AM4511/test_migrate_iris4/athena/doc/sensors/xgs5m_pinout.txt

GND;A5;Ground;Ground;
GND;A10;Ground;Ground;
GND;A13;Ground;Ground;
GND;D2;Ground;Ground;
GND;D13;Ground;Ground;
GND;E1;Ground;Ground;
GND;E14;Ground;Ground;
GND;G2;Ground;Ground;
GND;G13;Ground;Ground;
GND;H1;Ground;Ground;
GND;H14;Ground;Ground;
GND;J2;Ground;Ground;
GND;J3;Ground;Ground;
GND;J4;Ground;Ground;
GND;J5;Ground;Ground;
GND;J10;Ground;Ground;
GND;J11;Ground;Ground;
GND;J12;Ground;Ground;
GND;J13;Ground;Ground;
GND;K2;Ground;Ground;
GND;K3;Ground;Ground;
GND;K4;Ground;Ground;
GND;K9;Ground;Ground;
GND;K11;Ground;Ground;
GND;K12;Ground;Ground;
GND;K13;Ground;Ground;
GND;L2;Ground;Ground;
GND;L3;Ground;Ground;
GND;L4;Ground;Ground;
GND;L5;Ground;Ground;
GND;L6;Ground;Ground;
GND;L9;Ground;Ground;
GND;L10;Ground;Ground;
GND;L11;Ground;Ground;
GND;L12;Ground;Ground;
GND;L13;Ground;Ground;
GND;M5;Ground;Ground;
GND;M10;Ground;Ground;
GND;N1;Ground;Ground;
GND;N13;Ground;Ground;
GND;P8;Ground;Ground;
VDD_PLL;C10;Power;PLL Power Supply;
VAA;M13;Power;Analog Supply;
VAA;A3;Power;Analog Supply;
VAA;N3;Power;Analog Supply;
VAA;N4;Power;Analog Supply;
VAA;P7;Power;Analog Supply;
VAA;L7;Power;Analog Supply;
VAA;K7;Power;Analog Supply;
VAA;L8;Power;Analog Supply;
VAA;K8;Power;Analog Supply;
VAA;N11;Power;Analog Supply;
VAA;N12;Power;Analog Supply;
VAA;A12;Power;Analog Supply;
VAA;L14;Power;Analog Supply;
VAA_RD;A4;Power;Analog Supply for Row Driver;
VAA_RD;A11;Power;Analog Supply for Row Driver;
VAA_RD;P3;Power;Analog Supply for Row Driver;
VAA_RD;P12;Power;Analog Supply for Row Driver;
VDD_IO;A6;Power;I/O Supply;
VDD_IO;A7;Power;I/O Supply;
VDD_IO;A9;Power;I/O Supply;
VDD_IO;M1;Power;I/O Supply;
VDD_IO;M14;Power;I/O Supply;
FWSI_EN;B8;Input;Connect to VDD_IO through a 10k resistor;
SDATA;B9;Input;SPI Slave In;
VAA_PIX;B3;Power;Pixel Supply;
VAA_PIX;B12;Power;Pixel Supply;
VAA_PIX;M3;Power;Pixel Supply;
VAA_PIX;M12;Power;Pixel Supply;
VDD;C1;Power;Digital Supply;
VDD;F1;Power;Digital Supply;
VDD;K1;Power;Digital Supply;
VDD;B4;Power;Digital Supply;
VDD;D5;Power;Digital Supply;
VDD;G5;Power;Digital Supply;
VDD;K5;Power;Digital Supply;
VDD;D10;Power;Digital Supply;
VDD;G10;Power;Digital Supply;
VDD;K10;Power;Digital Supply;
VDD;B11;Power;Digital Supply;
VDD;C14;Power;Digital Supply;
VDD;F14;Power;Digital Supply;
VDD;J14;Power;Digital Supply;
MONITOR_2;B5;Output;Monitor Output 2. If unused, do not connect.;
MONITOR_1;B6;Output Monitor Output 1. If unused, do not connect.;
EXTCLK;B7;Input;External Clock Input;
SDATAOUT;C8;Output;SPI Slave Out;
TRIG_RD;C9;Input;Trigger Input for Readout Control. If unused, connectto ground.;
DATA_0_N;C10;HiSPi;Differential Data Channel [0], Negative;
DATA_0_P;C11;HiSPi;Differential Data Channel [0], Positive;
DATA_2_N;C12;HiSPi;Differential Data Channel [2], Negative;
DATA_2_P;C13;HiSPi;Differential Data Channel [2], Positive;
DATA_3_P;D2;HiSPi;Differential Data Channel [3], Positive;
DATA_3_N;D3;HiSPi;Differential Data Channel [3], Negative;
DATA_1_P;D4;HiSPi;Differential Data Channel [1], Positive;
DATA_1_N;D5;HiSPi;Differential Data Channel [1], Negative;
MONITOR_0;C6;Output;Monitor Output 0. If unused, keep do not connect.;
CS_N;C7;Input;SPI Chip Select (Active Low);
TRIG_INT;D9;Input;Trigger Input for Integration Control. If unused, connectto ground.;
D_CLK_0_N;D11;HiSPi;Differential Clock [0], Negative;
D_CLK_0_P;D12;HiSPi;Differential Clock [0], Positive;
VDD_SLVS;D1;Power;HiSPi Supply;
VDD_SLVS;D14;Power;HiSPi Supply;
VDD_SLVS;G1;Power;HiSPi Supply;
VDD_SLVS;G14;Power;HiSPi Supply;
VDD_SLVS;K1;Power;HiSPi Supply;
VDD_SLVS;K14;Power;HiSPi Supply;
D_CLK_1_P;P3;HiSPi;Differential Clock [1], Positive;
D_CLK_1_N;P4;HiSPi;Differential Clock [1], Negative;
RESET_N;D6;Input;Asynchronous Hard Reset (Active Low);
SCLK;D7;Input;SPI Clock Input;
DATA_4_N;E10;HiSPi;Differential Data Channel [4], Negative;
DATA_4_P;E11;HiSPi;Differential Data Channel [4], Positive;
DATA_6_N;E12;HiSPi;Differential Data Channel [6], Negative;
DATA_6_P;E13;HiSPi;Differential Data Channel [6], Positive;
DATA_7_P;E2;HiSPi;Differential Data Channel [7], Positive;
DATA_7_N;E3;HiSPi;Differential Data Channel [7], Negative;
DATA_5_P;E4;HiSPi;Differential Data Channel [5], Positive;
DATA_5_N;E5;HiSPi;Differential Data Channel [5], Negative;
DATA_8_N;F10;HiSPi;Differential Data Channel [8], Negative;
DATA_8_P;F11;HiSPi;Differential Data Channel [8], Positive;
DATA_10_N;F12;HiSPi;Differential Data Channel [10], Negative;
DATA_10_P;F13;HiSPi;Differential Data Channel [10], Positive;
DATA_11_P;F2;HiSPi;Differential Data Channel [11], Positive;
DATA_11_N;F3;HiSPi;Differential Data Channel [11], Negative;
DATA_9_P;F4;HiSPi;Differential Data Channel [9], Positive;
DATA_9_N;F5;HiSPi;Differential Data Channel [9], Negative;
D_CLK_2_N;G11;HiSPi;Differential Clock [2], Negative;
D_CLK_2_P;G12;HiSPi;Differential Clock [2], Positive;
D_CLK_3_P;H3;HiSPi;Differential Clock [3], Positive;
D_CLK_3_N;H4;HiSPi;Differential Clock [3], Negative;
DATA_12_N;H10;HiSPi;Differential Data Channel [12], Negative;
DATA_12_P;H11;HiSPi;Differential Data Channel [12], Positive;
DATA_14_N;H12;HiSPi;Differential Data Channel [14], Negative;
DATA_14_P;H13;HiSPi;Differential Data Channel [14], Positive;
DATA_15_P;H2;HiSPi;Differential Data Channel [15], Positive;
DATA_15_N;H3;HiSPi;Differential Data Channel [15], Negative;
DATA_13_P;H4;HiSPi;Differential Data Channel [13], Positive;
DATA_13_N;H5;HiSPi;Differential Data Channel [13], Negative;
VAA_PIX_A0;M8;Decoupling;External Noise Decoupling (0.1 uF + 4.7 uF to GND);
VAA_PIX_A1;M9;Decoupling;External Noise Decoupling (0.1 uF + 4.7 uF to GND);
VAA_PIX_A2;N8;Decoupling;External Noise Decoupling (0.1 uF + 4.7 uF to GND);
VAA_PIX_A3;P9;Decoupling;External Noise Decoupling (0.1 uF + 4.7 uF to GND);
VAA_PIX_A4;P10;Decoupling;External Noise Decoupling (0.1 uF + 4.7 uF to GND);
VAA_PIX_A5;P4;Decoupling;External Noise Decoupling (0.1 uF + 4.7 uF to GND);
VAA_PIX_B0;M6;Decoupling;External Noise Decoupling (0.1 uF + 2.2 uF to GND);
VAA_PIX_B1;M7;Decoupling;External Noise Decoupling (0.1 uF + 2.2 uF to GND);
VAA_PIX_B2;N6;Decoupling;External Noise Decoupling (0.1 uF + 2.2 uF to GND);
VAA_PIX_B3;N7;Decoupling;External Noise Decoupling (0.1 uF + 2.2 uF to GND);
VAA_PIX_B4;P5;Decoupling;External Noise Decoupling (0.1 uF + 2.2 uF to GND);
VAA_PIX_B5;P6;Decoupling;External Noise Decoupling (0.1 uF + 2.2 uF to GND);
VAA_PIX_C0;N9;Decoupling;External Noise Decoupling (0.1 uF to GND);
VAA_PIX_C1;P11;Decoupling;External Noise Decoupling (0.1 uF to GND);
VAA_PIX_BST;N5;N10;Power;Pixel Booster Supply;
