AM4511/test_migrate_iris4/athena/local_ip/pcie2AxiMaster_v3.0/doc/pcie2AxiMaster_IPCore_Specification.docx

Matrox Pcie2AxiMaster

IP-Core specification

Project :

Document Title : Matrox pcie2AxiMaster IP-Core

Document Number and Revision :

Author : Alain Marchand

Date : 2019-01-23

Matrox Confidential information. Do not circulate outside Matrox without the prior consent of the Matrox Engineering department. Advance Information. Contains information on product in the design phase of development.

# Revision history

This section lists all revisions for the current document and explains the modifications made for each new revision

Revision | Description
0.01 | - Initial version

Table of contents

# 1. Introduction

# 2. IP-Core features

- Bridge between the PCIe Gen2x1 and the AXI4 Master Lite interface
- Based on the Xilinx PCIe Endpoint
- IP-Integrator ready
- Support up to 31 IRQ events
- Includes the Matrox SPI interface and the Xilinx Startup2 module

# 3. Bloc diagram

# 4. Pcie Xilinx end point

# 5. Interrupts

## 5.1 Legacy mode

Interrupts mappings :

Registre Status[0]: @BAR2 + 0x40

io[0]

reserved[7:1]

tick[9:8]

tick_latch[11:10]

tick_wrap[13:12]

tick_wrap[13:12]

toe_overrun[17:14]

toe_frame_sent[21:18]

toe_list_sent[25:22]

toe_log_available[26]

toe_log_overflow[27]

Registre Status[1]: @BAR2 + 0x44

timer_start[15:0]

timer_end[31:16]

## 5.2 Interrupt queue mode

## 5.3 Modelsim Validation framework

### 5.3.1 Prerequisite

# 6. FPGA implementation

# 7. References

Matrox confidential information, Preliminary, Subject to change

matrox TITRE Matrox PCIe2AxiMaster IP-Core Specification imaging NUMÉRO ET RÉVISION Ex :469-TESY-002-0.02 STATUT OFFICIEL PAGE 1 de 1 No. gabarit : GAB104 - GABARIT DE SPECIFICATION.DOT
