AM4511/test_migrate_iris4/doc/schematic_review/ares_xc7a50t_1582747176.xlsx

Sheet: ares_xc7a50t_1582747176
#Top: ares_pcie Floorplan: impl_1 Part: xc7a50ticpg236-1L
#Generated by: amarchan on: Wed Feb 26 16:11:24 2020
#Build: Vivado v2019.1 by: xbuild on: Fri May 24 14:49:42 MDT 2019
#Package Version: FINAL 2014-02-19
#Package Pin Delay Version: VERS. 2.0 2014-02-19
IO Bank | Pin Number | Site | Site Type | Min Trace Delay (ps) | Max Trace Delay (ps) | Prohibit | Interface | Signal Name | Direction | DiffPair Type | DiffPair Signal | IO Standard | Drive (mA) | Slew Rate | OUTPUT_IMPEDANCE | PRE_EMPHASIS | LVDS_PRE_EMPHASIS | EQUALIZATION | Pull Type | DQS_BIAS | IN_TERM | DIFF_TERM | OFFCHIP_TERM | Board Signal | Board Voltage
216 | A4 | IPAD_X1Y6 | MGTPRXN0_216 | 35.486 | 35.843 |  | pcie_7x_mgt_27828 | pcie_rxn[0] | IN
216 | B4 | IPAD_X1Y7 | MGTPRXP0_216 | 31.423 | 31.739 |  | pcie_7x_mgt_27828 | pcie_rxp[0] | IN
216 | D1 | OPAD_X0Y0 | MGTPTXN0_216 | 27.518 | 27.794 |  | pcie_7x_mgt_27828 | pcie_txn[0] | OUT |  |  |  | 12
216 | D2 | OPAD_X0Y1 | MGTPTXP0_216 | 28.188 | 28.471 |  | pcie_7x_mgt_27828 | pcie_txp[0] | OUT |  |  |  | 12
14 | N19 | IOB_X0Y31 | IO_L9N_T1_DQS_D13_14 | 43.356 | 43.791 |  | uart_4944 | debug_uart_rxd | IN |  |  | LVCMOS18
14 | N18 | IOB_X0Y32 | IO_L9P_T1_DQS_14 | 36.214 | 36.578 |  | uart_4944 | debug_uart_txd | OUT |  |  | LVCMOS18 | 4 | SLOW |  |  |  |  |  |  |  |  | NONE
14 | U15 | IOB_X0Y4 | IO_L23P_T3_A03_D19_14 | 55.235 | 55.791 |  | hb_4944 | hb_dq[7] | INOUT |  |  | LVCMOS18 | 4 | SLOW |  |  |  |  |  |  |  |  | NONE
14 | V15 | IOB_X0Y8 | IO_L21P_T3_DQS_14 | 61.536 | 62.155 |  | hb_4944 | hb_dq[6] | INOUT |  |  | LVCMOS18 | 4 | SLOW |  |  |  |  |  |  |  |  | NONE
14 | W15 | IOB_X0Y7 | IO_L21N_T3_DQS_A06_D22_14 | 46.384 | 46.85 |  | hb_4944 | hb_dq[5] | INOUT |  |  | LVCMOS18 | 4 | SLOW |  |  |  |  |  |  |  |  | NONE
14 | U14 | IOB_X0Y0 | IO_25_14 | 46.997 | 47.469 |  | hb_4944 | hb_dq[4] | INOUT |  |  | LVCMOS18 | 4 | SLOW |  |  |  |  |  |  |  |  | NONE
14 | V14 | IOB_X0Y1 | IO_L24N_T3_A00_D16_14 | 41.549 | 41.967 |  | hb_4944 | hb_dq[3] | INOUT |  |  | LVCMOS18 | 4 | SLOW |  |  |  |  |  |  |  |  | NONE
14 | W14 | IOB_X0Y5 | IO_L22N_T3_A04_D20_14 | 45.388 | 45.844 |  | hb_4944 | hb_dq[2] | INOUT |  |  | LVCMOS18 | 4 | SLOW |  |  |  |  |  |  |  |  | NONE
14 | V13 | IOB_X0Y2 | IO_L24P_T3_A01_D17_14 | 44.905 | 45.356 |  | hb_4944 | hb_dq[1] | INOUT |  |  | LVCMOS18 | 4 | SLOW |  |  |  |  |  |  |  |  | NONE
14 | W13 | IOB_X0Y6 | IO_L22P_T3_A05_D21_14 | 54.429 | 54.976 |  | hb_4944 | hb_dq[0] | INOUT |  |  | LVCMOS18 | 4 | SLOW |  |  |  |  |  |  |  |  | NONE
14 | P18 | IOB_X0Y22 | IO_L14P_T2_SRCC_14 | 54.741 | 55.291 |  | hb_4944 | hb_ck | OUT |  |  | LVCMOS18 | 4 | SLOW |  |  |  |  |  |  |  |  | NONE
14 | R18 | IOB_X0Y21 | IO_L14N_T2_SRCC_14 | 41.326 | 41.741 |  | hb_4944 | hb_ck_n | OUT |  |  | LVCMOS18 | 4 | SLOW |  |  |  |  |  |  |  |  | NONE
14 | T17 | IOB_X0Y16 | IO_L17P_T2_A14_D30_14 | 46.765 | 47.235 |  | hb_4944 | hb_cs_n | OUT |  |  | LVCMOS18 | 4 | SLOW |  |  |  |  |  |  |  |  | NONE
14 | V16 | IOB_X0Y12 | IO_L19P_T3_A10_D26_14 | 56.856 | 57.427 |  | hb_4944 | hb_rwds | INOUT |  |  | LVCMOS18 | 4 | SLOW |  |  |  |  |  |  |  |  | NONE
35 | M1 | IOB_X1Y81 | IO_L9N_T1_DQS_AD7N_35 | 52.04 | 52.563 |  | ncsi_4944 | ncsi_rxd[1] | IN |  |  | LVCMOS33
35 | N1 | IOB_X1Y79 | IO_L10N_T1_AD15N_35 | 50.477 | 50.985 |  | ncsi_4944 | ncsi_rxd[0] | IN |  |  | LVCMOS33
35 | L3 | IOB_X1Y84 | IO_L8P_T1_AD14P_35 | 44.149 | 44.593 |  | ncsi_4944 | ncsi_txd[1] | OUT |  |  | LVCMOS33 | 4 | SLOW |  |  |  |  |  |  |  |  | NONE
35 | M3 | IOB_X1Y83 | IO_L8N_T1_AD14N_35 | 52.966 | 53.499 |  | ncsi_4944 | ncsi_txd[0] | OUT |  |  | LVCMOS33 | 4 | SLOW |  |  |  |  |  |  |  |  | NONE
35 | M2 | IOB_X1Y82 | IO_L9P_T1_DQS_AD7P_35 | 52.172 | 52.696 |  | ncsi_4944 | ncsi_rx_crs_dv | IN |  |  | LVCMOS33
35 | N2 | IOB_X1Y80 | IO_L10P_T1_AD15P_35 | 49.851 | 50.352 |  | ncsi_4944 | ncsi_tx_en | OUT |  |  | LVCMOS33 | 4 | SLOW |  |  |  |  |  |  |  |  | NONE
216 | A8 | IPAD_X1Y15 | MGTREFCLK0N_216 | 27.772 | 28.051 |  | CLK.CLK_100MHZ_CLK.sys_clk_57745 | pcie_sys_clk_n | IN | N | pcie_sys_clk_p
216 | B8 | IPAD_X1Y14 | MGTREFCLK0P_216 | 29.762 | 30.062 |  | CLK.CLK_100MHZ_CLK.sys_clk_57745 | pcie_sys_clk_p | IN | P | pcie_sys_clk_n
34 | U1 | IOB_X1Y43 | IO_L3N_T0_DQS_34 | 48.507 | 48.994 |  | CLK.CLK_100MHZ_CLK.sys_clk_57745 | status_rled | OUT |  |  | LVCMOS33 | 4 | SLOW |  |  |  |  |  |  |  |  | NONE
35 | H1 | IOB_X1Y94 | IO_L3P_T0_DQS_AD5P_35 | 45.368 | 45.824 |  | CLK.CLK_100MHZ_CLK.sys_clk_57745 | sys_rst_out_n | OUT |  |  | LVCMOS33 | 12 | SLOW |  |  |  |  |  |  |  |  | FP_VTT_50
14 | F18 | IOB_X0Y45 | IO_L2N_T0_D03_14 | 62.552 | 63.18 |  | spi_4944 | spi_sd[3] | INOUT |  |  | LVCMOS18 | 4 | SLOW |  |  |  |  |  |  |  |  | NONE
14 | G18 | IOB_X0Y46 | IO_L2P_T0_D02_14 | 64.093 | 64.737 |  | spi_4944 | spi_sd[2] | INOUT |  |  | LVCMOS18 | 4 | SLOW |  |  |  |  |  |  |  |  | NONE
14 | D19 | IOB_X0Y47 | IO_L1N_T0_D01_DIN_14 | 68.618 | 69.308 |  | spi_4944 | spi_sd[1] | INOUT |  |  | LVCMOS18 | 4 | SLOW |  |  |  |  |  |  |  |  | NONE
14 | D18 | IOB_X0Y48 | IO_L1P_T0_D00_MOSI_14 | 70.007 | 70.711 |  | spi_4944 | spi_sd[0] | INOUT |  |  | LVCMOS18 | 4 | SLOW |  |  |  |  |  |  |  |  | NONE
14 | K19 | IOB_X0Y38 | IO_L6P_T0_FCS_B_14 | 50.629 | 51.138 |  | spi_4944 | spi_cs_n | INOUT |  |  | LVCMOS18 | 4 | SLOW |  |  |  |  |  |  |  |  | NONE
35 | J1 | IOB_X1Y93 | IO_L3N_T0_DQS_AD5N_35 | 45.809 | 46.27 |  | RST.sys_rst_n_27828 | sys_rst_in_n | IN |  |  | LVCMOS33
16 | A18 | IOB_X0Y111 | IO_L19N_T3_VREF_16 | 58.482 | 59.069 |  |  | acq_led[1] | IN |  |  | LVCMOS18
16 | B18 | IOB_X0Y112 | IO_L19P_T3_16 | 51.785 | 52.306 |  |  | acq_led[0] | IN |  |  | LVCMOS18
14 | G19 | IOB_X0Y41 | IO_L4N_T0_D05_14 | 64.383 | 65.03 |  |  | espi_io[3] | INOUT |  |  | LVCMOS18 | 4 | SLOW |  |  |  |  |  |  |  |  | NONE
14 | H19 | IOB_X0Y42 | IO_L4P_T0_D04_14 | 59.997 | 60.6 |  |  | espi_io[2] | INOUT |  |  | LVCMOS18 | 4 | SLOW |  |  |  |  |  |  |  |  | NONE
14 | J18 | IOB_X0Y35 | IO_L7N_T1_D10_14 | 65.365 | 66.022 |  |  | espi_io[1] | INOUT |  |  | LVCMOS18 | 4 | SLOW |  |  |  |  |  |  |  |  | NONE
14 | K18 | IOB_X0Y33 | IO_L8N_T1_D12_14 | 59.489 | 60.087 |  |  | espi_io[0] | INOUT |  |  | LVCMOS18 | 4 | SLOW |  |  |  |  |  |  |  |  | NONE
14 | U18 | IOB_X0Y13 | IO_L18N_T2_A11_D27_14 | 37.024 | 37.396 |  |  | fpga_straps[3] | IN |  |  | LVCMOS18
14 | V17 | IOB_X0Y11 | IO_L19N_T3_A09_D25_VREF_14 | 48.459 | 48.946 |  |  | fpga_straps[2] | IN |  |  | LVCMOS18
14 | W16 | IOB_X0Y10 | IO_L20P_T3_A08_D24_14 | 59.304 | 59.9 |  |  | fpga_straps[1] | IN |  |  | LVCMOS18
14 | W17 | IOB_X0Y9 | IO_L20N_T3_A07_D23_14 | 44.15 | 44.594 |  |  | fpga_straps[0] | IN |  |  | LVCMOS18
34 | U7 | IOB_X1Y12 | IO_L19P_T3_34 | 72.032 | 72.756 |  |  | user_data_out[2] | OUT |  |  | LVCMOS33 | 4 | SLOW |  |  |  |  |  |  |  |  | NONE
34 | U8 | IOB_X1Y22 | IO_L14P_T2_SRCC_34 | 75.687 | 76.447 |  |  | user_data_out[1] | OUT |  |  | LVCMOS33 | 4 | SLOW |  |  |  |  |  |  |  |  | NONE
34 | T3 | IOB_X1Y45 | IO_L2N_T0_34 | 47.809 | 48.289 |  |  | user_data_out[0] | OUT |  |  | LVCMOS33 | 4 | SLOW |  |  |  |  |  |  |  |  | NONE
34 | R3 | IOB_X1Y46 | IO_L2P_T0_34 | 59.313 | 59.909 |  |  | user_data_in[3] | IN |  |  | LVCMOS33
34 | T1 | IOB_X1Y44 | IO_L3P_T0_DQS_34 | 50.79 | 51.301 |  |  | user_data_in[2] | IN |  |  | LVCMOS33
34 | T2 | IOB_X1Y47 | IO_L1N_T0_34 | 53.452 | 53.989 |  |  | user_data_in[1] | IN |  |  | LVCMOS33
34 | R2 | IOB_X1Y48 | IO_L1P_T0_34 | 51.757 | 52.277 |  |  | user_data_in[0] | IN |  |  | LVCMOS33
16 | C15 | IOB_X0Y128 | IO_L11P_T1_SRCC_16 | 45.697 | 46.157 |  |  | acq_exposure | IN |  |  | LVCMOS18
16 | B15 | IOB_X0Y127 | IO_L11N_T1_SRCC_16 | 65.377 | 66.034 |  |  | acq_strobe | IN |  |  | LVCMOS18
16 | A16 | IOB_X0Y126 | IO_L12P_T1_MRCC_16 | 52.5 | 53.028 |  |  | acq_trigger | OUT |  |  | LVCMOS18 | 4 | SLOW |  |  |  |  |  |  |  |  | NONE
16 | A17 | IOB_X0Y125 | IO_L12N_T1_MRCC_16 | 48.791 | 49.282 |  |  | acq_trigger_ready | IN |  |  | LVCMOS18
16 | A14 | IOB_X0Y138 | IO_L6P_T0_16 | 60.607 | 61.216 |  |  | user_rled_soc | IN |  |  | LVCMOS18
34 | U4 | IOB_X1Y28 | IO_L11P_T1_SRCC_34 | 39.989 | 40.391 |  |  | user_rled | OUT |  |  | LVCMOS33 | 4 | SLOW |  |  |  |  |  |  |  |  | NONE
14 | E19 | IOB_X0Y43 | IO_L3N_T0_DQS_EMCCLK_14 | 70.309 | 71.016 |  |  | espi_alert_n | OUT |  |  | LVCMOS18 | 4 | SLOW |  |  |  |  |  |  |  |  | NONE
14 | K17 | IOB_X0Y25 | IO_L12N_T1_MRCC_14 | 77.37 | 78.147 |  |  | espi_clk | IN |  |  | LVCMOS18
14 | L18 | IOB_X0Y34 | IO_L8P_T1_D11_14 | 44.212 | 44.657 |  |  | espi_cs_n | IN |  |  | LVCMOS18
14 | J17 | IOB_X0Y36 | IO_L7P_T1_D09_14 | 61.558 | 62.177 |  |  | espi_reset_n | IN |  |  | LVCMOS18
16 | A15 | IOB_X0Y137 | IO_L6N_T0_VREF_16 | 43.867 | 44.308 |  |  | user_gled_soc | IN |  |  | LVCMOS18
34 | U2 | IOB_X1Y31 | IO_L9N_T1_DQS_34 | 43.75 | 44.19 |  |  | user_gled | OUT |  |  | LVCMOS33 | 4 | SLOW |  |  |  |  |  |  |  |  | NONE
14 | M18 | IOB_X0Y28 | IO_L11P_T1_SRCC_14 | 48.633 | 49.121 |  |  | ref_clk_100MHz | IN |  |  | LVCMOS18
14 | U19 | IOB_X0Y20 | IO_L15P_T2_DQS_RDWR_B_14 | 41.834 | 42.254 |  |  | hb_int_n | IN |  |  | LVCMOS18
14 | R19 | IOB_X0Y29 | IO_L10N_T1_D15_14 | 44.162 | 44.606 |  |  | hb_rst_n | OUT |  |  | LVCMOS18 | 4 | SLOW |  |  |  |  |  |  |  |  | NONE
14 | V19 | IOB_X0Y19 | IO_L15N_T2_DQS_DOUT_CSO_B_14 | 49.813 | 50.313 |  |  | hb_rsto_n | IN |  |  | LVCMOS18
34 | U5 | IOB_X1Y18 | IO_L16P_T2_34 | 60.584 | 61.193 |  |  | status_gled | OUT |  |  | LVCMOS33 | 4 | SLOW |  |  |  |  |  |  |  |  | NONE
14 | U16 | IOB_X0Y3 | IO_L23N_T3_A02_D18_14 | 45.609 | 46.068 |  |  | hb_wp_n | OUT |  |  | LVCMOS18 | 4 | SLOW |  |  |  |  |  |  |  |  | NONE
35 | N3 | IOB_X1Y76 | IO_L12P_T1_MRCC_35 | 48.179 | 48.663 |  |  | ncsi_clk | OUT |  |  | LVCMOS33 | 4 | SLOW |  |  |  |  |  |  |  |  | NONE
34 | V2 | IOB_X1Y40 | IO_L5P_T0_34 | 50.091 | 50.594 |  |  | pwm_out | OUT |  |  | LVCMOS33 | 4 | SLOW |  |  |  |  |  |  |  |  | NONE
0 | B13 | IPAD_X0Y1 | VN_0 | 51.355 | 51.871
0 | A12 | IPAD_X0Y0 | VP_0 | 29.808 | 30.108
0 | U12 |  | DONE_0 | 39.631 | 40.029
0 | A11 |  | DXP_0 | 28.595 | 28.882
0 | C12 |  | GNDADC_0
0 | C13 |  | VCCADC_0
0 | B12 |  | VREFP_0 | 39.157 | 39.551
0 | C9 |  | VCCBATT_0
0 | C8 |  | TCK_0 | 39.336 | 39.731
0 | B11 |  | DXN_0 | 38.925 | 39.316
0 | A13 |  | VREFN_0 | 31.856 | 32.176
0 | C11 |  | CCLK_0 | 38.016 | 38.398
0 | V12 |  | M0_0 | 29.997 | 30.298
0 | W11 |  | M1_0 | 26.863 | 27.133
0 | U11 |  | INIT_B_0 | 39.888 | 40.289
0 | W10 |  | TDI_0 | 29.123 | 29.416
0 | W8 |  | TDO_0 | 48.221 | 48.706
0 | U10 |  | M2_0 | 33.922 | 34.263
0 | V11 |  | CFGBVS_0 | 32.811 | 33.141 |  |  |  |  |  |  |  |  |  |  |  |  |  |  |  |  |  |  | GND | GND
0 | V10 |  | PROGRAM_B_0 | 27.178 | 27.451
0 | W9 |  | TMS_0 | 34.254 | 34.599
0 | V9 |  | VCCO_0 |  |  |  |  |  |  |  |  |  |  |  |  |  |  |  |  |  |  |  |  | VCCO_0 | 1.8
0 | G12 |  | VCCO_0 |  |  |  |  |  |  |  |  |  |  |  |  |  |  |  |  |  |  |  |  | VCCO_0 | 1.8
14 | D17 | IOB_X0Y49 | IO_0_14 | 71.062 | 71.776
14 | E18 | IOB_X0Y44 | IO_L3P_T0_DQS_PUDC_B_14 | 75.672 | 76.433
14 | H17 | IOB_X0Y40 | IO_L5P_T0_D06_14 | 46.294 | 46.759
14 | G17 | IOB_X0Y39 | IO_L5N_T0_D07_14 | 69.706 | 70.406
14 | J19 | IOB_X0Y37 | IO_L6N_T0_D08_VREF_14 | 64.563 | 65.212
14 | P19 | IOB_X0Y30 | IO_L10P_T1_D14_14 | 37.46 | 37.836
14 | M19 | IOB_X0Y27 | IO_L11N_T1_SRCC_14 | 59.648 | 60.248
14 | L17 | IOB_X0Y26 | IO_L12P_T1_MRCC_14 | 71.438 | 72.156
14 | N17 | IOB_X0Y24 | IO_L13P_T2_MRCC_14 | 33.368 | 33.704
14 | P17 | IOB_X0Y23 | IO_L13N_T2_MRCC_14 | 37.578 | 37.956
14 | W18 | IOB_X0Y18 | IO_L16P_T2_CSI_B_14 | 49.395 | 49.891
14 | W19 | IOB_X0Y17 | IO_L16N_T2_A15_D31_14 | 46.869 | 47.34
14 | T18 | IOB_X0Y15 | IO_L17N_T2_A13_D29_14 | 49.371 | 49.867
14 | U17 | IOB_X0Y14 | IO_L18P_T2_A12_D28_14 | 48.053 | 48.536
14 | F17 |  | VCCO_14 |  |  |  |  |  |  |  |  |  |  |  |  |  |  |  |  |  |  |  |  | VCCO_14 | 1.8
14 | K12 |  | VCCO_14 |  |  |  |  |  |  |  |  |  |  |  |  |  |  |  |  |  |  |  |  | VCCO_14 | 1.8
14 | K13 |  | VCCO_14 |  |  |  |  |  |  |  |  |  |  |  |  |  |  |  |  |  |  |  |  | VCCO_14 | 1.8
14 | L12 |  | VCCO_14 |  |  |  |  |  |  |  |  |  |  |  |  |  |  |  |  |  |  |  |  | VCCO_14 | 1.8
14 | L13 |  | VCCO_14 |  |  |  |  |  |  |  |  |  |  |  |  |  |  |  |  |  |  |  |  | VCCO_14 | 1.8
14 | M12 |  | VCCO_14 |  |  |  |  |  |  |  |  |  |  |  |  |  |  |  |  |  |  |  |  | VCCO_14 | 1.8
14 | M17 |  | VCCO_14 |  |  |  |  |  |  |  |  |  |  |  |  |  |  |  |  |  |  |  |  | VCCO_14 | 1.8
14 | R17 |  | VCCO_14 |  |  |  |  |  |  |  |  |  |  |  |  |  |  |  |  |  |  |  |  | VCCO_14 | 1.8
14 | U13 |  | VCCO_14 |  |  |  |  |  |  |  |  |  |  |  |  |  |  |  |  |  |  |  |  | VCCO_14 | 1.8
16 | C16 | IOB_X0Y124 | IO_L13P_T2_MRCC_16 | 33.166 | 33.5
16 | B16 | IOB_X0Y123 | IO_L13N_T2_MRCC_16 | 44.012 | 44.454
16 | C17 | IOB_X0Y122 | IO_L14P_T2_SRCC_16 | 44.102 | 44.545
16 | B17 | IOB_X0Y121 | IO_L14N_T2_SRCC_16 | 47.592 | 48.071
16 | B19 |  | VCCO_16 |  |  |  |  |  |  |  |  |  |  |  |  |  |  |  |  |  |  |  |  | VCCO_16 | 1.8
16 | C14 |  | VCCO_16 |  |  |  |  |  |  |  |  |  |  |  |  |  |  |  |  |  |  |  |  | VCCO_16 | 1.8
16 | C18 |  | VCCO_16 |  |  |  |  |  |  |  |  |  |  |  |  |  |  |  |  |  |  |  |  | VCCO_16 | 1.8
16 | G13 |  | VCCO_16 |  |  |  |  |  |  |  |  |  |  |  |  |  |  |  |  |  |  |  |  | VCCO_16 | 1.8
34 | W2 | IOB_X1Y39 | IO_L5N_T0_34 | 64.13 | 64.774
34 | V3 | IOB_X1Y38 | IO_L6P_T0_34 | 49.028 | 49.521
34 | W3 | IOB_X1Y37 | IO_L6N_T0_VREF_34 | 66.015 | 66.678
34 | U3 | IOB_X1Y32 | IO_L9P_T1_DQS_34 | 44.574 | 45.022
34 | V4 | IOB_X1Y27 | IO_L11N_T1_SRCC_34 | 63.66 | 64.299
34 | W5 | IOB_X1Y26 | IO_L12P_T1_MRCC_34 | 53.927 | 54.469
34 | W4 | IOB_X1Y25 | IO_L12N_T1_MRCC_34 | 51.095 | 51.608
34 | W7 | IOB_X1Y24 | IO_L13P_T2_MRCC_34 | 51.483 | 52
34 | W6 | IOB_X1Y23 | IO_L13N_T2_MRCC_34 | 69.746 | 70.447
34 | V8 | IOB_X1Y21 | IO_L14N_T2_SRCC_34 | 76.122 | 76.887
34 | V5 | IOB_X1Y17 | IO_L16N_T2_34 | 45.243 | 45.698
34 | V7 | IOB_X1Y11 | IO_L19N_T3_VREF_34 | 38.448 | 38.834
34 | M8 |  | VCCO_34 |  |  |  |  |  |  |  |  |  |  |  |  |  |  |  |  |  |  |  |  | VCCO_34 | 3.3
34 | N7 |  | VCCO_34 |  |  |  |  |  |  |  |  |  |  |  |  |  |  |  |  |  |  |  |  | VCCO_34 | 3.3
34 | N8 |  | VCCO_34 |  |  |  |  |  |  |  |  |  |  |  |  |  |  |  |  |  |  |  |  | VCCO_34 | 3.3
34 | R1 |  | VCCO_34 |  |  |  |  |  |  |  |  |  |  |  |  |  |  |  |  |  |  |  |  | VCCO_34 | 3.3
34 | V1 |  | VCCO_34 |  |  |  |  |  |  |  |  |  |  |  |  |  |  |  |  |  |  |  |  | VCCO_34 | 3.3
34 | V6 |  | VCCO_34 |  |  |  |  |  |  |  |  |  |  |  |  |  |  |  |  |  |  |  |  | VCCO_34 | 3.3
35 | G3 | IOB_X1Y98 | IO_L1P_T0_AD4P_35 | 47.891 | 48.373
35 | G2 | IOB_X1Y97 | IO_L1N_T0_AD4N_35 | 30.883 | 31.194
35 | H2 | IOB_X1Y96 | IO_L2P_T0_AD12P_35 | 49.625 | 50.124
35 | J2 | IOB_X1Y95 | IO_L2N_T0_AD12N_35 | 48.887 | 49.378
35 | K2 | IOB_X1Y90 | IO_L5P_T0_AD13P_35 | 47.548 | 48.026
35 | L2 | IOB_X1Y89 | IO_L5N_T0_AD13N_35 | 56.736 | 57.306
35 | L1 | IOB_X1Y87 | IO_L6N_T0_VREF_35 | 62.104 | 62.728
35 | J3 | IOB_X1Y86 | IO_L7P_T1_AD6P_35 | 44.262 | 44.707
35 | K3 | IOB_X1Y85 | IO_L7N_T1_AD6N_35 | 51.176 | 51.691
35 | P3 | IOB_X1Y75 | IO_L12N_T1_MRCC_35 | 58.806 | 59.397
35 | P1 | IOB_X1Y61 | IO_L19N_T3_VREF_35 | 56.141 | 56.706
35 | H3 |  | VCCO_35 |  |  |  |  |  |  |  |  |  |  |  |  |  |  |  |  |  |  |  |  | VCCO_35 | 3.3
35 | J7 |  | VCCO_35 |  |  |  |  |  |  |  |  |  |  |  |  |  |  |  |  |  |  |  |  | VCCO_35 | 3.3
35 | K1 |  | VCCO_35 |  |  |  |  |  |  |  |  |  |  |  |  |  |  |  |  |  |  |  |  | VCCO_35 | 3.3
35 | K7 |  | VCCO_35 |  |  |  |  |  |  |  |  |  |  |  |  |  |  |  |  |  |  |  |  | VCCO_35 | 3.3
35 | L7 |  | VCCO_35 |  |  |  |  |  |  |  |  |  |  |  |  |  |  |  |  |  |  |  |  | VCCO_35 | 3.3
35 | M7 |  | VCCO_35 |  |  |  |  |  |  |  |  |  |  |  |  |  |  |  |  |  |  |  |  | VCCO_35 | 3.3
216 | B6 | IPAD_X1Y13 | MGTPRXP1_216 | 32.311 | 32.636
216 | B10 | IPAD_X1Y16 | MGTREFCLK1P_216 | 52.342 | 52.868
216 | A10 | IPAD_X1Y17 | MGTREFCLK1N_216 | 53.22 | 53.755
216 | A6 | IPAD_X1Y12 | MGTPRXN1_216 | 28.909 | 29.199
216 | B2 | OPAD_X0Y3 | MGTPTXP1_216 | 37.713 | 38.092
216 | A2 | OPAD_X0Y2 | MGTPTXN1_216 | 41.628 | 42.047
216 | C7 |  | MGTRREF_216 | 33.344 | 33.679
 | M11 |  | VCCBRAM
 | N11 |  | VCCBRAM
 | A1 |  | GND |  |  |  |  |  |  |  |  |  |  |  |  |  |  |  |  |  |  |  |  | GND | GND
 | A3 |  | GND |  |  |  |  |  |  |  |  |  |  |  |  |  |  |  |  |  |  |  |  | GND | GND
 | A5 |  | GND |  |  |  |  |  |  |  |  |  |  |  |  |  |  |  |  |  |  |  |  | GND | GND
 | A7 |  | GND |  |  |  |  |  |  |  |  |  |  |  |  |  |  |  |  |  |  |  |  | GND | GND
 | A9 |  | GND |  |  |  |  |  |  |  |  |  |  |  |  |  |  |  |  |  |  |  |  | GND | GND
 | A19 |  | GND |  |  |  |  |  |  |  |  |  |  |  |  |  |  |  |  |  |  |  |  | GND | GND
 | B3 |  | GND |  |  |  |  |  |  |  |  |  |  |  |  |  |  |  |  |  |  |  |  | GND | GND
 | B5 |  | GND |  |  |  |  |  |  |  |  |  |  |  |  |  |  |  |  |  |  |  |  | GND | GND
 | B7 |  | GND |  |  |  |  |  |  |  |  |  |  |  |  |  |  |  |  |  |  |  |  | GND | GND
 | B9 |  | GND |  |  |  |  |  |  |  |  |  |  |  |  |  |  |  |  |  |  |  |  | GND | GND
 | B14 |  | GND |  |  |  |  |  |  |  |  |  |  |  |  |  |  |  |  |  |  |  |  | GND | GND
 | C2 |  | GND |  |  |  |  |  |  |  |  |  |  |  |  |  |  |  |  |  |  |  |  | GND | GND
 | C3 |  | GND |  |  |  |  |  |  |  |  |  |  |  |  |  |  |  |  |  |  |  |  | GND | GND
 | C4 |  | GND |  |  |  |  |  |  |  |  |  |  |  |  |  |  |  |  |  |  |  |  | GND | GND
 | C6 |  | GND |  |  |  |  |  |  |  |  |  |  |  |  |  |  |  |  |  |  |  |  | GND | GND
 | C10 |  | GND |  |  |  |  |  |  |  |  |  |  |  |  |  |  |  |  |  |  |  |  | GND | GND
 | C19 |  | GND |  |  |  |  |  |  |  |  |  |  |  |  |  |  |  |  |  |  |  |  | GND | GND
 | D3 |  | GND |  |  |  |  |  |  |  |  |  |  |  |  |  |  |  |  |  |  |  |  | GND | GND
 | E3 |  | GND |  |  |  |  |  |  |  |  |  |  |  |  |  |  |  |  |  |  |  |  | GND | GND
 | E17 |  | GND |  |  |  |  |  |  |  |  |  |  |  |  |  |  |  |  |  |  |  |  | GND | GND
 | F1 |  | GND |  |  |  |  |  |  |  |  |  |  |  |  |  |  |  |  |  |  |  |  | GND | GND
 | F2 |  | GND |  |  |  |  |  |  |  |  |  |  |  |  |  |  |  |  |  |  |  |  | GND | GND
 | F19 |  | GND |  |  |  |  |  |  |  |  |  |  |  |  |  |  |  |  |  |  |  |  | GND | GND
 | G1 |  | GND |  |  |  |  |  |  |  |  |  |  |  |  |  |  |  |  |  |  |  |  | GND | GND
 | G8 |  | GND |  |  |  |  |  |  |  |  |  |  |  |  |  |  |  |  |  |  |  |  | GND | GND
 | G11 |  | GND |  |  |  |  |  |  |  |  |  |  |  |  |  |  |  |  |  |  |  |  | GND | GND
 | H7 |  | GND |  |  |  |  |  |  |  |  |  |  |  |  |  |  |  |  |  |  |  |  | GND | GND
 | H8 |  | GND |  |  |  |  |  |  |  |  |  |  |  |  |  |  |  |  |  |  |  |  | GND | GND
 | H11 |  | GND |  |  |  |  |  |  |  |  |  |  |  |  |  |  |  |  |  |  |  |  | GND | GND
 | H12 |  | GND |  |  |  |  |  |  |  |  |  |  |  |  |  |  |  |  |  |  |  |  | GND | GND
 | H18 |  | GND |  |  |  |  |  |  |  |  |  |  |  |  |  |  |  |  |  |  |  |  | GND | GND
 | J8 |  | GND |  |  |  |  |  |  |  |  |  |  |  |  |  |  |  |  |  |  |  |  | GND | GND
 | J9 |  | GND |  |  |  |  |  |  |  |  |  |  |  |  |  |  |  |  |  |  |  |  | GND | GND
 | J11 |  | GND |  |  |  |  |  |  |  |  |  |  |  |  |  |  |  |  |  |  |  |  | GND | GND
 | J12 |  | GND |  |  |  |  |  |  |  |  |  |  |  |  |  |  |  |  |  |  |  |  | GND | GND
 | K8 |  | GND |  |  |  |  |  |  |  |  |  |  |  |  |  |  |  |  |  |  |  |  | GND | GND
 | L8 |  | GND |  |  |  |  |  |  |  |  |  |  |  |  |  |  |  |  |  |  |  |  | GND | GND
 | L9 |  | GND |  |  |  |  |  |  |  |  |  |  |  |  |  |  |  |  |  |  |  |  | GND | GND
 | L11 |  | GND |  |  |  |  |  |  |  |  |  |  |  |  |  |  |  |  |  |  |  |  | GND | GND
 | L19 |  | GND |  |  |  |  |  |  |  |  |  |  |  |  |  |  |  |  |  |  |  |  | GND | GND
 | M9 |  | GND |  |  |  |  |  |  |  |  |  |  |  |  |  |  |  |  |  |  |  |  | GND | GND
 | M13 |  | GND |  |  |  |  |  |  |  |  |  |  |  |  |  |  |  |  |  |  |  |  | GND | GND
 | N9 |  | GND |  |  |  |  |  |  |  |  |  |  |  |  |  |  |  |  |  |  |  |  | GND | GND
 | N12 |  | GND |  |  |  |  |  |  |  |  |  |  |  |  |  |  |  |  |  |  |  |  | GND | GND
 | N13 |  | GND |  |  |  |  |  |  |  |  |  |  |  |  |  |  |  |  |  |  |  |  | GND | GND
 | P2 |  | GND |  |  |  |  |  |  |  |  |  |  |  |  |  |  |  |  |  |  |  |  | GND | GND
 | T19 |  | GND |  |  |  |  |  |  |  |  |  |  |  |  |  |  |  |  |  |  |  |  | GND | GND
 | U6 |  | GND |  |  |  |  |  |  |  |  |  |  |  |  |  |  |  |  |  |  |  |  | GND | GND
 | U9 |  | GND |  |  |  |  |  |  |  |  |  |  |  |  |  |  |  |  |  |  |  |  | GND | GND
 | V18 |  | GND |  |  |  |  |  |  |  |  |  |  |  |  |  |  |  |  |  |  |  |  | GND | GND
 | W1 |  | GND |  |  |  |  |  |  |  |  |  |  |  |  |  |  |  |  |  |  |  |  | GND | GND
 | W12 |  | GND |  |  |  |  |  |  |  |  |  |  |  |  |  |  |  |  |  |  |  |  | GND | GND
 | G10 |  | VCCINT
 | H10 |  | VCCINT
 | J10 |  | VCCINT
 | L10 |  | VCCINT
 | M10 |  | VCCINT
 | N10 |  | VCCINT
 | H13 |  | VCCAUX |  |  |  |  |  |  |  |  |  |  |  |  |  |  |  |  |  |  |  |  | VCCAUX | 1.8
 | J13 |  | VCCAUX |  |  |  |  |  |  |  |  |  |  |  |  |  |  |  |  |  |  |  |  | VCCAUX | 1.8
 | C1 |  | MGTAVCC
 | E1 |  | MGTAVCC
 | F3 |  | MGTAVCC
 | G9 |  | MGTAVCC
 | H9 |  | MGTAVCC
 | B1 |  | MGTAVTT
 | C5 |  | MGTAVTT
 | E2 |  | MGTAVTT
 | G7 |  | MGTAVTT

Sheet: pinout review
IO Bank | Pin Number | Comments | Signal Name | Site Type | Min Trace Delay (ps) | Max Trace Delay (ps) | Prohibit | Interface | Direction | DiffPair Type | DiffPair Signal | IO Standard | Drive (mA) | Slew Rate | OUTPUT_IMPEDANCE | PRE_EMPHASIS | LVDS_PRE_EMPHASIS | EQUALIZATION | Pull Type | DQS_BIAS | IN_TERM | DIFF_TERM | OFFCHIP_TERM | Board Signal | Board Voltage
0 | A11 |  |  | DXP_0 | 28.595 | 28.882
0 | A12 |  |  | VP_0 | 29.808 | 30.108
0 | A13 |  |  | VREFN_0 | 31.856 | 32.176
0 | B11 |  |  | DXN_0 | 38.925 | 39.316
0 | B12 |  |  | VREFP_0 | 39.157 | 39.551
0 | B13 |  |  | VN_0 | 51.355 | 51.871
0 | C11 |  |  | CCLK_0 | 38.016 | 38.398
0 | C12 |  |  | GNDADC_0
0 | C13 |  |  | VCCADC_0
0 | C8 |  |  | TCK_0 | 39.336 | 39.731
0 | C9 |  |  | VCCBATT_0
0 | G12 |  |  | VCCO_0 |  |  |  |  |  |  |  |  |  |  |  |  |  |  |  |  |  |  |  | VCCO_0 | 1.8
0 | U10 |  |  | M2_0 | 33.922 | 34.263
0 | U11 |  |  | INIT_B_0 | 39.888 | 40.289
0 | U12 |  |  | DONE_0 | 39.631 | 40.029
0 | V10 |  |  | PROGRAM_B_0 | 27.178 | 27.451
0 | V11 |  |  | CFGBVS_0 | 32.811 | 33.141 |  |  |  |  |  |  |  |  |  |  |  |  |  |  |  |  |  | GND | GND
0 | V12 |  |  | M0_0 | 29.997 | 30.298
0 | V9 |  |  | VCCO_0 |  |  |  |  |  |  |  |  |  |  |  |  |  |  |  |  |  |  |  | VCCO_0 | 1.8
0 | W10 |  |  | TDI_0 | 29.123 | 29.416
0 | W11 |  |  | M1_0 | 26.863 | 27.133
0 | W8 |  |  | TDO_0 | 48.221 | 48.706
0 | W9 |  |  | TMS_0 | 34.254 | 34.599
14 | N19 |  | debug_uart_rxd | IO_L9N_T1_DQS_D13_14 | 43.356 | 43.791 |  | uart_4944 | IN |  |  | LVCMOS18
14 | N18 |  | debug_uart_txd | IO_L9P_T1_DQS_14 | 36.214 | 36.578 |  | uart_4944 | OUT |  |  | LVCMOS18 | 4 | SLOW |  |  |  |  |  |  |  |  | NONE
14 | E19 |  | espi_alert_n | IO_L3N_T0_DQS_EMCCLK_14 | 70.309 | 71.016 |  |  | OUT |  |  | LVCMOS18 | 4 | SLOW |  |  |  |  |  |  |  |  | NONE
14 | K17 |  | espi_clk | IO_L12N_T1_MRCC_14 | 77.37 | 78.147 |  |  | IN |  |  | LVCMOS18
14 | L18 |  | espi_cs_n | IO_L8P_T1_D11_14 | 44.212 | 44.657 |  |  | IN |  |  | LVCMOS18
14 | K18 |  | espi_io[0] | IO_L8N_T1_D12_14 | 59.489 | 60.087 |  |  | INOUT |  |  | LVCMOS18 | 4 | SLOW |  |  |  |  |  |  |  |  | NONE
14 | J18 |  | espi_io[1] | IO_L7N_T1_D10_14 | 65.365 | 66.022 |  |  | INOUT |  |  | LVCMOS18 | 4 | SLOW |  |  |  |  |  |  |  |  | NONE
14 | H19 |  | espi_io[2] | IO_L4P_T0_D04_14 | 59.997 | 60.6 |  |  | INOUT |  |  | LVCMOS18 | 4 | SLOW |  |  |  |  |  |  |  |  | NONE
14 | G19 |  | espi_io[3] | IO_L4N_T0_D05_14 | 64.383 | 65.03 |  |  | INOUT |  |  | LVCMOS18 | 4 | SLOW |  |  |  |  |  |  |  |  | NONE
14 | J17 |  | espi_reset_n | IO_L7P_T1_D09_14 | 61.558 | 62.177 |  |  | IN |  |  | LVCMOS18
14 | W17 |  | fpga_straps[0] | IO_L20N_T3_A07_D23_14 | 44.15 | 44.594 |  |  | IN |  |  | LVCMOS18
14 | W16 |  | fpga_straps[1] | IO_L20P_T3_A08_D24_14 | 59.304 | 59.9 |  |  | IN |  |  | LVCMOS18
14 | V17 |  | fpga_straps[2] | IO_L19N_T3_A09_D25_VREF_14 | 48.459 | 48.946 |  |  | IN |  |  | LVCMOS18
14 | U18 |  | fpga_straps[3] | IO_L18N_T2_A11_D27_14 | 37.024 | 37.396 |  |  | IN |  |  | LVCMOS18
14 | P18 |  | hb_ck | IO_L14P_T2_SRCC_14 | 54.741 | 55.291 |  | hb_4944 | OUT |  |  | LVCMOS18 | 4 | SLOW |  |  |  |  |  |  |  |  | NONE
14 | R18 |  | hb_ck_n | IO_L14N_T2_SRCC_14 | 41.326 | 41.741 |  | hb_4944 | OUT |  |  | LVCMOS18 | 4 | SLOW |  |  |  |  |  |  |  |  | NONE
14 | T17 |  | hb_cs_n | IO_L17P_T2_A14_D30_14 | 46.765 | 47.235 |  | hb_4944 | OUT |  |  | LVCMOS18 | 4 | SLOW |  |  |  |  |  |  |  |  | NONE
14 | W13 | [amarchan]: Change vivado constrain to hb_dq[2] | hb_dq[0] | IO_L22P_T3_A05_D21_14 | 54.429 | 54.976 |  | hb_4944 | INOUT |  |  | LVCMOS18 | 4 | SLOW |  |  |  |  |  |  |  |  | NONE
14 | V13 | [amarchan]: Change vivado constrain to hb_dq[4] | hb_dq[1] | IO_L24P_T3_A01_D17_14 | 44.905 | 45.356 |  | hb_4944 | INOUT |  |  | LVCMOS18 | 4 | SLOW |  |  |  |  |  |  |  |  | NONE
14 | W14 | [amarchan]: Change vivado constrain to hb_dq[3] | hb_dq[2] | IO_L22N_T3_A04_D20_14 | 45.388 | 45.844 |  | hb_4944 | INOUT |  |  | LVCMOS18 | 4 | SLOW |  |  |  |  |  |  |  |  | NONE
14 | V14 | [amarchan]: Change vivado constrain to hb_dq[0] | hb_dq[3] | IO_L24N_T3_A00_D16_14 | 41.549 | 41.967 |  | hb_4944 | INOUT |  |  | LVCMOS18 | 4 | SLOW |  |  |  |  |  |  |  |  | NONE
14 | U14 | [amarchan]: Change vivado constrain to hb_dq[7] | hb_dq[4] | IO_25_14 | 46.997 | 47.469 |  | hb_4944 | INOUT |  |  | LVCMOS18 | 4 | SLOW |  |  |  |  |  |  |  |  | NONE
14 | W15 | [amarchan]: Change vivado constrain to hb_dq[5] | hb_dq[5] | IO_L21N_T3_DQS_A06_D22_14 | 46.384 | 46.85 |  | hb_4944 | INOUT |  |  | LVCMOS18 | 4 | SLOW |  |  |  |  |  |  |  |  | NONE
14 | V15 | [amarchan]: Change vivado constrain to hb_dq[1] | hb_dq[6] | IO_L21P_T3_DQS_14 | 61.536 | 62.155 |  | hb_4944 | INOUT |  |  | LVCMOS18 | 4 | SLOW |  |  |  |  |  |  |  |  | NONE
14 | U15 | [amarchan]: Change vivado constrain to hb_dq[6] | hb_dq[7] | IO_L23P_T3_A03_D19_14 | 55.235 | 55.791 |  | hb_4944 | INOUT |  |  | LVCMOS18 | 4 | SLOW |  |  |  |  |  |  |  |  | NONE
14 | U19 | Check if any chip support this functionality | hb_int_n | IO_L15P_T2_DQS_RDWR_B_14 | 41.834 | 42.254 |  |  | IN |  |  | LVCMOS18
14 | R19 |  | hb_rst_n | IO_L10N_T1_D15_14 | 44.162 | 44.606 |  |  | OUT |  |  | LVCMOS18 | 4 | SLOW |  |  |  |  |  |  |  |  | NONE
14 | V19 | Check if any chip support this functionality | hb_rsto_n | IO_L15N_T2_DQS_DOUT_CSO_B_14 | 49.813 | 50.313 |  |  | IN |  |  | LVCMOS18
14 | V16 |  | hb_rwds | IO_L19P_T3_A10_D26_14 | 56.856 | 57.427 |  | hb_4944 | INOUT |  |  | LVCMOS18 | 4 | SLOW |  |  |  |  |  |  |  |  | NONE
14 | U16 | Check if any chip support this functionality | hb_wp_n | IO_L23N_T3_A02_D18_14 | 45.609 | 46.068 |  |  | OUT |  |  | LVCMOS18 | 4 | SLOW |  |  |  |  |  |  |  |  | NONE
14 | M18 | Check the tree. Why connected to EHL? | ref_clk_100MHz | IO_L11P_T1_SRCC_14 | 48.633 | 49.121 |  |  | IN |  |  | LVCMOS18
14 | K19 |  | spi_cs_n | IO_L6P_T0_FCS_B_14 | 50.629 | 51.138 |  | spi_4944 | INOUT |  |  | LVCMOS18 | 4 | SLOW |  |  |  |  |  |  |  |  | NONE
14 | D18 |  | spi_sd[0] | IO_L1P_T0_D00_MOSI_14 | 70.007 | 70.711 |  | spi_4944 | INOUT |  |  | LVCMOS18 | 4 | SLOW |  |  |  |  |  |  |  |  | NONE
14 | D19 |  | spi_sd[1] | IO_L1N_T0_D01_DIN_14 | 68.618 | 69.308 |  | spi_4944 | INOUT |  |  | LVCMOS18 | 4 | SLOW |  |  |  |  |  |  |  |  | NONE
14 | G18 |  | spi_sd[2] | IO_L2P_T0_D02_14 | 64.093 | 64.737 |  | spi_4944 | INOUT |  |  | LVCMOS18 | 4 | SLOW |  |  |  |  |  |  |  |  | NONE
14 | F18 |  | spi_sd[3] | IO_L2N_T0_D03_14 | 62.552 | 63.18 |  | spi_4944 | INOUT |  |  | LVCMOS18 | 4 | SLOW |  |  |  |  |  |  |  |  | NONE
14 | D17 |  |  | IO_0_14 | 71.062 | 71.776
14 | E18 | Rename to a more generic name? EHL_GPIO_0? |  | IO_L3P_T0_DQS_PUDC_B_14 | 75.672 | 76.433
14 | F17 |  |  | VCCO_14 |  |  |  |  |  |  |  |  |  |  |  |  |  |  |  |  |  |  |  | VCCO_14 | 1.8
14 | G17 |  |  | IO_L5N_T0_D07_14 | 69.706 | 70.406
14 | H17 |  |  | IO_L5P_T0_D06_14 | 46.294 | 46.759
14 | J19 |  |  | IO_L6N_T0_D08_VREF_14 | 64.563 | 65.212
14 | K12 |  |  | VCCO_14 |  |  |  |  |  |  |  |  |  |  |  |  |  |  |  |  |  |  |  | VCCO_14 | 1.8
14 | K13 |  |  | VCCO_14 |  |  |  |  |  |  |  |  |  |  |  |  |  |  |  |  |  |  |  | VCCO_14 | 1.8
14 | L12 |  |  | VCCO_14 |  |  |  |  |  |  |  |  |  |  |  |  |  |  |  |  |  |  |  | VCCO_14 | 1.8
14 | L13 |  |  | VCCO_14 |  |  |  |  |  |  |  |  |  |  |  |  |  |  |  |  |  |  |  | VCCO_14 | 1.8
14 | L17 | Disconnect the PLTRSTN and connect to bank 35 Pin J1 |  | IO_L12P_T1_MRCC_14 | 71.438 | 72.156
14 | M12 |  |  | VCCO_14 |  |  |  |  |  |  |  |  |  |  |  |  |  |  |  |  |  |  |  | VCCO_14 | 1.8
14 | M17 |  |  | VCCO_14 |  |  |  |  |  |  |  |  |  |  |  |  |  |  |  |  |  |  |  | VCCO_14 | 1.8
14 | M19 |  |  | IO_L11N_T1_SRCC_14 | 59.648 | 60.248
14 | N17 |  |  | IO_L13P_T2_MRCC_14 | 33.368 | 33.704
14 | P17 |  |  | IO_L13N_T2_MRCC_14 | 37.578 | 37.956
14 | P19 |  |  | IO_L10P_T1_D14_14 | 37.46 | 37.836
14 | R17 |  |  | VCCO_14 |  |  |  |  |  |  |  |  |  |  |  |  |  |  |  |  |  |  |  | VCCO_14 | 1.8
14 | T18 |  |  | IO_L17N_T2_A13_D29_14 | 49.371 | 49.867
14 | U13 |  |  | VCCO_14 |  |  |  |  |  |  |  |  |  |  |  |  |  |  |  |  |  |  |  | VCCO_14 | 1.8
14 | U17 | Do we need a pullup Rename to a more generic name? EHL_GPIO_0? |  | IO_L18P_T2_A12_D28_14 | 48.053 | 48.536
14 | W18 |  |  | IO_L16P_T2_CSI_B_14 | 49.395 | 49.891
14 | W19 |  |  | IO_L16N_T2_A15_D31_14 | 46.869 | 47.34
16 | C15 |  | acq_exposure | IO_L11P_T1_SRCC_16 | 45.697 | 46.157 |  |  | IN |  |  | LVCMOS18
16 | B18 |  | acq_led[0] | IO_L19P_T3_16 | 51.785 | 52.306 |  |  | IN |  |  | LVCMOS18
16 | A18 |  | acq_led[1] | IO_L19N_T3_VREF_16 | 58.482 | 59.069 |  |  | IN |  |  | LVCMOS18
16 | B15 |  | acq_strobe | IO_L11N_T1_SRCC_16 | 65.377 | 66.034 |  |  | IN |  |  | LVCMOS18
16 | A16 |  | acq_trigger | IO_L12P_T1_MRCC_16 | 52.5 | 53.028 |  |  | OUT |  |  | LVCMOS18 | 4 | SLOW |  |  |  |  |  |  |  |  | NONE
16 | A17 |  | acq_trigger_ready | IO_L12N_T1_MRCC_16 | 48.791 | 49.282 |  |  | IN |  |  | LVCMOS18
16 | A15 | Clarify what we do with that signal | user_gled_soc | IO_L6N_T0_VREF_16 | 43.867 | 44.308 |  |  | IN |  |  | LVCMOS18
16 | A14 | Clarify what we do with that signal | user_rled_soc | IO_L6P_T0_16 | 60.607 | 61.216 |  |  | IN |  |  | LVCMOS18
16 | B16 |  |  | IO_L13N_T2_MRCC_16 | 44.012 | 44.454
16 | B17 | PWRST, Should be connected to H1 bank 35 |  | IO_L14N_T2_SRCC_16 | 47.592 | 48.071
16 | B19 |  |  | VCCO_16 |  |  |  |  |  |  |  |  |  |  |  |  |  |  |  |  |  |  |  | VCCO_16 | 1.8
16 | C14 |  |  | VCCO_16 |  |  |  |  |  |  |  |  |  |  |  |  |  |  |  |  |  |  |  | VCCO_16 | 1.8
16 | C16 |  |  | IO_L13P_T2_MRCC_16 | 33.166 | 33.5
16 | C17 |  |  | IO_L14P_T2_SRCC_16 | 44.102 | 44.545
16 | C18 |  |  | VCCO_16 |  |  |  |  |  |  |  |  |  |  |  |  |  |  |  |  |  |  |  | VCCO_16 | 1.8
16 | G13 |  |  | VCCO_16 |  |  |  |  |  |  |  |  |  |  |  |  |  |  |  |  |  |  |  | VCCO_16 | 1.8
34 | V2 |  | pwm_out | IO_L5P_T0_34 | 50.091 | 50.594 |  |  | OUT |  |  | LVCMOS33 | 4 | SLOW |  |  |  |  |  |  |  |  | NONE
34 | U5 |  | status_gled | IO_L16P_T2_34 | 60.584 | 61.193 |  |  | OUT |  |  | LVCMOS33 | 4 | SLOW |  |  |  |  |  |  |  |  | NONE
34 | U1 |  | status_rled | IO_L3N_T0_DQS_34 | 48.507 | 48.994 |  | CLK.CLK_100MHZ_CLK.sys_clk_57745 | OUT |  |  | LVCMOS33 | 4 | SLOW |  |  |  |  |  |  |  |  | NONE
34 | R2 |  | user_data_in[0] | IO_L1P_T0_34 | 51.757 | 52.277 |  |  | IN |  |  | LVCMOS33
34 | T2 |  | user_data_in[1] | IO_L1N_T0_34 | 53.452 | 53.989 |  |  | IN |  |  | LVCMOS33
34 | T1 |  | user_data_in[2] | IO_L3P_T0_DQS_34 | 50.79 | 51.301 |  |  | IN |  |  | LVCMOS33
34 | R3 |  | user_data_in[3] | IO_L2P_T0_34 | 59.313 | 59.909 |  |  | IN |  |  | LVCMOS33
34 | T3 |  | user_data_out[0] | IO_L2N_T0_34 | 47.809 | 48.289 |  |  | OUT |  |  | LVCMOS33 | 4 | SLOW |  |  |  |  |  |  |  |  | NONE
34 | U8 |  | user_data_out[1] | IO_L14P_T2_SRCC_34 | 75.687 | 76.447 |  |  | OUT |  |  | LVCMOS33 | 4 | SLOW |  |  |  |  |  |  |  |  | NONE
34 | U7 |  | user_data_out[2] | IO_L19P_T3_34 | 72.032 | 72.756 |  |  | OUT |  |  | LVCMOS33 | 4 | SLOW |  |  |  |  |  |  |  |  | NONE
34 | U2 |  | user_gled | IO_L9N_T1_DQS_34 | 43.75 | 44.19 |  |  | OUT |  |  | LVCMOS33 | 4 | SLOW |  |  |  |  |  |  |  |  | NONE
34 | U4 |  | user_rled | IO_L11P_T1_SRCC_34 | 39.989 | 40.391 |  |  | OUT |  |  | LVCMOS33 | 4 | SLOW |  |  |  |  |  |  |  |  | NONE
34 | M8 |  |  | VCCO_34 |  |  |  |  |  |  |  |  |  |  |  |  |  |  |  |  |  |  |  | VCCO_34 | 3.3
34 | N7 |  |  | VCCO_34 |  |  |  |  |  |  |  |  |  |  |  |  |  |  |  |  |  |  |  | VCCO_34 | 3.3
34 | N8 |  |  | VCCO_34 |  |  |  |  |  |  |  |  |  |  |  |  |  |  |  |  |  |  |  | VCCO_34 | 3.3
34 | R1 |  |  | VCCO_34 |  |  |  |  |  |  |  |  |  |  |  |  |  |  |  |  |  |  |  | VCCO_34 | 3.3
34 | U3 |  |  | IO_L9P_T1_DQS_34 | 44.574 | 45.022
34 | V1 |  |  | VCCO_34 |  |  |  |  |  |  |  |  |  |  |  |  |  |  |  |  |  |  |  | VCCO_34 | 3.3
34 | V3 |  |  | IO_L6P_T0_34 | 49.028 | 49.521
34 | V4 |  |  | IO_L11N_T1_SRCC_34 | 63.66 | 64.299
34 | V5 |  |  | IO_L16N_T2_34 | 45.243 | 45.698
34 | V6 |  |  | VCCO_34 |  |  |  |  |  |  |  |  |  |  |  |  |  |  |  |  |  |  |  | VCCO_34 | 3.3
34 | V7 |  |  | IO_L19N_T3_VREF_34 | 38.448 | 38.834
34 | V8 |  |  | IO_L14N_T2_SRCC_34 | 76.122 | 76.887
34 | W2 |  |  | IO_L5N_T0_34 | 64.13 | 64.774
34 | W3 |  |  | IO_L6N_T0_VREF_34 | 66.015 | 66.678
34 | W4 |  |  | IO_L12N_T1_MRCC_34 | 51.095 | 51.608
34 | W5 |  |  | IO_L12P_T1_MRCC_34 | 53.927 | 54.469
34 | W6 |  |  | IO_L13N_T2_MRCC_34 | 69.746 | 70.447
34 | W7 |  |  | IO_L13P_T2_MRCC_34 | 51.483 | 52
35 | N3 |  | ncsi_clk | IO_L12P_T1_MRCC_35 | 48.179 | 48.663 |  |  | OUT |  |  | LVCMOS33 | 4 | SLOW |  |  |  |  |  |  |  |  | NONE
35 | M2 |  | ncsi_rx_crs_dv | IO_L9P_T1_DQS_AD7P_35 | 52.172 | 52.696 |  | ncsi_4944 | IN |  |  | LVCMOS33
35 | N1 |  | ncsi_rxd[0] | IO_L10N_T1_AD15N_35 | 50.477 | 50.985 |  | ncsi_4944 | IN |  |  | LVCMOS33
35 | M1 |  | ncsi_rxd[1] | IO_L9N_T1_DQS_AD7N_35 | 52.04 | 52.563 |  | ncsi_4944 | IN |  |  | LVCMOS33
35 | N2 |  | ncsi_tx_en | IO_L10P_T1_AD15P_35 | 49.851 | 50.352 |  | ncsi_4944 | OUT |  |  | LVCMOS33 | 4 | SLOW |  |  |  |  |  |  |  |  | NONE
35 | M3 |  | ncsi_txd[0] | IO_L8N_T1_AD14N_35 | 52.966 | 53.499 |  | ncsi_4944 | OUT |  |  | LVCMOS33 | 4 | SLOW |  |  |  |  |  |  |  |  | NONE
35 | L3 |  | ncsi_txd[1] | IO_L8P_T1_AD14P_35 | 44.149 | 44.593 |  | ncsi_4944 | OUT |  |  | LVCMOS33 | 4 | SLOW |  |  |  |  |  |  |  |  | NONE
35 | J1 | Not Connected. See note above on pin L17 | sys_rst_in_n | IO_L3N_T0_DQS_AD5N_35 | 45.809 | 46.27 |  | RST.sys_rst_n_27828 | IN |  |  | LVCMOS33
35 | H1 | Not connected. See note above on pin B17 | sys_rst_out_n | IO_L3P_T0_DQS_AD5P_35 | 45.368 | 45.824 |  | CLK.CLK_100MHZ_CLK.sys_clk_57745 | OUT |  |  | LVCMOS33 | 12 | SLOW |  |  |  |  |  |  |  |  | FP_VTT_50
35 | G2 |  |  | IO_L1N_T0_AD4N_35 | 30.883 | 31.194
35 | G3 |  |  | IO_L1P_T0_AD4P_35 | 47.891 | 48.373
35 | H2 |  |  | IO_L2P_T0_AD12P_35 | 49.625 | 50.124
35 | H3 |  |  | VCCO_35 |  |  |  |  |  |  |  |  |  |  |  |  |  |  |  |  |  |  |  | VCCO_35 | 3.3
35 | J2 |  |  | IO_L2N_T0_AD12N_35 | 48.887 | 49.378
35 | J3 |  |  | IO_L7P_T1_AD6P_35 | 44.262 | 44.707
35 | J7 |  |  | VCCO_35 |  |  |  |  |  |  |  |  |  |  |  |  |  |  |  |  |  |  |  | VCCO_35 | 3.3
35 | K1 |  |  | VCCO_35 |  |  |  |  |  |  |  |  |  |  |  |  |  |  |  |  |  |  |  | VCCO_35 | 3.3
35 | K2 |  |  | IO_L5P_T0_AD13P_35 | 47.548 | 48.026
35 | K3 |  |  | IO_L7N_T1_AD6N_35 | 51.176 | 51.691
35 | K7 |  |  | VCCO_35 |  |  |  |  |  |  |  |  |  |  |  |  |  |  |  |  |  |  |  | VCCO_35 | 3.3
35 | L1 |  |  | IO_L6N_T0_VREF_35 | 62.104 | 62.728
35 | L2 |  |  | IO_L5N_T0_AD13N_35 | 56.736 | 57.306
35 | L7 |  |  | VCCO_35 |  |  |  |  |  |  |  |  |  |  |  |  |  |  |  |  |  |  |  | VCCO_35 | 3.3
35 | M7 |  |  | VCCO_35 |  |  |  |  |  |  |  |  |  |  |  |  |  |  |  |  |  |  |  | VCCO_35 | 3.3
35 | P1 |  |  | IO_L19N_T3_VREF_35 | 56.141 | 56.706
35 | P3 |  |  | IO_L12N_T1_MRCC_35 | 58.806 | 59.397
216 | A4 |  | pcie_rxn[0] | MGTPRXN0_216 | 35.486 | 35.843 |  | pcie_7x_mgt_27828 | IN
216 | B4 |  | pcie_rxp[0] | MGTPRXP0_216 | 31.423 | 31.739 |  | pcie_7x_mgt_27828 | IN
216 | A8 |  | pcie_sys_clk_n | MGTREFCLK0N_216 | 27.772 | 28.051 |  | CLK.CLK_100MHZ_CLK.sys_clk_57745 | IN | N | pcie_sys_clk_p
216 | B8 |  | pcie_sys_clk_p | MGTREFCLK0P_216 | 29.762 | 30.062 |  | CLK.CLK_100MHZ_CLK.sys_clk_57745 | IN | P | pcie_sys_clk_n
216 | D1 |  | pcie_txn[0] | MGTPTXN0_216 | 27.518 | 27.794 |  | pcie_7x_mgt_27828 | OUT |  |  |  | 12
216 | D2 |  | pcie_txp[0] | MGTPTXP0_216 | 28.188 | 28.471 |  | pcie_7x_mgt_27828 | OUT |  |  |  | 12
216 | A10 |  |  | MGTREFCLK1N_216 | 53.22 | 53.755
216 | A2 |  |  | MGTPTXN1_216 | 41.628 | 42.047
216 | A6 |  |  | MGTPRXN1_216 | 28.909 | 29.199
216 | B10 |  |  | MGTREFCLK1P_216 | 52.342 | 52.868
216 | B2 |  |  | MGTPTXP1_216 | 37.713 | 38.092
216 | B6 |  |  | MGTPRXP1_216 | 32.311 | 32.636
216 | C7 |  |  | MGTRREF_216 | 33.344 | 33.679
 | A1 |  |  | GND |  |  |  |  |  |  |  |  |  |  |  |  |  |  |  |  |  |  |  | GND | GND
 | A19 |  |  | GND |  |  |  |  |  |  |  |  |  |  |  |  |  |  |  |  |  |  |  | GND | GND
 | A3 |  |  | GND |  |  |  |  |  |  |  |  |  |  |  |  |  |  |  |  |  |  |  | GND | GND
 | A5 |  |  | GND |  |  |  |  |  |  |  |  |  |  |  |  |  |  |  |  |  |  |  | GND | GND
 | A7 |  |  | GND |  |  |  |  |  |  |  |  |  |  |  |  |  |  |  |  |  |  |  | GND | GND
 | A9 |  |  | GND |  |  |  |  |  |  |  |  |  |  |  |  |  |  |  |  |  |  |  | GND | GND
 | B1 |  |  | MGTAVTT
 | B14 |  |  | GND |  |  |  |  |  |  |  |  |  |  |  |  |  |  |  |  |  |  |  | GND | GND
 | B3 |  |  | GND |  |  |  |  |  |  |  |  |  |  |  |  |  |  |  |  |  |  |  | GND | GND
 | B5 |  |  | GND |  |  |  |  |  |  |  |  |  |  |  |  |  |  |  |  |  |  |  | GND | GND
 | B7 |  |  | GND |  |  |  |  |  |  |  |  |  |  |  |  |  |  |  |  |  |  |  | GND | GND
 | B9 |  |  | GND |  |  |  |  |  |  |  |  |  |  |  |  |  |  |  |  |  |  |  | GND | GND
 | C1 |  |  | MGTAVCC
 | C10 |  |  | GND |  |  |  |  |  |  |  |  |  |  |  |  |  |  |  |  |  |  |  | GND | GND
 | C19 |  |  | GND |  |  |  |  |  |  |  |  |  |  |  |  |  |  |  |  |  |  |  | GND | GND
 | C2 |  |  | GND |  |  |  |  |  |  |  |  |  |  |  |  |  |  |  |  |  |  |  | GND | GND
 | C3 |  |  | GND |  |  |  |  |  |  |  |  |  |  |  |  |  |  |  |  |  |  |  | GND | GND
 | C4 |  |  | GND |  |  |  |  |  |  |  |  |  |  |  |  |  |  |  |  |  |  |  | GND | GND
 | C5 |  |  | MGTAVTT
 | C6 |  |  | GND |  |  |  |  |  |  |  |  |  |  |  |  |  |  |  |  |  |  |  | GND | GND
 | D3 |  |  | GND |  |  |  |  |  |  |  |  |  |  |  |  |  |  |  |  |  |  |  | GND | GND
 | E1 |  |  | MGTAVCC
 | E17 |  |  | GND |  |  |  |  |  |  |  |  |  |  |  |  |  |  |  |  |  |  |  | GND | GND
 | E2 |  |  | MGTAVTT
 | E3 |  |  | GND |  |  |  |  |  |  |  |  |  |  |  |  |  |  |  |  |  |  |  | GND | GND
 | F1 |  |  | GND |  |  |  |  |  |  |  |  |  |  |  |  |  |  |  |  |  |  |  | GND | GND
 | F19 |  |  | GND |  |  |  |  |  |  |  |  |  |  |  |  |  |  |  |  |  |  |  | GND | GND
 | F2 |  |  | GND |  |  |  |  |  |  |  |  |  |  |  |  |  |  |  |  |  |  |  | GND | GND
 | F3 |  |  | MGTAVCC
 | G1 |  |  | GND |  |  |  |  |  |  |  |  |  |  |  |  |  |  |  |  |  |  |  | GND | GND
 | G10 |  |  | VCCINT
 | G11 |  |  | GND |  |  |  |  |  |  |  |  |  |  |  |  |  |  |  |  |  |  |  | GND | GND
 | G7 |  |  | MGTAVTT
 | G8 |  |  | GND |  |  |  |  |  |  |  |  |  |  |  |  |  |  |  |  |  |  |  | GND | GND
 | G9 |  |  | MGTAVCC
 | H10 |  |  | VCCINT
 | H11 |  |  | GND |  |  |  |  |  |  |  |  |  |  |  |  |  |  |  |  |  |  |  | GND | GND
 | H12 |  |  | GND |  |  |  |  |  |  |  |  |  |  |  |  |  |  |  |  |  |  |  | GND | GND
 | H13 |  |  | VCCAUX |  |  |  |  |  |  |  |  |  |  |  |  |  |  |  |  |  |  |  | VCCAUX | 1.8
 | H18 |  |  | GND |  |  |  |  |  |  |  |  |  |  |  |  |  |  |  |  |  |  |  | GND | GND
 | H7 |  |  | GND |  |  |  |  |  |  |  |  |  |  |  |  |  |  |  |  |  |  |  | GND | GND
 | H8 |  |  | GND |  |  |  |  |  |  |  |  |  |  |  |  |  |  |  |  |  |  |  | GND | GND
 | H9 |  |  | MGTAVCC
 | J10 |  |  | VCCINT
 | J11 |  |  | GND |  |  |  |  |  |  |  |  |  |  |  |  |  |  |  |  |  |  |  | GND | GND
 | J12 |  |  | GND |  |  |  |  |  |  |  |  |  |  |  |  |  |  |  |  |  |  |  | GND | GND
 | J13 |  |  | VCCAUX |  |  |  |  |  |  |  |  |  |  |  |  |  |  |  |  |  |  |  | VCCAUX | 1.8
 | J8 |  |  | GND |  |  |  |  |  |  |  |  |  |  |  |  |  |  |  |  |  |  |  | GND | GND
 | J9 |  |  | GND |  |  |  |  |  |  |  |  |  |  |  |  |  |  |  |  |  |  |  | GND | GND
 | K8 |  |  | GND |  |  |  |  |  |  |  |  |  |  |  |  |  |  |  |  |  |  |  | GND | GND
 | L10 |  |  | VCCINT
 | L11 |  |  | GND |  |  |  |  |  |  |  |  |  |  |  |  |  |  |  |  |  |  |  | GND | GND
 | L19 |  |  | GND |  |  |  |  |  |  |  |  |  |  |  |  |  |  |  |  |  |  |  | GND | GND
 | L8 |  |  | GND |  |  |  |  |  |  |  |  |  |  |  |  |  |  |  |  |  |  |  | GND | GND
 | L9 |  |  | GND |  |  |  |  |  |  |  |  |  |  |  |  |  |  |  |  |  |  |  | GND | GND
 | M10 |  |  | VCCINT
 | M11 |  |  | VCCBRAM
 | M13 |  |  | GND |  |  |  |  |  |  |  |  |  |  |  |  |  |  |  |  |  |  |  | GND | GND
 | M9 |  |  | GND |  |  |  |  |  |  |  |  |  |  |  |  |  |  |  |  |  |  |  | GND | GND
 | N10 |  |  | VCCINT
 | N11 |  |  | VCCBRAM
 | N12 |  |  | GND |  |  |  |  |  |  |  |  |  |  |  |  |  |  |  |  |  |  |  | GND | GND
 | N13 |  |  | GND |  |  |  |  |  |  |  |  |  |  |  |  |  |  |  |  |  |  |  | GND | GND
 | N9 |  |  | GND |  |  |  |  |  |  |  |  |  |  |  |  |  |  |  |  |  |  |  | GND | GND
 | P2 |  |  | GND |  |  |  |  |  |  |  |  |  |  |  |  |  |  |  |  |  |  |  | GND | GND
 | T19 |  |  | GND |  |  |  |  |  |  |  |  |  |  |  |  |  |  |  |  |  |  |  | GND | GND
 | U6 |  |  | GND |  |  |  |  |  |  |  |  |  |  |  |  |  |  |  |  |  |  |  | GND | GND
 | U9 |  |  | GND |  |  |  |  |  |  |  |  |  |  |  |  |  |  |  |  |  |  |  | GND | GND
 | V18 |  |  | GND |  |  |  |  |  |  |  |  |  |  |  |  |  |  |  |  |  |  |  | GND | GND
 | W1 |  |  | GND |  |  |  |  |  |  |  |  |  |  |  |  |  |  |  |  |  |  |  | GND | GND
 | W12 |  |  | GND |  |  |  |  |  |  |  |  |  |  |  |  |  |  |  |  |  |  |  | GND | GND
