AM4511/test_migrate_iris4/athena/doc/sensors/xgs_sensor_pinout_mapping.xlsx

Sheet: xgS
XGS12m | XGS5m |  | IO | Interface | Port Name | IO Type
D9 |  | From controller | 1 | System | EXTCLK | LVCMOS_1.8/2.8
F8 |  |  | 2 | System | RESET_N | LVCMOS_1.8/2.8
E9 |  |  | 3 | SPI | CS_N | LVCMOS_1.8/2.8
F9 |  |  | 4 | SPI | SCLK | LVCMOS_1.8/2.8
D11 |  |  | 5 | SPI | SDATA | LVCMOS_1.8/2.8
F11 |  |  | 6 | Trigger | TRIG_INT | LVCMOS_1.8/2.8
E11 |  |  | 7 | Trigger | TRIG_RD | LVCMOS_1.8/2.8
E8 |  | To controller | 8 | Control | MONITOR_0 | LVCMOS_1.8/2.8
D8 |  |  | 9 | Control | MONITOR_1 | LVCMOS_1.8/2.8
D7 |  |  | 10 | Control | MONITOR_2 | LVCMOS_1.8/2.8
E10 |  |  | 11 | SPI | SDATAOUT | LVCMOS_1.8/2.8
F13 |  |  | 12 | hispi | D_CLK_0_N | SLVS (0.4/1.2)
F14 |  |  | 13 | hispi | D_CLK_0_P | SLVS (0.4/1.2)
F6 |  |  | 14 | hispi | D_CLK_1_N | SLVS (0.4/1.2)
F5 |  |  | 15 | hispi | D_CLK_1_P | SLVS (0.4/1.2)
J13 |  |  | 16 | hispi | D_CLK_2_N | SLVS (0.4/1.2)
J14 |  |  | 17 | hispi | D_CLK_2_P | SLVS (0.4/1.2)
J6 |  |  | 18 | hispi | D_CLK_3_N | SLVS (0.4/1.2)
J5 |  |  | 19 | hispi | D_CLK_3_P | SLVS (0.4/1.2)
E12 |  |  | 20 | hispi | DATA_0_N | SLVS (0.4/1.2)
E13 |  |  | 21 | hispi | DATA_0_P | SLVS (0.4/1.2)
E7 |  |  | 22 | hispi | DATA_1_N | SLVS (0.4/1.2)
E6 |  |  | 23 | hispi | DATA_1_P | SLVS (0.4/1.2)
E14 |  |  | 24 | hispi | DATA_2_N | SLVS (0.4/1.2)
E15 |  |  | 25 | hispi | DATA_2_P | SLVS (0.4/1.2)
E5 |  |  | 26 | hispi | DATA_3_N | SLVS (0.4/1.2)
E4 |  |  | 27 | hispi | DATA_3_P | SLVS (0.4/1.2)
G12 |  |  | 28 | hispi | DATA_4_N | SLVS (0.4/1.2)
G13 |  |  | 29 | hispi | DATA_4_P | SLVS (0.4/1.2)
G7 |  |  | 30 | hispi | DATA_5_N | SLVS (0.4/1.2)
G6 |  |  | 31 | hispi | DATA_5_P | SLVS (0.4/1.2)

Sheet: xgs12m
VDD_PLL | C10 | Power | PLL Power Supply
FWSI_EN | D10 | Input | Connect to VDD_IO through a 10k resistor
SDATA | D11 | Input | SPI Slave In
MONITOR_2 | D7 | Output | Monitor Output 2. If unused, do not connect.
MONITOR_1 | D8 | Output | Monitor Output 1. If unused, do not connect.
EXTCLK | D9 | Input | External Clock Input
SDATAOUT | E10 | Output | SPI Slave Out
TRIG_RD | E11 | Input | Trigger Input for Readout Control. If unused, connect to ground.
DATA_0_N | E12 | HiSPi | Differential Data Channel [0], Negative
DATA_0_P | E13 | HiSPi | Differential Data Channel [0], Positive
DATA_2_N | E14 | HiSPi | Differential Data Channel [2], Negative
DATA_2_P | E15 | HiSPi | Differential Data Channel [2], Positive
DATA_3_P | E4 | HiSPi | Differential Data Channel [3], Positive
DATA_3_N | E5 | HiSPi | Differential Data Channel [3], Negative
DATA_1_P | E6 | HiSPi | Differential Data Channel [1], Positive
DATA_1_N | E7 | HiSPi | Differential Data Channel [1], Negative
MONITOR_0 | E8 | Output | Monitor Output 0. If unused, keep do not connect.
CS_N | E9 | Input | SPI Chip Select (Active Low)
TRIG_INT | F11 | Input | Trigger Input for Integration Control. If unused, connect to ground.
D_CLK_0_N | F13 | HiSPi | Differential Clock [0], Negative
D_CLK_0_P | F14 | HiSPi | Differential Clock [0], Positive
D_CLK_1_P | F5 | HiSPi | Differential Clock [1], Positive
D_CLK_1_N | F6 | HiSPi | Differential Clock [1], Negative
RESET_N | F8 | Input | Asynchronous Hard Reset (Active Low)
SCLK | F9 | Input | SPI Clock Input
DATA_4_N | G12 | HiSPi | Differential Data Channel [4], Negative
DATA_4_P | G13 | HiSPi | Differential Data Channel [4], Positive
DATA_6_N | G14 | HiSPi | Differential Data Channel [6], Negative
DATA_6_P | G15 | HiSPi | Differential Data Channel [6], Positive
DATA_7_P | G4 | HiSPi | Differential Data Channel [7], Positive
DATA_7_N | G5 | HiSPi | Differential Data Channel [7], Negative
DATA_5_P | G6 | HiSPi | Differential Data Channel [5], Positive
DATA_5_N | G7 | HiSPi | Differential Data Channel [5], Negative
DATA_8_N | H12 | HiSPi | Differential Data Channel [8], Negative
DATA_8_P | H13 | HiSPi | Differential Data Channel [8], Positive
DATA_10_N | H14 | HiSPi | Differential Data Channel [10], Negative
DATA_10_P | H15 | HiSPi | Differential Data Channel [10], Positive
DATA_11_P | H4 | HiSPi | Differential Data Channel [11], Positive
DATA_11_N | H5 | HiSPi | Differential Data Channel [11], Negative
DATA_9_P | H6 | HiSPi | Differential Data Channel [9], Positive
DATA_9_N | H7 | HiSPi | Differential Data Channel [9], Negative
D_CLK_2_N | J13 | HiSPi | Differential Clock [2], Negative
D_CLK_2_P | J14 | HiSPi | Differential Clock [2], Positive
D_CLK_3_P | J5 | HiSPi | Differential Clock [3], Positive
D_CLK_3_N | J6 | HiSPi | Differential Clock [3], Negative
DATA_12_N | K12 | HiSPi | Differential Data Channel [12], Negative
DATA_12_P | K13 | HiSPi | Differential Data Channel [12], Positive
DATA_14_N | K14 | HiSPi | Differential Data Channel [14], Negative
DATA_14_P | K15 | HiSPi | Differential Data Channel [14], Positive
DATA_15_P | K4 | HiSPi | Differential Data Channel [15], Positive
DATA_15_N | K5 | HiSPi | Differential Data Channel [15], Negative
DATA_13_P | K6 | HiSPi | Differential Data Channel [13], Positive
DATA_13_N | K7 | HiSPi | Differential Data Channel [13], Negative
DATA_16_N | L12 | HiSPi | Differential Data Channel [16], Negative
DATA_16_P | L13 | HiSPi | Differential Data Channel [16], Positive
DATA_18_N | L14 | HiSPi | Differential Data Channel [18], Negative
DATA_18_P | L15 | HiSPi | Differential Data Channel [18], Positive
DATA_19_P | L4 | HiSPi | Differential Data Channel [19], Positive
DATA_19_N | L5 | HiSPi | Differential Data Channel [19], Negative
DATA_17_P | L6 | HiSPi | Differential Data Channel [17], Positive
DATA_17_N | L7 | HiSPi | Differential Data Channel [17], Negative
D_CLK_4_N | M13 | HiSPi | Differential Clock [4], Negative
D_CLK_4_P | M14 | HiSPi | Differential Clock [4], Positive
D_CLK_5_P | M5 | HiSPi | Differential Clock [5], Positive
D_CLK_5_N | M6 | HiSPi | Differential Clock [5], Negative
DATA_20_N | N12 | HiSPi | Differential Data Channel [20], Negative
DATA_20_P | N13 | HiSPi | Differential Data Channel [20], Positive
DATA_22_N | N14 | HiSPi | Differential Data Channel [22], Negative
DATA_22_P | N15 | HiSPi | Differential Data Channel [22], Positive
DATA_23_P | N4 | HiSPi | Differential Data Channel [23], Positive
DATA_23_N | N5 | HiSPi | Differential Data Channel [23], Negative
DATA_21_P | N6 | HiSPi | Differential Data Channel [21], Positive
DATA_21_N | N7 | HiSPi | Differential Data Channel [21], Negative
VAA_PIX_A0 | P10 | Decoupling | External Noise Decoupling (0.1 uF + 4.7 uF to GND)
VAA_PIX_A1 | P11 | Decoupling | External Noise Decoupling (0.1 uF + 4.7 uF to GND)
VAA_PIX_A2 | R10 | Decoupling | External Noise Decoupling (0.1 uF + 4.7 uF to GND)
VAA_PIX_A3 | T11 | Decoupling | External Noise Decoupling (0.1 uF + 4.7 uF to GND)
VAA_PIX_A4 | T12 | Decoupling | External Noise Decoupling (0.1 uF + 4.7 uF to GND)
VAA_PIX_A5 | T6 | Decoupling | External Noise Decoupling (0.1 uF + 4.7 uF to GND)
VAA_PIX_B0 | P8 | Decoupling | External Noise Decoupling (0.1 uF + 2.2 uF to GND)
VAA_PIX_B1 | P9 | Decoupling | External Noise Decoupling (0.1 uF + 2.2 uF to GND)
VAA_PIX_B2 | R8 | Decoupling | External Noise Decoupling (0.1 uF + 2.2 uF to GND)
VAA_PIX_B3 | R9 | Decoupling | External Noise Decoupling (0.1 uF + 2.2 uF to GND)
VAA_PIX_B4 | T7 | Decoupling | External Noise Decoupling (0.1 uF + 2.2 uF to GND)
VAA_PIX_B5 | T8 | Decoupling | External Noise Decoupling (0.1 uF + 2.2 uF to GND)
VAA_PIX_C0 | R11 | Decoupling | External Noise Decoupling (0.1 uF to GND)
VAA_PIX_C1 | T13 | Decoupling | External Noise Decoupling (0.1 uF to GND)
GND | A1 | Ground | Ground
GND | A18 | Ground | Ground
GND | C3 | Ground | Ground
GND | C7 | Ground | Ground
GND | C12 | Ground | Ground
GND | C16 | Ground | Ground
GND | F4 | Ground | Ground
GND | F15 | Ground | Ground
GND | G3 | Ground | Ground
GND | G16 | Ground | Ground
GND | T16 | Ground | Ground
GND | M4 | Ground | Ground
GND | M11 | Ground | Ground
GND | M15 | Ground | Ground
GND | N8 | Ground | Ground
GND | N11 | Ground | Ground
GND | P7 | Ground | Ground
GND | P12 | Ground | Ground
GND | T3 | Ground | Ground
GND | T10 | Ground | Ground
GND | J4 | Ground | Ground
GND | J15 | Ground | Ground
GND | K3 | Ground | Ground
GND | K16 | Ground | Ground
GND | V1 | Ground | Ground
GND | V18 | Ground | Ground
GND | D12 | Ground | Ground
GND | F10 | Ground | Ground
GND | G8 | Ground | Ground
GND | G9 | Ground | Ground
GND | G10 | Ground | Ground
GND | G11 | Ground | Ground
GND | P6 | Ground | Ground
GND | P13 | Ground | Ground
VAA | C5 | Power | Analog Supply
VAA | C14 | Power | Analog Supply
VAA | M9 | Power | Analog Supply
VAA | M10 | Power | Analog Supply
VAA | N3 | Power | Analog Supply
VAA | N9 | Power | Analog Supply
VAA | N10 | Power | Analog Supply
VAA | N16 | Power | Analog Supply
VAA | R5 | Power | Analog Supply
VAA | R6 | Power | Analog Supply
VAA | R13 | Power | Analog Supply
VAA | R14 | Power | Analog Supply
VAA | T9 | Power | Analog Supply
VAA_RD | C6 | Power | Analog Supply for Row Driver
VAA_RD | C13 | Power | Analog Supply for Row Driver
VAA_RD | T5 | Power | Analog Supply for Row Driver
VAA_RD | T14 | Power | Analog Supply for Row Driver
VDD_IO | C8 | Power | I/O Supply
VDD_IO | C9 | Power | I/O Supply
VDD_IO | C11 | Power | I/O Supply
VDD_IO | P3 | Power | I/O Supply
VDD_IO | P16 | Power | I/O Supply
VAA_PIX | D5 | Power | Pixel Supply
VAA_PIX | D14 | Power | Pixel Supply
VAA_PIX | P5 | Power | Pixel Supply
VAA_PIX | P14 | Power | Pixel Supply
VDD | D6 | Power | Digital Supply
VDD | D13 | Power | Digital Supply
VDD | E3 | Power | Digital Supply
VDD | E16 | Power | Digital Supply
VDD | F7 | Power | Digital Supply
VDD | F12 | Power | Digital Supply
VDD | H3 | Power | Digital Supply
VDD | H16 | Power | Digital Supply
VDD | J7 | Power | Digital Supply
VDD | J12 | Power | Digital Supply
VDD | L3 | Power | Digital Supply
VDD | L16 | Power | Digital Supply
VDD | M7 | Power | Digital Supply
VDD | M12 | Power | Digital Supply
VDD_SLVS | F3 | Power | HiSPi Supply
VDD_SLVS | F16 | Power | HiSPi Supply
VDD_SLVS | J3 | Power | HiSPi Supply
VDD_SLVS | J16 | Power | HiSPi Supply
VDD_SLVS | M3 | Power | HiSPi Supply
VDD_SLVS | M16 | Power | HiSPi Supply
VAA_PIX_BST | R7 | Power | Pixel Booster Supply
VAA_PIX_BST | R12 | Power | Pixel Booster Supply
RESERVED | P4 | N/A | Reserved (do not connect)
RESERVED | P15 | N/A | Reserved (do not connect)

Sheet: xgs5m
GND | A5 | Ground | Ground
GND | A10 | Ground | Ground
GND | A13 | Ground | Ground
GND | D2 | Ground | Ground
GND | D13 | Ground | Ground
GND | E1 | Ground | Ground
GND | E14 | Ground | Ground
GND | G2 | Ground | Ground
GND | G13 | Ground | Ground
GND | H1 | Ground | Ground
GND | H14 | Ground | Ground
GND | J2 | Ground | Ground
GND | J3 | Ground | Ground
GND | J4 | Ground | Ground
GND | J5 | Ground | Ground
GND | J10 | Ground | Ground
GND | J11 | Ground | Ground
GND | J12 | Ground | Ground
GND | J13 | Ground | Ground
GND | K2 | Ground | Ground
GND | K3 | Ground | Ground
GND | K4 | Ground | Ground
GND | K9 | Ground | Ground
GND | K11 | Ground | Ground
GND | K12 | Ground | Ground
GND | K13 | Ground | Ground
GND | L2 | Ground | Ground
GND | L3 | Ground | Ground
GND | L4 | Ground | Ground
GND | L5 | Ground | Ground
GND | L6 | Ground | Ground
GND | L9 | Ground | Ground
GND | L10 | Ground | Ground
GND | L11 | Ground | Ground
GND | L12 | Ground | Ground
GND | L13 | Ground | Ground
GND | M5 | Ground | Ground
GND | M10 | Ground | Ground
GND | N1 | Ground | Ground
GND | N13 | Ground | Ground
GND | P8 | Ground | Ground
VDD_PLL | C10 | Power | PLL Power Supply
VAA | M13 | Power | Analog Supply
VAA | A3 | Power | Analog Supply
VAA | N3 | Power | Analog Supply
VAA | N4 | Power | Analog Supply
VAA | P7 | Power | Analog Supply
VAA | L7 | Power | Analog Supply
VAA | K7 | Power | Analog Supply
VAA | L8 | Power | Analog Supply
VAA | K8 | Power | Analog Supply
VAA | N11 | Power | Analog Supply
VAA | N12 | Power | Analog Supply
VAA | A12 | Power | Analog Supply
VAA | L14 | Power | Analog Supply
VAA_RD | A4 | Power | Analog Supply for Row Driver
VAA_RD | A11 | Power | Analog Supply for Row Driver
VAA_RD | P3 | Power | Analog Supply for Row Driver
VAA_RD | P12 | Power | Analog Supply for Row Driver
VDD_IO | A6 | Power | I/O Supply
VDD_IO | A7 | Power | I/O Supply
VDD_IO | A9 | Power | I/O Supply
VDD_IO | M1 | Power | I/O Supply
VDD_IO | M14 | Power | I/O Supply
FWSI_EN | B8 | Input | Connect to VDD_IO through a 10k resistor
SDATA | B9 | Input | SPI Slave In
VAA_PIX | B3 | Power | Pixel Supply
VAA_PIX | B12 | Power | Pixel Supply
VAA_PIX | M3 | Power | Pixel Supply
VAA_PIX | M12 | Power | Pixel Supply
VDD | C1 | Power | Digital Supply
VDD | F1 | Power | Digital Supply
VDD | K1 | Power | Digital Supply
VDD | B4 | Power | Digital Supply
VDD | D5 | Power | Digital Supply
VDD | G5 | Power | Digital Supply
VDD | K5 | Power | Digital Supply
VDD | D10 | Power | Digital Supply
VDD | G10 | Power | Digital Supply
VDD | K10 | Power | Digital Supply
VDD | B11 | Power | Digital Supply
VDD | C14 | Power | Digital Supply
VDD | F14 | Power | Digital Supply
VDD | J14 | Power | Digital Supply
MONITOR_2 | B5 | Output | Monitor Output 2. If unused, do not connect.
MONITOR_1 | B6 | Output | Monitor Output 1. If unused, do not connect.
EXTCLK | B7 | Input | External Clock Input
SDATAOUT | C8 | Output | SPI Slave Out
TRIG_RD | C9 | Input | Trigger Input for Readout Control. If unused, connectto ground.
DATA_0_N | C10 | HiSPi | Differential Data Channel [0], Negative
DATA_0_P | C11 | HiSPi | Differential Data Channel [0], Positive
DATA_2_N | C12 | HiSPi | Differential Data Channel [2], Negative
DATA_2_P | C13 | HiSPi | Differential Data Channel [2], Positive
DATA_3_P | D2 | HiSPi | Differential Data Channel [3], Positive
DATA_3_N | D3 | HiSPi | Differential Data Channel [3], Negative
DATA_1_P | D4 | HiSPi | Differential Data Channel [1], Positive
DATA_1_N | D5 | HiSPi | Differential Data Channel [1], Negative
MONITOR_0 | C6 | Output | Monitor Output 0. If unused, keep do not connect.
CS_N | C7 | Input | SPI Chip Select (Active Low)
TRIG_INT | D9 | Input | Trigger Input for Integration Control. If unused, connectto ground.
D_CLK_0_N | D11 | HiSPi | Differential Clock [0], Negative
D_CLK_0_P | D12 | HiSPi | Differential Clock [0], Positive
VDD_SLVS | D1 | Power | HiSPi Supply
VDD_SLVS | D14 | Power | HiSPi Supply
VDD_SLVS | G1 | Power | HiSPi Supply
VDD_SLVS | G14 | Power | HiSPi Supply
VDD_SLVS | K1 | Power | HiSPi Supply
VDD_SLVS | K14 | Power | HiSPi Supply
D_CLK_1_P | P3 | HiSPi | Differential Clock [1], Positive
D_CLK_1_N | P4 | HiSPi | Differential Clock [1], Negative
RESET_N | D6 | Input | Asynchronous Hard Reset (Active Low)
SCLK | D7 | Input | SPI Clock Input
DATA_4_N | E10 | HiSPi | Differential Data Channel [4], Negative
DATA_4_P | E11 | HiSPi | Differential Data Channel [4], Positive
DATA_6_N | E12 | HiSPi | Differential Data Channel [6], Negative
DATA_6_P | E13 | HiSPi | Differential Data Channel [6], Positive
DATA_7_P | E2 | HiSPi | Differential Data Channel [7], Positive
DATA_7_N | E3 | HiSPi | Differential Data Channel [7], Negative
DATA_5_P | E4 | HiSPi | Differential Data Channel [5], Positive
DATA_5_N | E5 | HiSPi | Differential Data Channel [5], Negative
DATA_8_N | F10 | HiSPi | Differential Data Channel [8], Negative
DATA_8_P | F11 | HiSPi | Differential Data Channel [8], Positive
DATA_10_N | F12 | HiSPi | Differential Data Channel [10], Negative
DATA_10_P | F13 | HiSPi | Differential Data Channel [10], Positive
DATA_11_P | F2 | HiSPi | Differential Data Channel [11], Positive
DATA_11_N | F3 | HiSPi | Differential Data Channel [11], Negative
DATA_9_P | F4 | HiSPi | Differential Data Channel [9], Positive
DATA_9_N | F5 | HiSPi | Differential Data Channel [9], Negative
D_CLK_2_N | G11 | HiSPi | Differential Clock [2], Negative
D_CLK_2_P | G12 | HiSPi | Differential Clock [2], Positive
D_CLK_3_P | H3 | HiSPi | Differential Clock [3], Positive
D_CLK_3_N | H4 | HiSPi | Differential Clock [3], Negative
DATA_12_N | H10 | HiSPi | Differential Data Channel [12], Negative
DATA_12_P | H11 | HiSPi | Differential Data Channel [12], Positive
DATA_14_N | H12 | HiSPi | Differential Data Channel [14], Negative
DATA_14_P | H13 | HiSPi | Differential Data Channel [14], Positive
DATA_15_P | H2 | HiSPi | Differential Data Channel [15], Positive
DATA_15_N | H3 | HiSPi | Differential Data Channel [15], Negative
DATA_13_P | H4 | HiSPi | Differential Data Channel [13], Positive
DATA_13_N | H5 | HiSPi | Differential Data Channel [13], Negative
VAA_PIX_A0 | M8 | Decoupling | External Noise Decoupling (0.1 uF + 4.7 uF to GND)
VAA_PIX_A1 | M9 | Decoupling | External Noise Decoupling (0.1 uF + 4.7 uF to GND)
VAA_PIX_A2 | N8 | Decoupling | External Noise Decoupling (0.1 uF + 4.7 uF to GND)
VAA_PIX_A3 | P9 | Decoupling | External Noise Decoupling (0.1 uF + 4.7 uF to GND)
VAA_PIX_A4 | P10 | Decoupling | External Noise Decoupling (0.1 uF + 4.7 uF to GND)
VAA_PIX_A5 | P4 | Decoupling | External Noise Decoupling (0.1 uF + 4.7 uF to GND)
VAA_PIX_B0 | M6 | Decoupling | External Noise Decoupling (0.1 uF + 2.2 uF to GND)
VAA_PIX_B1 | M7 | Decoupling | External Noise Decoupling (0.1 uF + 2.2 uF to GND)
VAA_PIX_B2 | N6 | Decoupling | External Noise Decoupling (0.1 uF + 2.2 uF to GND)
VAA_PIX_B3 | N7 | Decoupling | External Noise Decoupling (0.1 uF + 2.2 uF to GND)
VAA_PIX_B4 | P5 | Decoupling | External Noise Decoupling (0.1 uF + 2.2 uF to GND)
VAA_PIX_B5 | P6 | Decoupling | External Noise Decoupling (0.1 uF + 2.2 uF to GND)
VAA_PIX_C0 | N9 | Decoupling | External Noise Decoupling (0.1 uF to GND)
VAA_PIX_C1 | P11 | Decoupling | External Noise Decoupling (0.1 uF to GND)
VAA_PIX_BST | N5 | N10 | Power | Pixel Booster Supply

Sheet: xgs12m_pin_sorted
CS_N | E9 | Input | SPI Chip Select (Active Low)
D_CLK_0_N | F13 | HiSPi | Differential Clock [0], Negative
D_CLK_0_P | F14 | HiSPi | Differential Clock [0], Positive
D_CLK_1_N | F6 | HiSPi | Differential Clock [1], Negative
D_CLK_1_P | F5 | HiSPi | Differential Clock [1], Positive
D_CLK_2_N | J13 | HiSPi | Differential Clock [2], Negative
D_CLK_2_P | J14 | HiSPi | Differential Clock [2], Positive
D_CLK_3_N | J6 | HiSPi | Differential Clock [3], Negative
D_CLK_3_P | J5 | HiSPi | Differential Clock [3], Positive
D_CLK_4_N | M13 | HiSPi | Differential Clock [4], Negative
D_CLK_4_P | M14 | HiSPi | Differential Clock [4], Positive
D_CLK_5_N | M6 | HiSPi | Differential Clock [5], Negative
D_CLK_5_P | M5 | HiSPi | Differential Clock [5], Positive
DATA_0_N | E12 | HiSPi | Differential Data Channel [0], Negative
DATA_0_P | E13 | HiSPi | Differential Data Channel [0], Positive
DATA_1_N | E7 | HiSPi | Differential Data Channel [1], Negative
DATA_1_P | E6 | HiSPi | Differential Data Channel [1], Positive
DATA_10_N | H14 | HiSPi | Differential Data Channel [10], Negative
DATA_10_P | H15 | HiSPi | Differential Data Channel [10], Positive
DATA_11_N | H5 | HiSPi | Differential Data Channel [11], Negative
DATA_11_P | H4 | HiSPi | Differential Data Channel [11], Positive
DATA_12_N | K12 | HiSPi | Differential Data Channel [12], Negative
DATA_12_P | K13 | HiSPi | Differential Data Channel [12], Positive
DATA_13_N | K7 | HiSPi | Differential Data Channel [13], Negative
DATA_13_P | K6 | HiSPi | Differential Data Channel [13], Positive
DATA_14_N | K14 | HiSPi | Differential Data Channel [14], Negative
DATA_14_P | K15 | HiSPi | Differential Data Channel [14], Positive
DATA_15_N | K5 | HiSPi | Differential Data Channel [15], Negative
DATA_15_P | K4 | HiSPi | Differential Data Channel [15], Positive
DATA_16_N | L12 | HiSPi | Differential Data Channel [16], Negative
DATA_16_P | L13 | HiSPi | Differential Data Channel [16], Positive
DATA_17_N | L7 | HiSPi | Differential Data Channel [17], Negative
DATA_17_P | L6 | HiSPi | Differential Data Channel [17], Positive
DATA_18_N | L14 | HiSPi | Differential Data Channel [18], Negative
DATA_18_P | L15 | HiSPi | Differential Data Channel [18], Positive
DATA_19_N | L5 | HiSPi | Differential Data Channel [19], Negative
DATA_19_P | L4 | HiSPi | Differential Data Channel [19], Positive
DATA_2_N | E14 | HiSPi | Differential Data Channel [2], Negative
DATA_2_P | E15 | HiSPi | Differential Data Channel [2], Positive
DATA_20_N | N12 | HiSPi | Differential Data Channel [20], Negative
DATA_20_P | N13 | HiSPi | Differential Data Channel [20], Positive
DATA_21_N | N7 | HiSPi | Differential Data Channel [21], Negative
DATA_21_P | N6 | HiSPi | Differential Data Channel [21], Positive
DATA_22_N | N14 | HiSPi | Differential Data Channel [22], Negative
DATA_22_P | N15 | HiSPi | Differential Data Channel [22], Positive
DATA_23_N | N5 | HiSPi | Differential Data Channel [23], Negative
DATA_23_P | N4 | HiSPi | Differential Data Channel [23], Positive
DATA_3_N | E5 | HiSPi | Differential Data Channel [3], Negative
DATA_3_P | E4 | HiSPi | Differential Data Channel [3], Positive
DATA_4_N | G12 | HiSPi | Differential Data Channel [4], Negative
DATA_4_P | G13 | HiSPi | Differential Data Channel [4], Positive
DATA_5_N | G7 | HiSPi | Differential Data Channel [5], Negative
DATA_5_P | G6 | HiSPi | Differential Data Channel [5], Positive
DATA_6_N | G14 | HiSPi | Differential Data Channel [6], Negative
DATA_6_P | G15 | HiSPi | Differential Data Channel [6], Positive
DATA_7_N | G5 | HiSPi | Differential Data Channel [7], Negative
DATA_7_P | G4 | HiSPi | Differential Data Channel [7], Positive
DATA_8_N | H12 | HiSPi | Differential Data Channel [8], Negative
DATA_8_P | H13 | HiSPi | Differential Data Channel [8], Positive
DATA_9_N | H7 | HiSPi | Differential Data Channel [9], Negative
DATA_9_P | H6 | HiSPi | Differential Data Channel [9], Positive
EXTCLK | D9 | Input | External Clock Input
FWSI_EN | D10 | Input | Connect to VDD_IO through a 10k resistor
GND | T16 | Ground | Ground
GND | A1 | Ground | Ground
GND | A18 | Ground | Ground
GND | C12 | Ground | Ground
GND | C16 | Ground | Ground
GND | C3 | Ground | Ground
GND | C7 | Ground | Ground
GND | D12 | Ground | Ground
GND | F10 | Ground | Ground
GND | F15 | Ground | Ground
GND | F4 | Ground | Ground
GND | G10 | Ground | Ground
GND | G11 | Ground | Ground
GND | G16 | Ground | Ground
GND | G3 | Ground | Ground
GND | G8 | Ground | Ground
GND | G9 | Ground | Ground
GND | J15 | Ground | Ground
GND | K16 | Ground | Ground
GND | K3 | Ground | Ground
GND | M11 | Ground | Ground
GND | M15 | Ground | Ground
GND | M4 | Ground | Ground
GND | N11 | Ground | Ground
GND | N8 | Ground | Ground
GND | P12 | Ground | Ground
GND | P13 | Ground | Ground
GND | P6 | Ground | Ground
GND | P7 | Ground | Ground
GND | T10 | Ground | Ground
GND | T3 | Ground | Ground
GND | J4 | Ground | Ground
GND | V1 | Ground | Ground
GND | V18 | Ground | Ground
MONITOR_0 | E8 | Output | Monitor Output 0. If unused, keep do not connect.
MONITOR_1 | D8 | Output | Monitor Output 1. If unused, do not connect.
MONITOR_2 | D7 | Output | Monitor Output 2. If unused, do not connect.
RESERVED | P15 | N/A | Reserved (do not connect)
RESERVED | P4 | N/A | Reserved (do not connect)
RESET_N | F8 | Input | Asynchronous Hard Reset (Active Low)
SCLK | F9 | Input | SPI Clock Input
SDATA | D11 | Input | SPI Slave In
SDATAOUT | E10 | Output | SPI Slave Out
TRIG_INT | F11 | Input | Trigger Input for Integration Control. If unused, connect to ground.
TRIG_RD | E11 | Input | Trigger Input for Readout Control. If unused, connect to ground.
VAA | C14 | Power | Analog Supply
VAA | C5 | Power | Analog Supply
VAA | M10 | Power | Analog Supply
VAA | M9 | Power | Analog Supply
VAA | N10 | Power | Analog Supply
VAA | N16 | Power | Analog Supply
VAA | N3 | Power | Analog Supply
VAA | N9 | Power | Analog Supply
VAA | R13 | Power | Analog Supply
VAA | R14 | Power | Analog Supply
VAA | R5 | Power | Analog Supply
VAA | R6 | Power | Analog Supply
VAA | T9 | Power | Analog Supply
VAA_PIX | D14 | Power | Pixel Supply
VAA_PIX | D5 | Power | Pixel Supply
VAA_PIX | P14 | Power | Pixel Supply
VAA_PIX | P5 | Power | Pixel Supply
VAA_PIX_A0 | P10 | Decoupling | External Noise Decoupling (0.1 uF + 4.7 uF to GND)
VAA_PIX_A1 | P11 | Decoupling | External Noise Decoupling (0.1 uF + 4.7 uF to GND)
VAA_PIX_A2 | R10 | Decoupling | External Noise Decoupling (0.1 uF + 4.7 uF to GND)
VAA_PIX_A3 | T11 | Decoupling | External Noise Decoupling (0.1 uF + 4.7 uF to GND)
VAA_PIX_A4 | T12 | Decoupling | External Noise Decoupling (0.1 uF + 4.7 uF to GND)
VAA_PIX_A5 | T6 | Decoupling | External Noise Decoupling (0.1 uF + 4.7 uF to GND)
VAA_PIX_B0 | P8 | Decoupling | External Noise Decoupling (0.1 uF + 2.2 uF to GND)
VAA_PIX_B1 | P9 | Decoupling | External Noise Decoupling (0.1 uF + 2.2 uF to GND)
VAA_PIX_B2 | R8 | Decoupling | External Noise Decoupling (0.1 uF + 2.2 uF to GND)
VAA_PIX_B3 | R9 | Decoupling | External Noise Decoupling (0.1 uF + 2.2 uF to GND)
VAA_PIX_B4 | T7 | Decoupling | External Noise Decoupling (0.1 uF + 2.2 uF to GND)
VAA_PIX_B5 | T8 | Decoupling | External Noise Decoupling (0.1 uF + 2.2 uF to GND)
VAA_PIX_BST | R12 | Power | Pixel Booster Supply
VAA_PIX_BST | R7 | Power | Pixel Booster Supply
VAA_PIX_C0 | R11 | Decoupling | External Noise Decoupling (0.1 uF to GND)
VAA_PIX_C1 | T13 | Decoupling | External Noise Decoupling (0.1 uF to GND)
VAA_RD | C13 | Power | Analog Supply for Row Driver
VAA_RD | C6 | Power | Analog Supply for Row Driver
VAA_RD | T14 | Power | Analog Supply for Row Driver
VAA_RD | T5 | Power | Analog Supply for Row Driver
VDD | D13 | Power | Digital Supply
VDD | D6 | Power | Digital Supply
VDD | E16 | Power | Digital Supply
VDD | E3 | Power | Digital Supply
VDD | F12 | Power | Digital Supply
VDD | F7 | Power | Digital Supply
VDD | H16 | Power | Digital Supply
VDD | H3 | Power | Digital Supply
VDD | J12 | Power | Digital Supply
VDD | J7 | Power | Digital Supply
VDD | L16 | Power | Digital Supply
VDD | L3 | Power | Digital Supply
VDD | M12 | Power | Digital Supply
VDD | M7 | Power | Digital Supply
VDD_IO | C11 | Power | I/O Supply
VDD_IO | C8 | Power | I/O Supply
VDD_IO | C9 | Power | I/O Supply
VDD_IO | P16 | Power | I/O Supply
VDD_IO | P3 | Power | I/O Supply
VDD_PLL | C10 | Power | PLL Power Supply
VDD_SLVS | F16 | Power | HiSPi Supply
VDD_SLVS | F3 | Power | HiSPi Supply
VDD_SLVS | J16 | Power | HiSPi Supply
VDD_SLVS | J3 | Power | HiSPi Supply
VDD_SLVS | M16 | Power | HiSPi Supply
VDD_SLVS | M3 | Power | HiSPi Supply

Sheet: xgs5m_pin_sorted
CS_N | C7 | E9 | Input | SPI Chip Select (Active Low)
D_CLK_0_N | D11 | F13 | HiSPi | Differential Clock [0], Negative
D_CLK_0_P | D12 | F14 | HiSPi | Differential Clock [0], Positive
D_CLK_1_N | P4 | T6 | HiSPi | Differential Clock [1], Negative
D_CLK_1_P | P3 | T5 | HiSPi | Differential Clock [1], Positive
D_CLK_2_N | G11 | J13 | HiSPi | Differential Clock [2], Negative
D_CLK_2_P | G12 | J14 | HiSPi | Differential Clock [2], Positive
D_CLK_3_N | H4 | K6 | HiSPi | Differential Clock [3], Negative
D_CLK_3_P | H3 | K5 | HiSPi | Differential Clock [3], Positive
DATA_0_N | C10 | E12 | HiSPi | Differential Data Channel [0], Negative
DATA_0_P | C11 | E13 | HiSPi | Differential Data Channel [0], Positive
DATA_1_N | D5 | F7 | HiSPi | Differential Data Channel [1], Negative
DATA_1_P | D4 | F6 | HiSPi | Differential Data Channel [1], Positive
DATA_10_N | F12 | H14 | HiSPi | Differential Data Channel [10], Negative
DATA_10_P | F13 | H15 | HiSPi | Differential Data Channel [10], Positive
DATA_11_N | F3 | H5 | HiSPi | Differential Data Channel [11], Negative
DATA_11_P | F2 | H4 | HiSPi | Differential Data Channel [11], Positive
DATA_12_N | H10 | K12 | HiSPi | Differential Data Channel [12], Negative
DATA_12_P | H11 | K13 | HiSPi | Differential Data Channel [12], Positive
DATA_13_N | H5 | K7 | HiSPi | Differential Data Channel [13], Negative
DATA_13_P | H4 | K6 | HiSPi | Differential Data Channel [13], Positive
DATA_14_N | H12 | K14 | HiSPi | Differential Data Channel [14], Negative
DATA_14_P | H13 | K15 | HiSPi | Differential Data Channel [14], Positive
DATA_15_N | H3 | K5 | HiSPi | Differential Data Channel [15], Negative
DATA_15_P | H2 | K4 | HiSPi | Differential Data Channel [15], Positive
DATA_2_N | C12 | E14 | HiSPi | Differential Data Channel [2], Negative
DATA_2_P | C13 | E15 | HiSPi | Differential Data Channel [2], Positive
DATA_3_N | D3 | F5 | HiSPi | Differential Data Channel [3], Negative
DATA_3_P | D2 | F4 | HiSPi | Differential Data Channel [3], Positive
DATA_4_N | E10 | G12 | HiSPi | Differential Data Channel [4], Negative
DATA_4_P | E11 | G13 | HiSPi | Differential Data Channel [4], Positive
DATA_5_N | E5 | F7 | HiSPi | Differential Data Channel [5], Negative
DATA_5_P | E4 | G6 | HiSPi | Differential Data Channel [5], Positive
DATA_6_N | E12 | G14 | HiSPi | Differential Data Channel [6], Negative
DATA_6_P | E13 | G15 | HiSPi | Differential Data Channel [6], Positive
DATA_7_N | E3 | G5 | HiSPi | Differential Data Channel [7], Negative
DATA_7_P | E2 | G4 | HiSPi | Differential Data Channel [7], Positive
DATA_8_N | F10 | H12 | HiSPi | Differential Data Channel [8], Negative
DATA_8_P | F11 | H13 | HiSPi | Differential Data Channel [8], Positive
DATA_9_N | F5 | H7 | HiSPi | Differential Data Channel [9], Negative
DATA_9_P | F4 | H6 | HiSPi | Differential Data Channel [9], Positive
EXTCLK | B7 | D9 | Input | External Clock Input
FWSI_EN | B8 | D10 | Input | Connect to VDD_IO through a 10k resistor
GND | A10 | C12 | Ground | Ground
GND | A13 | C15 | Ground | Ground
GND | A5 | C7 | Ground | Ground
GND | D13 | F15 | Ground | Ground
GND | D2 | F4 | Ground | Ground
GND | E1 | G3 | Ground | Ground
GND | E14 | G16 | Ground | Ground
GND | G13 | J15 | Ground | Ground
GND | G2 | J4 | Ground | Ground
GND | H1 | K3 | Ground | Ground
GND | H14 | K16 | Ground | Ground
GND | J10 | L12 | Ground | Ground
GND | J11 | L13 | Ground | Ground
GND | J12 | L14 | Ground | Ground
GND | J13 | L15 | Ground | Ground
GND | J2 | L4 | Ground | Ground
GND | J3 | L5 | Ground | Ground
GND | J4 | L6 | Ground | Ground
GND | J5 | L7 | Ground | Ground
GND | K11 | M13 | Ground | Ground
GND | K12 | M14 | Ground | Ground
GND | K13 | M15 | Ground | Ground
GND | K2 | M4 | Ground | Ground
GND | K3 | M5 | Ground | Ground
GND | K4 | M6 | Ground | Ground
GND | K9 | M11 | Ground | Ground
GND | L10 | N12 | Ground | Ground
GND | L11 | N13 | Ground | Ground
GND | L12 | N14 | Ground | Ground
GND | L13 | N15 | Ground | Ground
GND | L2 | N4 | Ground | Ground
GND | L3 | N5 | Ground | Ground
GND | L4 | N6 | Ground | Ground
GND | L5 | N7 | Ground | Ground
GND | L6 | N8 | Ground | Ground
GND | L9 | N11 | Ground | Ground
GND | M10 | P12 | Ground | Ground
GND | M5 | P7 | Ground | Ground
GND | N1 | R3 | Ground | Ground
GND | N13 | R15 | Ground | Ground
GND | P8 | T10 | Ground | Ground
MONITOR_0 | C6 | E8 | Output | Monitor Output 0. If unused, keep do not connect.
MONITOR_1 | B6 | D8 | Output | Monitor Output 1. If unused, do not connect.
MONITOR_2 | B5 | D7 | Output | Monitor Output 2. If unused, do not connect.
RESET_N | D6 | F8 | Input | Asynchronous Hard Reset (Active Low)
SCLK | D7 | F9 | Input | SPI Clock Input
SDATA | B9 | D11 | Input | SPI Slave In
SDATAOUT | C8 | E10 | Output | SPI Slave Out
TRIG_INT | D9 | F11 | Input | Trigger Input for Integration Control. If unused, connectto ground.
TRIG_RD | C9 | E11 | Input | Trigger Input for Readout Control. If unused, connectto ground.
VAA | A12 | C14 | Power | Analog Supply
VAA | A3 | C5 | Power | Analog Supply
VAA | K7 | M9 | Power | Analog Supply
VAA | K8 | M10 | Power | Analog Supply
VAA | L14 | N16 | Power | Analog Supply
VAA | L7 | N9 | Power | Analog Supply
VAA | L8 | N10 | Power | Analog Supply
VAA | M13 | P15 | Power | Analog Supply
VAA | N11 | R13 | Power | Analog Supply
VAA | N12 | R14 | Power | Analog Supply
VAA | N3 | R5 | Power | Analog Supply
VAA | N4 | R6 | Power | Analog Supply
VAA | P7 | T9 | Power | Analog Supply
VAA_PIX | B12 | D14 | Power | Pixel Supply
VAA_PIX | B3 | D5 | Power | Pixel Supply
VAA_PIX | M12 | P14 | Power | Pixel Supply
VAA_PIX | M3 | P5 | Power | Pixel Supply
VAA_PIX_A0 | M8 | P10 | Decoupling | External Noise Decoupling (0.1 uF + 4.7 uF to GND)
VAA_PIX_A1 | M9 | P11 | Decoupling | External Noise Decoupling (0.1 uF + 4.7 uF to GND)
VAA_PIX_A2 | N8 | P10 | Decoupling | External Noise Decoupling (0.1 uF + 4.7 uF to GND)
VAA_PIX_A3 | P9 | T11 | Decoupling | External Noise Decoupling (0.1 uF + 4.7 uF to GND)
VAA_PIX_A4 | P10 | T12 | Decoupling | External Noise Decoupling (0.1 uF + 4.7 uF to GND)
VAA_PIX_A5 | P4 | T6 | Decoupling | External Noise Decoupling (0.1 uF + 4.7 uF to GND)
VAA_PIX_B0 | M6 | P8 | Decoupling | External Noise Decoupling (0.1 uF + 2.2 uF to GND)
VAA_PIX_B1 | M7 | P9 | Decoupling | External Noise Decoupling (0.1 uF + 2.2 uF to GND)
VAA_PIX_B2 | N6 | P8 | Decoupling | External Noise Decoupling (0.1 uF + 2.2 uF to GND)
VAA_PIX_B3 | N7 | P9 | Decoupling | External Noise Decoupling (0.1 uF + 2.2 uF to GND)
VAA_PIX_B4 | P5 | T7 | Decoupling | External Noise Decoupling (0.1 uF + 2.2 uF to GND)
VAA_PIX_B5 | P6 | T8 | Decoupling | External Noise Decoupling (0.1 uF + 2.2 uF to GND)
VAA_PIX_BST | N5 | P7 | N10 | Power | Pixel Booster Supply
VAA_PIX_C0 | N9 | P11 | Decoupling | External Noise Decoupling (0.1 uF to GND)
VAA_PIX_C1 | P11 | P13 | Decoupling | External Noise Decoupling (0.1 uF to GND)
VAA_RD | A11 | C13 | Power | Analog Supply for Row Driver
VAA_RD | A4 | C6 | Power | Analog Supply for Row Driver
VAA_RD | P12 | P14 | Power | Analog Supply for Row Driver
VAA_RD | P3 | T5 | Power | Analog Supply for Row Driver
VDD | B11 | D13 | Power | Digital Supply
VDD | B4 | D6 | Power | Digital Supply
VDD | C1 | E3 | Power | Digital Supply
VDD | C14 | E16 | Power | Digital Supply
VDD | D10 | F12 | Power | Digital Supply
VDD | D5 |  | Power | Digital Supply
VDD | F1 | H3 | Power | Digital Supply
VDD | F14 | H16 | Power | Digital Supply
VDD | G10 | J12 | Power | Digital Supply
VDD | G5 | J7 | Power | Digital Supply
VDD | J14 | L16 | Power | Digital Supply
VDD | K1 | M3 | Power | Digital Supply
VDD | K10 | M12 | Power | Digital Supply
VDD | K5 | M7 | Power | Digital Supply
VDD_IO | A6 | C8 | Power | I/O Supply
VDD_IO | A7 | C9 | Power | I/O Supply
VDD_IO | A9 | C11 | Power | I/O Supply
VDD_IO | M1 | P3 | Power | I/O Supply
VDD_IO | M14 | P16 | Power | I/O Supply
VDD_PLL | C10->A8 | C10 | Power | PLL Power Supply
VDD_SLVS | D1 | F3 | Power | HiSPi Supply
VDD_SLVS | D14 | F16 | Power | HiSPi Supply
VDD_SLVS | G1 | J3 | Power | HiSPi Supply
VDD_SLVS | G14 | J16 | Power | HiSPi Supply
VDD_SLVS | K1 | M3 | Power | HiSPi Supply
VDD_SLVS | K14 | M16 | Power | HiSPi Supply

Sheet: Sheet3
CS_N | C7 | E9 | Input | SPI Chip Select (Active Low) | CS_N | E9 | Input | SPI Chip Select (Active Low)
D_CLK_0_N | D11 | F13 | HiSPi | Differential Clock [0], Negative | D_CLK_0_N | F13 | HiSPi | Differential Clock [0], Negative
D_CLK_0_P | D12 | F14 | HiSPi | Differential Clock [0], Positive | D_CLK_0_P | F14 | HiSPi | Differential Clock [0], Positive
D_CLK_1_N | P4 | T6 | HiSPi | Differential Clock [1], Negative | D_CLK_1_N | F6 | HiSPi | Differential Clock [1], Negative
D_CLK_1_P | P3 | T5 | HiSPi | Differential Clock [1], Positive | D_CLK_1_P | F5 | HiSPi | Differential Clock [1], Positive
D_CLK_2_N | G11 | J13 | HiSPi | Differential Clock [2], Negative | D_CLK_2_N | J13 | HiSPi | Differential Clock [2], Negative
D_CLK_2_P | G12 | J14 | HiSPi | Differential Clock [2], Positive | D_CLK_2_P | J14 | HiSPi | Differential Clock [2], Positive
D_CLK_3_N | H4 | K6 | HiSPi | Differential Clock [3], Negative | D_CLK_3_N | J6 | HiSPi | Differential Clock [3], Negative
D_CLK_3_P | H3 | K5 | HiSPi | Differential Clock [3], Positive | D_CLK_3_P | J5 | HiSPi | Differential Clock [3], Positive
DATA_0_N | C10 | E12 | HiSPi | Differential Data Channel [0], Negative | D_CLK_4_N | M13 | HiSPi | Differential Clock [4], Negative
DATA_0_P | C11 | E13 | HiSPi | Differential Data Channel [0], Positive | D_CLK_4_P | M14 | HiSPi | Differential Clock [4], Positive
DATA_1_N | D5 | F7 | HiSPi | Differential Data Channel [1], Negative | D_CLK_5_N | M6 | HiSPi | Differential Clock [5], Negative
DATA_1_P | D4 | F6 | HiSPi | Differential Data Channel [1], Positive | D_CLK_5_P | M5 | HiSPi | Differential Clock [5], Positive
DATA_10_N | F12 | H14 | HiSPi | Differential Data Channel [10], Negative | DATA_0_N | E12 | HiSPi | Differential Data Channel [0], Negative
DATA_10_P | F13 | H15 | HiSPi | Differential Data Channel [10], Positive | DATA_0_P | E13 | HiSPi | Differential Data Channel [0], Positive
DATA_11_N | F3 | H5 | HiSPi | Differential Data Channel [11], Negative | DATA_1_N | E7 | HiSPi | Differential Data Channel [1], Negative
DATA_11_P | F2 | H4 | HiSPi | Differential Data Channel [11], Positive | DATA_1_P | E6 | HiSPi | Differential Data Channel [1], Positive
DATA_12_N | H10 | K12 | HiSPi | Differential Data Channel [12], Negative | DATA_10_N | H14 | HiSPi | Differential Data Channel [10], Negative
DATA_12_P | H11 | K13 | HiSPi | Differential Data Channel [12], Positive | DATA_10_P | H15 | HiSPi | Differential Data Channel [10], Positive
DATA_13_N | H5 | K7 | HiSPi | Differential Data Channel [13], Negative | DATA_11_N | H5 | HiSPi | Differential Data Channel [11], Negative
DATA_13_P | H4 | K6 | HiSPi | Differential Data Channel [13], Positive | DATA_11_P | H4 | HiSPi | Differential Data Channel [11], Positive
DATA_14_N | H12 | K14 | HiSPi | Differential Data Channel [14], Negative | DATA_12_N | K12 | HiSPi | Differential Data Channel [12], Negative
DATA_14_P | H13 | K15 | HiSPi | Differential Data Channel [14], Positive | DATA_12_P | K13 | HiSPi | Differential Data Channel [12], Positive
DATA_15_N | H3 | K5 | HiSPi | Differential Data Channel [15], Negative | DATA_13_N | K7 | HiSPi | Differential Data Channel [13], Negative
DATA_15_P | H2 | K4 | HiSPi | Differential Data Channel [15], Positive | DATA_13_P | K6 | HiSPi | Differential Data Channel [13], Positive
DATA_2_N | C12 | E14 | HiSPi | Differential Data Channel [2], Negative | DATA_14_N | K14 | HiSPi | Differential Data Channel [14], Negative
DATA_2_P | C13 | E15 | HiSPi | Differential Data Channel [2], Positive | DATA_14_P | K15 | HiSPi | Differential Data Channel [14], Positive
DATA_3_N | D3 | F5 | HiSPi | Differential Data Channel [3], Negative | DATA_15_N | K5 | HiSPi | Differential Data Channel [15], Negative
DATA_3_P | D2 | F4 | HiSPi | Differential Data Channel [3], Positive | DATA_15_P | K4 | HiSPi | Differential Data Channel [15], Positive
DATA_4_N | E10 | G12 | HiSPi | Differential Data Channel [4], Negative | DATA_16_N | L12 | HiSPi | Differential Data Channel [16], Negative
DATA_4_P | E11 | G13 | HiSPi | Differential Data Channel [4], Positive | DATA_16_P | L13 | HiSPi | Differential Data Channel [16], Positive
DATA_5_N | E5 | F7 | HiSPi | Differential Data Channel [5], Negative | DATA_17_N | L7 | HiSPi | Differential Data Channel [17], Negative
DATA_5_P | E4 | G6 | HiSPi | Differential Data Channel [5], Positive | DATA_17_P | L6 | HiSPi | Differential Data Channel [17], Positive
DATA_6_N | E12 | G14 | HiSPi | Differential Data Channel [6], Negative | DATA_18_N | L14 | HiSPi | Differential Data Channel [18], Negative
DATA_6_P | E13 | G15 | HiSPi | Differential Data Channel [6], Positive | DATA_18_P | L15 | HiSPi | Differential Data Channel [18], Positive
DATA_7_N | E3 | G5 | HiSPi | Differential Data Channel [7], Negative | DATA_19_N | L5 | HiSPi | Differential Data Channel [19], Negative
DATA_7_P | E2 | G4 | HiSPi | Differential Data Channel [7], Positive | DATA_19_P | L4 | HiSPi | Differential Data Channel [19], Positive
DATA_8_N | F10 | H12 | HiSPi | Differential Data Channel [8], Negative | DATA_2_N | E14 | HiSPi | Differential Data Channel [2], Negative
DATA_8_P | F11 | H13 | HiSPi | Differential Data Channel [8], Positive | DATA_2_P | E15 | HiSPi | Differential Data Channel [2], Positive
DATA_9_N | F5 | H7 | HiSPi | Differential Data Channel [9], Negative | DATA_20_N | N12 | HiSPi | Differential Data Channel [20], Negative
DATA_9_P | F4 | H6 | HiSPi | Differential Data Channel [9], Positive | DATA_20_P | N13 | HiSPi | Differential Data Channel [20], Positive
EXTCLK | B7 | D9 | Input | External Clock Input | DATA_21_N | N7 | HiSPi | Differential Data Channel [21], Negative
FWSI_EN | B8 | D10 | Input | Connect to VDD_IO through a 10k resistor | DATA_21_P | N6 | HiSPi | Differential Data Channel [21], Positive
GND | A10 | C12 | Ground | Ground | DATA_22_N | N14 | HiSPi | Differential Data Channel [22], Negative
GND | A13 | C15 | Ground | Ground | DATA_22_P | N15 | HiSPi | Differential Data Channel [22], Positive
GND | A5 | C7 | Ground | Ground | DATA_23_N | N5 | HiSPi | Differential Data Channel [23], Negative
GND | D13 | F15 | Ground | Ground | DATA_23_P | N4 | HiSPi | Differential Data Channel [23], Positive
GND | D2 | F4 | Ground | Ground | DATA_3_N | E5 | HiSPi | Differential Data Channel [3], Negative
GND | E1 | G3 | Ground | Ground | DATA_3_P | E4 | HiSPi | Differential Data Channel [3], Positive
GND | E14 | G16 | Ground | Ground | DATA_4_N | G12 | HiSPi | Differential Data Channel [4], Negative
GND | G13 | J15 | Ground | Ground | DATA_4_P | G13 | HiSPi | Differential Data Channel [4], Positive
GND | G2 | J4 | Ground | Ground | DATA_5_N | G7 | HiSPi | Differential Data Channel [5], Negative
GND | H1 | K3 | Ground | Ground | DATA_5_P | G6 | HiSPi | Differential Data Channel [5], Positive
GND | H14 | K16 | Ground | Ground | DATA_6_N | G14 | HiSPi | Differential Data Channel [6], Negative
GND | J10 | L12 | Ground | Ground | DATA_6_P | G15 | HiSPi | Differential Data Channel [6], Positive
GND | J11 | L13 | Ground | Ground | DATA_7_N | G5 | HiSPi | Differential Data Channel [7], Negative
GND | J12 | L14 | Ground | Ground | DATA_7_P | G4 | HiSPi | Differential Data Channel [7], Positive
GND | J13 | L15 | Ground | Ground | DATA_8_N | H12 | HiSPi | Differential Data Channel [8], Negative
GND | J2 | L4 | Ground | Ground | DATA_8_P | H13 | HiSPi | Differential Data Channel [8], Positive
GND | J3 | L5 | Ground | Ground | DATA_9_N | H7 | HiSPi | Differential Data Channel [9], Negative
GND | J4 | L6 | Ground | Ground | DATA_9_P | H6 | HiSPi | Differential Data Channel [9], Positive
GND | J5 | L7 | Ground | Ground | EXTCLK | D9 | Input | External Clock Input
GND | K11 | M13 | Ground | Ground | FWSI_EN | D10 | Input | Connect to VDD_IO through a 10k resistor
GND | K12 | M14 | Ground | Ground | GND | T16 | Ground | Ground
GND | K13 | M15 | Ground | Ground | GND | A1 | Ground | Ground
GND | K2 | M4 | Ground | Ground | GND | A18 | Ground | Ground
GND | K3 | M5 | Ground | Ground | GND | C12 | Ground | Ground
GND | K4 | M6 | Ground | Ground | GND | C16 | Ground | Ground
GND | K9 | M11 | Ground | Ground | GND | C3 | Ground | Ground
GND | L10 | N12 | Ground | Ground | GND | C7 | Ground | Ground
GND | L11 | N13 | Ground | Ground | GND | D12 | Ground | Ground
GND | L12 | N14 | Ground | Ground | GND | F10 | Ground | Ground
GND | L13 | N15 | Ground | Ground | GND | F15 | Ground | Ground
GND | L2 | N4 | Ground | Ground | GND | F4 | Ground | Ground
GND | L3 | N5 | Ground | Ground | GND | G10 | Ground | Ground
GND | L4 | N6 | Ground | Ground | GND | G11 | Ground | Ground
GND | L5 | N7 | Ground | Ground | GND | G16 | Ground | Ground
GND | L6 | N8 | Ground | Ground | GND | G3 | Ground | Ground
GND | L9 | N11 | Ground | Ground | GND | G8 | Ground | Ground
GND | M10 | P12 | Ground | Ground | GND | G9 | Ground | Ground
GND | M5 | P7 | Ground | Ground | GND | J15 | Ground | Ground
GND | N1 | R3 | Ground | Ground | GND | K16 | Ground | Ground
GND | N13 | R15 | Ground | Ground | GND | K3 | Ground | Ground
GND | P8 | T10 | Ground | Ground | GND | M11 | Ground | Ground
MONITOR_0 | C6 | E8 | Output | Monitor Output 0. If unused, keep do not connect. | GND | M15 | Ground | Ground
MONITOR_1 | B6 | D8 | Output | Monitor Output 1. If unused, do not connect. | GND | M4 | Ground | Ground
MONITOR_2 | B5 | D7 | Output | Monitor Output 2. If unused, do not connect. | GND | N11 | Ground | Ground
RESET_N | D6 | F8 | Input | Asynchronous Hard Reset (Active Low) | GND | N8 | Ground | Ground
SCLK | D7 | F9 | Input | SPI Clock Input | GND | P12 | Ground | Ground
SDATA | B9 | D11 | Input | SPI Slave In | GND | P13 | Ground | Ground
SDATAOUT | C8 | E10 | Output | SPI Slave Out | GND | P6 | Ground | Ground
TRIG_INT | D9 | F11 | Input | Trigger Input for Integration Control. If unused, connectto ground. | GND | P7 | Ground | Ground
TRIG_RD | C9 | E11 | Input | Trigger Input for Readout Control. If unused, connectto ground. | GND | T10 | Ground | Ground
VAA | A12 | C14 | Power | Analog Supply | GND | T3 | Ground | Ground
VAA | A3 | C5 | Power | Analog Supply | GND | J4 | Ground | Ground
VAA | K7 | M9 | Power | Analog Supply | GND | V1 | Ground | Ground
VAA | K8 | M10 | Power | Analog Supply | GND | V18 | Ground | Ground
VAA | L14 | N16 | Power | Analog Supply | MONITOR_0 | E8 | Output | Monitor Output 0. If unused, keep do not connect.
VAA | L7 | N9 | Power | Analog Supply | MONITOR_1 | D8 | Output | Monitor Output 1. If unused, do not connect.
VAA | L8 | N10 | Power | Analog Supply | MONITOR_2 | D7 | Output | Monitor Output 2. If unused, do not connect.
VAA | M13 | P15 | Power | Analog Supply | RESERVED | P15 | N/A | Reserved (do not connect)
VAA | N11 | R13 | Power | Analog Supply | RESERVED | P4 | N/A | Reserved (do not connect)
VAA | N12 | R14 | Power | Analog Supply | RESET_N | F8 | Input | Asynchronous Hard Reset (Active Low)
VAA | N3 | R5 | Power | Analog Supply | SCLK | F9 | Input | SPI Clock Input
VAA | N4 | R6 | Power | Analog Supply | SDATA | D11 | Input | SPI Slave In
VAA | P7 | T9 | Power | Analog Supply | SDATAOUT | E10 | Output | SPI Slave Out
VAA_PIX | B12 | D14 | Power | Pixel Supply | TRIG_INT | F11 | Input | Trigger Input for Integration Control. If unused, connect to ground.
VAA_PIX | B3 | D5 | Power | Pixel Supply | TRIG_RD | E11 | Input | Trigger Input for Readout Control. If unused, connect to ground.
VAA_PIX | M12 | P14 | Power | Pixel Supply | VAA | C14 | Power | Analog Supply
VAA_PIX | M3 | P5 | Power | Pixel Supply | VAA | C5 | Power | Analog Supply
VAA_PIX_A0 | M8 | P10 | Decoupling | External Noise Decoupling (0.1 uF + 4.7 uF to GND) | VAA | M10 | Power | Analog Supply
VAA_PIX_A1 | M9 | P11 | Decoupling | External Noise Decoupling (0.1 uF + 4.7 uF to GND) | VAA | M9 | Power | Analog Supply
VAA_PIX_A2 | N8 | P10 | Decoupling | External Noise Decoupling (0.1 uF + 4.7 uF to GND) | VAA | N10 | Power | Analog Supply
VAA_PIX_A3 | P9 | T11 | Decoupling | External Noise Decoupling (0.1 uF + 4.7 uF to GND) | VAA | N16 | Power | Analog Supply
VAA_PIX_A4 | P10 | T12 | Decoupling | External Noise Decoupling (0.1 uF + 4.7 uF to GND) | VAA | N3 | Power | Analog Supply
VAA_PIX_A5 | P4 | T6 | Decoupling | External Noise Decoupling (0.1 uF + 4.7 uF to GND) | VAA | N9 | Power | Analog Supply
VAA_PIX_B0 | M6 | P8 | Decoupling | External Noise Decoupling (0.1 uF + 2.2 uF to GND) | VAA | R13 | Power | Analog Supply
VAA_PIX_B1 | M7 | P9 | Decoupling | External Noise Decoupling (0.1 uF + 2.2 uF to GND) | VAA | R14 | Power | Analog Supply
VAA_PIX_B2 | N6 | P8 | Decoupling | External Noise Decoupling (0.1 uF + 2.2 uF to GND) | VAA | R5 | Power | Analog Supply
VAA_PIX_B3 | N7 | P9 | Decoupling | External Noise Decoupling (0.1 uF + 2.2 uF to GND) | VAA | R6 | Power | Analog Supply
VAA_PIX_B4 | P5 | T7 | Decoupling | External Noise Decoupling (0.1 uF + 2.2 uF to GND) | VAA | T9 | Power | Analog Supply
VAA_PIX_B5 | P6 | T8 | Decoupling | External Noise Decoupling (0.1 uF + 2.2 uF to GND) | VAA_PIX | D14 | Power | Pixel Supply
VAA_PIX_BST | N5 | P7 | N10 | Power | VAA_PIX | D5 | Power | Pixel Supply
VAA_PIX_C0 | N9 | P11 | Decoupling | External Noise Decoupling (0.1 uF to GND) | VAA_PIX | P14 | Power | Pixel Supply
VAA_PIX_C1 | P11 | P13 | Decoupling | External Noise Decoupling (0.1 uF to GND) | VAA_PIX | P5 | Power | Pixel Supply
VAA_RD | A11 | C13 | Power | Analog Supply for Row Driver | VAA_PIX_A0 | P10 | Decoupling | External Noise Decoupling (0.1 uF + 4.7 uF to GND)
VAA_RD | A4 | C6 | Power | Analog Supply for Row Driver | VAA_PIX_A1 | P11 | Decoupling | External Noise Decoupling (0.1 uF + 4.7 uF to GND)
VAA_RD | P12 | P14 | Power | Analog Supply for Row Driver | VAA_PIX_A2 | R10 | Decoupling | External Noise Decoupling (0.1 uF + 4.7 uF to GND)
VAA_RD | P3 | T5 | Power | Analog Supply for Row Driver | VAA_PIX_A3 | T11 | Decoupling | External Noise Decoupling (0.1 uF + 4.7 uF to GND)
VDD | B11 | D13 | Power | Digital Supply | VAA_PIX_A4 | T12 | Decoupling | External Noise Decoupling (0.1 uF + 4.7 uF to GND)
VDD | B4 | D6 | Power | Digital Supply | VAA_PIX_A5 | T6 | Decoupling | External Noise Decoupling (0.1 uF + 4.7 uF to GND)
VDD | C1 | E3 | Power | Digital Supply | VAA_PIX_B0 | P8 | Decoupling | External Noise Decoupling (0.1 uF + 2.2 uF to GND)
VDD | C14 | E16 | Power | Digital Supply | VAA_PIX_B1 | P9 | Decoupling | External Noise Decoupling (0.1 uF + 2.2 uF to GND)
VDD | D10 | F12 | Power | Digital Supply | VAA_PIX_B2 | R8 | Decoupling | External Noise Decoupling (0.1 uF + 2.2 uF to GND)
VDD | D5 |  | Power | Digital Supply | VAA_PIX_B3 | R9 | Decoupling | External Noise Decoupling (0.1 uF + 2.2 uF to GND)
VDD | F1 | H3 | Power | Digital Supply | VAA_PIX_B4 | T7 | Decoupling | External Noise Decoupling (0.1 uF + 2.2 uF to GND)
VDD | F14 | H16 | Power | Digital Supply | VAA_PIX_B5 | T8 | Decoupling | External Noise Decoupling (0.1 uF + 2.2 uF to GND)
VDD | G10 | J12 | Power | Digital Supply | VAA_PIX_BST | R12 | Power | Pixel Booster Supply
VDD | G5 | J7 | Power | Digital Supply | VAA_PIX_BST | R7 | Power | Pixel Booster Supply
VDD | J14 | L16 | Power | Digital Supply | VAA_PIX_C0 | R11 | Decoupling | External Noise Decoupling (0.1 uF to GND)
VDD | K1 | M3 | Power | Digital Supply | VAA_PIX_C1 | T13 | Decoupling | External Noise Decoupling (0.1 uF to GND)
VDD | K10 | M12 | Power | Digital Supply | VAA_RD | C13 | Power | Analog Supply for Row Driver
VDD | K5 | M7 | Power | Digital Supply | VAA_RD | C6 | Power | Analog Supply for Row Driver
VDD_IO | A6 | C8 | Power | I/O Supply | VAA_RD | T14 | Power | Analog Supply for Row Driver
VDD_IO | A7 | C9 | Power | I/O Supply | VAA_RD | T5 | Power | Analog Supply for Row Driver
VDD_IO | A9 | C11 | Power | I/O Supply | VDD | D13 | Power | Digital Supply
VDD_IO | M1 | P3 | Power | I/O Supply | VDD | D6 | Power | Digital Supply
VDD_IO | M14 | P16 | Power | I/O Supply | VDD | E16 | Power | Digital Supply
VDD_PLL | C10->A8 | C10 | Power | PLL Power Supply | VDD | E3 | Power | Digital Supply
VDD_SLVS | D1 | F3 | Power | HiSPi Supply | VDD | F12 | Power | Digital Supply
VDD_SLVS | D14 | F16 | Power | HiSPi Supply | VDD | F7 | Power | Digital Supply
VDD_SLVS | G1 | J3 | Power | HiSPi Supply | VDD | H16 | Power | Digital Supply
VDD_SLVS | G14 | J16 | Power | HiSPi Supply | VDD | H3 | Power | Digital Supply
VDD_SLVS | K1 | M3 | Power | HiSPi Supply | VDD | J12 | Power | Digital Supply
VDD_SLVS | K14 | M16 | Power | HiSPi Supply | VDD | J7 | Power | Digital Supply
 |  |  |  |  | VDD | L16 | Power | Digital Supply
 |  |  |  |  | VDD | L3 | Power | Digital Supply
 |  |  |  |  | VDD | M12 | Power | Digital Supply
 |  |  |  |  | VDD | M7 | Power | Digital Supply
 |  |  |  |  | VDD_IO | C11 | Power | I/O Supply
 |  |  |  |  | VDD_IO | C8 | Power | I/O Supply
 |  |  |  |  | VDD_IO | C9 | Power | I/O Supply
 |  |  |  |  | VDD_IO | P16 | Power | I/O Supply
 |  |  |  |  | VDD_IO | P3 | Power | I/O Supply
 |  |  |  |  | VDD_PLL | C10 | Power | PLL Power Supply
 |  |  |  |  | VDD_SLVS | F16 | Power | HiSPi Supply
 |  |  |  |  | VDD_SLVS | F3 | Power | HiSPi Supply
 |  |  |  |  | VDD_SLVS | J16 | Power | HiSPi Supply
 |  |  |  |  | VDD_SLVS | J3 | Power | HiSPi Supply
 |  |  |  |  | VDD_SLVS | M16 | Power | HiSPi Supply
 |  |  |  |  | VDD_SLVS | M3 | Power | HiSPi Supply
