AM4511/test_migrate_iris4/athena/doc/IOTG_2019/Registration_2H’19 IOTG Product & Technology Summit - Confirmation.pdf

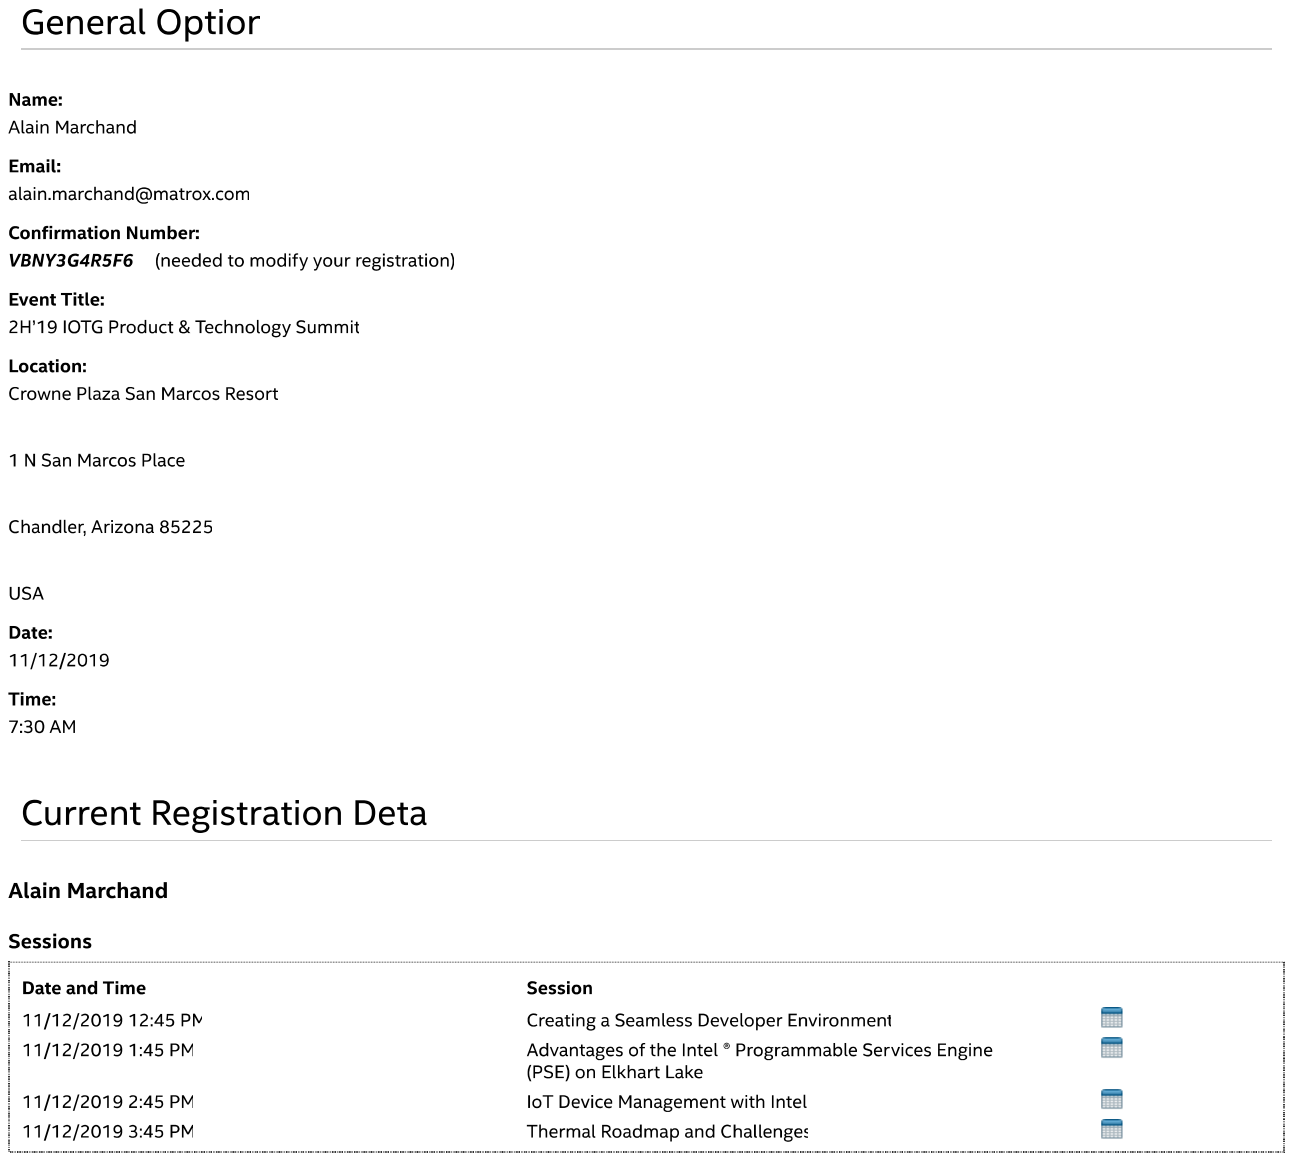
[picture p11: page 1]
