AM4511/test_migrate_iris4/athena/doc/xilinx/zc706/hr_checklist_lvds25.png

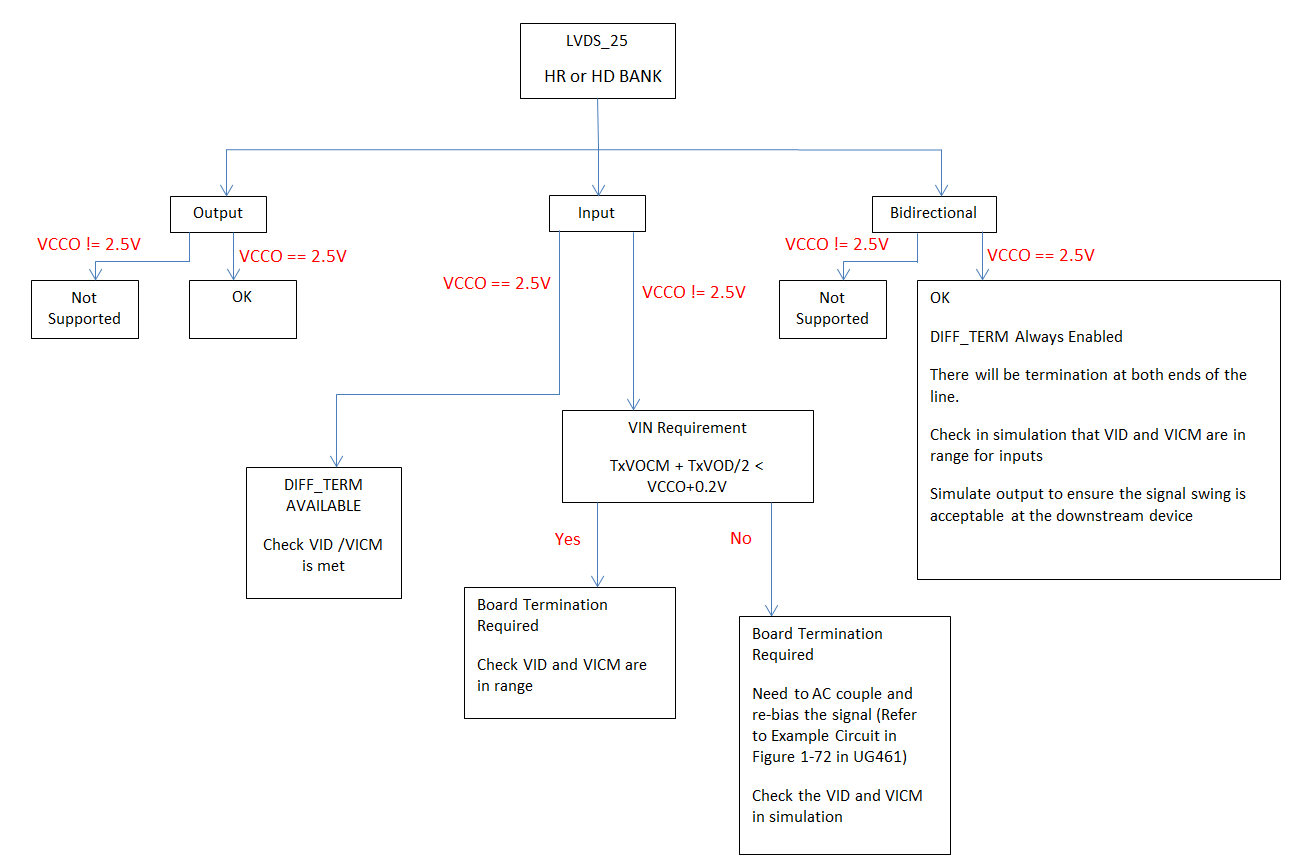
athena/doc/xilinx/zc706/hr_checklist_lvds25.png
