AM4511/test_migrate_iris4/ares_pcie/cfg_timer.xlsx

Sheet: Instructions
Enter design parameters | Enter appropriate values for the following parameters your design in TimerCalculation Sheet
FPGA | Specify the part name as seen in the BitstreamLengths sheet. Add a new FPGA and it bitstream size here if needed
ConfigRate | Enter a 7 series supported configuration rate. The recommended rates are 22, 40, 50, and 66 as these will give bettern CCLK to MCLK correlation. Other value rates are listed in the CclkVsMclk worksheet
Flash size (Mib) | Enter the flash size in Mib
Flash width (bits) | Enter the SPI width. This has little if any change over the worst case timer calculations. However, it can be helpful for estimating how long configuration will take
Sector size (KiB) | Enter the largest sector erase size of the SPI Flash. For example, if a SPI flash has both 4kB erase sectors and 64 kB erase sectors, enter 64.
SelectIO interface DCI? | Enter "yes" if using SelectIO interface with digitally-controlled impedance (DCI) and the BitGen -g Match_cycle is not set to NoWait.
MMCM STARTUP_WAIT | Enter "yes" if the mixed-mode clock manager (MMCM) has its STARTUP_WAIT attribute set to TRUE and the BitGen -g LCK_cycle is not set to NoWait.
PLL STARTUP_WAIT | Enter "yes" if the phase-locked loop (PLL) has its STARTUP_WAIT attribute set to TRUE and the BitGen -g LCK_cycle is not set to NoWait
Set WBSTAR to 1/2 Flash | Enter "yes" if placing the multiboot bitstream at the flash midpoint. Entering "no" will allow the worksheet to find an optimal placement for the multiboot bitstream. Be sure to use this value to set BitGen -g next_config_addr when generating the golden bitstream
 | The Workbook should generate an appropriate TIMER_CFG value if given valid input parameters. The recommended Bitgen options are in bold and are also at the bottom of the TimerCalculation worksheet below the Results cell
Recommendations
 | Use 22, 40, 50, or 66 for the ConfigRate. See the "Determining the Maximum Configuration Clock Frequency" section of UG470 for calculating the maximum CCLK rate for a specific SPI flash
 | The "Address map of bitstreams and buffer space" graph in the upper right of the TimerCalculation worksheet is a simple plot to show the placement of the bitstreams and how much "buffer" space is available
 | The

Sheet: TimerCalculation
 |  | Hex
FPGA | xc7a35t |  |  | Flash address map
ConfigRate | 50
Flash size (Mib) | 64 |  |  | golden | 2192012
Flash width (bits) | 2 |  |  | buffer1 | 2002292
Sector size (KiB) | 64 |  |  | multiboot | 2192012
SelectIO interface DCI? | no |  |  | buffer2 | 2002292
MMCM STARTUP_WAIT | no |  |  | total | 8388608
PLL STARTUP_WAIT | no
Set WBSTAR to 1/2 Flash | yes
Configuration Bitstream size (bits) | 17536096
Configuration Bitstream size (bytes) | 2192012 | 21728C
Extra Configuration size (bytes) | 0 | 0
Combined Configuration image size (bytes) | 2192012 | 21728C
Sector (bytes) | 65536 | 10000
Next sector (bytes) | 2228224 | 220000
flash size (bytes) | 8388608 | 800000
1/2 flash (bytes) | 4194304 | 400000
WBSTAR (bytes) | 4194304 | 400000
Check WBSTAR (bytes) | 4194304 | 400000
Bytes from WBSTAR to end of flash (bytes) | 4194304 | 400000
Bits from WBSTAR to end of flash (bits) | 33554432 | 2000000
ERROR Margin (%) | 20
Slope | 0.6955
intercept | 3.7841
 | Tyipcal | Slowest MCLK | Fastest MCLK
MCCLK (MHz) | 65 | 35 | 90
CCLK -20% | 39.19328 | 22.50128 | 53.10328
CCLK (MHz) | 48.99160 | 28.12660 | 66.37910
CCLK +20% | 58.78992 | 33.75192 | 79.65492
Slowest Configuration Rate (bits/s) | 78386560 | 45002560 | 106206560
Typical Configuration Rate (bits/s) | 97983200 | 56253200 | 132758200
Fastest Configuration Rate (bits/s) | 117579840 | 67503840 | 159309840
Slowest Configuration Time (s) | 0.22 | 0.39 | 0.17
Typical Configuration Time (s) | 0.18 | 0.31 | 0.13
Fastest Configuration Time (s) | 0.15 | 0.26 | 0.11
Slowest SPI Read Time (s) | 0.43 | 0.75 | 0.32
Typical SPI Read Time (s) | 0.34 | 0.60 | 0.25
Fastest SPI Read Time (s) | 0.29 | 0.50 | 0.21
Timer Rate (Hz) | 253906.25 | 136718.75 | 351562.5 | max/min Timer
Maximum TIMER value | 72458 | 67959 | 74047 | 67959
Minimum TIMER value | 56803 | 53276 | 58048 | 58048
Margin between max and min timer |  |  | margin | 9911
Recommend TIMER Value |  |  |  | 63003.5 | F61B
 |  |  |  |  | okay
Check | Typical | Worst Case | Worst Case
Config finishes | 0.18 | 0.39 | 0.17
Timer fires | 0.25 | 0.46 | 0.18
Read hits end of flash | 0.34 | 0.50 | 0.21
Results
Bitstream size error | no
Timer value error | no
BitGen option | Recommend Value
-g next_config_addr | 0x400000
-g TIMER_CFG | 0xF61B
-g ConfigRate | 50

Sheet: BitstreamLengths
xc7a100t | 30709728
xc7a200t | 65330912
xc7a350t | 100753632
xc7k70t | 24090592
xc7k160t | 53540576
xc7k325t | 91548896
xc7k355t | 112414688
xc7k410t | 127023328
xc7k420t | 149880032
xc7k480t | 149880032
xc7vx415t | 137934560
xc7vx485t | 162187488
xc7vx550t | 229878496
xc8vh580t | 192724384
xc7v585t | 161398880
xc7vx690t | 229878496
xc7vx980t | 282521312
xc7vx1140t | 385127680
xc7v1500t | 335503520
xc7v2000t | 447337216
xc7a35t | 17536096

Sheet: CclkVsMclk
ConfigRate | slope (m) | intercept (y)
66 | 1.0445 | -1.0305 | 1.0445 | 1.0305 | 0.9865964576
50 | 0.6955 | 3.7841 | 0.6955 | 3.7841 | 5.440833932
40 | 0.6827 | -3.6753 | 0.6827 | 3.6753 | 5.383477369
33 | 0.3759 | 8.6449 | 0.3759 | 8.6449 | 22.99787177
26 | 0.3238 | 5.1672 | 0.3238 | 5.1672 | 15.95799876
22 | 0.2875 | 2.3564 | 0.2875 | 2.3564 | 8.196173913
16 | 0.1881 | 4.3116 | 0.1881 | 4.3116 | 22.92185008
12 | 0.129 | 3.7004 | 0.129 | 3.7004 | 28.68527132
9 | 0.0941 | 2.1541 | 0.0941 | 2.1541 | 22.89160468
6 | 0.0648 | 1.8363 | 0.0648 | 1.8363 | 28.33796296
3 | 0.032 | 0.9387 | 0.032 | 0.9387 | 29.334375
CCCLK = m*MCLK + y

Sheet: ExtraStartupBits
Config Done Delay | value | enabled? | wait time (s) | width | CCLK freq (Hz) | Extra Bytes
DCI w/Match_cycle (ms) | 10 | no | 0 | 2 | 48991600 | 0
MMCM_TLOCKMAX (us) | 100 | no | 0 | 2 | 48991600 | 0
PLL_TLOCKMAX (us) | 100 | no | 0 | 2 | 48991600 | 0
ExtraBits |  |  |  |  |  | 0
