AM4511/test_migrate_iris4/athena/doc/onsemi/xcelerator_fmc_pin_map.xlsx

Pin No. | Dir | PHY | Lane ID | MUX ID | Mux Input | Function | ZC706
H17 | OUT | TOP | 0 | 0 | 0 | DATA_0_N | LA11_N
H16 | OUT | TOP | 0 | 0 | 0 | DATA_0_P | LA11_P
G16 | OUT | TOP | 2 | 0 | 1 | DATA_2_N | LA12_N
G15 | OUT | TOP | 2 | 0 | 1 | DATA_2_P | LA12_P
C15 | OUT | TOP | 4 | 0 | 2 | DATA_4_N | LA10_N
C14 | OUT | TOP | 4 | 0 | 2 | DATA_4_P | LA10_P
D15 | OUT | TOP | 6 | 0 | 3 | DATA_6_N | LA09_N
D14 | OUT | TOP | 6 | 0 | 3 | DATA_6_P | LA09_P
H14 | OUT | TOP | 8 | 2 | 0 | DATA_8_N | LA07_N
H13 | OUT | TOP | 8 | 2 | 0 | DATA_8_P | LA07_P
G13 | OUT | TOP | 10 | 2 | 1 | DATA_10_N | LA08_N
G12 | OUT | TOP | 10 | 2 | 1 | DATA_10_P | LA08_P
D12 | OUT | TOP | 12 | 2 | 2 | DATA_12_N | LA05_N
D11 | OUT | TOP | 12 | 2 | 2 | DATA_12_P | LA05_P
C11 | OUT | TOP | 14 | 2 | 3 | DATA_14_N | LA06_N
C10 | OUT | TOP | 14 | 2 | 3 | DATA_14_P | LA06_P
H5 | INOUT | TOP |  | 2 |  | D_CLK_2_N | CLK0_M2C_N
H4 | INOUT | TOP |  | 2 |  | D_CLK_2_P | CLK0_M2C_P
G10 | OUT | TOP | 16 | 4 | 0 | DATA_16_N | LA03_N
G9 | OUT | TOP | 16 | 4 | 0 | DATA_16_P | LA03_P
H11 | OUT | TOP | 18 | 4 | 1 | DATA_18_N | LA04_N
H10 | OUT | TOP | 18 | 4 | 1 | DATA_18_P | LA04_P
D9 | OUT | TOP | 20 | 4 | 2 | DATA_20_N | LA01_N_CC
D8 | OUT | TOP | 20 | 4 | 2 | DATA_20_P | LA01_P_CC
H8 | OUT | TOP | 22 | 4 | 3 | DATA_22_N | LA02_N
H7 | OUT | TOP | 22 | 4 | 3 | DATA_22_P | LA02_P
H32 | OUT | BOTTOM | 1 | 1 | 0 | DATA_1_N | LA28_N
H31 | OUT | BOTTOM | 1 | 1 | 0 | DATA_1_P | LA28_P
G31 | OUT | BOTTOM | 3 | 1 | 1 | DATA_3_N | LA29_N
G30 | OUT | BOTTOM | 3 | 1 | 1 | DATA_3_P | LA29_P
G28 | OUT | BOTTOM | 5 | 1 | 2 | DATA_5_N | LA25_N
G27 | OUT | BOTTOM | 5 | 1 | 2 | DATA_5_P | LA25_P
H29 | OUT | BOTTOM | 7 | 1 | 3 | DATA_7_N | LA24_N
H28 | OUT | BOTTOM | 7 | 1 | 3 | DATA_7_P | LA24_P
C27 | OUT | BOTTOM | 9 | 3 | 0 | DATA_9_N | LA27_N
C26 | OUT | BOTTOM | 9 | 3 | 0 | DATA_9_P | LA27_P
D27 | OUT | BOTTOM | 11 | 3 | 1 | DATA_11_N | LA26_N
D26 | OUT | BOTTOM | 11 | 3 | 1 | DATA_11_P | LA26_P
C26 | OUT | BOTTOM | 13 | 3 | 2 | DATA_13_N |  | H26???
H25 | OUT | BOTTOM | 13 | 3 | 2 | DATA_13_P | LA21_P
G25 | OUT | BOTTOM | 15 | 3 | 3 | DATA_15_N | LA22_N
G24 | OUT | BOTTOM | 15 | 3 | 3 | DATA_15_P | LA22_P
G3 | INOUT | BOTTOM |  | 3 |  | D_CLK_3_N | CLK1_M2C_N
G2 | INOUT | BOTTOM |  | 3 |  | D_CLK_3_P | CLK1_M2C_P
D24 | OUT | BOTTOM | 17 | 5 | 0 | DATA_17_N | LA23_N
D23 | OUT | BOTTOM | 17 | 5 | 0 | DATA_17_P | LA23_P
H23 | OUT | BOTTOM | 19 | 5 | 1 | DATA_19_N | LA19_N
H22 | OUT | BOTTOM | 19 | 5 | 1 | DATA_19_P | LA19_P
C23 | OUT | BOTTOM | 21 | 5 | 2 | DATA_21_N | LA18_N_CC
C22 | OUT | BOTTOM | 21 | 5 | 2 | DATA_21_P | LA18_P_CC
G22 | OUT | BOTTOM | 23 | 5 | 3 | DATA_23_N | LA20_N
G21 | OUT | BOTTOM | 23 | 5 | 3 | DATA_23_P | LA20_P
C35 | PWR |  |  |  |  | 12 V FMC
C37 | PWR |  |  |  |  | 12 V FMC
C39 | PWR |  |  |  |  | 3.3V FMC
D36 | PWR |  |  |  |  | 3.3V FMC
D38 | PWR |  |  |  |  | 3.3V FMC
D40 | PWR |  |  |  |  | 3.3V FMC
D32 | PWR |  |  |  |  | 3.3V_VAUX_FMC (EEPROM)
C18 | IN |  |  |  |  | CS_N_VADJ | LA14_P
C34 | IN |  |  |  |  | GA0 (EEPROM) | GA0
C35 | IN |  |  |  |  | GA1 (EEPROM) |  | D35?
H19 | IN |  |  |  |  | RESET_N_VADJ | LA15_P
C30 | IN |  |  |  |  | SCL (EEPROM) | SCL
D17 | IN |  |  |  |  | SCLK_VADJ | LA13_P
C31 | INOUT |  |  |  |  | SDA (EEPROM) | SDA
D18 | IN |  |  |  |  | SDATA_VADJ | LA13_N
C19 | OUT |  |  |  |  | SDATAOUT_VADJ | LA14_N
H20 | IN |  |  |  |  | TRIGGER_INT_VADJ | LA15_N
G19 | IN |  |  |  |  | TRIGGER_RD_VADJ | LA16_N
E39 | PWR |  |  |  |  | VADJ (for voltage convertor)
F40 | PWR |  |  |  |  | VADJ (for voltage convertor)
G39 | PWR |  |  |  |  | VADJ (for voltage convertor)
H40 | PWR |  |  |  |  | VADJ (for voltage convertor)
J39 | PWR |  |  |  |  | VIO_B_M2C
K40 | PWR |  |  |  |  | VIO_B_M2C
H1 | PWR |  |  |  |  | VREF_A_M2C
K1 | PWR |  |  |  |  | VREF_B_M2C
G18 | OUT |  |  |  |  | MON_MUX_OUT_VADJ | LA16_P | ???Not mapped
