AM4511/test_migrate_iris4/athena/doc/fpga_selection/lattice_eval_board.xls

Incoming Equipment Template:
Division: | Imaging
Request Date: | 11/13/2019
Requested by: | Alain Marchand/Imaging/ext. 2197
Reason: | Equipment Giveaway TO Matrox
Company Name & Address: | Lattice SG PTE LTD
 | 3 Changi North Street 2
 | #01-02B/#01-03
 | Singapore 498827
FIN Number (if applicable)
(Federal Identification No. - US Shipments ONLY)
VAT Number (if applicable) :
( Value Added Tax - EU Shipments ONLY)
Contact Name/Tel/Email Address:
 | Jean-François Leroux, Area Manager, Québec & Maritime Provinces, CEE-JAY MICRO LTD, jean-francois@cjmicro.com(514) 564-7585
Territory : | North America
Product Status: | Engineering Unit(s)
Office & Warehouse | Please Select
Description : | MFG Name * | MFG Description * | COO* | Part No. | Qty | Serial | Customs Value/Unit (usd) | Customs Value Total (usd)
 | Versal Evaluation board | FPGA evaluation PCB |  | LFE5UM-45F-VERSA-EVN | 1 | 85437090 | $159.00 | $159.00
 |  |  |  |  |  |  |  | $0.00
 |  |  |  |  |  |  |  | $0.00
 |  |  |  |  |  |  |  | $0.00
 |  |  |  |  |  |  |  | $0.00
 |  |  |  |  |  |  |  | $0.00
 | Total |  |  |  |  |  |  | $159.00
Duration of Loan: | N/A
Business Case: | FPGA performance evaluation for the new Imaging Iris-4 project
Sales Opportunity (Qty/$$) :
Terms & Conditions : | Please Select
Zero Dollar PO: | NO (Do Not Email Zero Dollar PO- For INTERNAL PURPOSES only)
Shipping Details :
Who is covering shipping cost ? | Please Select
2.Shipping Cost Prepaid by Matrox:
(Please forward weights & dimensions to logistics@matrox.com,duties & taxes not covered by Matrox)
Carrier/Service Method: | Other
