AM4511/test_migrate_iris4/athena/local_ip/XGS_athena/validation2/src/readme.txt

INTERFACE------------

hispi_bus            : current dir
axi_lite_interface   : C:\work\iris4\athena\ipcores\interfaces\sv
axi_stream_interface : C:\work\iris4\athena\ipcores\interfaces\sv
io_interface         : C:\work\iris4\athena\ipcores\interfaces\sv
tlp_interface        : current dir

DRIVERS--------------
driver_pkg + Cdriver_axil  from   : C:\work\iris4\athena\ipcores\vlib\sv\drivers
