AM4511/test_migrate_iris4/athena/bench/Validation_XGS5M_COLOR/Keep_out_zone_0xb1a.png

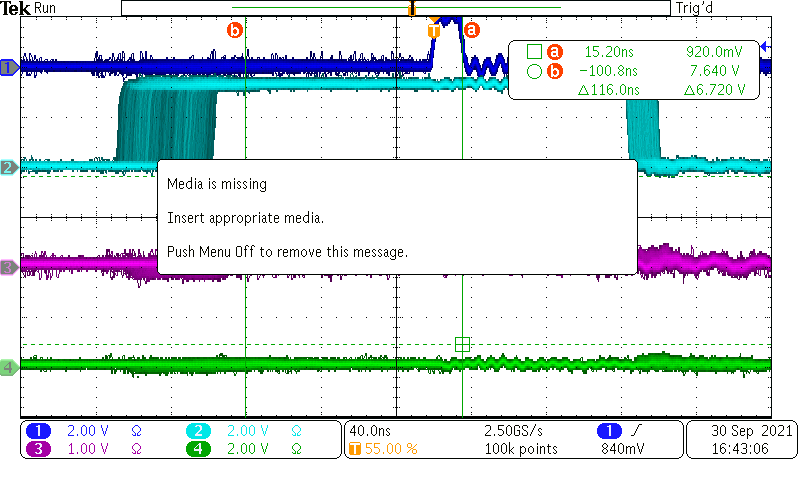
athena/bench/Validation_XGS5M_COLOR/Keep_out_zone_0xb1a.png
