AM4511/test_migrate_iris4/athena/bench/Validation_XGS8M_COLOR/KEEP_OUT_ZONE_START.png

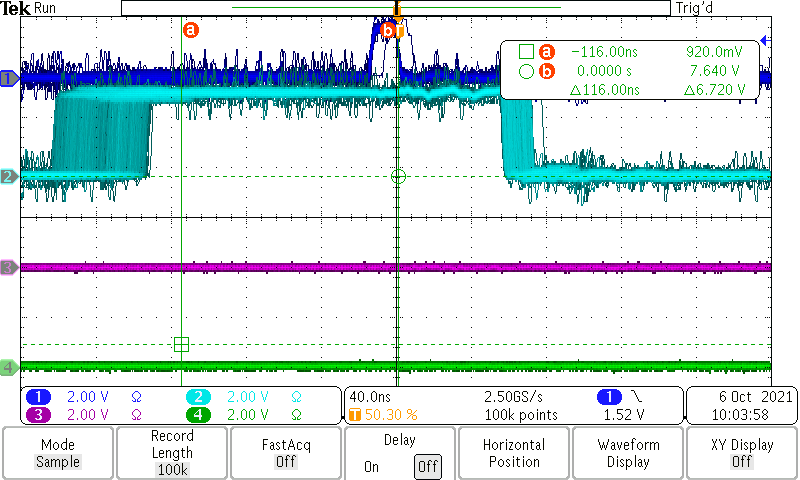
athena/bench/Validation_XGS8M_COLOR/KEEP_OUT_ZONE_START.png
