AM4511/test_migrate_iris4/athena/bench/Validation_XGS16M/Keep_Out_Zone_Start_0x2bf.PNG

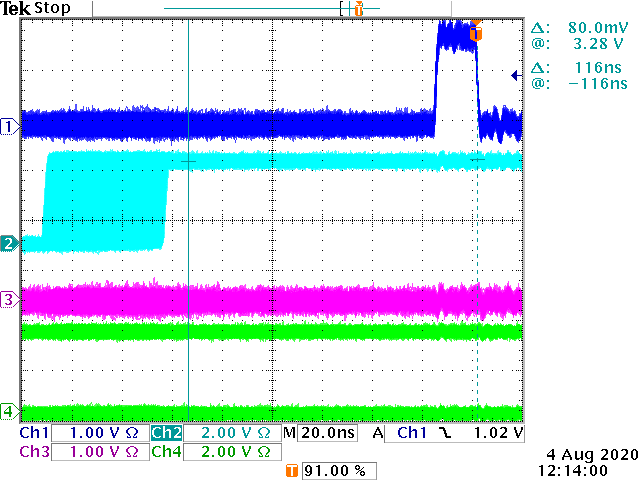
athena/bench/Validation_XGS16M/Keep_Out_Zone_Start_0x2bf.PNG
