AM4511/test_migrate_iris4/athena/bench/Validation_XGS16M_COLOR/Keep_Out_Zone_Start_0xb1a.PNG

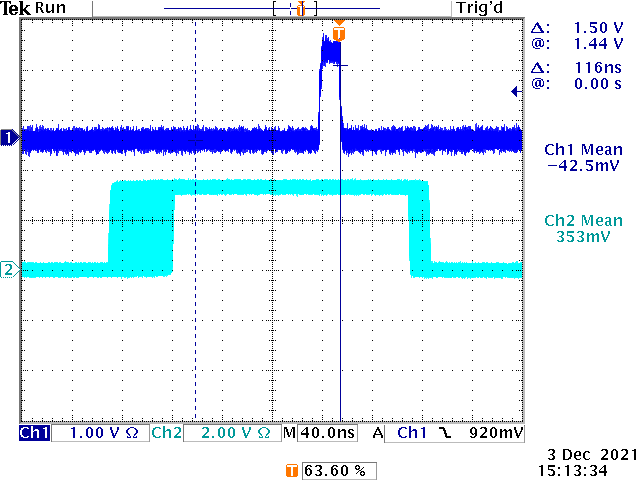
athena/bench/Validation_XGS16M_COLOR/Keep_Out_Zone_Start_0xb1a.PNG
