AM4511/test_migrate_iris4/athena/bench/Validation_XGS16M_COLOR/ReadOutN_2_TrigN.PNG

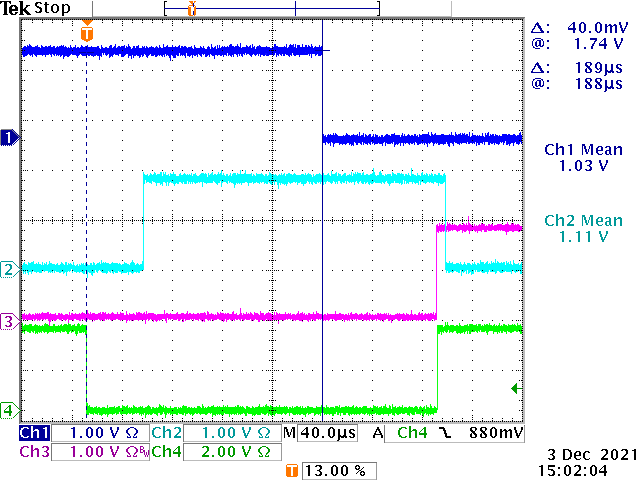
athena/bench/Validation_XGS16M_COLOR/ReadOutN_2_TrigN.PNG
