AM4511/test_migrate_iris4/athena/bench/Validation_XGS16M_COLOR/TrigN_2_FOT.PNG

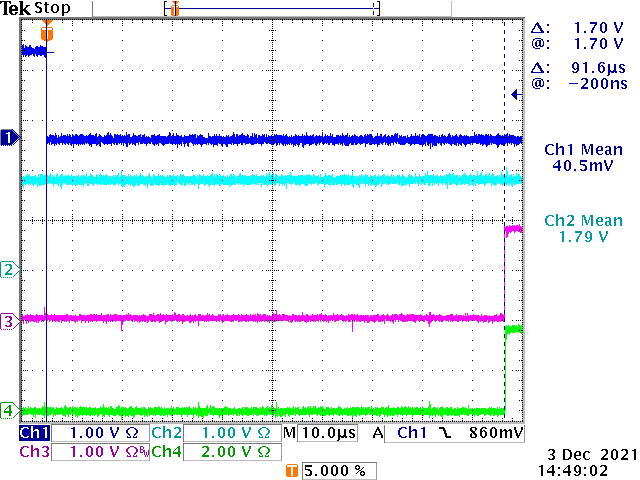
athena/bench/Validation_XGS16M_COLOR/TrigN_2_FOT.PNG
