AM4511/test_migrate_iris4/doc/schematic_review/7571-00 Feb 21_commented_by_all.pdf

# MATROX CONFIDENTIAL

# IRIS4 CPU Board

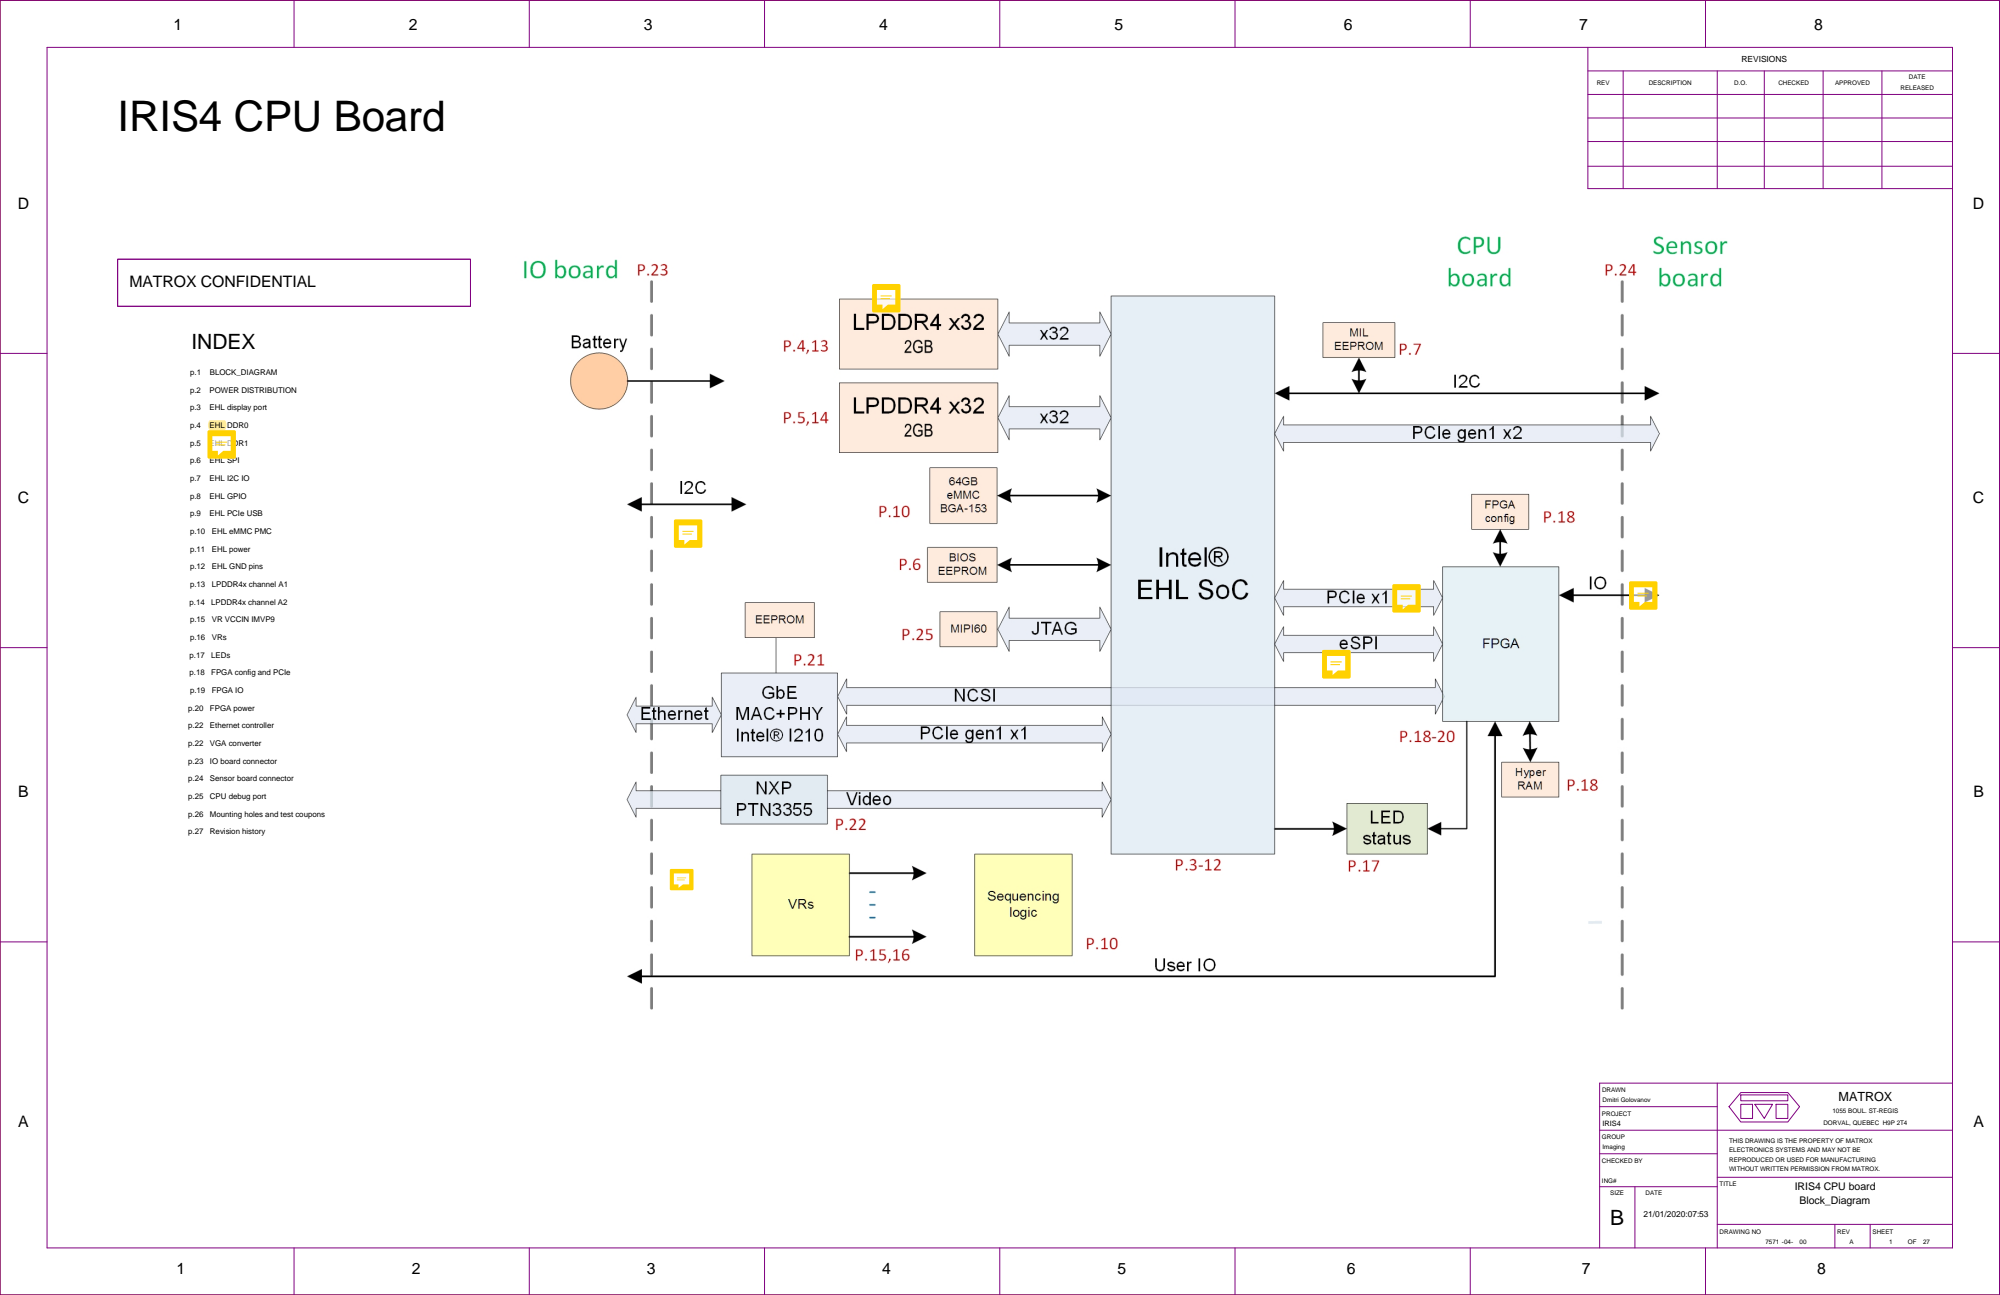
[picture p24: page 1]
INDEX; p.27 Revision history; p.20 FPGA power; p.19 FPGA IO; p.17 LEDs; p.16 VRs; p.15 VR VCCIN IMVP9; p.14 LPDDR4x channel A2; p.13 LPDDR4x channel A1; p.11 EHL power; p.8 EHL GPIO; p.7 EHL I2C IO; p.6 EHL SPI; p.5 EHL DDR1; p.4 EHL DDR0; p.2 POWER DISTRIBUTION; p.1 BLOCK_DIAGRAM; DRAWN; PROJECT; GROUP; ING#; SIZE; DRAWING NO; TITLE; SHEET; MATROX; REV; CHECKED BY; Imaging; Dmitri Golovanov; IRIS4; Block_Diagram; IRIS4 CPU board; p.22 Ethernet controller; p.22 VGA converter

REVISIONS

REV | DESCRIPTION | D.O. | CHECKED | APPROVED | DATE RELEASED

p.3 EHL display port

p.9 EHL PCIe USB

p.10 EHL eMMC PMC

p.12 EHL GND pins

p.18 FPGA config and PCIe

p.23 IO board connector

p.24 Sensor board connector

p.25 CPU debug port

p.26 Mounting holes and test coupons

1055 BOUL. ST-REGIS
DORVAL, QUEBEC H9P 2T4

THIS DRAWING IS THE PROPERTY OF MATROX
ELECTRONICS SYSTEMS AND MAY NOT BE
REPRODUCED OR USED FOR MANUFACTURING
WITHOUT WRITTEN PERMISSION FROM MATROX.

D

D

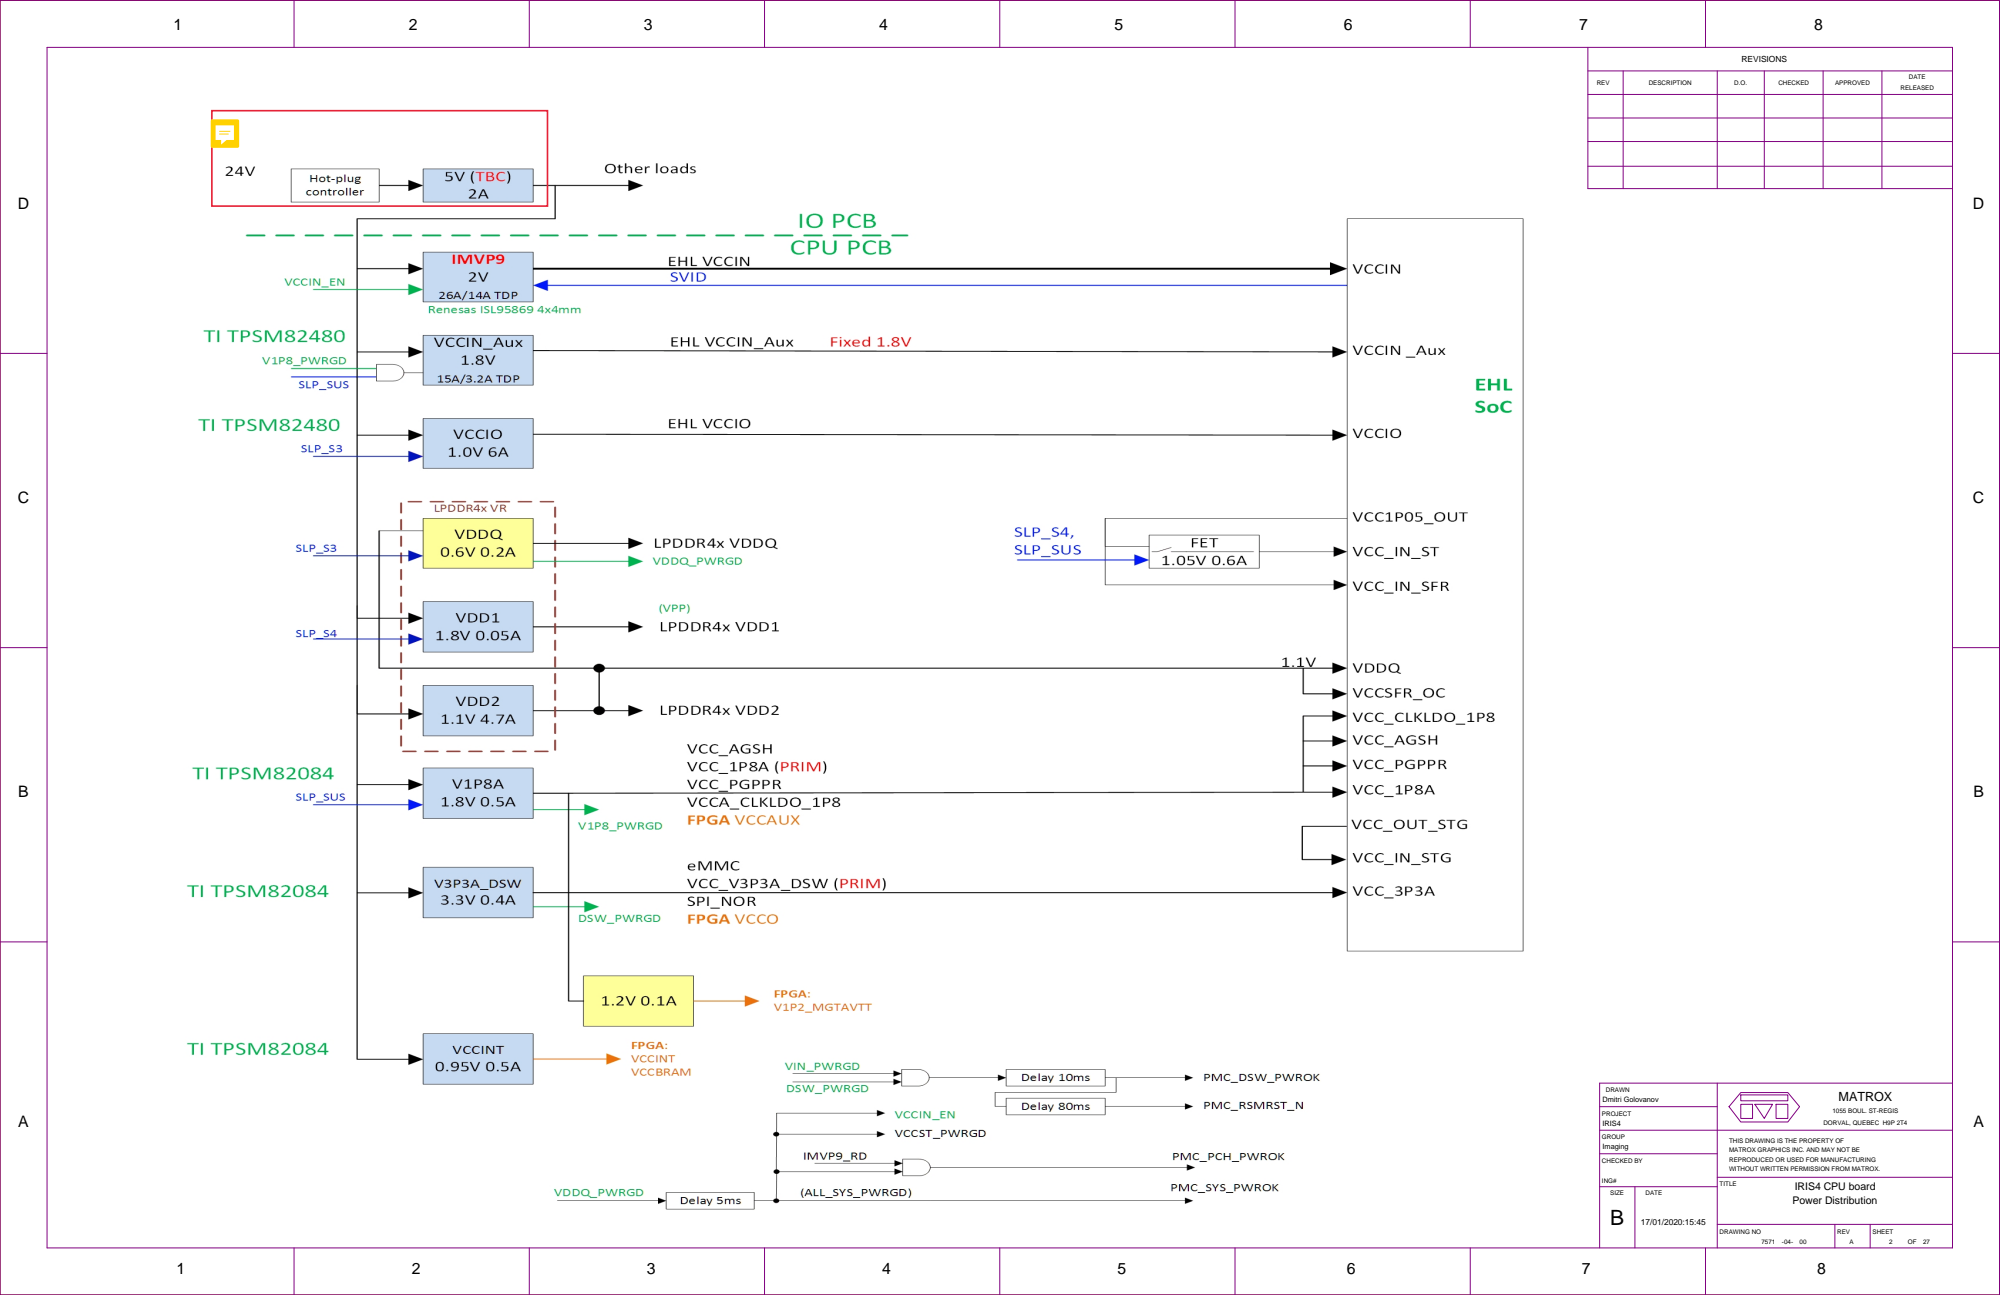
[picture p25: page 2]
DRAWN; PROJECT; GROUP; ING#; MATROX; CHECKED BY; Power Distribution; IRIS4; Dmitri Golovanov; Imaging

1055 BOUL. ST-REGIS
DORVAL, QUEBEC H9P 2T4

THIS DRAWING IS THE PROPERTY OF
MATROX GRAPHICS INC. AND MAY NOT BE
REPRODUCED OR USED FOR MANUFACTURING
WITHOUT WRITTEN PERMISSION FROM MATROX.

D

D

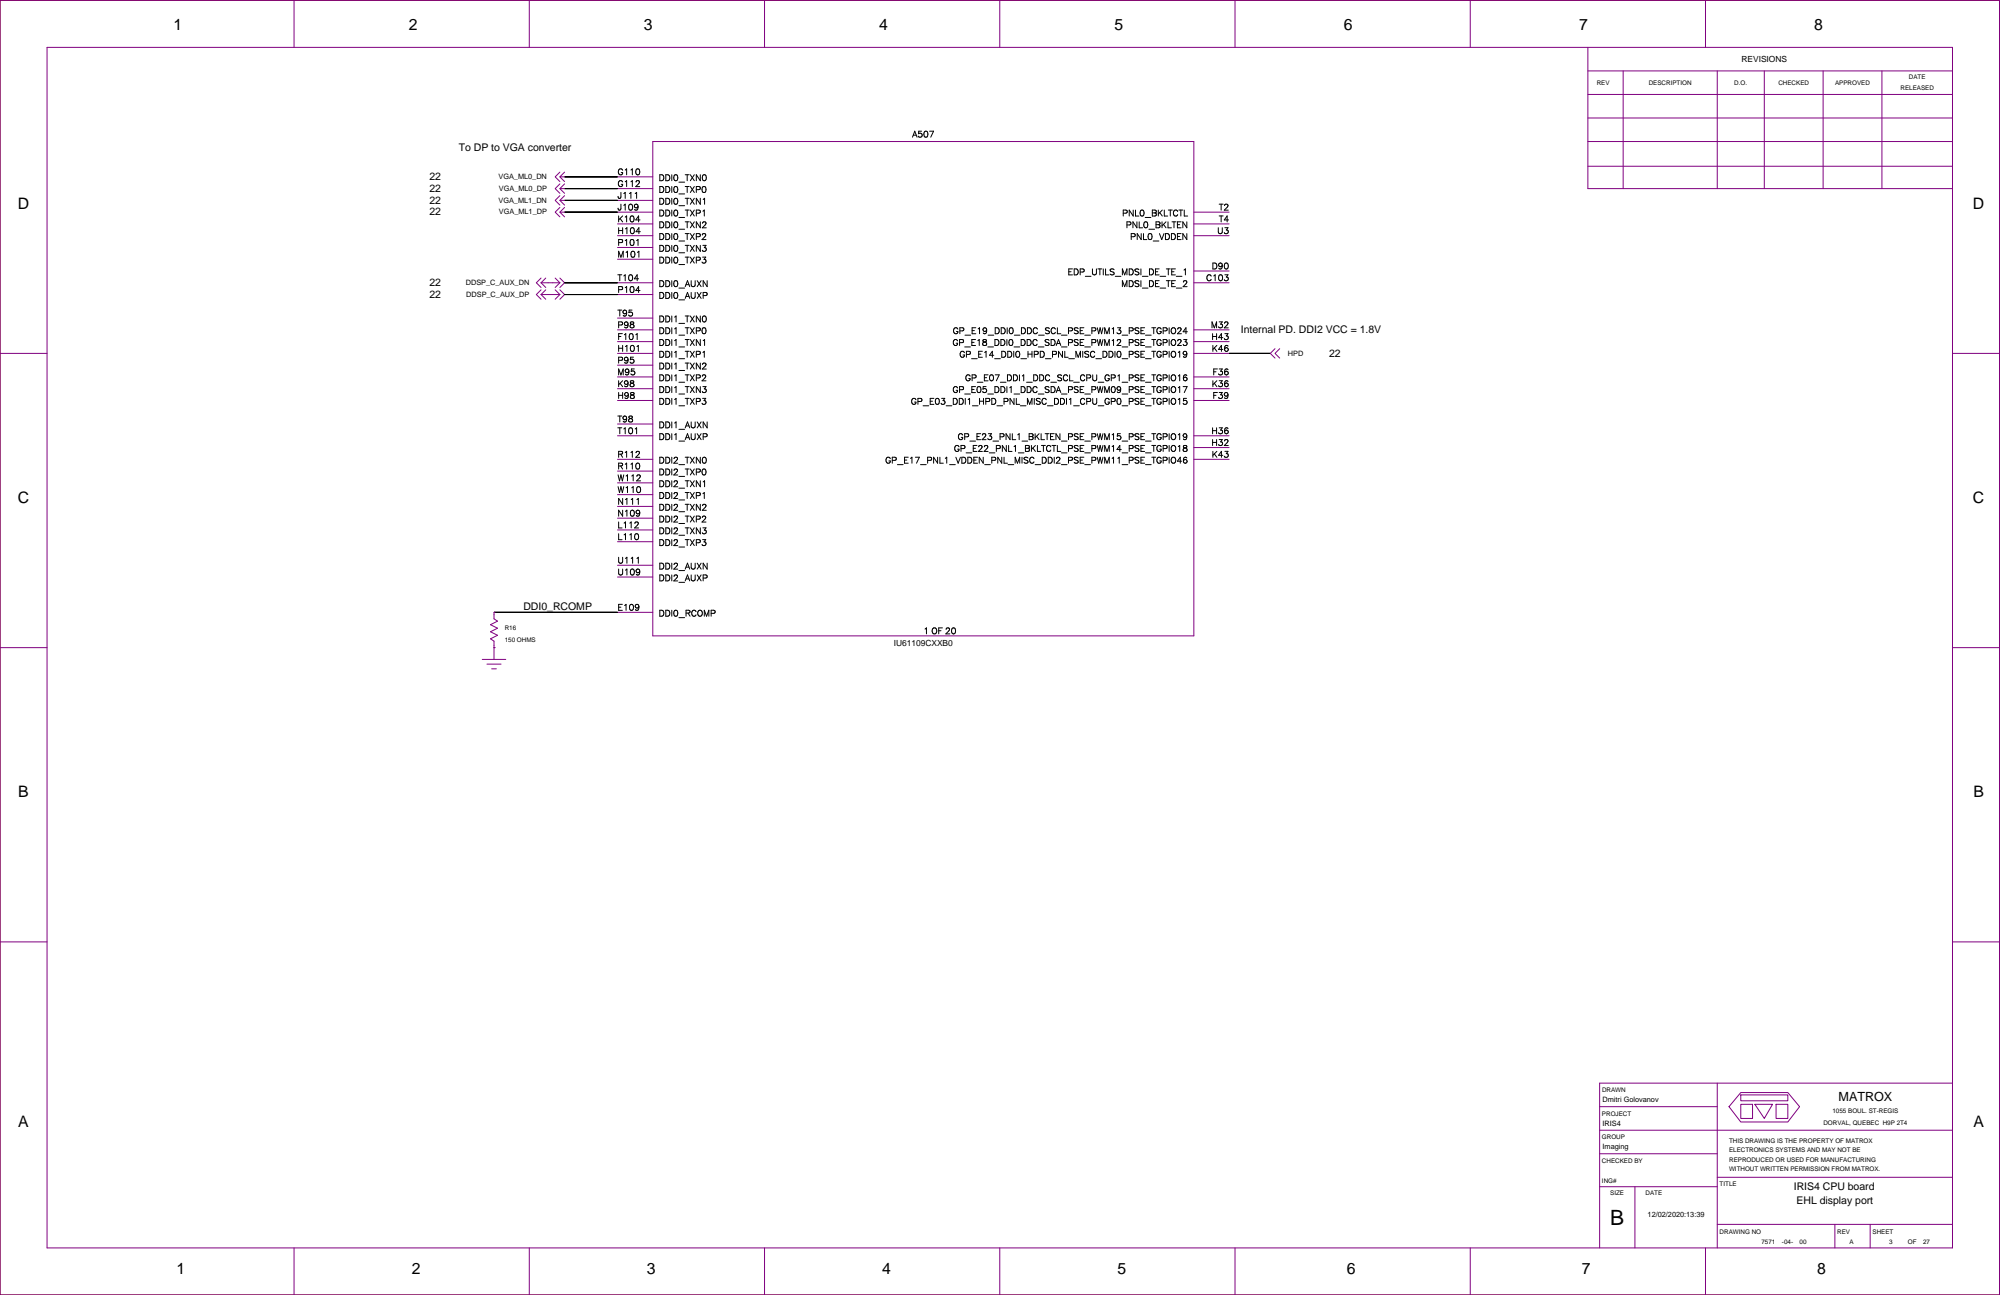
[picture p26: page 3]

To DP to VGA converter

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

# BCD

## ABCD

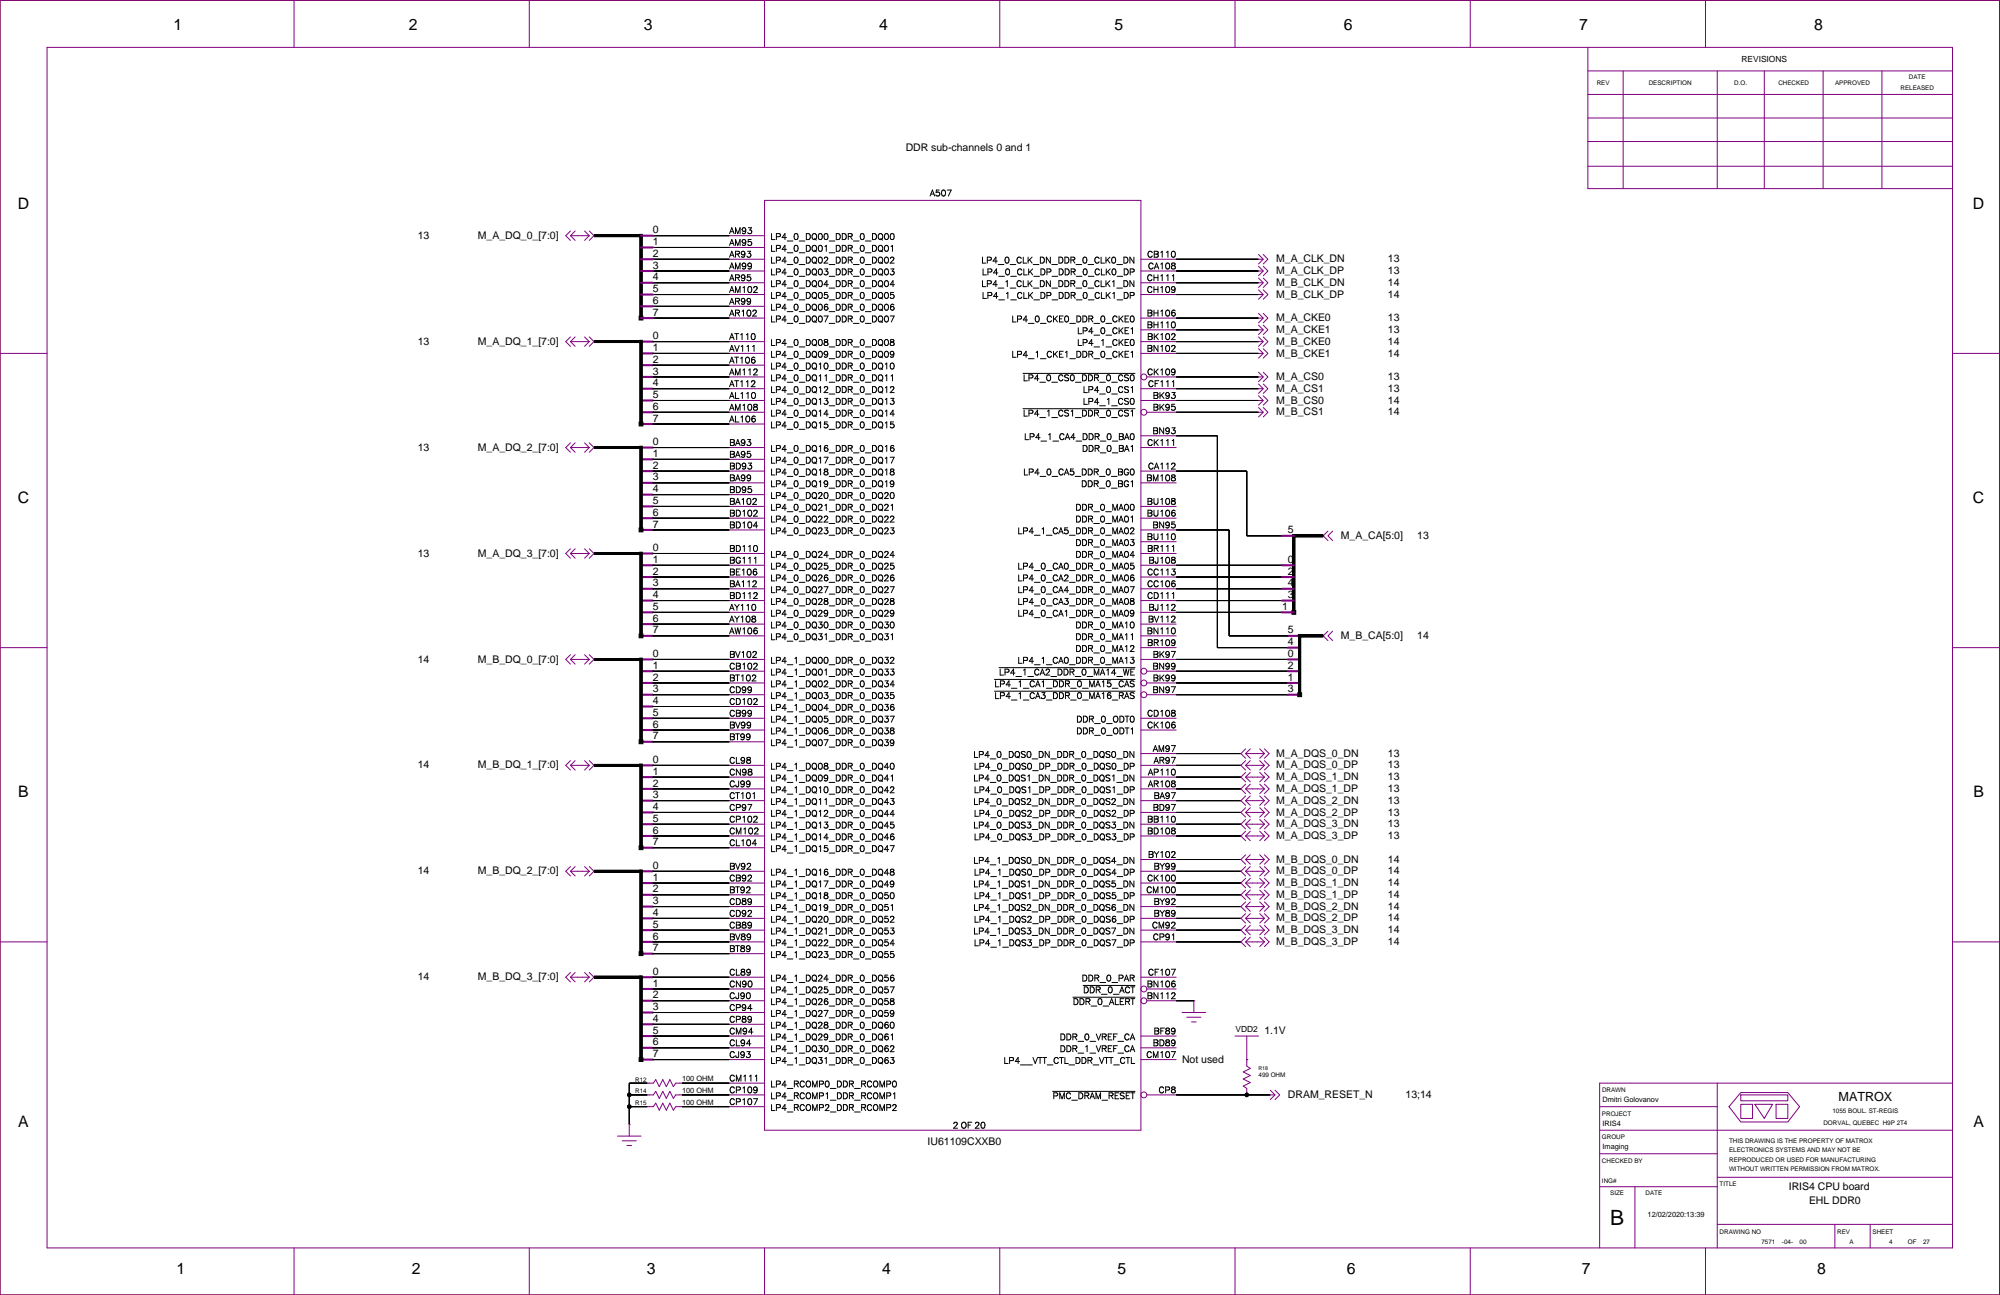
[picture p27: page 4]
DRAWN; PROJECT; GROUP; ING#; MATROX; CHECKED BY; IU61109CXXB0; R18 499 OHM; VDD2; Dmitri Golovanov; Imaging; IRIS4; EHL DDR0; Not used; M_A_DQS_0_DN M_A_DQS_0_DP; M_A_DQS_3_DN M_A_DQS_3_DP; M_A_DQS_2_DN M_A_DQS_2_DP; M_A_DQS_1_DN M_A_DQS_1_DP; M_B_DQS_0_DN M_B_DQS_0_DP; M_B_DQS_3_DN M_B_DQS_3_DP; M_B_DQS_2_DN M_B_DQS_2_DP; M_B_DQS_1_DN M_B_DQS_1_DP; M_A_CKE1; M_A_CKE0; M_A_CLK_DN M_A_CLK_DP; M_B_CKE1; M_B_CKE0; M_B_CLK_DN M_B_CLK_DP; DRAM_RESET_N; 100 OHM

DDR sub-channels 0 and 1

1055 BOUL. ST-REGIS
DORVAL, QUEBEC H9P 2T4

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

# BCD

## ABCD

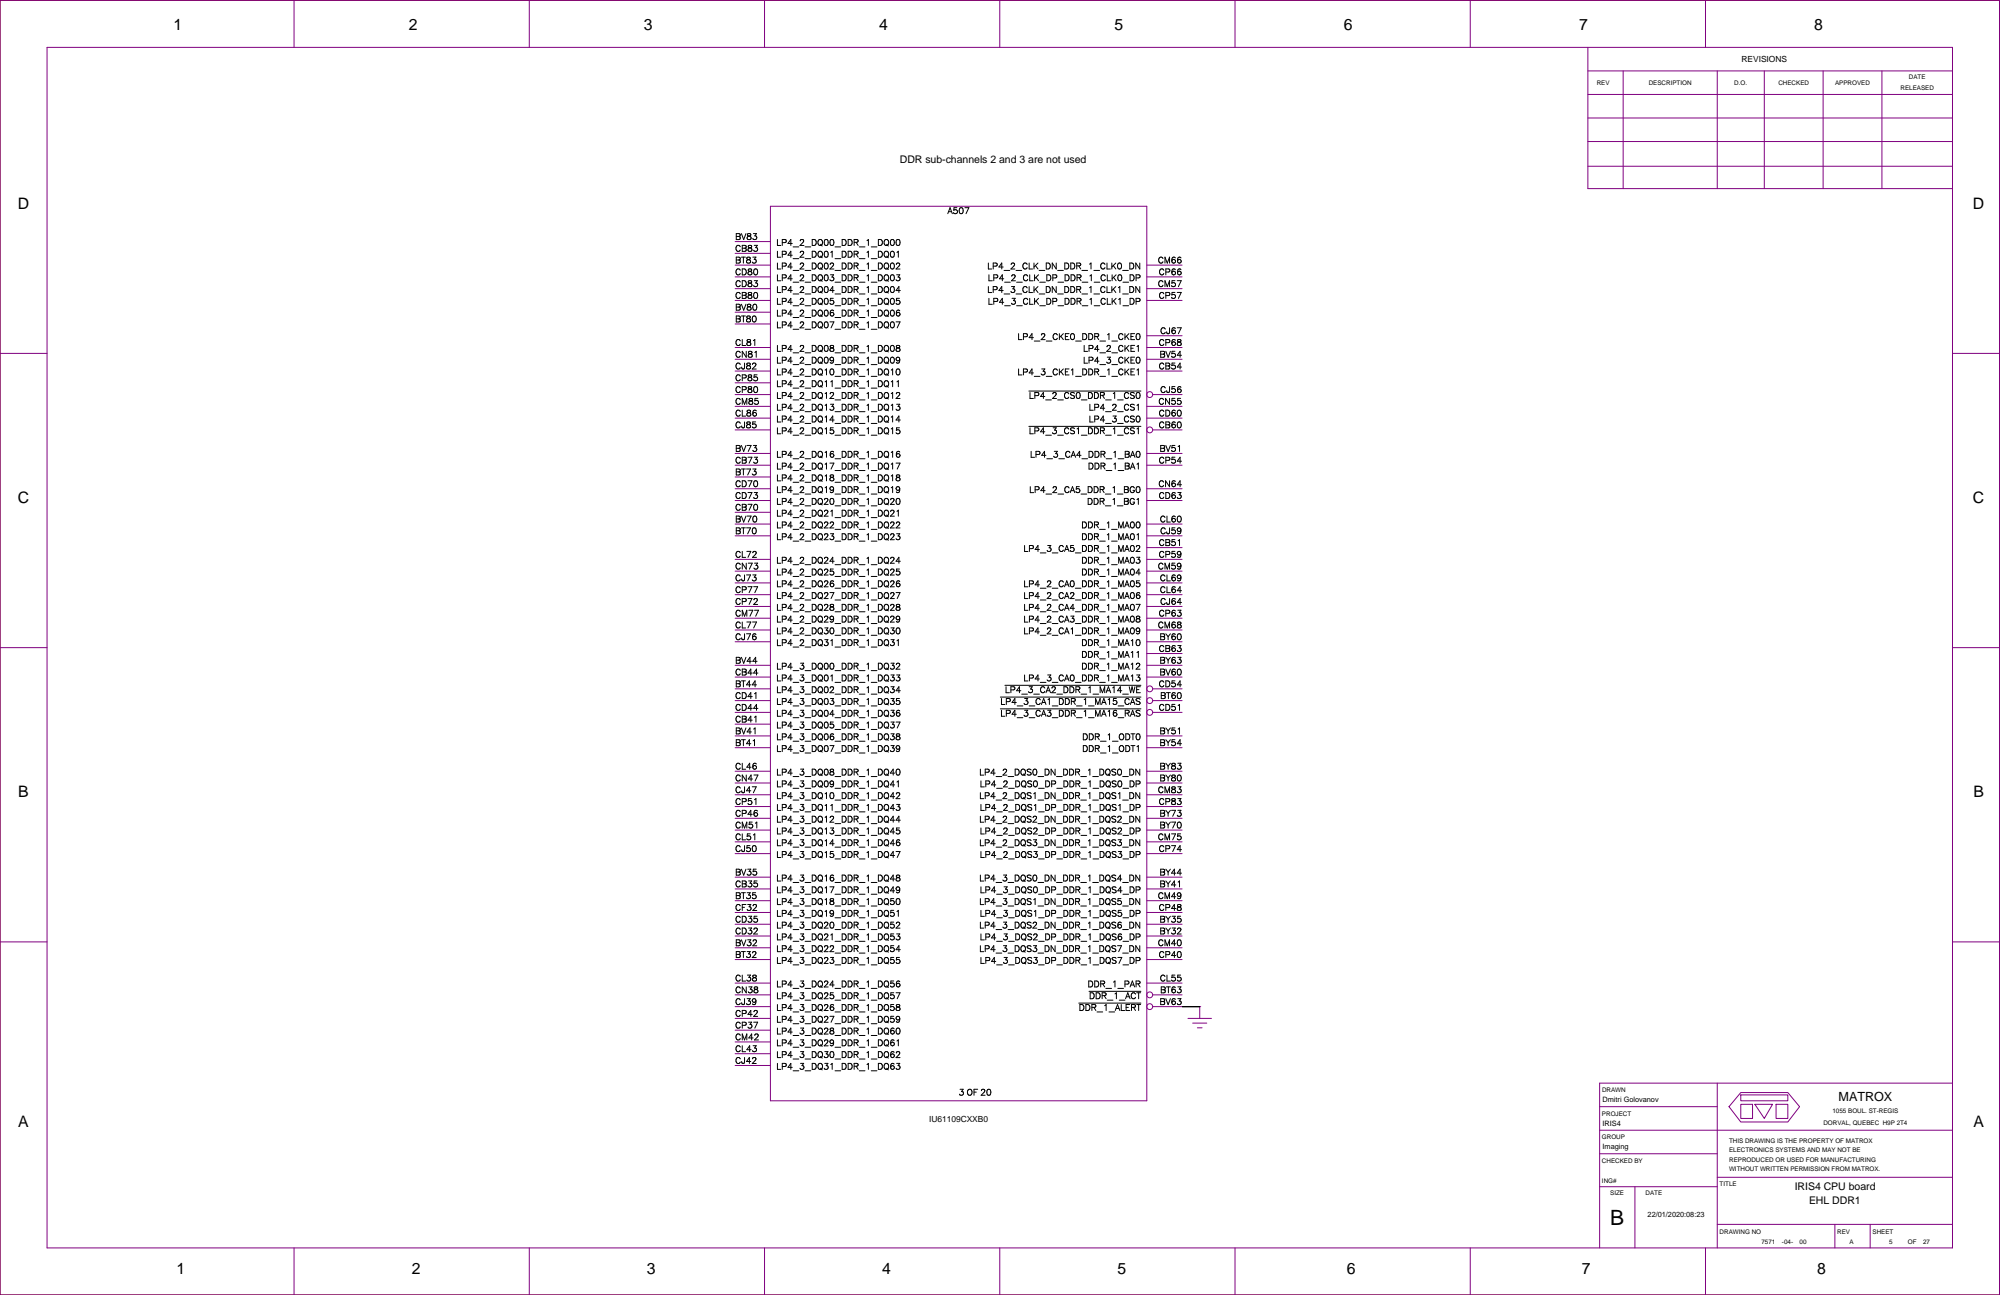
[picture p28: page 5]
DRAWN; PROJECT; GROUP; ING#; MATROX; CHECKED BY; IU61109CXXB0; Dmitri Golovanov; Imaging; IRIS4; EHL DDR1

DDR sub-channels 2 and 3 are not used

1055 BOUL. ST-REGIS
DORVAL, QUEBEC H9P 2T4

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

D

D

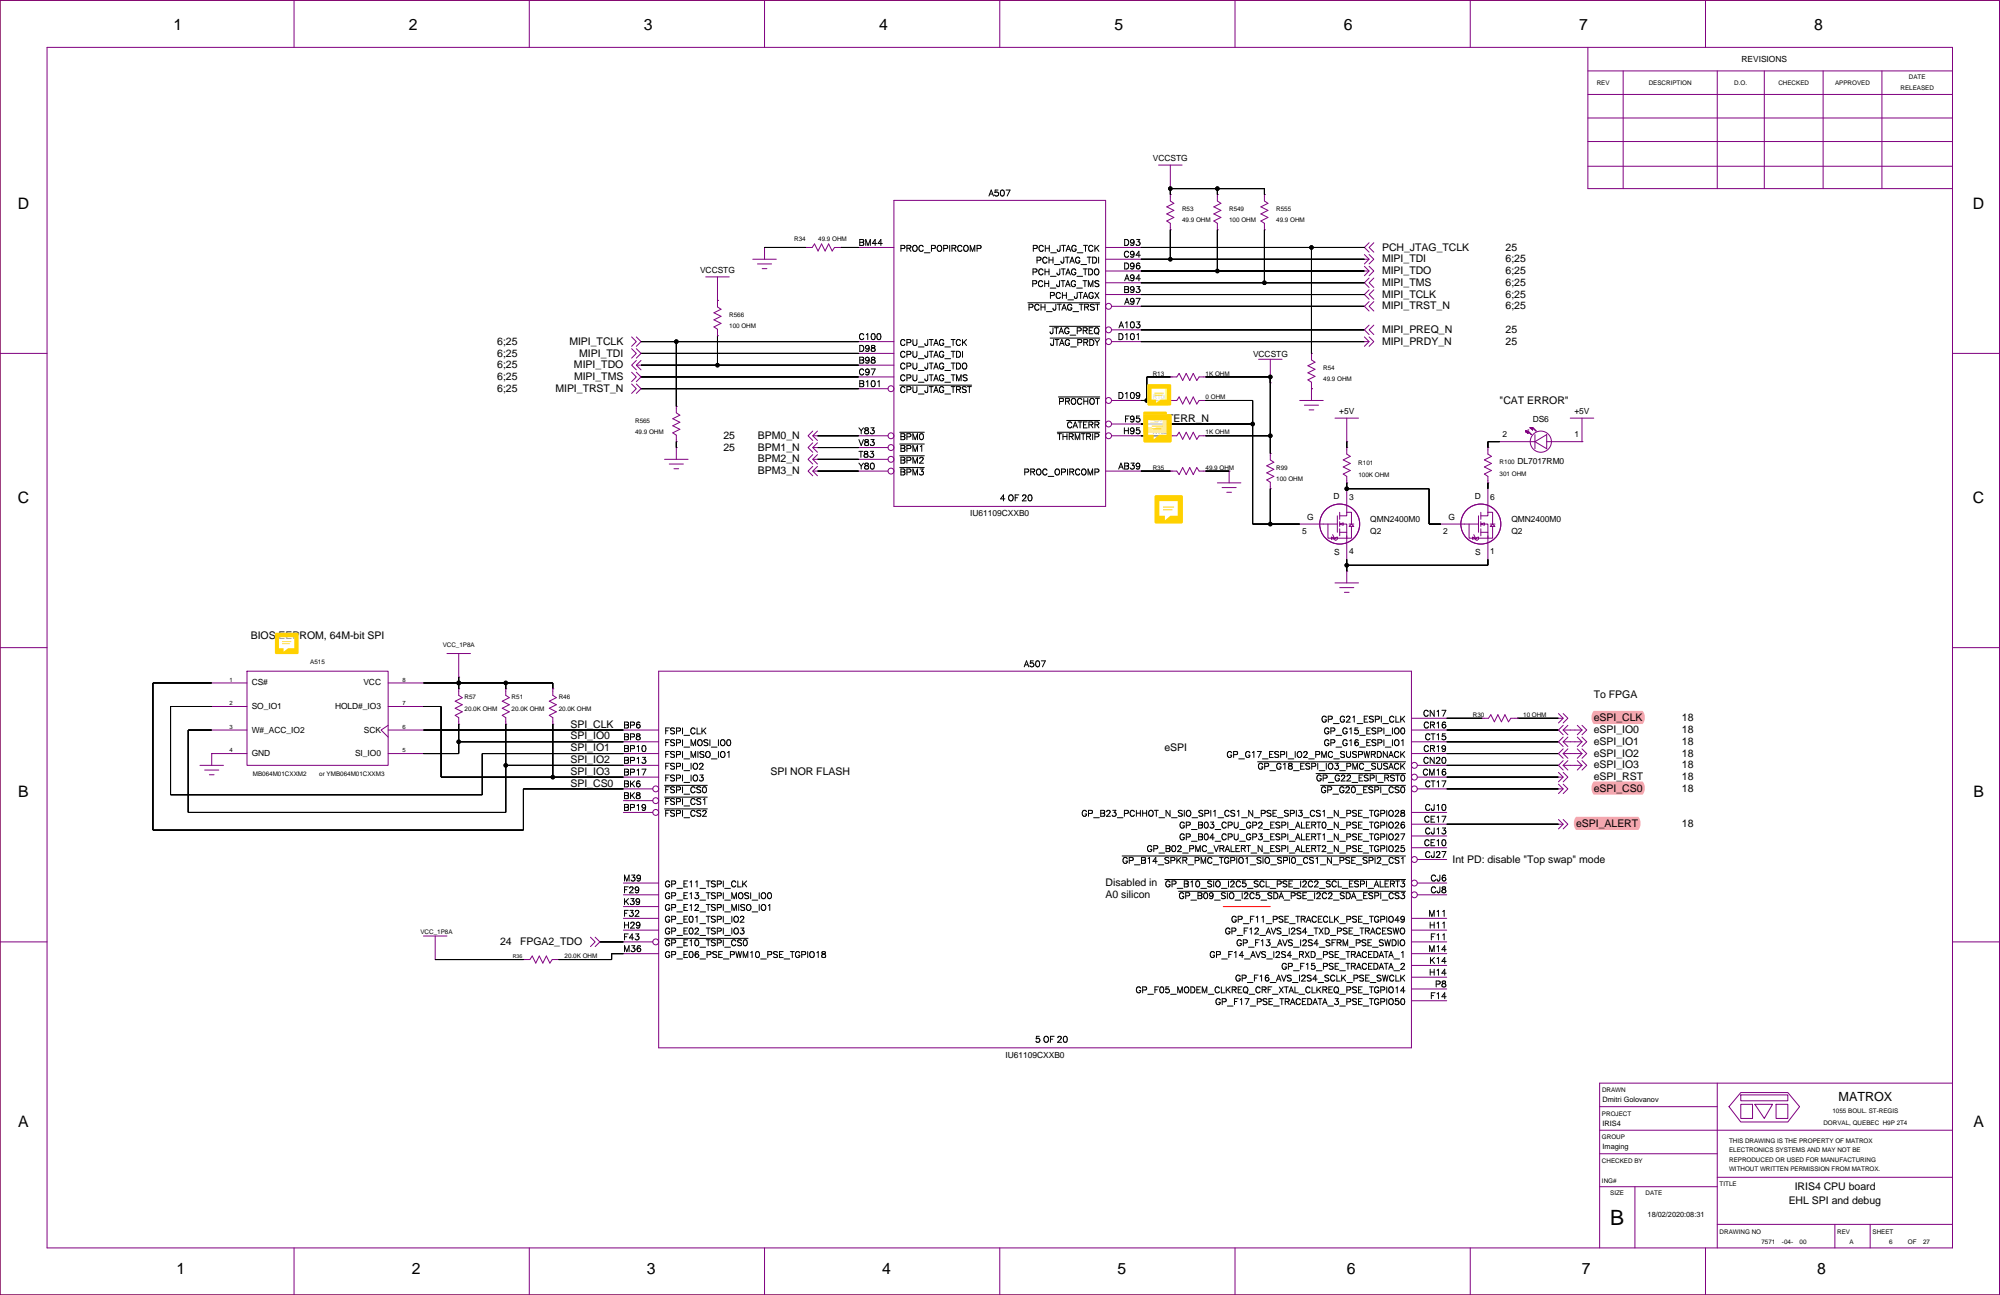
[picture p29: page 6]

BIOS EEPROM, 64M-bit SPI

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

EHL SPI and debug

D

D

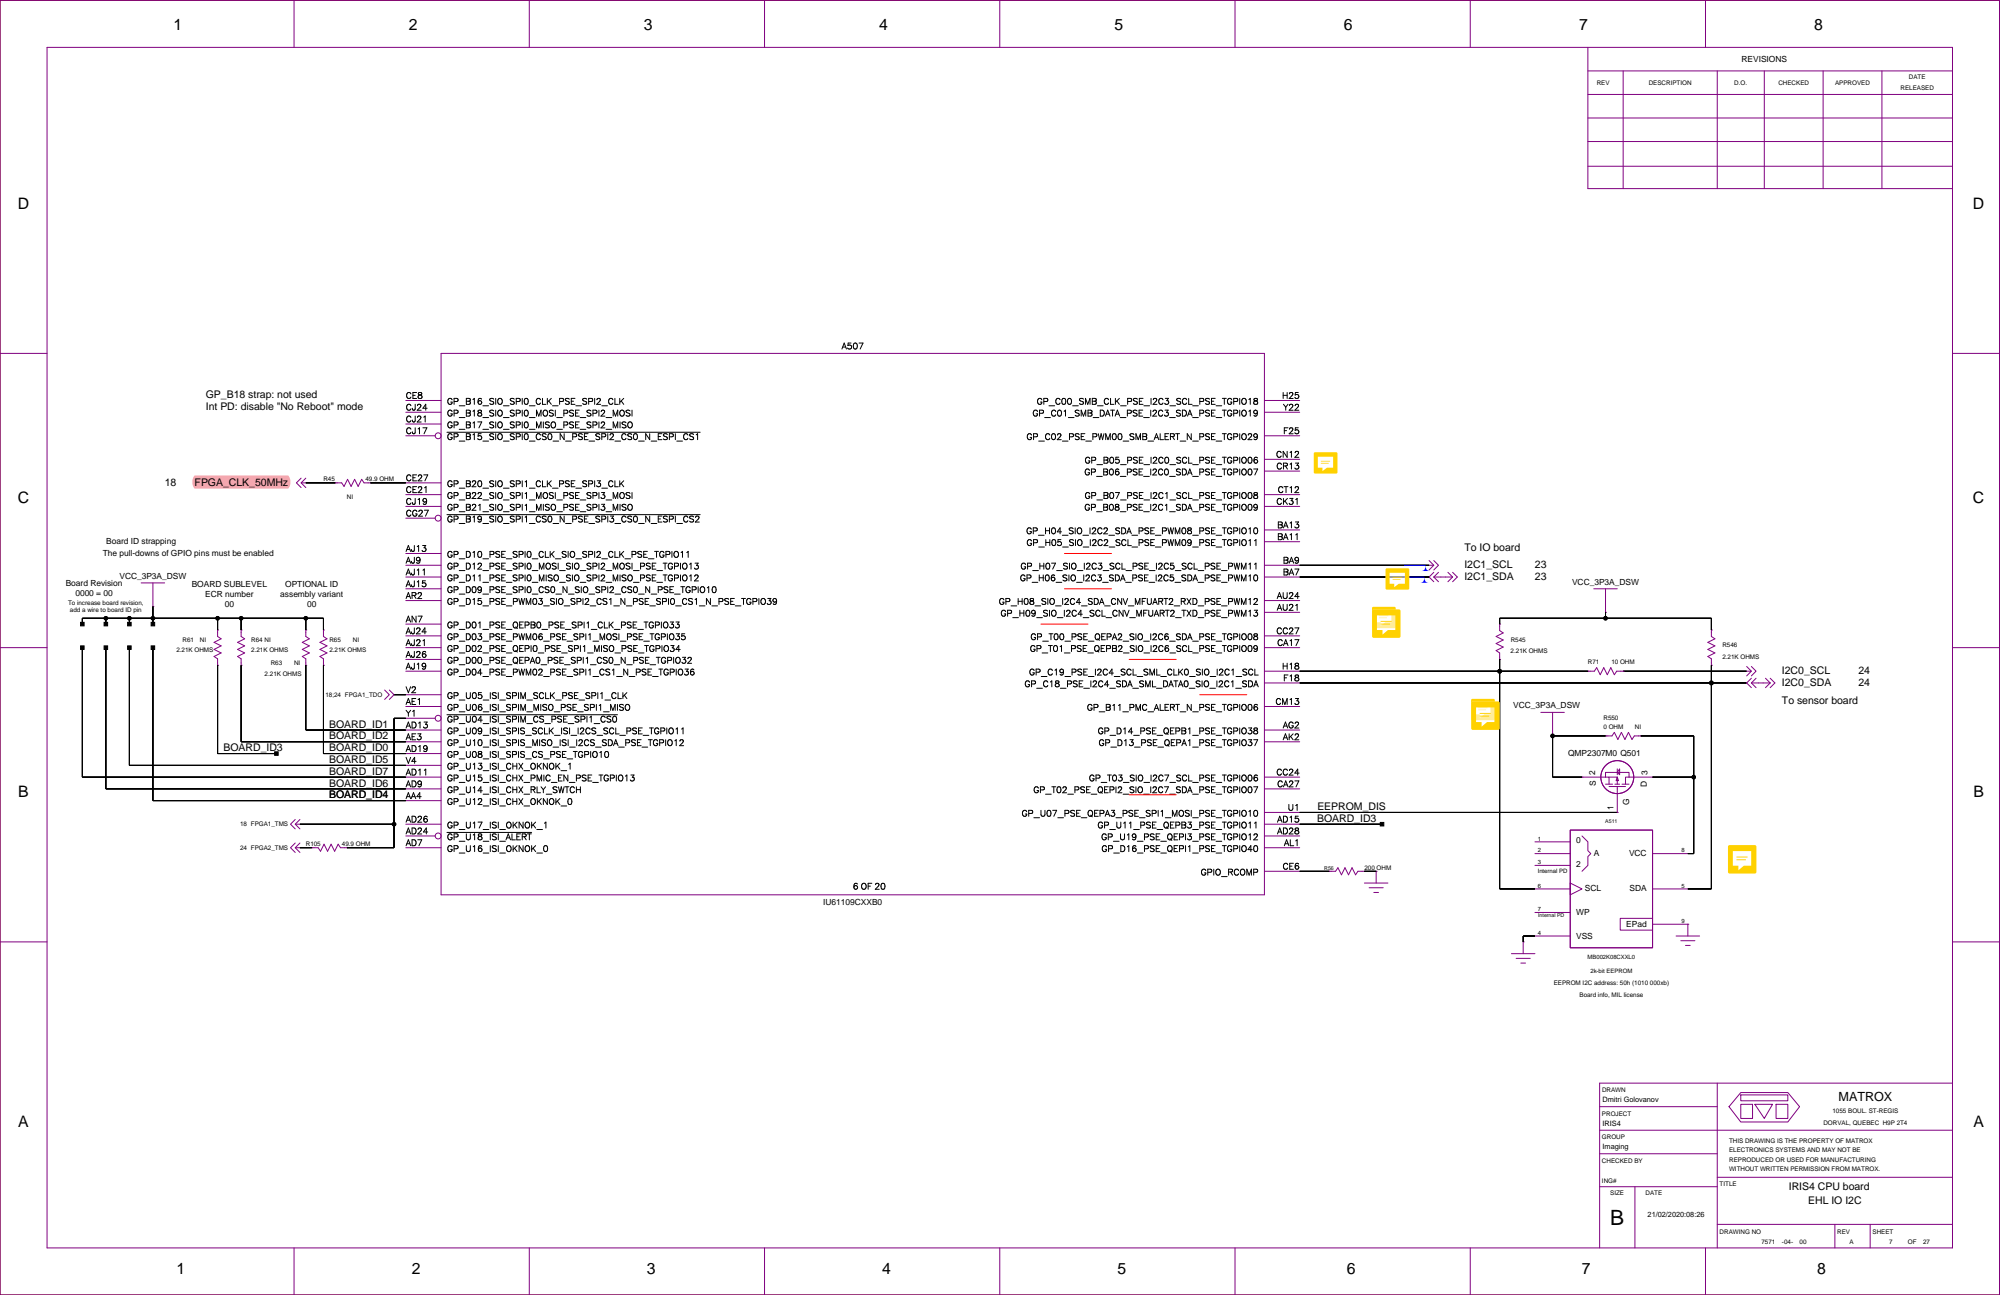
[picture p30: page 7]

GP_B18 strap: not used
Int PD: disable "No Reboot" mode

Board ID strapping
The pull-downs of GPIO pins must be enabled

Board Revision
To increase board revision,
add a wire to board ID pin

Board info, MIL license

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

D

D

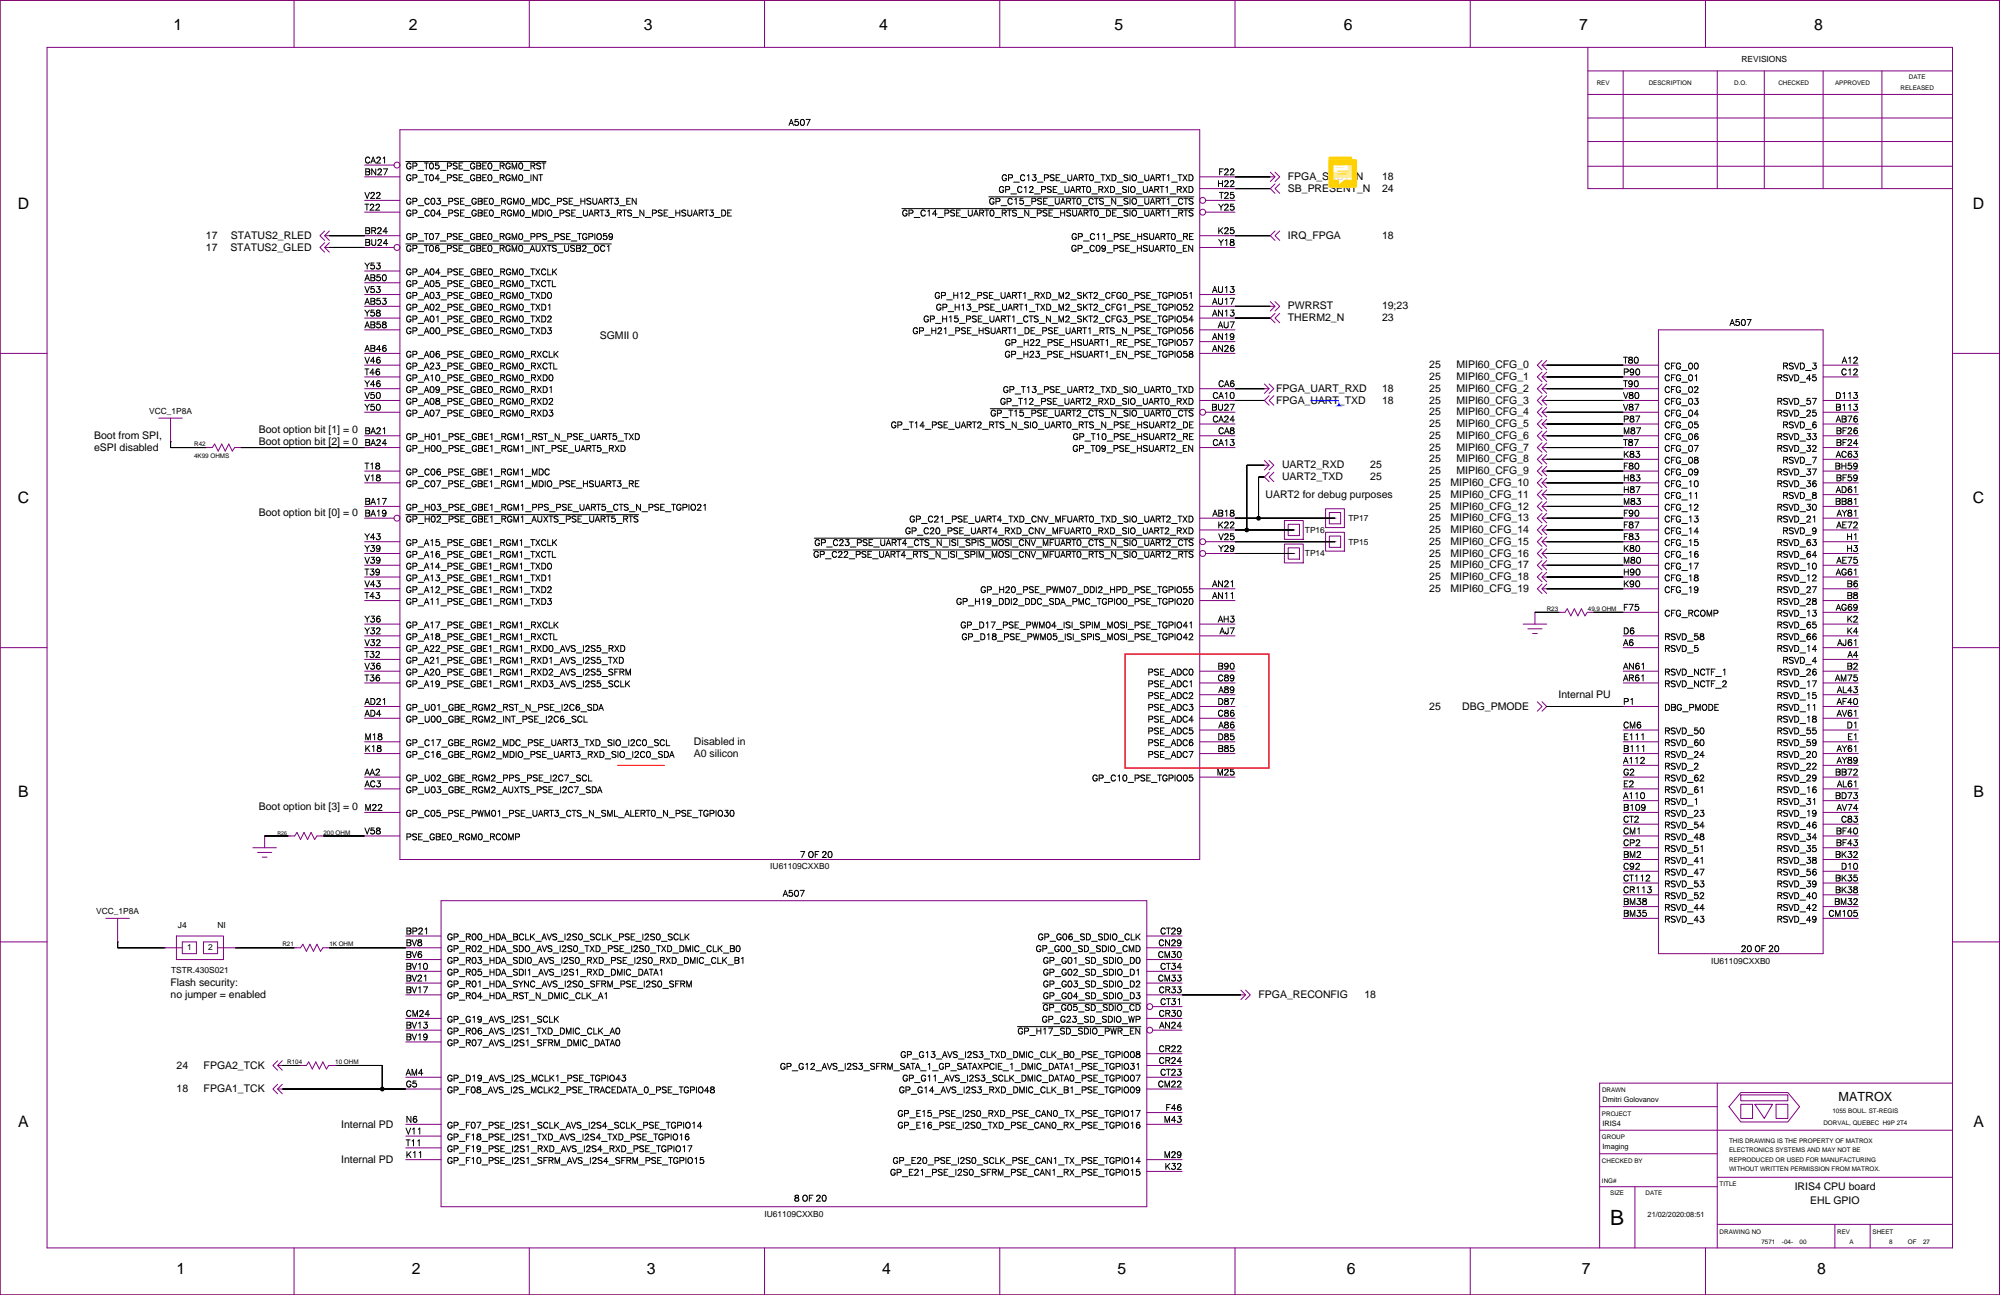
[picture p31: page 8]
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

D

D

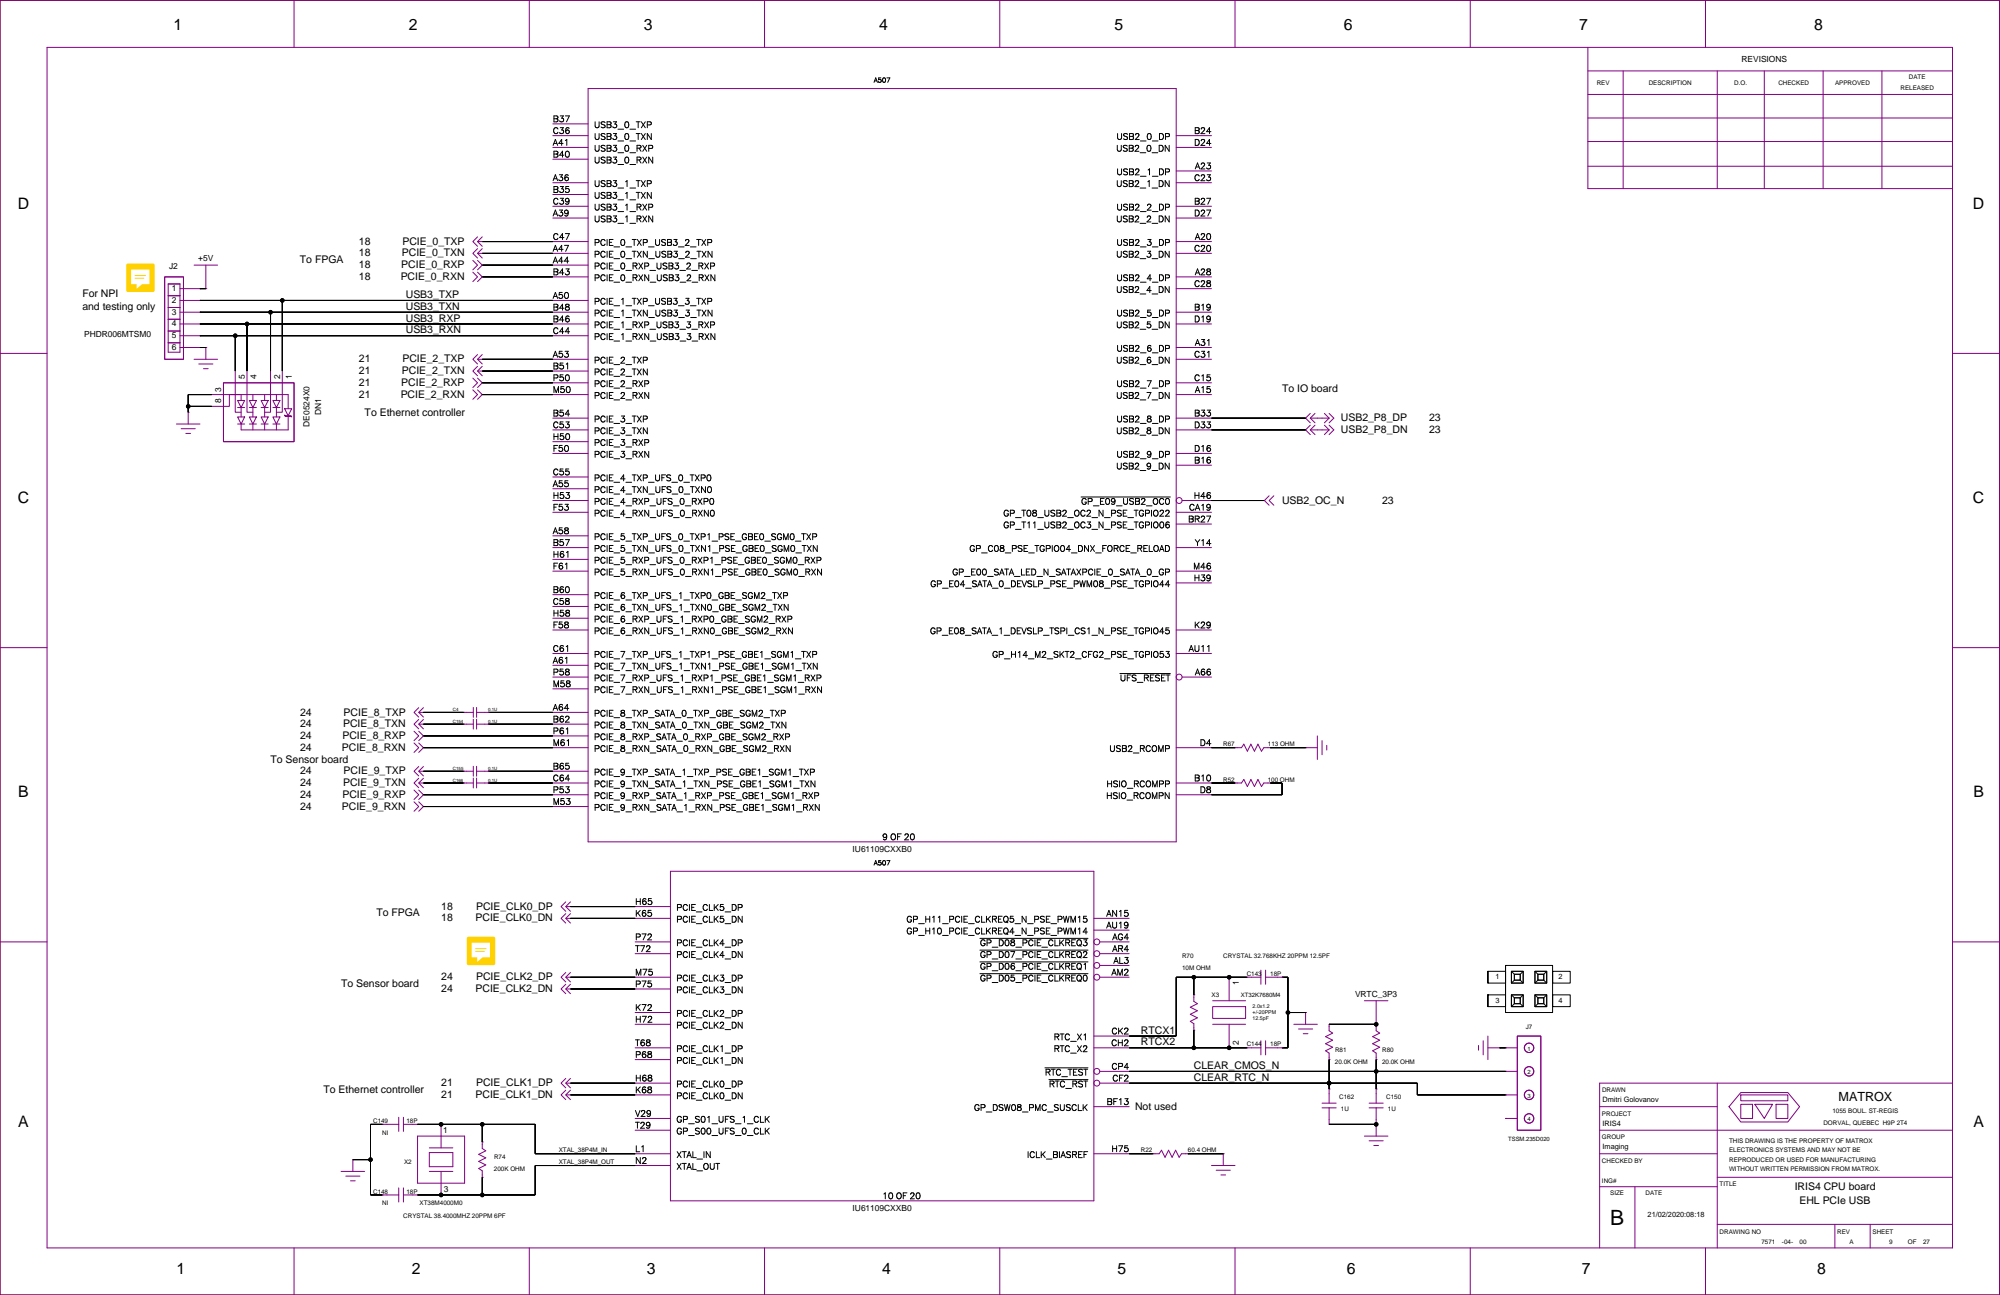
[picture p32: page 9]
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

D

D

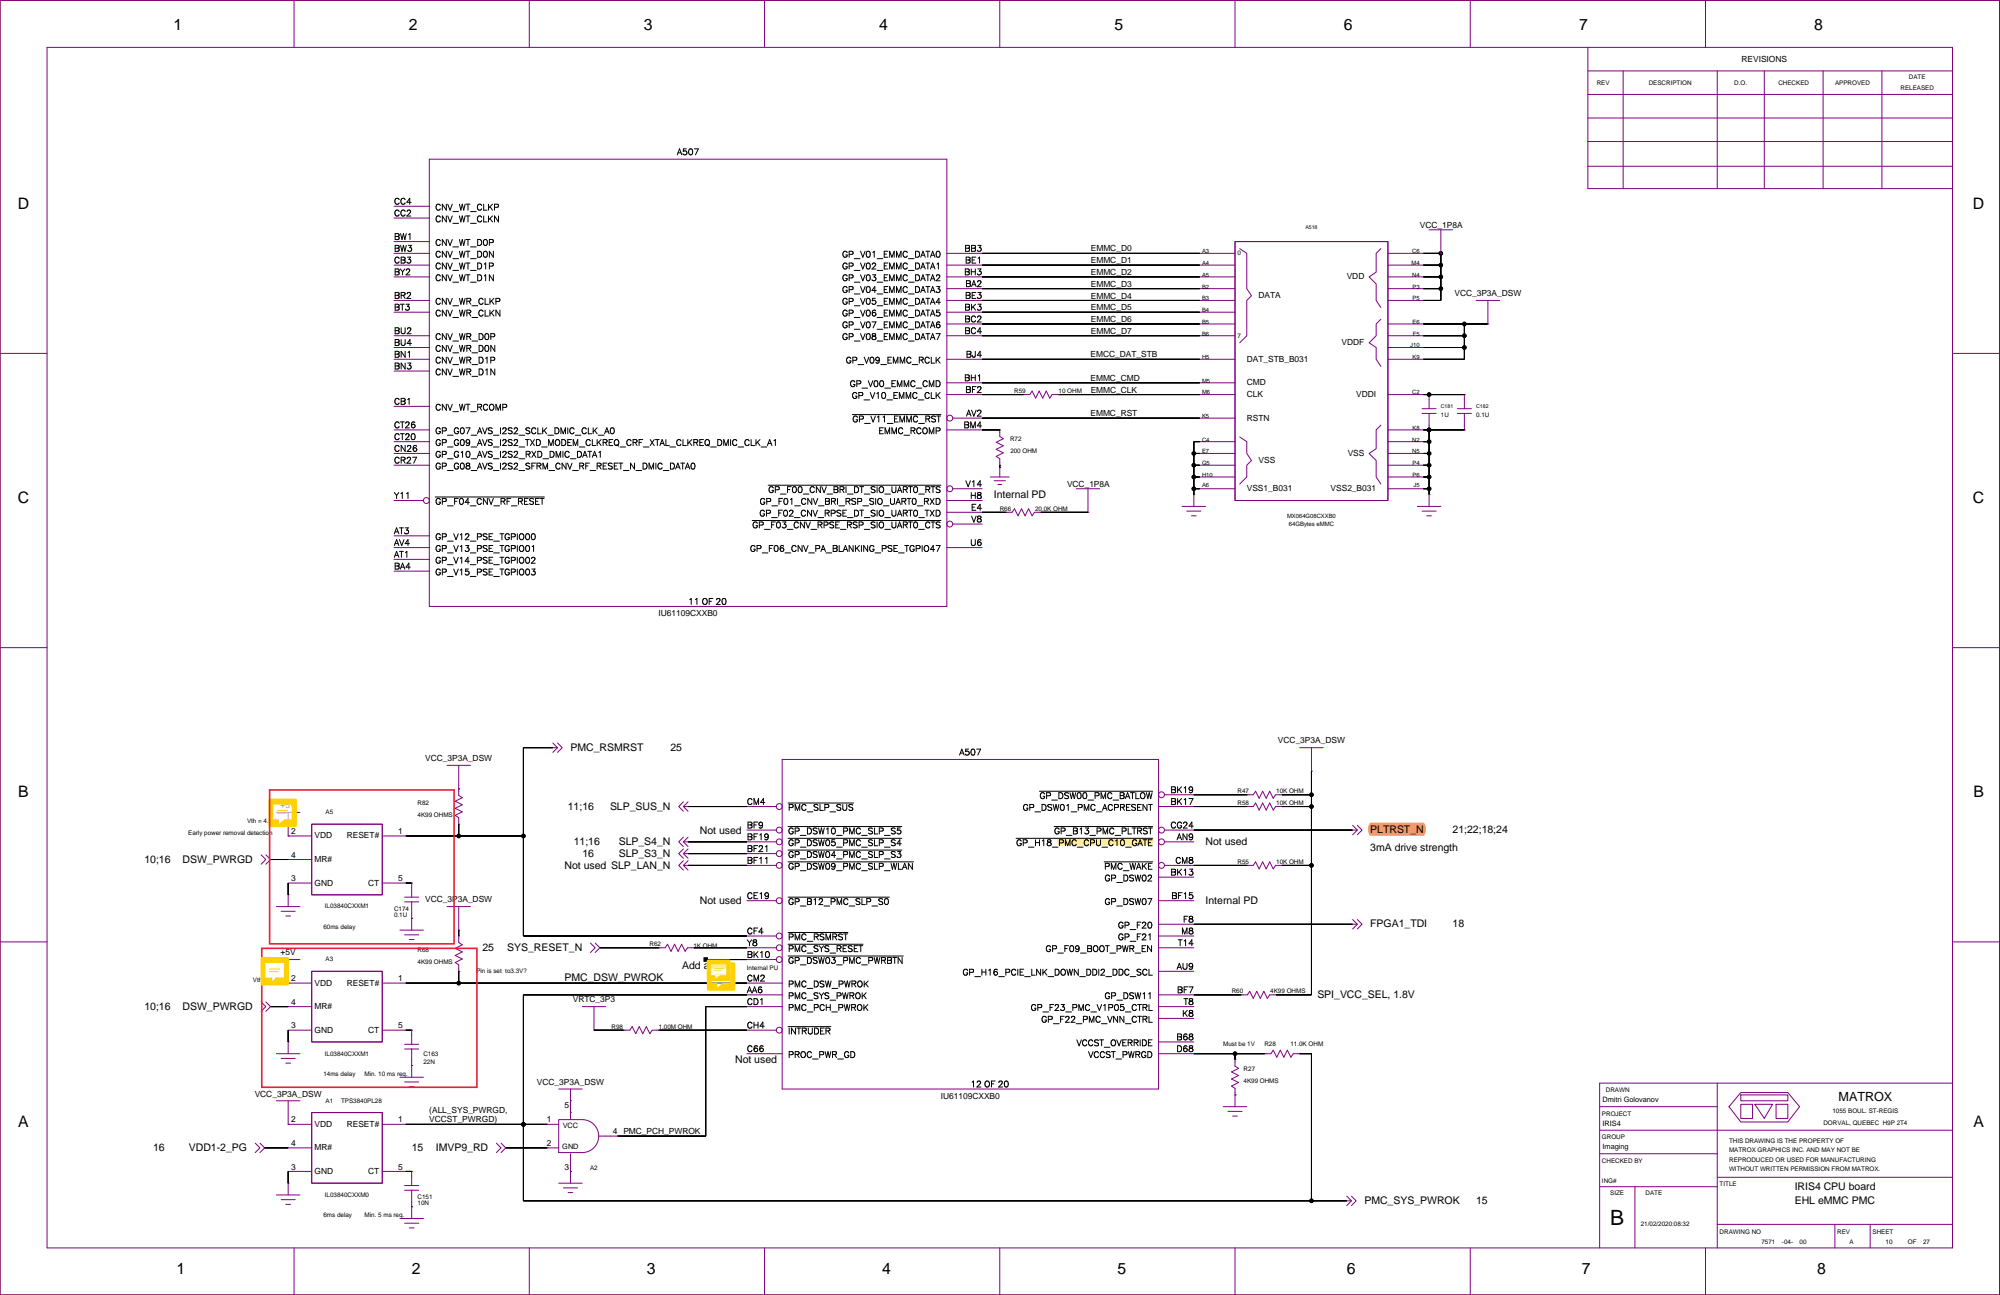
[picture p33: page 10]

Early power removal detection

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

VCCIN | VCCIN

D

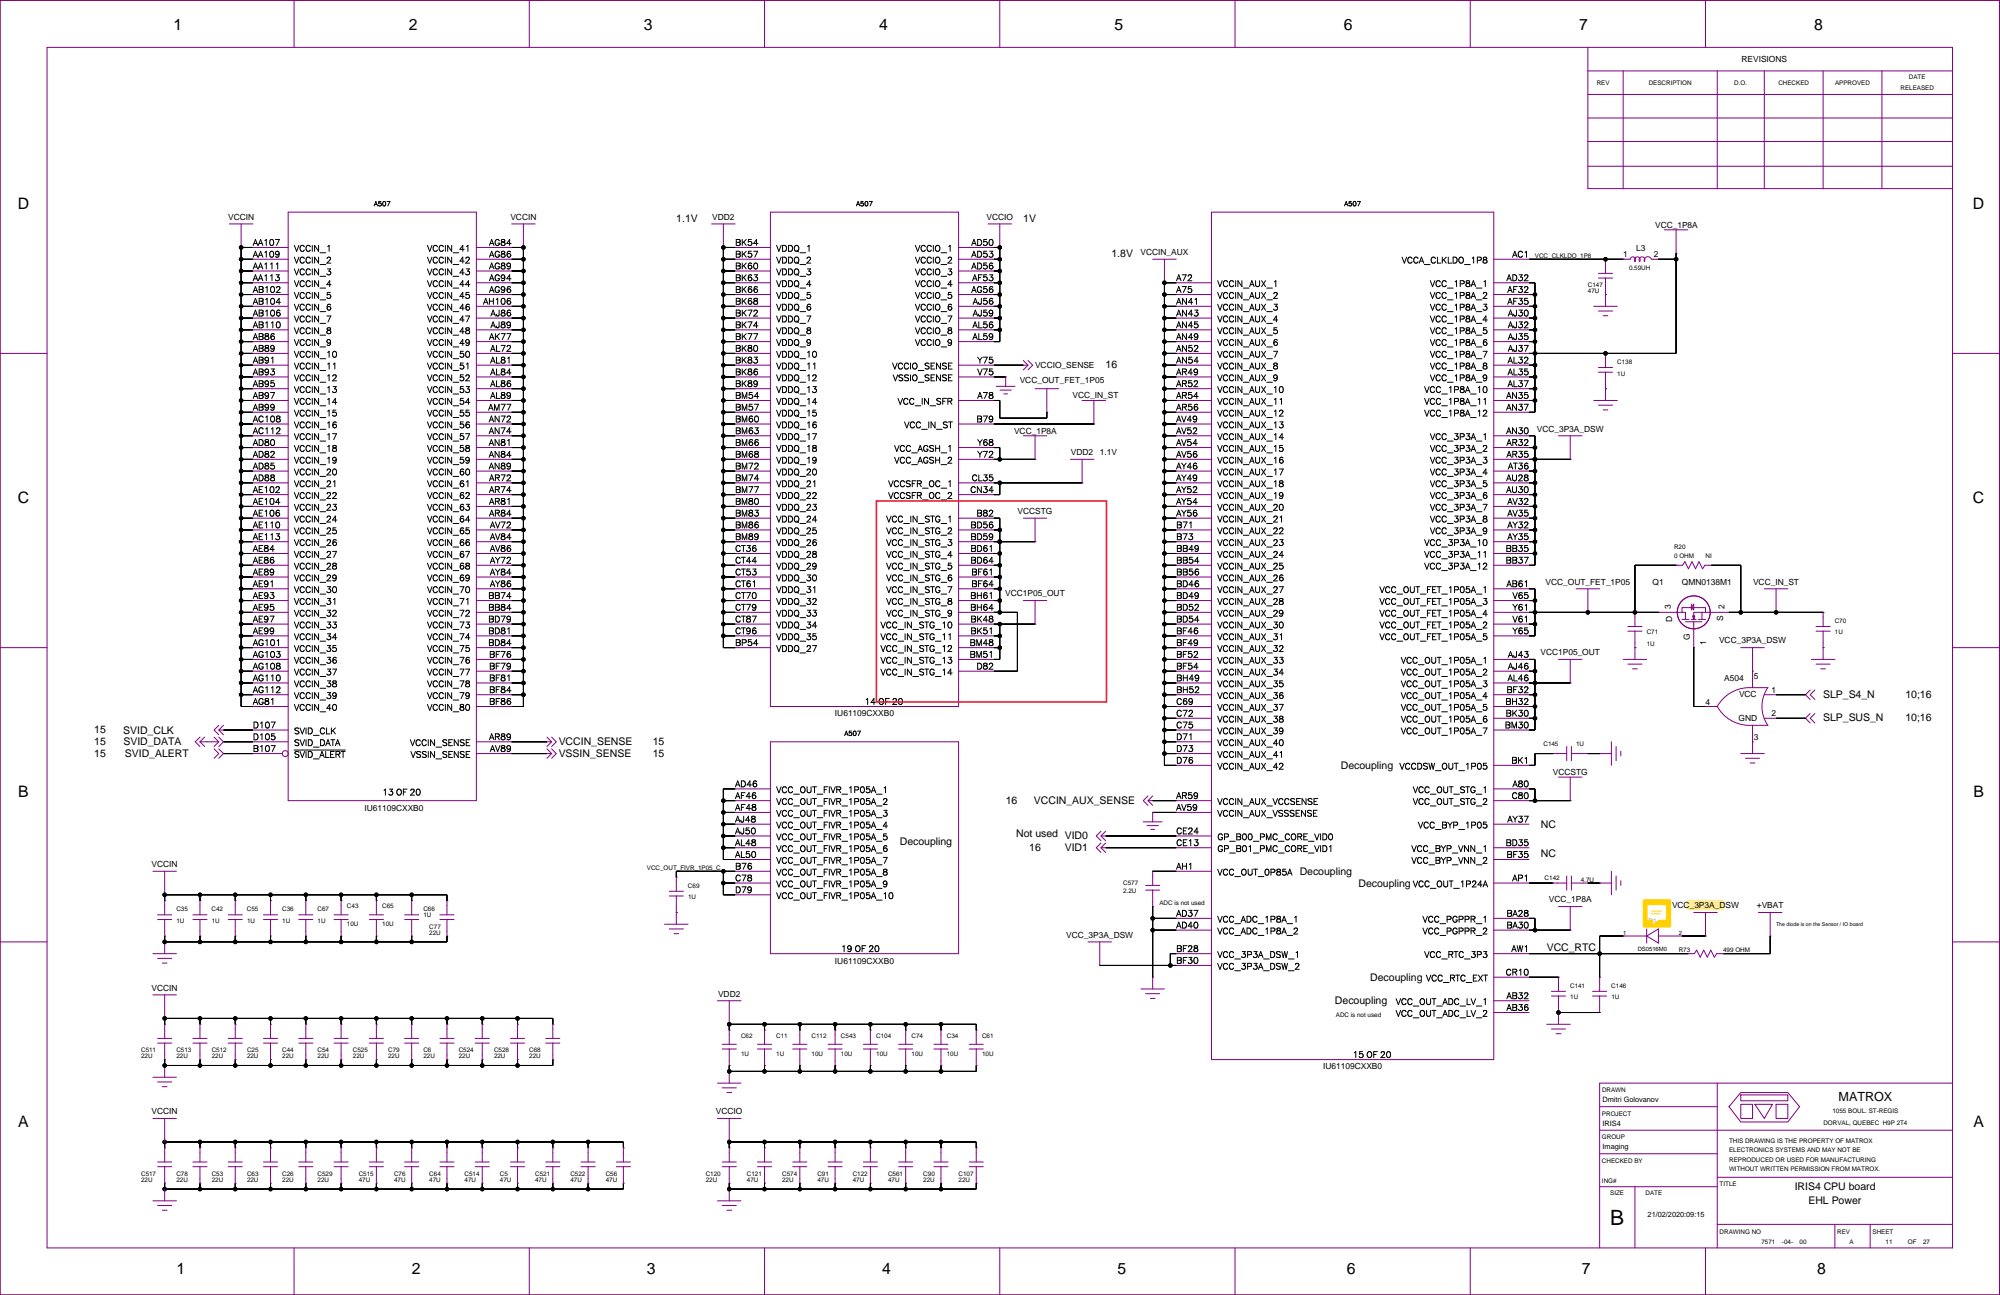
[picture p34: page 11]

The diode is on the Sensor / IO board

ADC is not used

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

# BCD

## ABCD

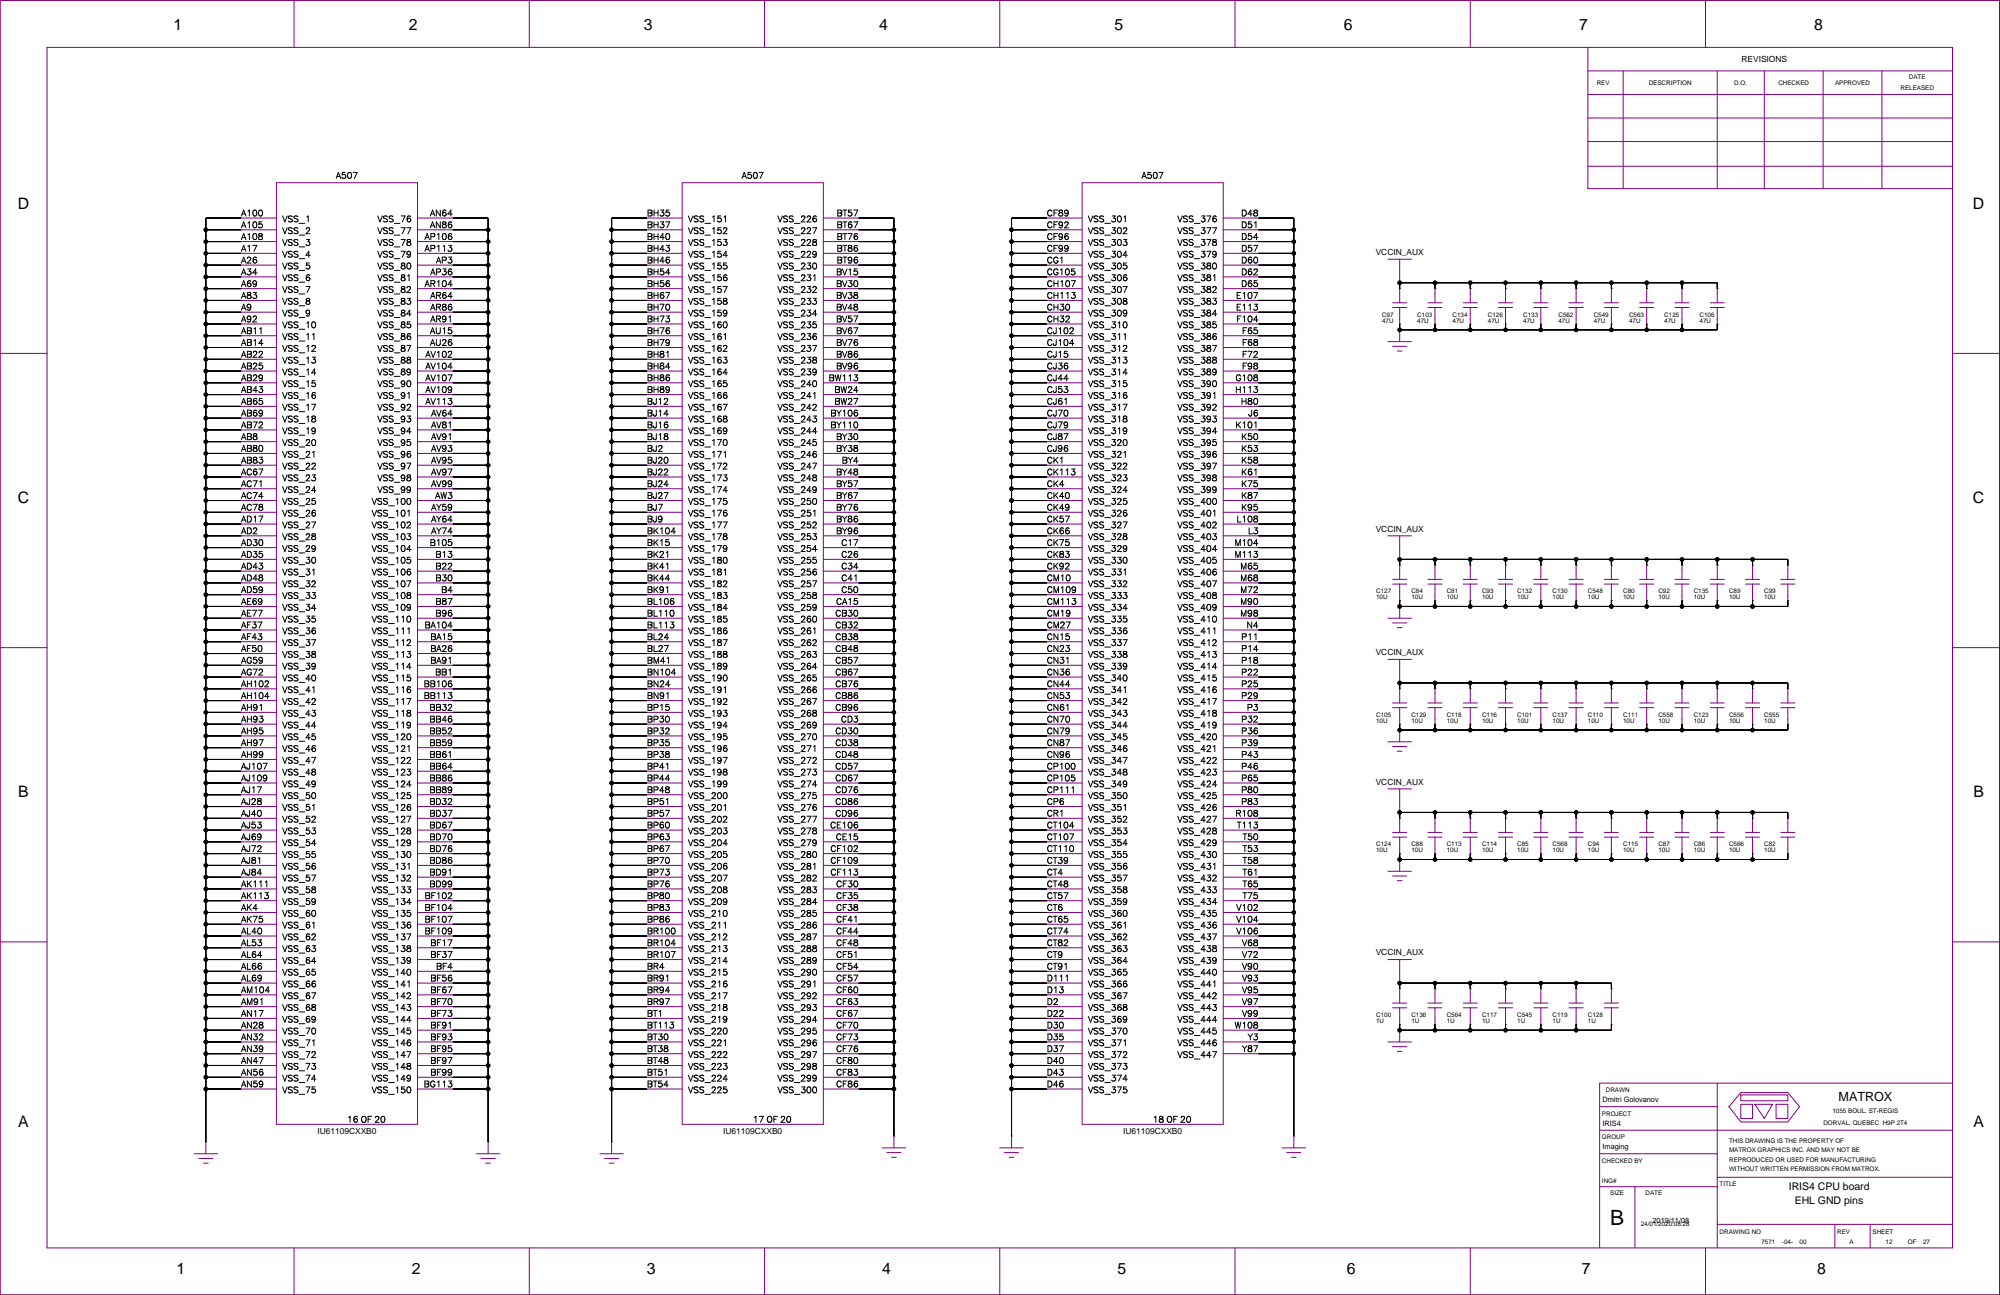
[picture p35: page 12]
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

# BCD

## ABCD

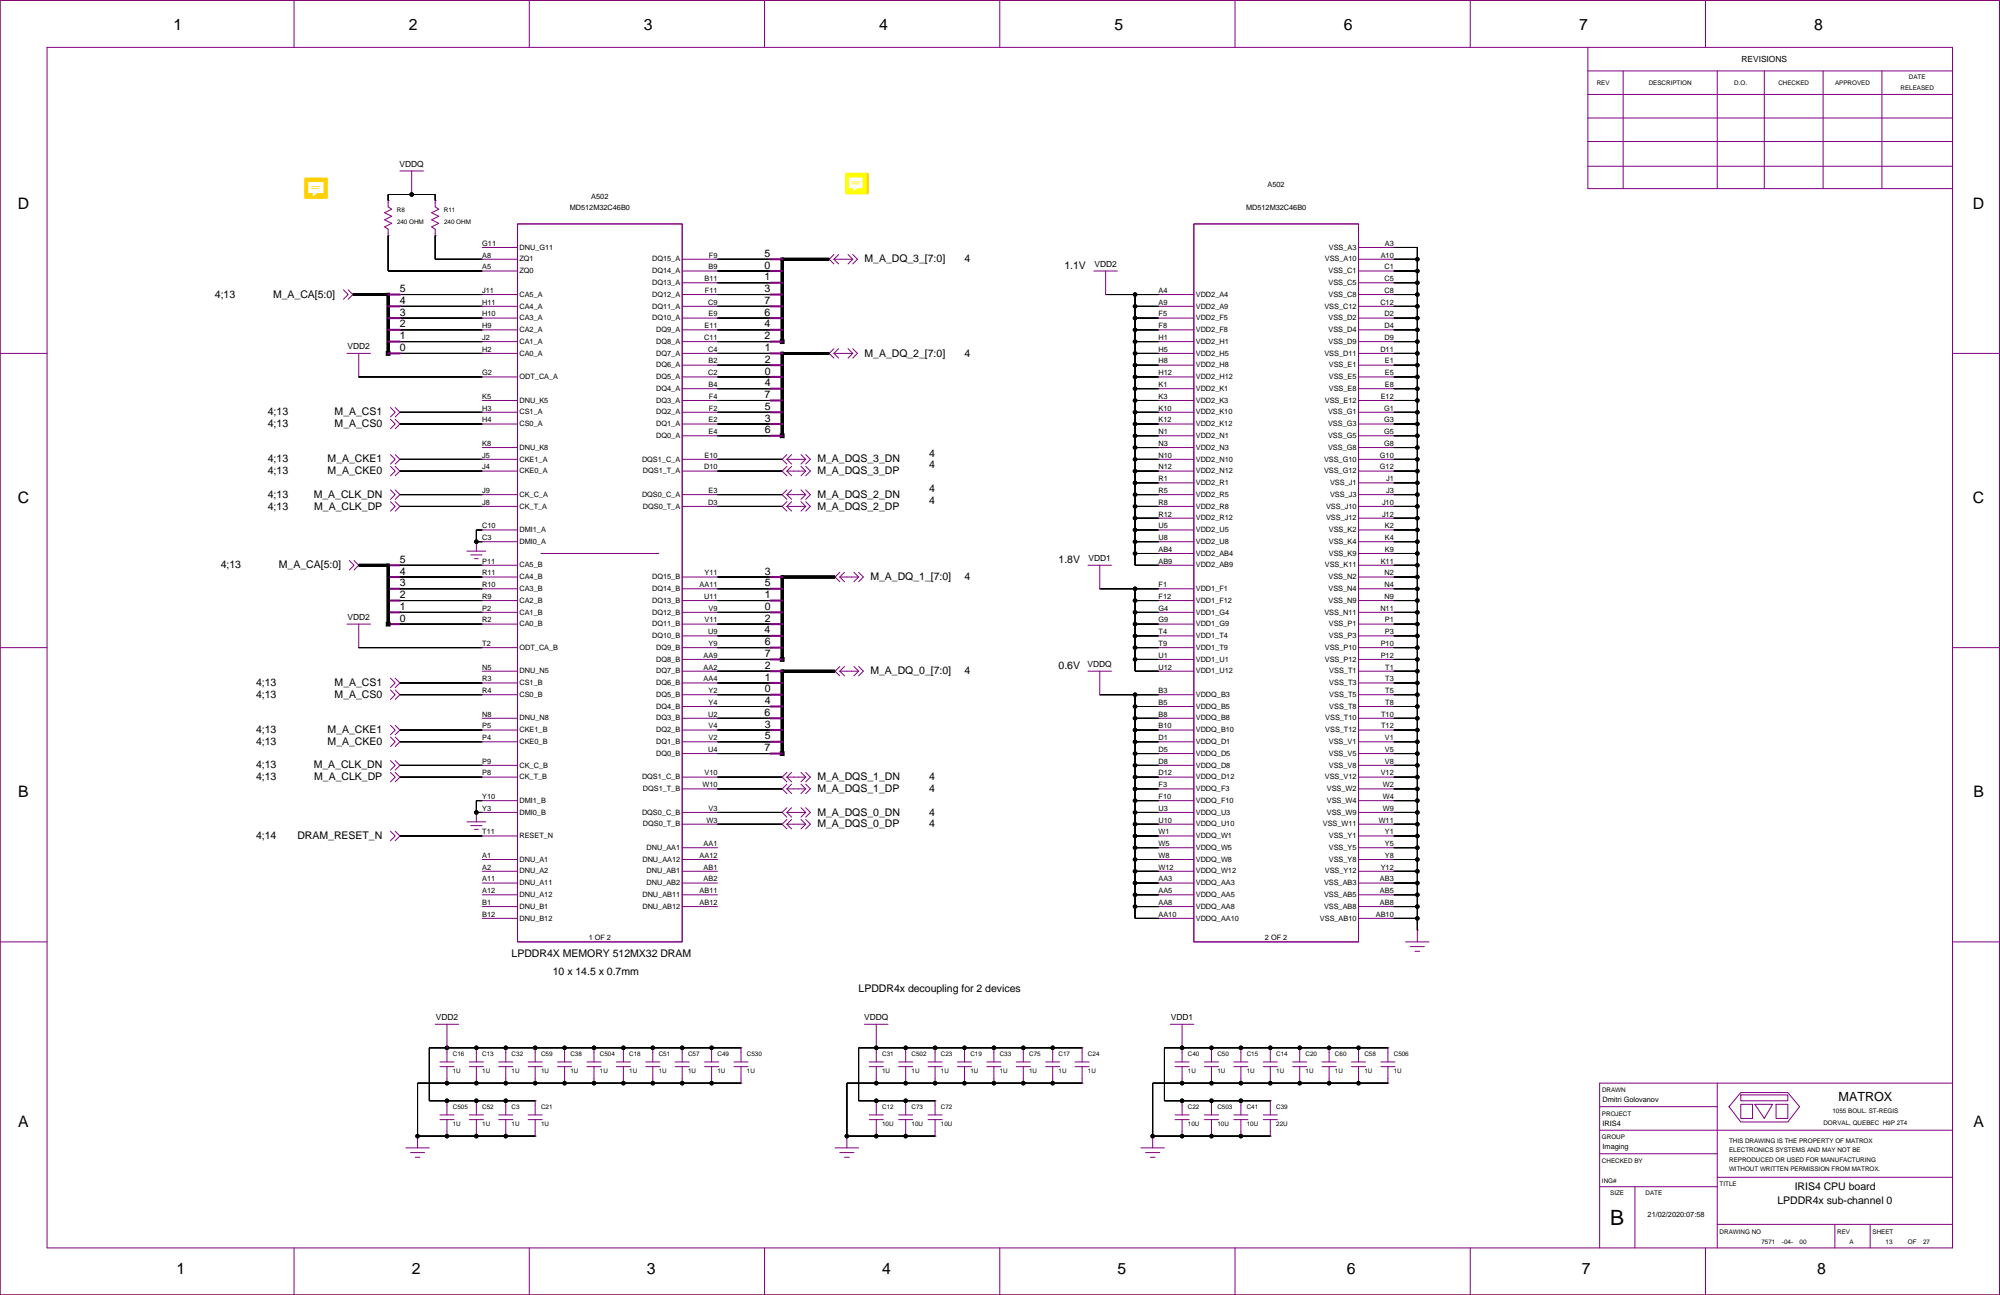
[picture p36: page 13]
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

# BCD

## ABCD

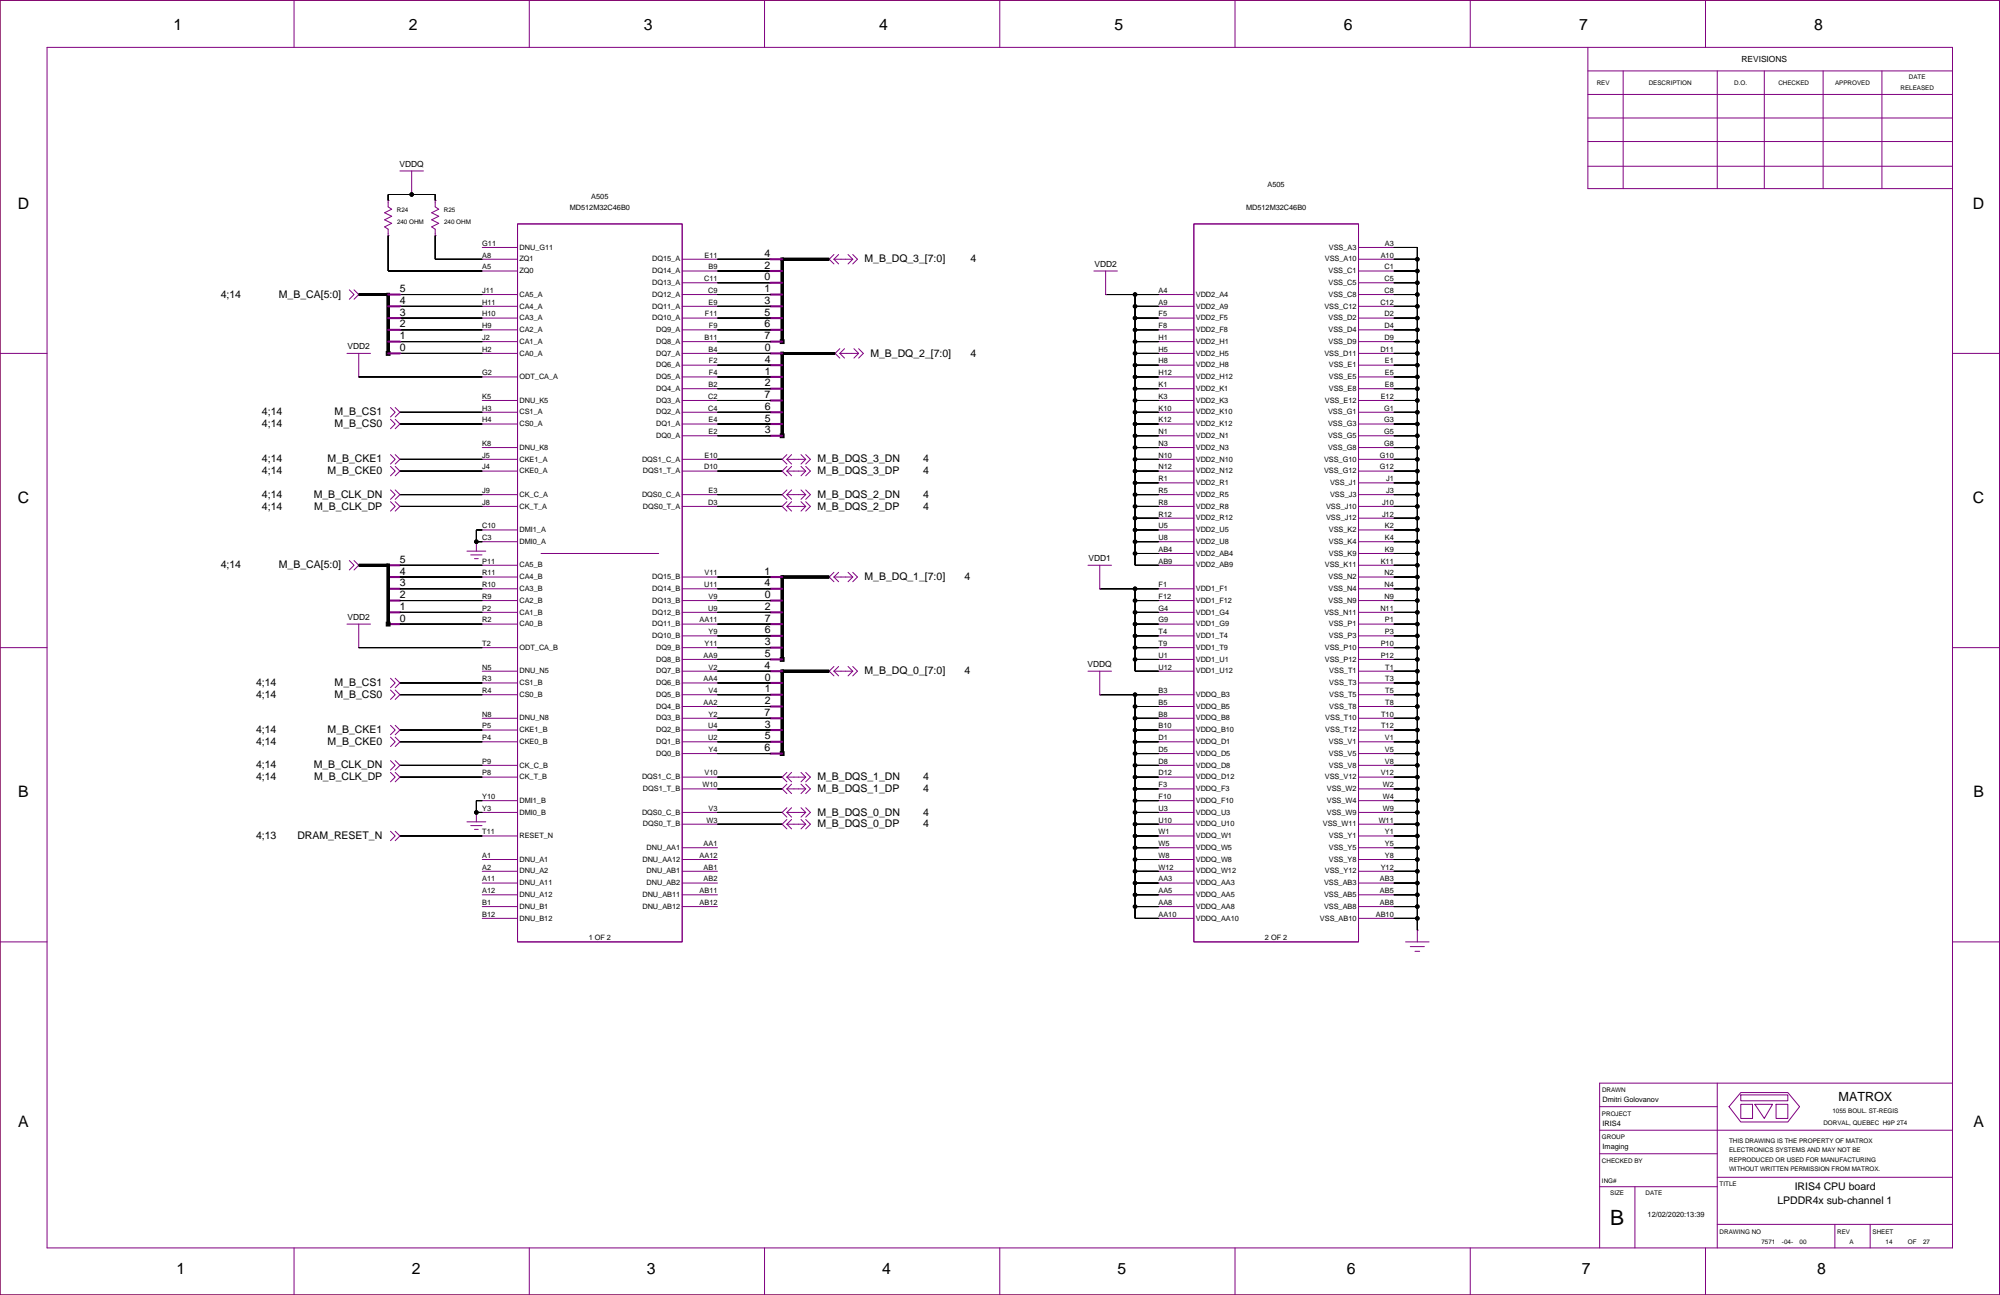
[picture p37: page 14]
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

D

D

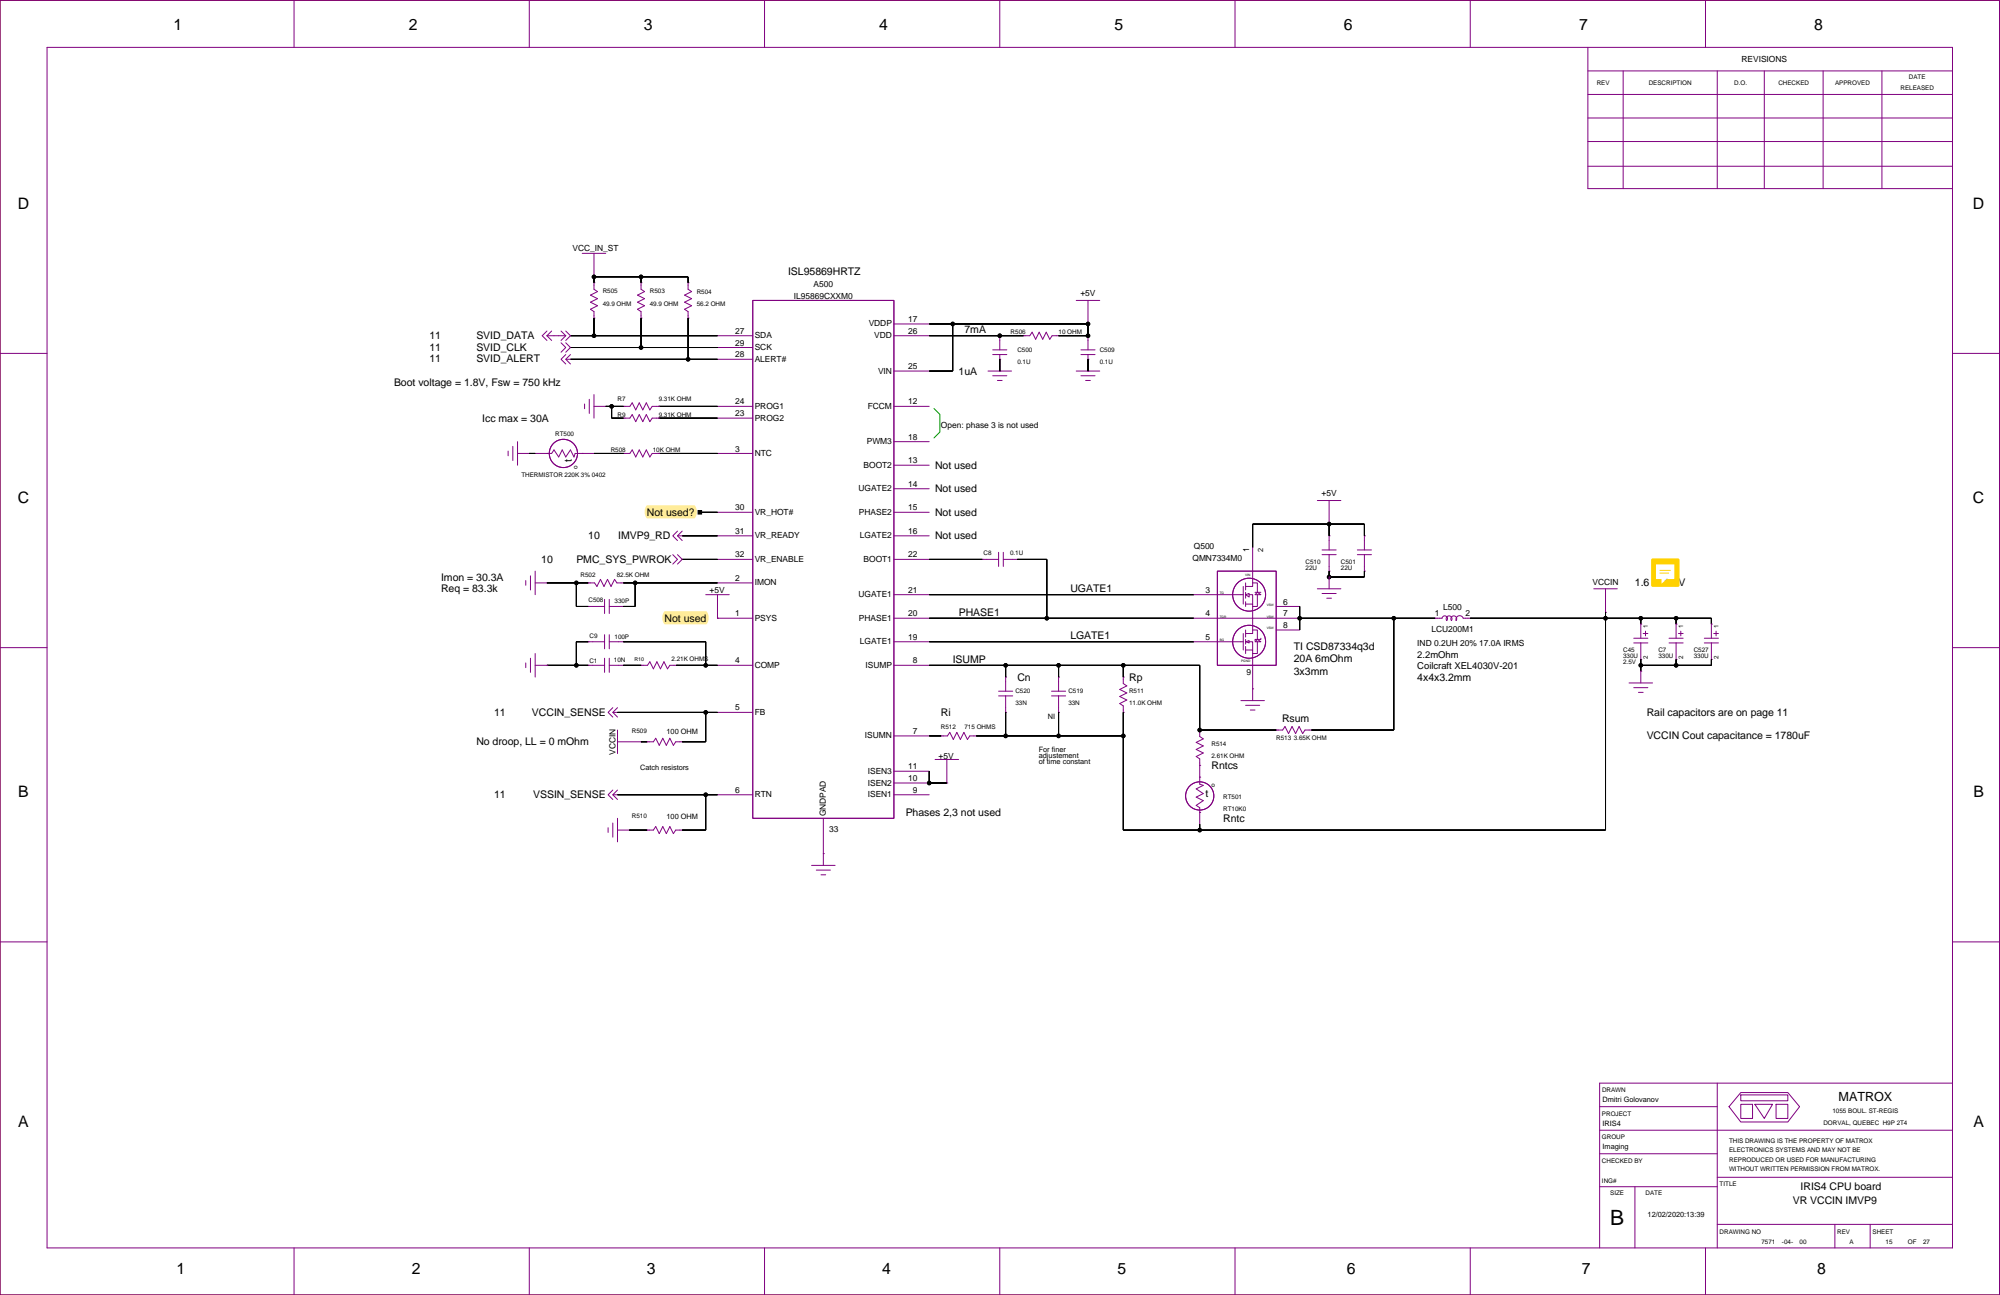
[picture p38: page 15]

Boot voltage = 1.8V, Fsw = 750 kHz

Open: phase 3 is not used

Rail capacitors are on page 11

No droop, LL = 0 mOhm

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

D

D

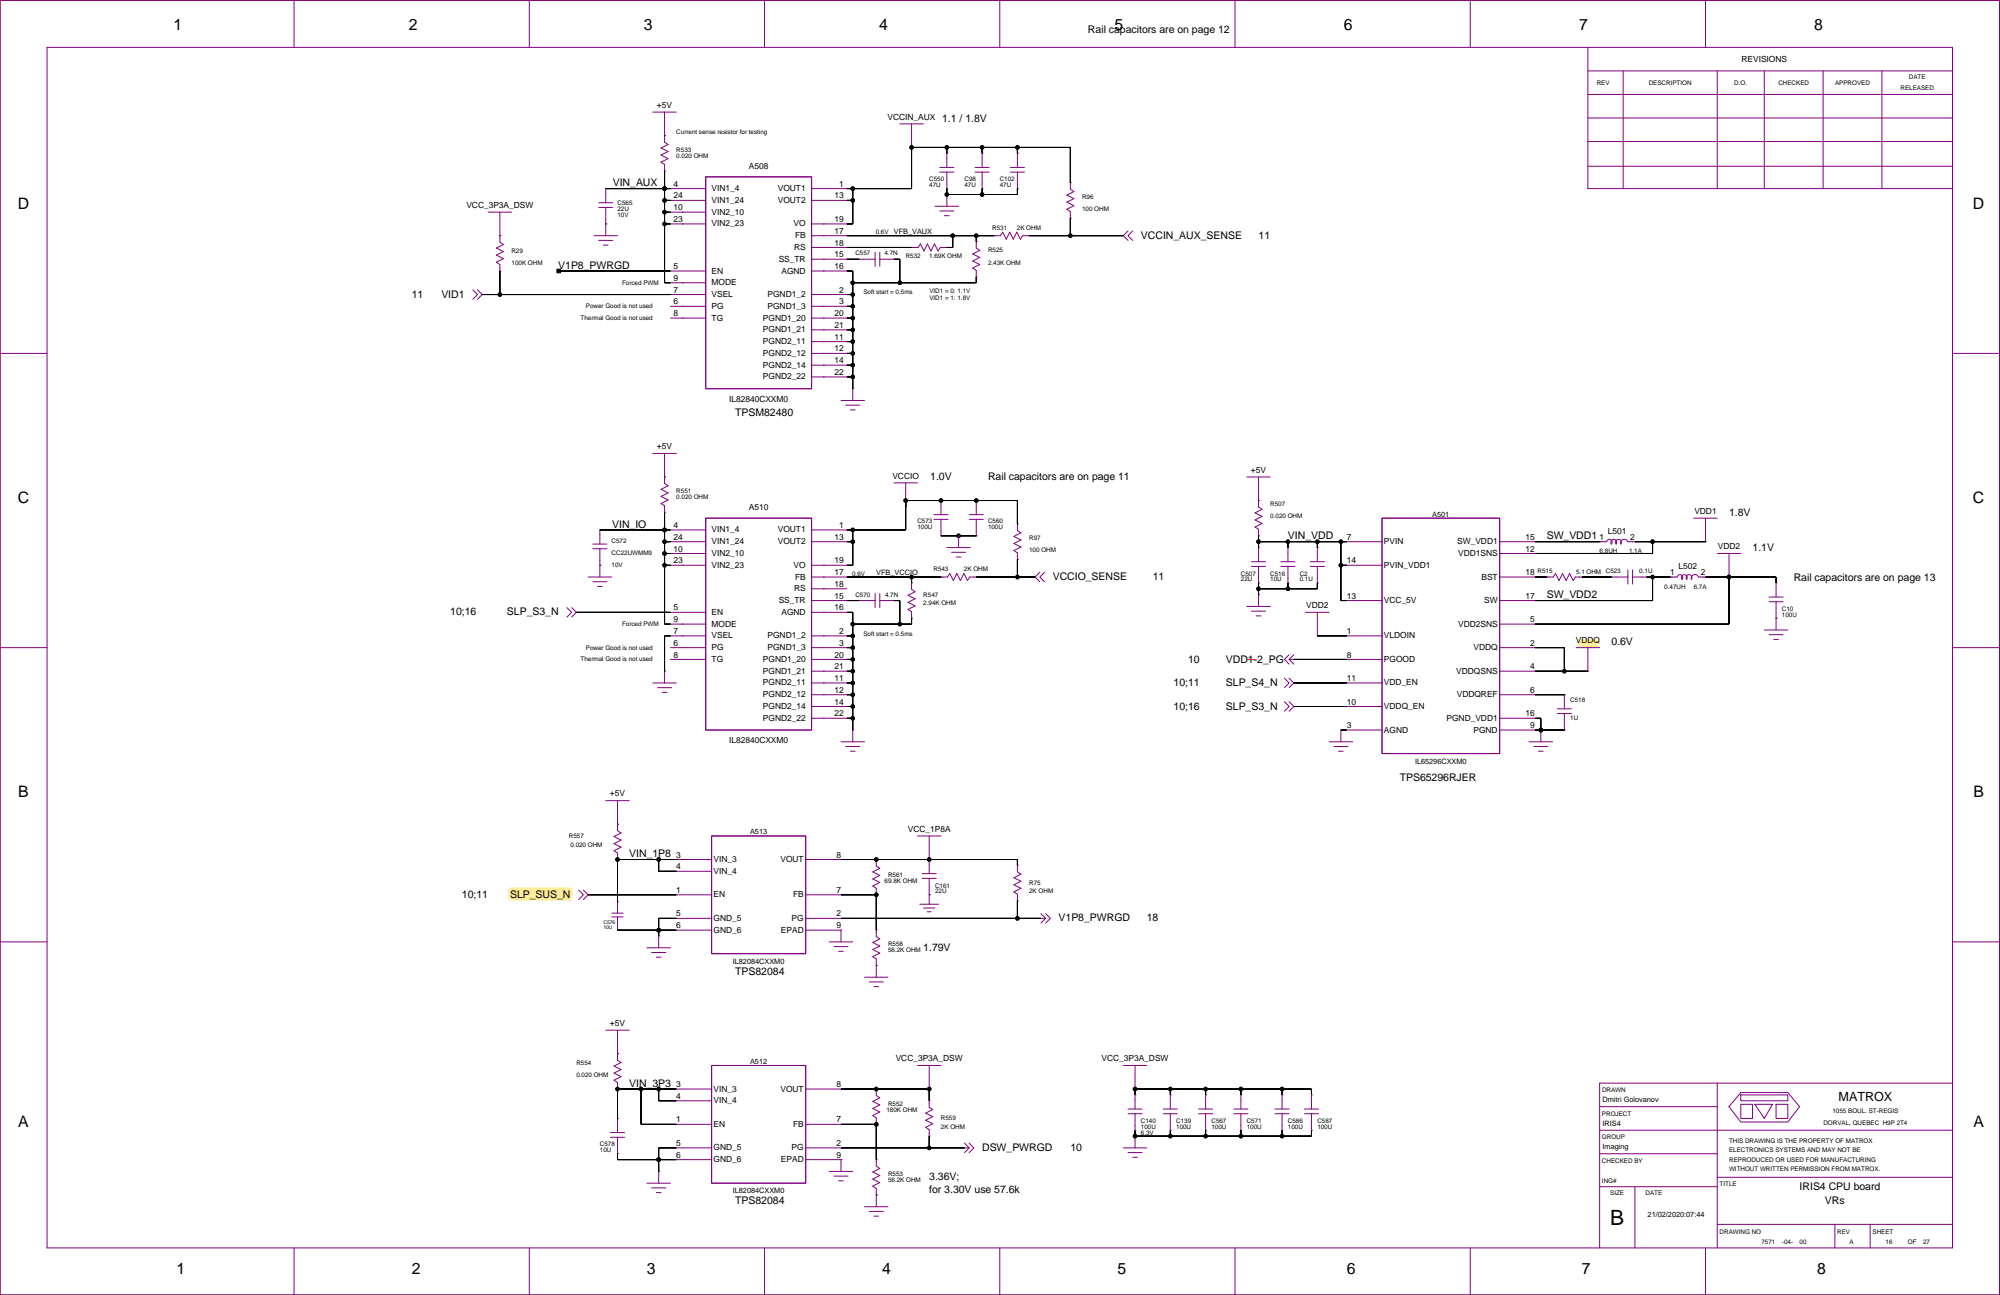
[picture p39: page 16]

Rail capacitors are on page 12

Current sense resistor for testing

Power Good is not used
Thermal Good is not used

Rail capacitors are on page 11

Rail capacitors are on page 13

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

## From FPGA USER LED

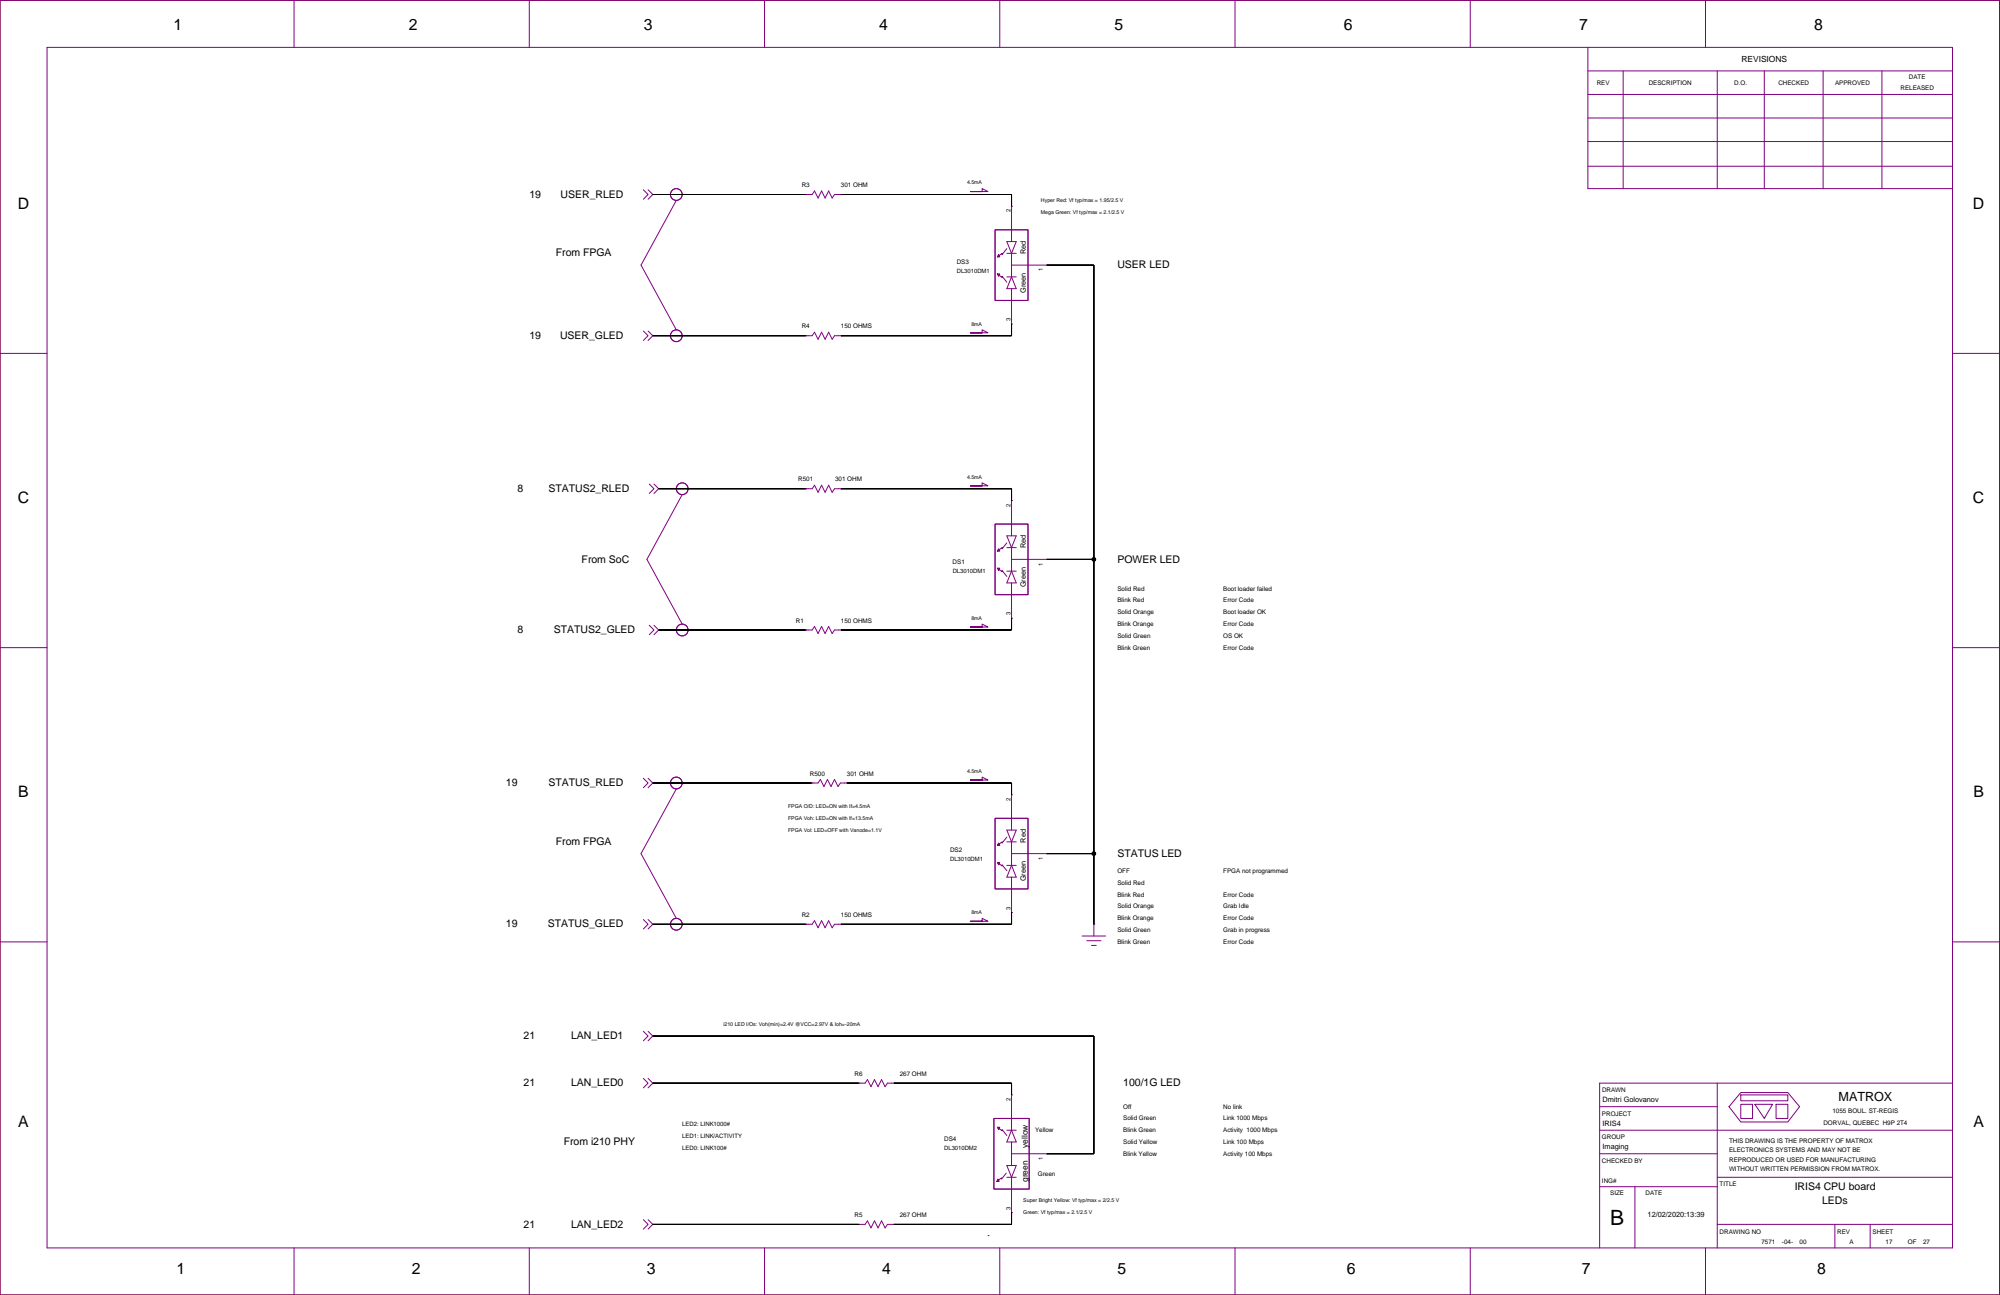
[picture p40: page 17]

Hyper Red: Vf typ/max = 1.95/2.5 V

Mega Green: Vf typ/max = 2.1/2.5 V

yellow green Green Red

Green Red

FPGA O/D: LED=ON with If=4.5mA

FPGA Voh: LED=ON with If=13.5mA

FPGA Vol: LED=OFF with Vanode=1.1V

i210 LED I/Os: Voh(min)=2.4V @VCC=2.97V & Ioh=-20mA

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

Super Bright Yellow: Vf typ/max = 2/2.5 V

Green: Vf typ/max = 2.1/2.5 V

D

D

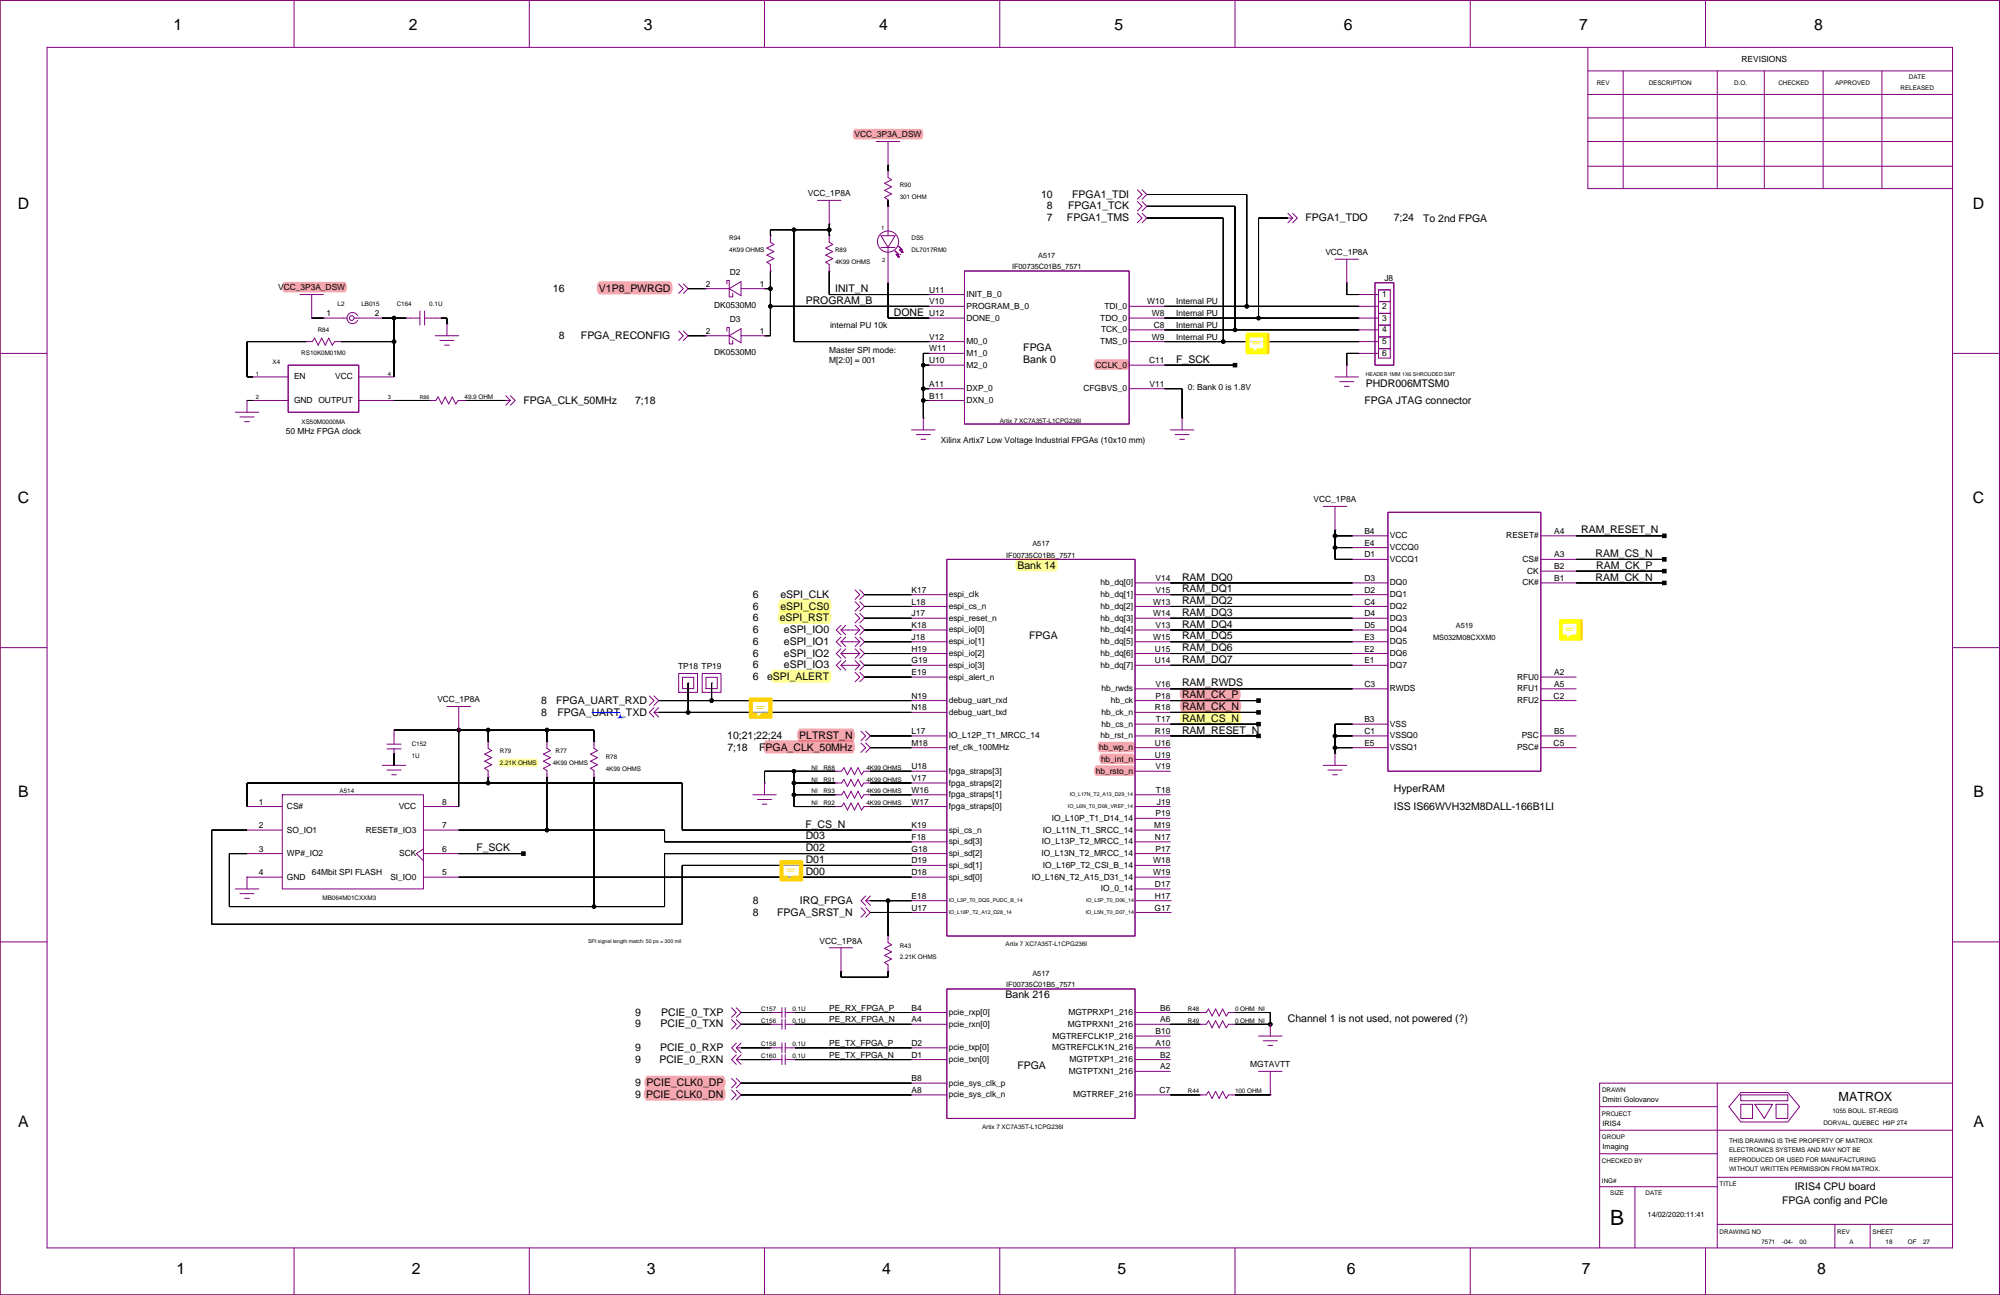
[picture p41: page 18]

Xilinx Artix7 Low Voltage Industrial FPGAs (10x10 mm)

SPI signal length match: 50 ps = 300 mil

Channel 1 is not used, not powered (?)

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

FPGA config and PCIe

D

D

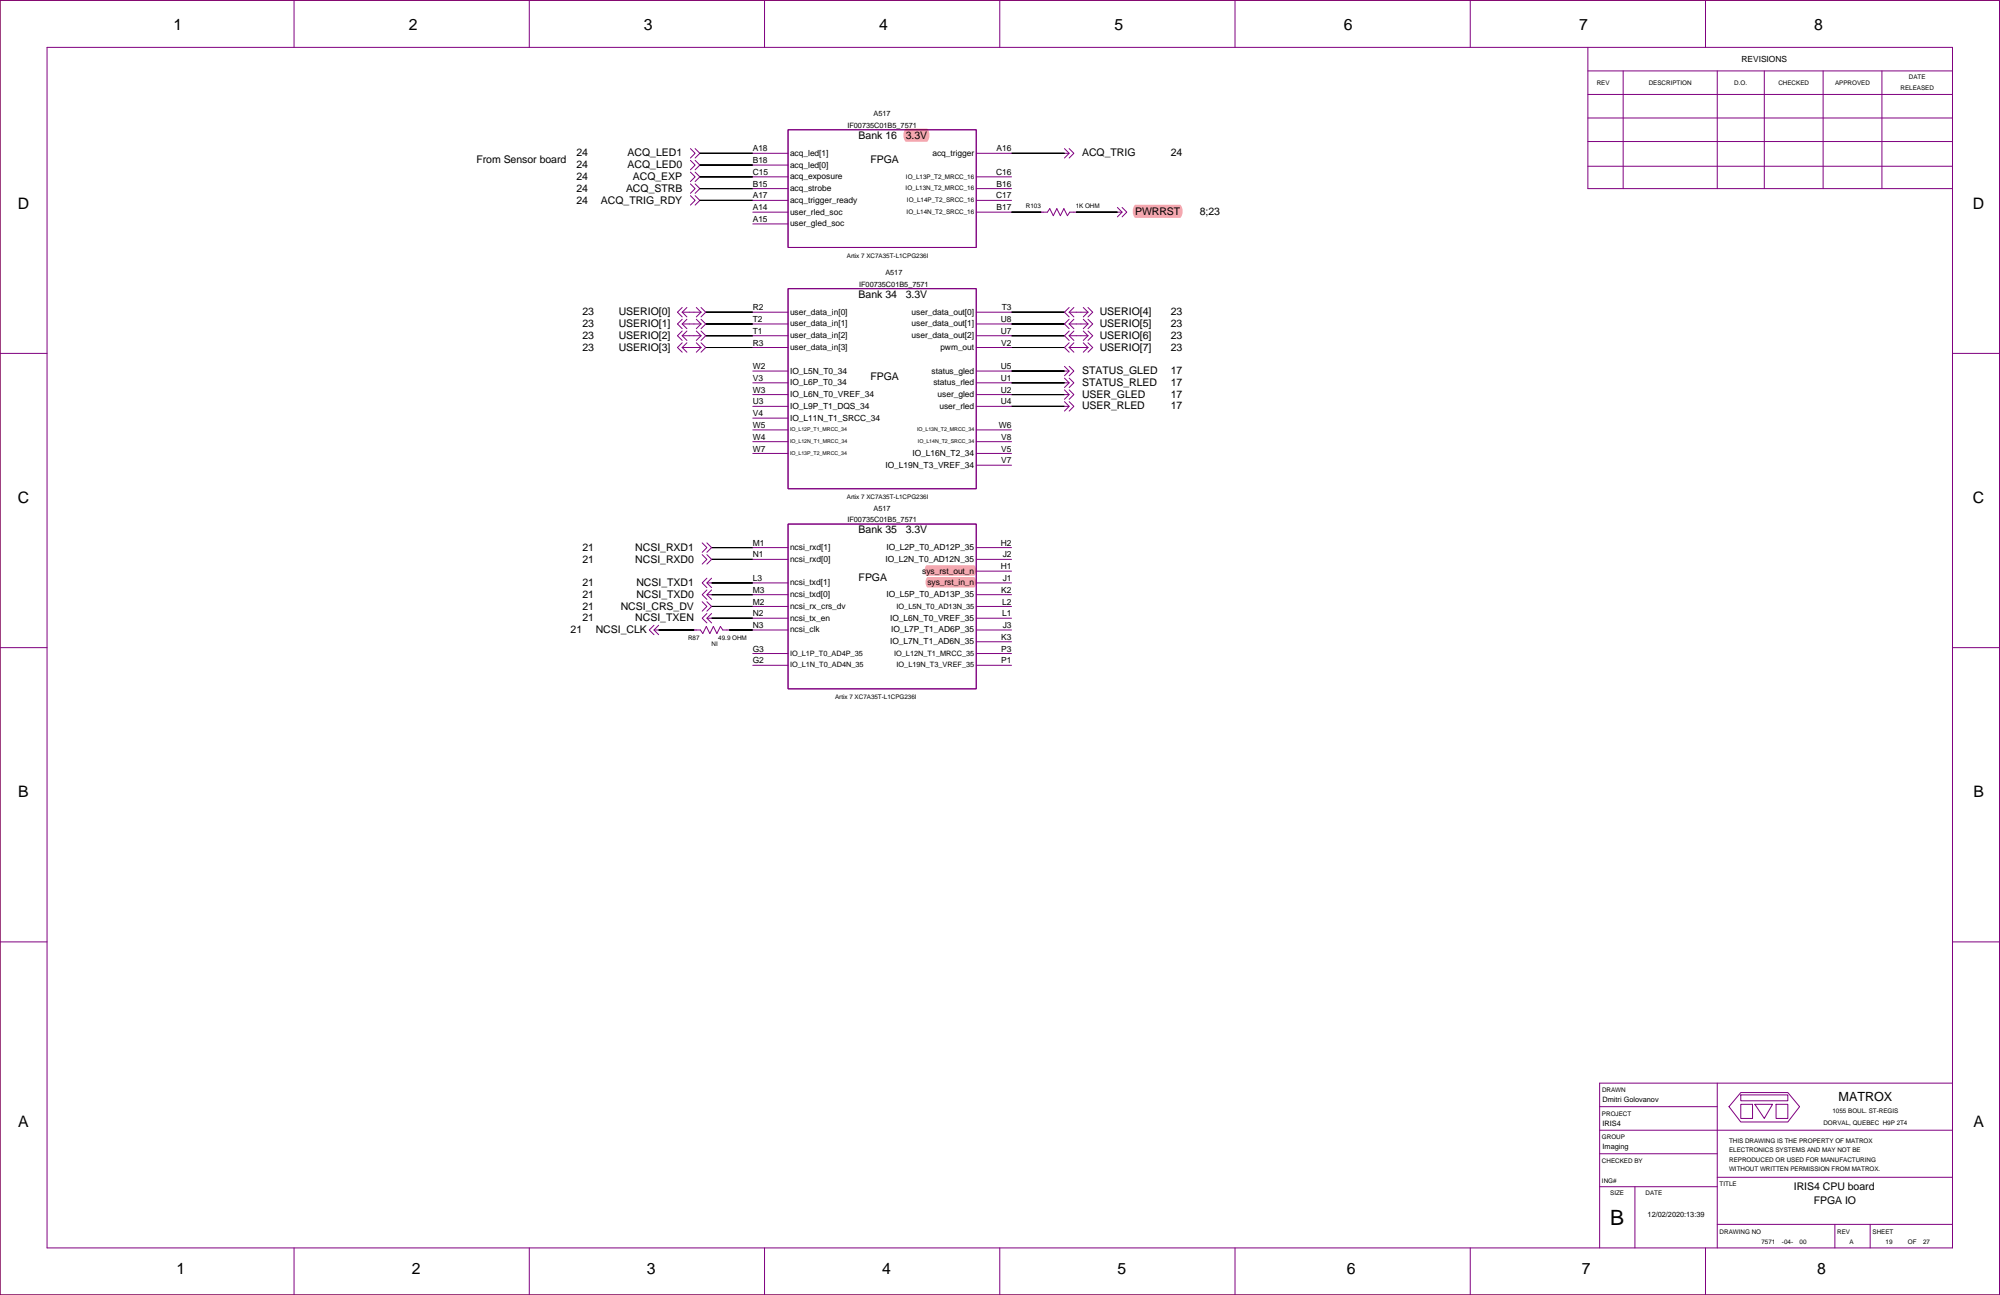
[picture p42: page 19]
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

# BCD

## ABCD

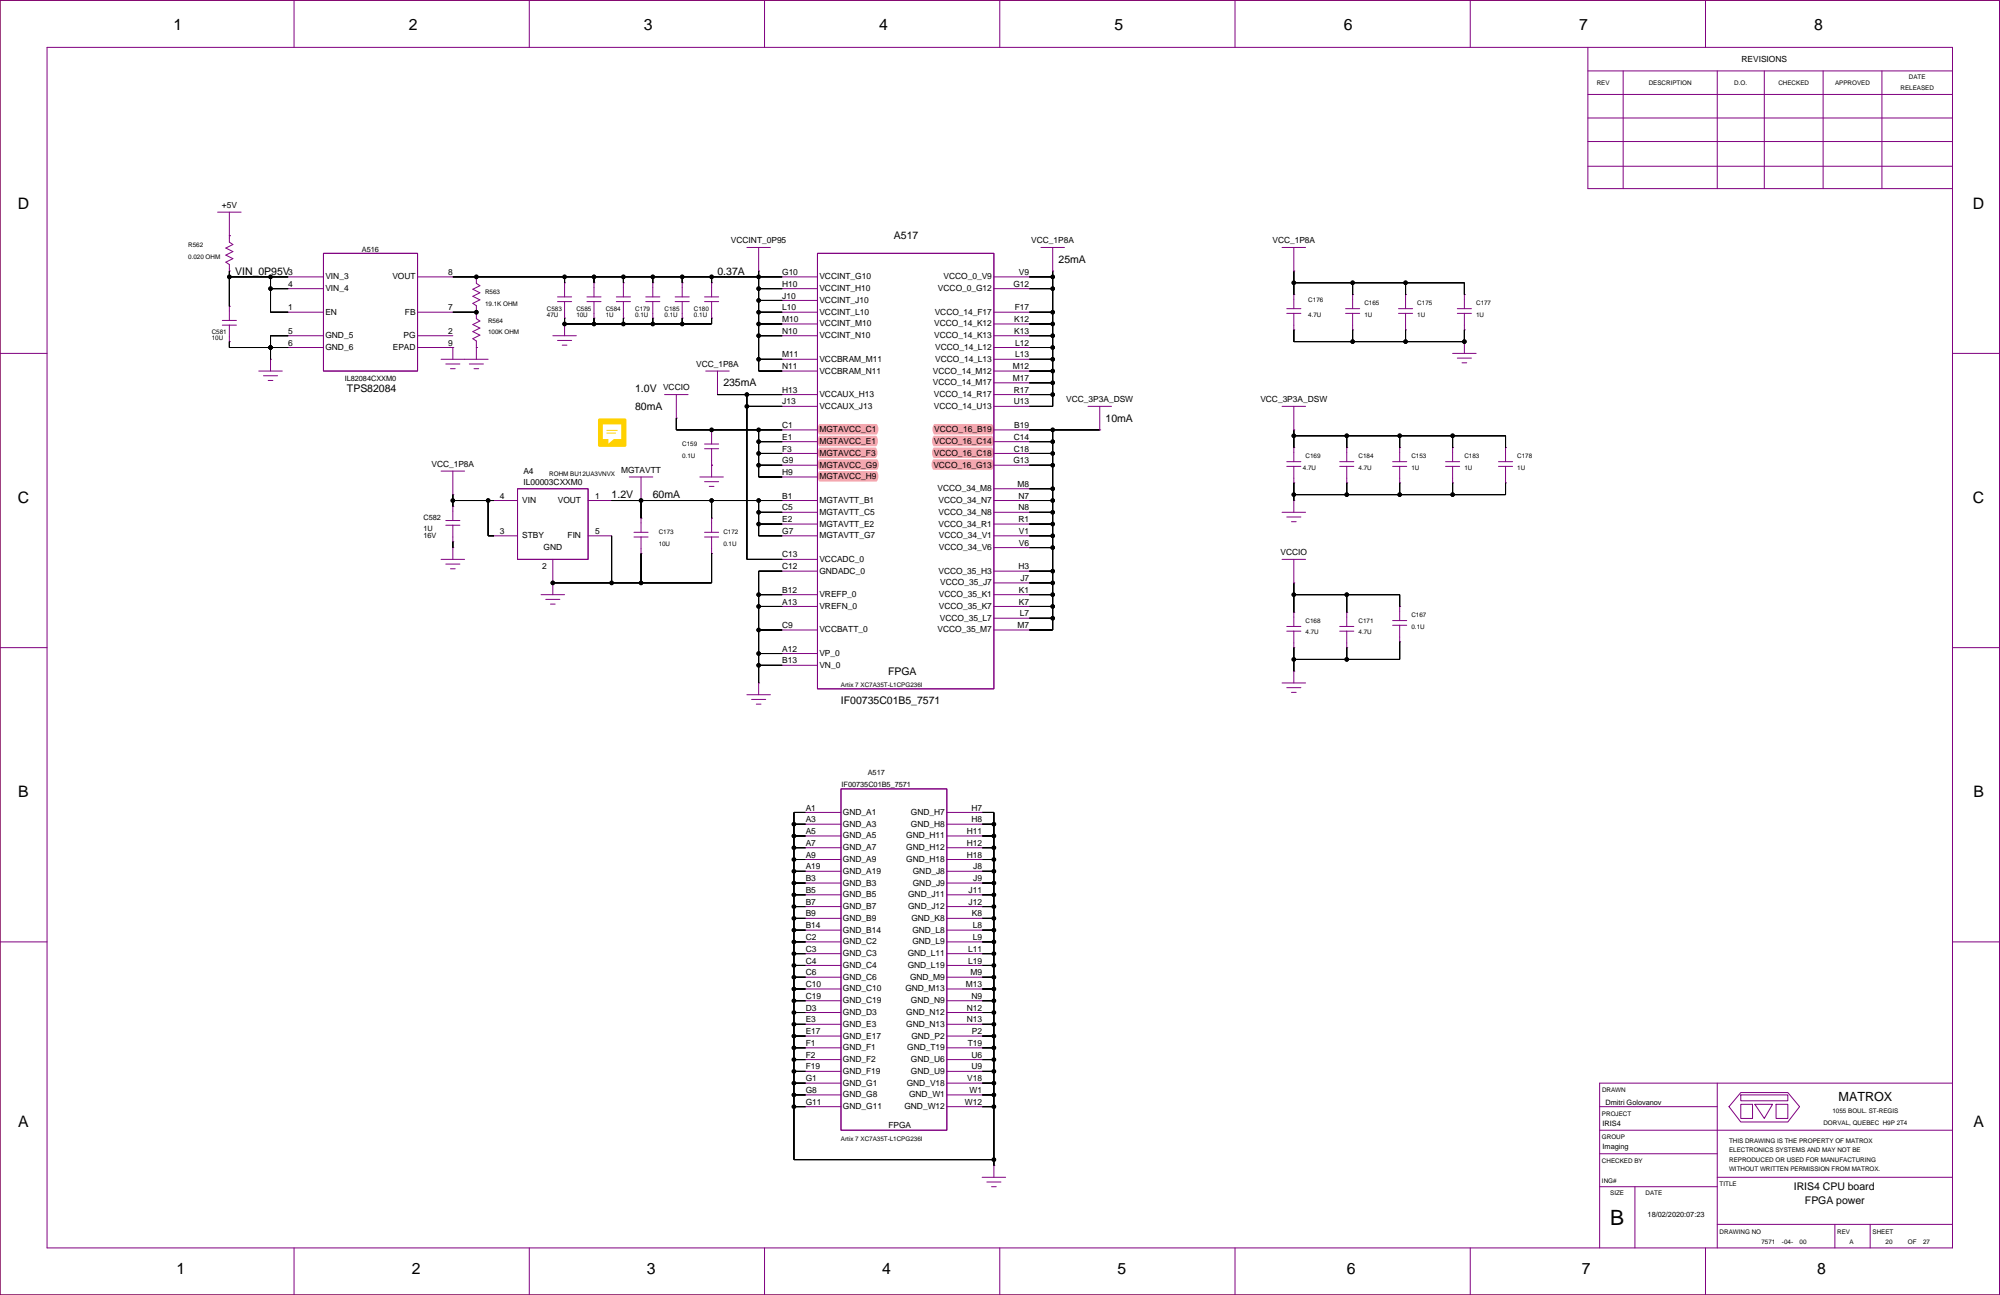
[picture p43: page 20]
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

D

D

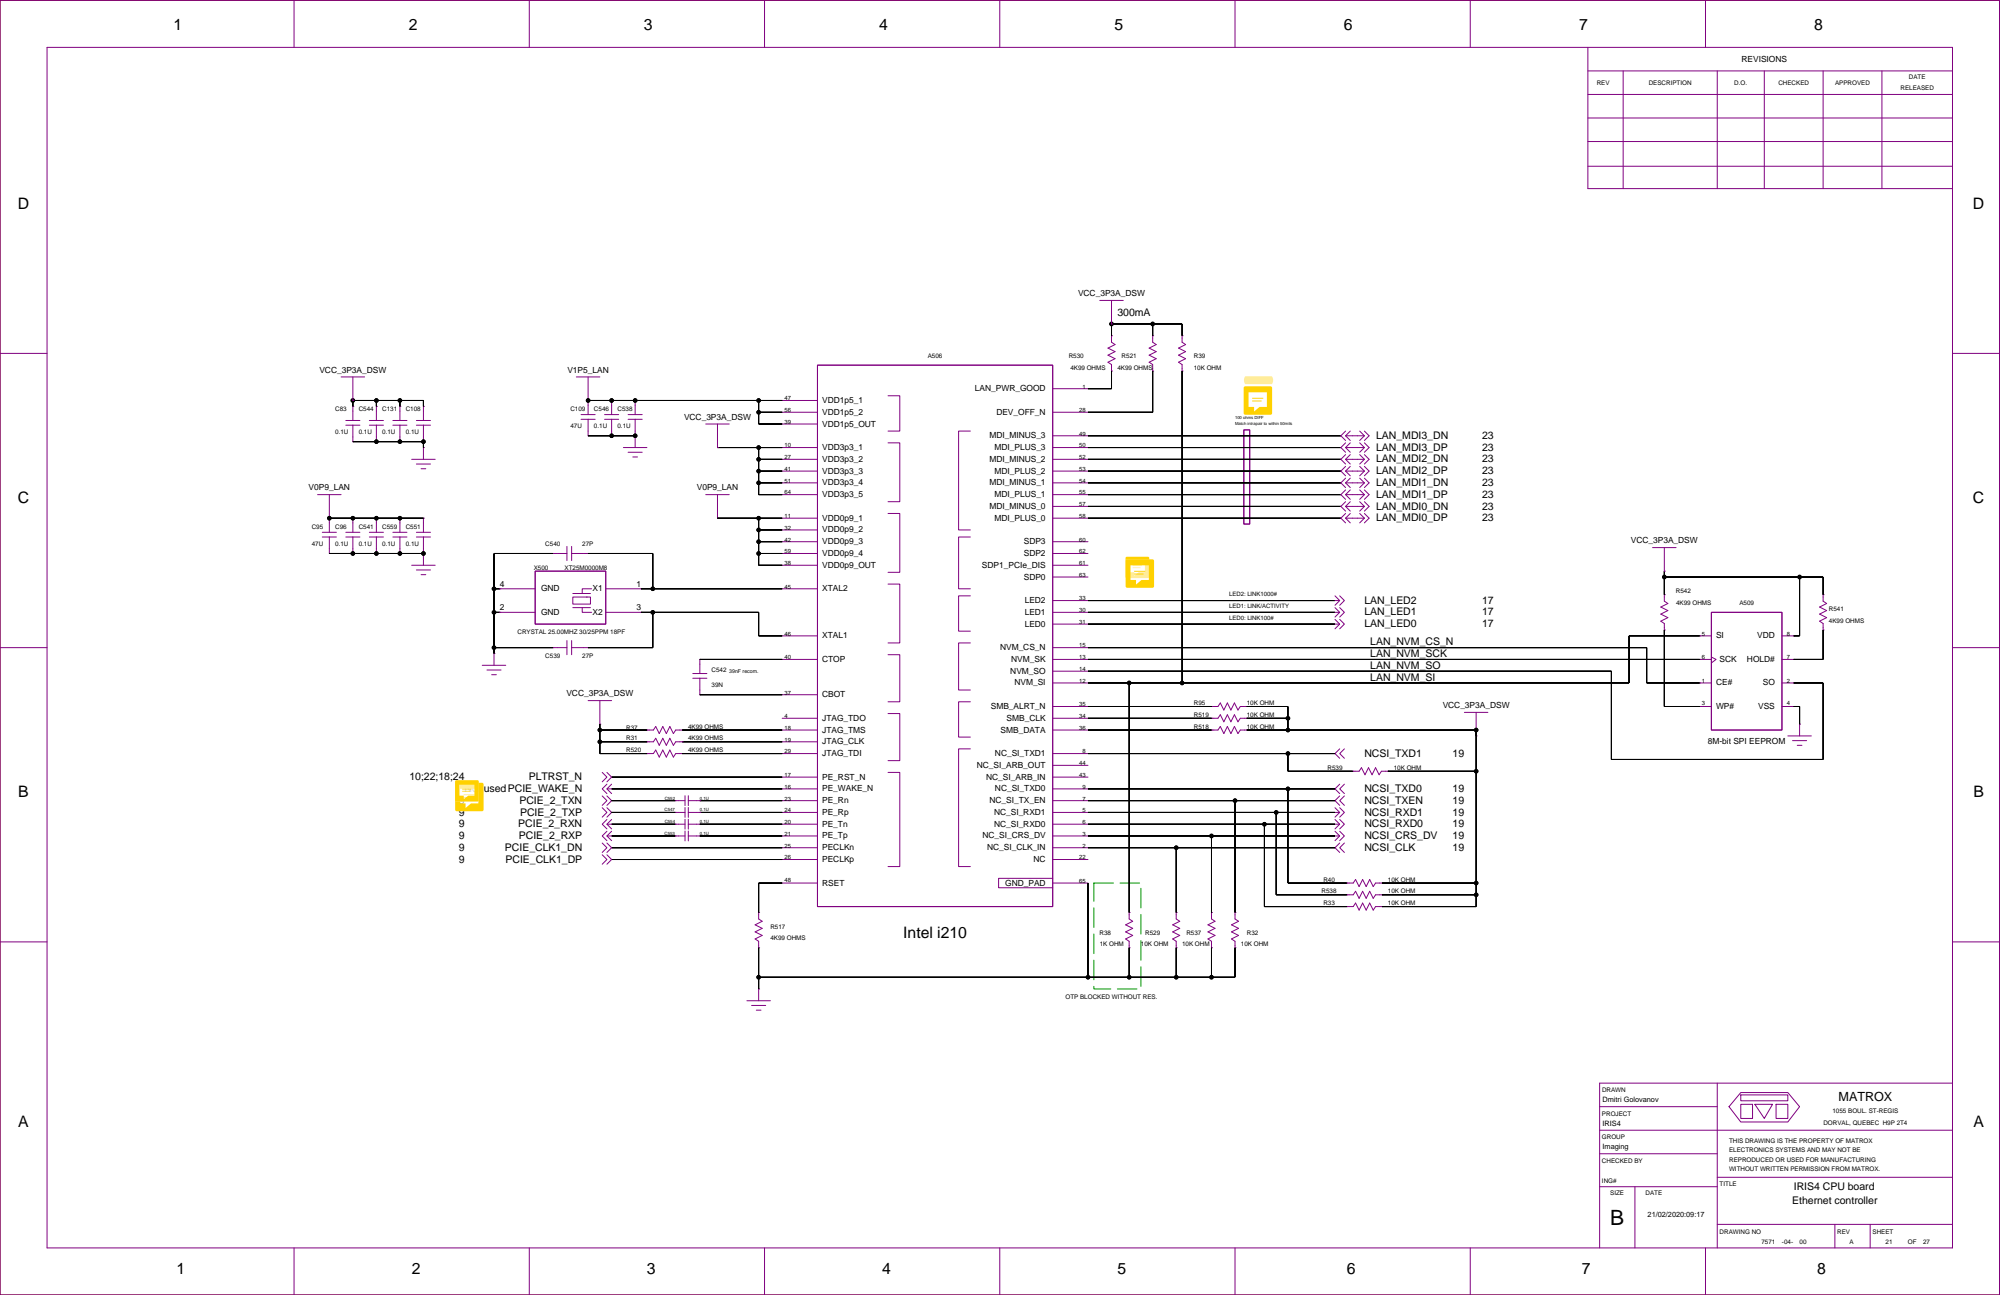
[picture p44: page 21]

100 ohms DIFF
Match intrapair to within 50mils

OTP BLOCKED WITHOUT RES.

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

D

D

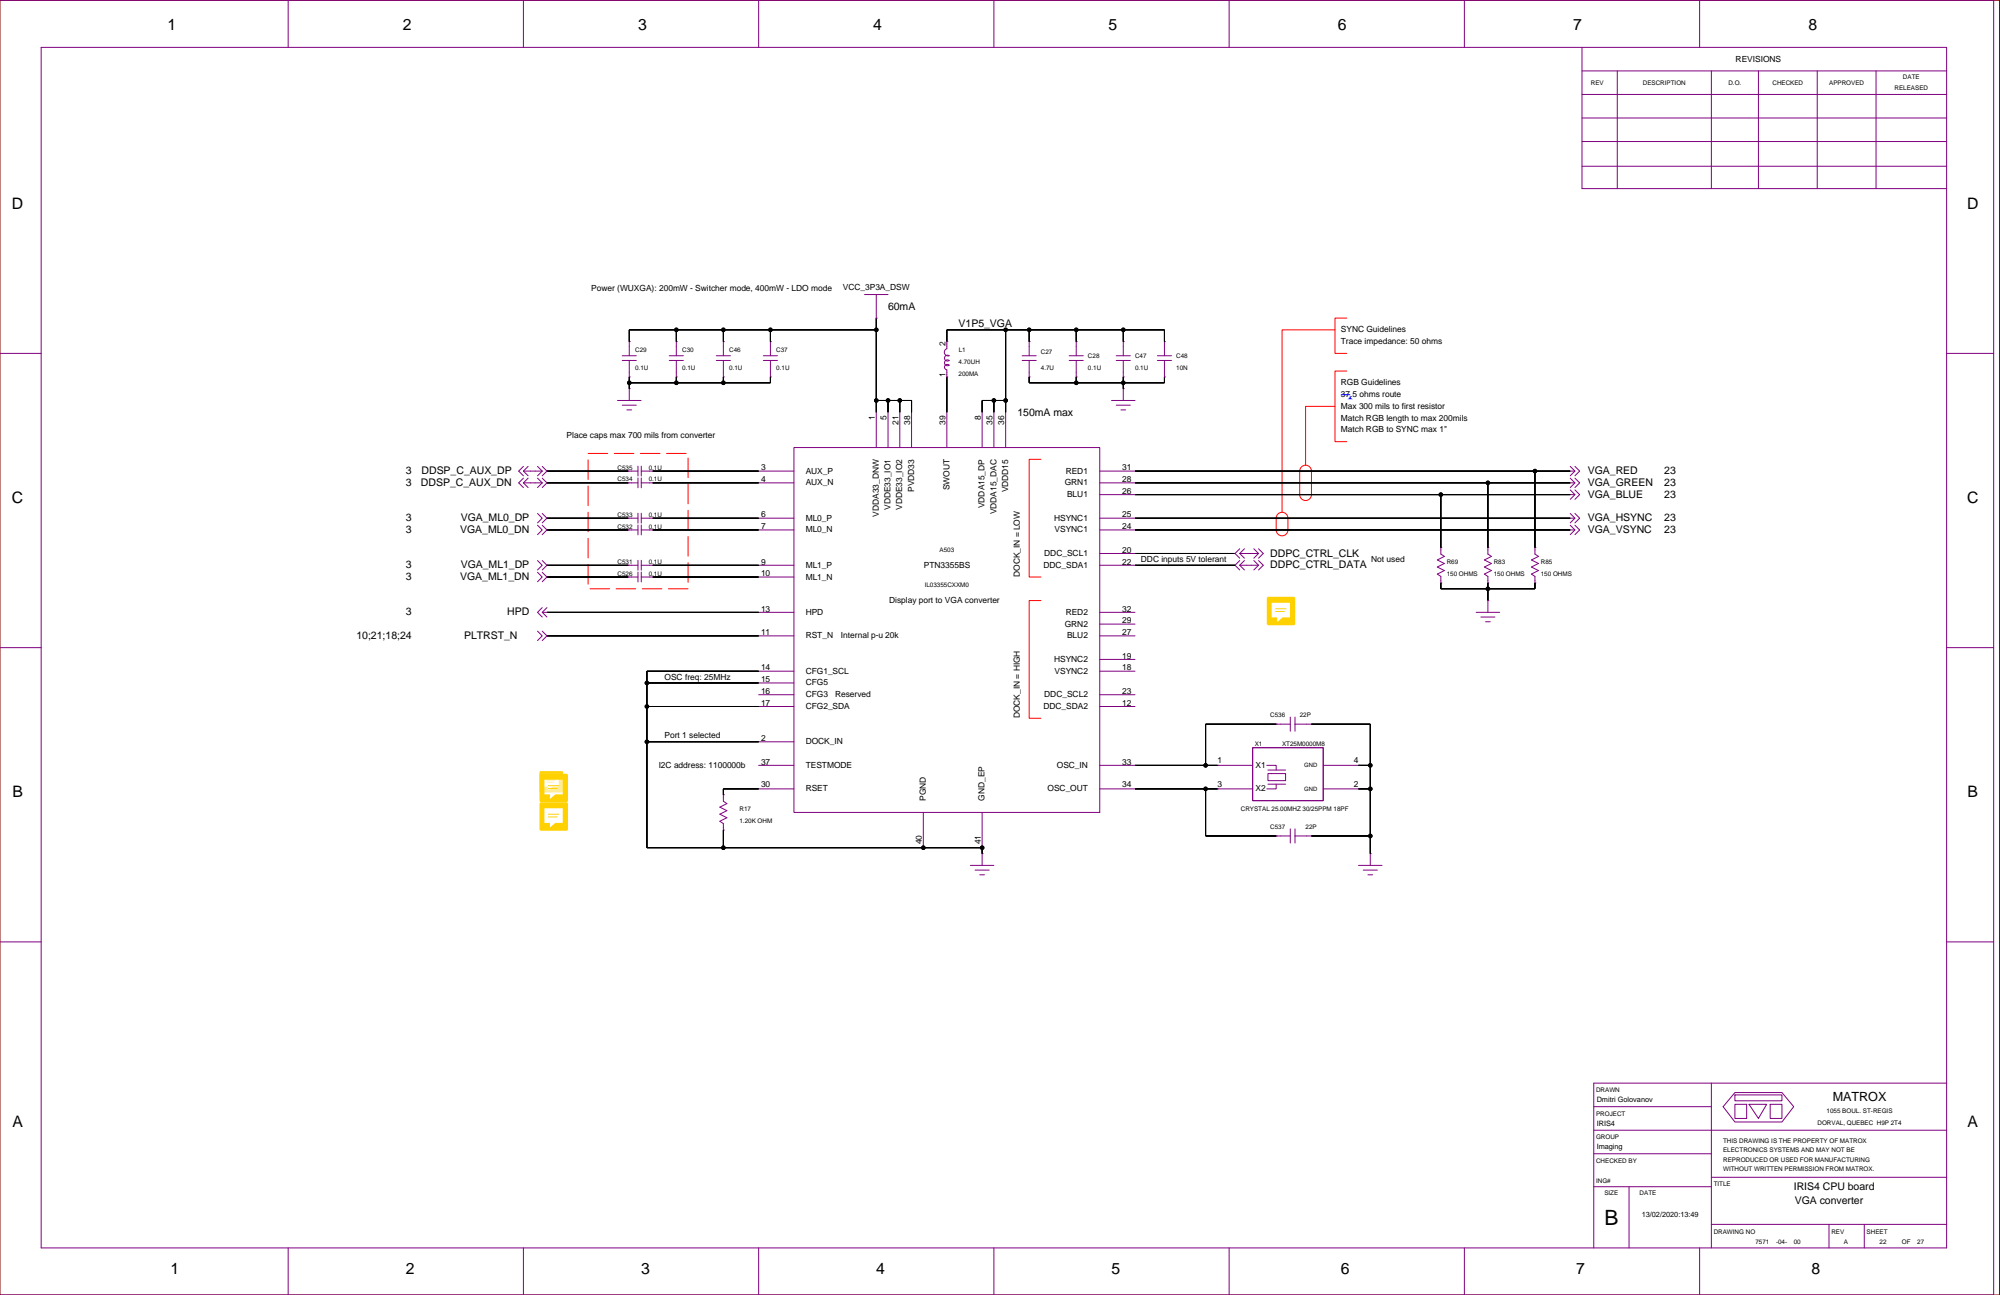
[picture p45: page 22]

Power (WUXGA): 200mW - Switcher mode, 400mW - LDO mode

RGB Guidelines
37.5 ohms route
Max 300 mils to first resistor
Match RGB length to max 200mils
Match RGB to SYNC max 1"

Place caps max 700 mils from converter

Display port to VGA converter

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

+5V

+5V

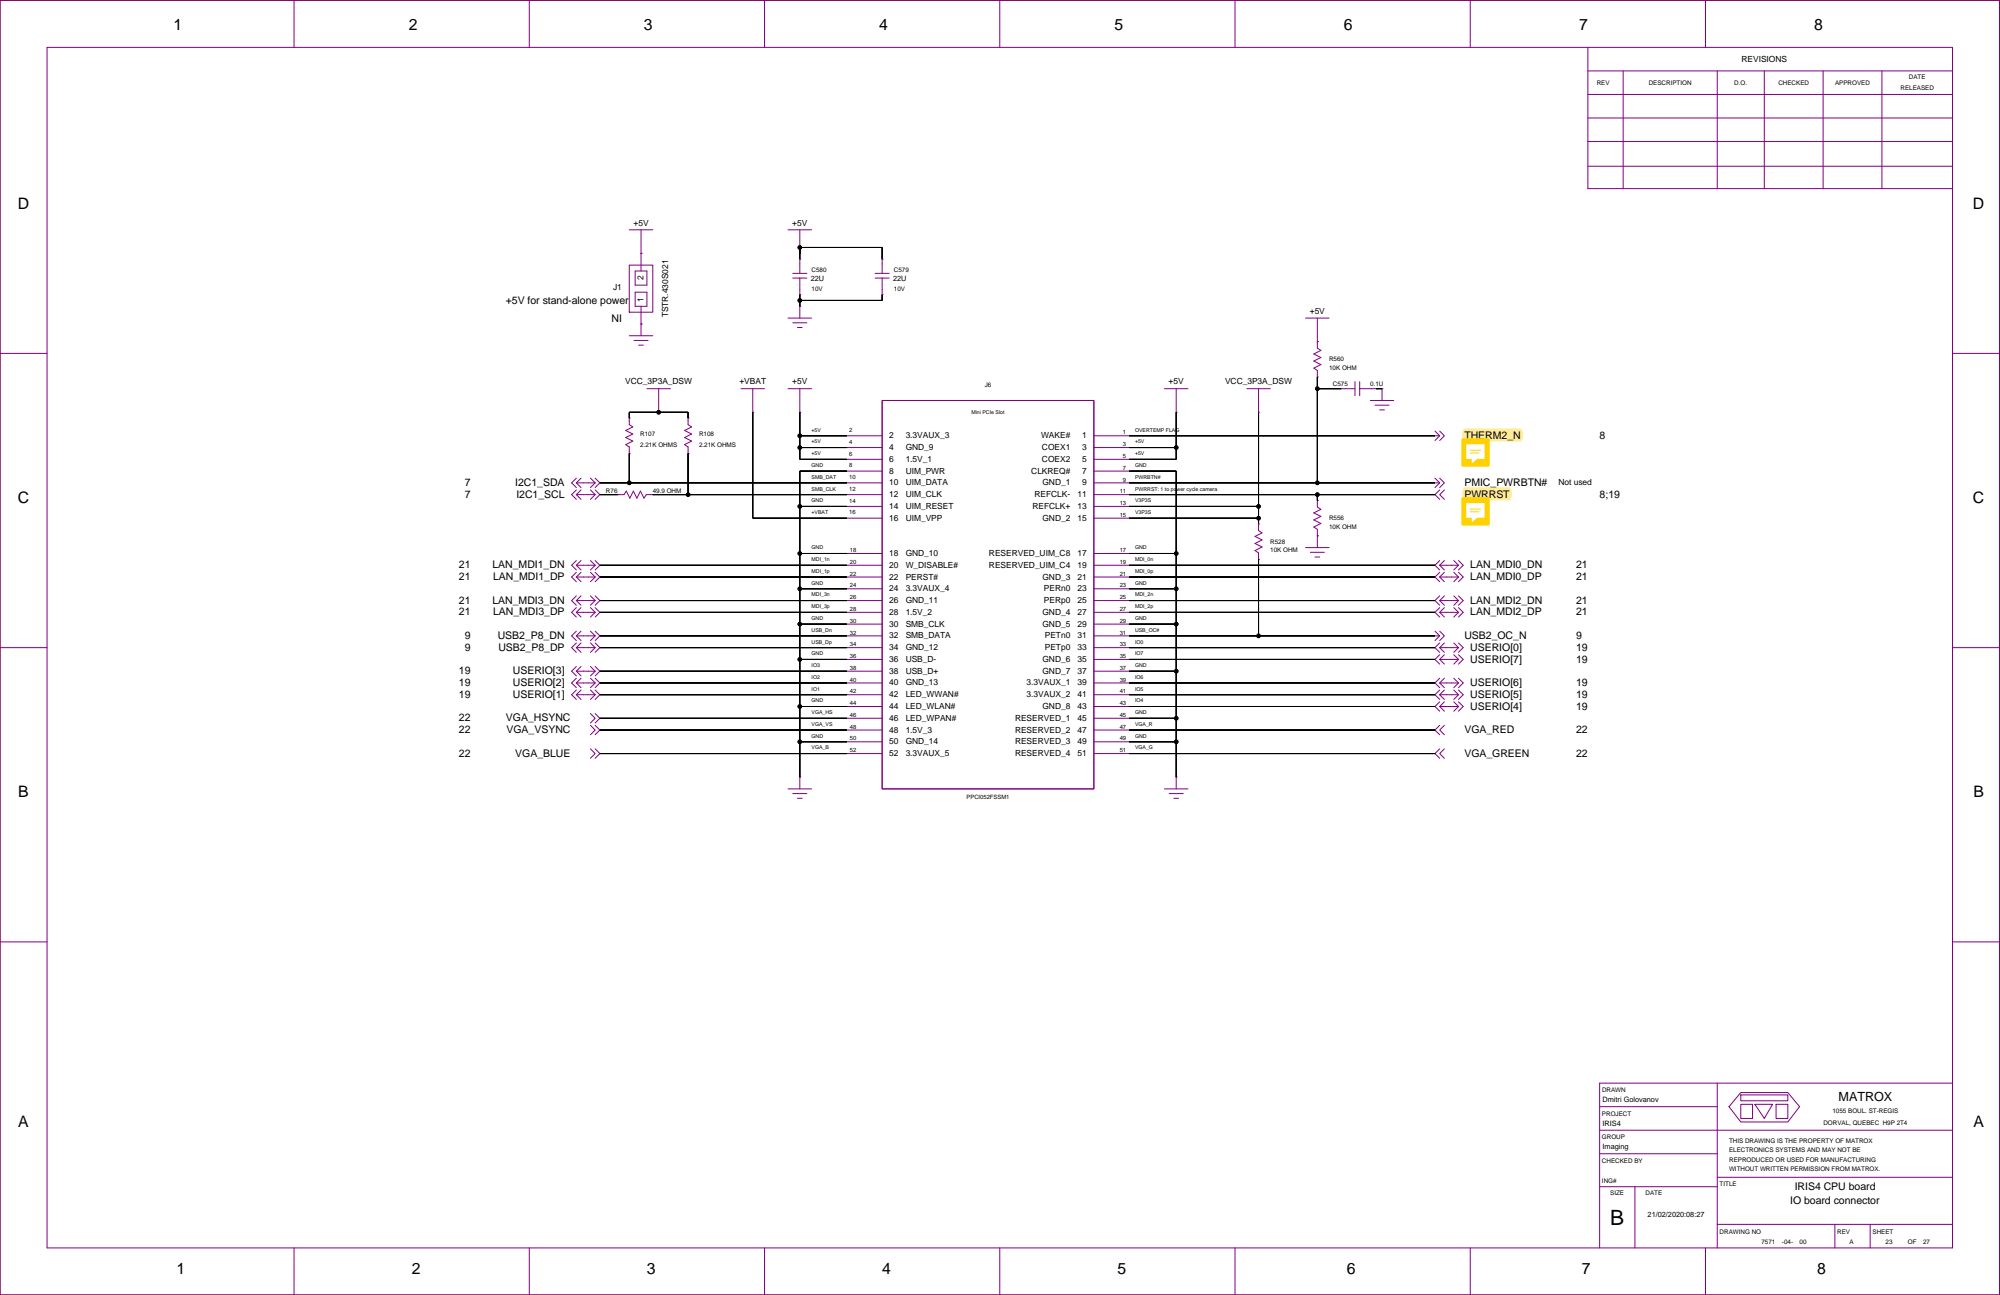
[picture p46: page 23]

+5V for stand-alone power

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

D

D

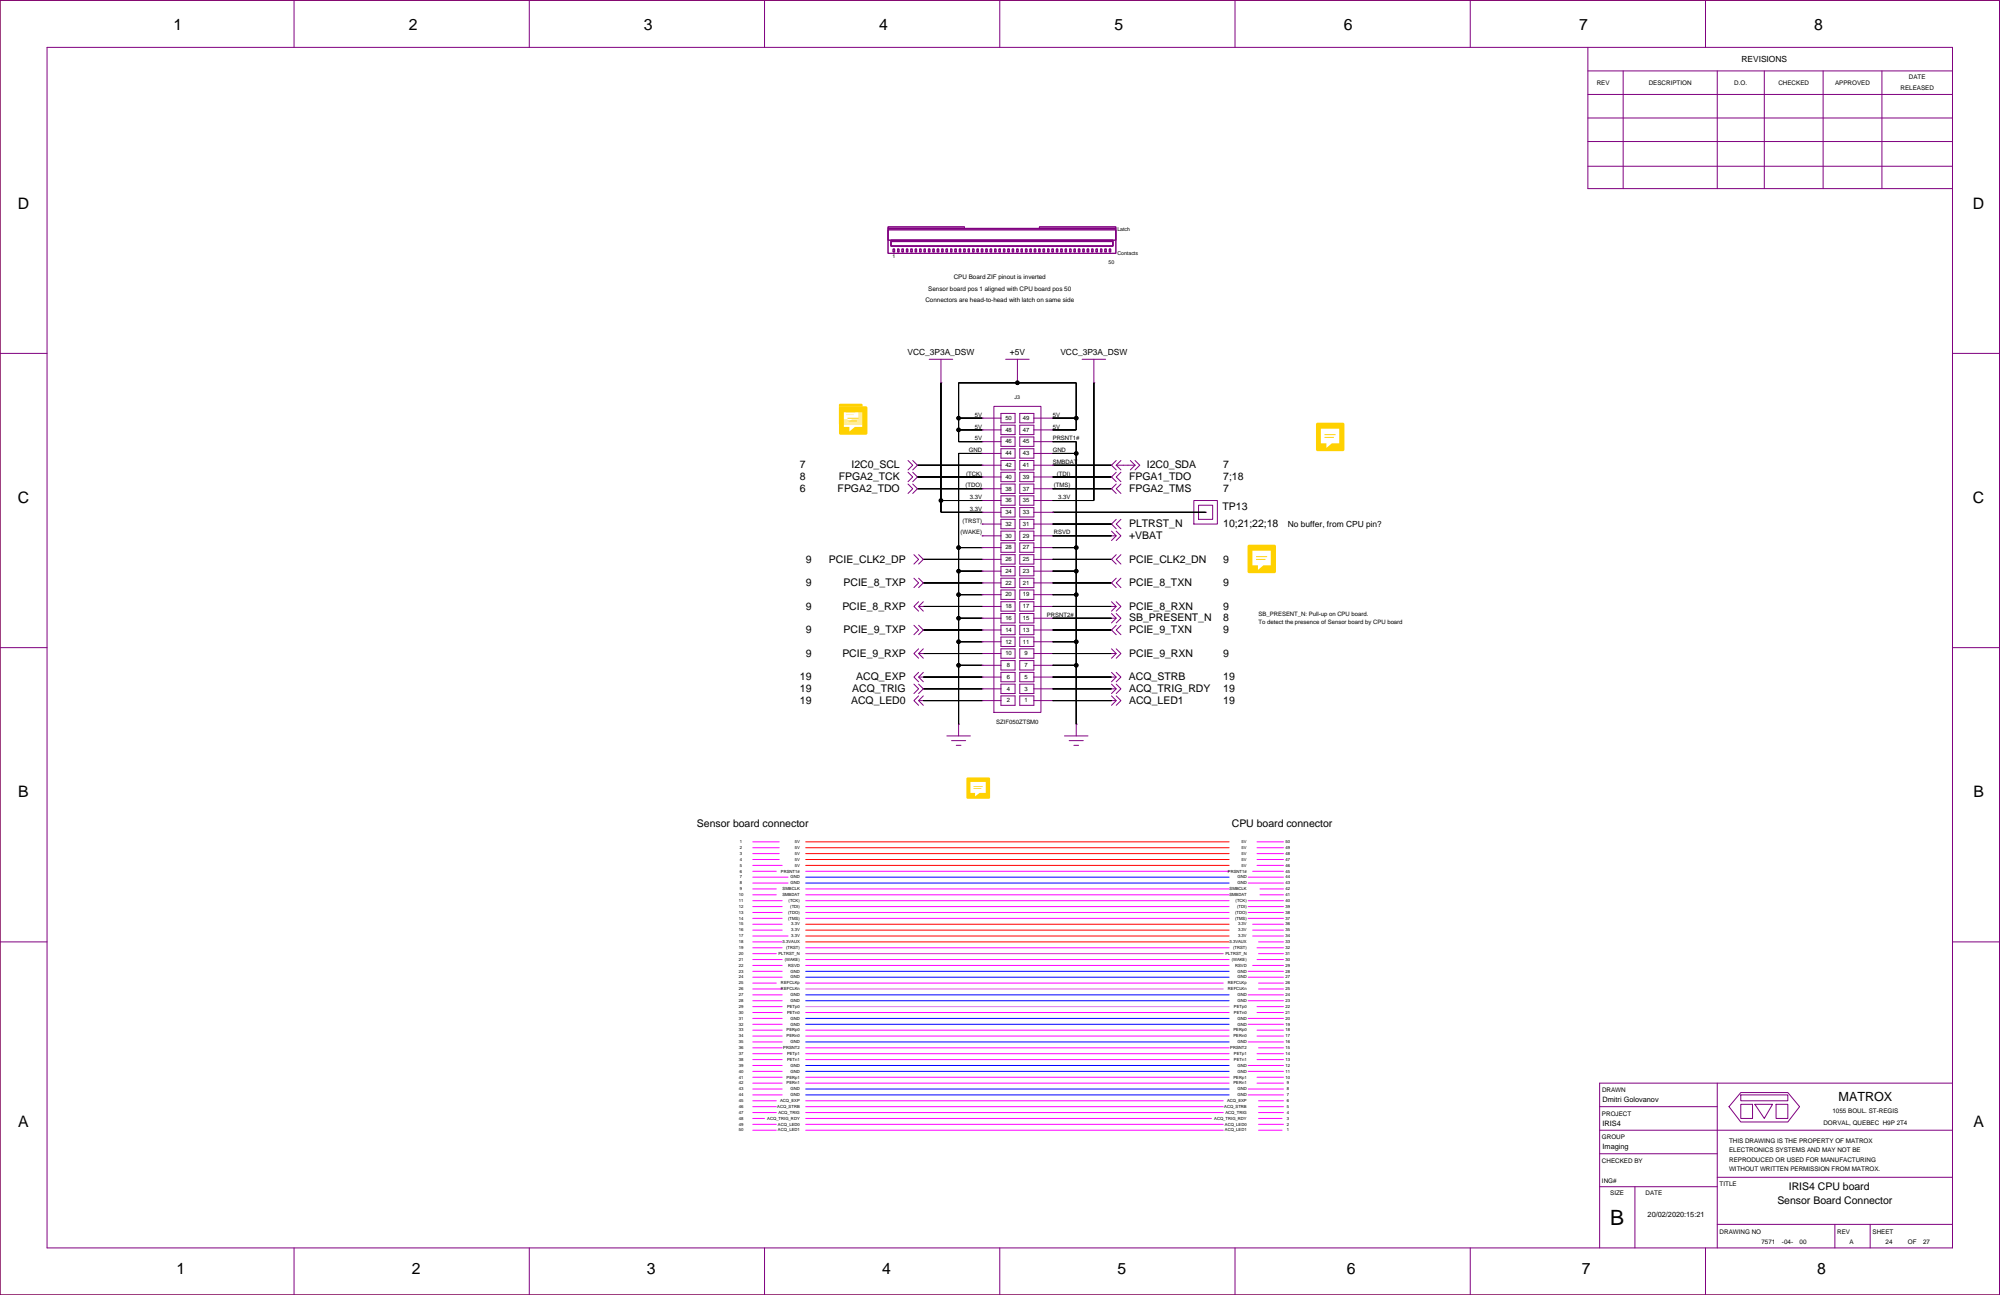
[picture p47: page 24]
Latch; Contacts; DRAWN; PROJECT; GROUP; ING#; MATROX; CHECKED BY; Dmitri Golovanov; Imaging; IRIS4; SMBDAT; PRSNT1#; GND; Sensor board connector; CPU board connector; (TMS); (TDO); (TCK); SMBCLK; (TDI); RSVD; (WAKE); PLTRST_N; (TRST); PETn0; PETp0; REFCLKn; REFCLKp; PRSNT2; PERn0; PERp0; PERn1; PERp1; PETn1; PETp1; ACQ_TRIG_RDY; ACQ_TRIG; ACQ_STRB; ACQ_LED0 ACQ_LED1; +VBAT; I2C0_SCL; I2C0_SDA; VCC_3P3A_DSW; PCIE_CLK2_DP; PCIE_CLK2_DN; PCIE_8_TXP; PCIE_8_TXN; PCIE_8_RXP; PCIE_8_RXN; PCIE_9_TXP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

CPU Board ZIF pinout is inverted

Sensor board pos 1 aligned with CPU board pos 50
Connectors are head-to-head with latch on same side

No buffer, from CPU pin?

SB_PRESENT_N: Pull-up on CPU board.
To detect the presence of Sensor board by CPU board

1055 BOUL. ST-REGIS
DORVAL, QUEBEC H9P 2T4

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

Sensor Board Connector

D

D

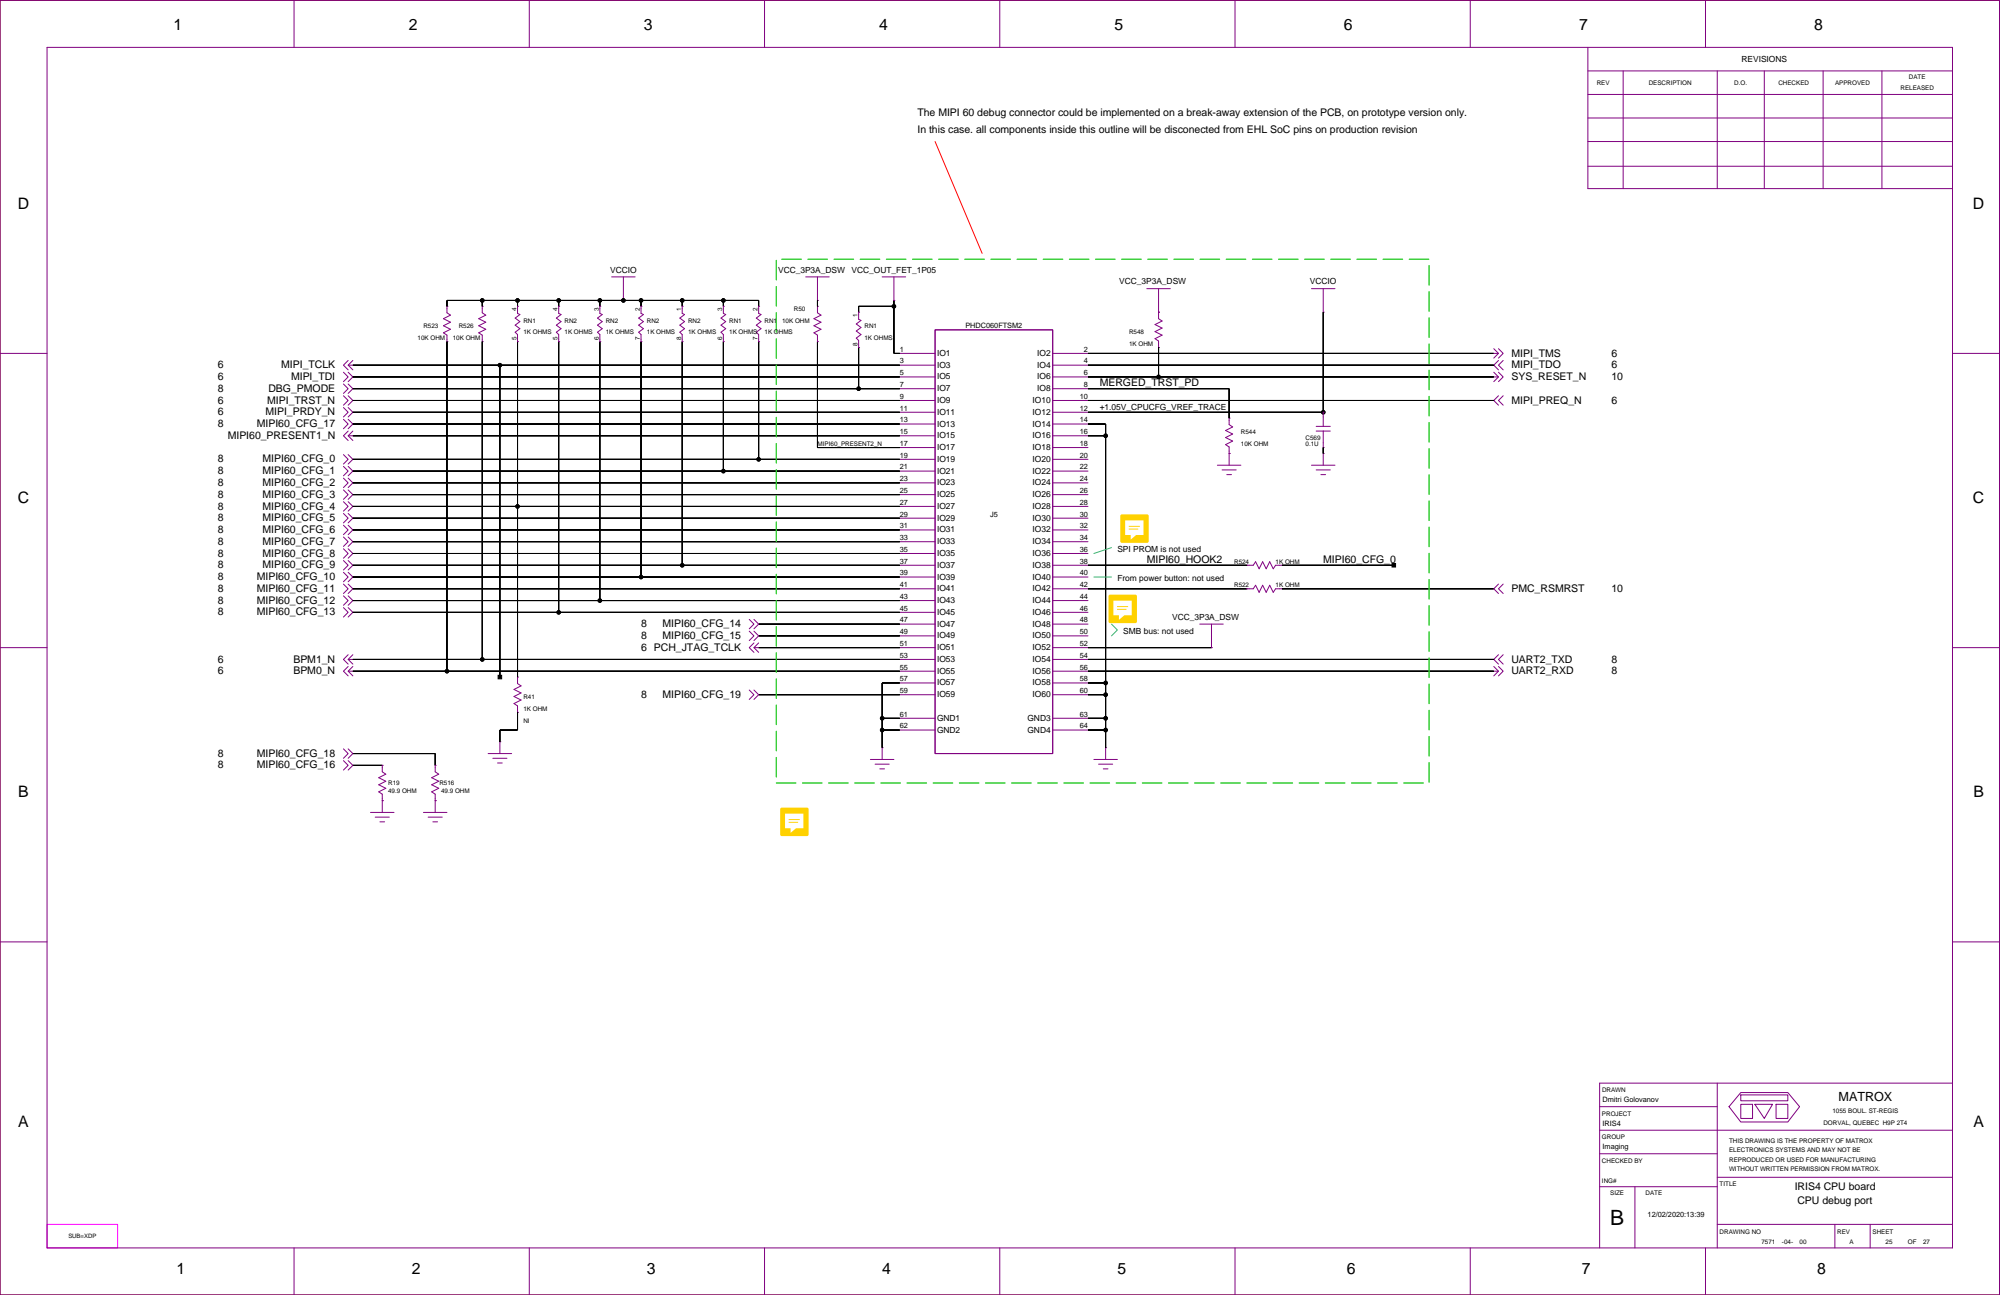
[picture p48: page 25]

The MIPI 60 debug connector could be implemented on a break-away extension of the PCB, on prototype version only.
In this case. all components inside this outline will be disconected from EHL SoC pins on production revision

SPI PROM is not used

From power button: not used

SMB bus: not used

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

POWER | STATUS | USER | 100/1G

D

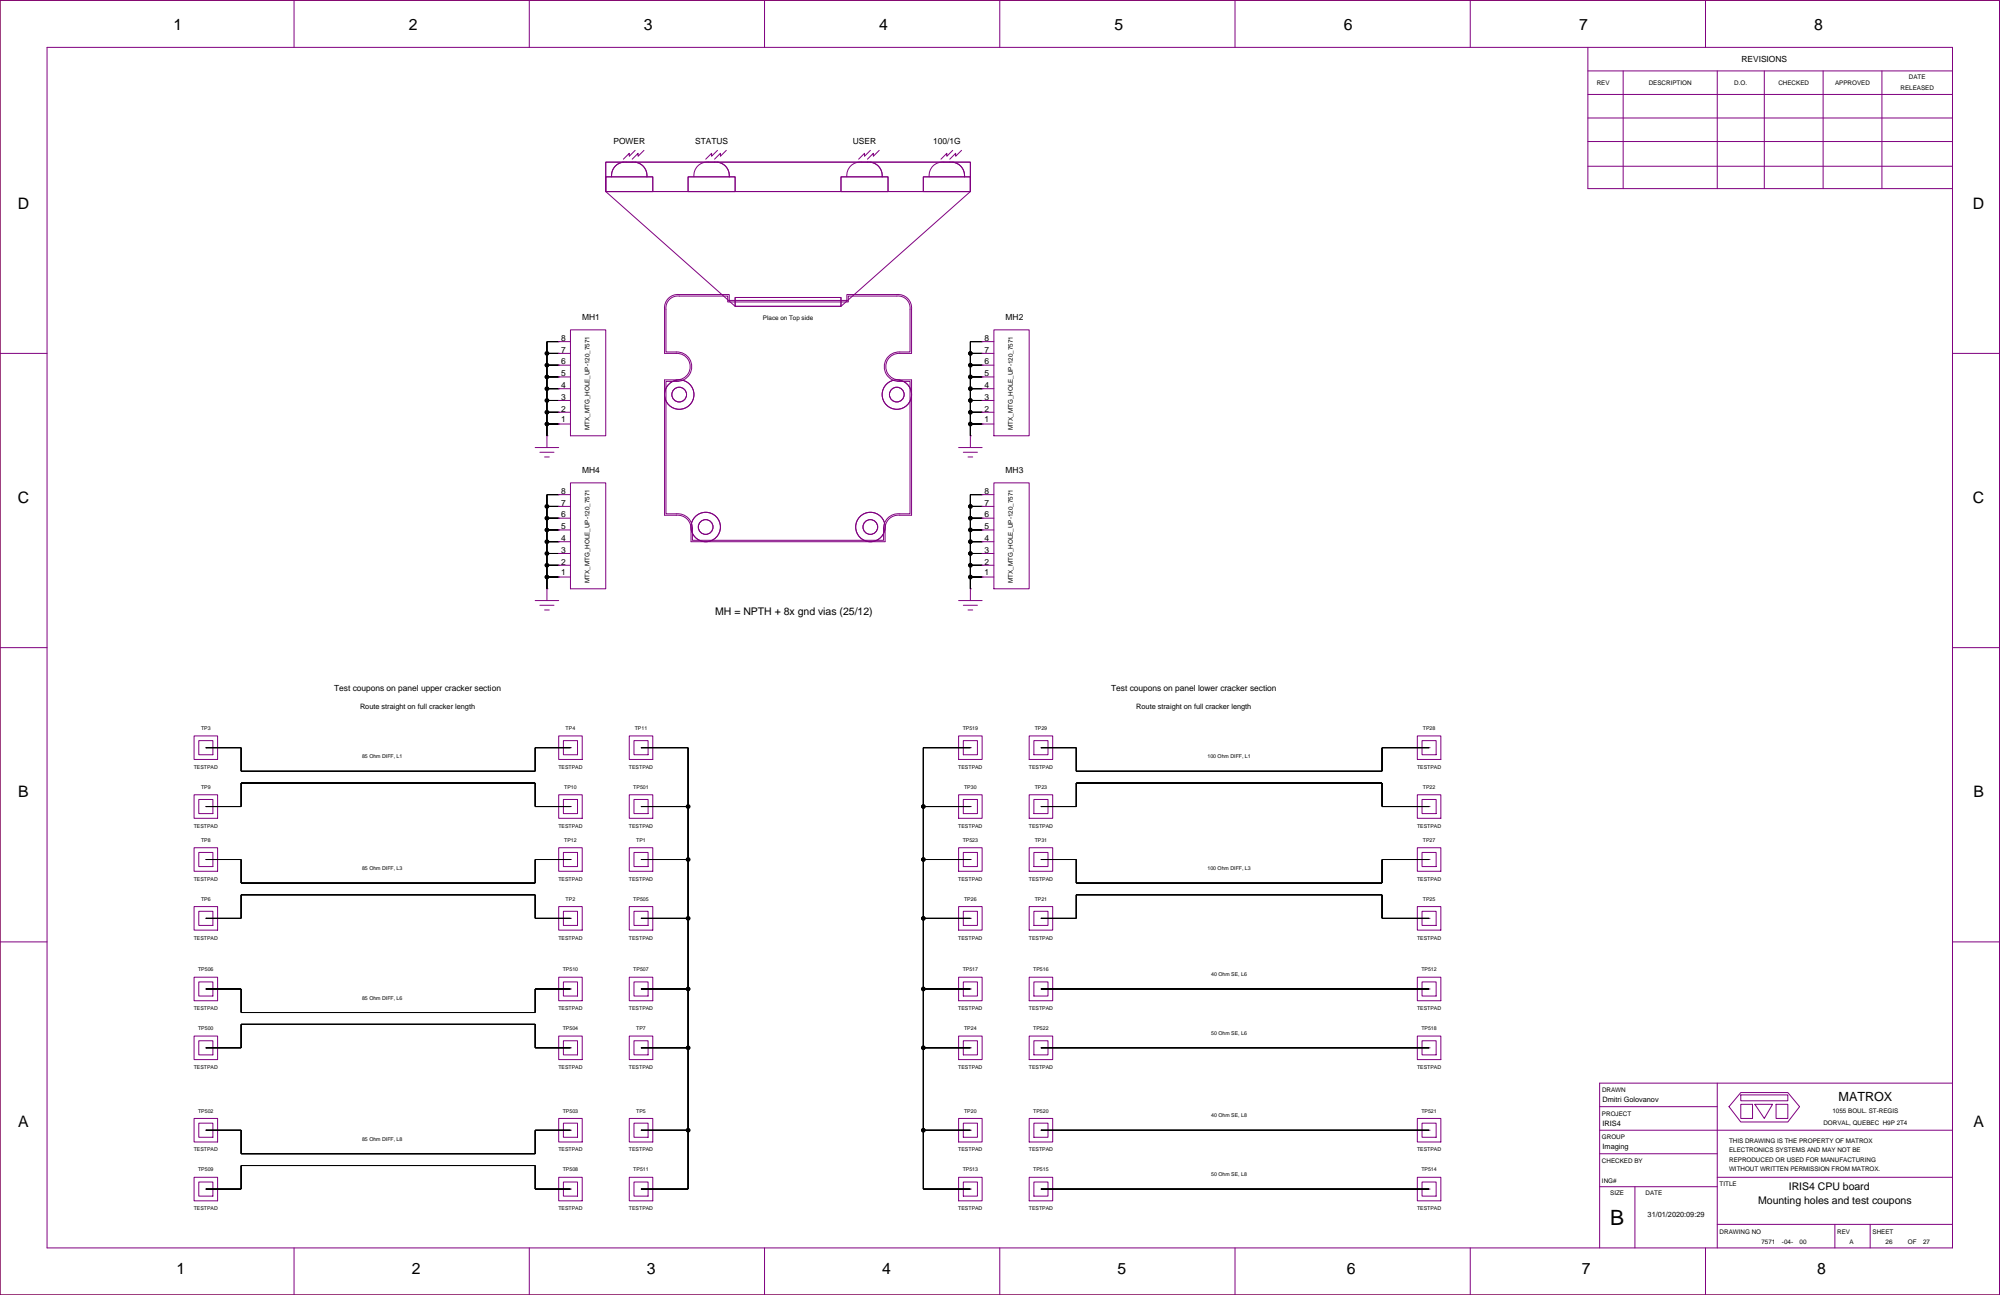
[picture p49: page 26]

Place on Top side

MH = NPTH + 8x gnd vias (25/12)

Route straight on full cracker length

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

Mounting holes and test coupons

D

D

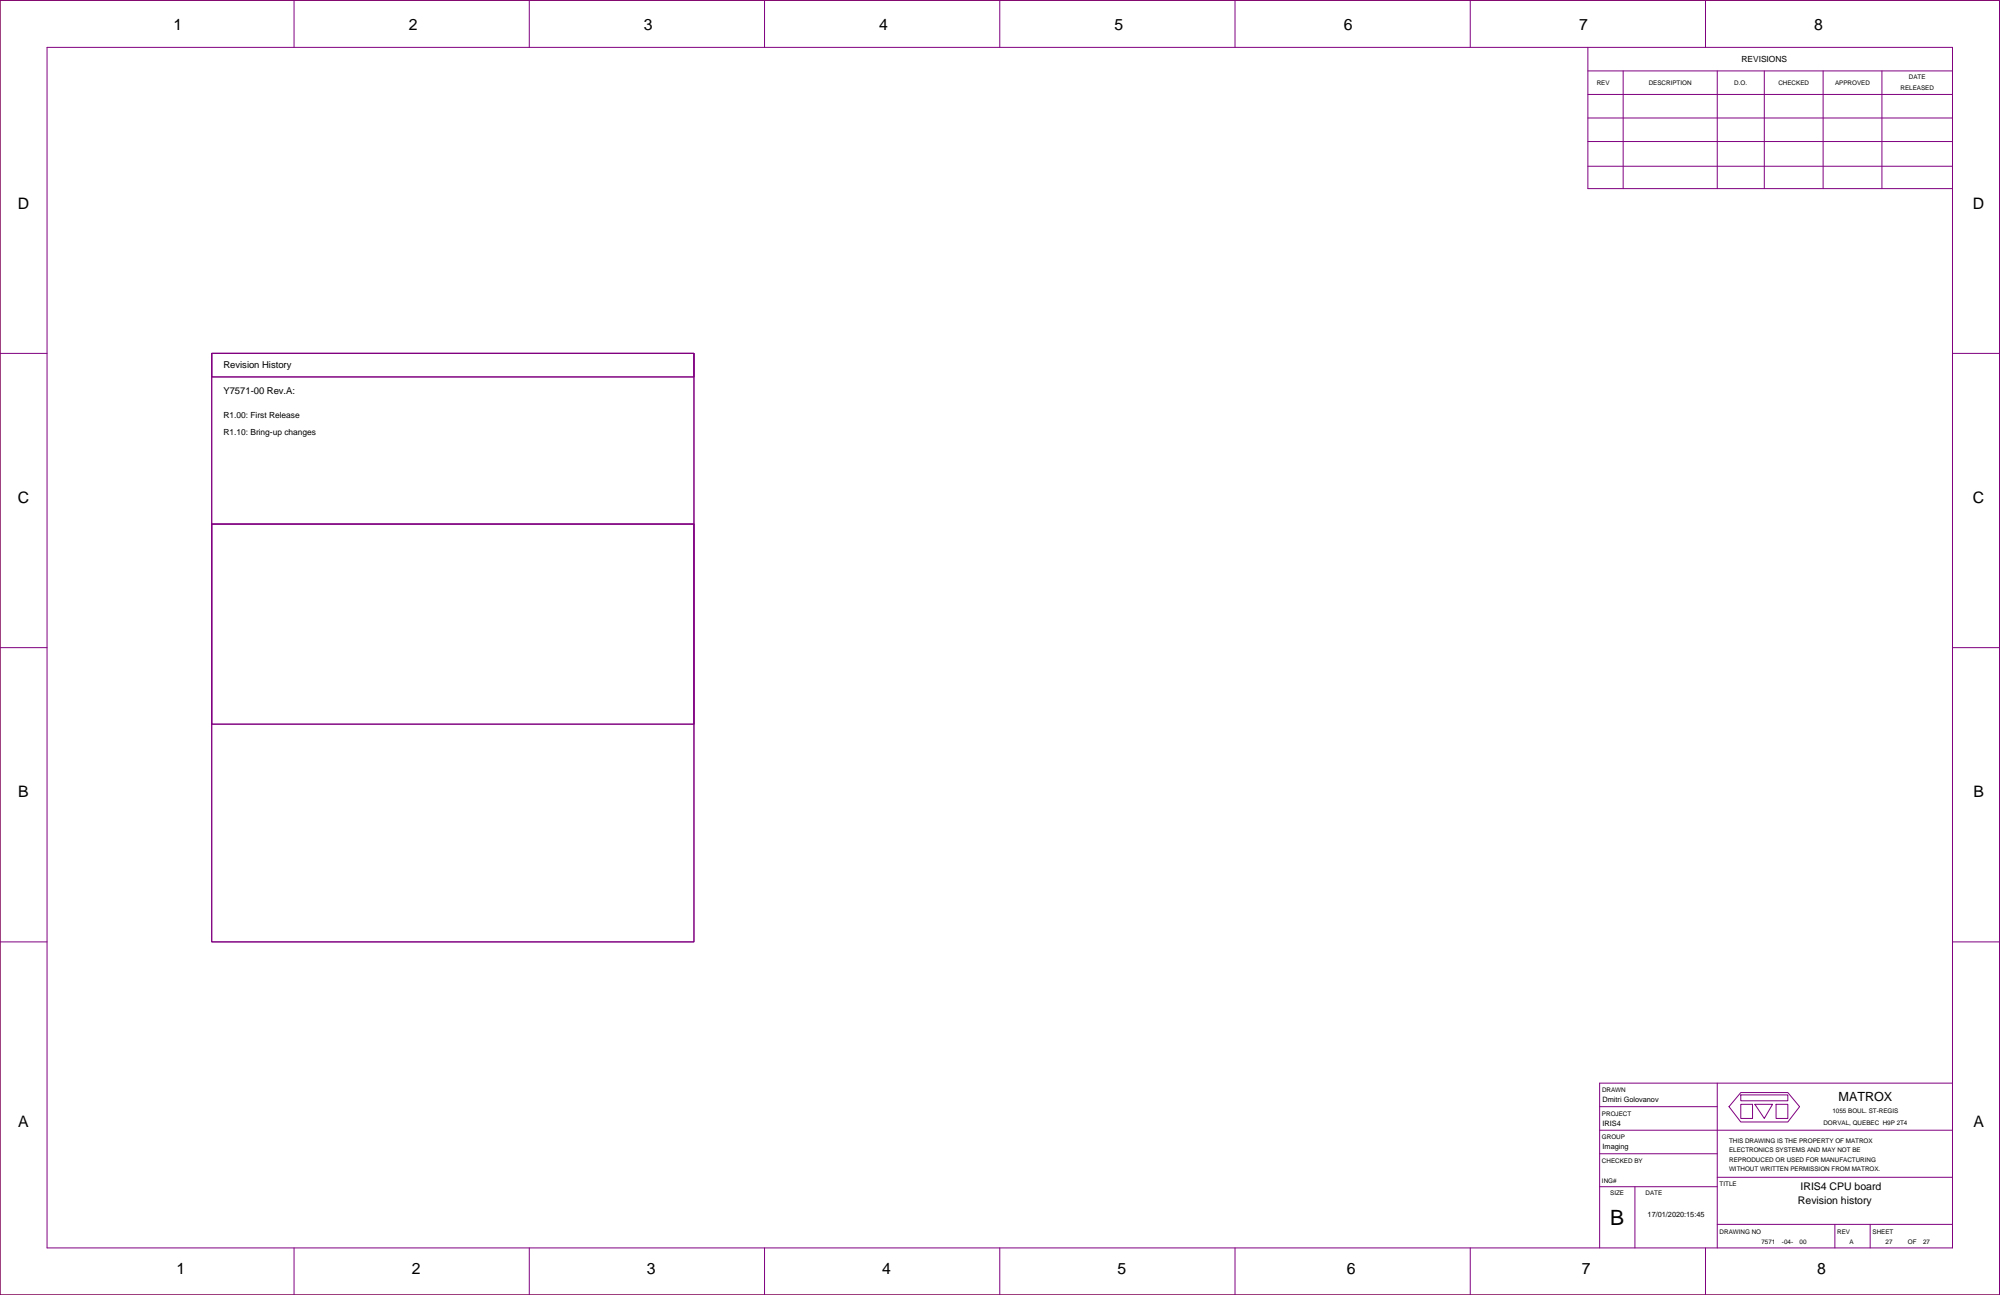
[picture p50: page 27]
Y7571-00 Rev.A:; Revision History; DRAWN; PROJECT; GROUP; ING#; MATROX; CHECKED BY; Dmitri Golovanov; Imaging; IRIS4; Revision history

R1.00: First Release
R1.10: Bring-up changes

1055 BOUL. ST-REGIS
DORVAL, QUEBEC H9P 2T4

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
