AM4511/test_migrate_iris4/doc/schematic_review/sensor_board/7572-00_24Mars_review_alain_m.pdf

| REVISIONS
A | Y7572-00 | S.Ricard

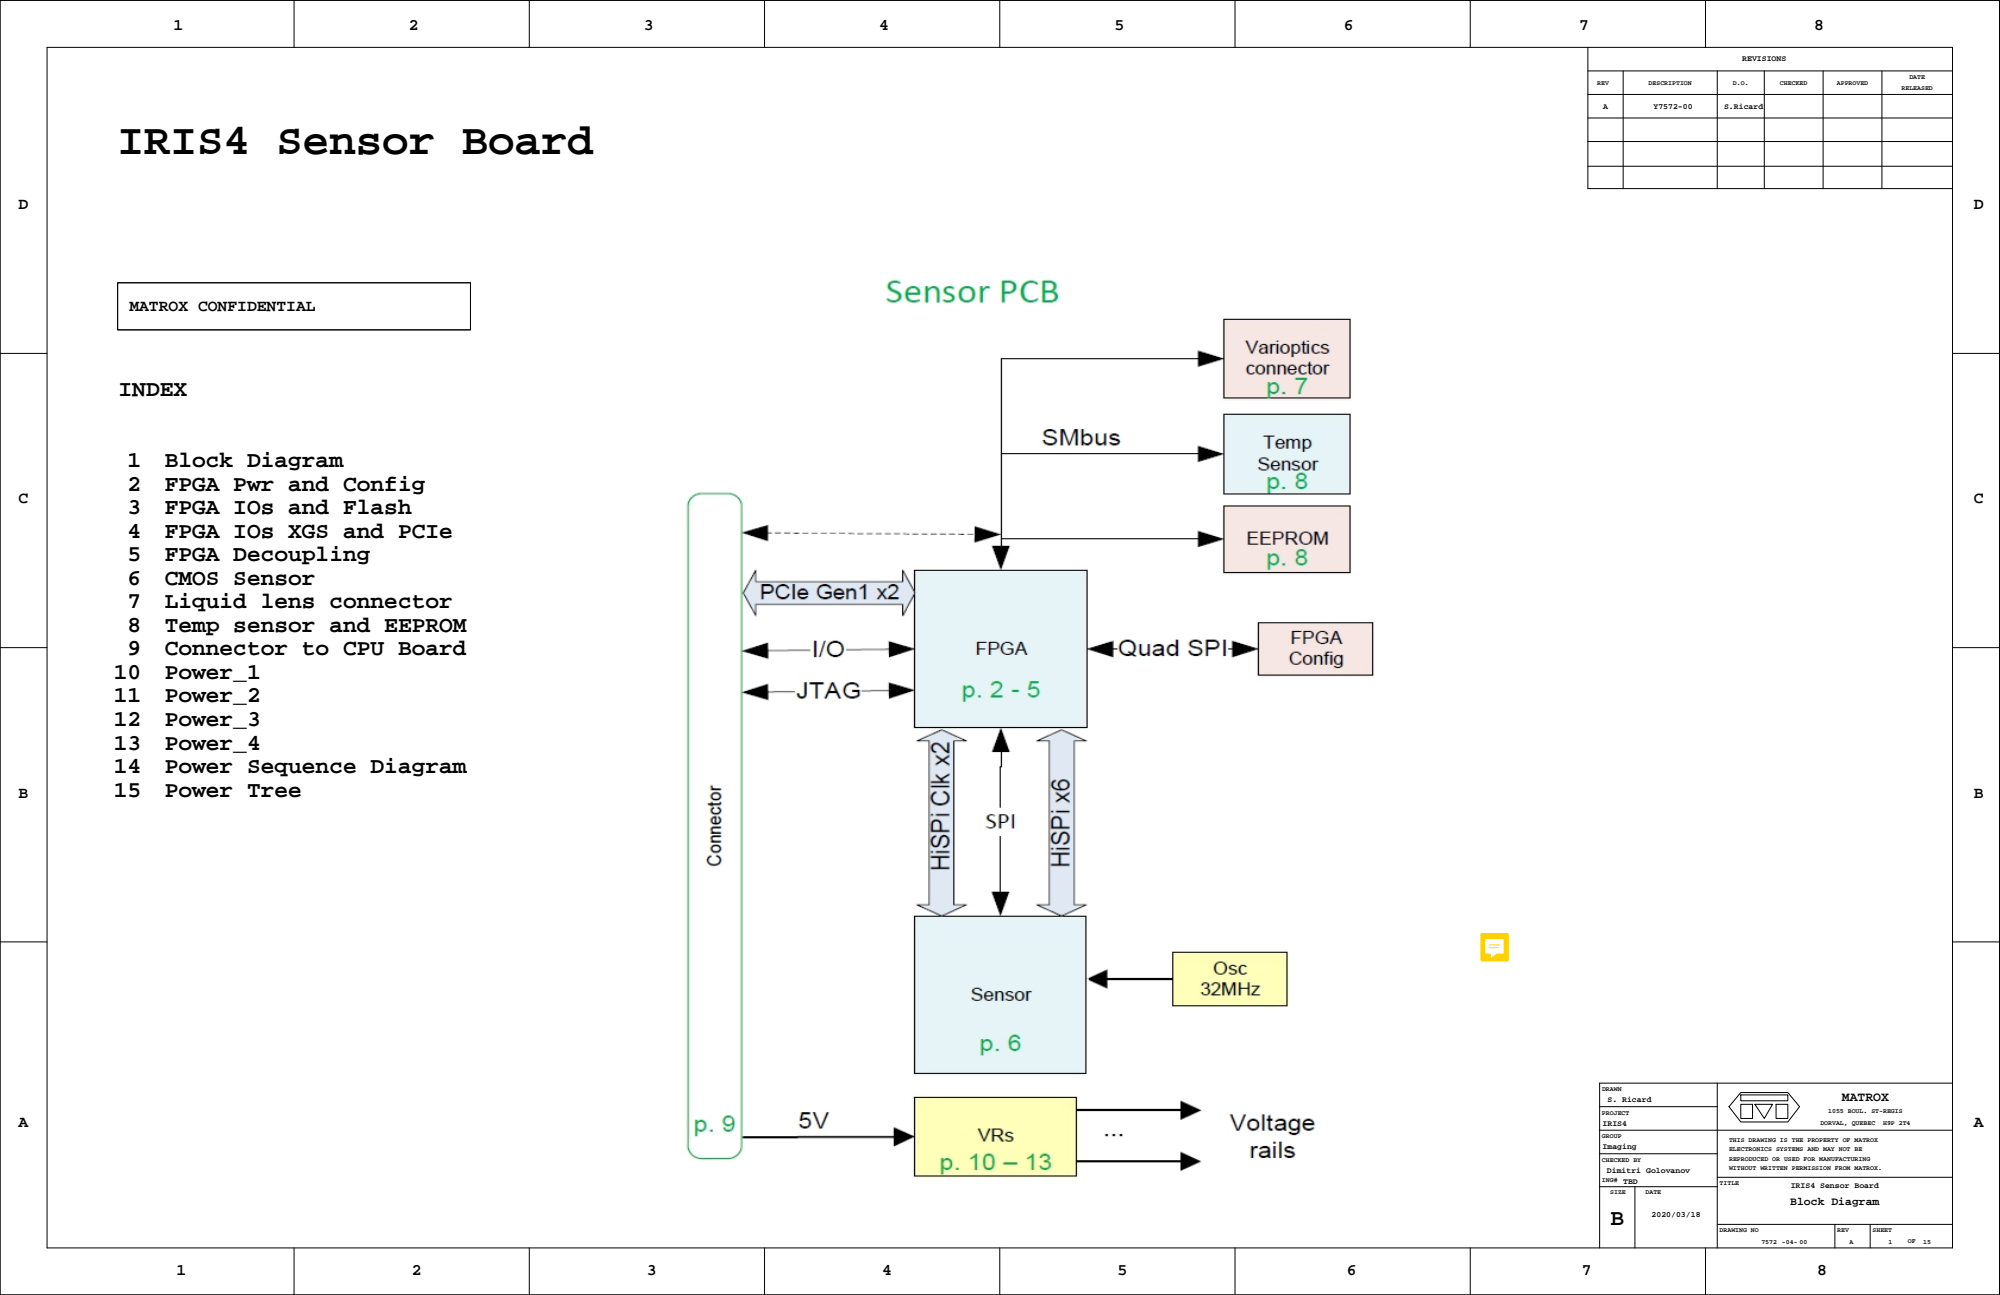
[picture p51: page 1]
DRAWN; PROJECT; GROUP; ING#; TITLE; MATROX; B REV; CHECKED BY; S. Ricard; Dimitri Golovanov; Imaging; IRIS4; TBD; Block Diagram; INDEX; MATROX CONFIDENTIAL; IRIS4 Sensor Board; CMOS Sensor; Power_2; FPGA Decoupling

REV | DESCRIPTION | D.O. | CHECKED | APPROVED | DATE RELEASED

1 Block Diagram
2 FPGA Pwr and Config
3 FPGA IOs and Flash
4 FPGA IOs XGS and PCIe
7 Liquid lens connector
Temp sensor and EEPROM
9 Connector to CPU Board
10 Power_1
Power_3
Power_4
Power Sequence Diagram
Power Tree

1055 BOUL. ST-REGIS
DORVAL, QUEBEC H9P 2T4

THIS DRAWING IS THE PROPERTY OF MATROX
ELECTRONICS SYSTEMS AND MAY NOT BE
REPRODUCED OR USED FOR MANUFACTURING
WITHOUT WRITTEN PERMISSION FROM MATROX.

SIZE | 2020/03/18

DRAWING NO 7572 A -04-00 1 | SHEET OF 15

D

D

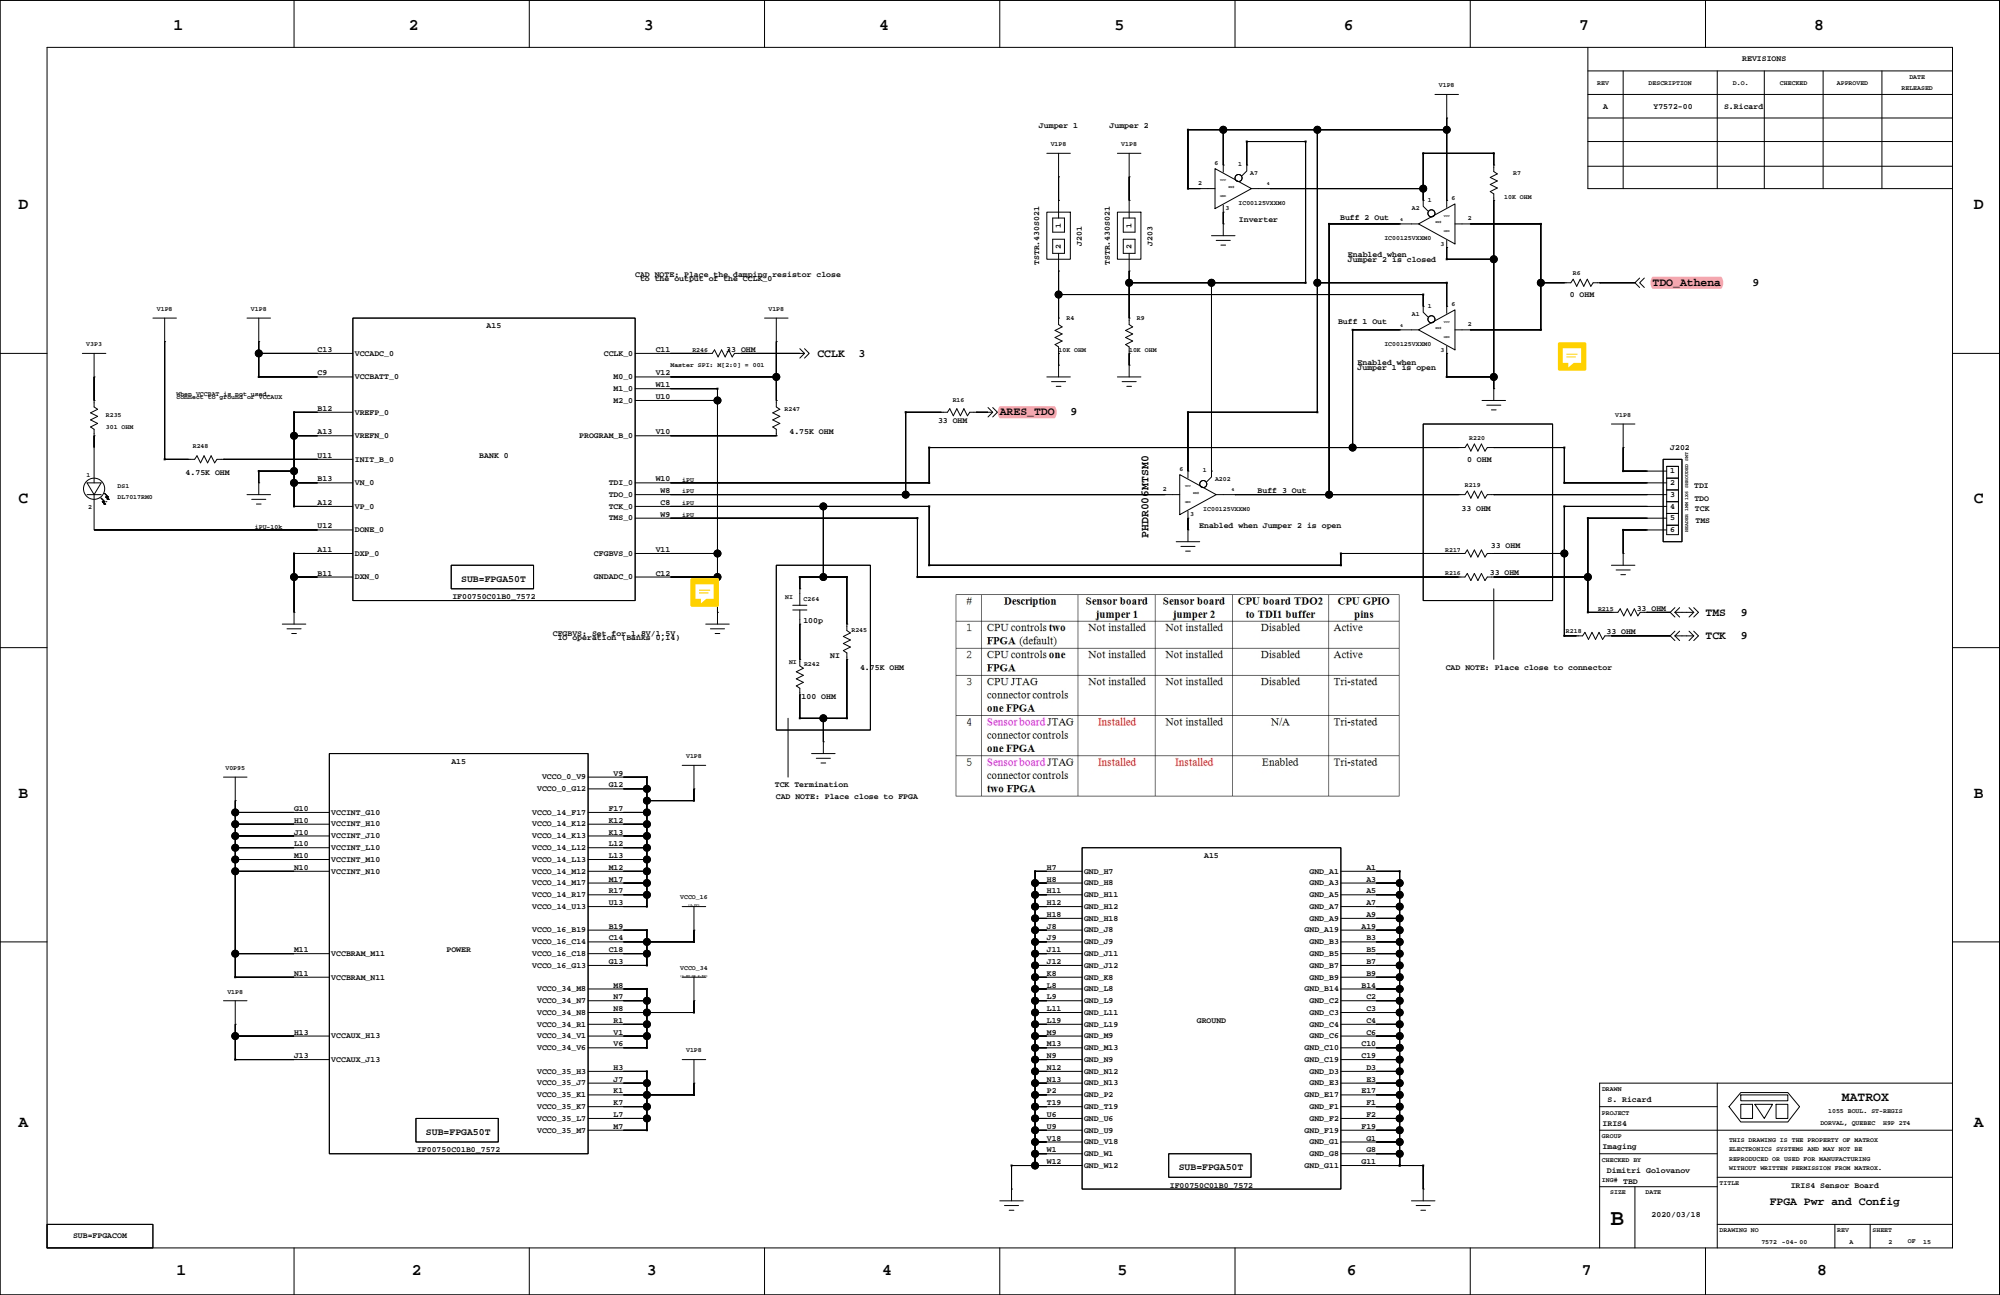
[picture p52: page 2]

Enabled when Jumper 2 is closed

CAD NOTE: Place the damping resistor close to the output of the CCLK_0

Enabled when Jumper 1 is open

When VCCBAT is not used, connect to ground or VCCAUX

CFGBVS: Set for 1.8V/1.5V IO operation (Banks 0,14)

CAD NOTE: Place close to connector

TCK Termination
CAD NOTE: Place close to FPGA

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

FPGA Pwr and Config

D

D

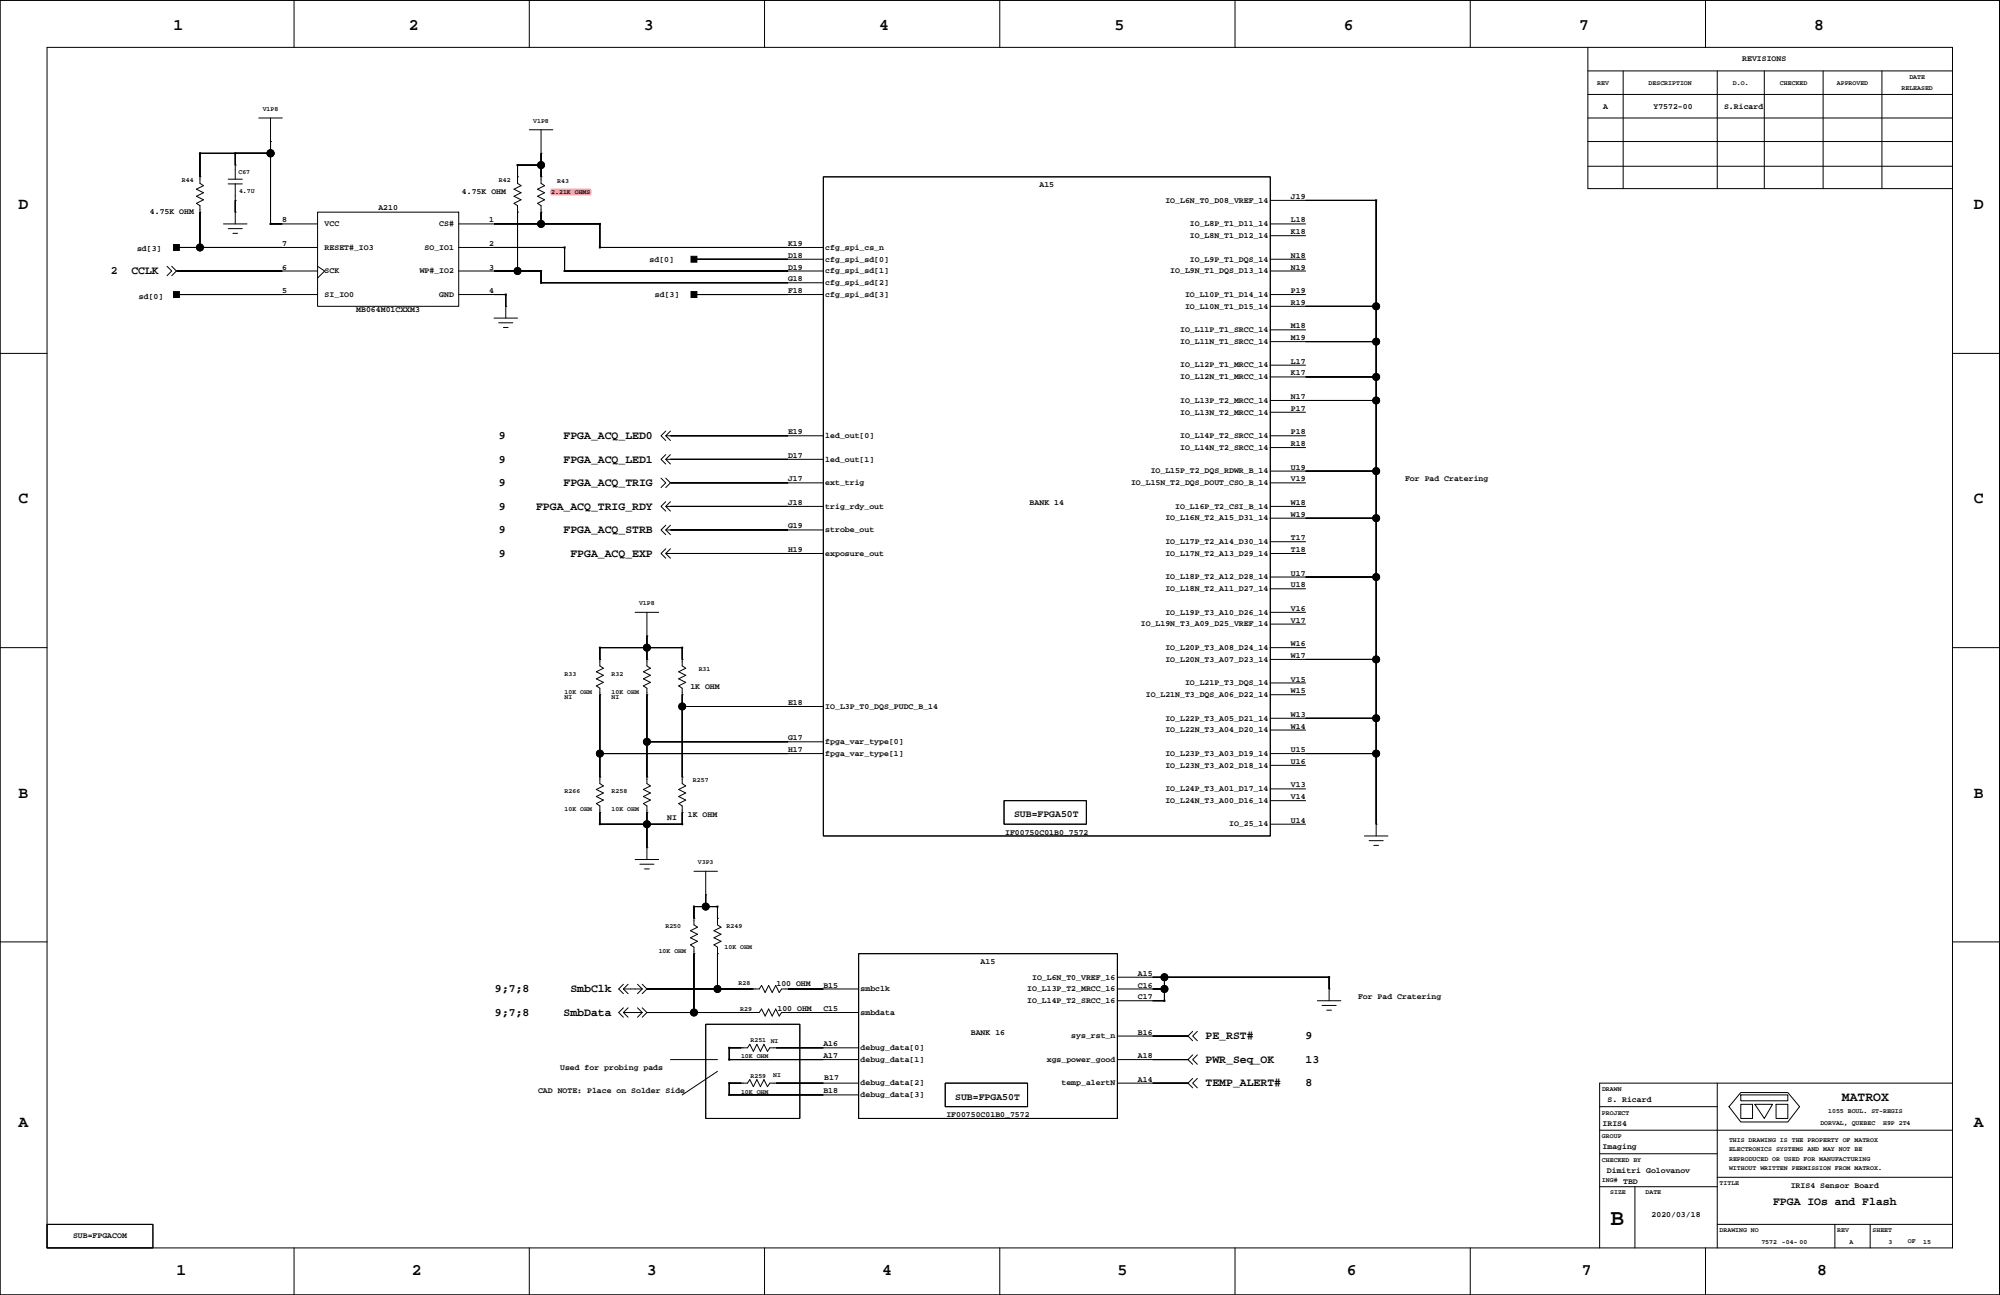
[picture p53: page 3]

Used for probing pads

CAD NOTE: Place on Solder Side

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

FPGA IOs and Flash

D

D

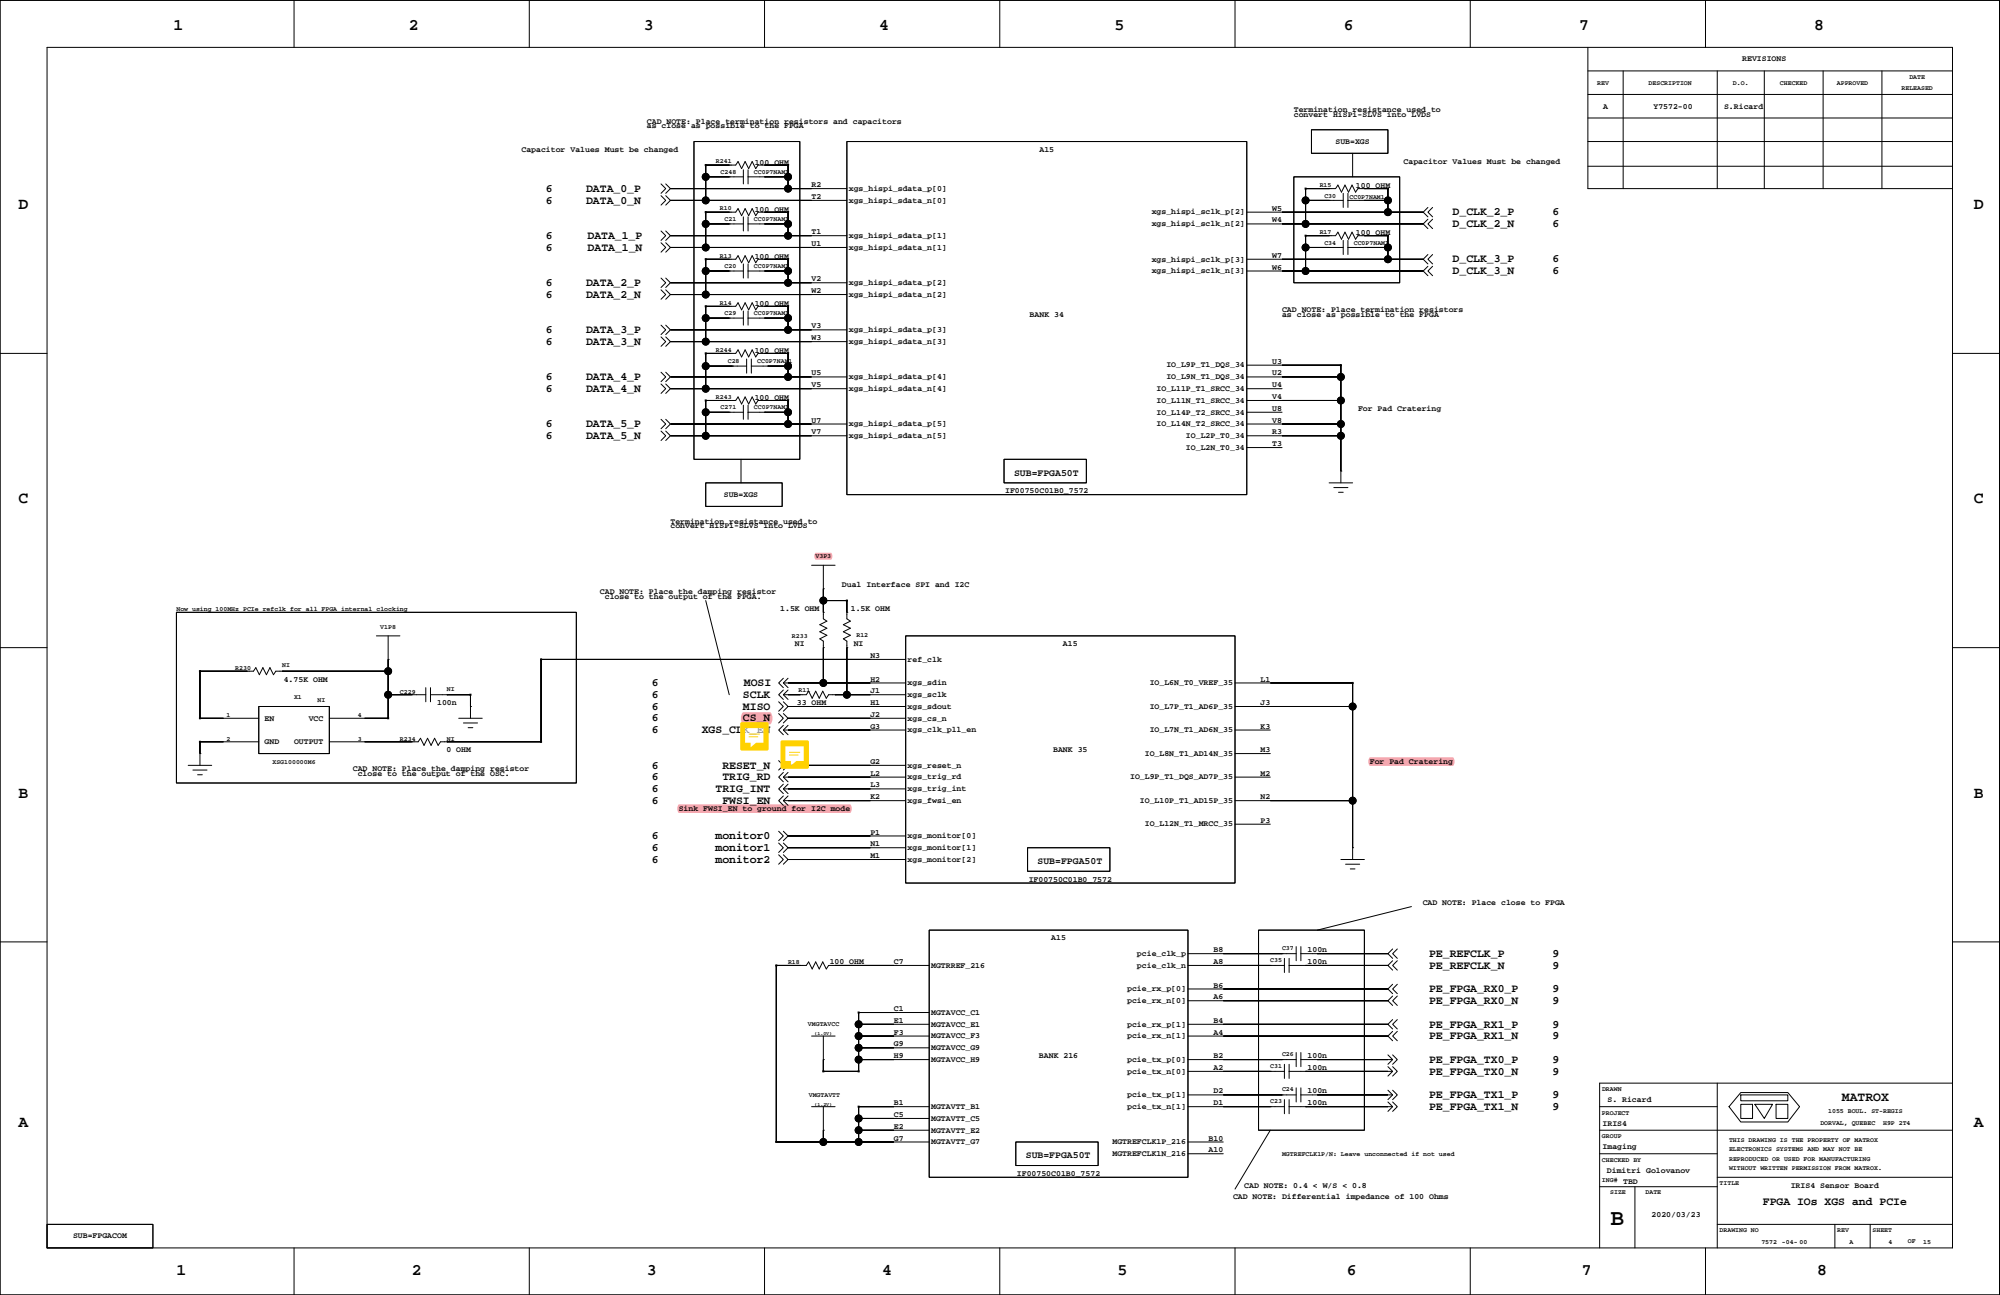
[picture p54: page 4]

Termination resistance used to convert HiSPi-SLVS into LVDS

CAD NOTE: Place termination resistors and capacitors as close as possible to the FPGA

Capacitor Values Must be changed

CAD NOTE: Place termination resistors as close as possible to the FPGA

Dual Interface SPI and I2C

CAD NOTE: Place the damping resistor close to the output of the FPGA.

Now using 100MHz PCIe refclk for all FPGA internal clocking

CAD NOTE: Place the damping resistor close to the output of the OSC.

CAD NOTE: Place close to FPGA

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

MGTREFCLK1P/N: Leave unconnected if not used

CAD NOTE: 0.4 < W/S < 0.8
CAD NOTE: Differential impedance of 100 Ohms

FPGA IOs XGS and PCIe

D

D

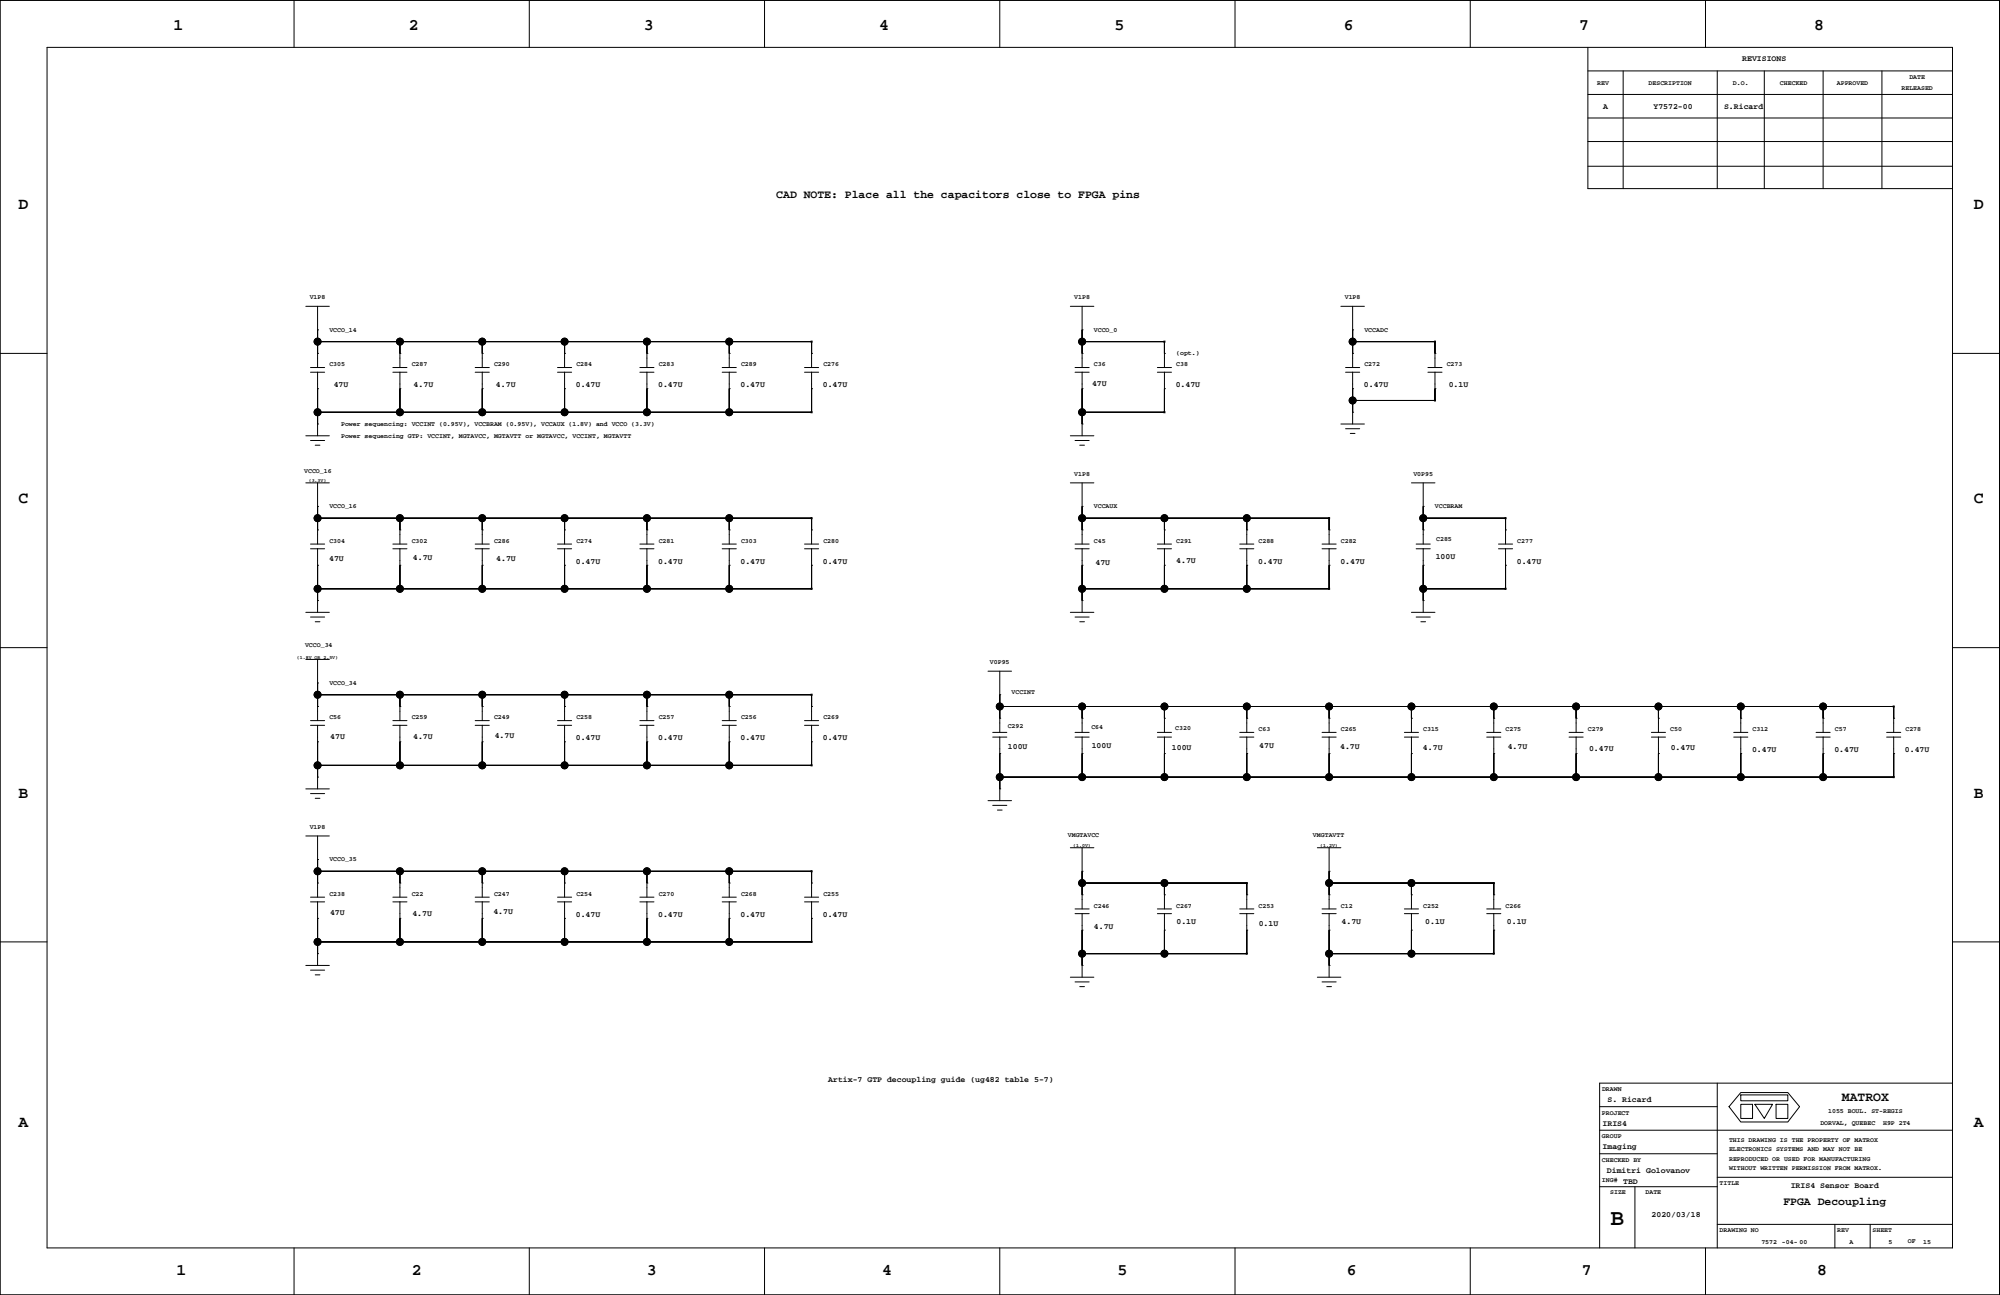
[picture p55: page 5]

CAD NOTE: Place all the capacitors close to FPGA pins

Power sequencing: VCCINT (0.95V), VCCBRAM (0.95V), VCCAUX (1.8V) and VCCO (3.3V)
Power sequencing GTP: VCCINT, MGTAVCC, MGTAVTT or MGTAVCC, VCCINT, MGTAVTT

Artix-7 GTP decoupling guide (ug482 table 5-7)

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

D

D

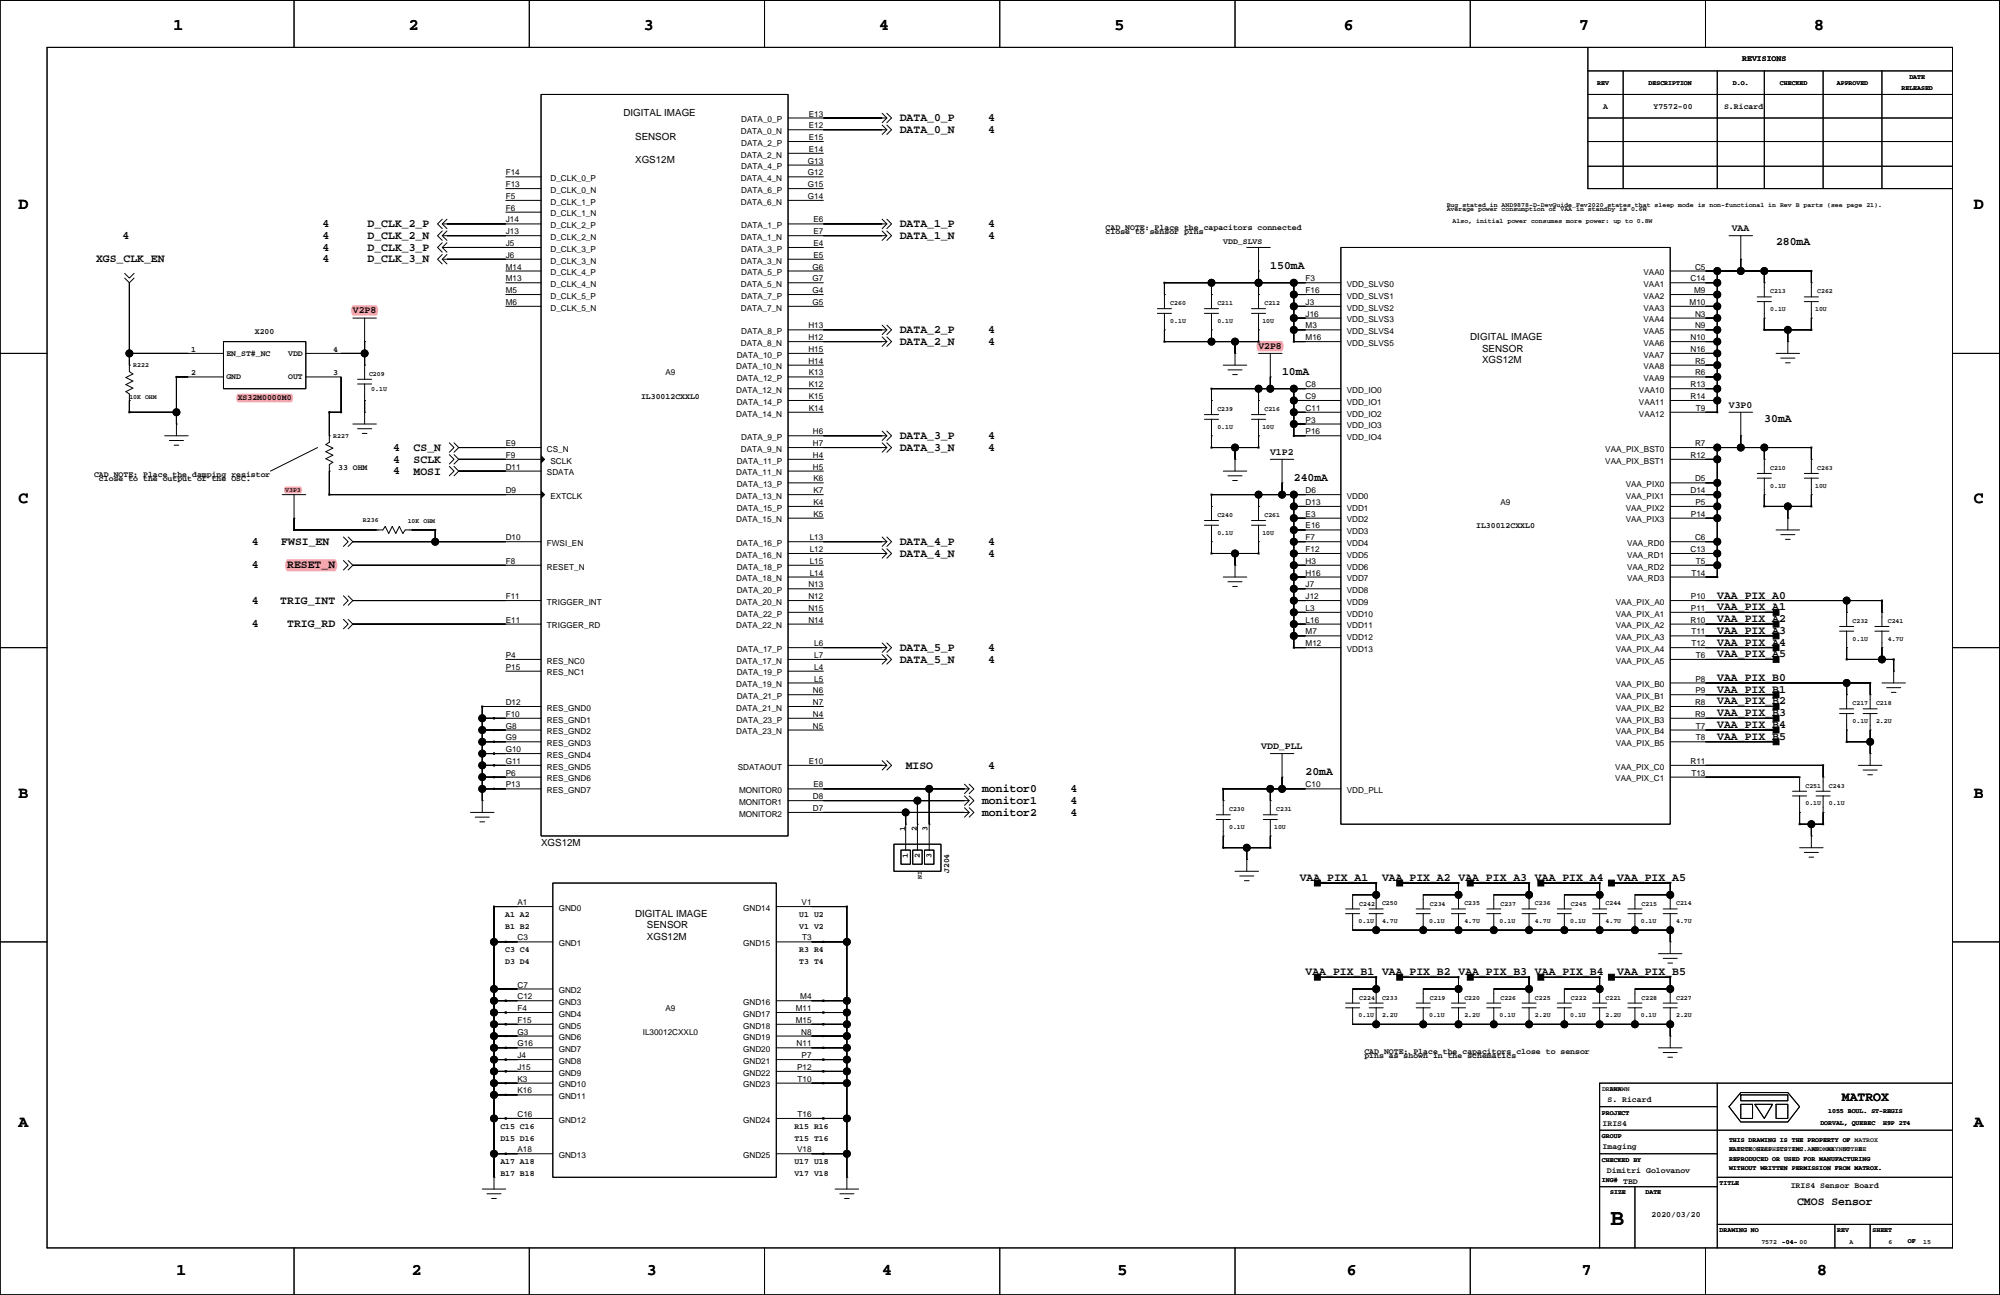
[picture p56: page 6]

Bug stated in AND9878-D-DevGuide_Fev2020 states that sleep mode is non-functional in Rev B parts (see page 21). Average power consumption of VAA in standby is 0.6W

CAD NOTE: Place the capacitors connected close to sensor pins

Also, initial power consumes more power: up to 0.8W

CAD NOTE: Place the damping resistor close to the output of the OSC.

CAD NOTE: Place the capacitors close to sensor pins as shown in the schematics

THIS DRAWING IS THE PROPERTY OF
MATROX GRAPHICS INC. AND MAY NOT BE
REPRODUCED OR USED FOR MANUFACTURING
WITHOUT WRITTEN PERMISSION FROM MATROX.

THIS DRAWING IS THE PROPERTY OF MATROX
ELECTRONICS SYSTEMS AND MAY NOT BE

D

D

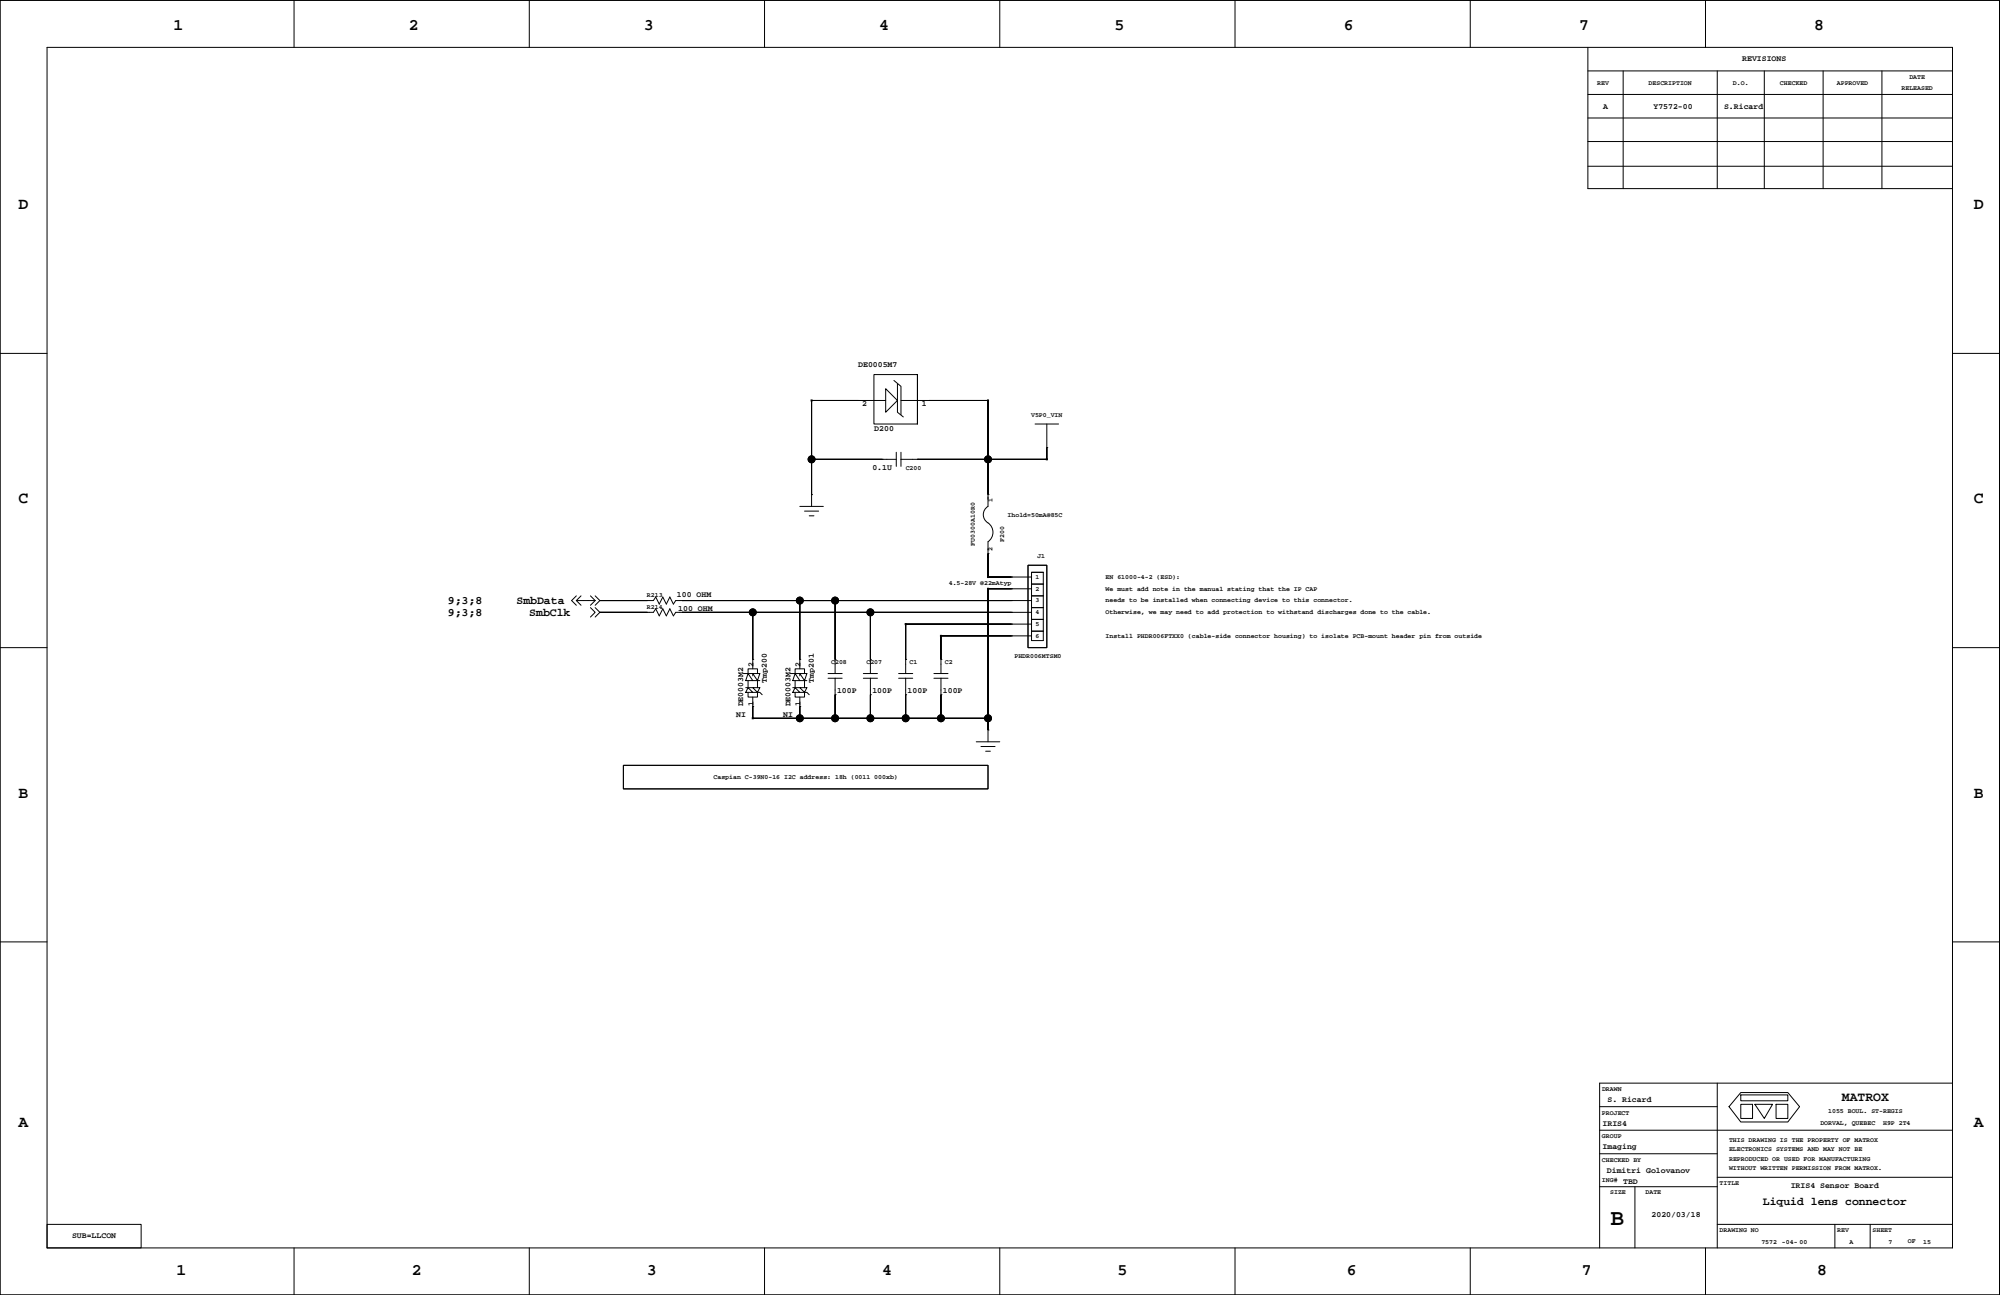
[picture p57: page 7]

EN 61000-4-2 (ESD):
We must add note in the manual stating that the IP CAP
needs to be installed when connecting device to this connector.
Otherwise, we may need to add protection to withstand discharges done to the cable.

Install PHDR006FTXX0 (cable-side connector housing) to isolate PCB-mount header pin from outside

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

D

D

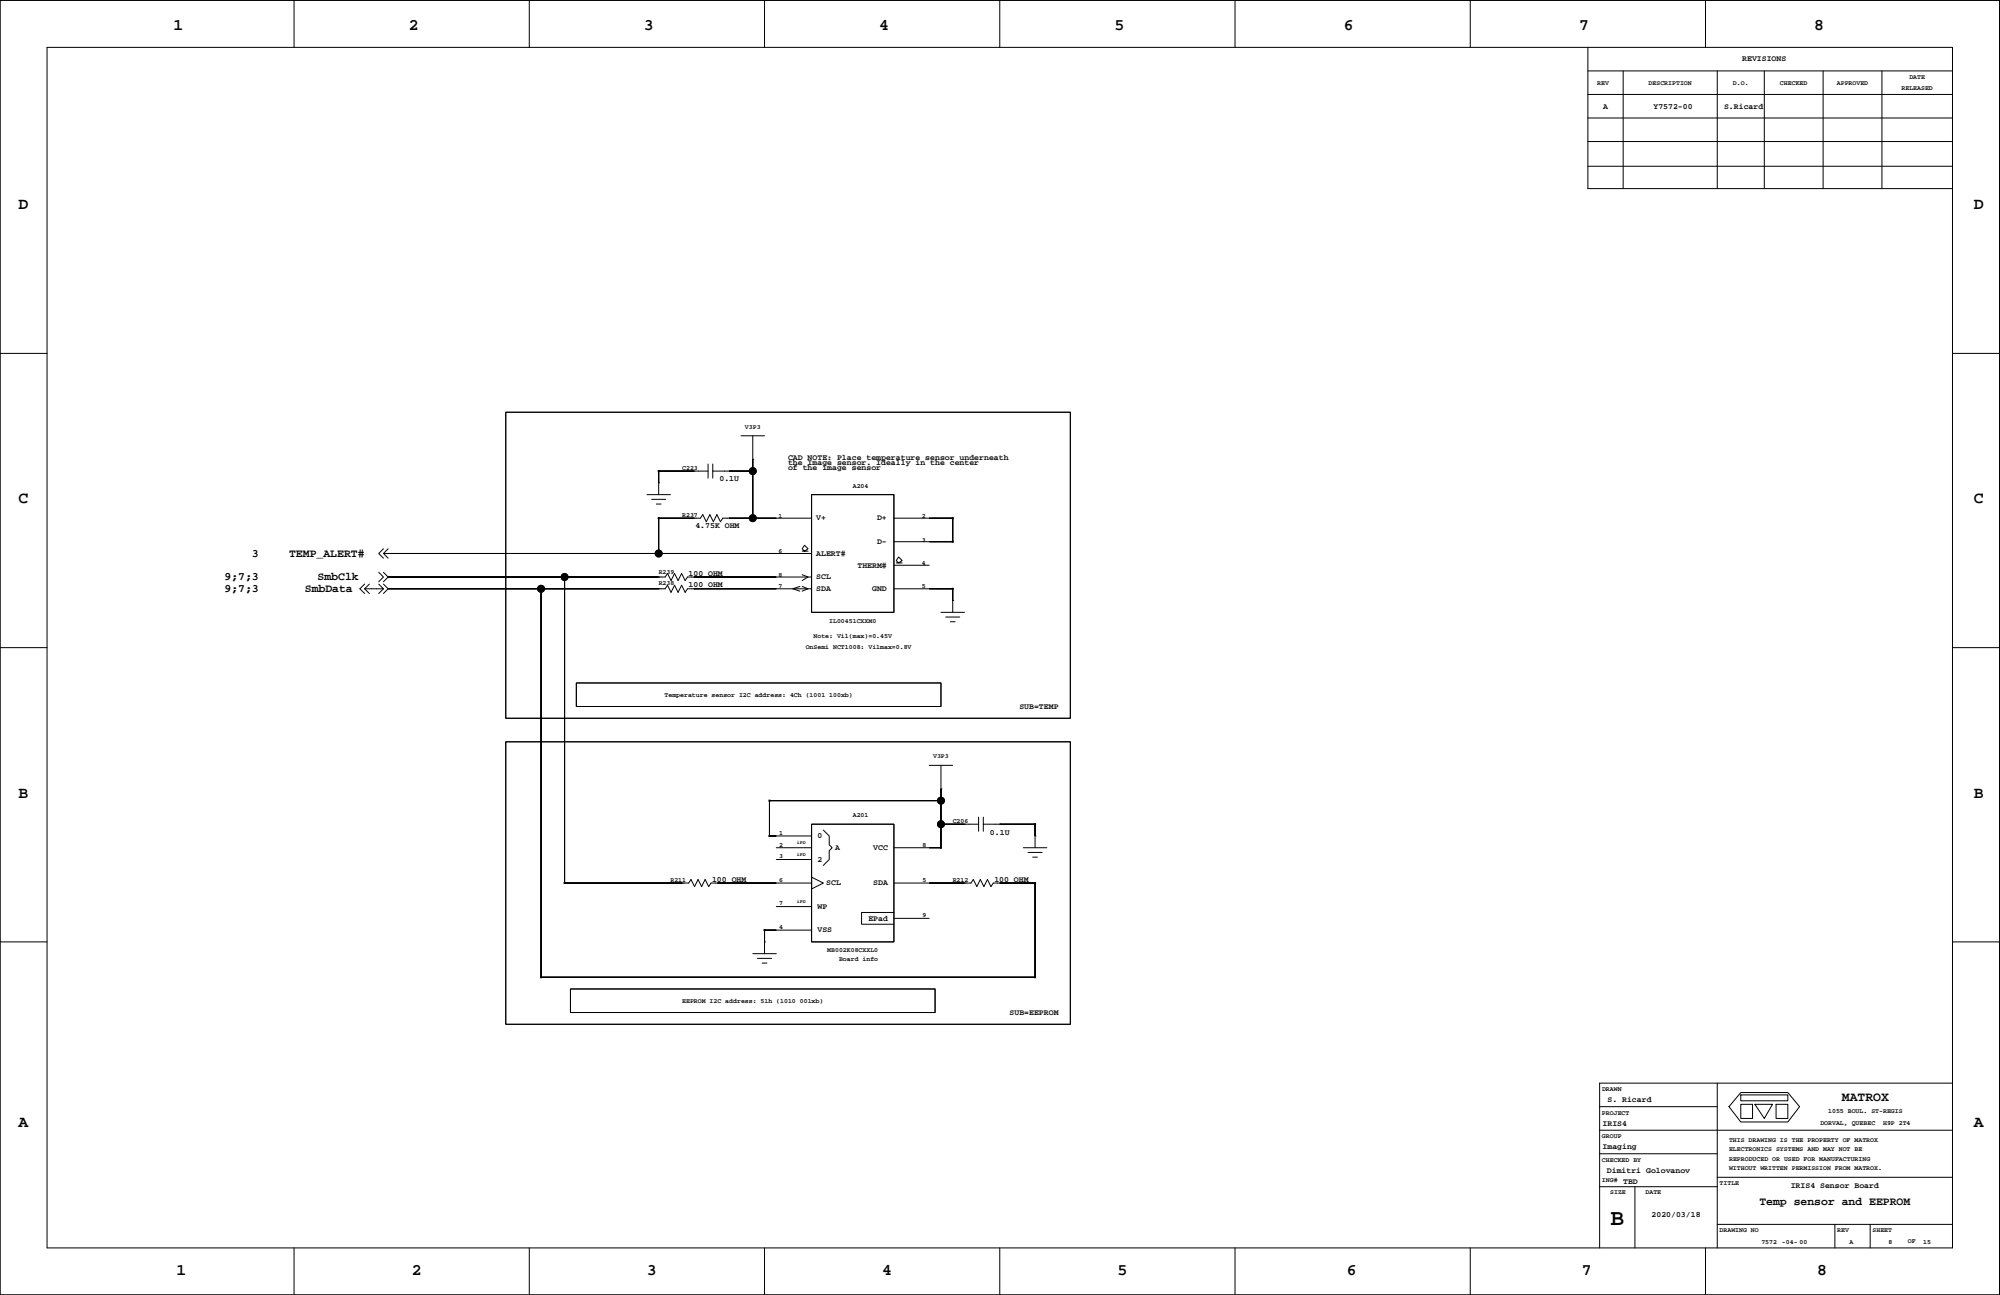
[picture p58: page 8]
SUB=EEPROM; EEPROM I2C address: 51h (1010 001xb); iPD; SUB=TEMP; EPad; VCC; SCL; SDA; VSS; MB002K08CXXL0; GND; ALERT#; THERM#; IL00451CXXM0; DRAWN; PROJECT; GROUP; ING#; MATROX; CHECKED BY; SmbData; SmbClk; TEMP_ALERT#; S. Ricard; Dimitri Golovanov; Imaging; IRIS4; TBD; Board info; 100 OHM; 4.75K OHM

CAD NOTE: Place temperature sensor underneath the Image sensor. Ideally in the center of the image sensor

Note: Vil(max)=0.45V
OnSemi NCT1008: Vilmax=0.8V

Temperature sensor I2C address: 4Ch (1001 100xb)

1055 BOUL. ST-REGIS
DORVAL, QUEBEC H9P 2T4

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

Temp sensor and EEPROM

D

D

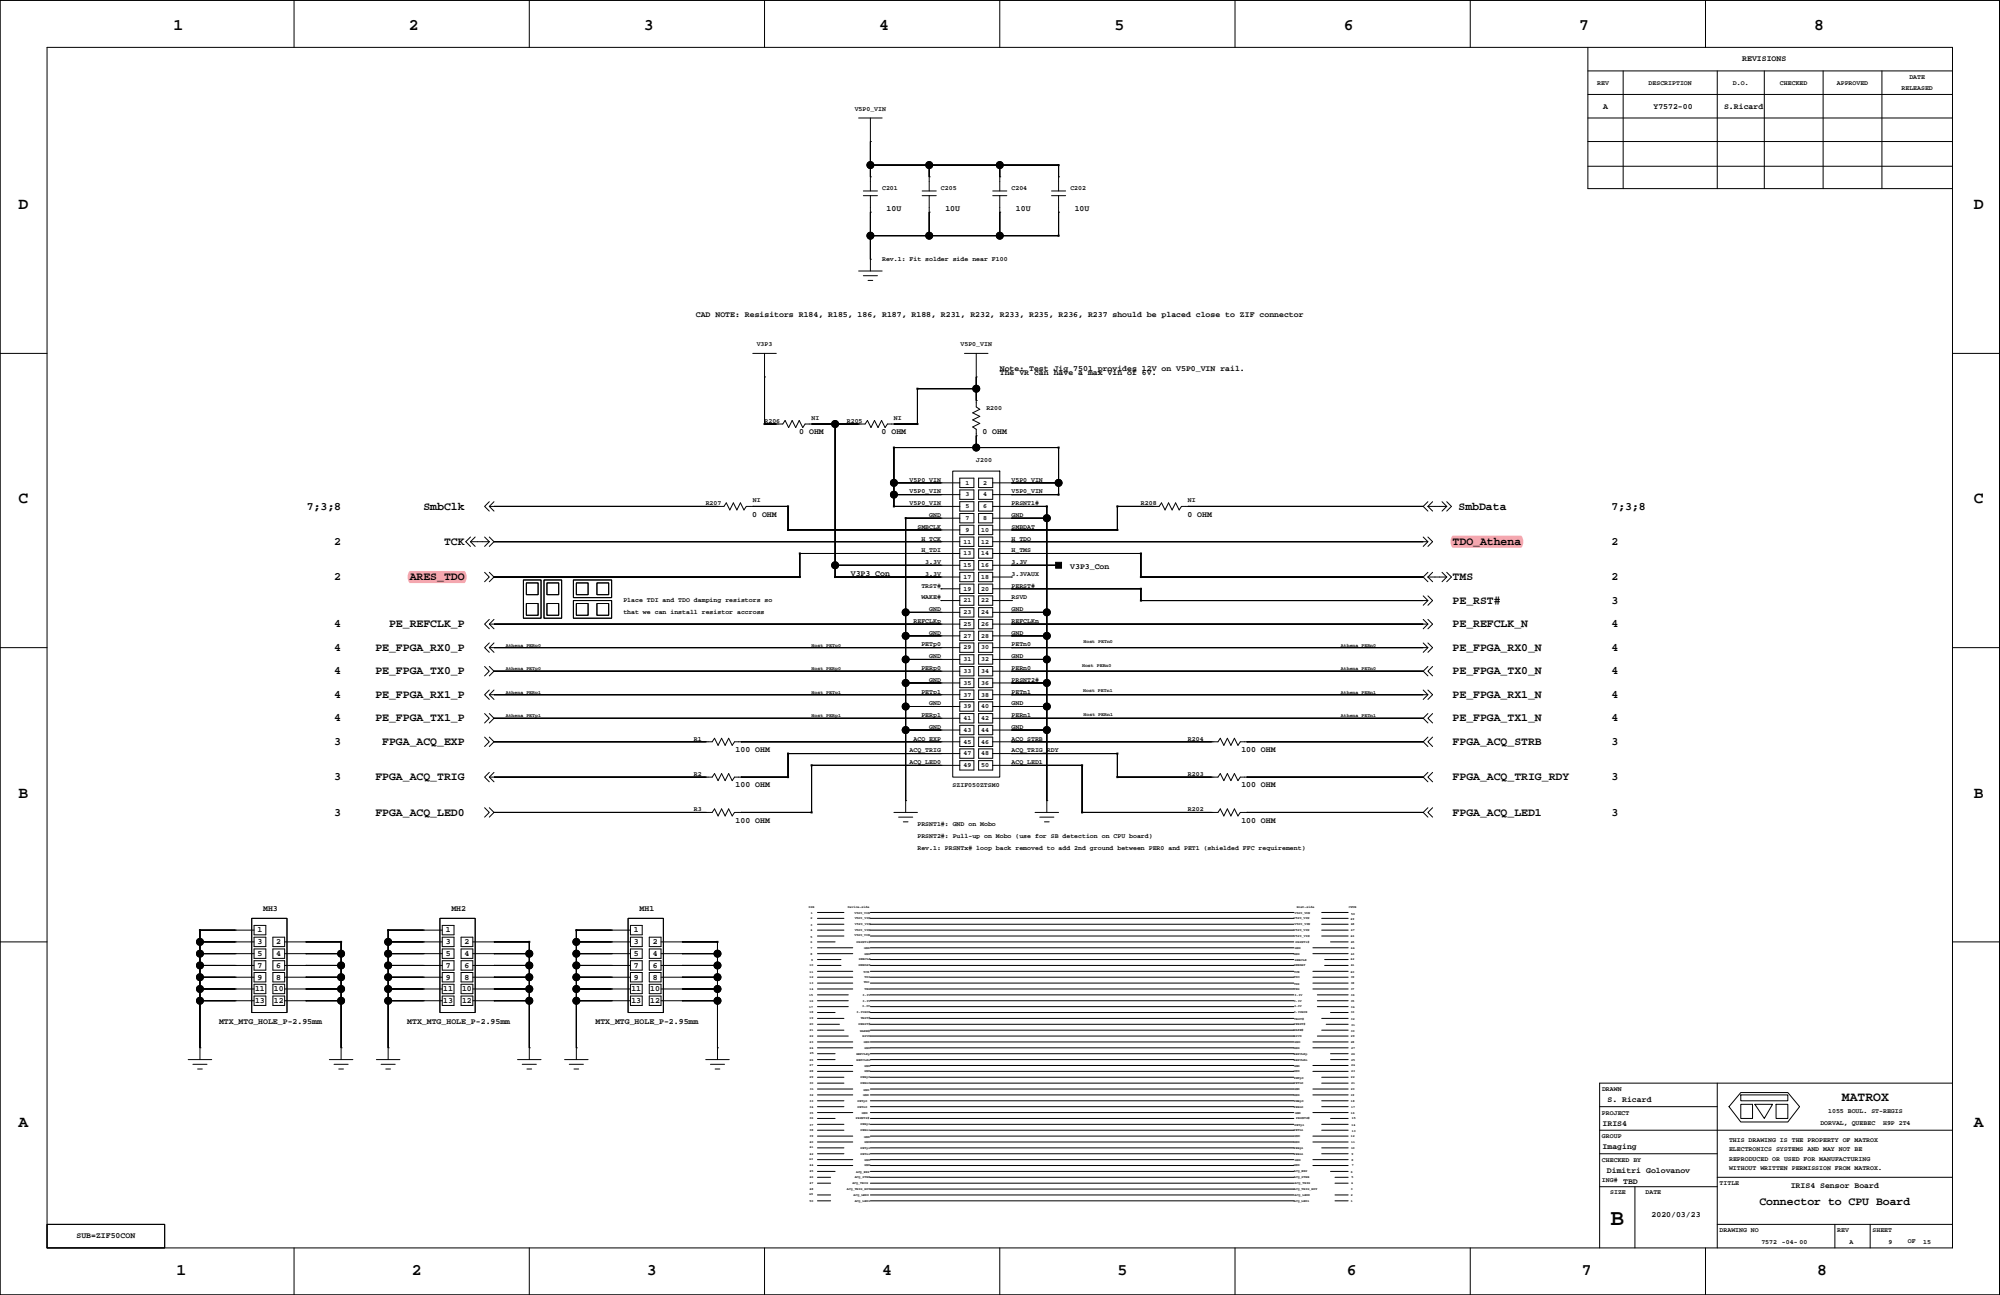
[picture p59: page 9]

Rev.1: Fit solder side near F100

CAD NOTE: Resisitors R184, R185, 186, R187, R188, R231, R232, R233, R235, R236, R237 should be placed close to ZIF connector

Note: Test Jig 7501 provides 12V on V5P0_VIN rail. The VR can have a max Vin of 6V.

Place TDI and TDO damping resistors so
that we can install resistor accross

PRSNT1#: GND on Mobo
PRSNT2#: Pull-up on Mobo (use for SB detection on CPU board)
Rev.1: PRSNTx# loop back removed to add 2nd ground between PER0 and PET1 (shielded FFC requirement)

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

Connector to CPU Board

D

D

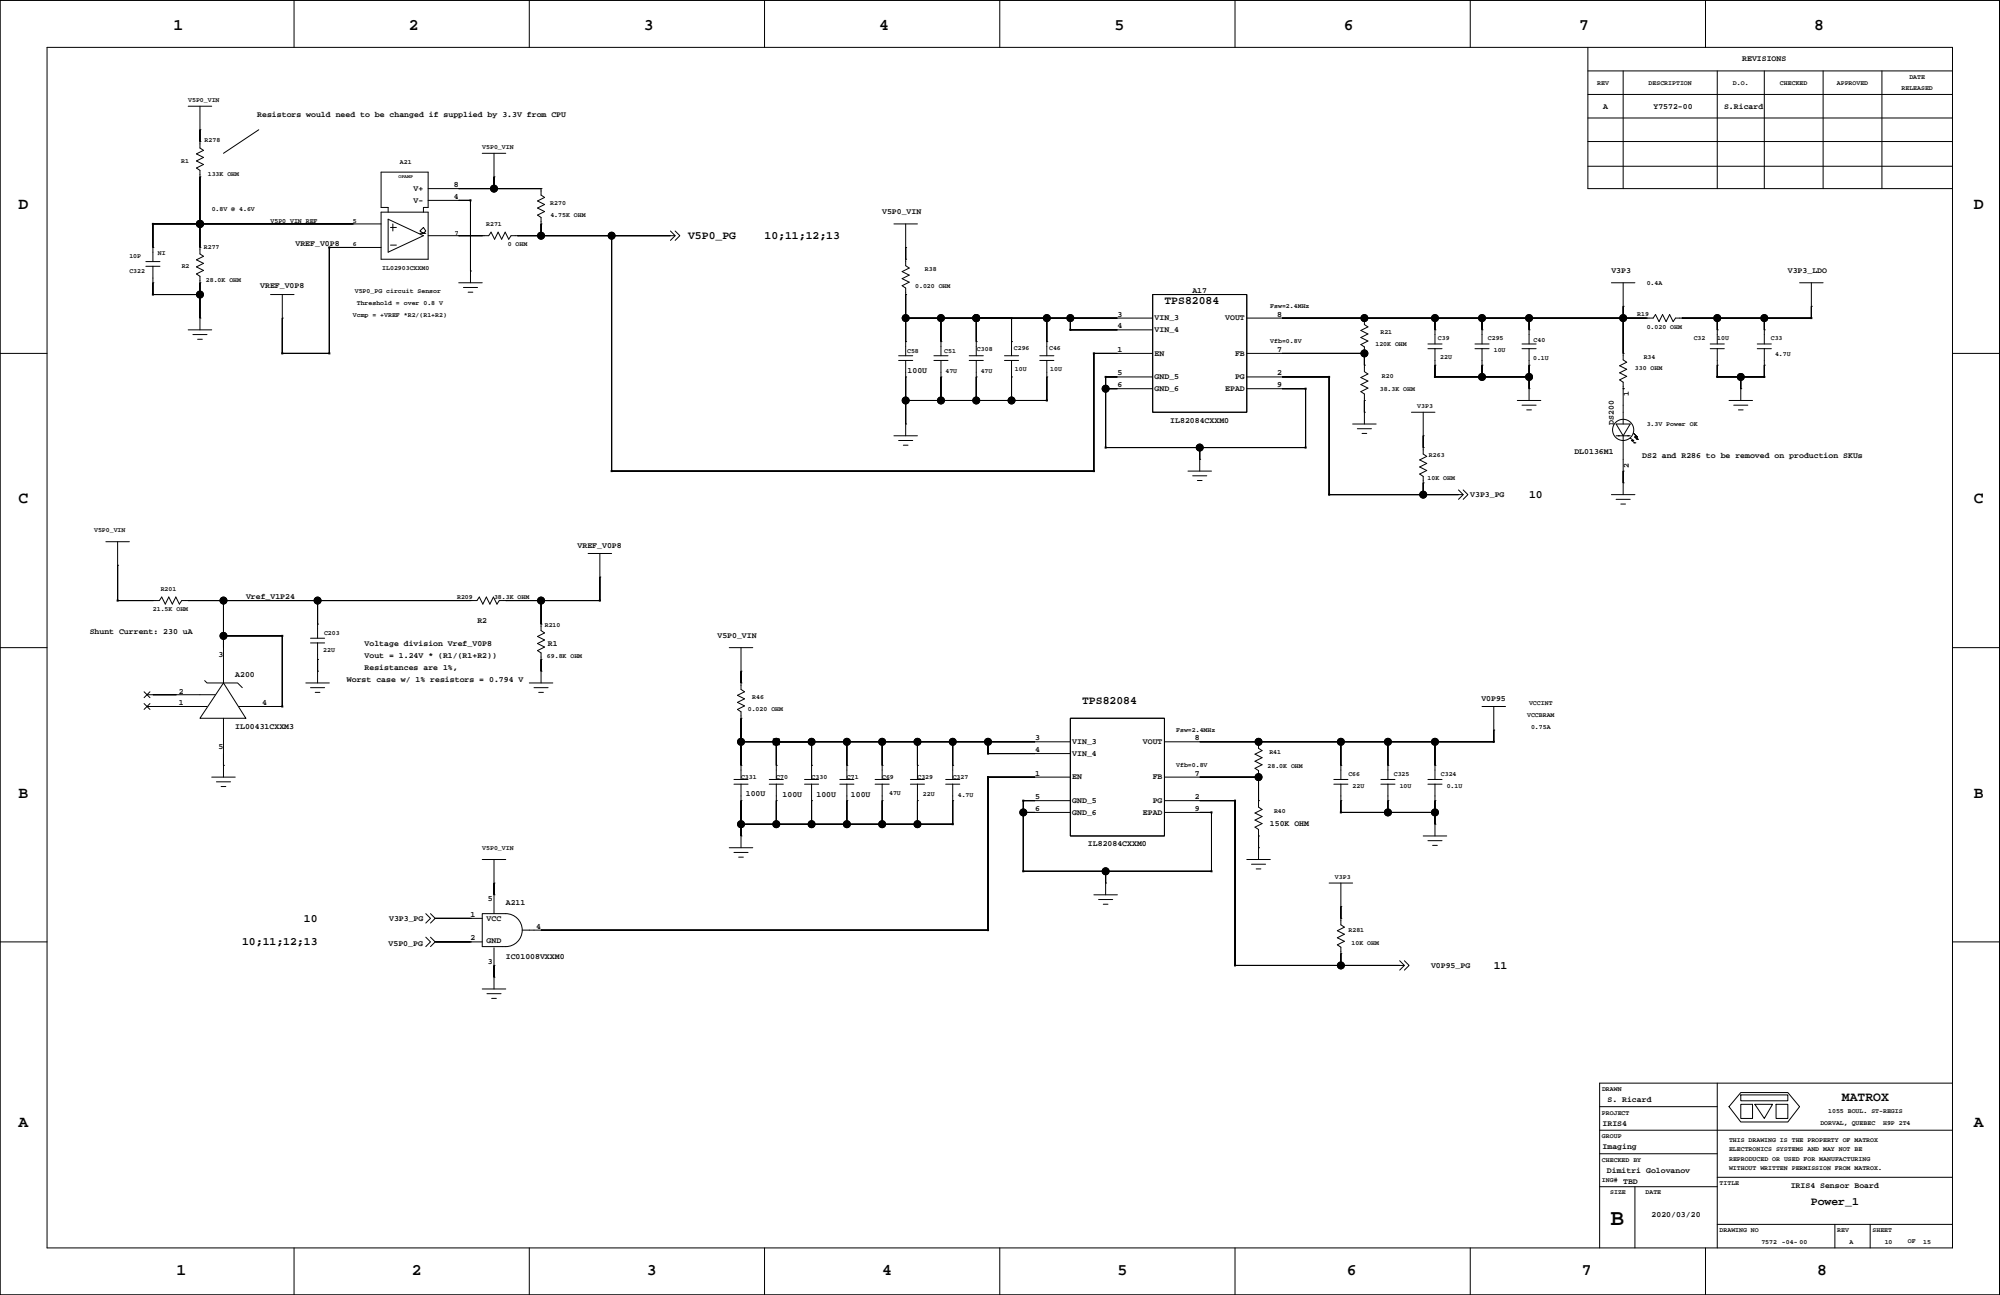
[picture p60: page 10]

Resistors would need to be changed if supplied by 3.3V from CPU

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

D

D

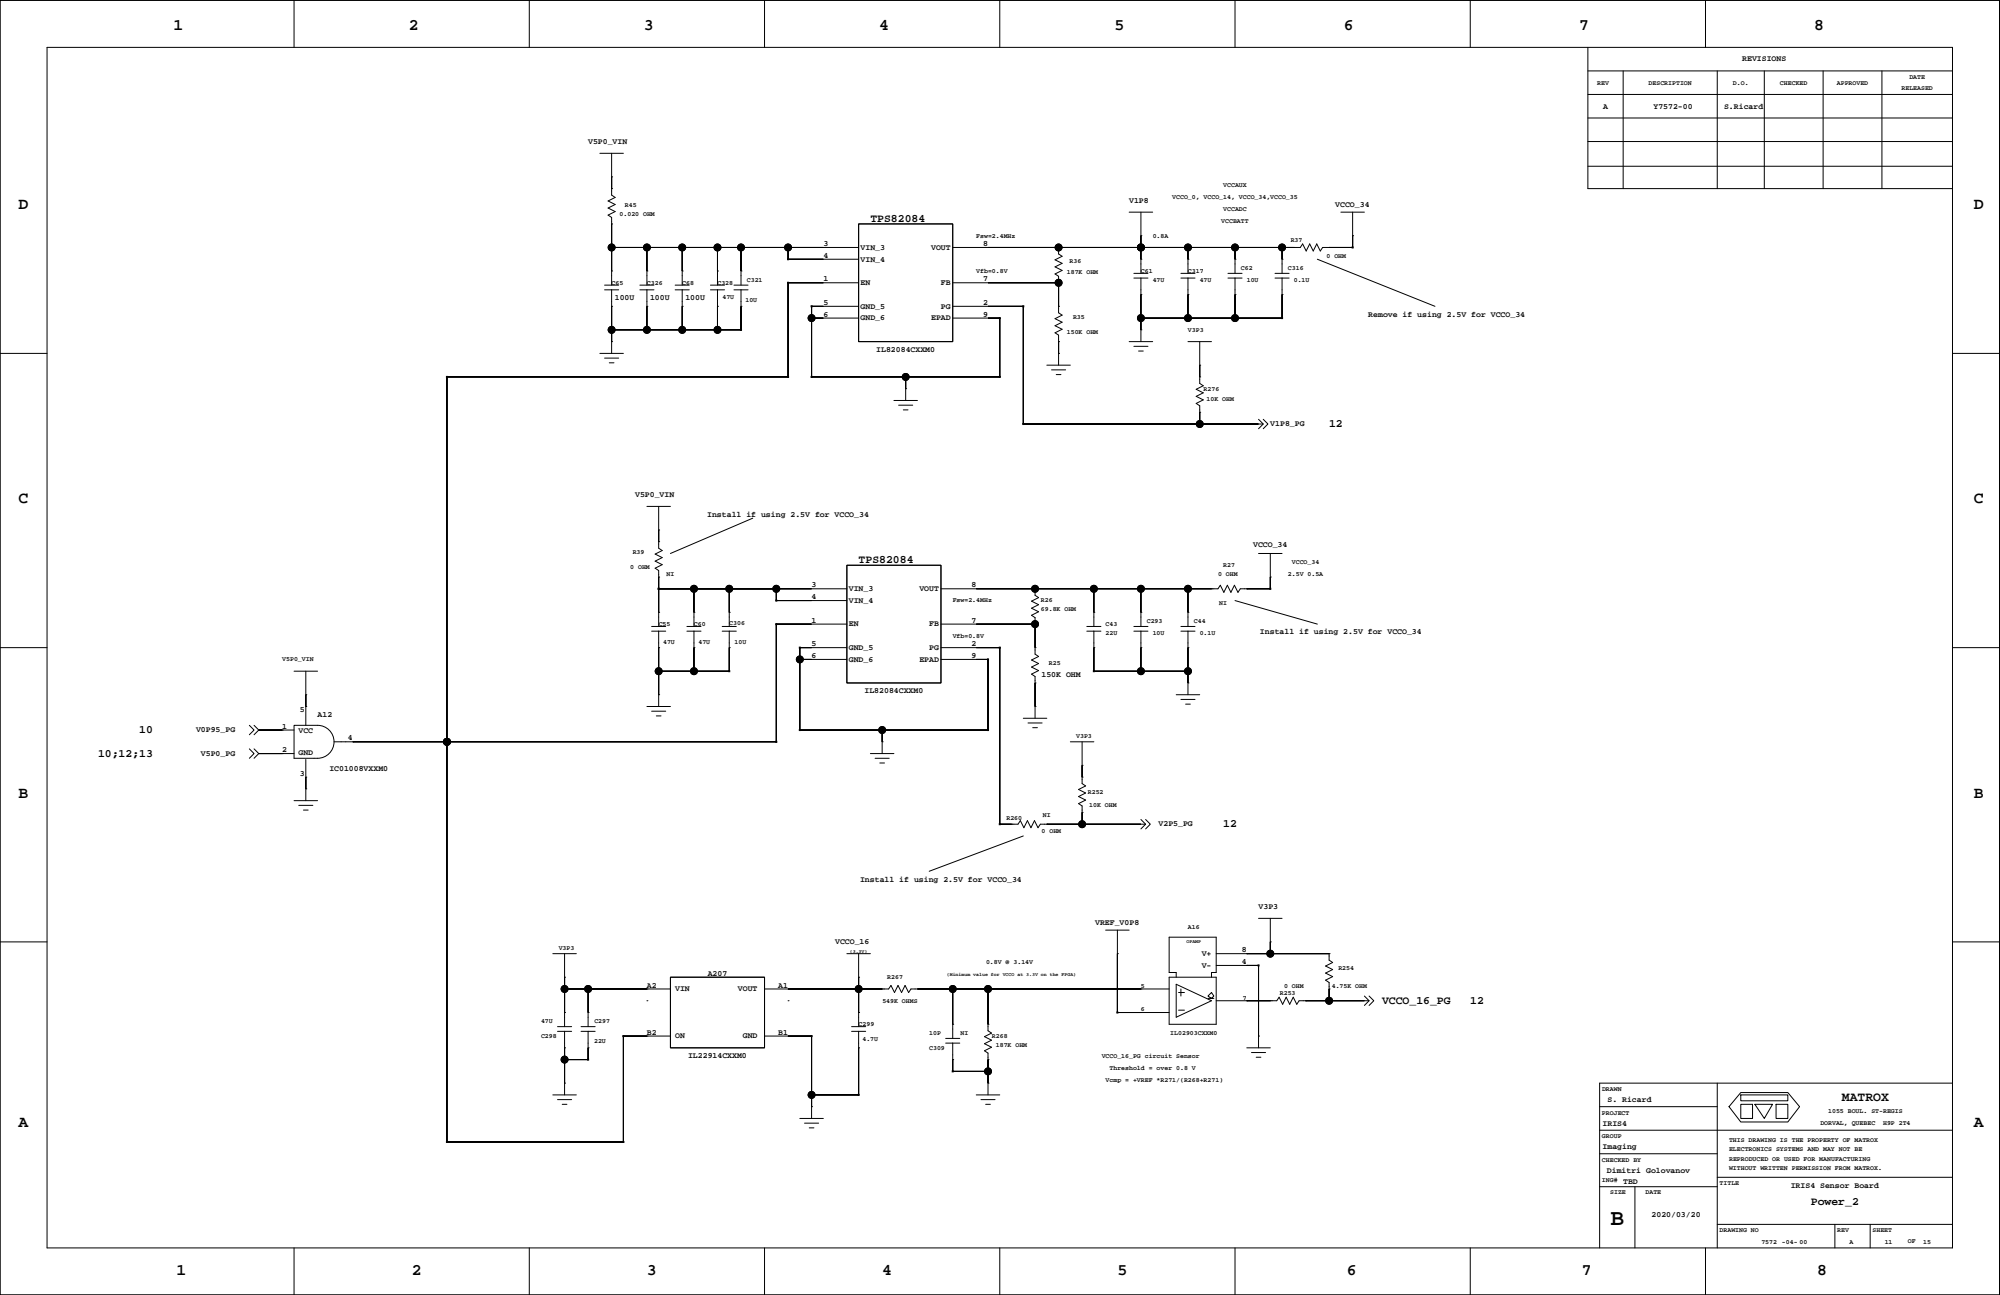
[picture p61: page 11]

V1P8 VCCO_0, VCCO_14, VCCO_34,VCCO_35 R45 VCCO_34 VCCADC

Remove if using 2.5V for VCCO_34

Install if using 2.5V for VCCO_34

(Minimum value for VCCO at 3.3V on the FPGA)

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

D

D

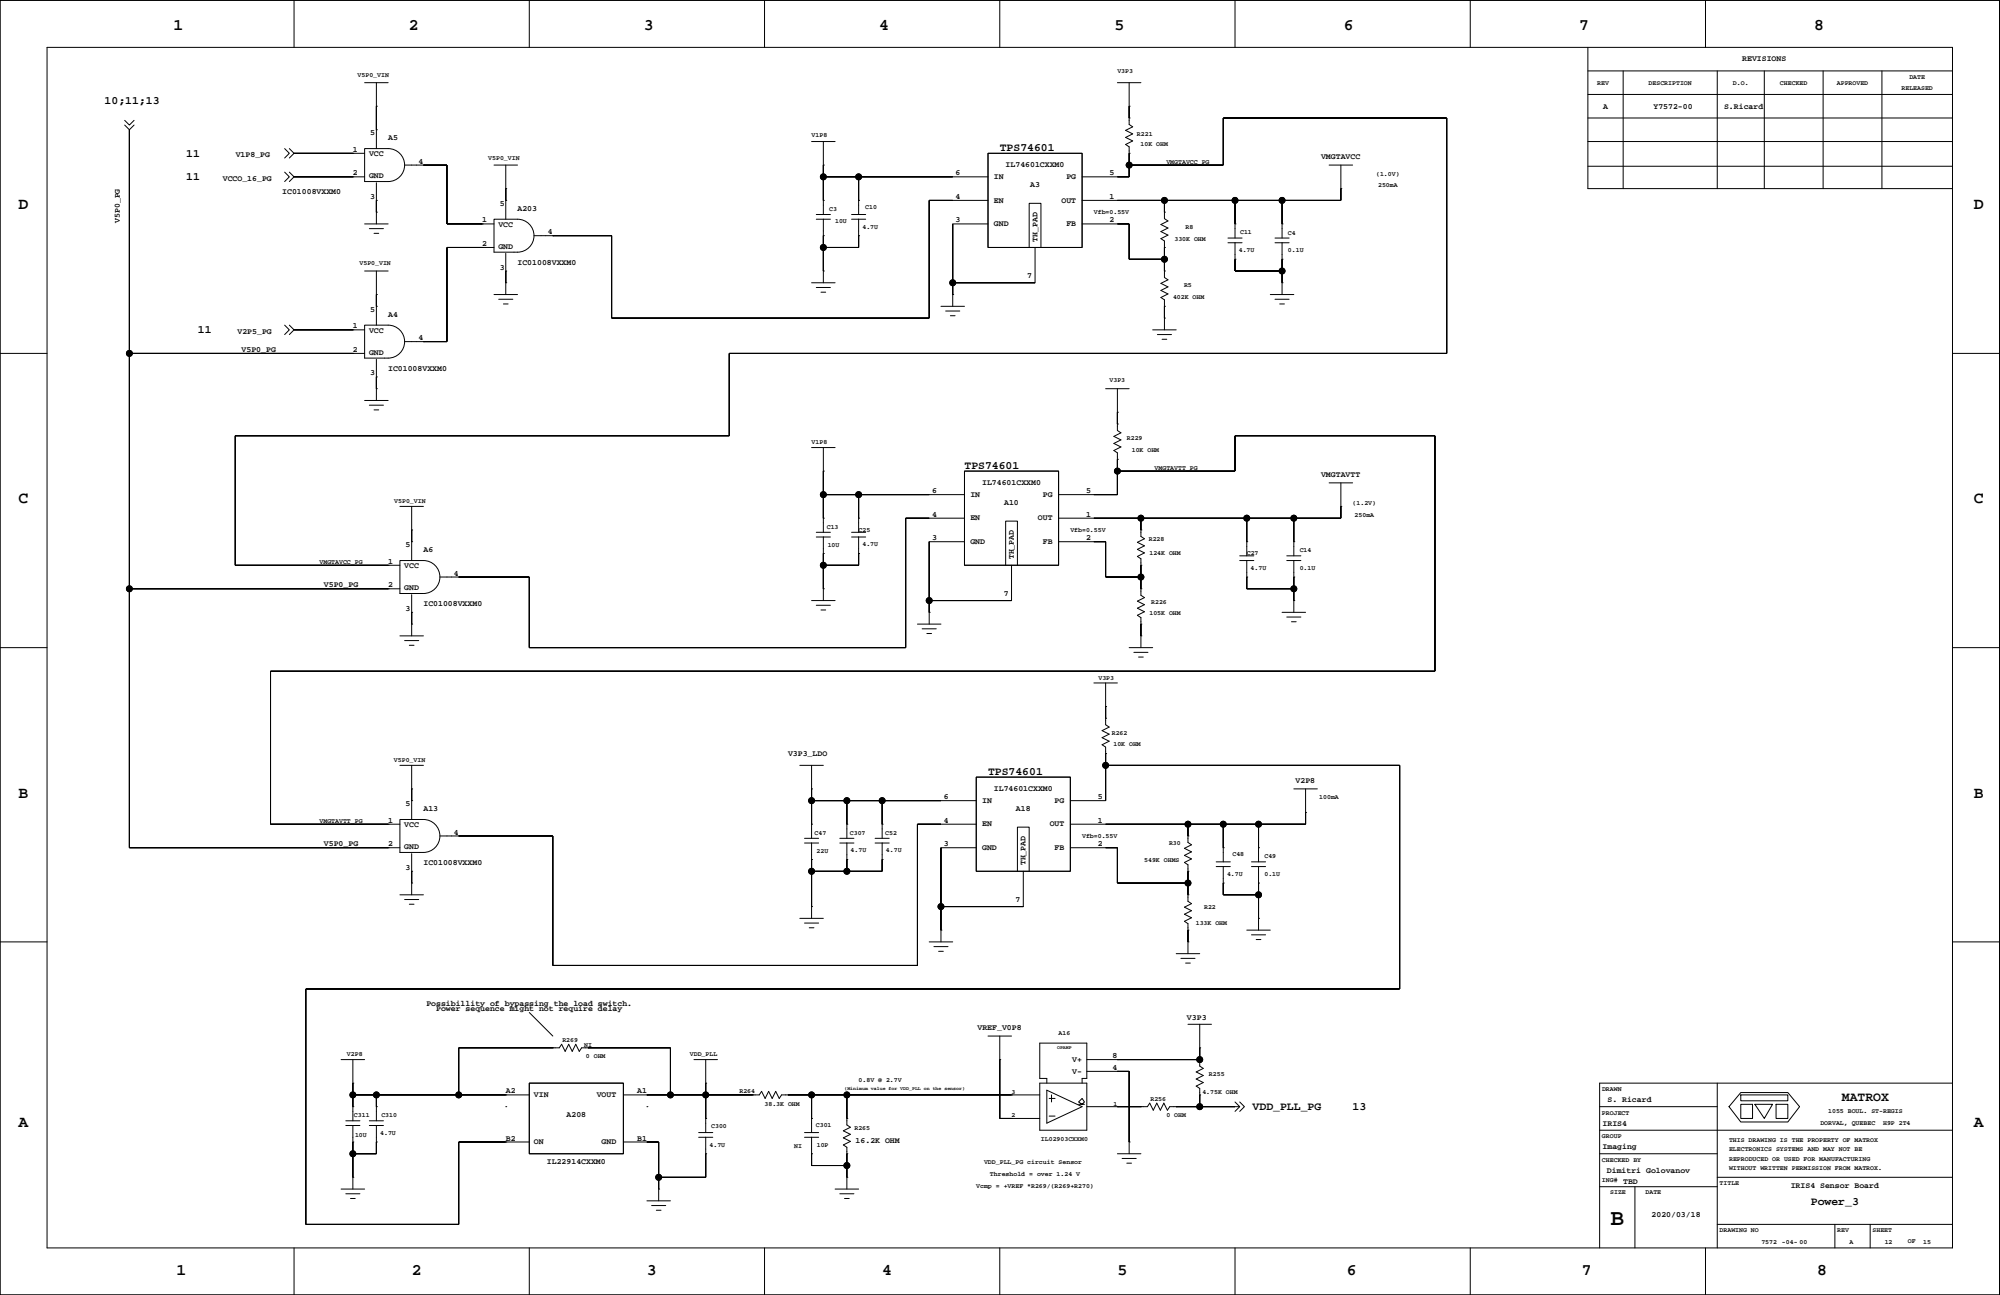
[picture p62: page 12]

Possibillity of bypassing the load switch. Power sequence might not require delay

(Minimum value for VDD_PLL on the sensor)

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

D

D

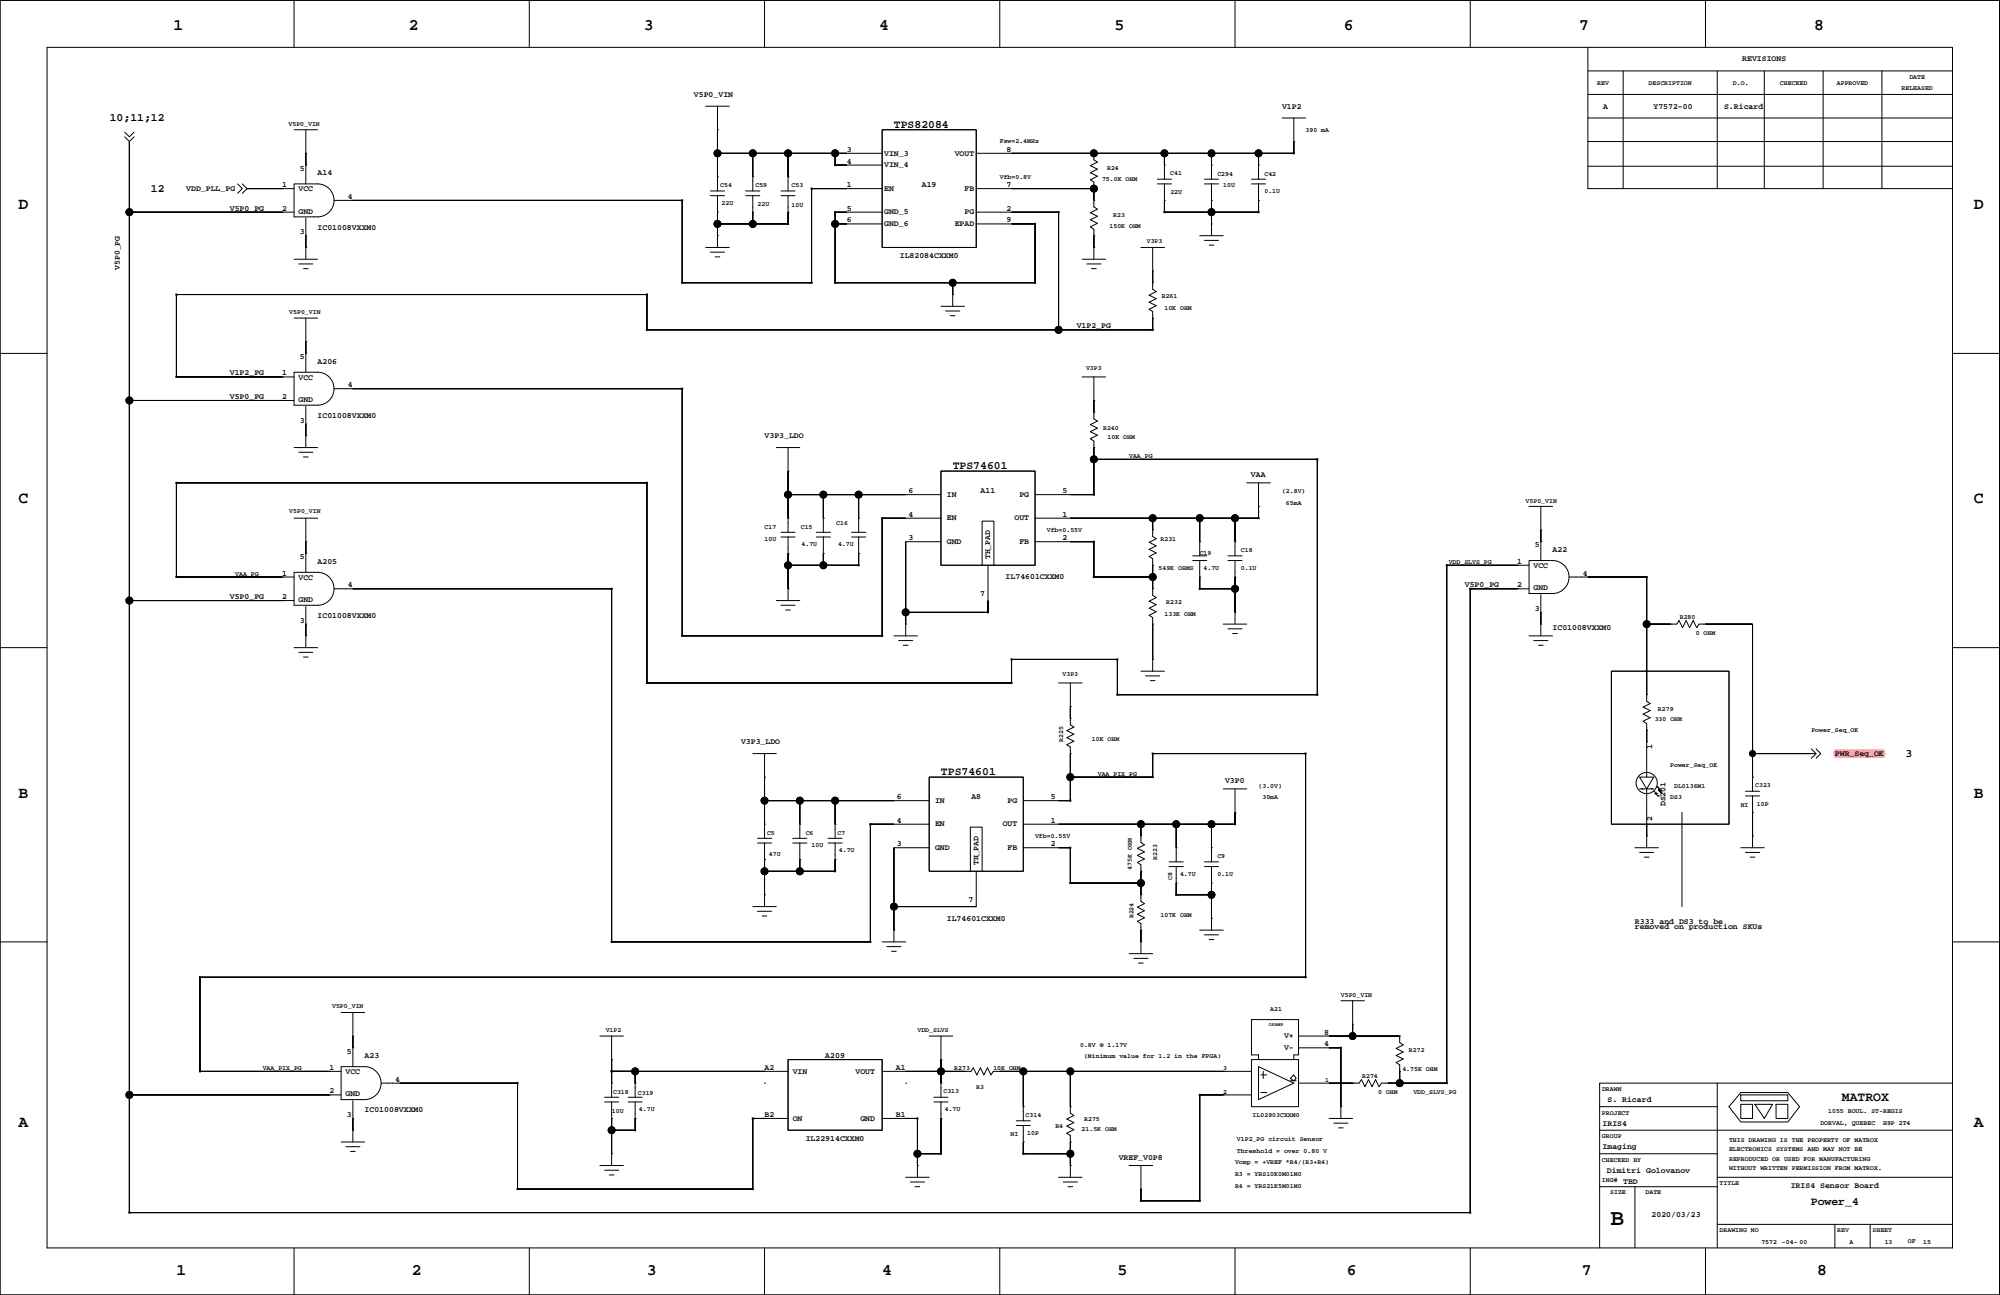
[picture p63: page 13]

R333 and DS3 to be
removed on production SKUs

(Minimum value for 1.2 in the FPGA)

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

D

D

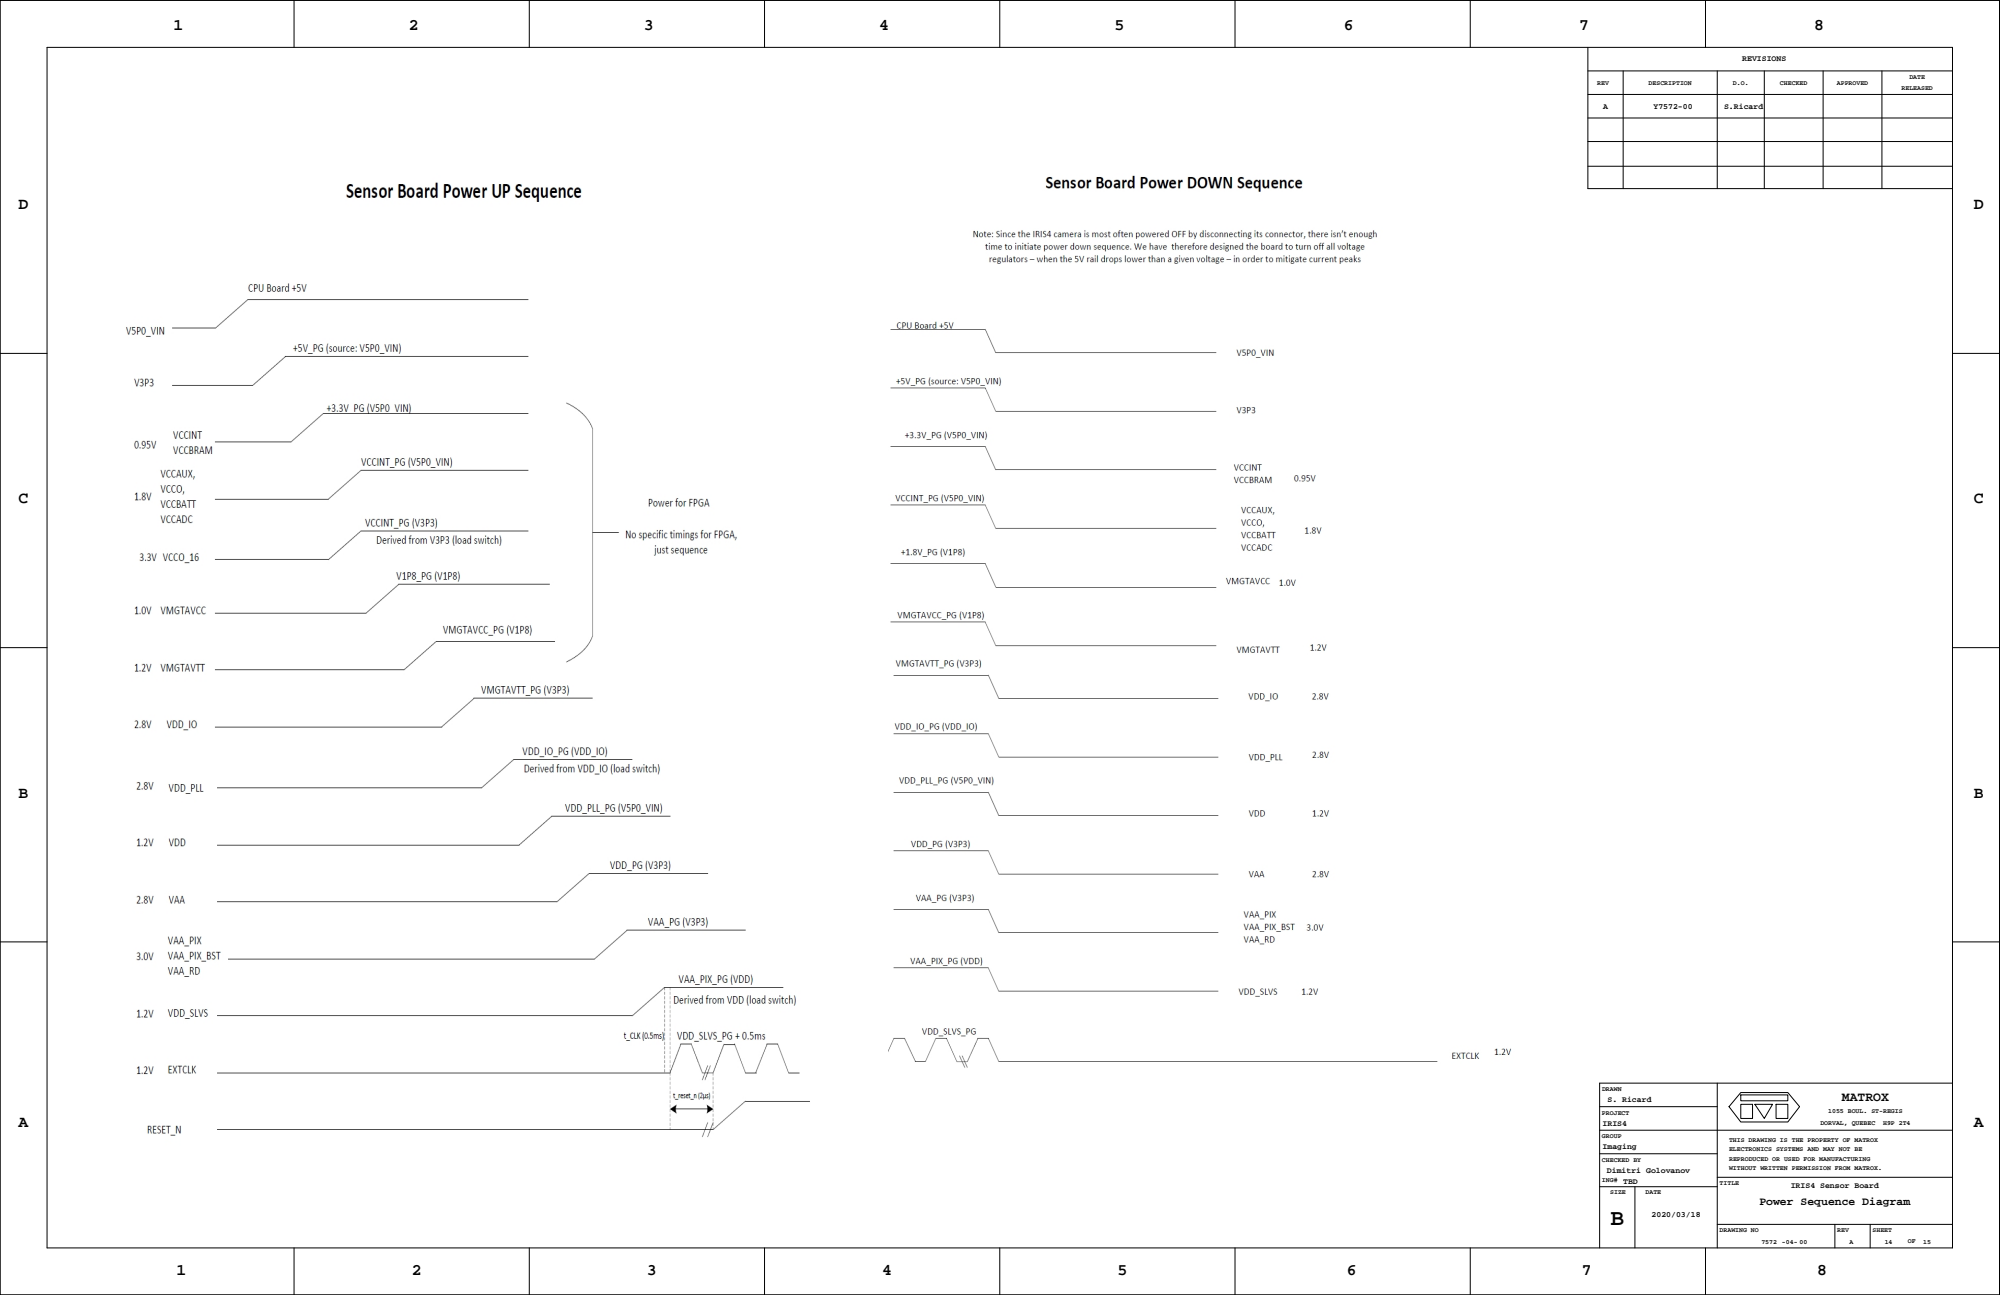
[picture p64: page 14]
DRAWN; PROJECT; GROUP; ING#; MATROX; CHECKED BY; S. Ricard; Dimitri Golovanov; Imaging; IRIS4; TBD

1055 BOUL. ST-REGIS
DORVAL, QUEBEC H9P 2T4

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

Power Sequence Diagram

2

1

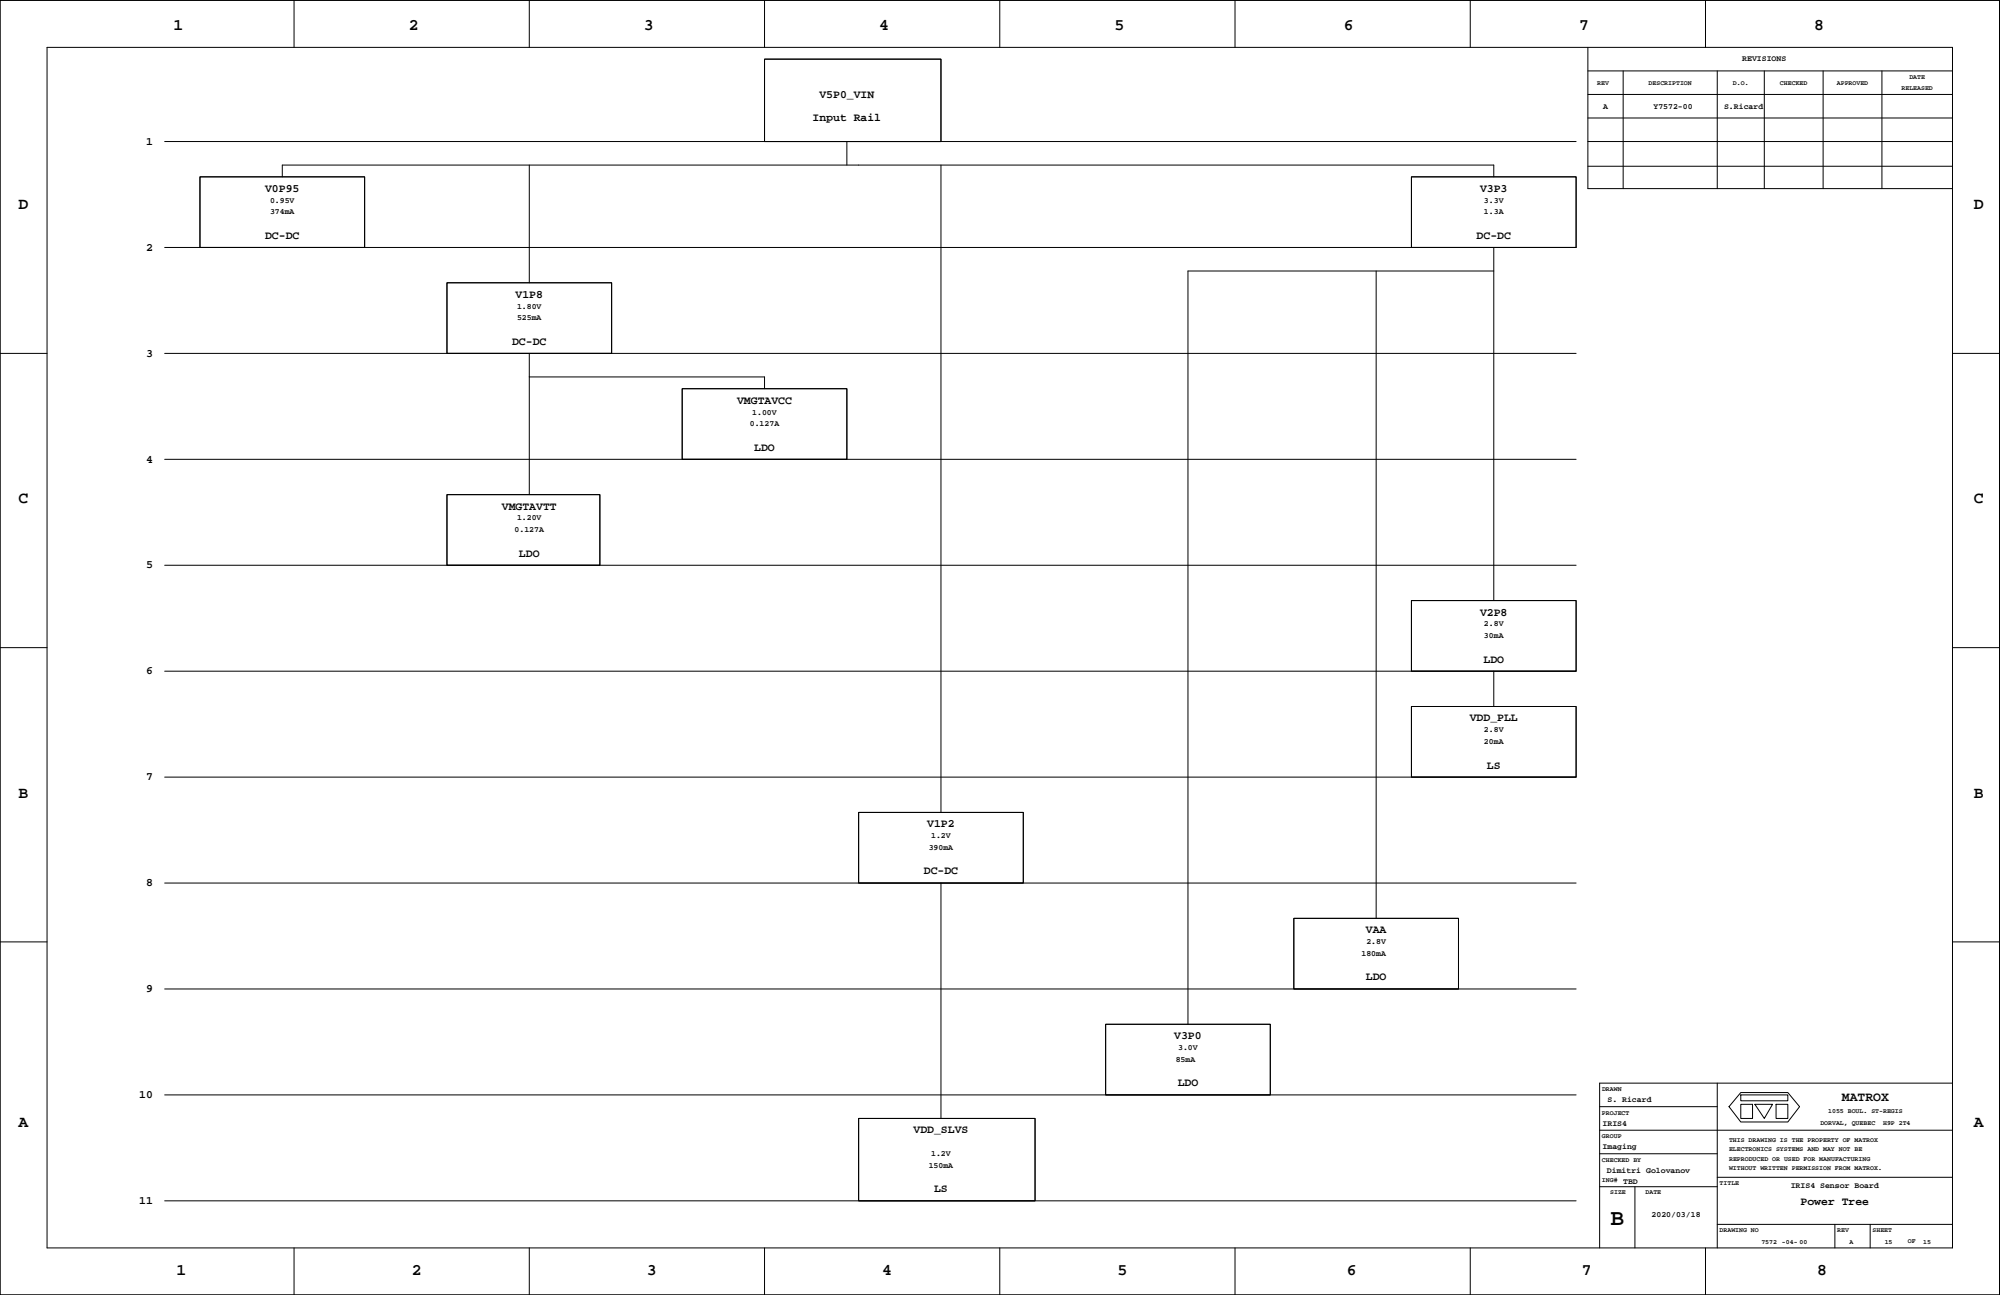
[picture p65: page 15]
LDO; VAA; VMGTAVTT; Input Rail; V5P0_VIN; DRAWN; PROJECT; GROUP; ING#; MATROX; CHECKED BY; VMGTAVCC; VDD_SLVS; S. Ricard; Dimitri Golovanov; Imaging; IRIS4; TBD; Power Tree; VDD_PLL

1055 BOUL. ST-REGIS
DORVAL, QUEBEC H9P 2T4

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
