AM4511/test_migrate_iris4/athena/doc/iris3/7478_01 (Iris3 CPU Board R1.30 - Signed).pdf

D

1 | 2 | 3 | 4

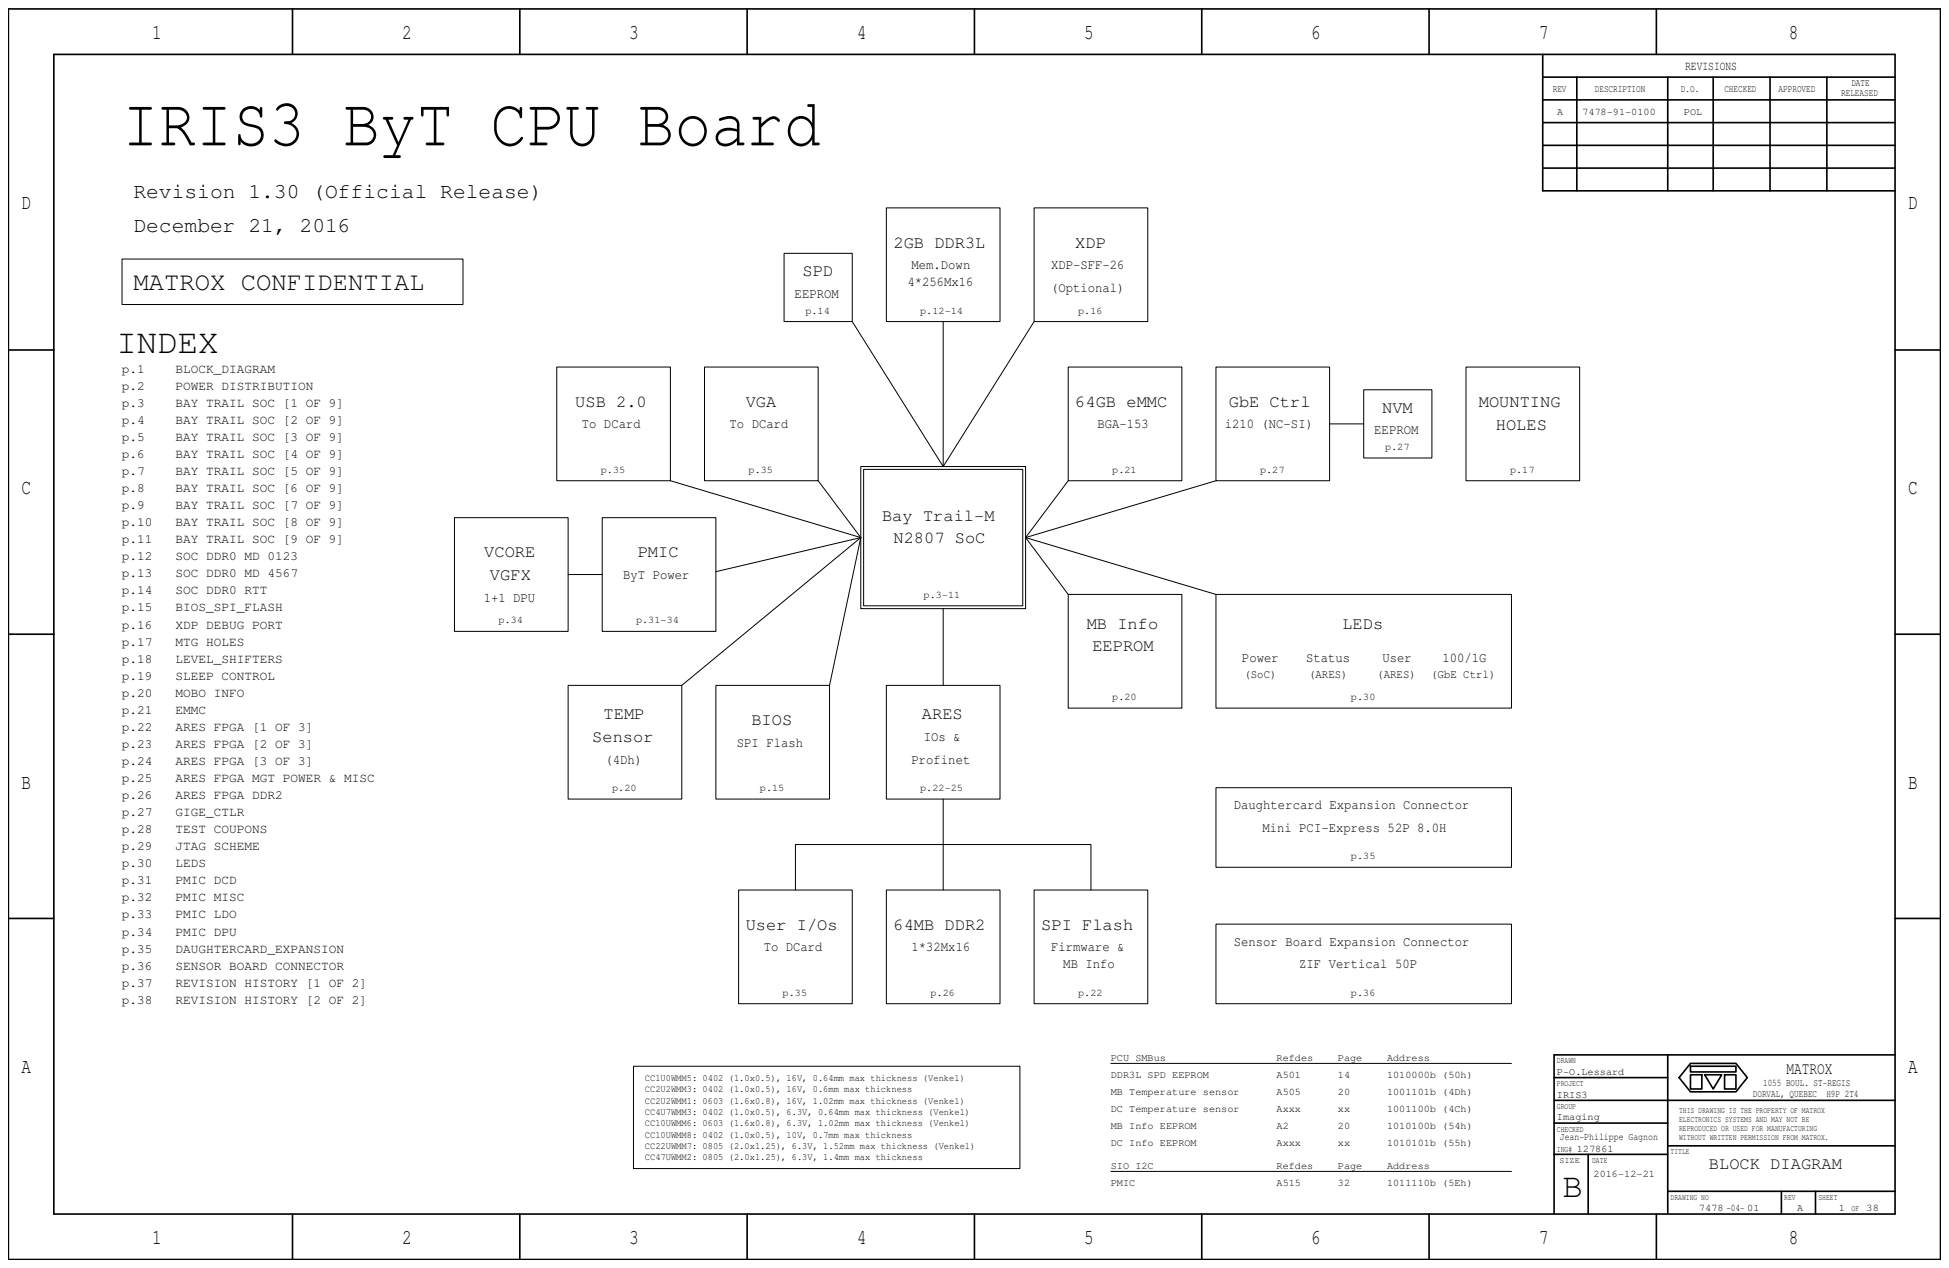
[picture p66: page 1]
P-O.Lessard; IRIS3; Imaging; Jean-Philippe Gagnon; GROUP; DRAWN; CHECKED; PROJECT; ING#; TITLE; MATROX; Bay Trail-M; 2GB DDR3L; N2807 SoC; 64MB DDR2; BLOCK_DIAGRAM; GIGE_CTLR; TEST COUPONS; JTAG SCHEME; LEDS; PMIC DCD; PMIC MISC; PMIC LDO; PMIC DPU; DAUGHTERCARD_EXPANSION; SENSOR BOARD CONNECTOR; REVISION HISTORY [1 OF 2]; REVISION HISTORY [2 OF 2]; POWER DISTRIBUTION; BAY TRAIL SOC [1 OF 9]; BAY TRAIL SOC [2 OF 9]; BAY TRAIL SOC [3 OF 9]; BAY TRAIL SOC [4 OF 9]; BAY TRAIL SOC [5 OF 9]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

REVISIONS

DESCRIPTION | D.O. | CHECKED | APPROVED | DATE RELEASED

IRIS3 ByT CPU Board

A | 7478-91-0100 | POL

Revision 1.30 (Official Release)
December 21, 2016

Daughtercard Expansion Connector

Mini PCI-Express 52P 8.0H

Sensor Board Expansion Connector

CC1U0WMM5: 0402 (1.0x0.5), 16V, 0.64mm max thickness (Venkel)
CC2U2WMM3: 0402 (1.0x0.5), 16V, 0.6mm max thickness
CC2U2WMM1: 0603 (1.6x0.8), 16V, 1.02mm max thickness (Venkel)
CC4U7WMM3: 0402 (1.0x0.5), 6.3V, 0.64mm max thickness (Venkel)
CC10UWMM6: 0603 (1.6x0.8), 6.3V, 1.02mm max thickness (Venkel)
CC10UWMM8: 0402 (1.0x0.5), 10V, 0.7mm max thickness
CC22UWMM7: 0805 (2.0x1.25), 6.3V, 1.52mm max thickness (Venkel)
CC47UWMM2: 0805 (2.0x1.25), 6.3V, 1.4mm max thickness

1055 BOUL. ST-REGIS
DORVAL, QUEBEC H9P 2T4

THIS DRAWING IS THE PROPERTY OF MATROX
ELECTRONICS SYSTEMS AND MAY NOT BE
REPRODUCED OR USED FOR MANUFACTURING
WITHOUT WRITTEN PERMISSION FROM MATROX.
BLOCK DIAGRAM

SIZE B | DATE 2016-12-21

DRAWING NO 7478 01 -04- | REV A | SHEET 1 OF 38

D

1 | 2 | 3 | 4

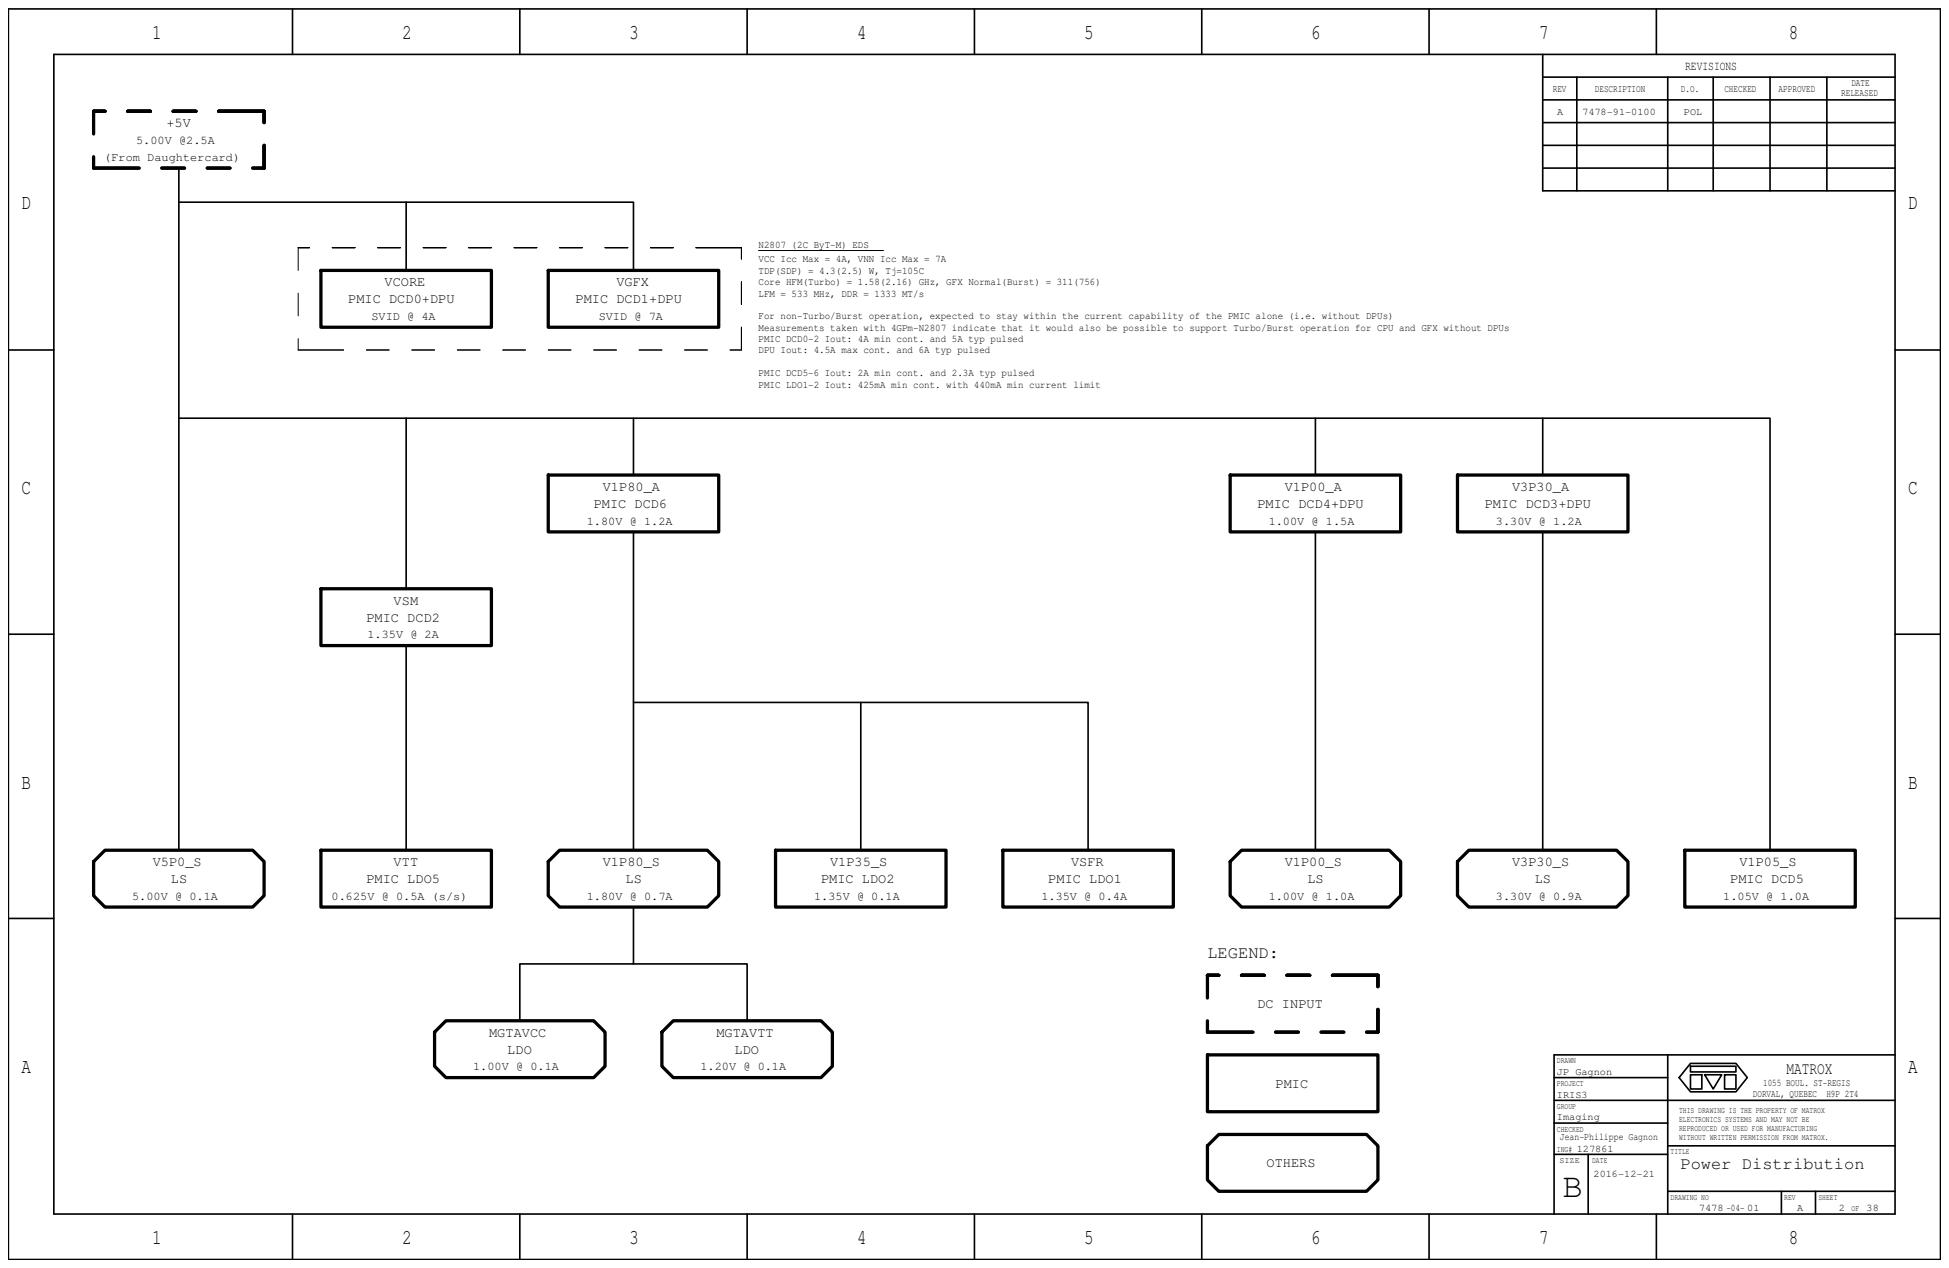
[picture p67: page 2]
JP Gagnon; IRIS3; Imaging; Jean-Philippe Gagnon; GROUP; DRAWN; CHECKED; PROJECT; ING#; TITLE; POL; MATROX; PMIC DCD5; PMIC LDO2; VTT PMIC LDO5; VSM; PMIC DCD2; LDO; MGTAVCC; MGTAVTT; V1P80_A PMIC DCD6; PMIC DCD0+DPU; (From Daughtercard); VCORE; SVID @ 4A; PMIC DCD1+DPU; VGFX; SVID @ 7A; PMIC DCD4+DPU; PMIC LDO1; VSFR; OTHERS; PMIC; LEGEND:; DC INPUT; PMIC DCD3+DPU

N2807 (2C ByT-M) EDS
VCC Icc Max = 4A, VNN Icc Max = 7A
TDP(SDP) = 4.3(2.5) W, Tj=105C
Core HFM(Turbo) = 1.58(2.16) GHz, GFX Normal(Burst) = 311(756)
LFM = 533 MHz, DDR = 1333 MT/s

For non-Turbo/Burst operation, expected to stay within the current capability of the PMIC alone (i.e. without DPUs)
Measurements taken with 4GPm-N2807 indicate that it would also be possible to support Turbo/Burst operation for CPU and GFX without DPUs
PMIC DCD0-2 Iout: 4A min cont. and 5A typ pulsed
DPU Iout: 4.5A max cont. and 6A typ pulsed

PMIC DCD5-6 Iout: 2A min cont. and 2.3A typ pulsed
PMIC LDO1-2 Iout: 425mA min cont. with 440mA min current limit

1055 BOUL. ST-REGIS
DORVAL, QUEBEC H9P 2T4

THIS DRAWING IS THE PROPERTY OF MATROX
ELECTRONICS SYSTEMS AND MAY NOT BE
REPRODUCED OR USED FOR MANUFACTURING
WITHOUT WRITTEN PERMISSION FROM MATROX.
Power Distribution

SIZE | DATE

D

D

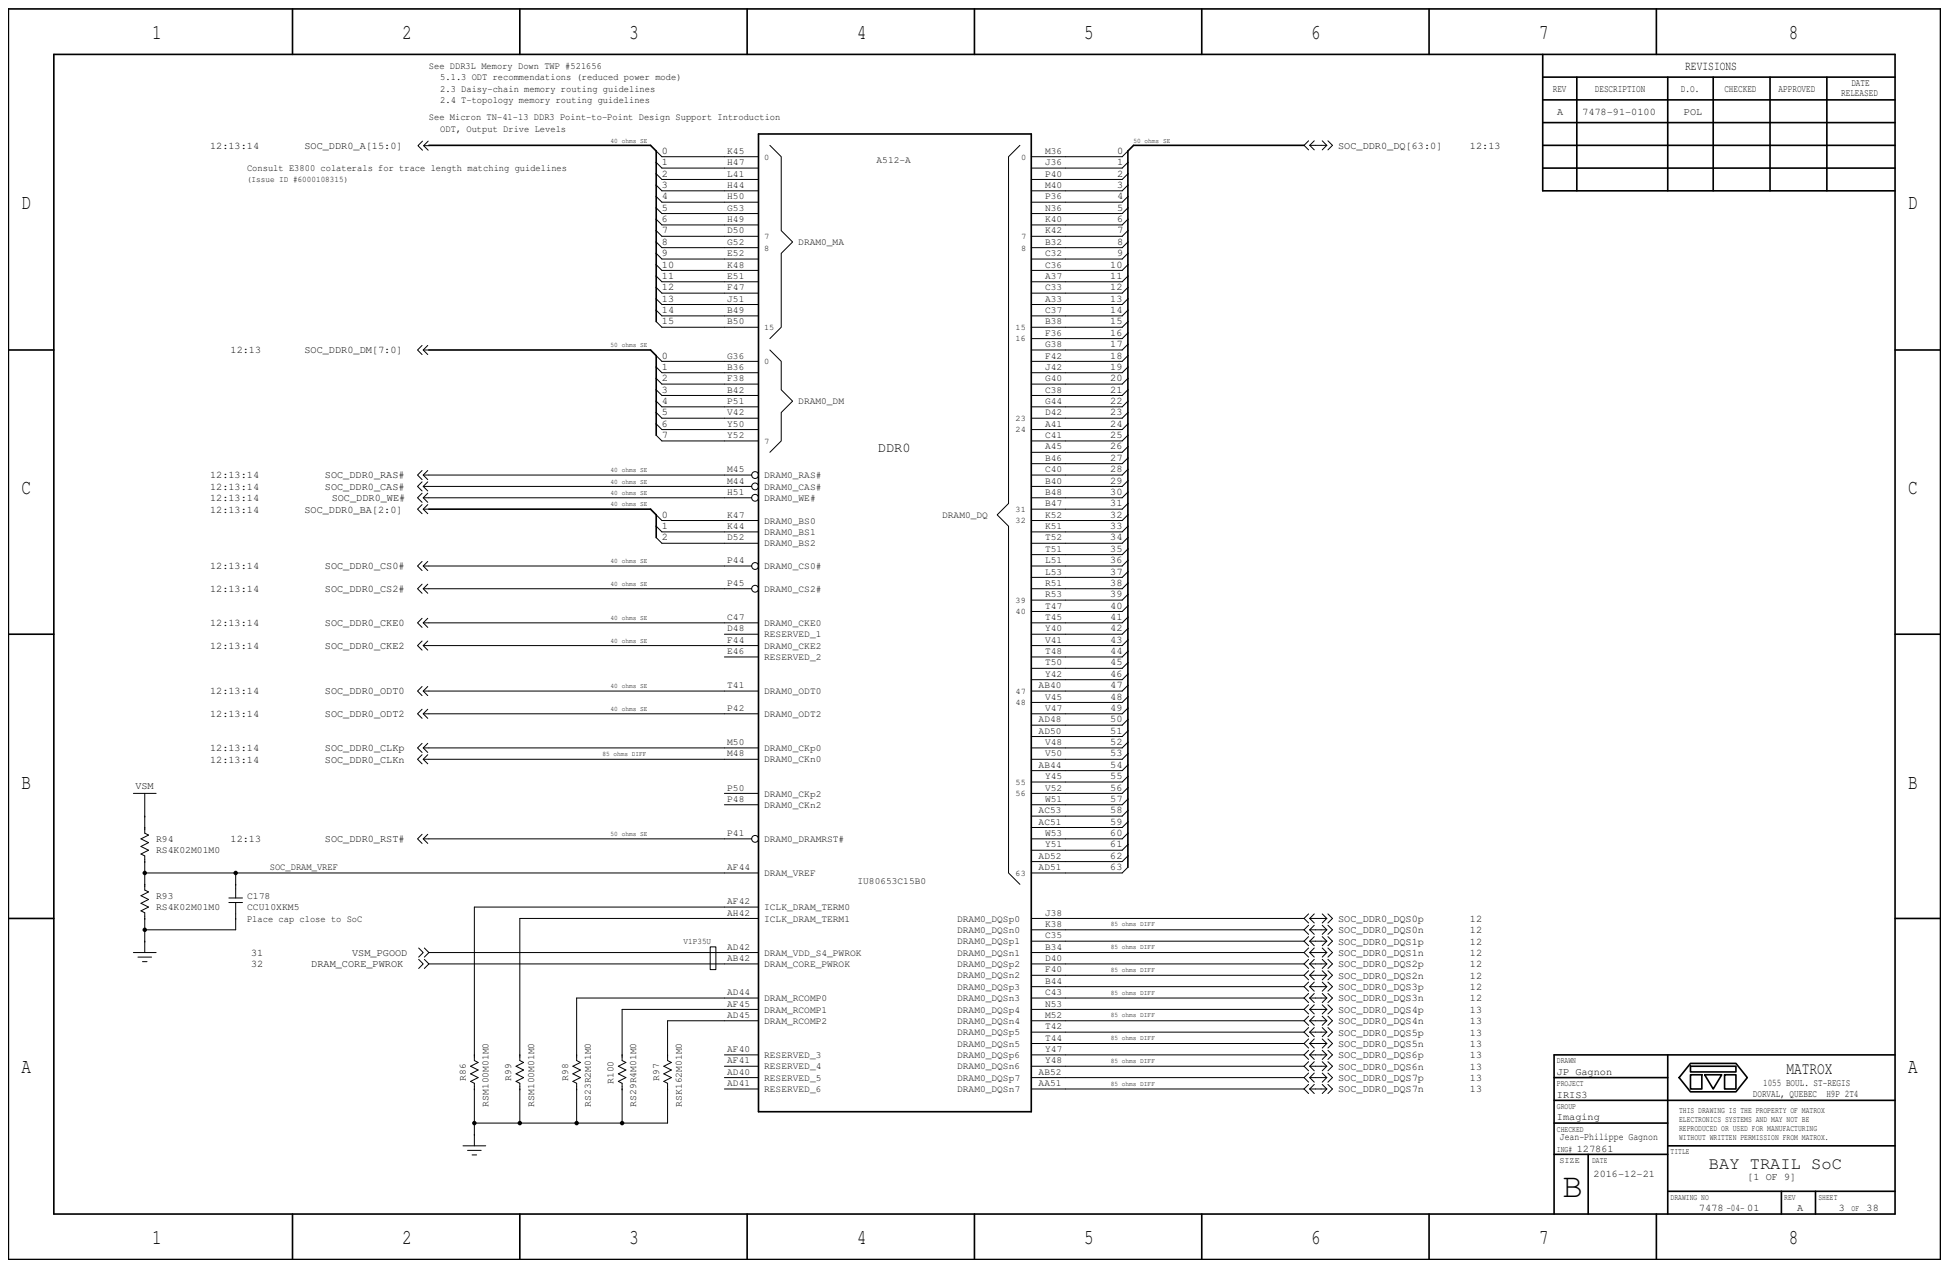
[picture p68: page 3]

See DDR3L Memory Down TWP #521656
5.1.3 ODT recommendations (reduced power mode)
2.3 Daisy-chain memory routing guidelines
2.4 T-topology memory routing guidelines

See Micron TN-41-13 DDR3 Point-to-Point Design Support Introduction
ODT, Output Drive Levels

Consult E3800 colaterals for trace length matching guidelines
(Issue ID #6000108315)

THIS DRAWING IS THE PROPERTY OF MATROX
ELECTRONICS SYSTEMS AND MAY NOT BE
REPRODUCED OR USED FOR MANUFACTURING
WITHOUT WRITTEN PERMISSION FROM MATROX.
BAY TRAIL SoC

SIZE | DATE

D

D

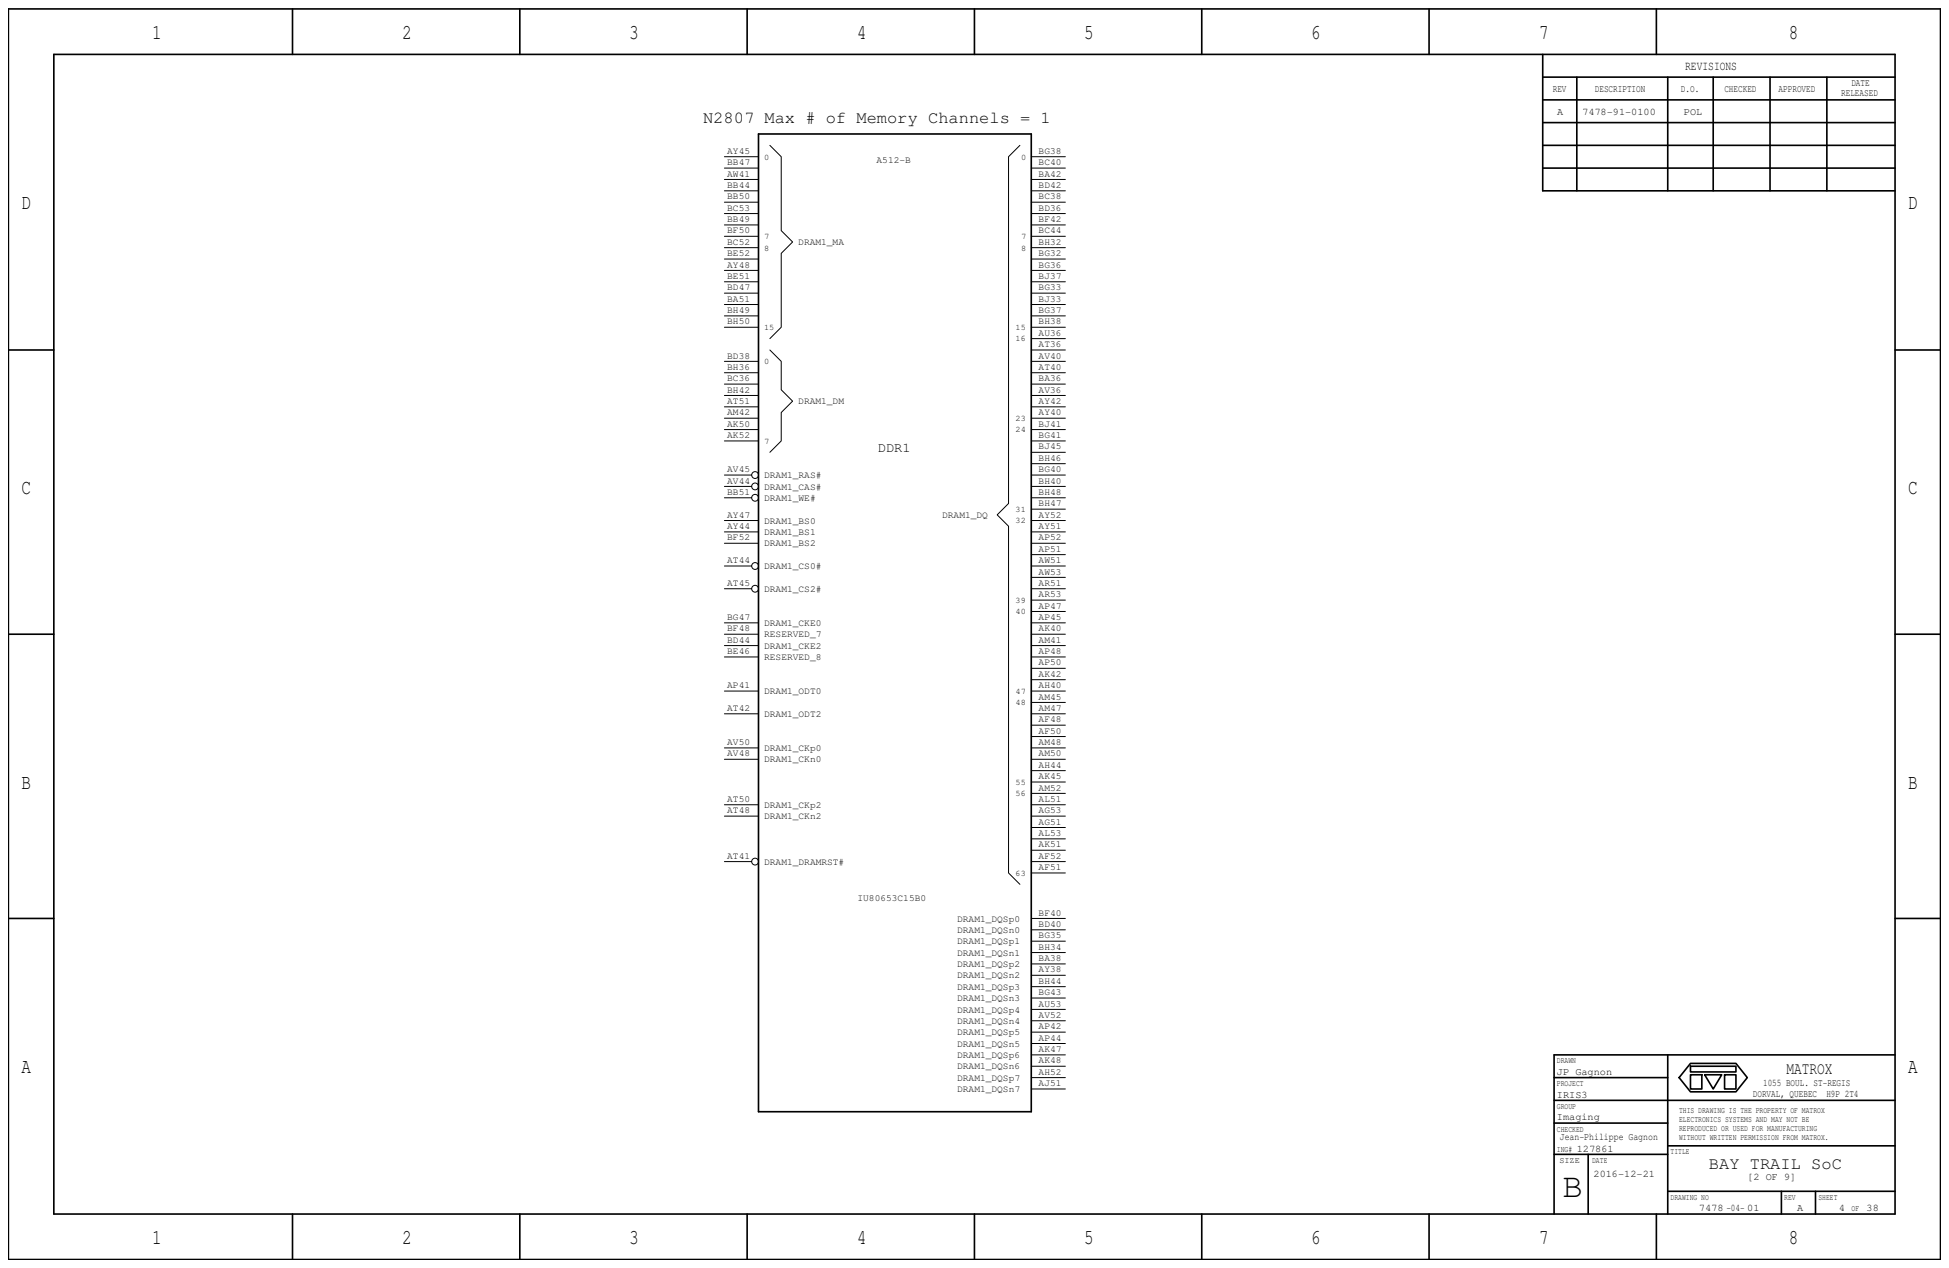
[picture p69: page 4]
DDR1; DRAM1_CKn2; DRAM1_DRAMRST# AT41; DRAM1_ODT2; DRAM1_ODT0; RESERVED_8; DRAM1_CKE0; DRAM1_CKp0 DRAM1_CKn0; DRAM1_CKp2; DRAM1_CKE2; RESERVED_7; DRAM1_RAS# AV44; DRAM1_CAS#; DRAM1_BS1 DRAM1_BS2; DRAM1_BS0; DRAM1_WE#; DRAM1_CS0#; DRAM1_CS2#; DRAM1_DM; DRAM1_MA; DRAM1_DQSp6; DRAM1_DQSn5; DRAM1_DQSn6 DRAM1_DQSp7 DRAM1_DQSn7; DRAM1_DQSp1 DRAM1_DQSn1 DRAM1_DQSp2; BD40 DRAM1_DQSn0 DRAM1_DQSp0; DRAM1_DQSn2 DRAM1_DQSp3; DRAM1_DQSp5; DRAM1_DQSn4; DRAM1_DQSp4; DRAM1_DQSn3; DRAM1_DQ; JP Gagnon; IRIS3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

N2807 Max # of Memory Channels = 1

MATROX
1055 BOUL. ST-REGIS
DORVAL, QUEBEC H9P 2T4

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

D

1 | 2 | 3

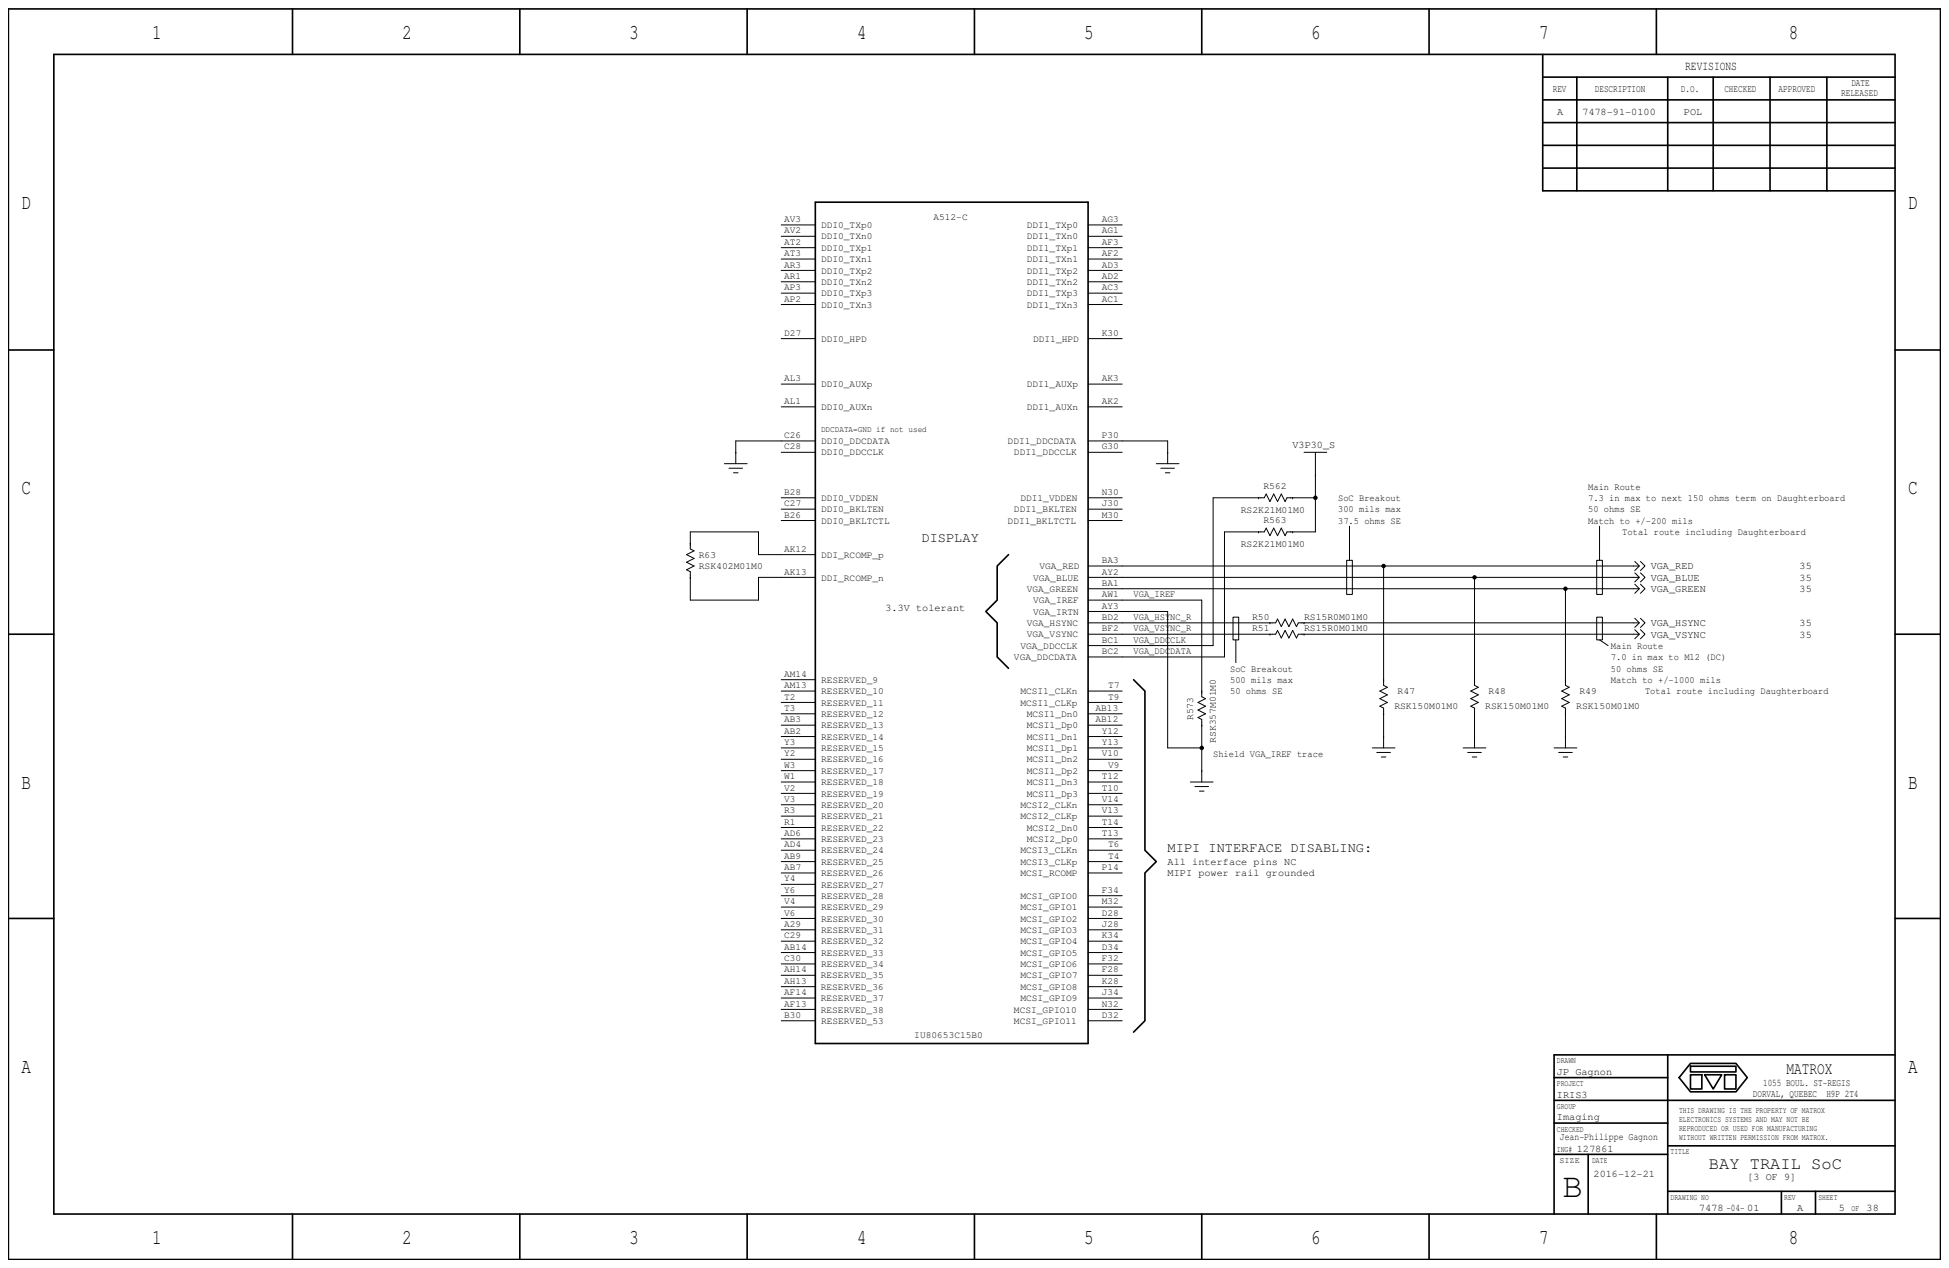
[picture p70: page 5]

Main Route
7.3 in max to next 150 ohms term on Daughterboard
50 ohms SE
Match to +/-200 mils

Total route including Daughterboard

7.0 in max to M12 (DC)
Match to +/-1000 mils

MIPI INTERFACE DISABLING:
All interface pins NC
MIPI power rail grounded

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

D

D

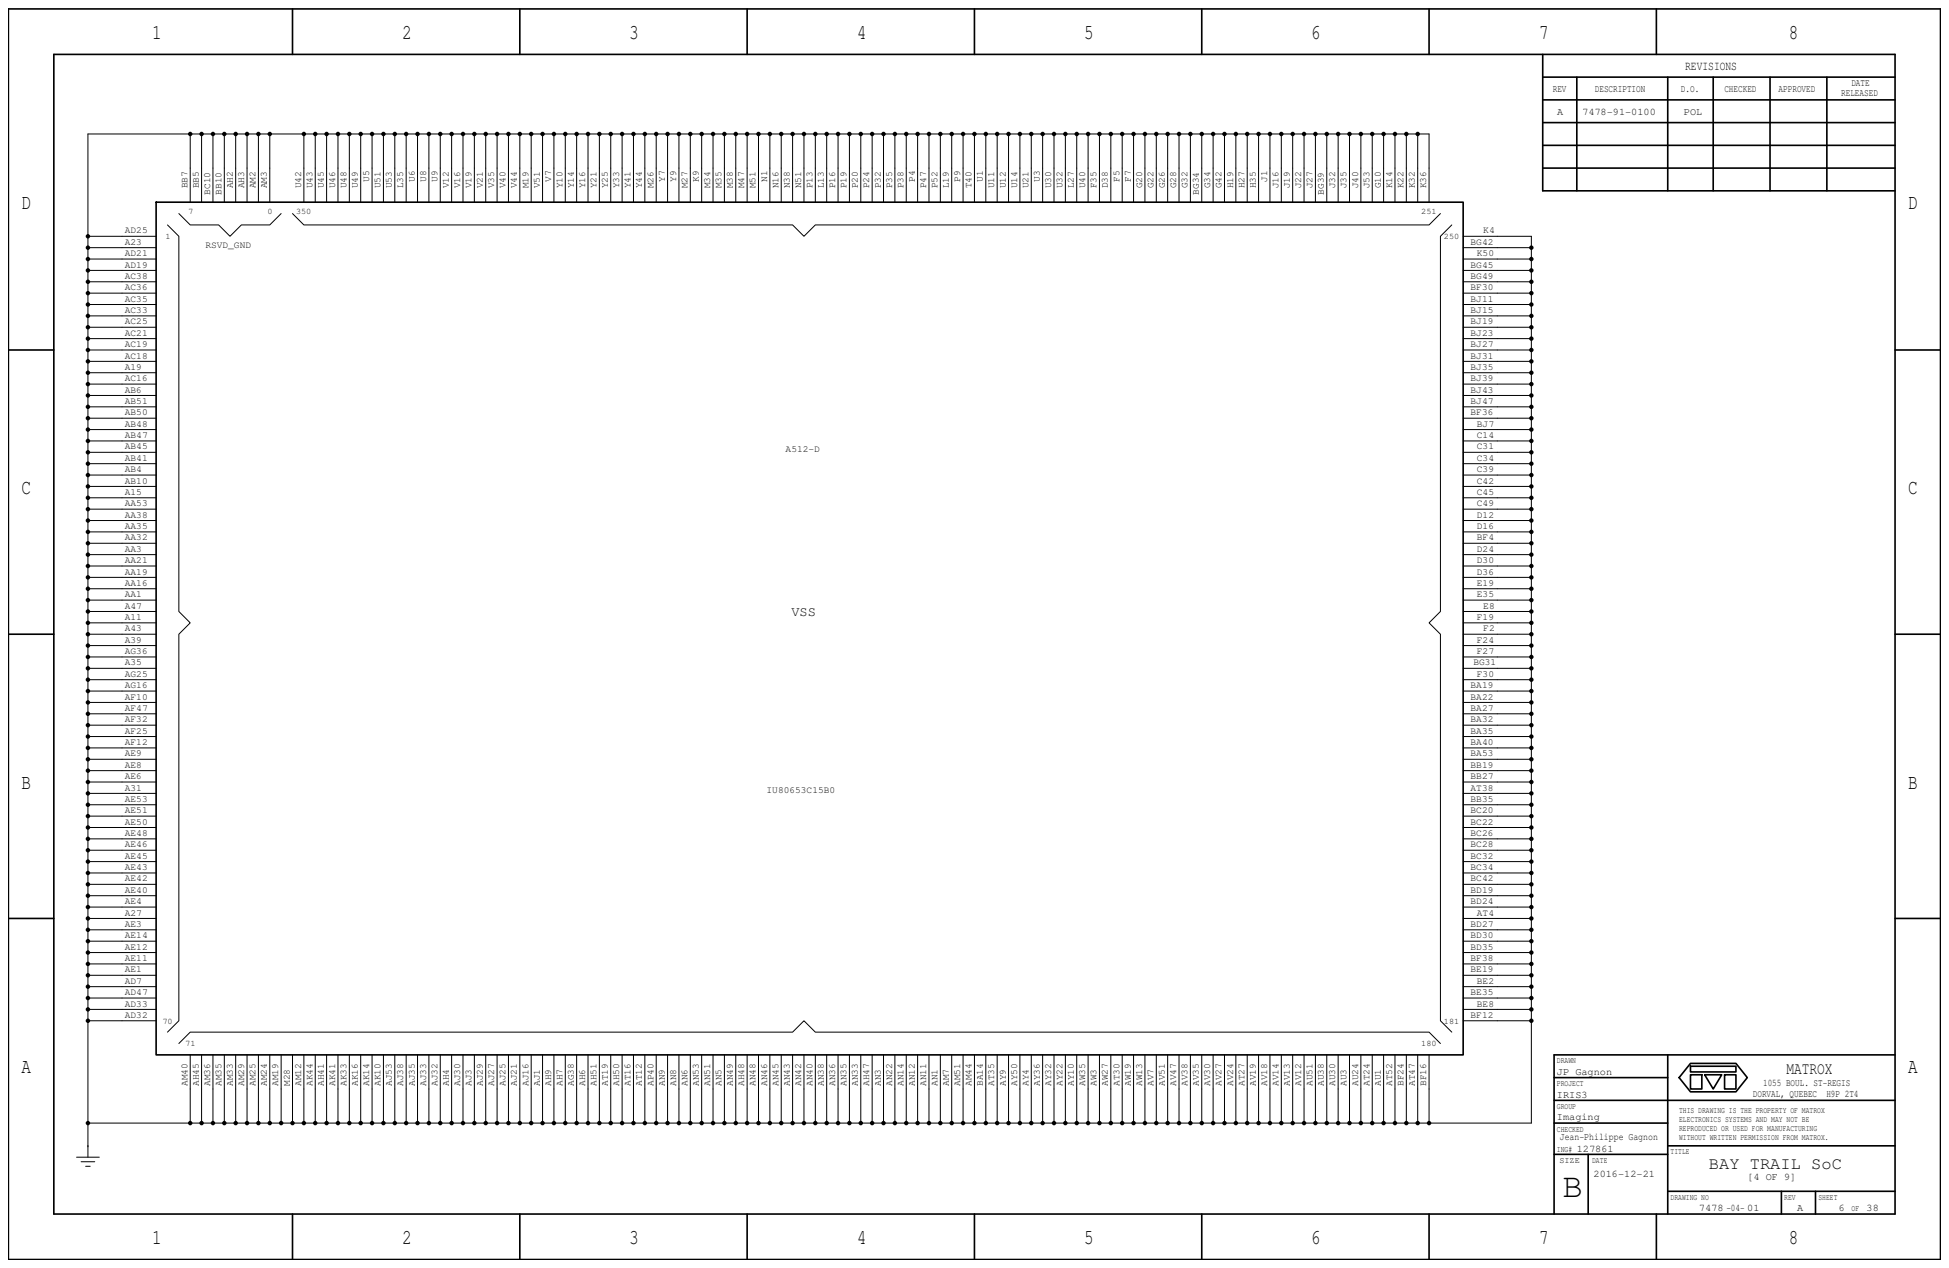
[picture p71: page 6]
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

D

D

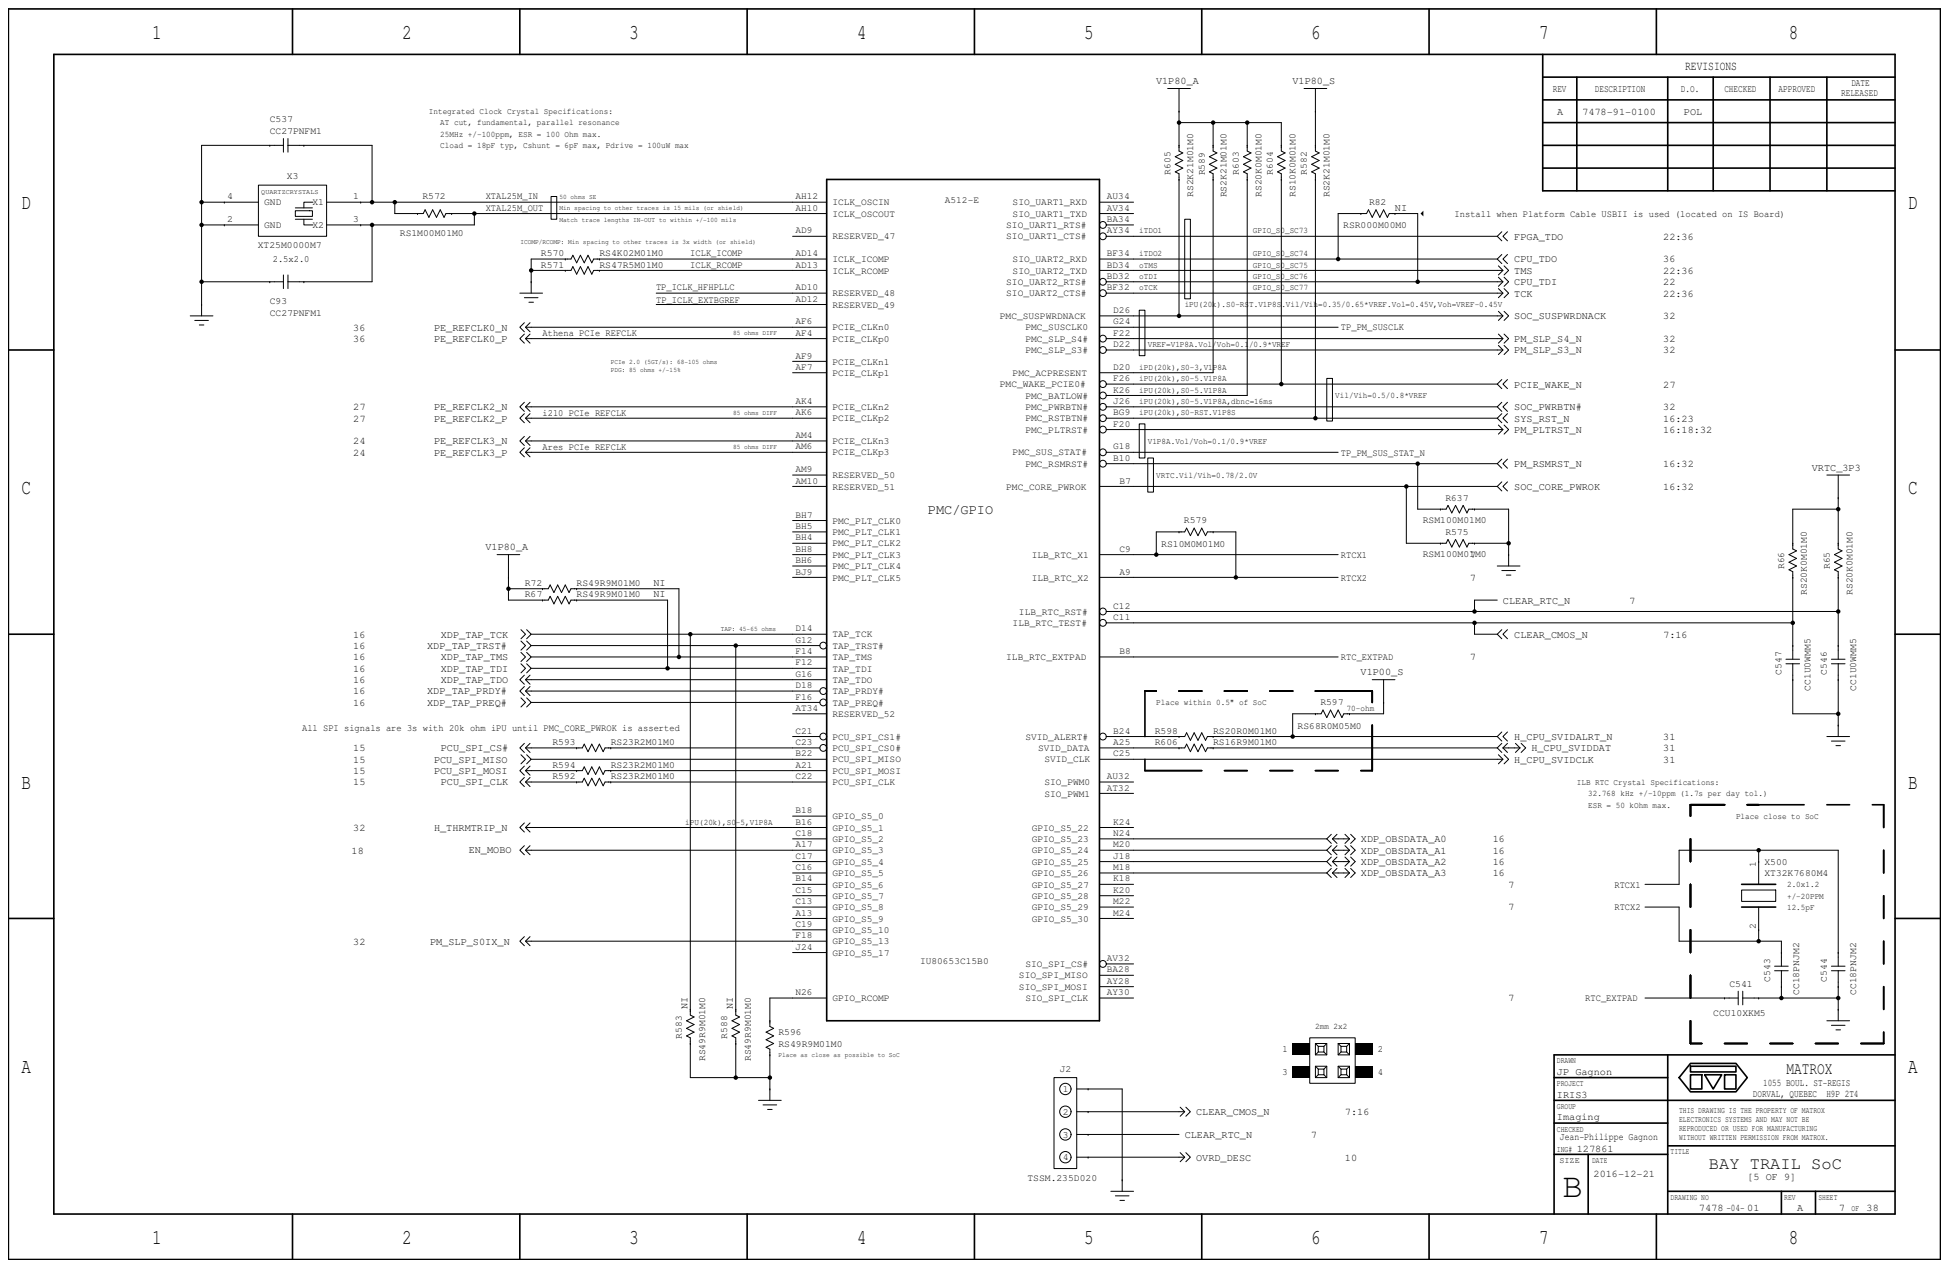
[picture p72: page 7]

Integrated Clock Crystal Specifications:
AT cut, fundamental, parallel resonance
25MHz +/-100ppm, ESR = 100 Ohm max.
Cload = 18pF typ, Cshunt = 6pF max, Pdrive = 100uW max

Min spacing to other traces is 15 mils (or shield)

Install when Platform Cable USBII is used (located on IS Board)

Match trace lengths IN-OUT to within +/-100 mils

ICOMP/RCOMP: Min spacing to other traces is 3x width (or shield)

iPU(20k).S0-RST.V1P8S.Vil/Vih=0.35/0.65*VREF.Vol=0.45V,Voh=VREF-0.45V

VREF=V1P8A.Vol/Voh=0.1/0.9*VREF

F12
G16

Place within 0.5" of SoC

All SPI signals are 3s with 20k ohm iPU until PMC_CORE_PWROK is asserted

ILB RTC Crystal Specifications:
32.768 kHz +/-10ppm (1.7s per day tol.)
ESR = 50 kOhm max.

Place close to SoC

Place as close as possible to SoC

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

D

D

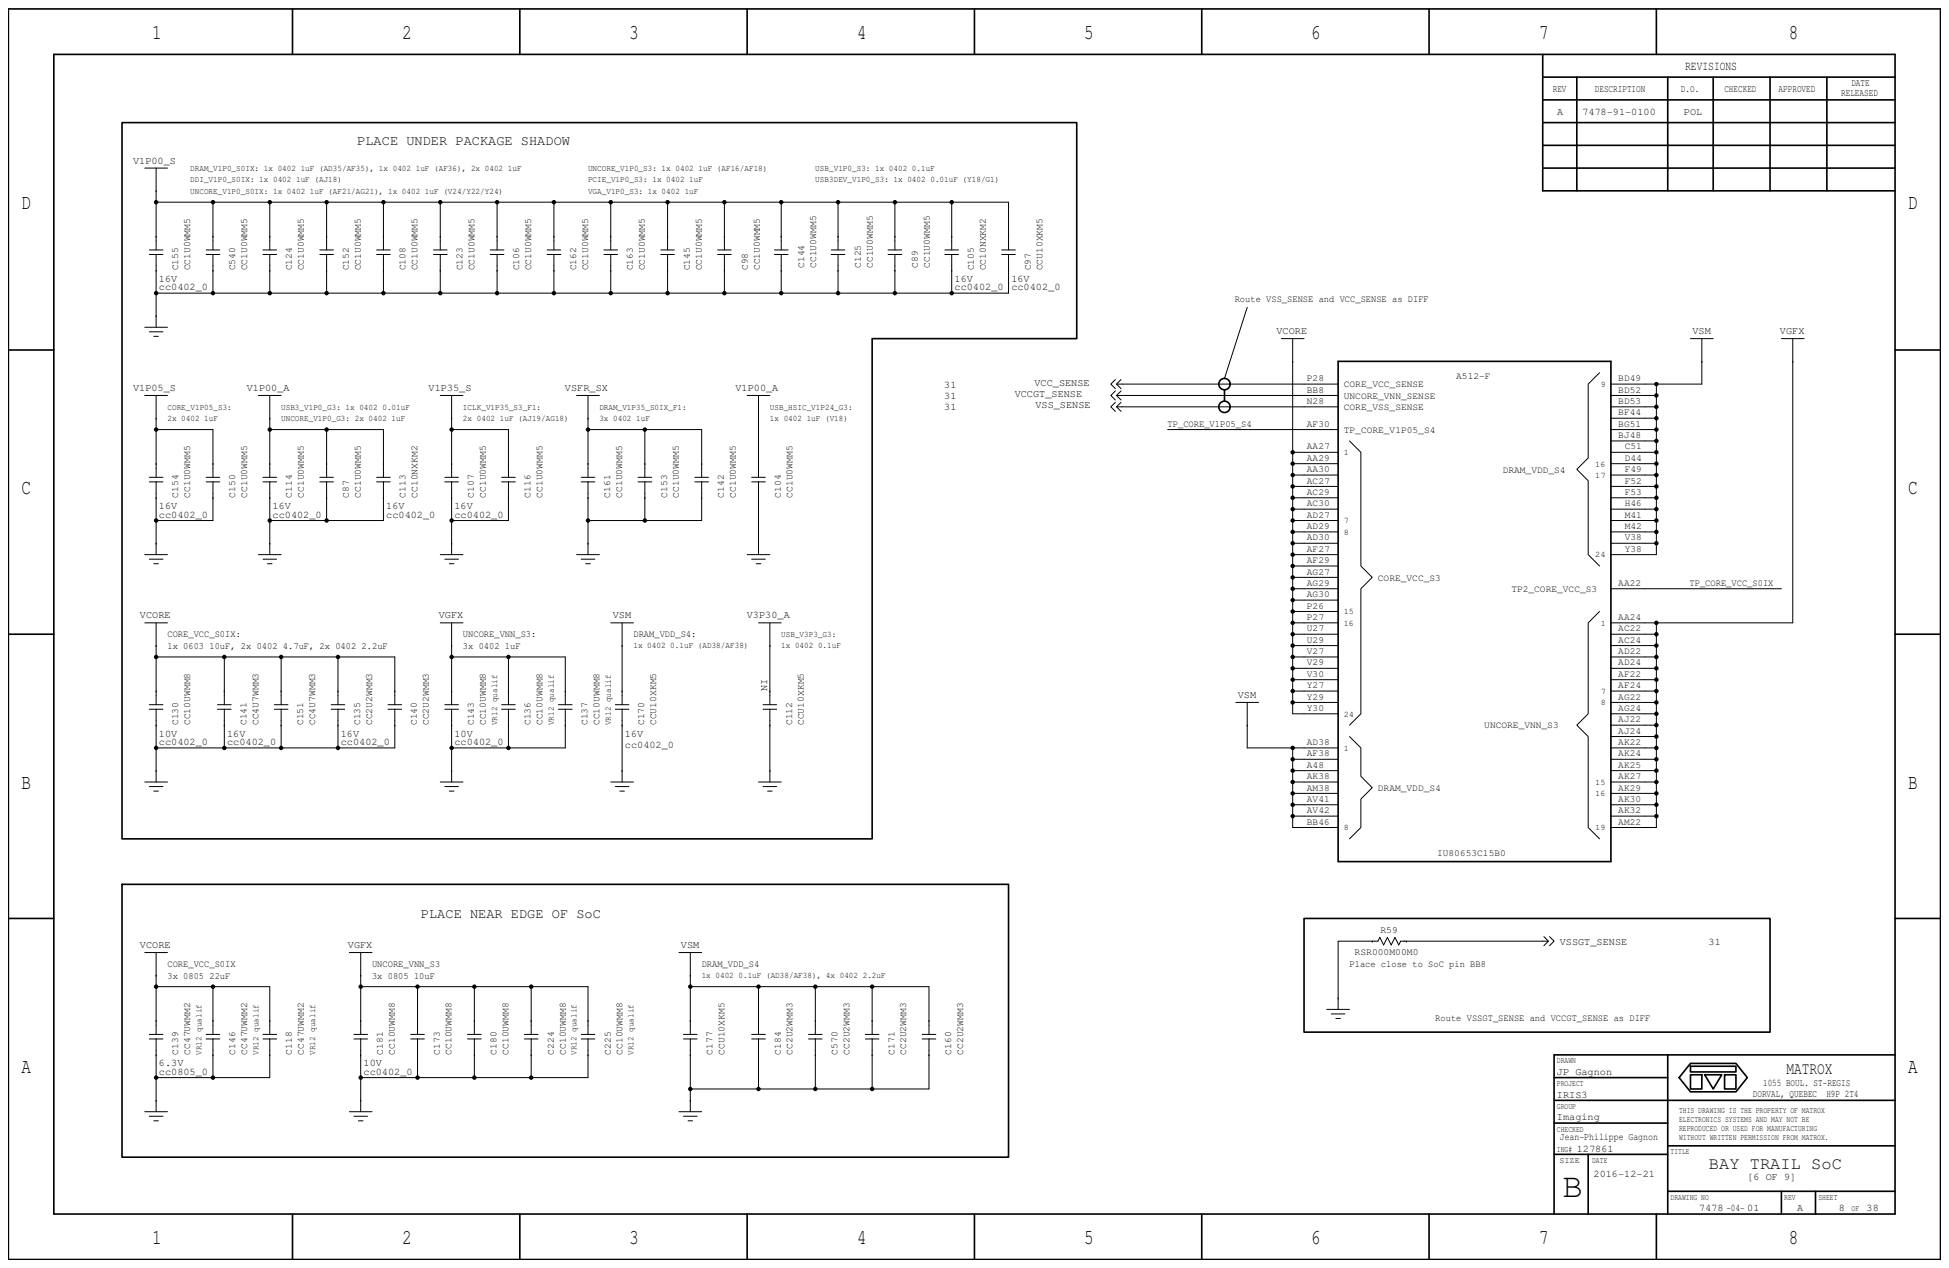
[picture p73: page 8]

PLACE UNDER PACKAGE SHADOW

Route VSS_SENSE and VCC_SENSE as DIFF

AA29 | D44
AA30 | F49
AC27 | F52
AC29 | F53
AC30 | H46
AD27 | M41

AD30 | V38
AF27 | Y38

V27 | AD22
V29 | AD24
V30 | AF22
Y27 | AF24
Y29 | AG22
Y30 | AG24

AF38 | | AK24
A48 | | AK25
AK38 | | AK27
AM38 | 15 AK29

AV41 | | AK30
AV42 | | AK32
BB46 | | AM22

PLACE NEAR EDGE OF SoC

RSR000M00M0
Place close to SoC pin BB8

Route VSSGT_SENSE and VCCGT_SENSE as DIFF

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

D

D

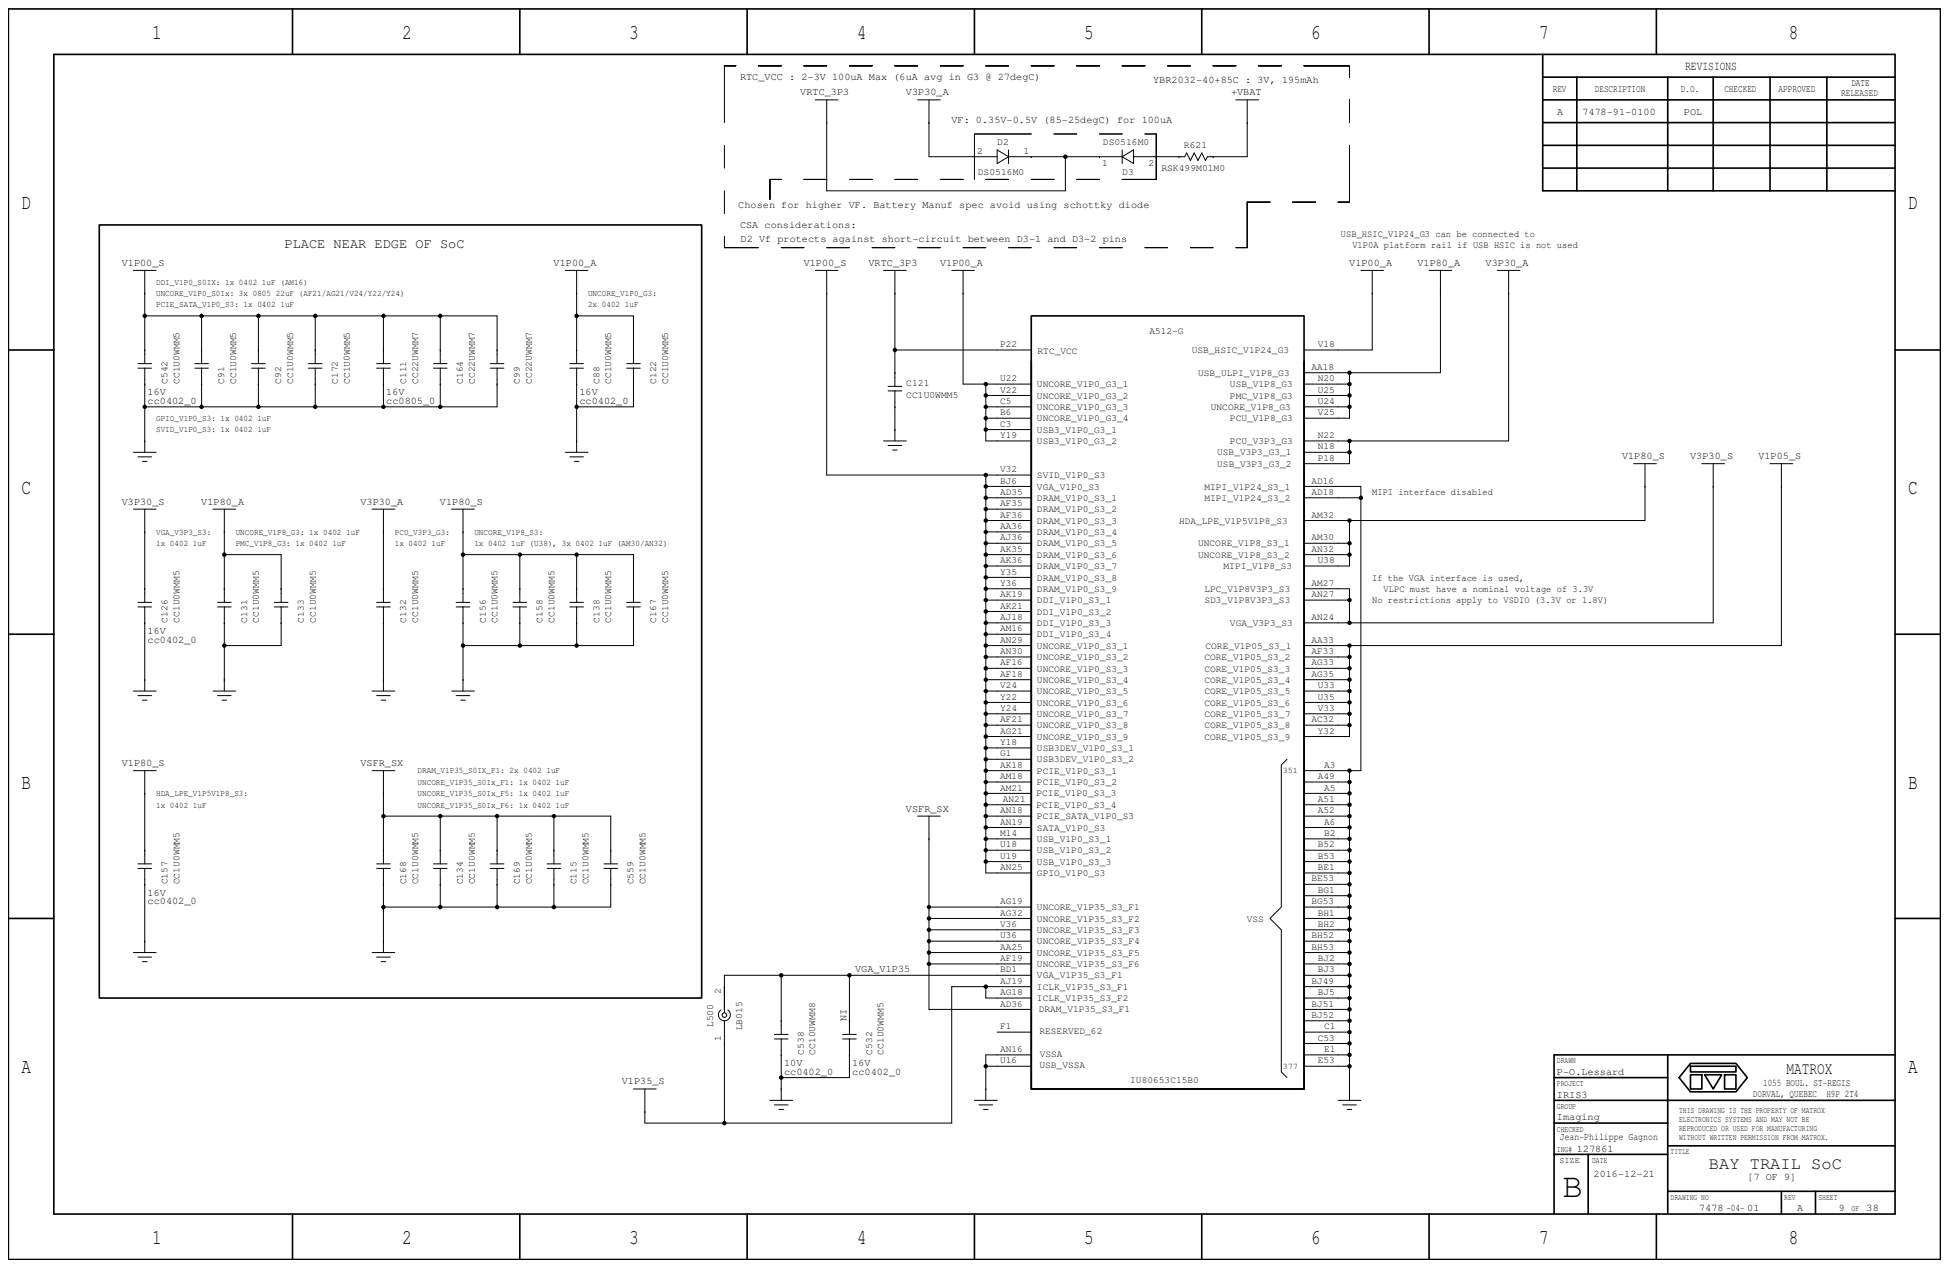
[picture p74: page 9]

Chosen for higher VF. Battery Manuf spec avoid using schottky diode

CSA considerations:
D2 Vf protects against short-circuit between D3-1 and D3-2 pins

PLACE NEAR EDGE OF SoC

USB_HSIC_V1P24_G3 can be connected to
V1P0A platform rail if USB HSIC is not used

If the VGA interface is used,
VLPC must have a nominal voltage of 3.3V
No restrictions apply to VSDIO (3.3V or 1.8V)

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

SIZE | DATE

D

D

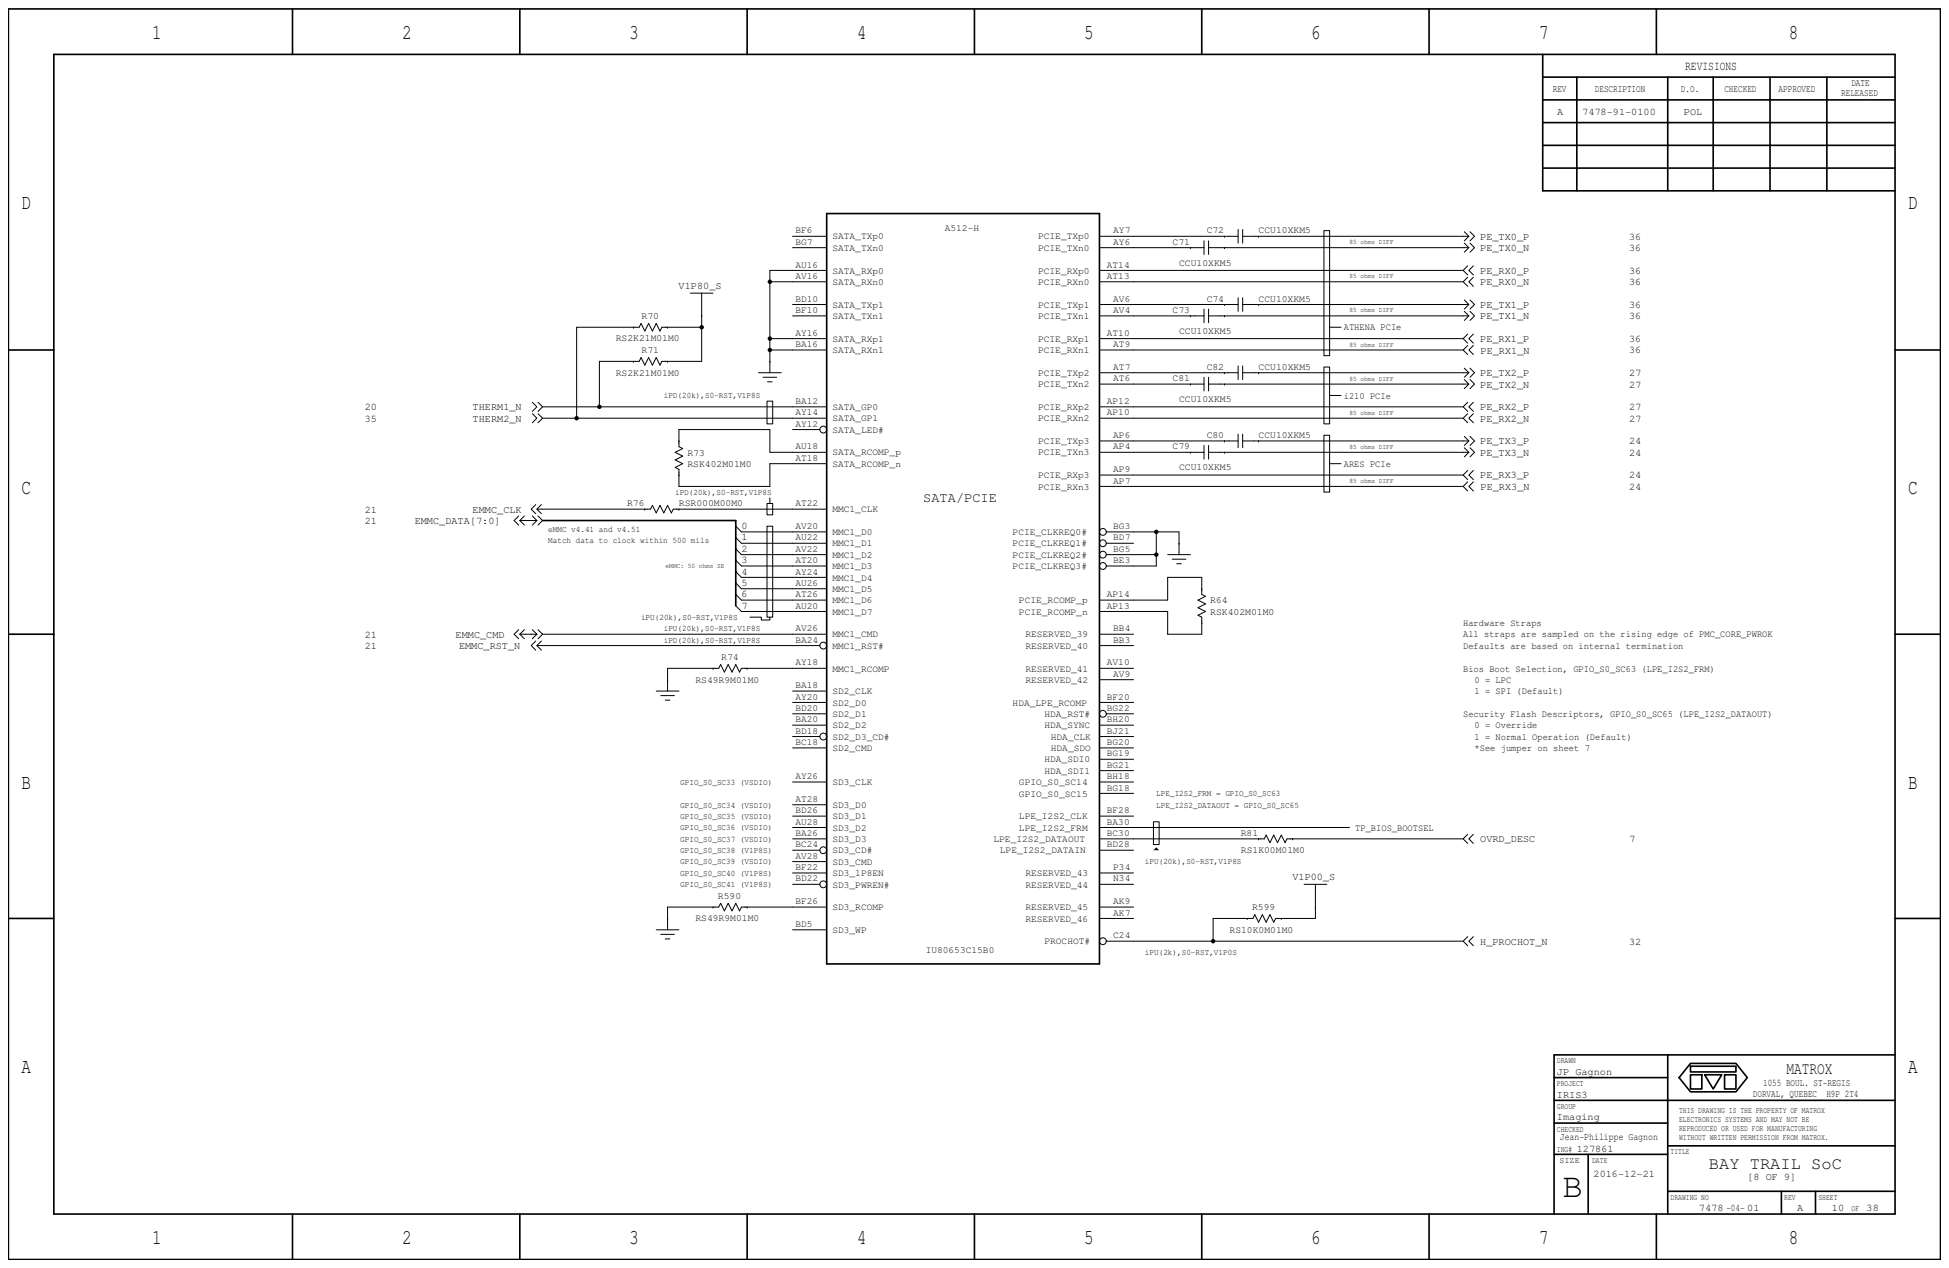
[picture p75: page 10]

eMMC v4.41 and v4.51
Match data to clock within 500 mils

Hardware Straps
All straps are sampled on the rising edge of PMC_CORE_PWROK
Defaults are based on internal termination

Security Flash Descriptors, GPIO_S0_SC65 (LPE_I2S2_DATAOUT)
0 = Override
1 = Normal Operation (Default)
*See jumper on sheet 7

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

SIZE | DATE

D

1 | 2 | 3

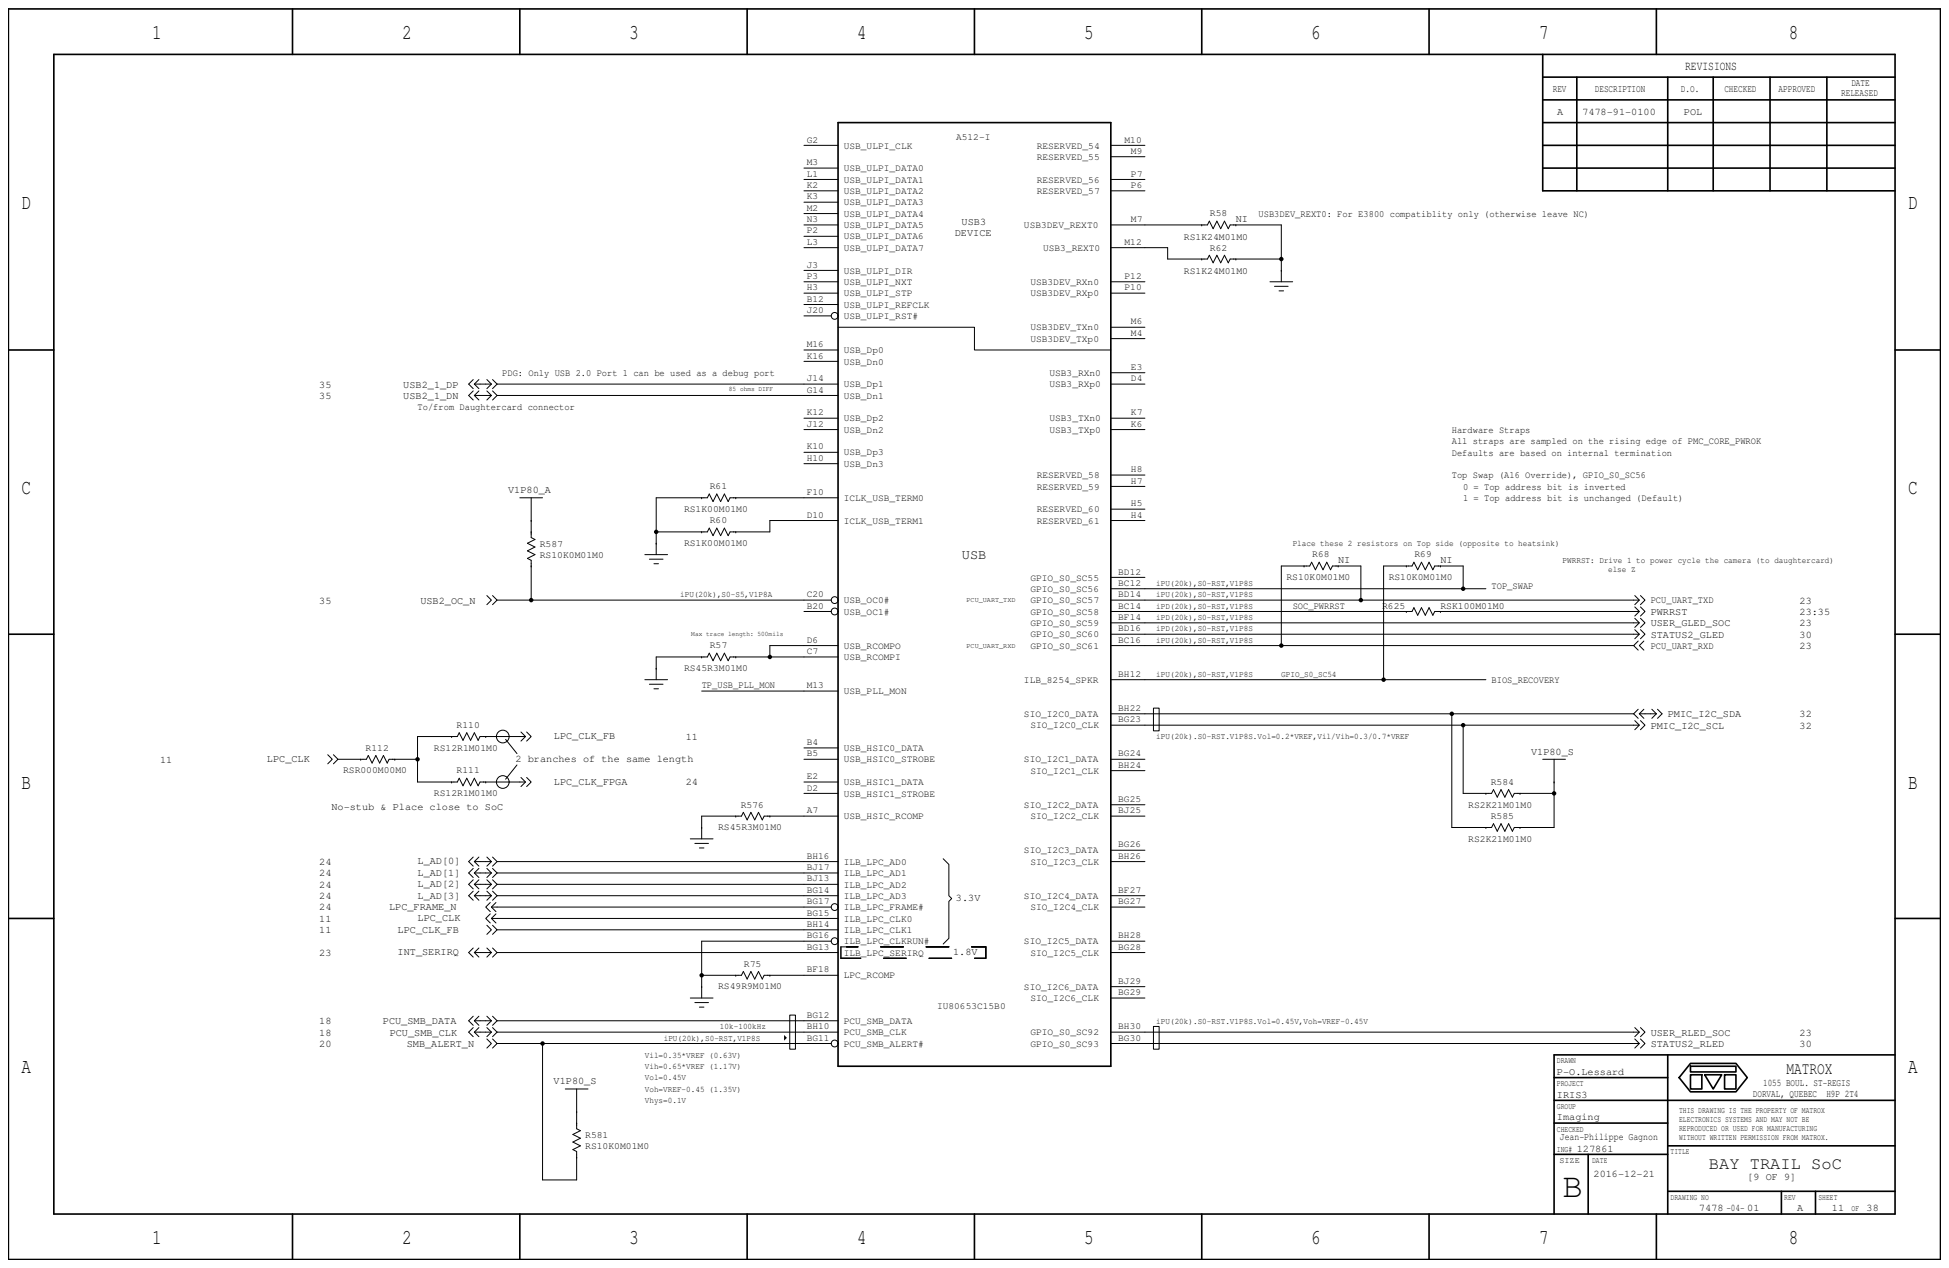
[picture p76: page 11]

USB3DEV_REXT0: For E3800 compatiblity only (otherwise leave NC)

PDG: Only USB 2.0 Port 1 can be used as a debug port

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

Top Swap (A16 Override), GPIO_S0_SC56
0 = Top address bit is inverted
1 = Top address bit is unchanged (Default)

Place these 2 resistors on Top side (opposite to heatsink)

PWRRST: Drive 1 to power cycle the camera (to daughtercard)

iPU(20k).S0-RST.V1P8S.Vol=0.2*VREF,Vil/Vih=0.3/0.7*VREF

2 branches of the same length

No-stub & Place close to SoC

iPU(20k).S0-RST.V1P8S.Vol=0.45V,Voh=VREF-0.45V

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

SIZE | DATE

D

2 3

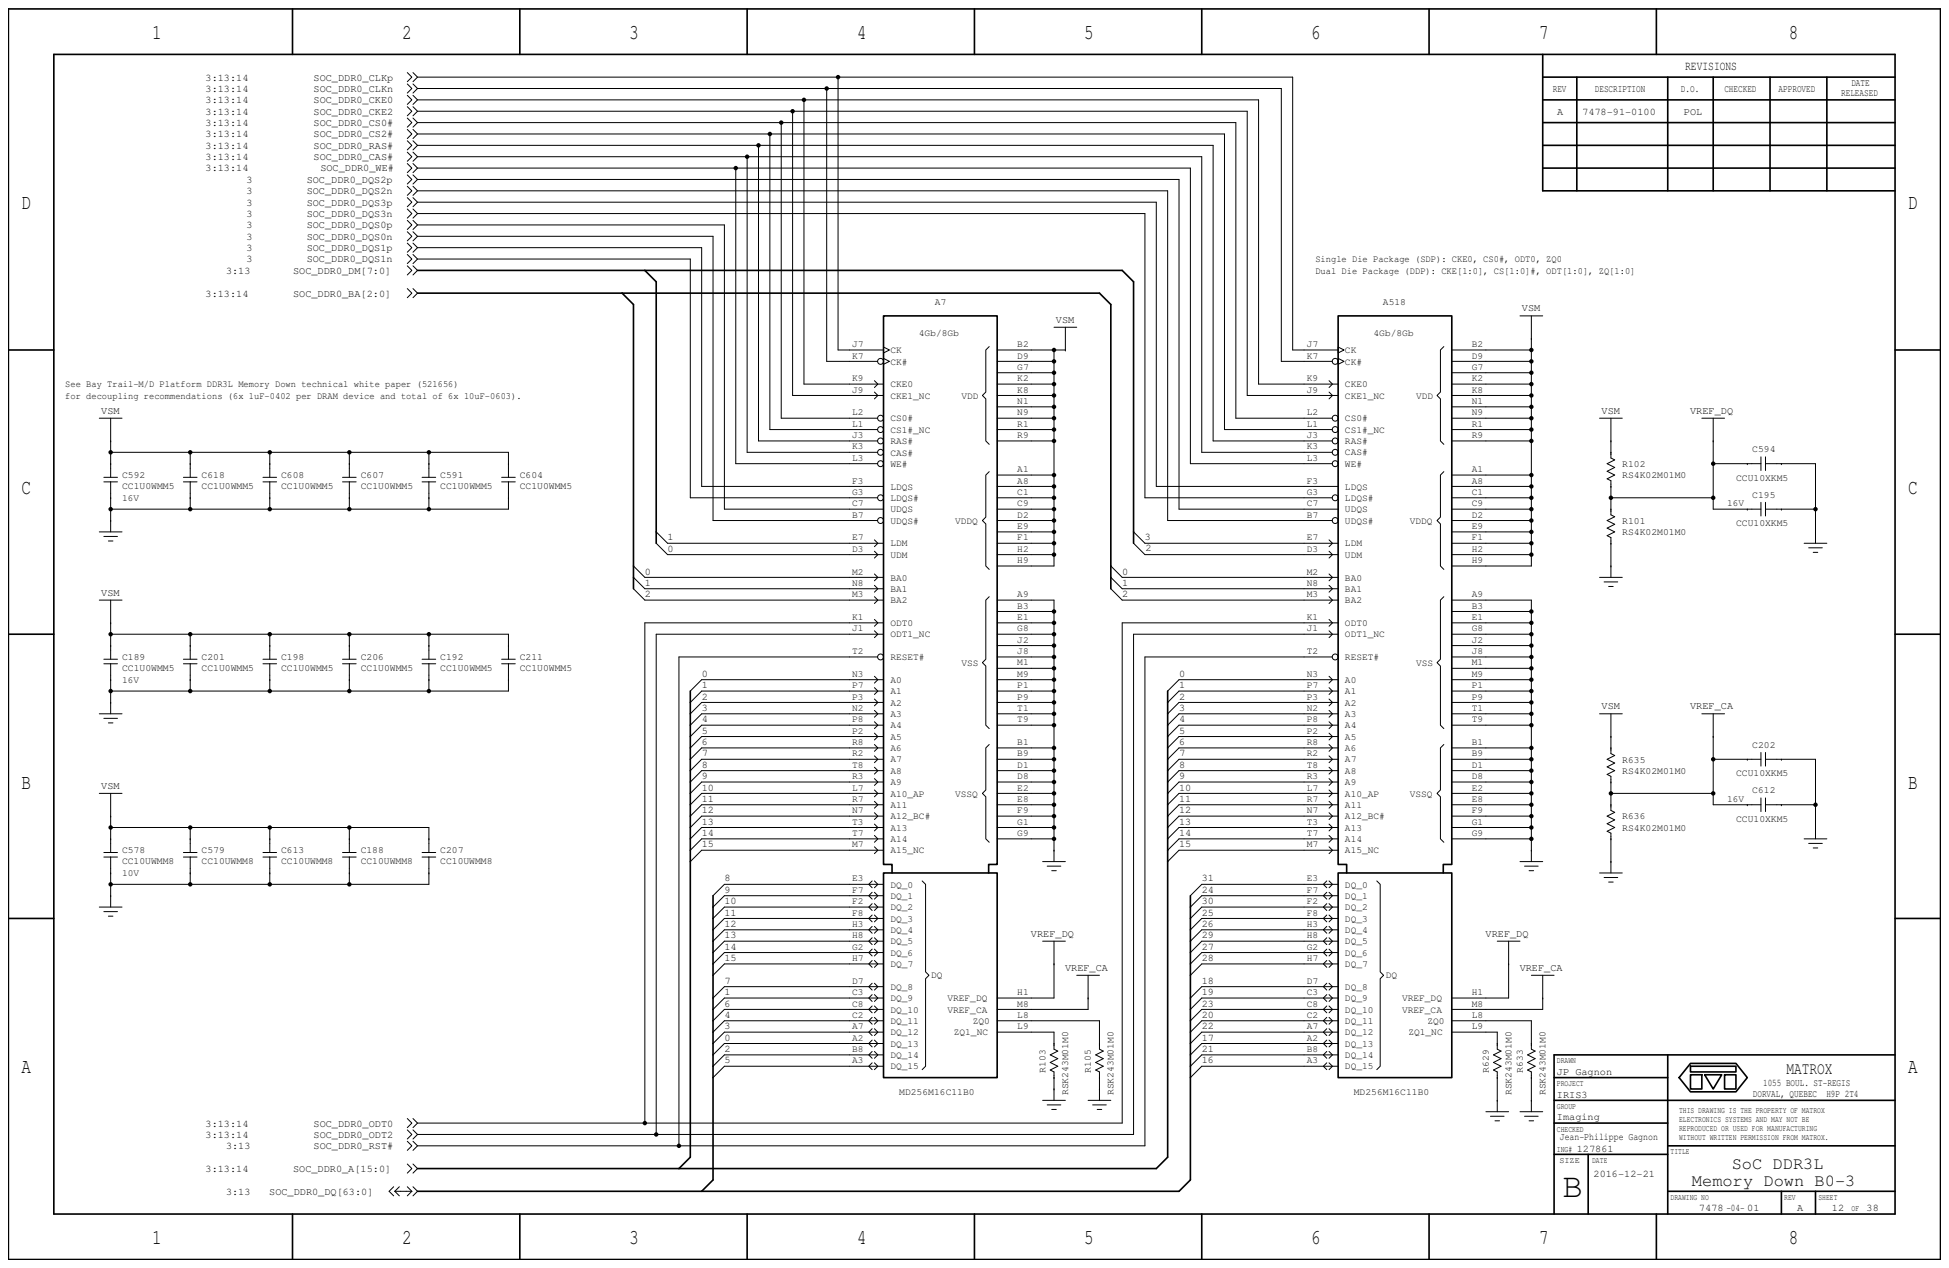
[picture p77: page 12]

Single Die Package (SDP): CKE0, CS0#, ODT0, ZQ0
Dual Die Package (DDP): CKE[1:0], CS[1:0]#, ODT[1:0], ZQ[1:0]

See Bay Trail-M/D Platform DDR3L Memory Down technical white paper (521656)
for decoupling recommendations (6x 1uF-0402 per DRAM device and total of 6x 10uF-0603).

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

SIZE | DATE

D

2 3

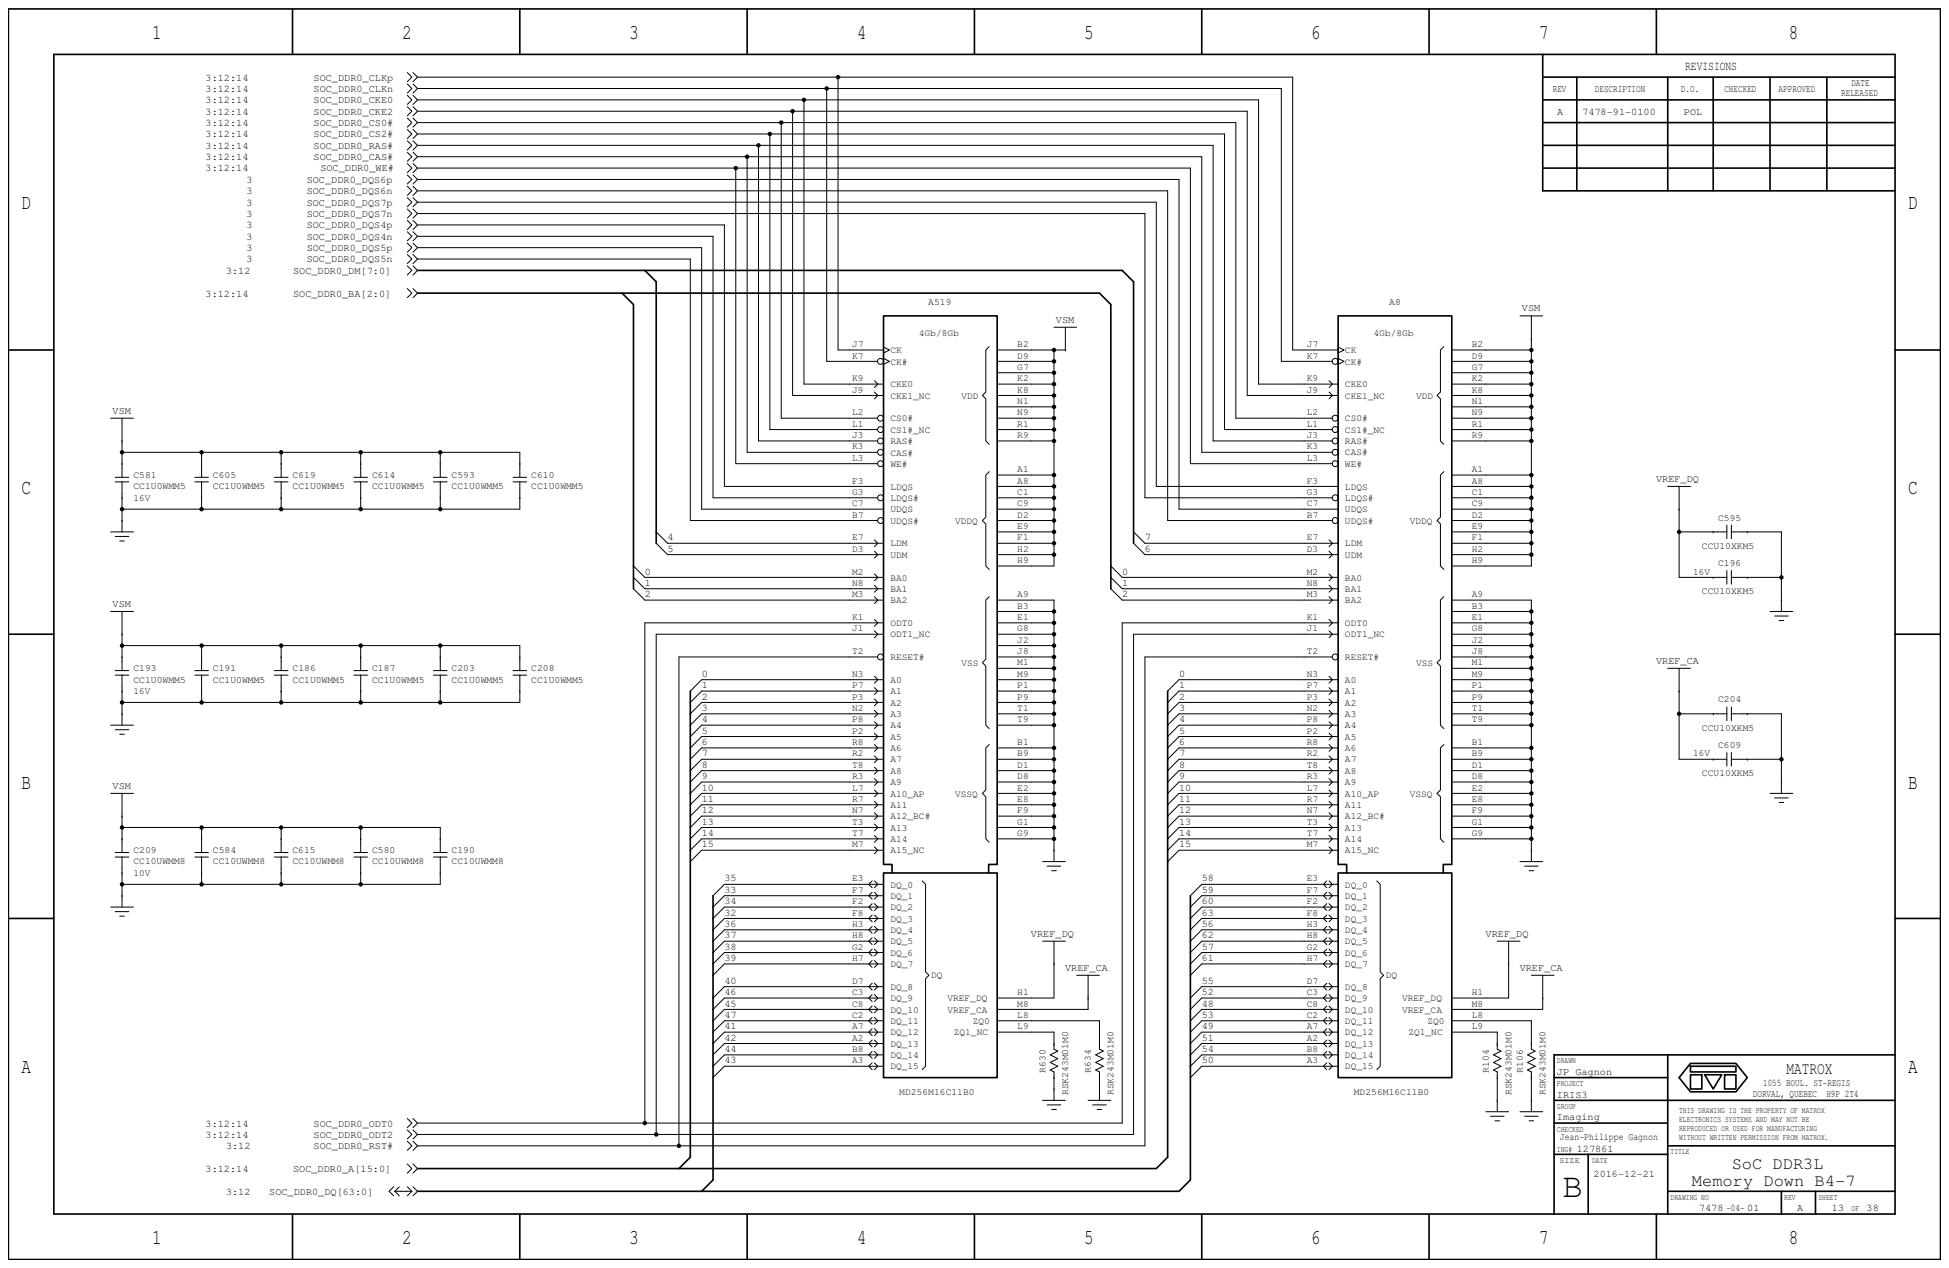
[picture p78: page 13]

B3 | K1 | B3
E1 | | E1

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

SIZE | DATE

D

D

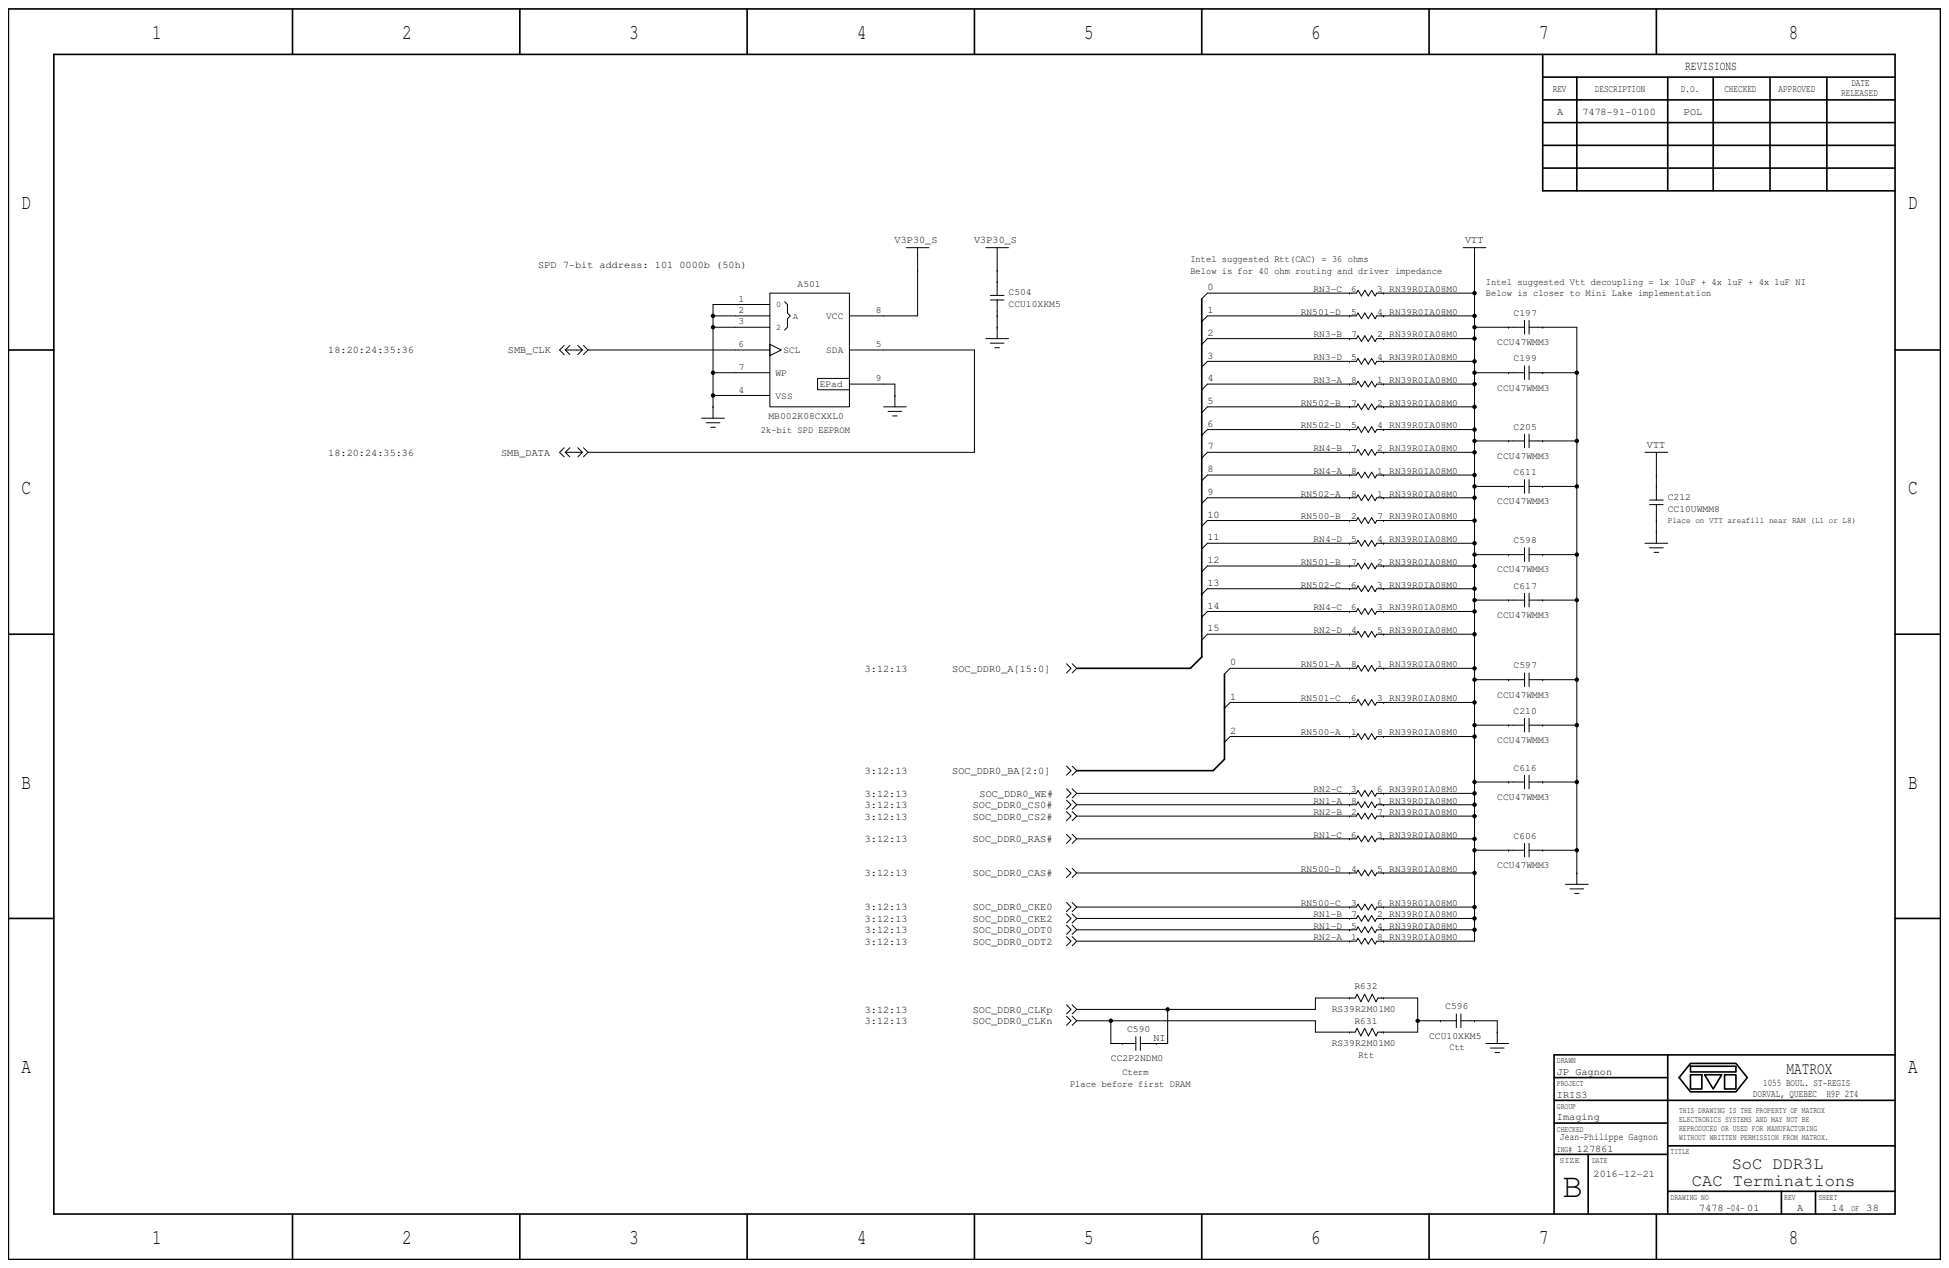
[picture p79: page 14]

Intel suggested Rtt(CAC) = 36 ohms
Below is for 40 ohm routing and driver impedance

Intel suggested Vtt decoupling = 1x 10uF + 4x 1uF + 4x 1uF NI
Below is closer to Mini Lake implementation

CC10UWMM8
Place on VTT areafill near RAM (L1 or L8)

Place before first DRAM

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

SIZE | DATE

D

1 | 2 | 3 | 4

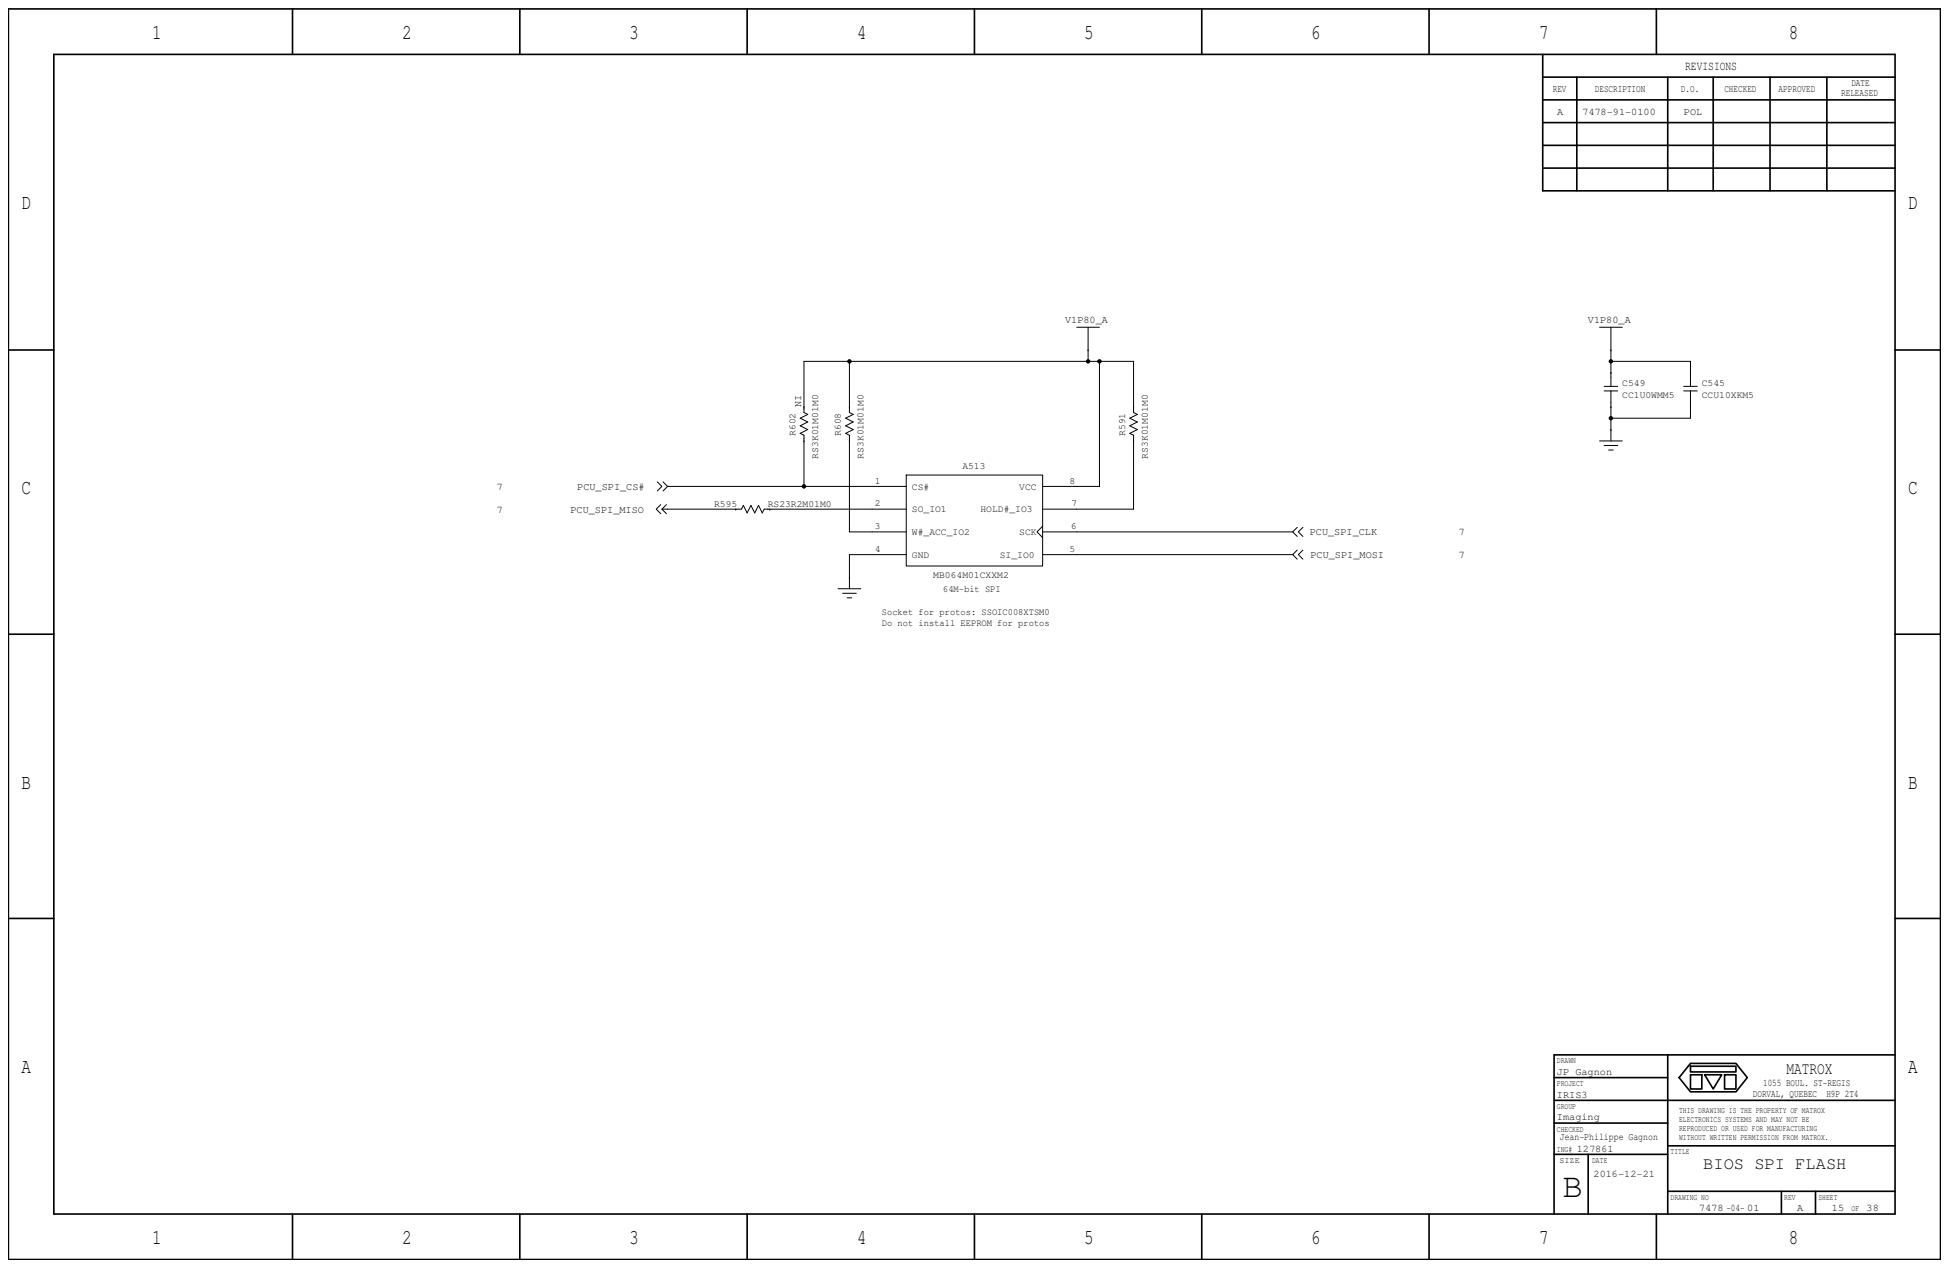
[picture p80: page 15]
7 PCU_SPI_CS#; PCU_SPI_MISO; PCU_SPI_MOSI; PCU_SPI_CLK; HOLD#_IO3; MB064M01CXXM2; W#_ACC_IO2; GND; SCK; VCC; JP Gagnon; IRIS3; Jean-Philippe Gagnon; Imaging; GROUP; DRAWN; CHECKED; PROJECT; ING#; TITLE; CC1U0WMM5; CCU10XKM5; POL; MATROX; 64M-bit SPI

Socket for protos: SSOIC008XTSM0
Do not install EEPROM for protos

1055 BOUL. ST-REGIS
DORVAL, QUEBEC H9P 2T4

THIS DRAWING IS THE PROPERTY OF MATROX
ELECTRONICS SYSTEMS AND MAY NOT BE
REPRODUCED OR USED FOR MANUFACTURING
WITHOUT WRITTEN PERMISSION FROM MATROX.
BIOS SPI FLASH

SIZE | DATE

D

D

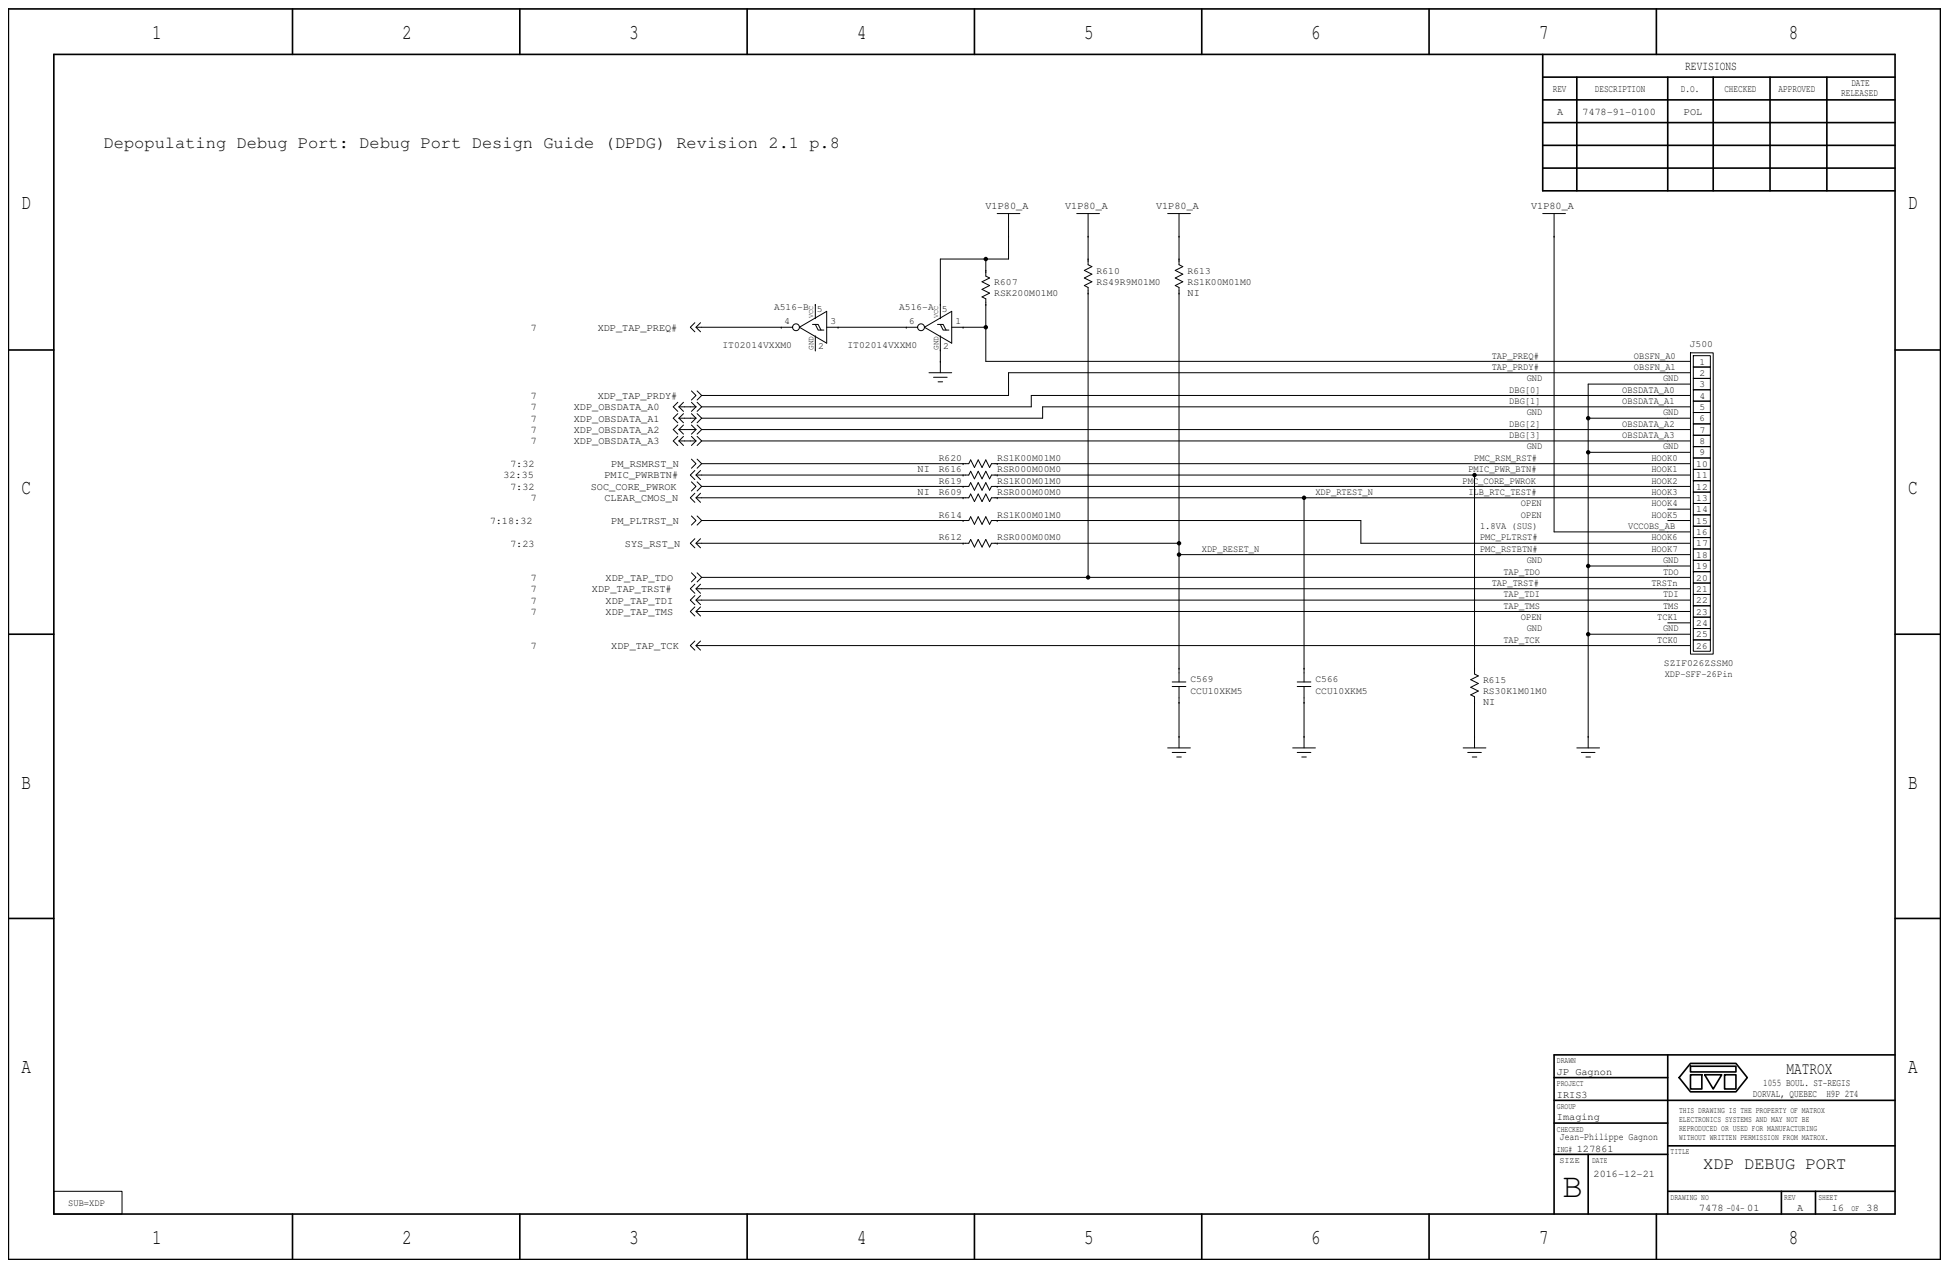
[picture p81: page 16]

Depopulating Debug Port: Debug Port Design Guide (DPDG) Revision 2.1 p.8

THIS DRAWING IS THE PROPERTY OF MATROX
ELECTRONICS SYSTEMS AND MAY NOT BE
REPRODUCED OR USED FOR MANUFACTURING
WITHOUT WRITTEN PERMISSION FROM MATROX.
XDP DEBUG PORT

SIZE | DATE

D

1 | 2 | 3 | 4

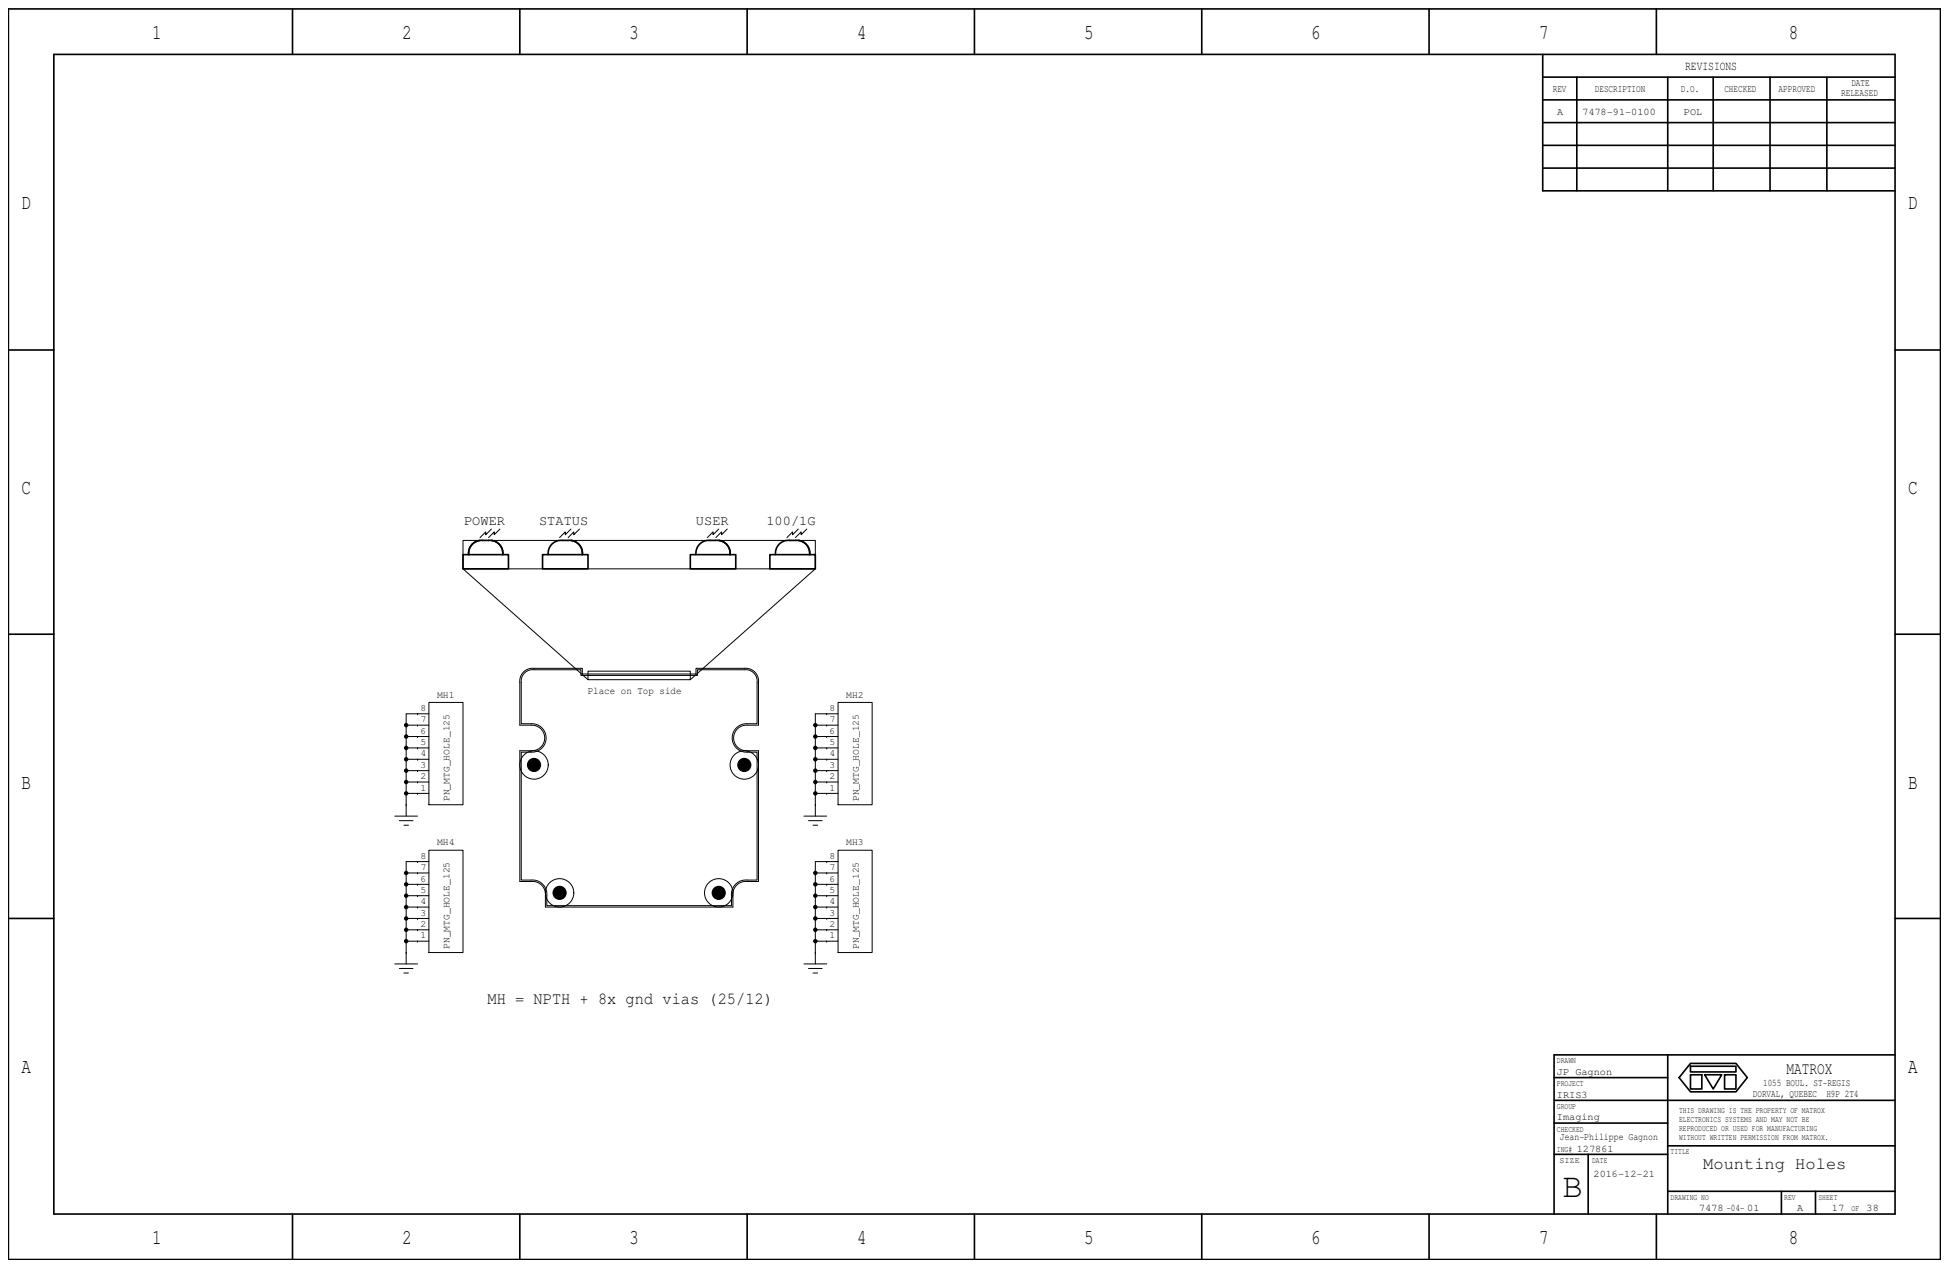
[picture p82: page 17]
PN_MTG_HOLE_125 134567; PN_MTG_HOLE_125 1234567; PN_MTG_HOLE_125 14356; PN_MTG_HOLE_125 1236457; JP Gagnon; IRIS3; Jean-Philippe Gagnon; Imaging; GROUP; DRAWN; CHECKED; PROJECT; ING#; TITLE; POL; MATROX; POWER; STATUS; USER

Place on Top side

MH = NPTH + 8x gnd vias (25/12)

1055 BOUL. ST-REGIS
DORVAL, QUEBEC H9P 2T4

THIS DRAWING IS THE PROPERTY OF MATROX
ELECTRONICS SYSTEMS AND MAY NOT BE
REPRODUCED OR USED FOR MANUFACTURING
WITHOUT WRITTEN PERMISSION FROM MATROX.
Mounting Holes

SIZE | DATE

D

D

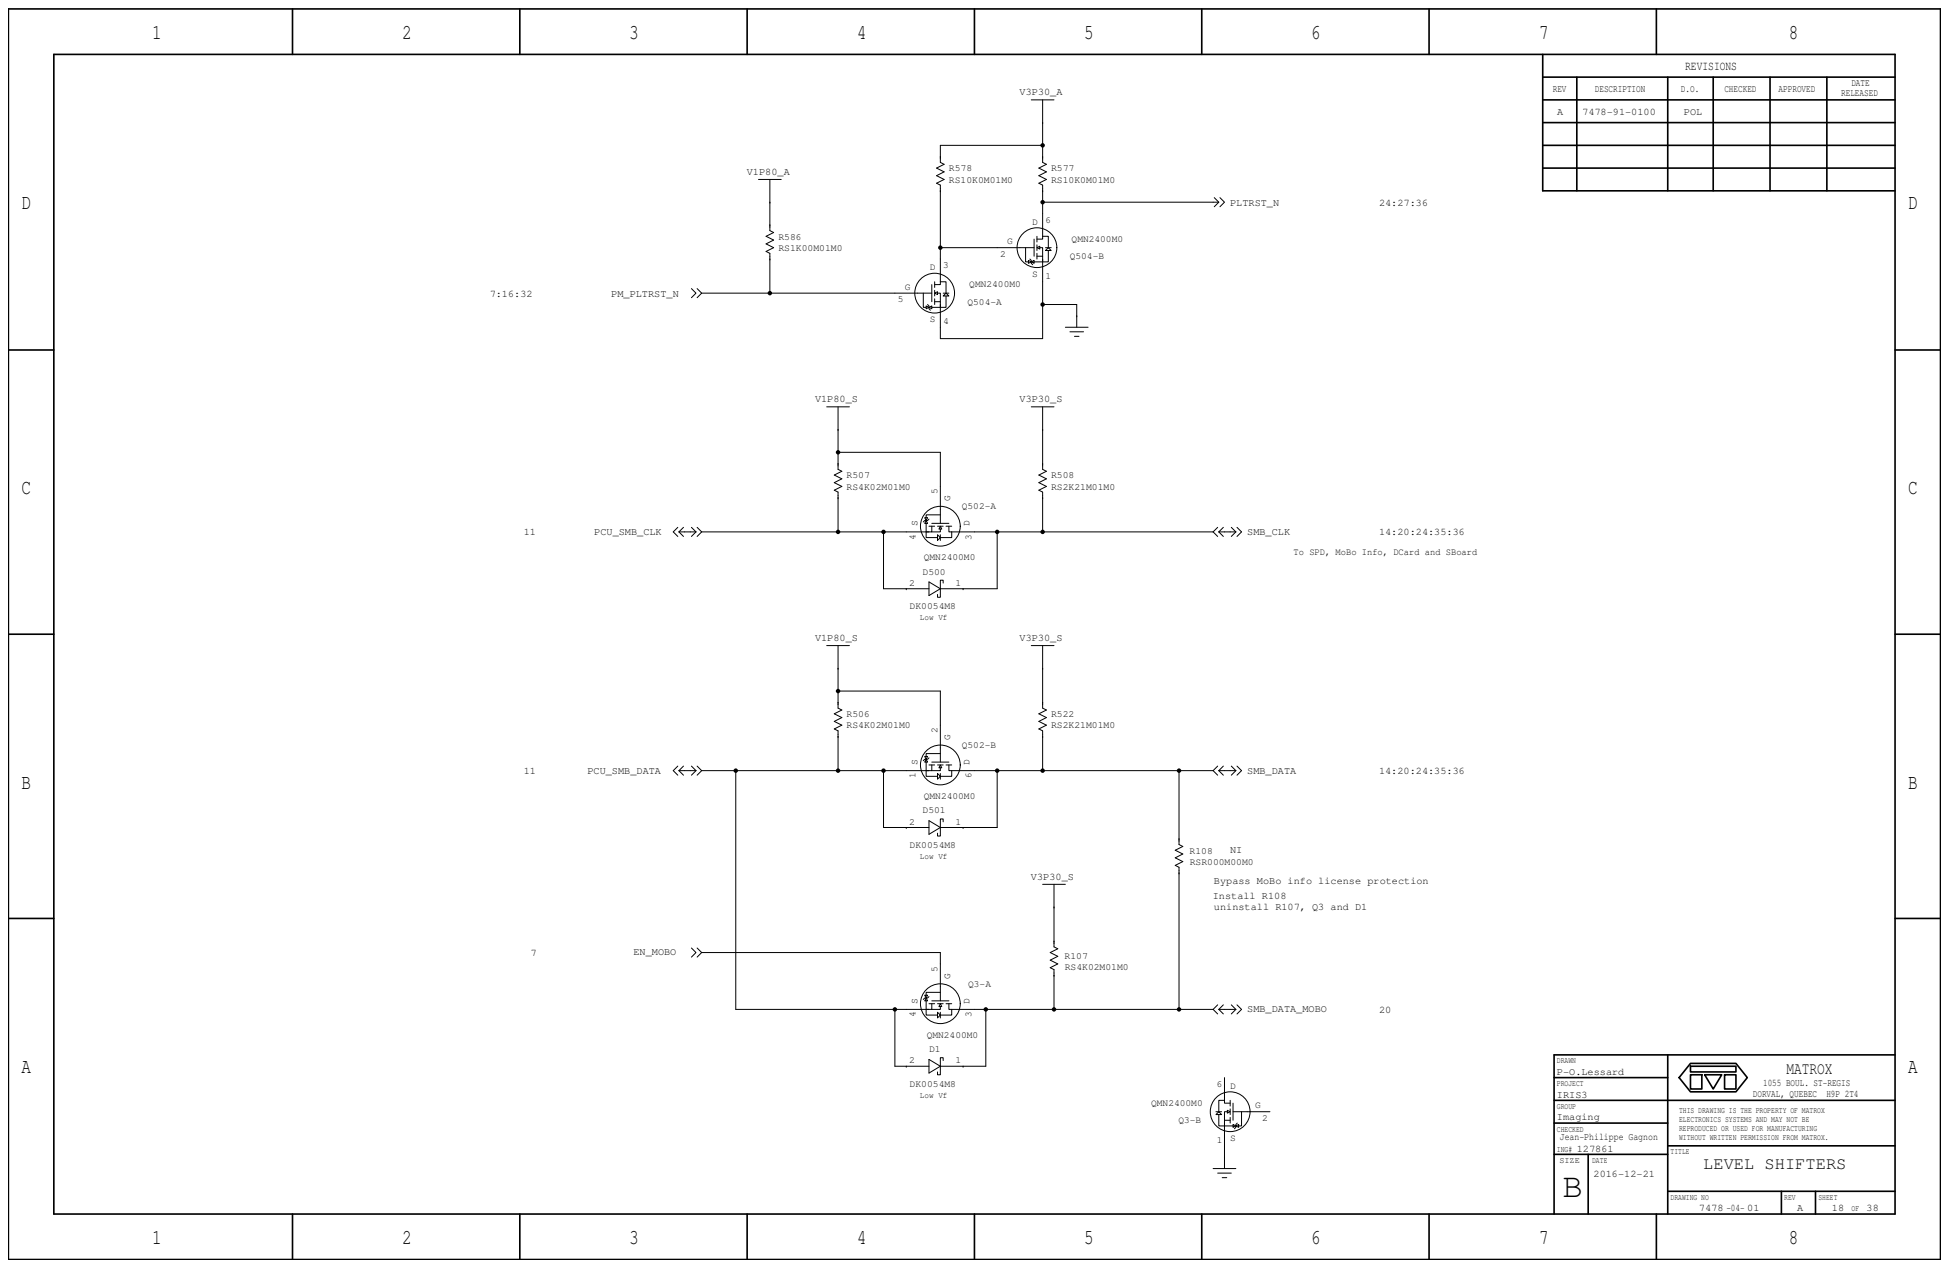
[picture p83: page 18]

A | 7478-91-0100 | POL

To SPD, MoBo Info, DCard and SBoard

Bypass MoBo info license protection
Install R108
uninstall R107, Q3 and D1

THIS DRAWING IS THE PROPERTY OF MATROX
ELECTRONICS SYSTEMS AND MAY NOT BE
REPRODUCED OR USED FOR MANUFACTURING
WITHOUT WRITTEN PERMISSION FROM MATROX.
LEVEL SHIFTERS

SIZE | DATE

D

1 | 2 | 3 | 4

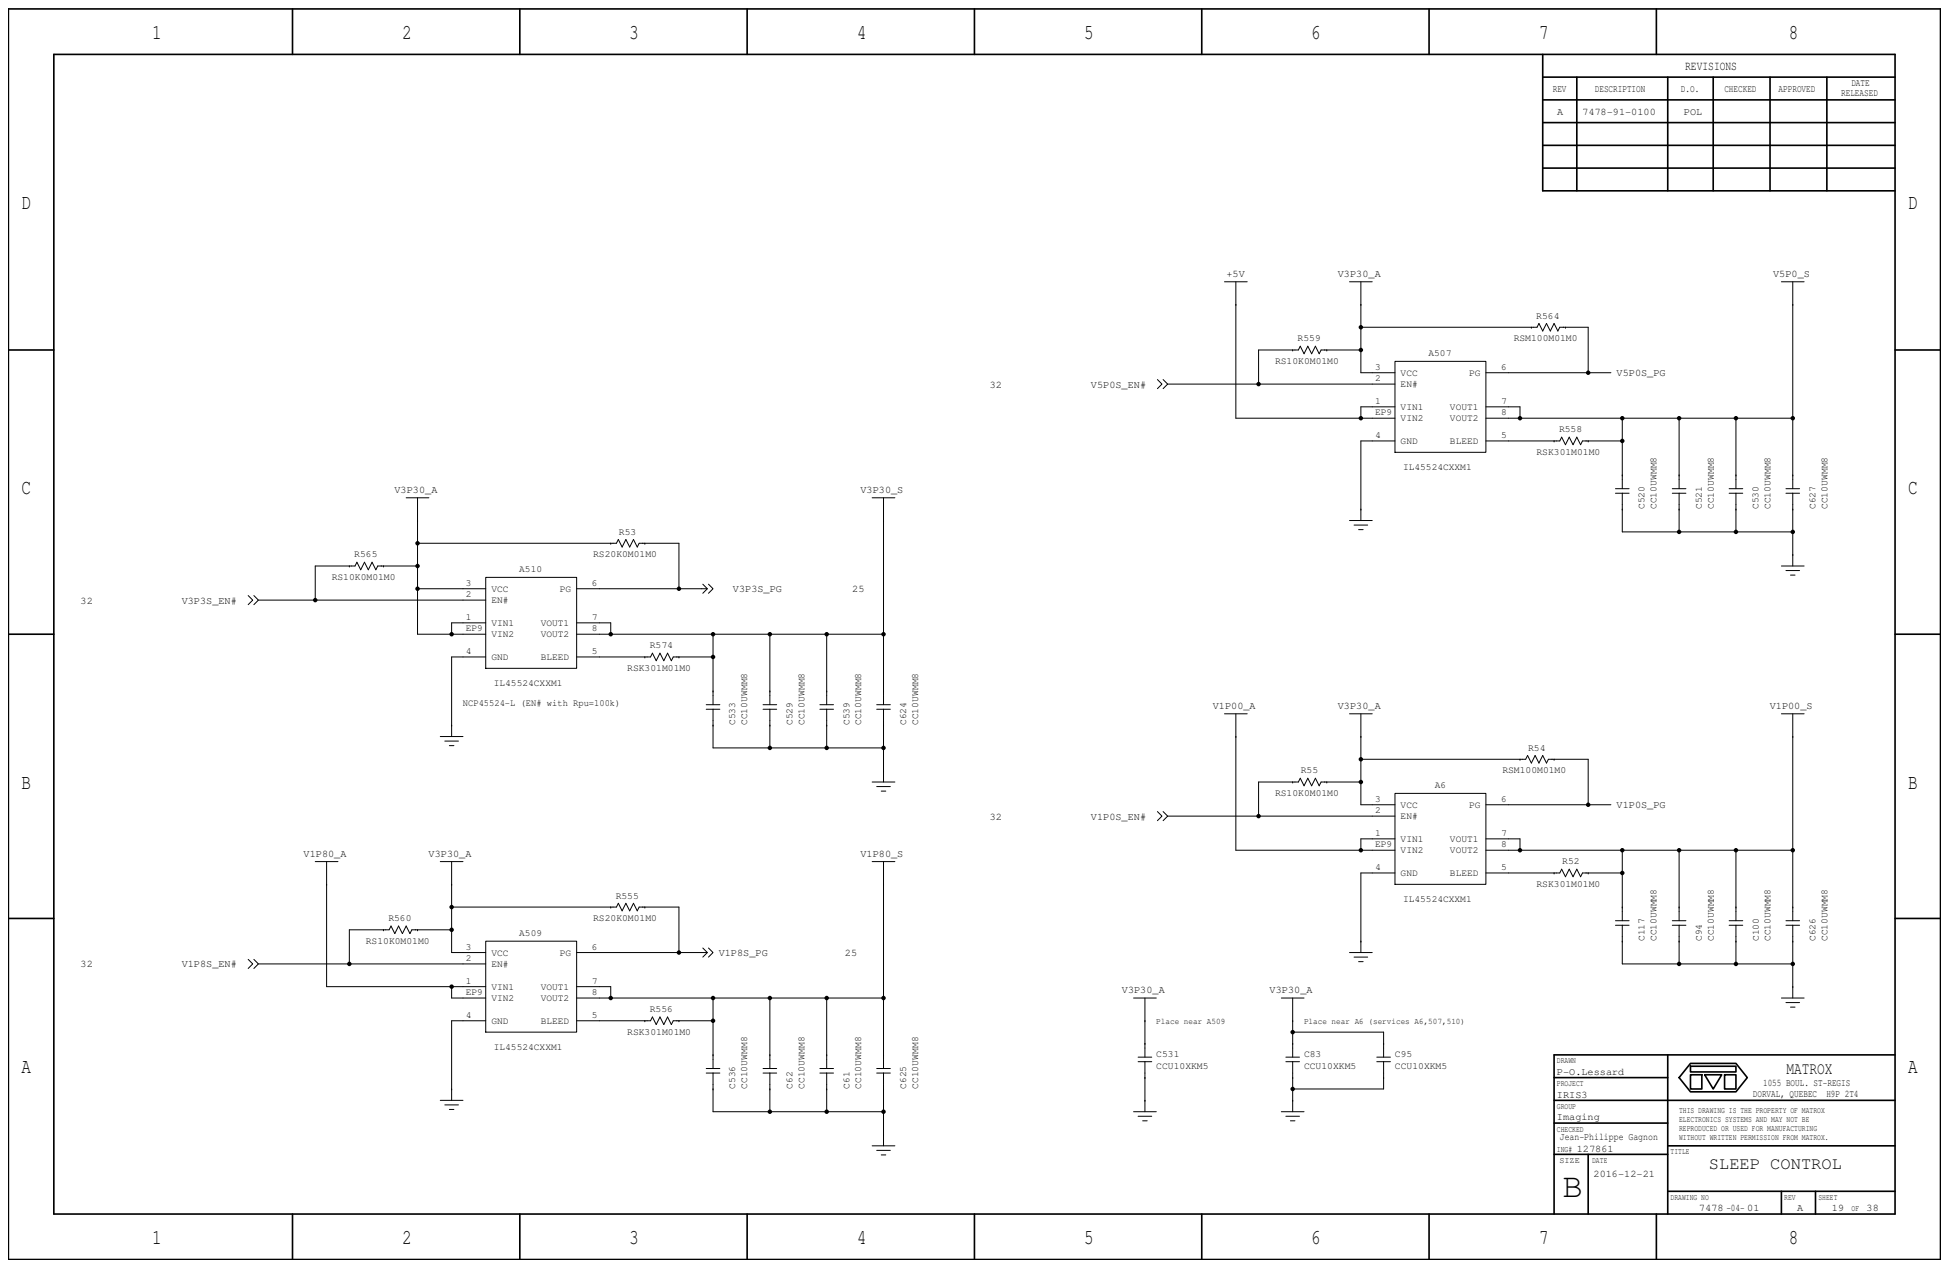
[picture p84: page 19]

THIS DRAWING IS THE PROPERTY OF MATROX
ELECTRONICS SYSTEMS AND MAY NOT BE
REPRODUCED OR USED FOR MANUFACTURING
WITHOUT WRITTEN PERMISSION FROM MATROX.
SLEEP CONTROL

SIZE | DATE

D

1 | 2 | 3 | 4

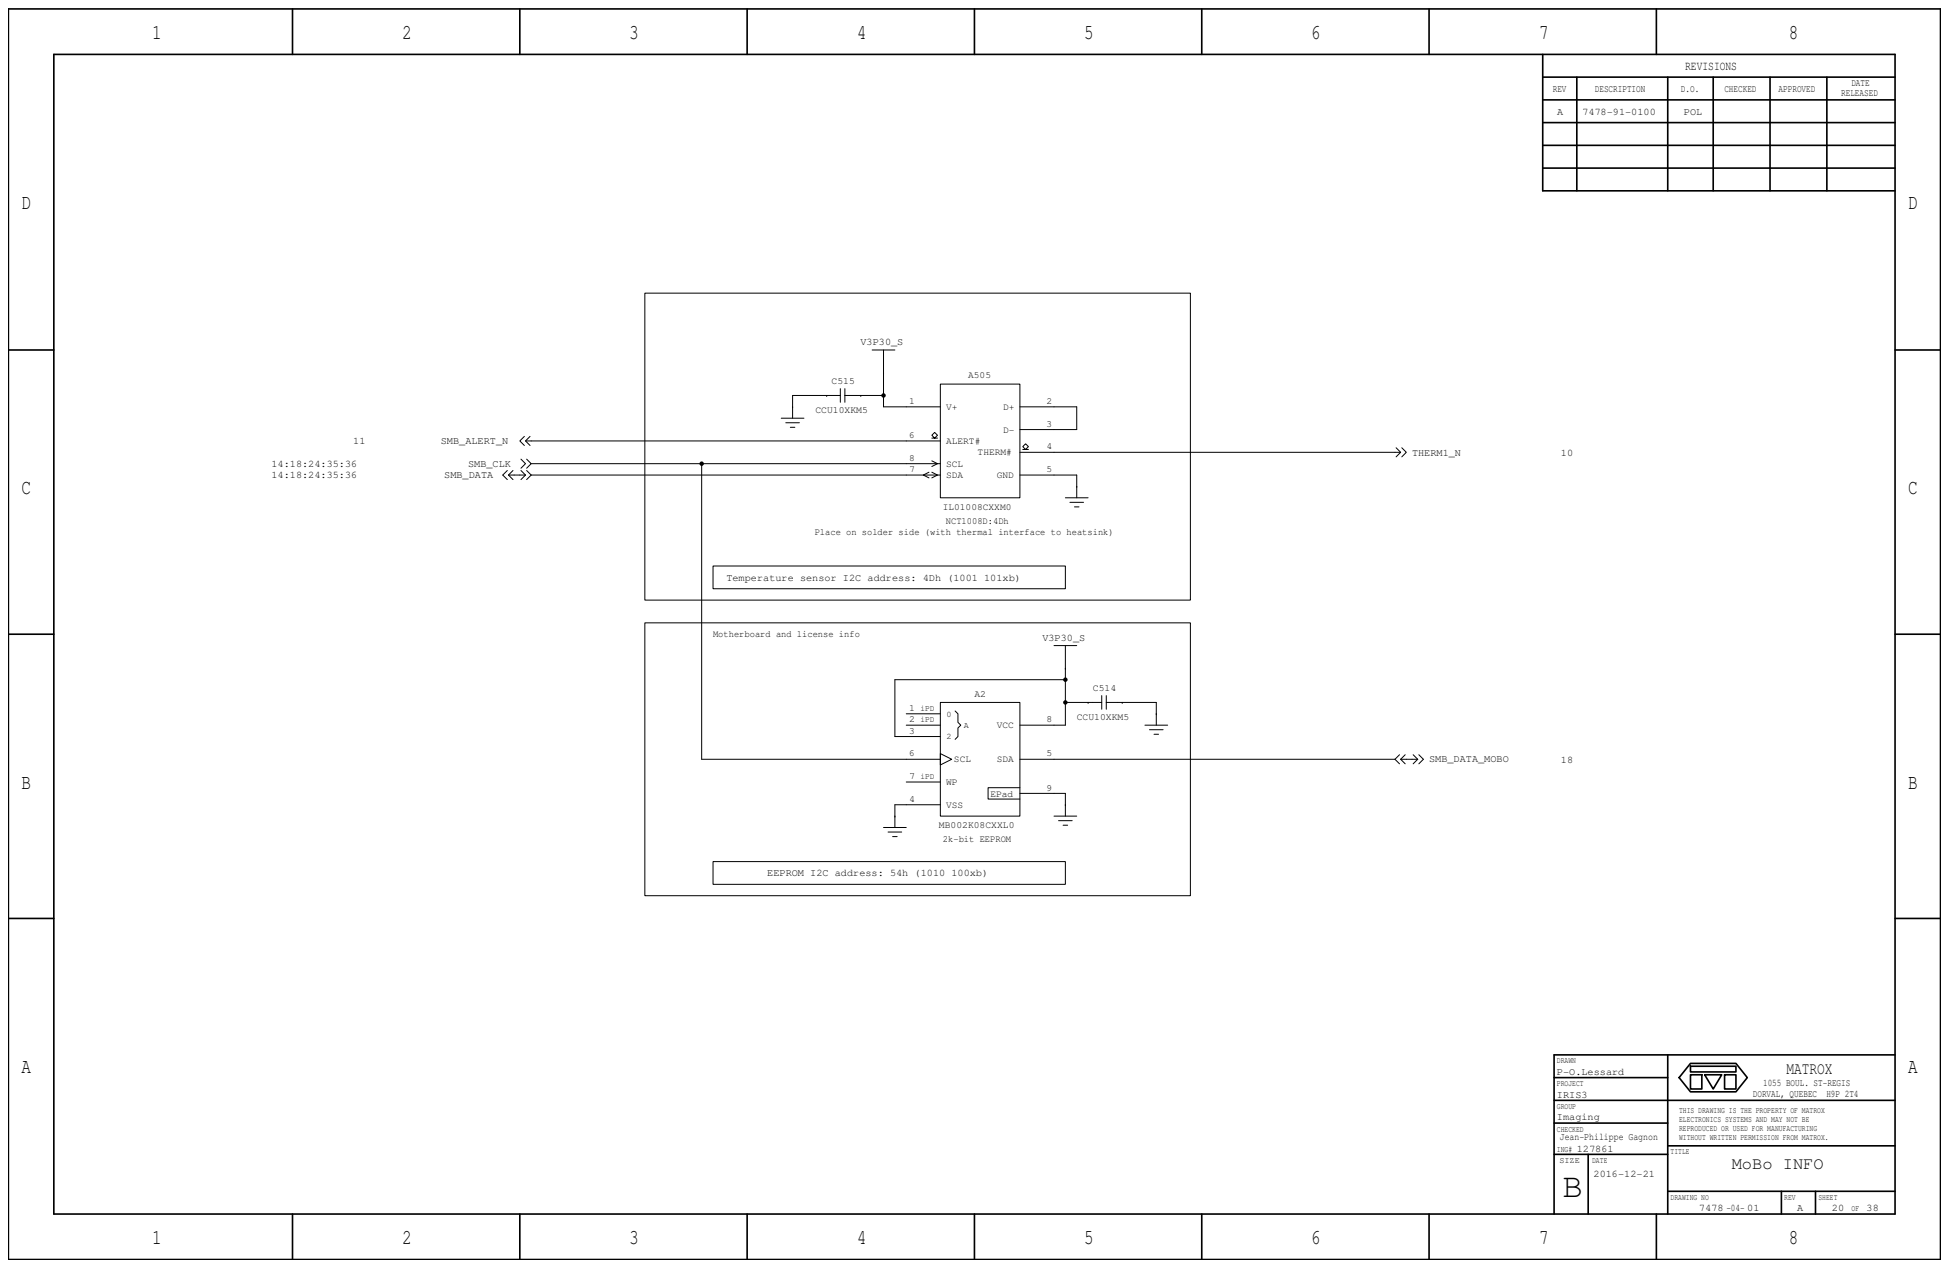
[picture p85: page 20]
MoBo INFO; SMB_DATA; SMB_ALERT_N; SMB_CLK; CCU10XKM5; MB002K08CXXL0; SDA; VCC; EPad; VSS; SCL; THERM#; GND; IL01008CXXM0; ALERT#; P-O.Lessard; IRIS3; Jean-Philippe Gagnon; Imaging; GROUP; DRAWN; CHECKED; PROJECT; ING#; TITLE; SMB_DATA_MOBO; THERM1_N; POL; MATROX; EEPROM I2C address: 54h (1010 100xb); 2k-bit EEPROM; iPD; NCT1008D:4Dh

Place on solder side (with thermal interface to heatsink)

Temperature sensor I2C address: 4Dh (1001 101xb)

Motherboard and license info

1055 BOUL. ST-REGIS
DORVAL, QUEBEC H9P 2T4

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

SIZE | DATE

D

1 | 2 | 3 | 4

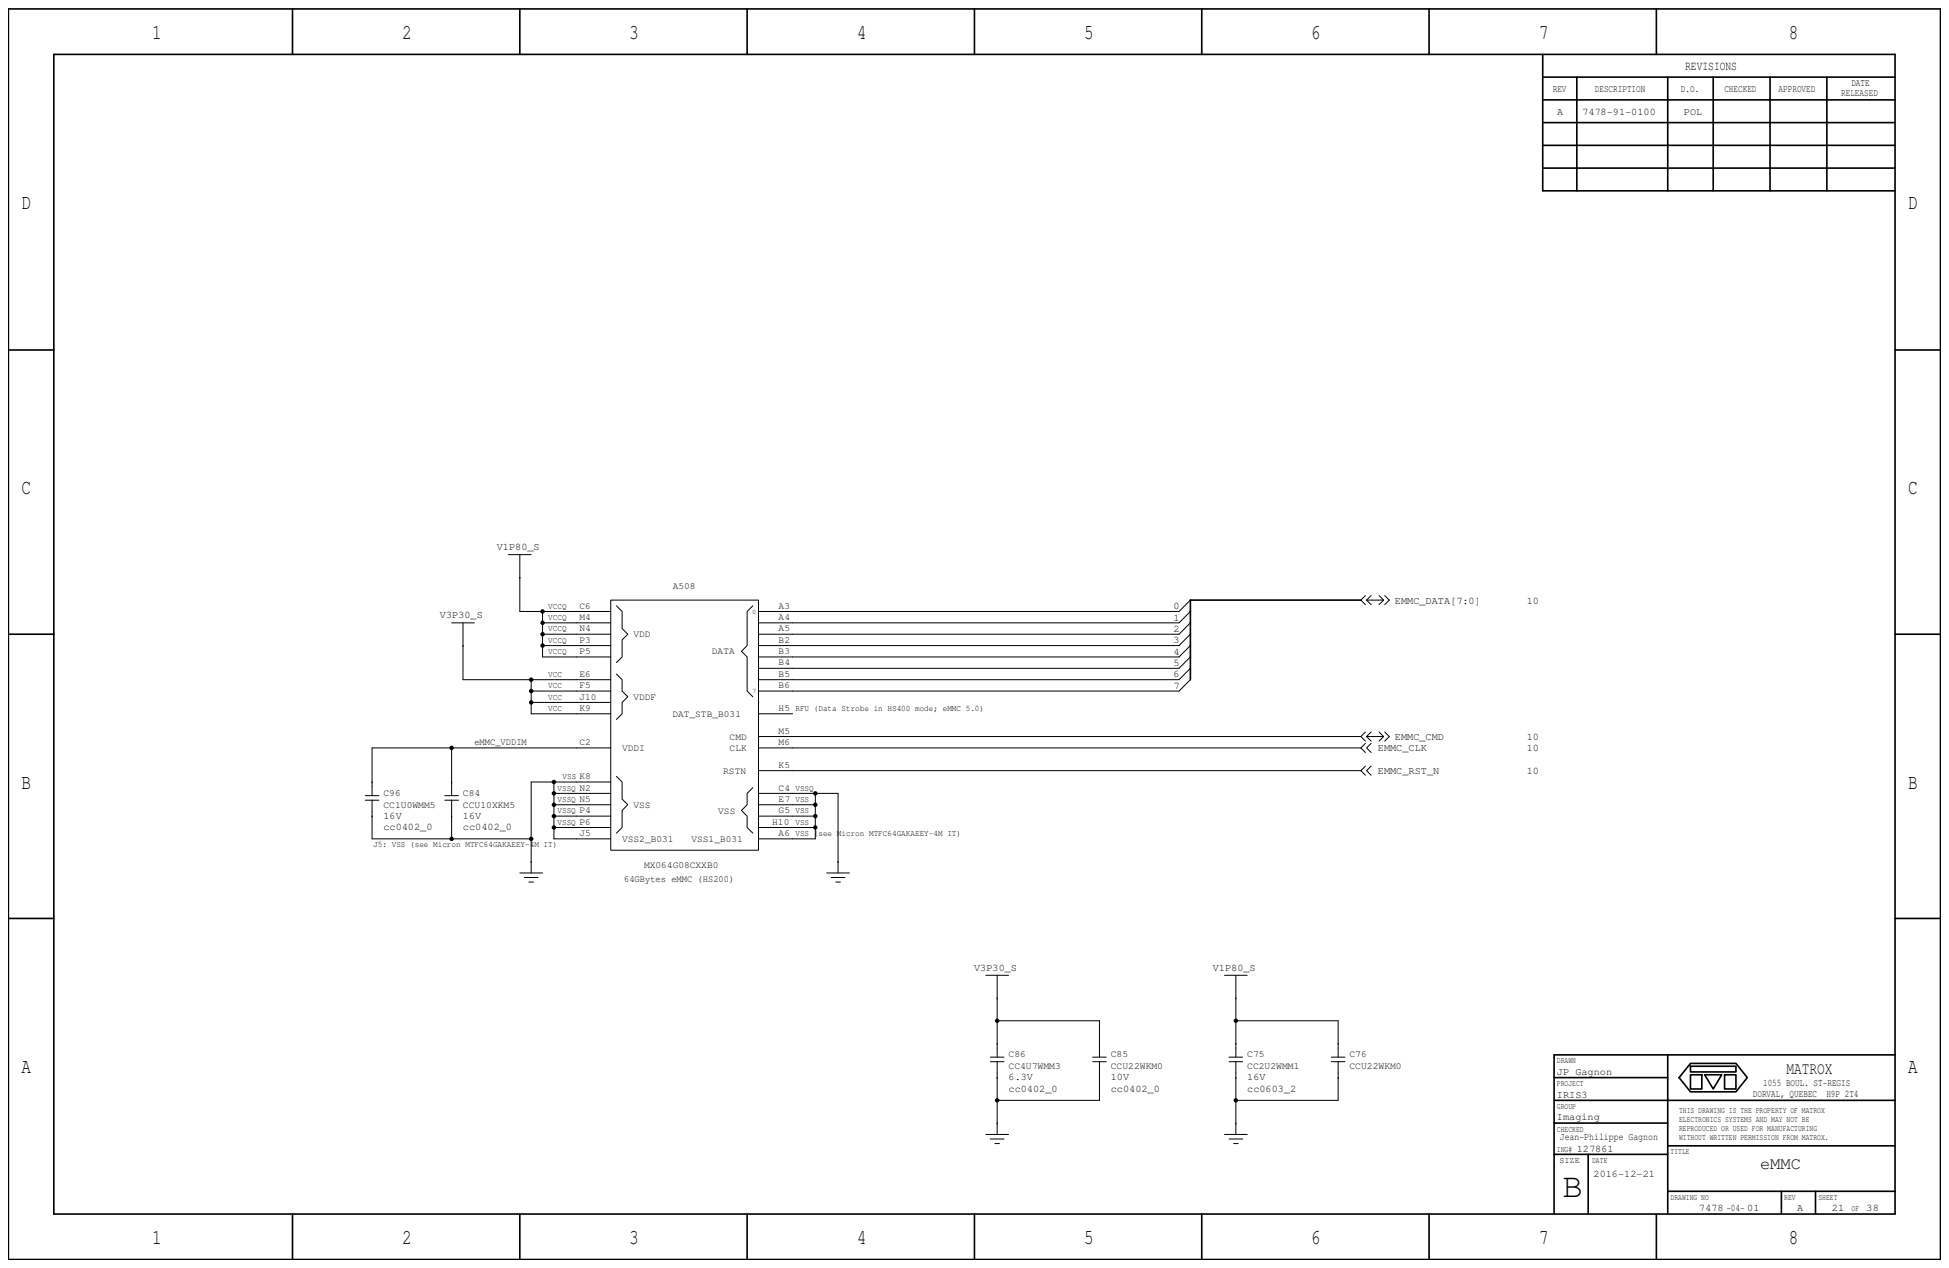
[picture p86: page 21]

RFU (Data Strobe in HS400 mode; eMMC 5.0)

J5: VSS (see Micron MTFC64GAKAEEY-4M IT)

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

SIZE | DATE

D

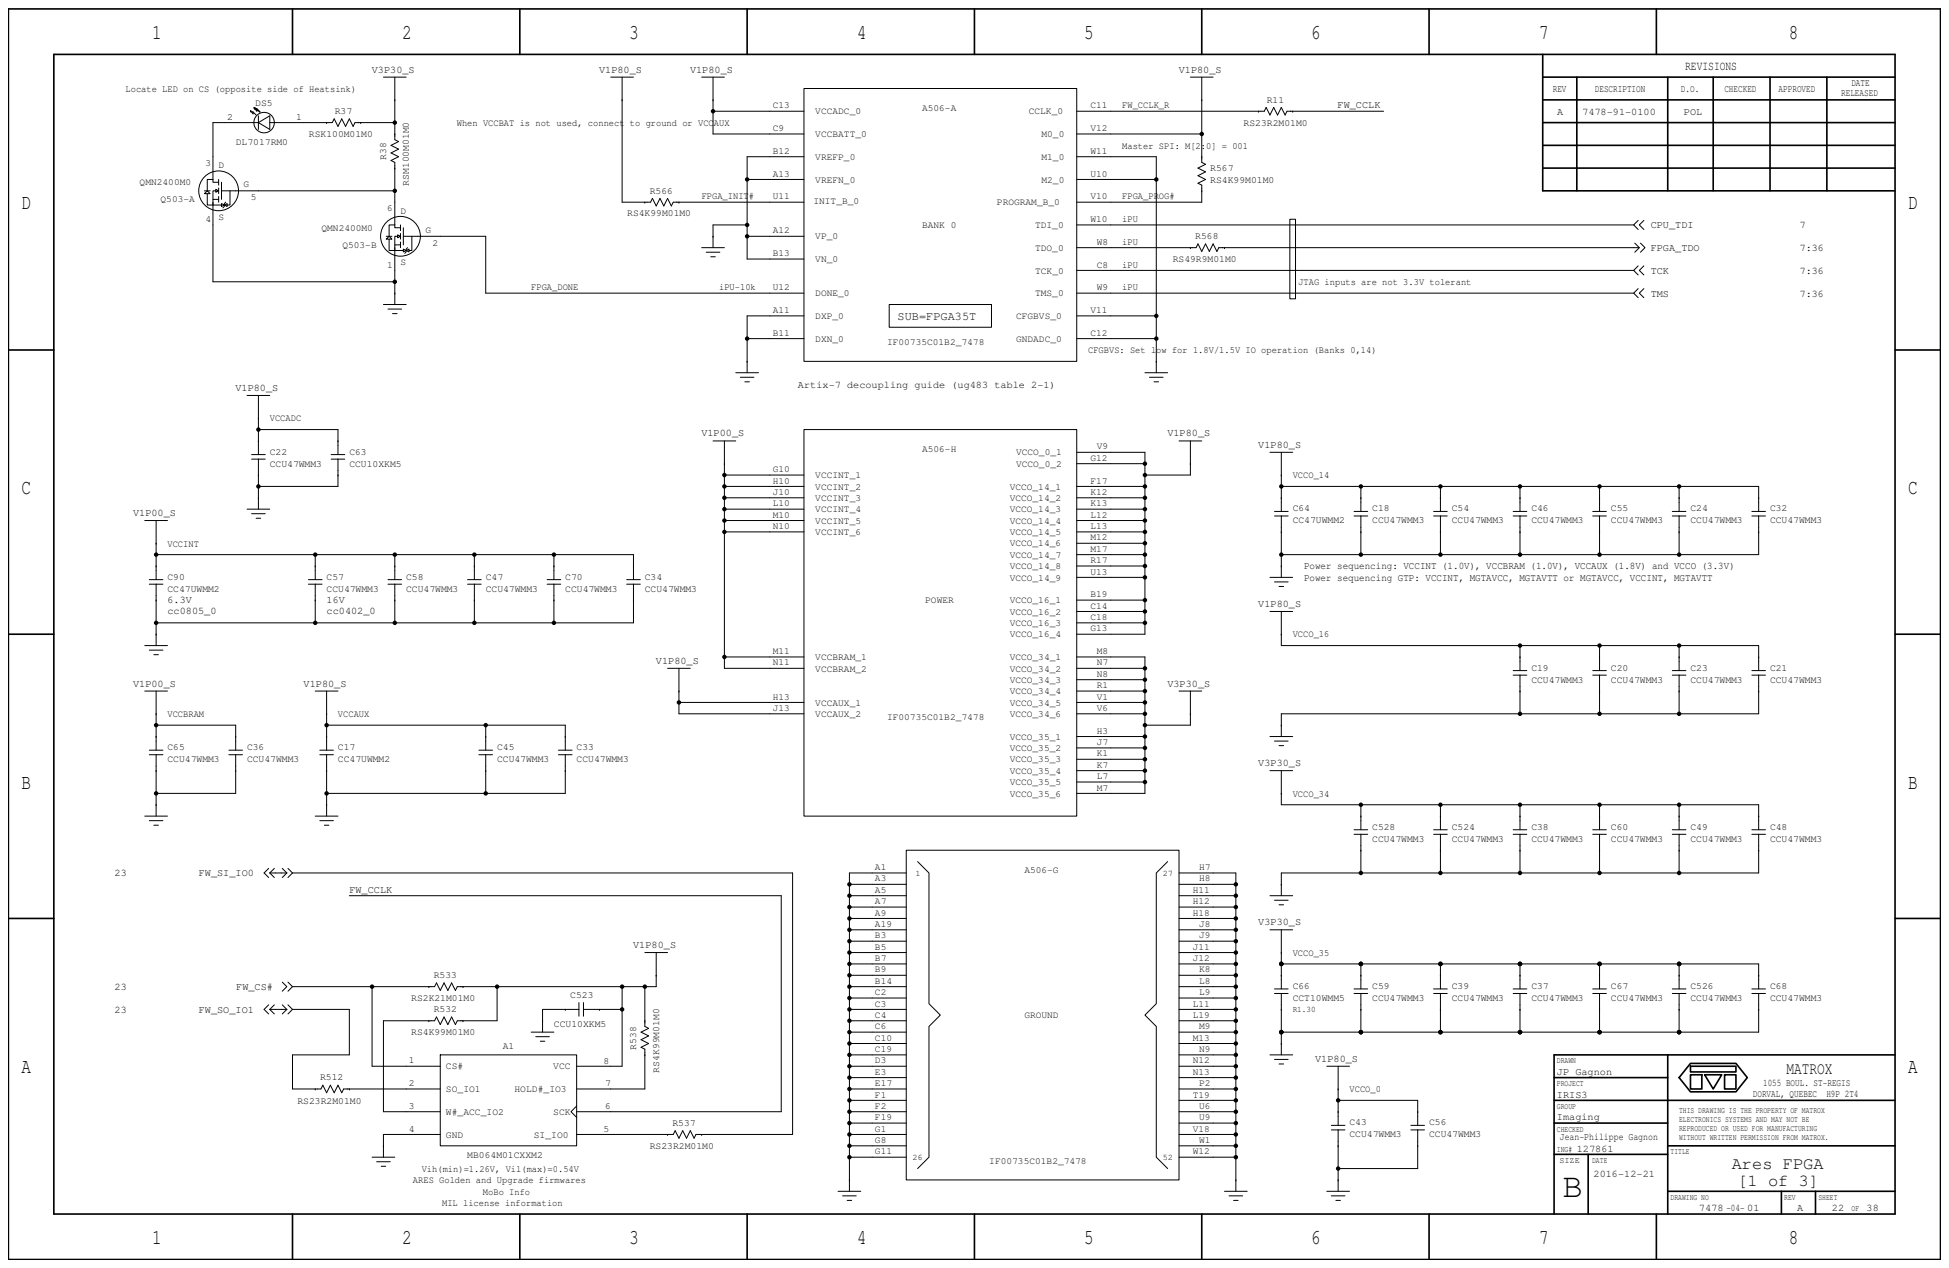
[picture p87: page 22]

Locate LED on CS (opposite side of Heatsink)

When VCCBAT is not used, connect to ground or VCCAUX

JTAG inputs are not 3.3V tolerant

CFGBVS: Set low for 1.8V/1.5V IO operation (Banks 0,14)

Artix-7 decoupling guide (ug483 table 2-1)

Power sequencing: VCCINT (1.0V), VCCBRAM (1.0V), VCCAUX (1.8V) and VCCO (3.3V)
Power sequencing GTP: VCCINT, MGTAVCC, MGTAVTT or MGTAVCC, VCCINT, MGTAVTT

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

SIZE | DATE

Vih(min)=1.26V, Vil(max)=0.54V
ARES Golden and Upgrade firmwares

D

A506-B

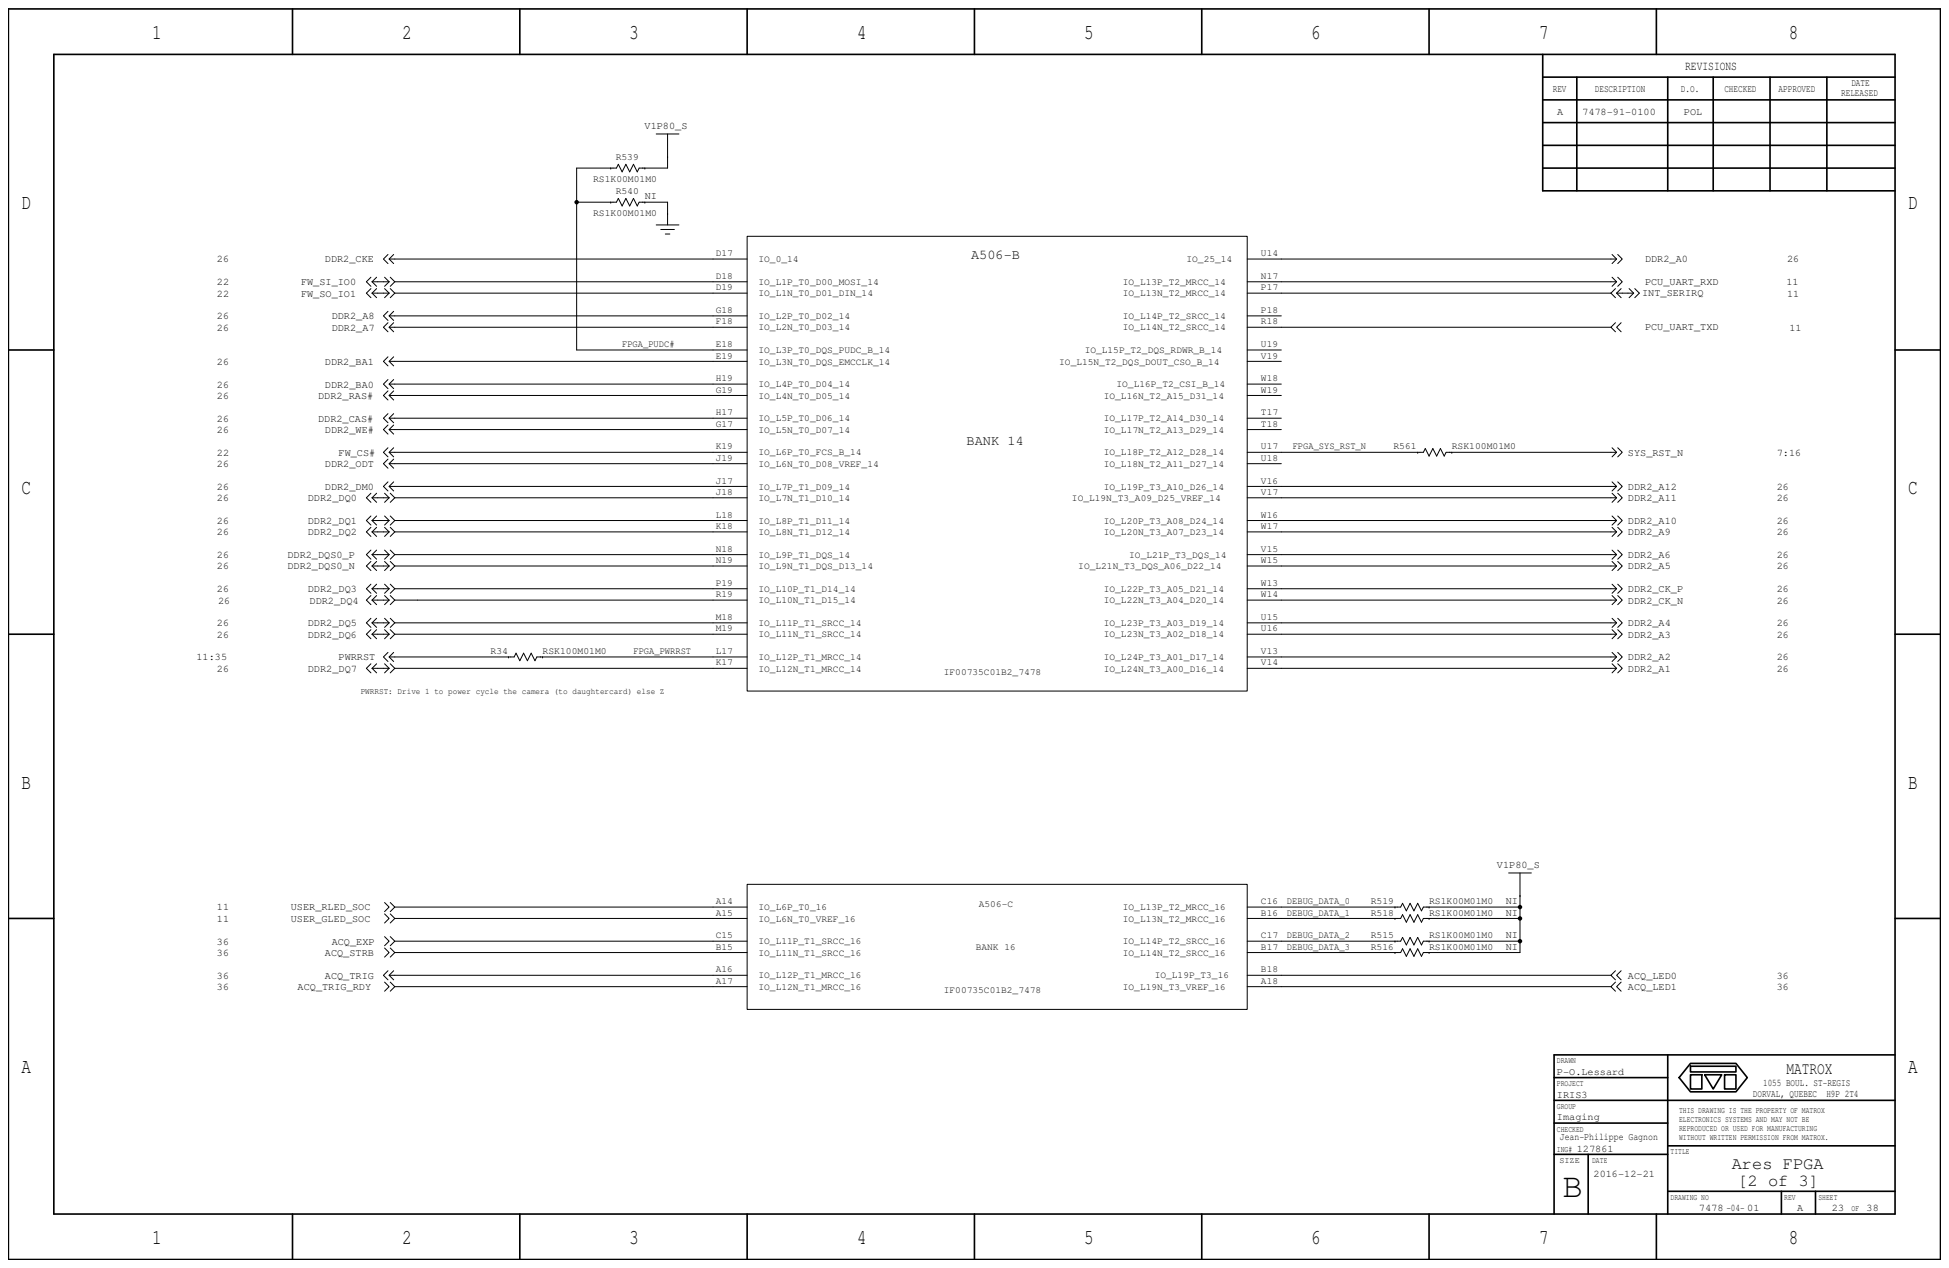
[picture p88: page 23]

PWRRST: Drive 1 to power cycle the camera (to daughtercard) else Z

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

SIZE | DATE

D

2 3

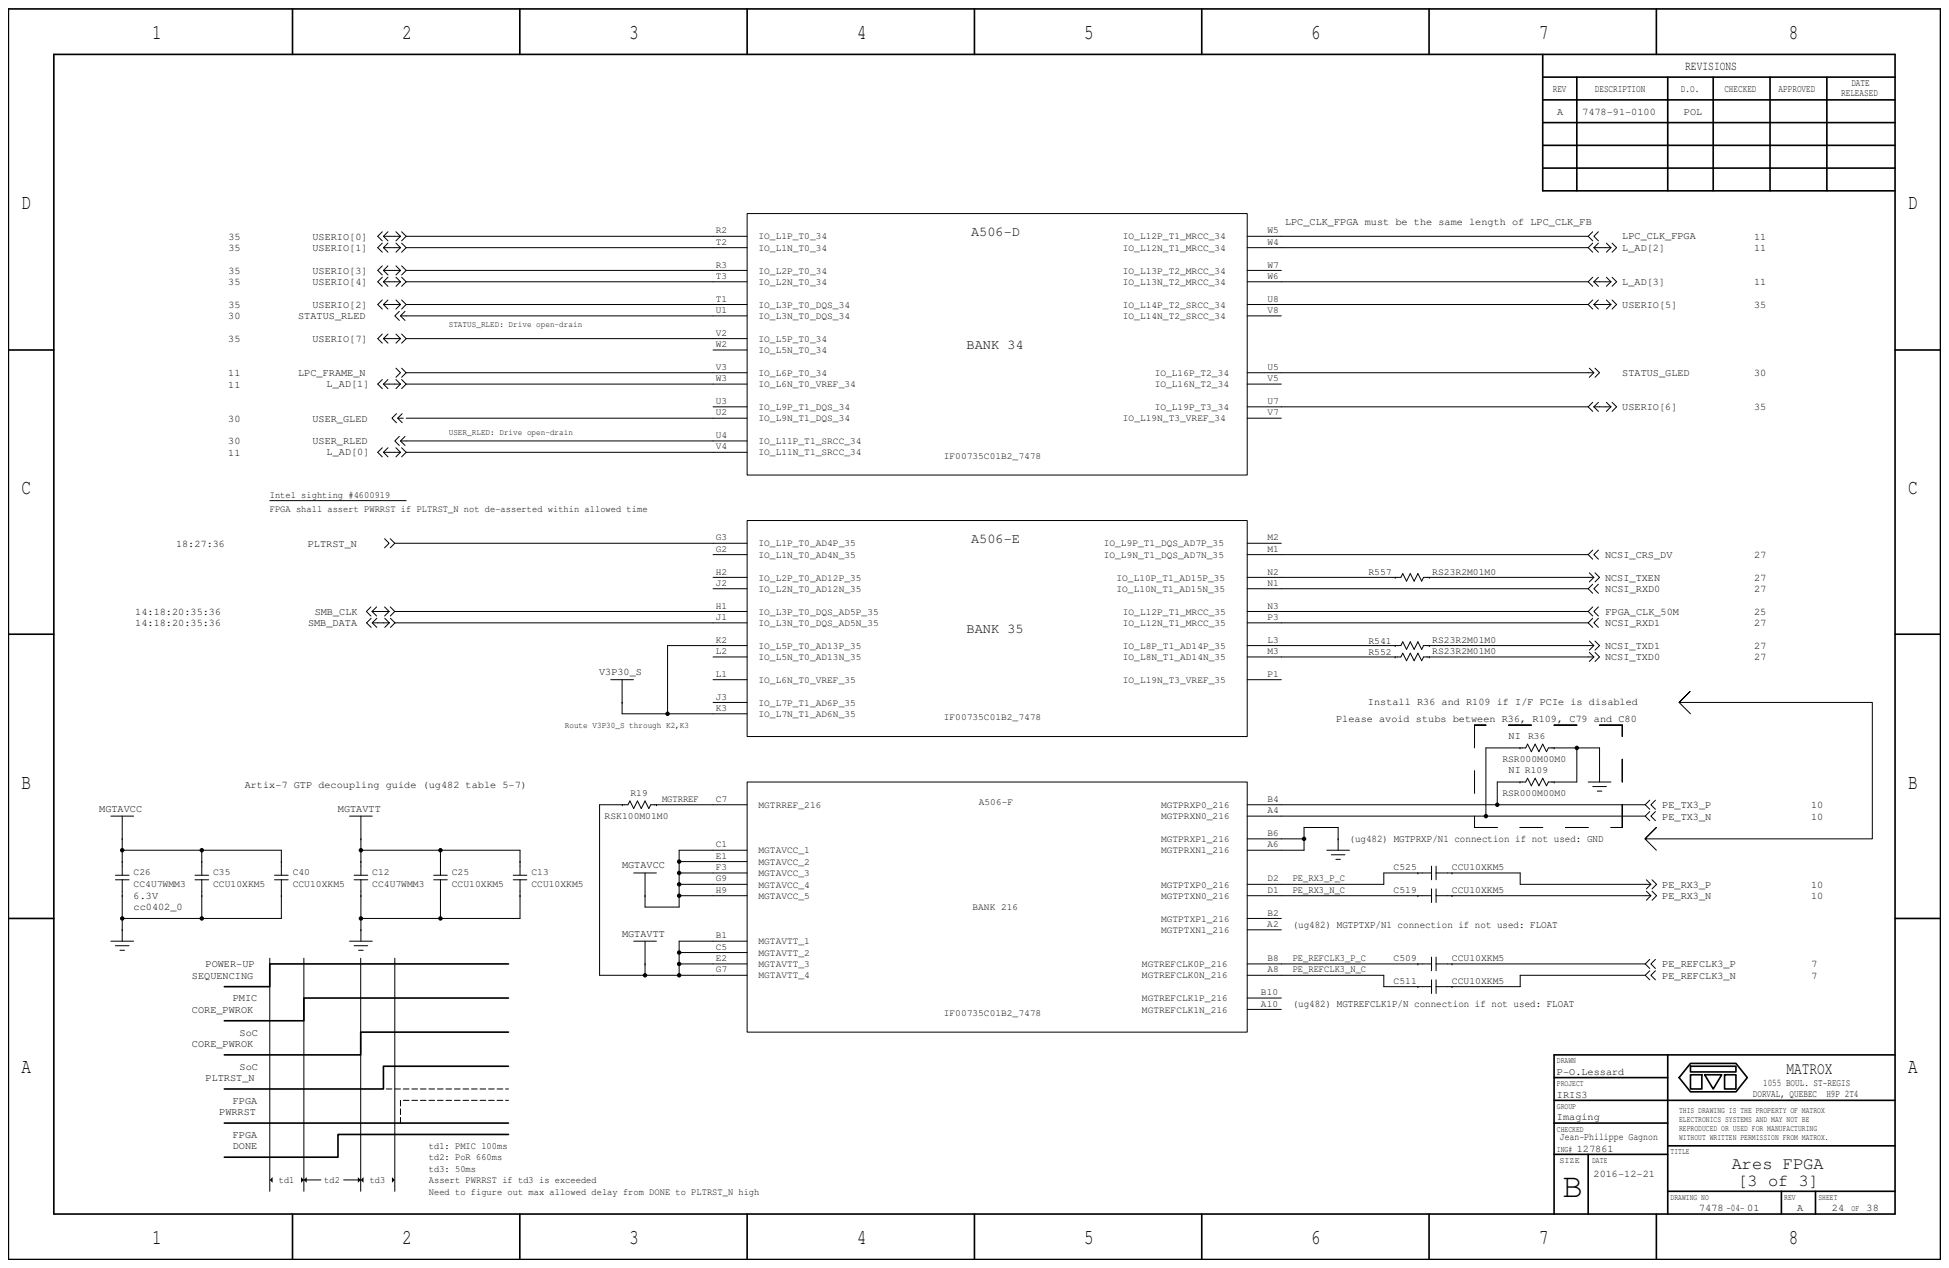
[picture p89: page 24]

LPC_CLK_FPGA must be the same length of LPC_CLK_FB

Intel sighting #4600919
FPGA shall assert PWRRST if PLTRST_N not de-asserted within allowed time

Install R36 and R109 if I/F PCIe is disabled

Please avoid stubs between R36, R109, C79 and C80

Artix-7 GTP decoupling guide (ug482 table 5-7)

(ug482) MGTPRXP/N1 connection if not used: GND

(ug482) MGTPTXP/N1 connection if not used: FLOAT

(ug482) MGTREFCLK1P/N connection if not used: FLOAT

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

td1: PMIC 100ms
td2: PoR 660ms
Assert PWRRST if td3 is exceeded
Need to figure out max allowed delay from DONE to PLTRST_N high

SIZE | DATE

D

D

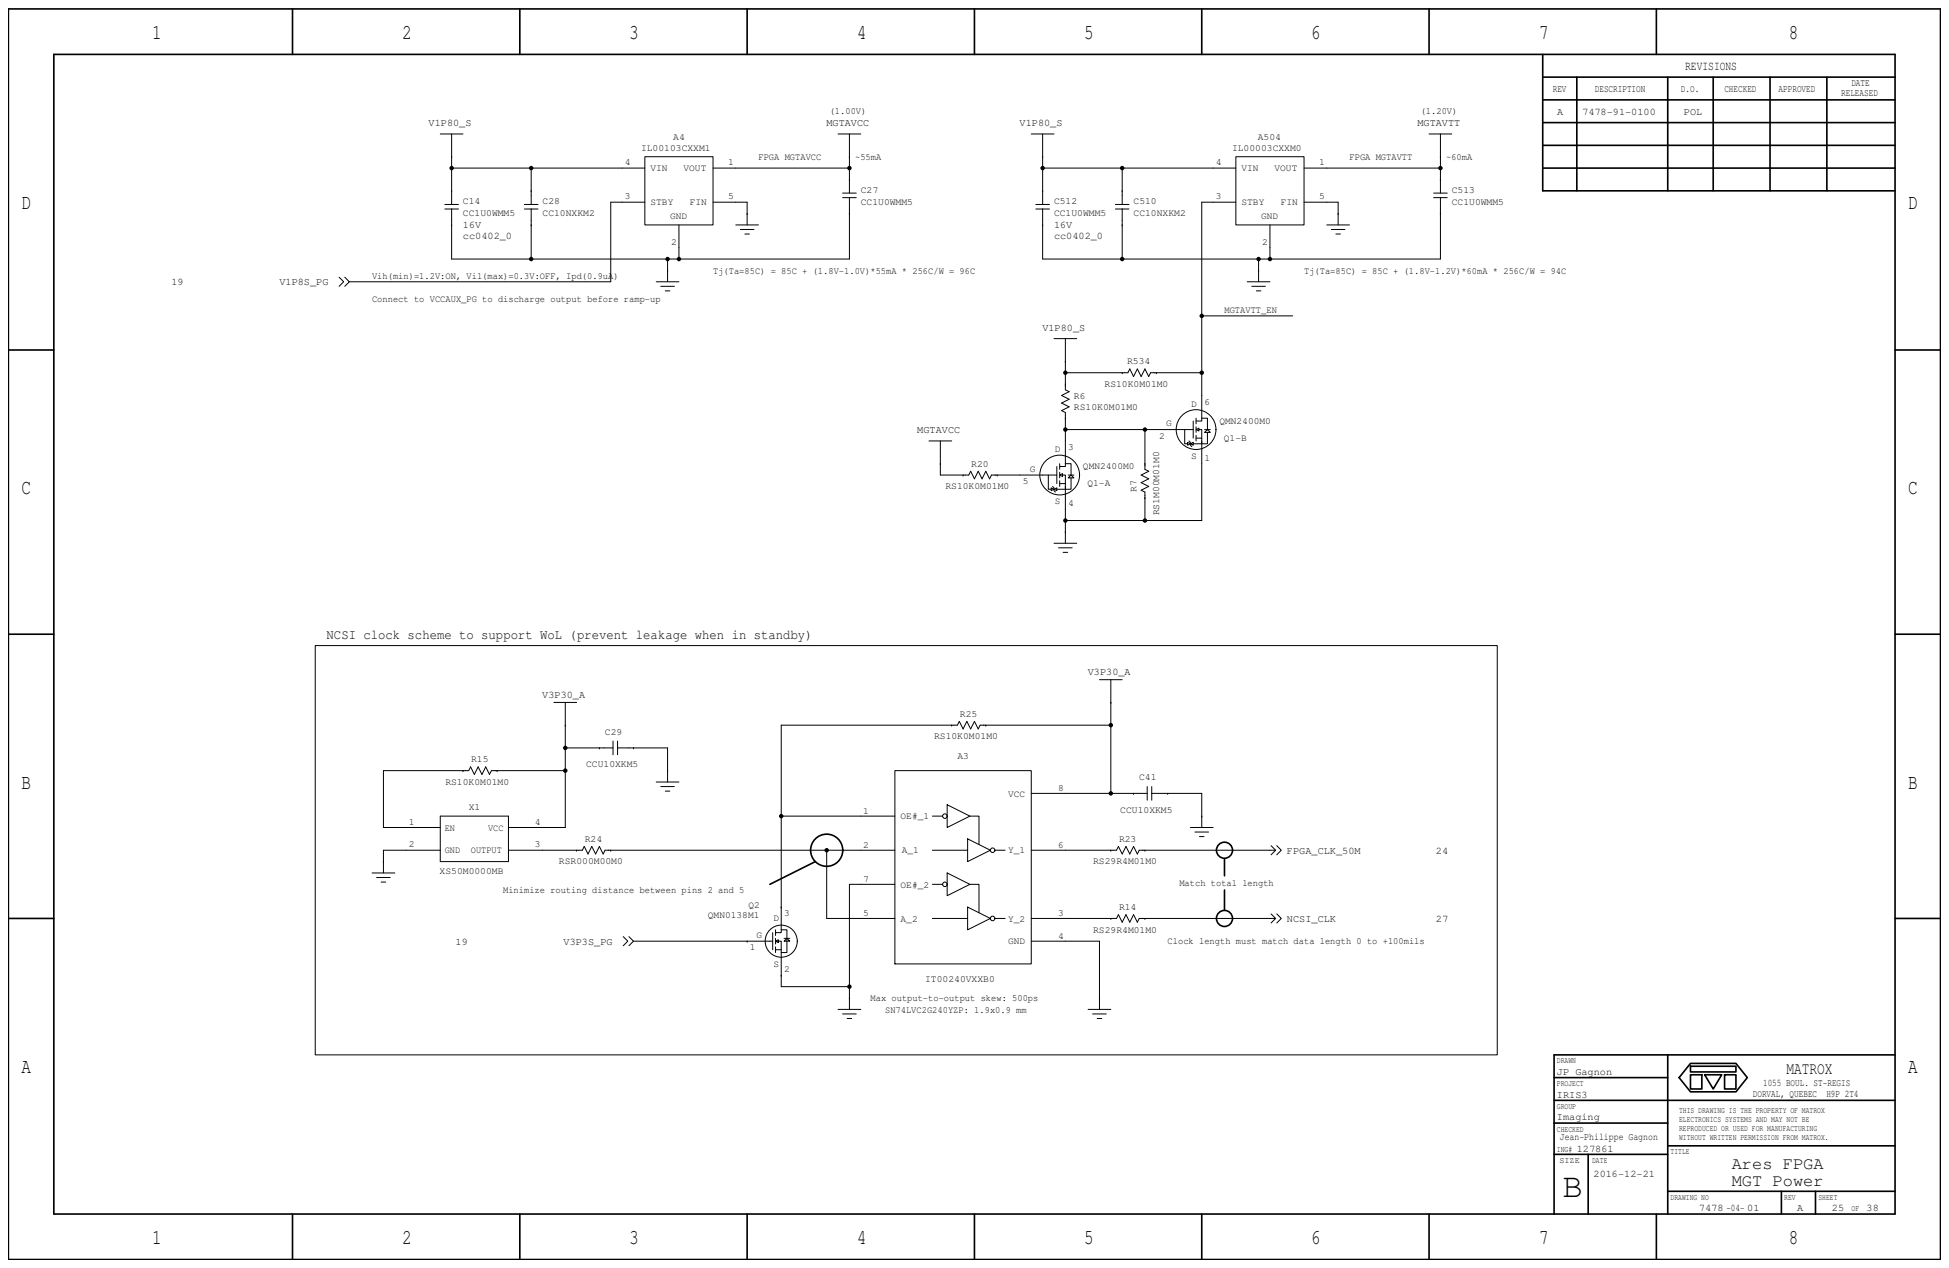
[picture p90: page 25]

Vih(min)=1.2V:ON, Vil(max)=0.3V:OFF, Ipd(0.9uA)

Connect to VCCAUX_PG to discharge output before ramp-up

NCSI clock scheme to support WoL (prevent leakage when in standby)

Minimize routing distance between pins 2 and 5

Clock length must match data length 0 to +100mils

Max output-to-output skew: 500ps
SN74LVC2G240YZP: 1.9x0.9 mm

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

SIZE | DATE

D

| 2 3

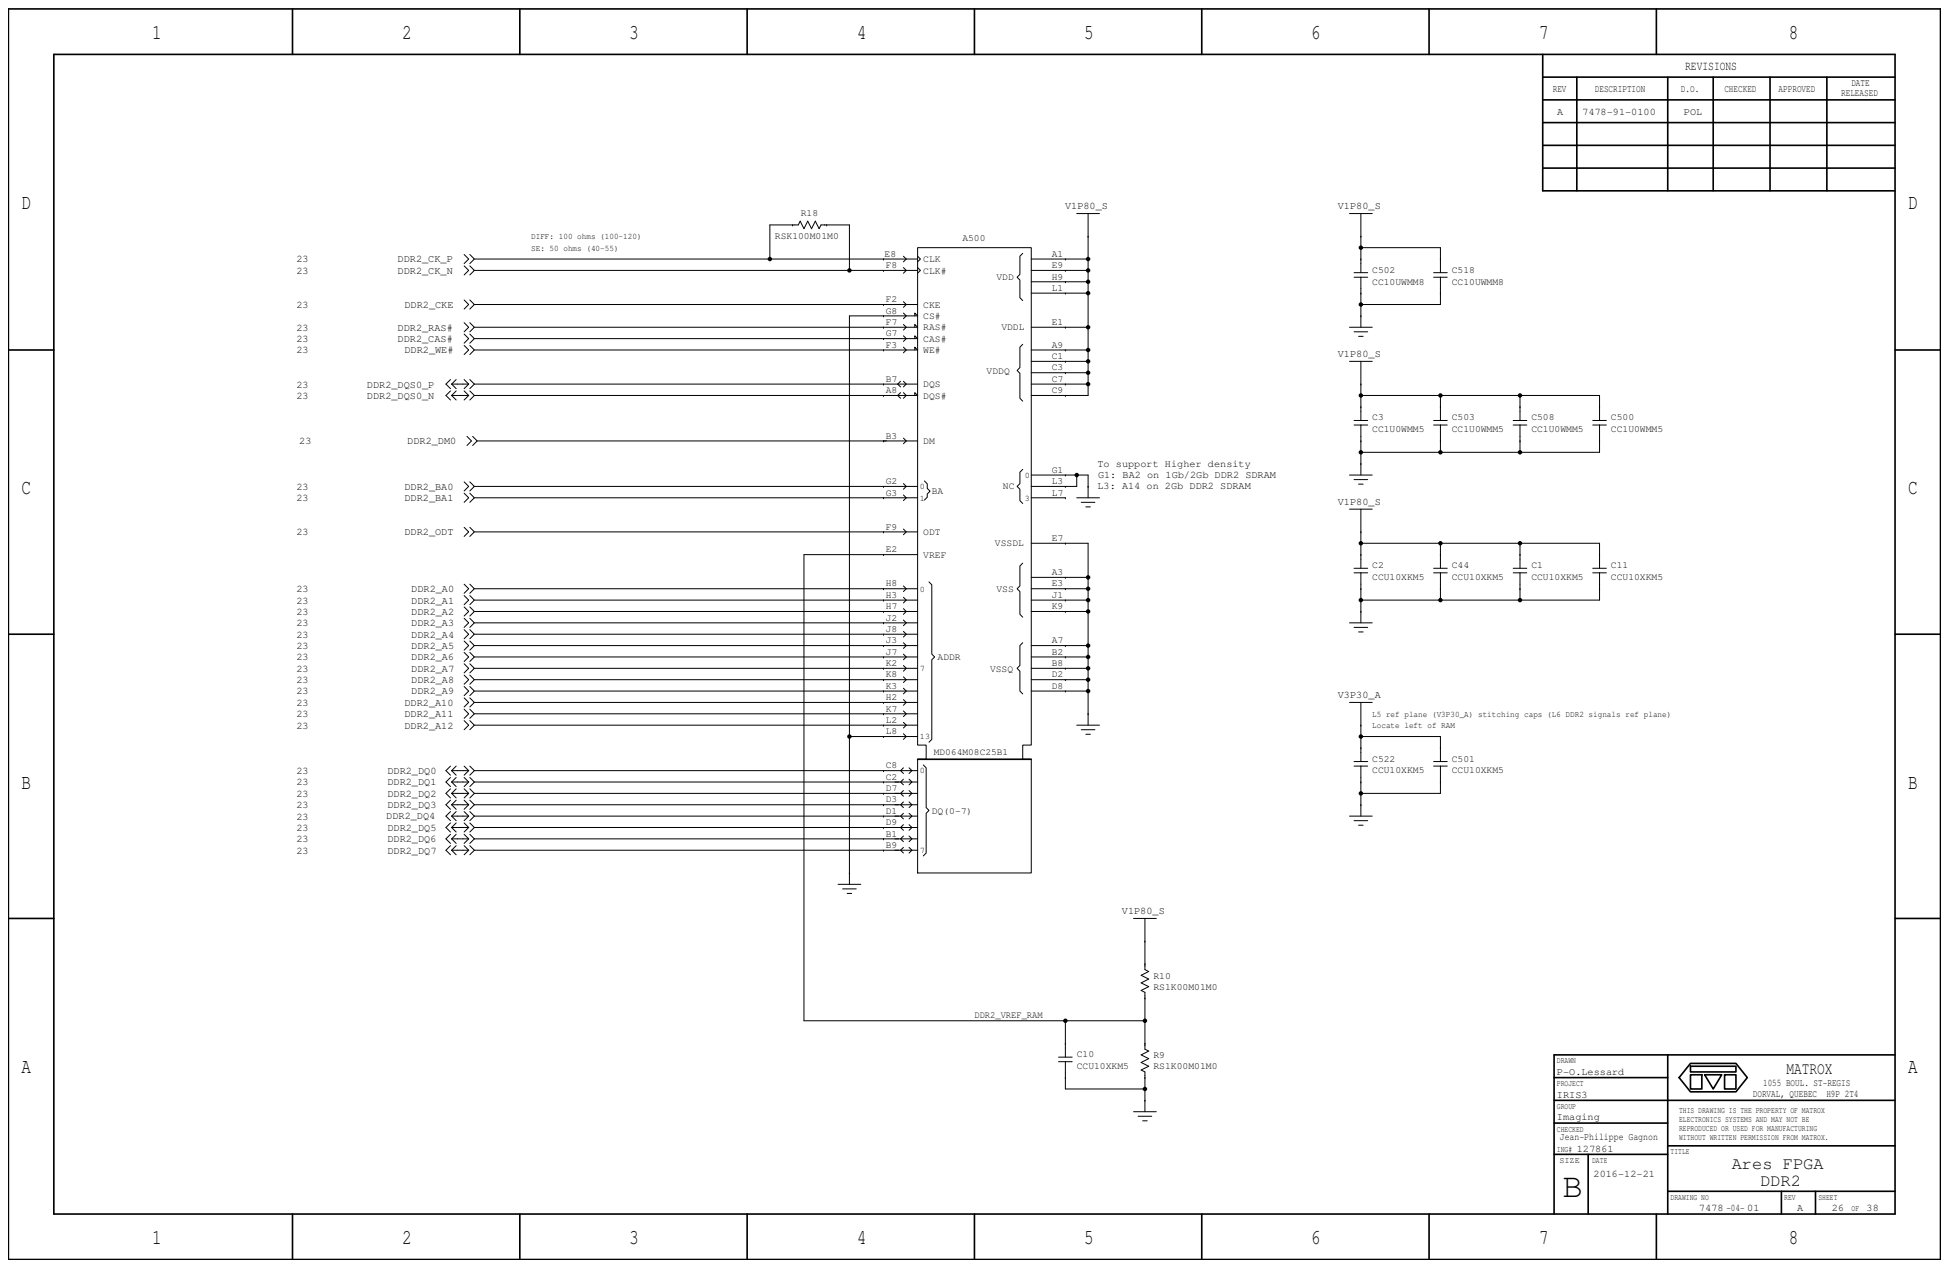
[picture p91: page 26]

To support Higher density
G1: BA2 on 1Gb/2Gb DDR2 SDRAM
L3: A14 on 2Gb DDR2 SDRAM

L5 ref plane (V3P30_A) stitching caps (L6 DDR2 signals ref plane)
Locate left of RAM

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

SIZE | DATE

D

D

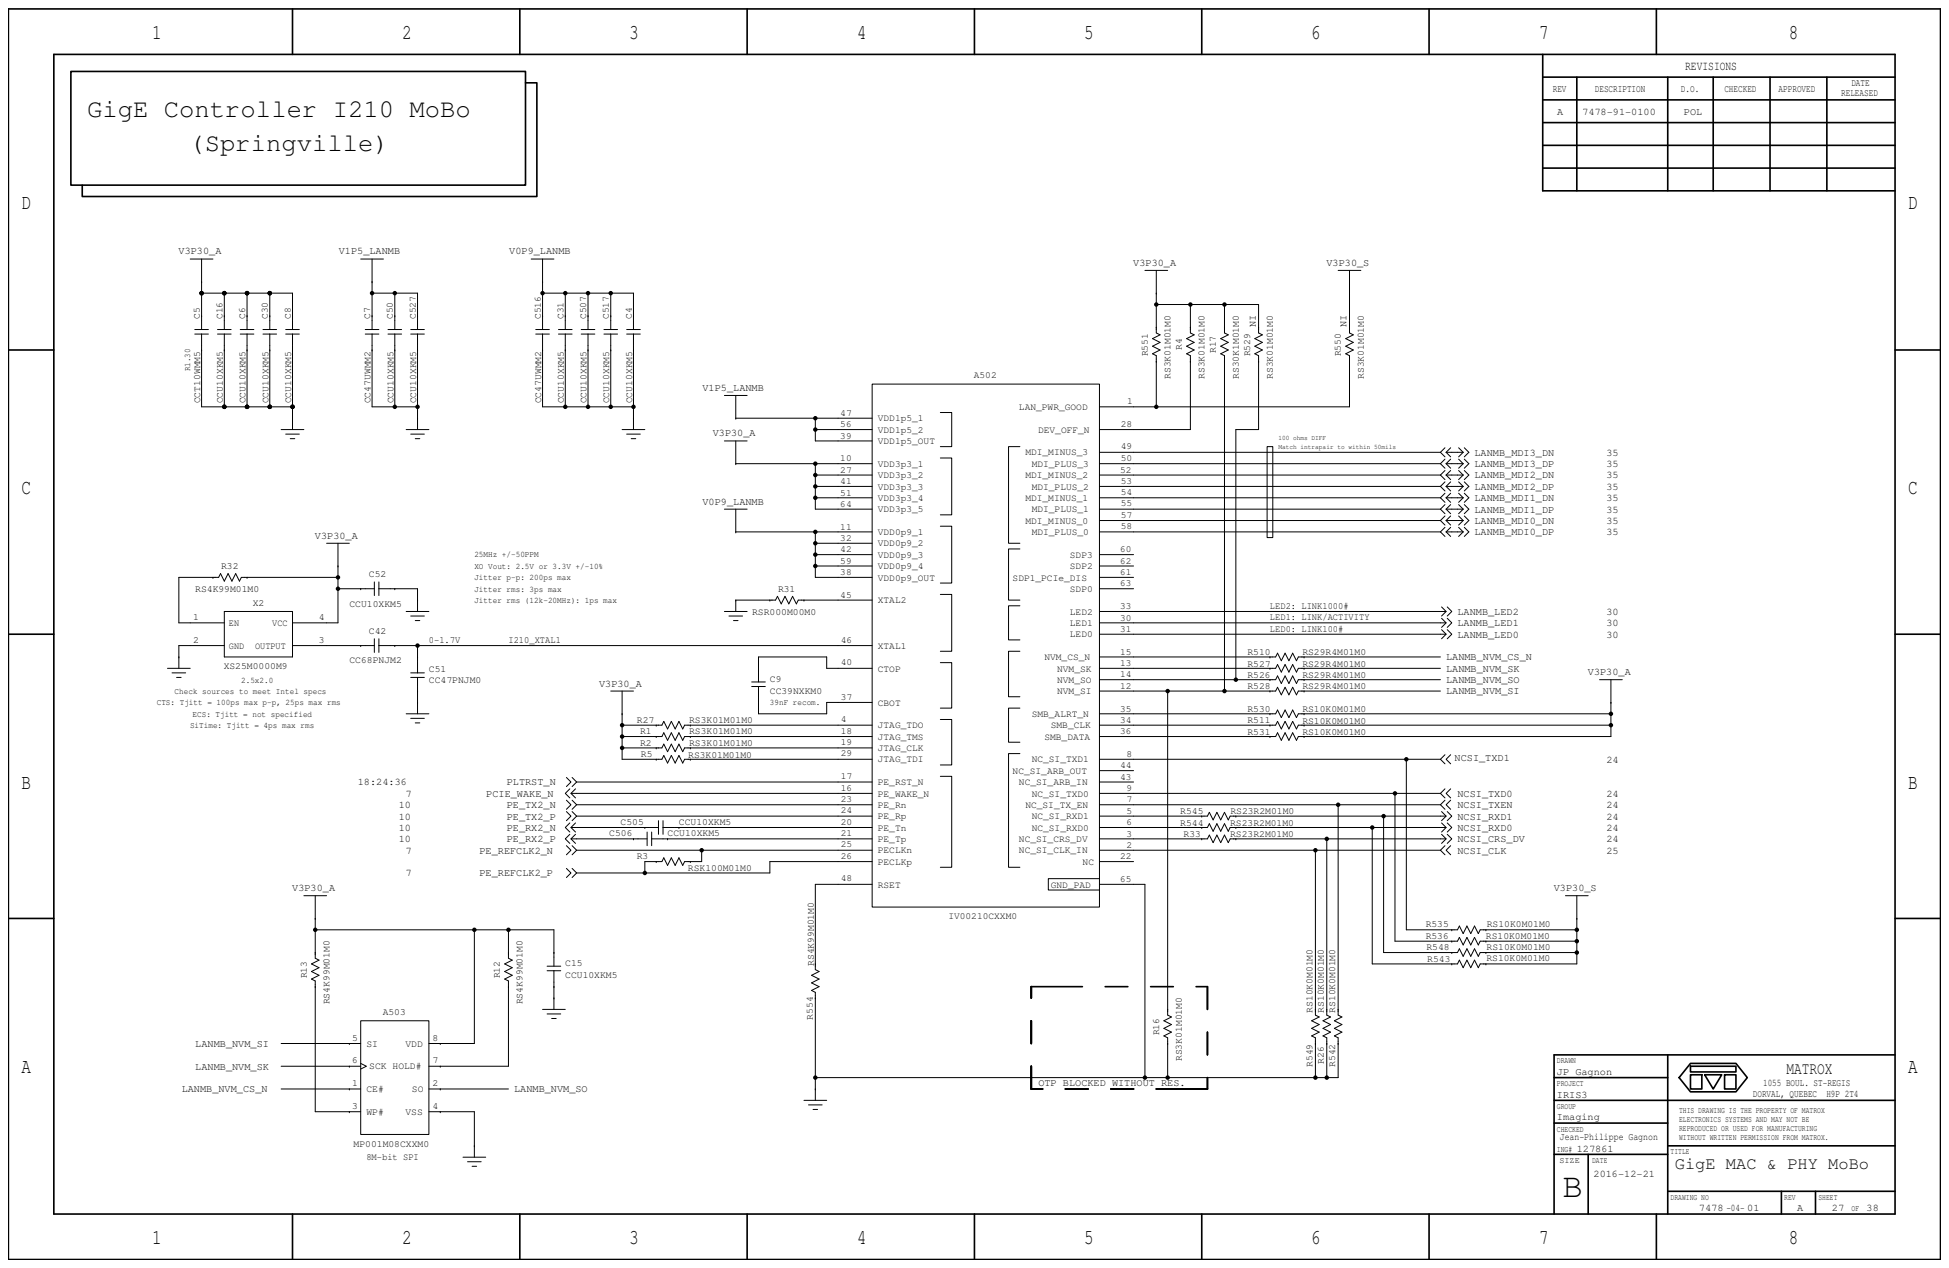
[picture p92: page 27]

100 ohms DIFF
Match intrapair to within 50mils

Check sources to meet Intel specs
CTS: Tjitt = 100ps max p-p, 25ps max rms

ECS: Tjitt = not specified
SiTime: Tjitt = 4ps max rms

OTP BLOCKED WITHOUT RES.

THIS DRAWING IS THE PROPERTY OF MATROX
ELECTRONICS SYSTEMS AND MAY NOT BE
REPRODUCED OR USED FOR MANUFACTURING
WITHOUT WRITTEN PERMISSION FROM MATROX.
GigE MAC & PHY MoBo

SIZE | DATE

D

D

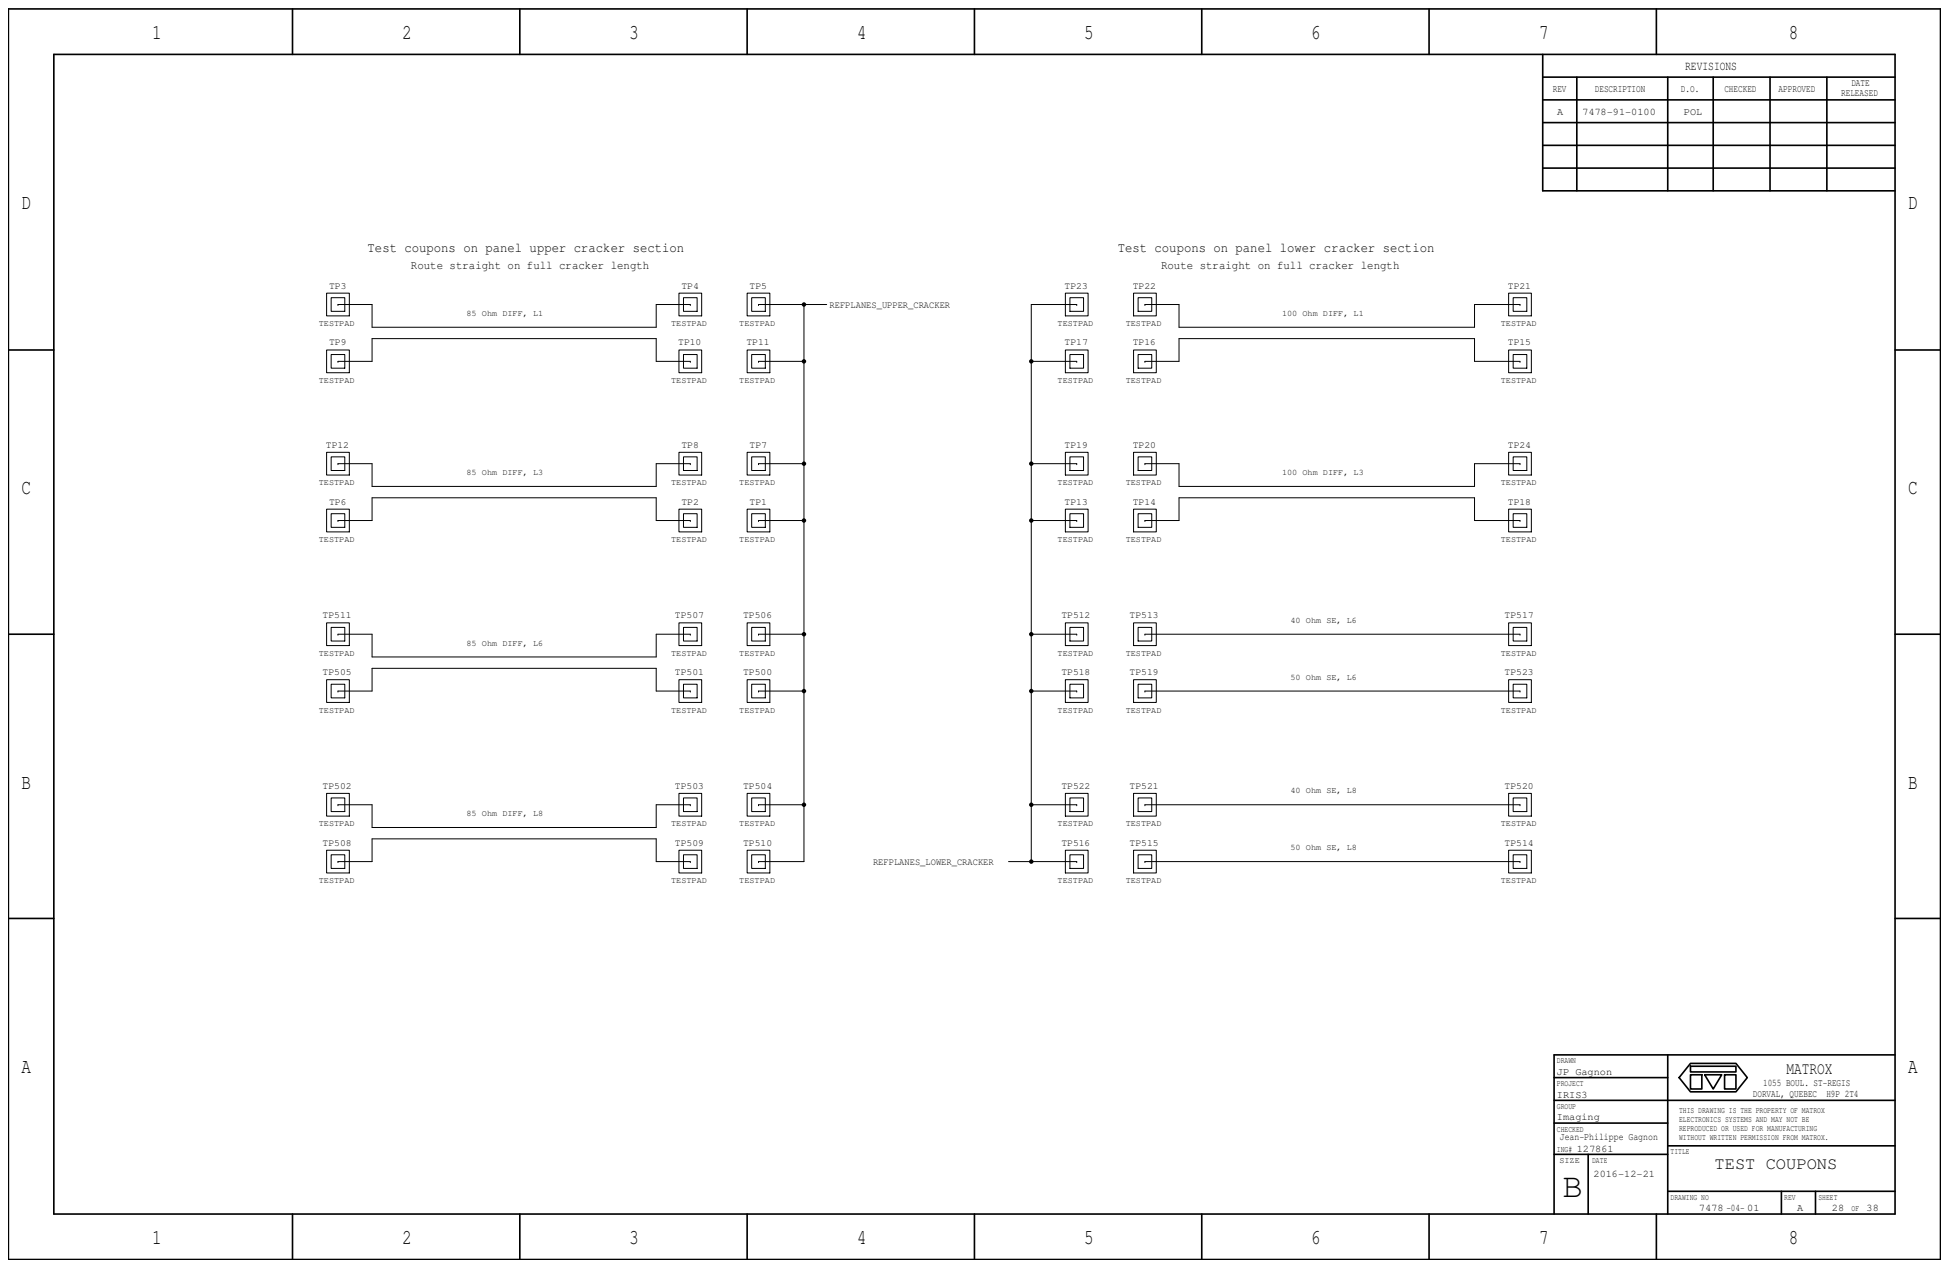
[picture p93: page 28]

Test coupons on panel upper cracker section

Test coupons on panel lower cracker section

Route straight on full cracker length

THIS DRAWING IS THE PROPERTY OF MATROX
ELECTRONICS SYSTEMS AND MAY NOT BE
REPRODUCED OR USED FOR MANUFACTURING
WITHOUT WRITTEN PERMISSION FROM MATROX.
TEST COUPONS

SIZE | DATE

D

1 | 2 | 3 | 4

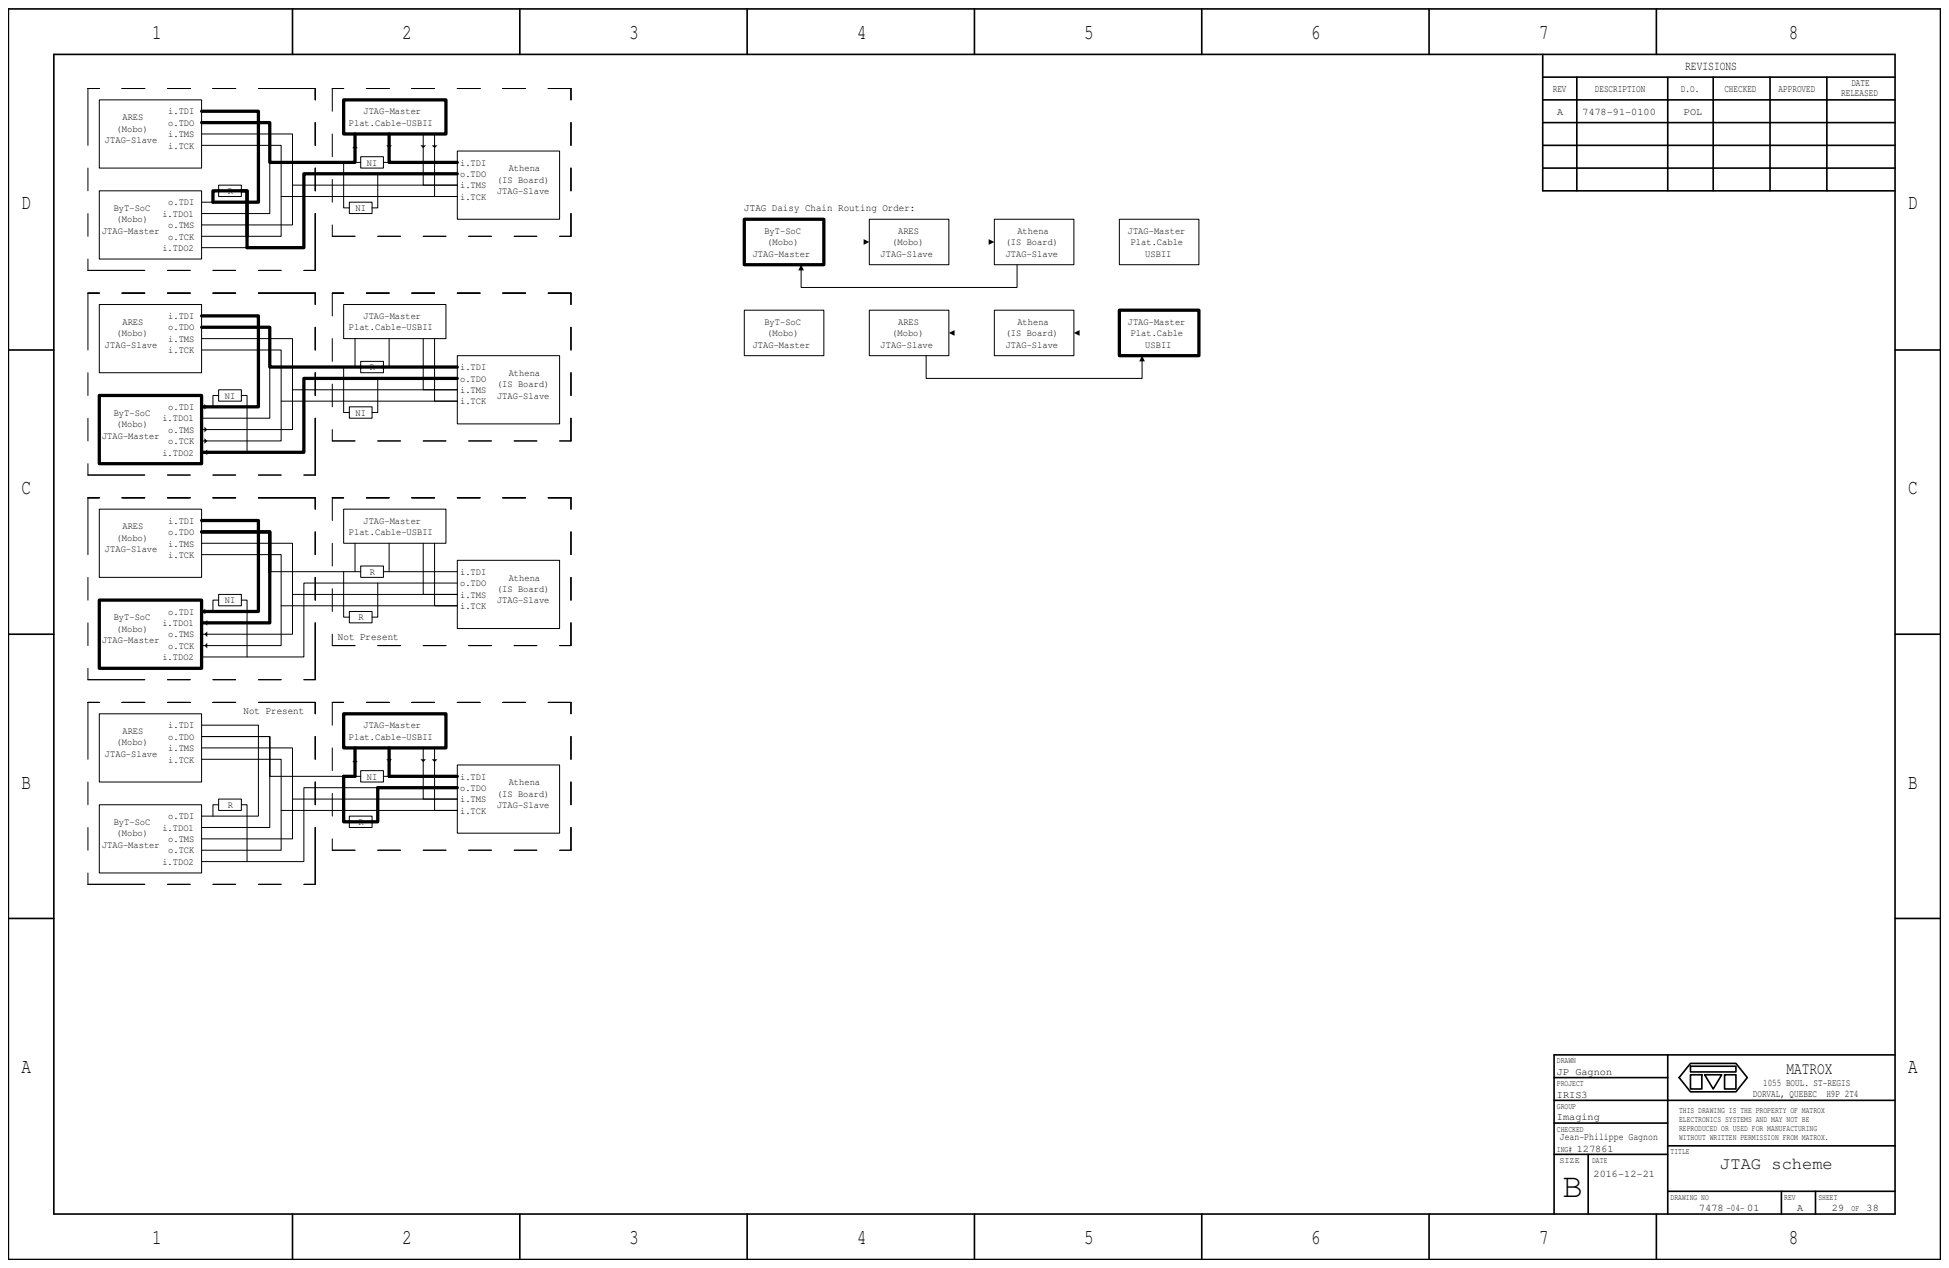
[picture p94: page 29]
JP Gagnon; IRIS3; Imaging; Jean-Philippe Gagnon; GROUP; DRAWN; CHECKED; PROJECT; ING#; TITLE; POL; MATROX; Athena; (Mobo) JTAG-Slave; (Mobo) JTAG-Master; i.TDO1 o.TMS o.TCK i.TDO2; ByT-SoC (Mobo) JTAG-Master; i.TDI o.TDO i.TMS i.TCK; ARES; o.TDI i.TDO1 o.TMS o.TCK i.TDO2; Not Present; (IS Board) JTAG-Slave; (IS Board); i.TDI; o.TDO; o.TDO i.TMS i.TCK; JTAG-Master Plat.Cable USBII

JTAG-Master
Plat.Cable-USBII

JTAG Daisy Chain Routing Order:

i.TMS
JTAG-Slave i.TCK

o.TDI ByT-SoC

1055 BOUL. ST-REGIS
DORVAL, QUEBEC H9P 2T4

THIS DRAWING IS THE PROPERTY OF MATROX
ELECTRONICS SYSTEMS AND MAY NOT BE
REPRODUCED OR USED FOR MANUFACTURING
WITHOUT WRITTEN PERMISSION FROM MATROX.
JTAG scheme

SIZE | DATE

D

1 | 2 | 3 | 4

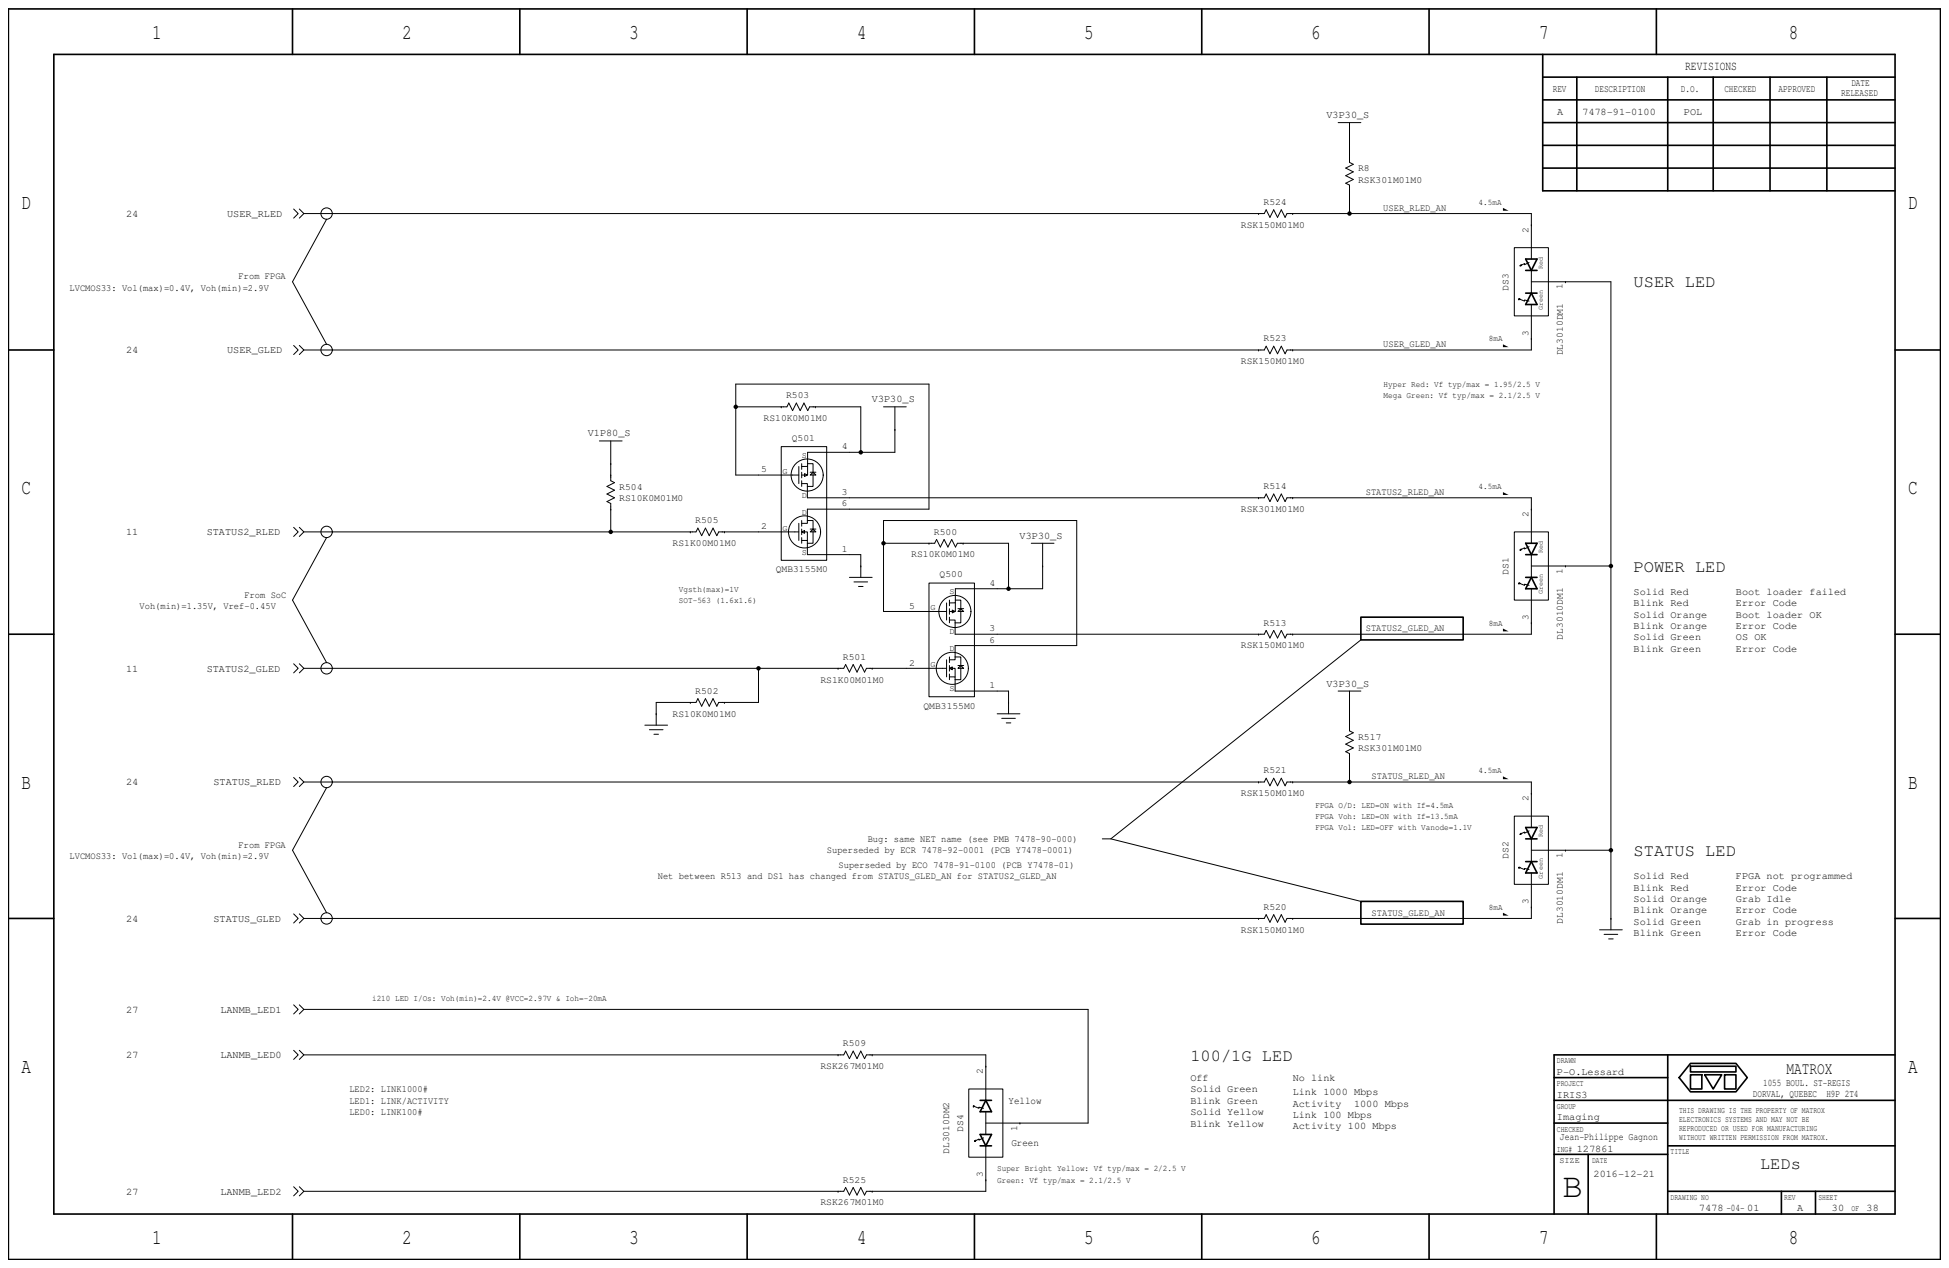
[picture p95: page 30]

LVCMOS33: Vol(max)=0.4V, Voh(min)=2.9V

Hyper Red: Vf typ/max = 1.95/2.5 V
Mega Green: Vf typ/max = 2.1/2.5 V

FPGA O/D: LED=ON with If=4.5mA
FPGA Voh: LED=ON with If=13.5mA
FPGA Vol: LED=OFF with Vanode=1.1V

Bug: same NET name (see PMB 7478-90-000)

Superseded by ECR 7478-92-0001 (PCB Y7478-0001)
Superseded by ECO 7478-91-0100 (PCB Y7478-01)

Net between R513 and DS1 has changed from STATUS_GLED_AN for STATUS2_GLED_AN

i210 LED I/Os: Voh(min)=2.4V @VCC=2.97V & Ioh=-20mA

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

SIZE | DATE

Super Bright Yellow: Vf typ/max = 2/2.5 V
Green: Vf typ/max = 2.1/2.5 V

D

D

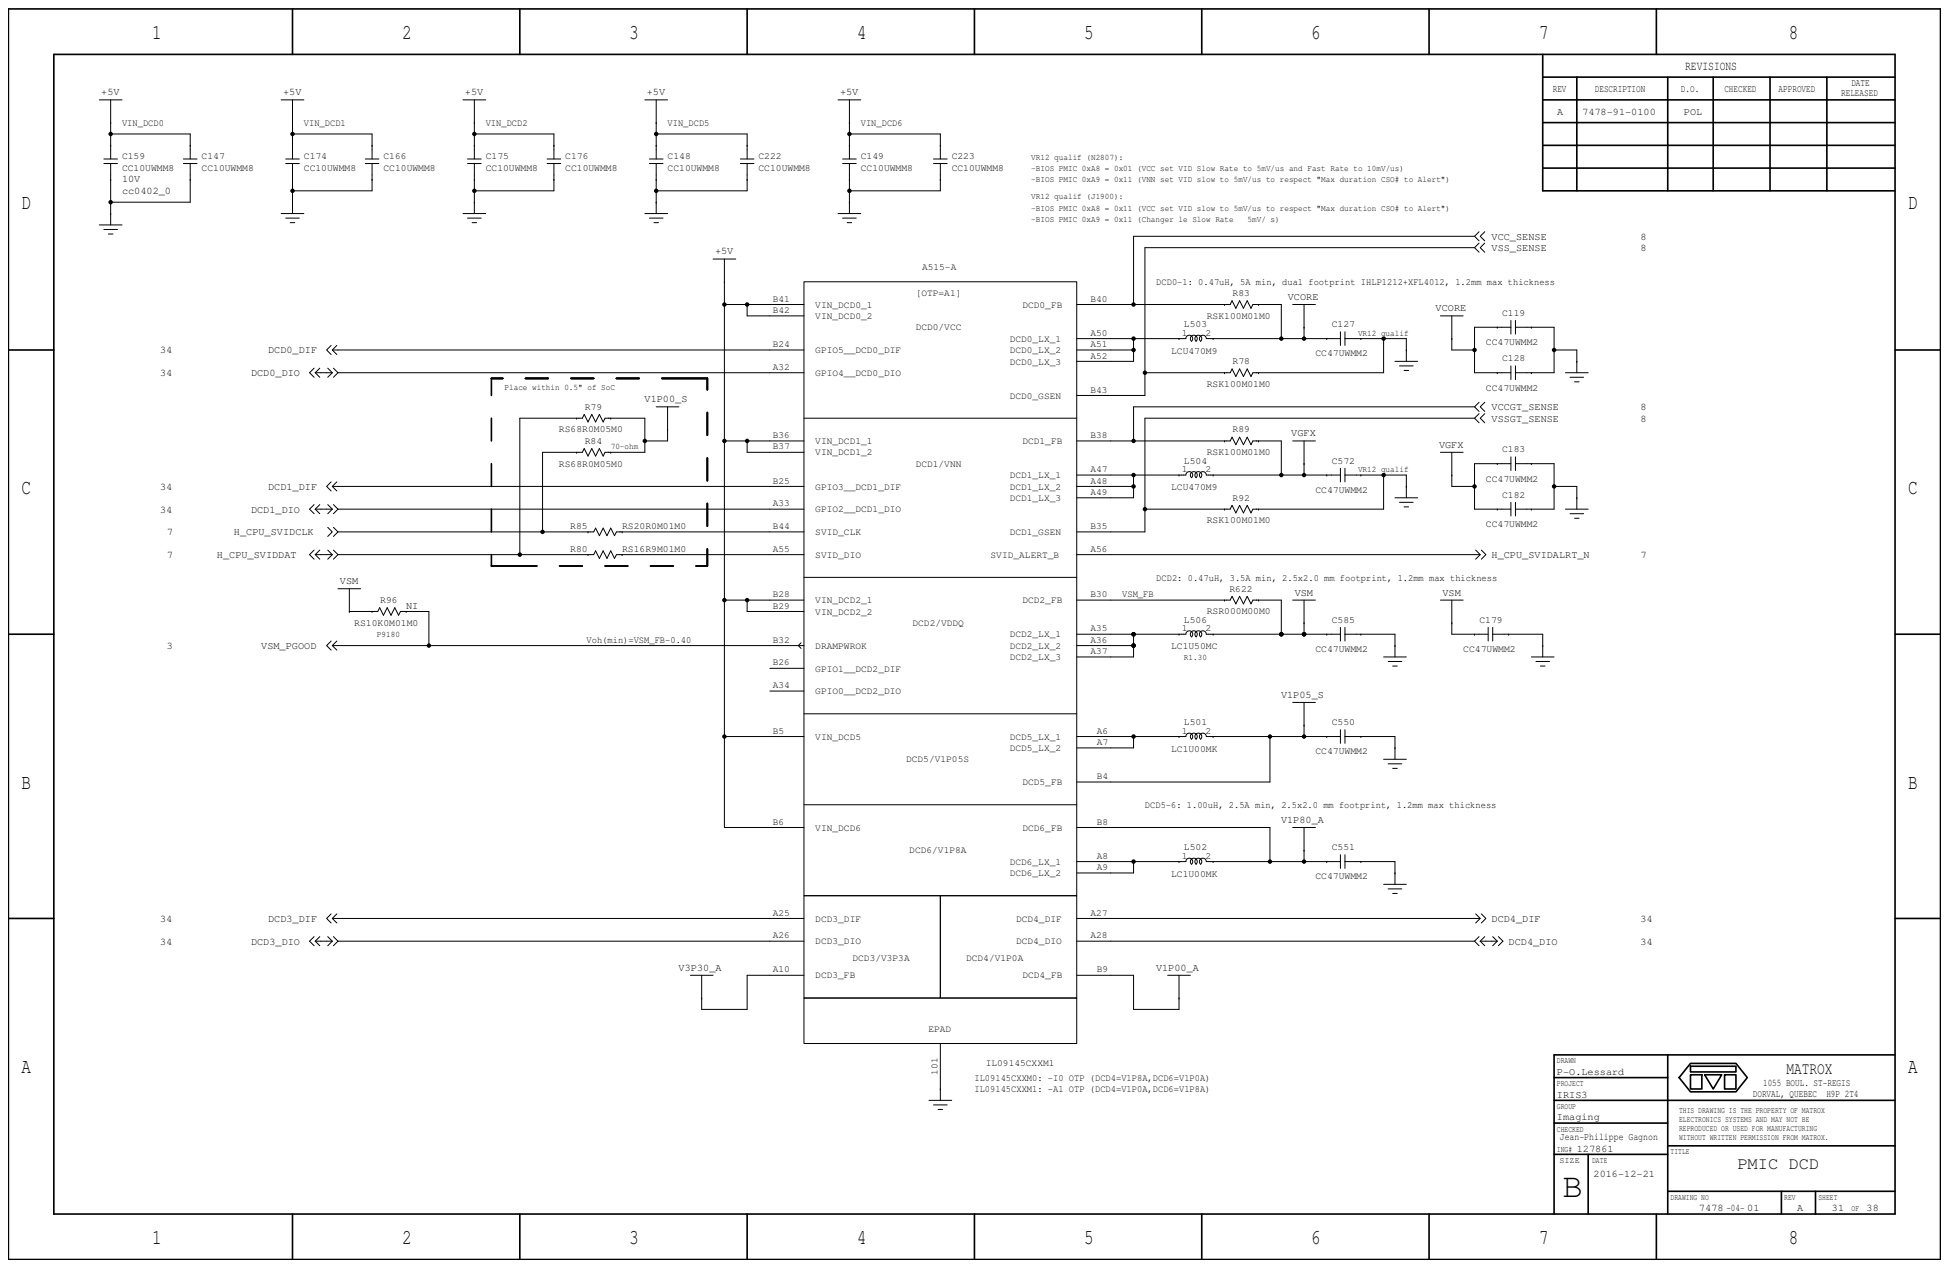
[picture p96: page 31]

A | 7478-91-0100 | POL

VR12 qualif (N2807):
-BIOS PMIC 0xA8 = 0x01 (VCC set VID Slow Rate to 5mV/us and Fast Rate to 10mV/us)
-BIOS PMIC 0xA9 = 0x11 (VNN set VID slow to 5mV/us to respect "Max duration CSO# to Alert")

VR12 qualif (J1900):
-BIOS PMIC 0xA8 = 0x11 (VCC set VID slow to 5mV/us to respect "Max duration CSO# to Alert")
-BIOS PMIC 0xA9 = 0x11 (Changer le Slow Rate à 5mV/µs)

DCD0-1: 0.47uH, 5A min, dual footprint IHLP1212+XFL4012, 1.2mm max thickness

Place within 0.5" of SoC

DCD2: 0.47uH, 3.5A min, 2.5x2.0 mm footprint, 1.2mm max thickness

DCD5-6: 1.00uH, 2.5A min, 2.5x2.0 mm footprint, 1.2mm max thickness

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

SIZE | DATE

D

D

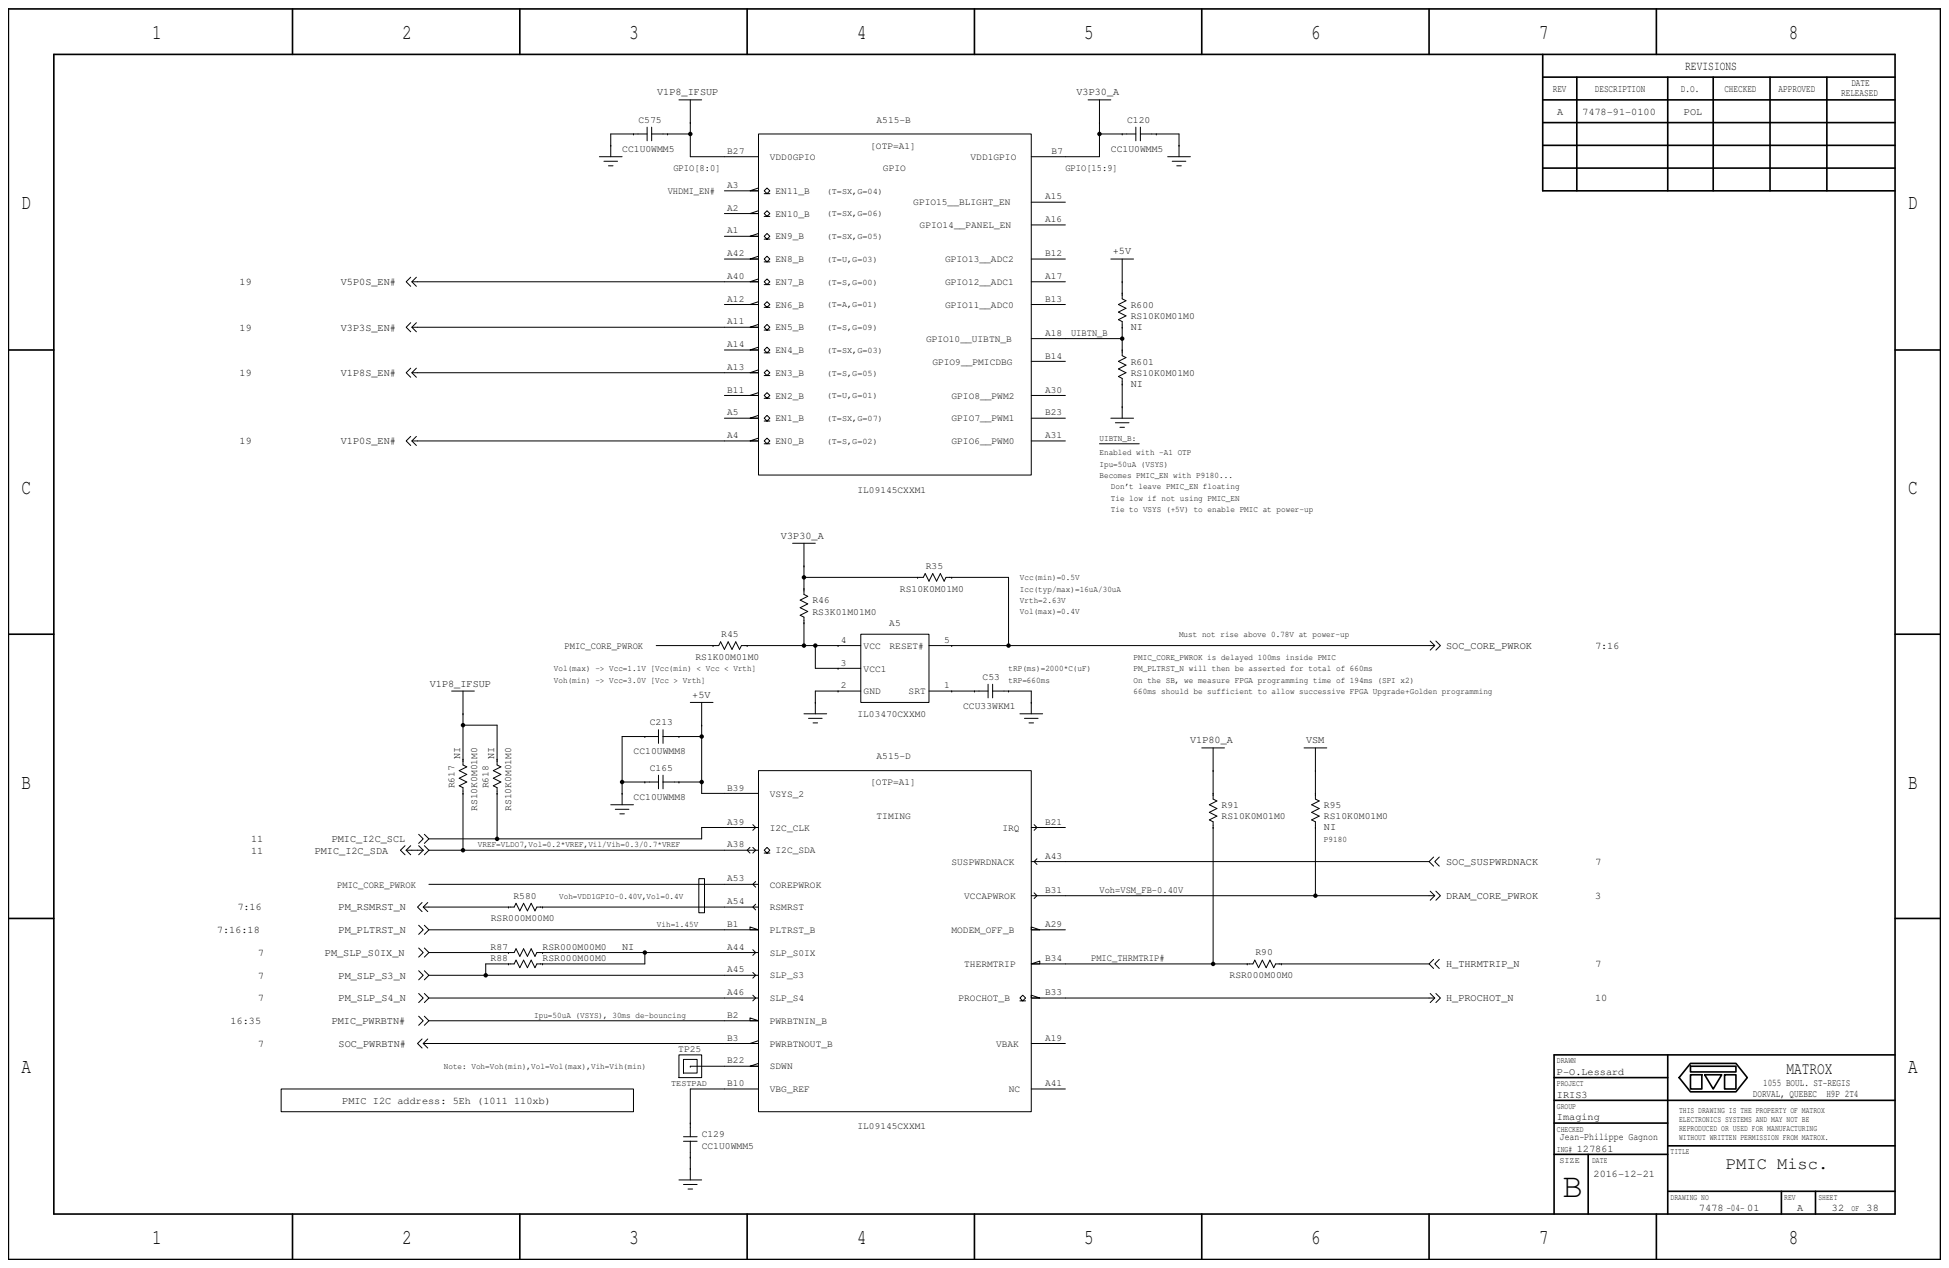
[picture p97: page 32]

Enabled with -A1 OTP
Ipu=50uA (VSYS)
Becomes PMIC_EN with P9180...
Don’t leave PMIC_EN floating
Tie low if not using PMIC_EN
Tie to VSYS (+5V) to enable PMIC at power-up

Must not rise above 0.78V at power-up

PMIC_CORE_PWROK is delayed 100ms inside PMIC
PM_PLTRST_N will then be asserted for total of 660ms
On the SB, we measure FPGA programming time of 194ms (SPI x2)
660ms should be sufficient to allow successive FPGA Upgrade+Golden programming

Vol(max) -> Vcc=1.1V [Vcc(min) < Vcc < Vrth]
Voh(min) -> Vcc=3.0V [Vcc > Vrth]

VREF=VLDO7,Vol=0.2*VREF,Vil/Vih=0.3/0.7*VREF

Ipu=50uA (VSYS), 30ms de-bouncing

Note: Voh=Voh(min),Vol=Vol(max),Vih=Vih(min)

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

SIZE | DATE

D

1 | 2 | 3 | 4

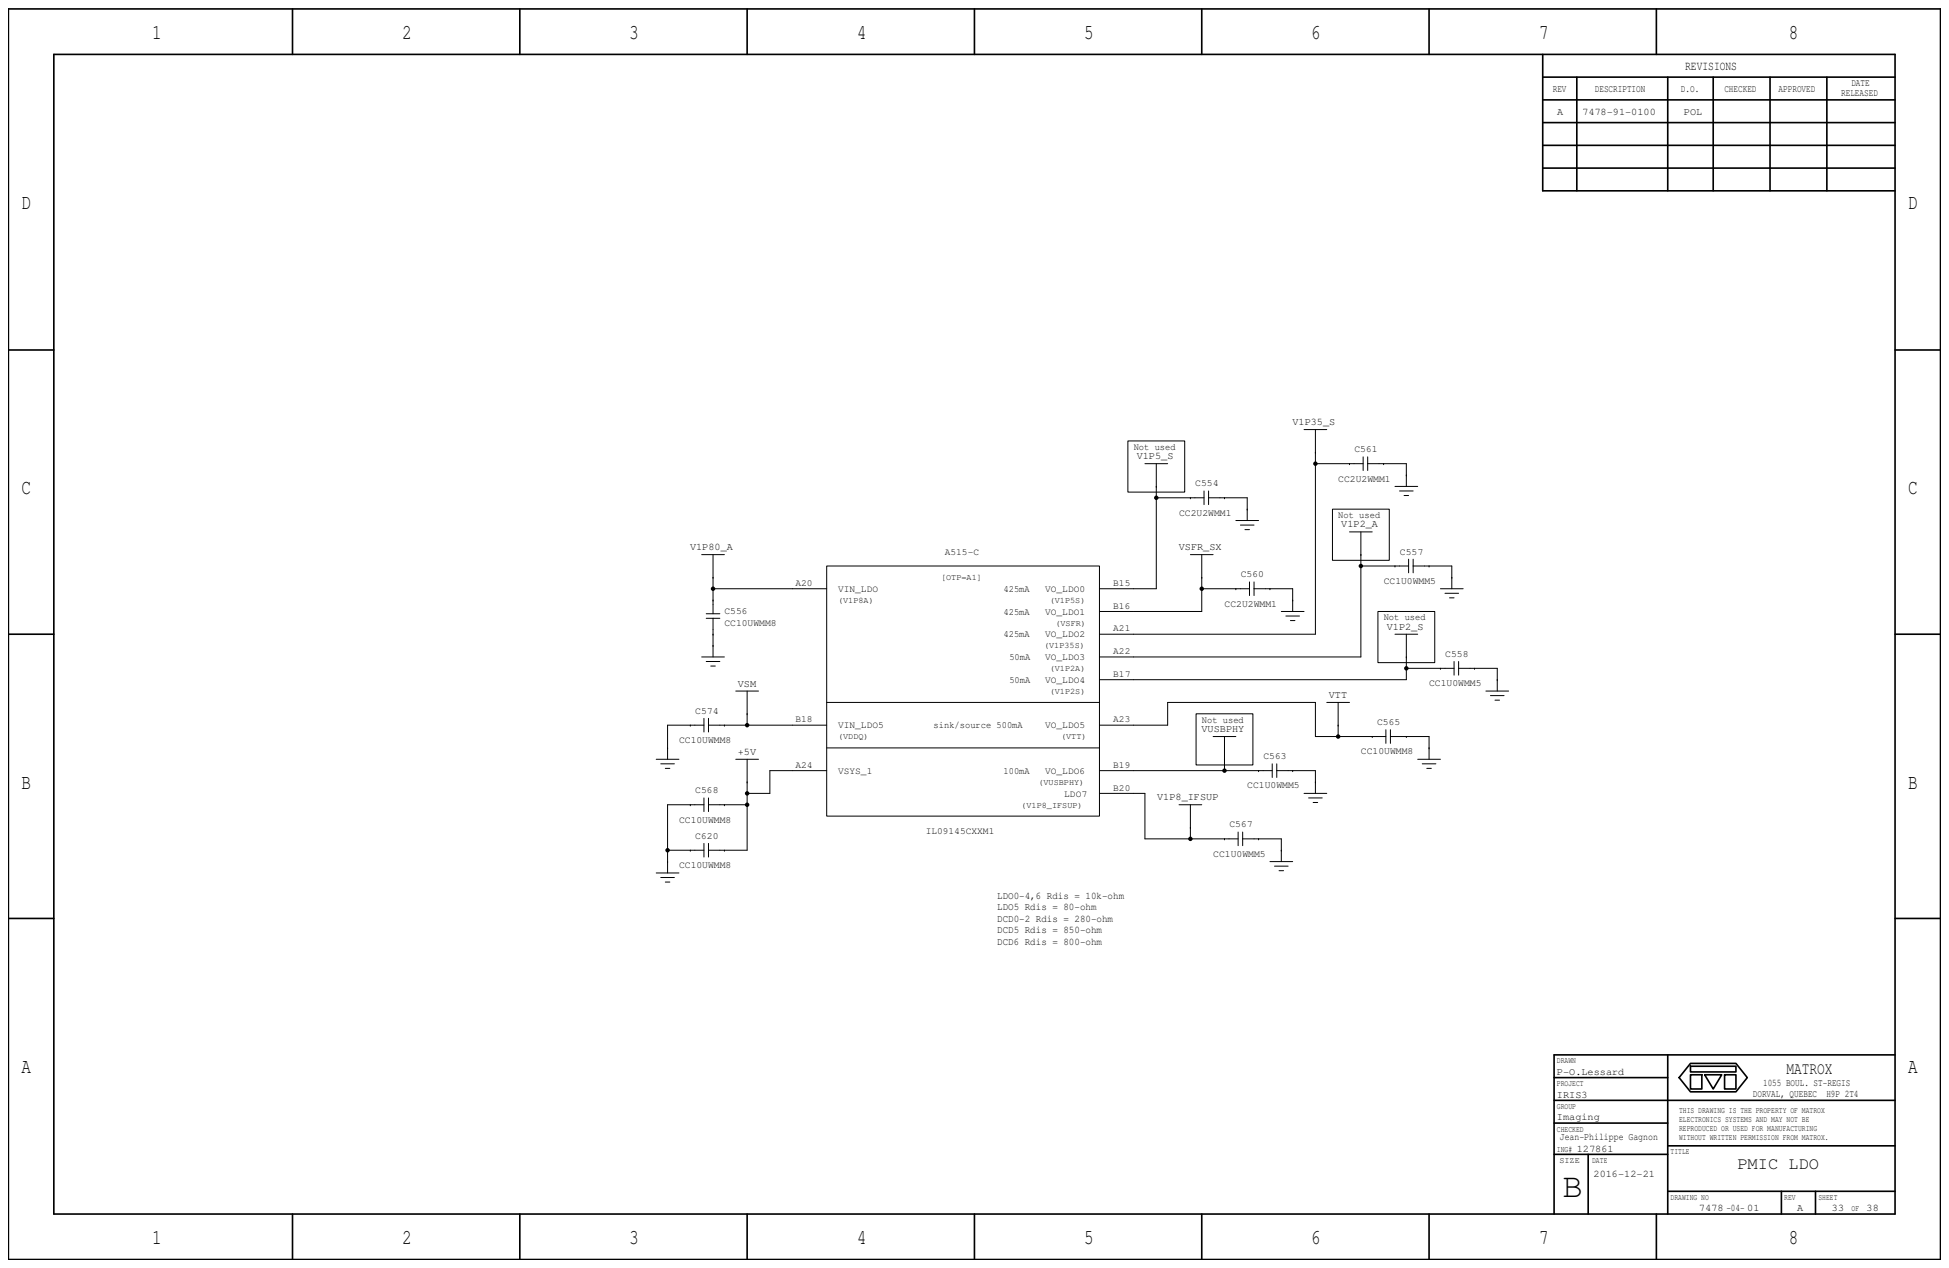
[picture p98: page 33]
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

SIZE | DATE

D

D

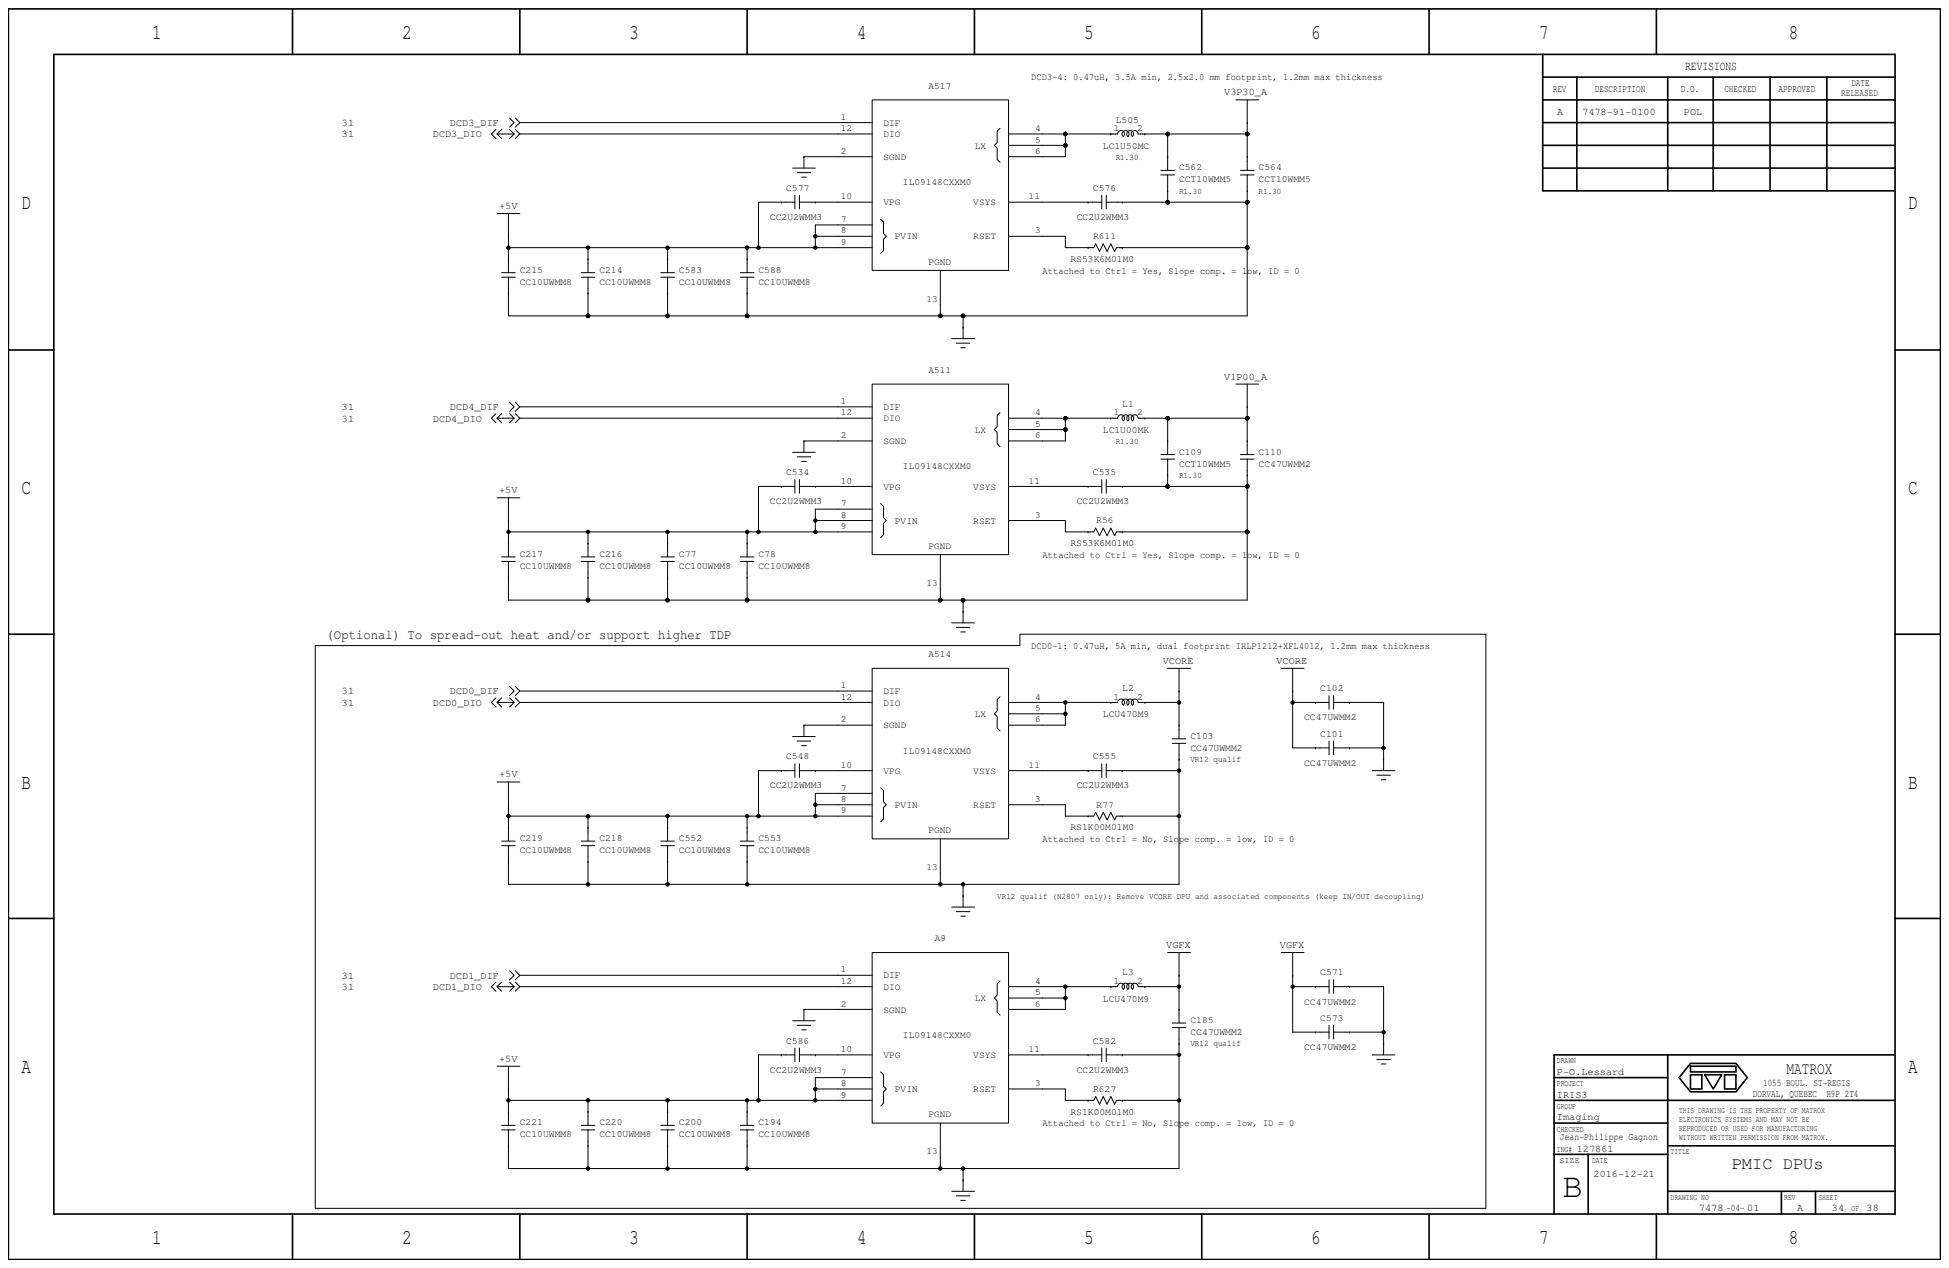
[picture p99: page 34]

DCD3-4: 0.47uH, 3.5A min, 2.5x2.0 mm footprint, 1.2mm max thickness

Attached to Ctrl = Yes, Slope comp. = low, ID = 0

(Optional) To spread-out heat and/or support higher TDP

DCD0-1: 0.47uH, 5A min, dual footprint IHLP1212+XFL4012, 1.2mm max thickness

Attached to Ctrl = No, Slope comp. = low, ID = 0

VR12 qualif (N2807 only): Remove VCORE DPU and associated components (keep IN/OUT decoupling)

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

SIZE | DATE

D

D

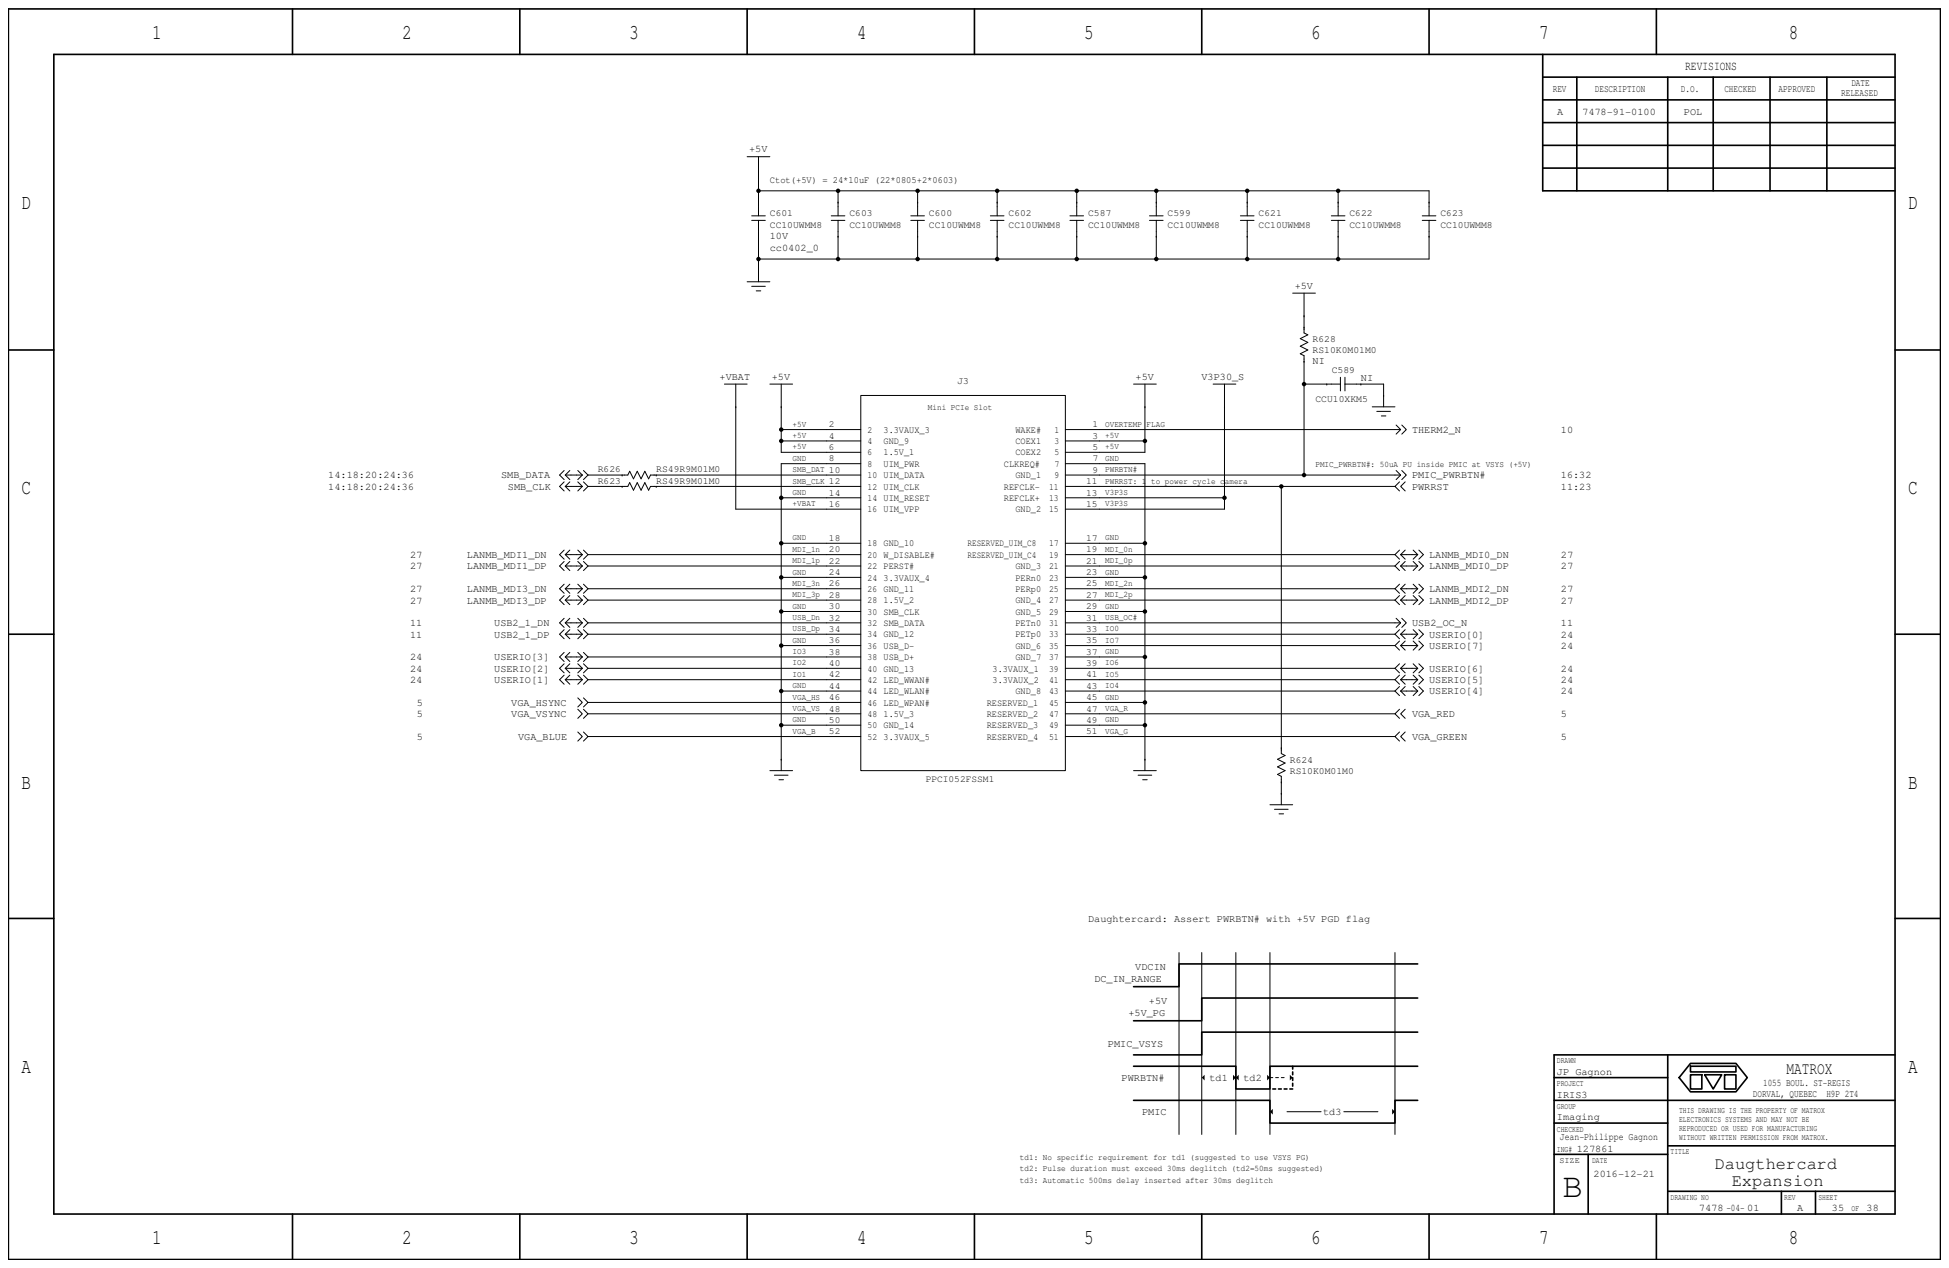
[picture p100: page 35]

PMIC_PWRBTN#: 50uA PU inside PMIC at VSYS (+5V)

Daughtercard: Assert PWRBTN# with +5V PGD flag

THIS DRAWING IS THE PROPERTY OF MATROX
ELECTRONICS SYSTEMS AND MAY NOT BE
REPRODUCED OR USED FOR MANUFACTURING
WITHOUT WRITTEN PERMISSION FROM MATROX.
Daugthercard
Expansion

td1: No specific requirement for td1 (suggested to use VSYS PG)
td2: Pulse duration must exceed 30ms deglitch (td2=50ms suggested)
td3: Automatic 500ms delay inserted after 30ms deglitch

SIZE | DATE

D

1 | 2 | 3 | 4

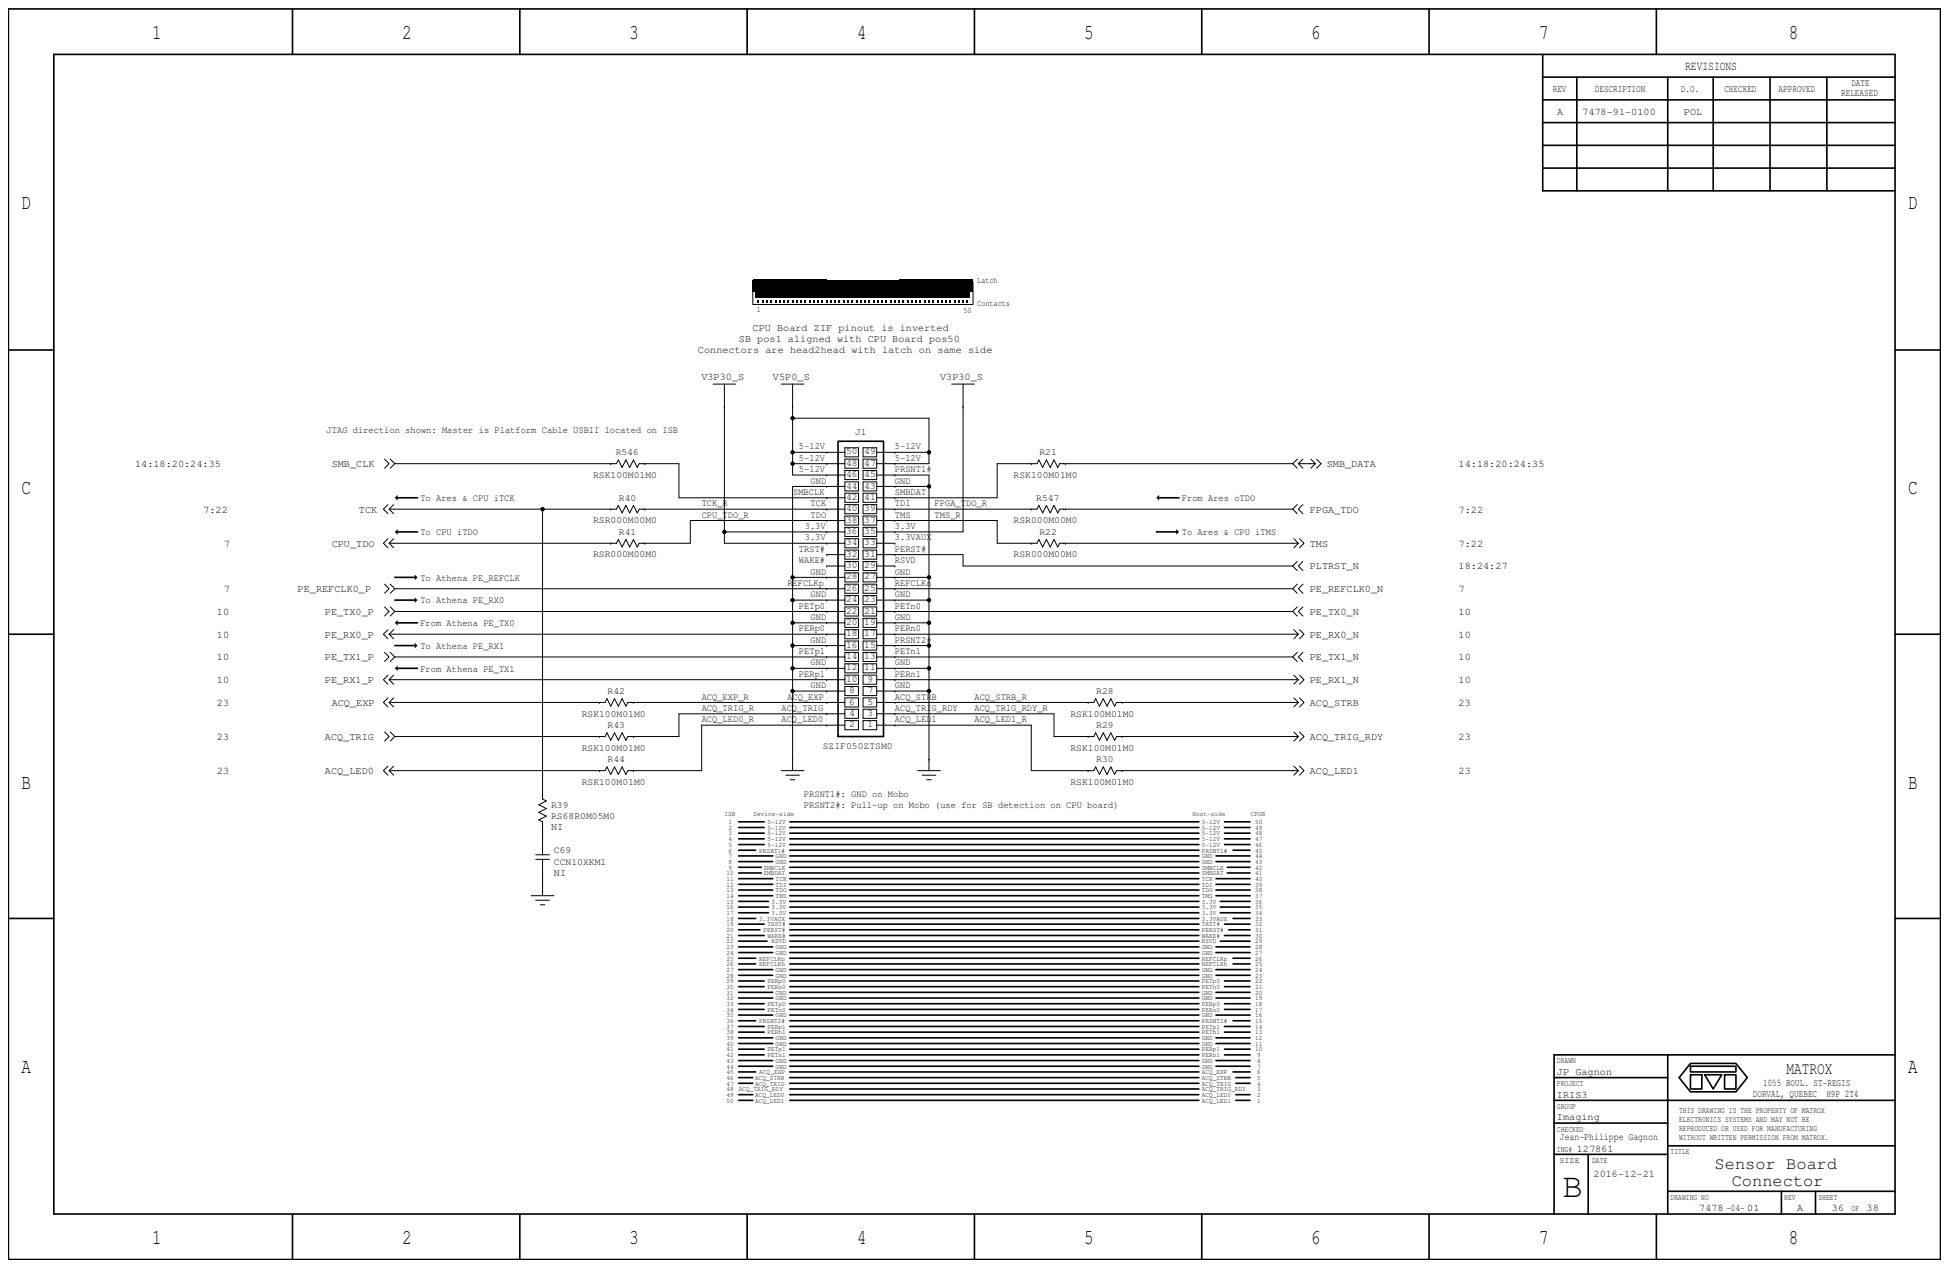
[picture p101: page 36]

CPU Board ZIF pinout is inverted
SB pos1 aligned with CPU Board pos50

Connectors are head2head with latch on same side

JTAG direction shown: Master is Platform Cable USBII located on ISB

To Ares & CPU iTCK

To Ares & CPU iTMS

PRSNT1#: GND on Mobo
PRSNT2#: Pull-up on Mobo (use for SB detection on CPU board)

THIS DRAWING IS THE PROPERTY OF MATROX
ELECTRONICS SYSTEMS AND MAY NOT BE
REPRODUCED OR USED FOR MANUFACTURING
WITHOUT WRITTEN PERMISSION FROM MATROX.
Sensor Board
Connector

SIZE | DATE

D

1 | 2 | 3 | 4

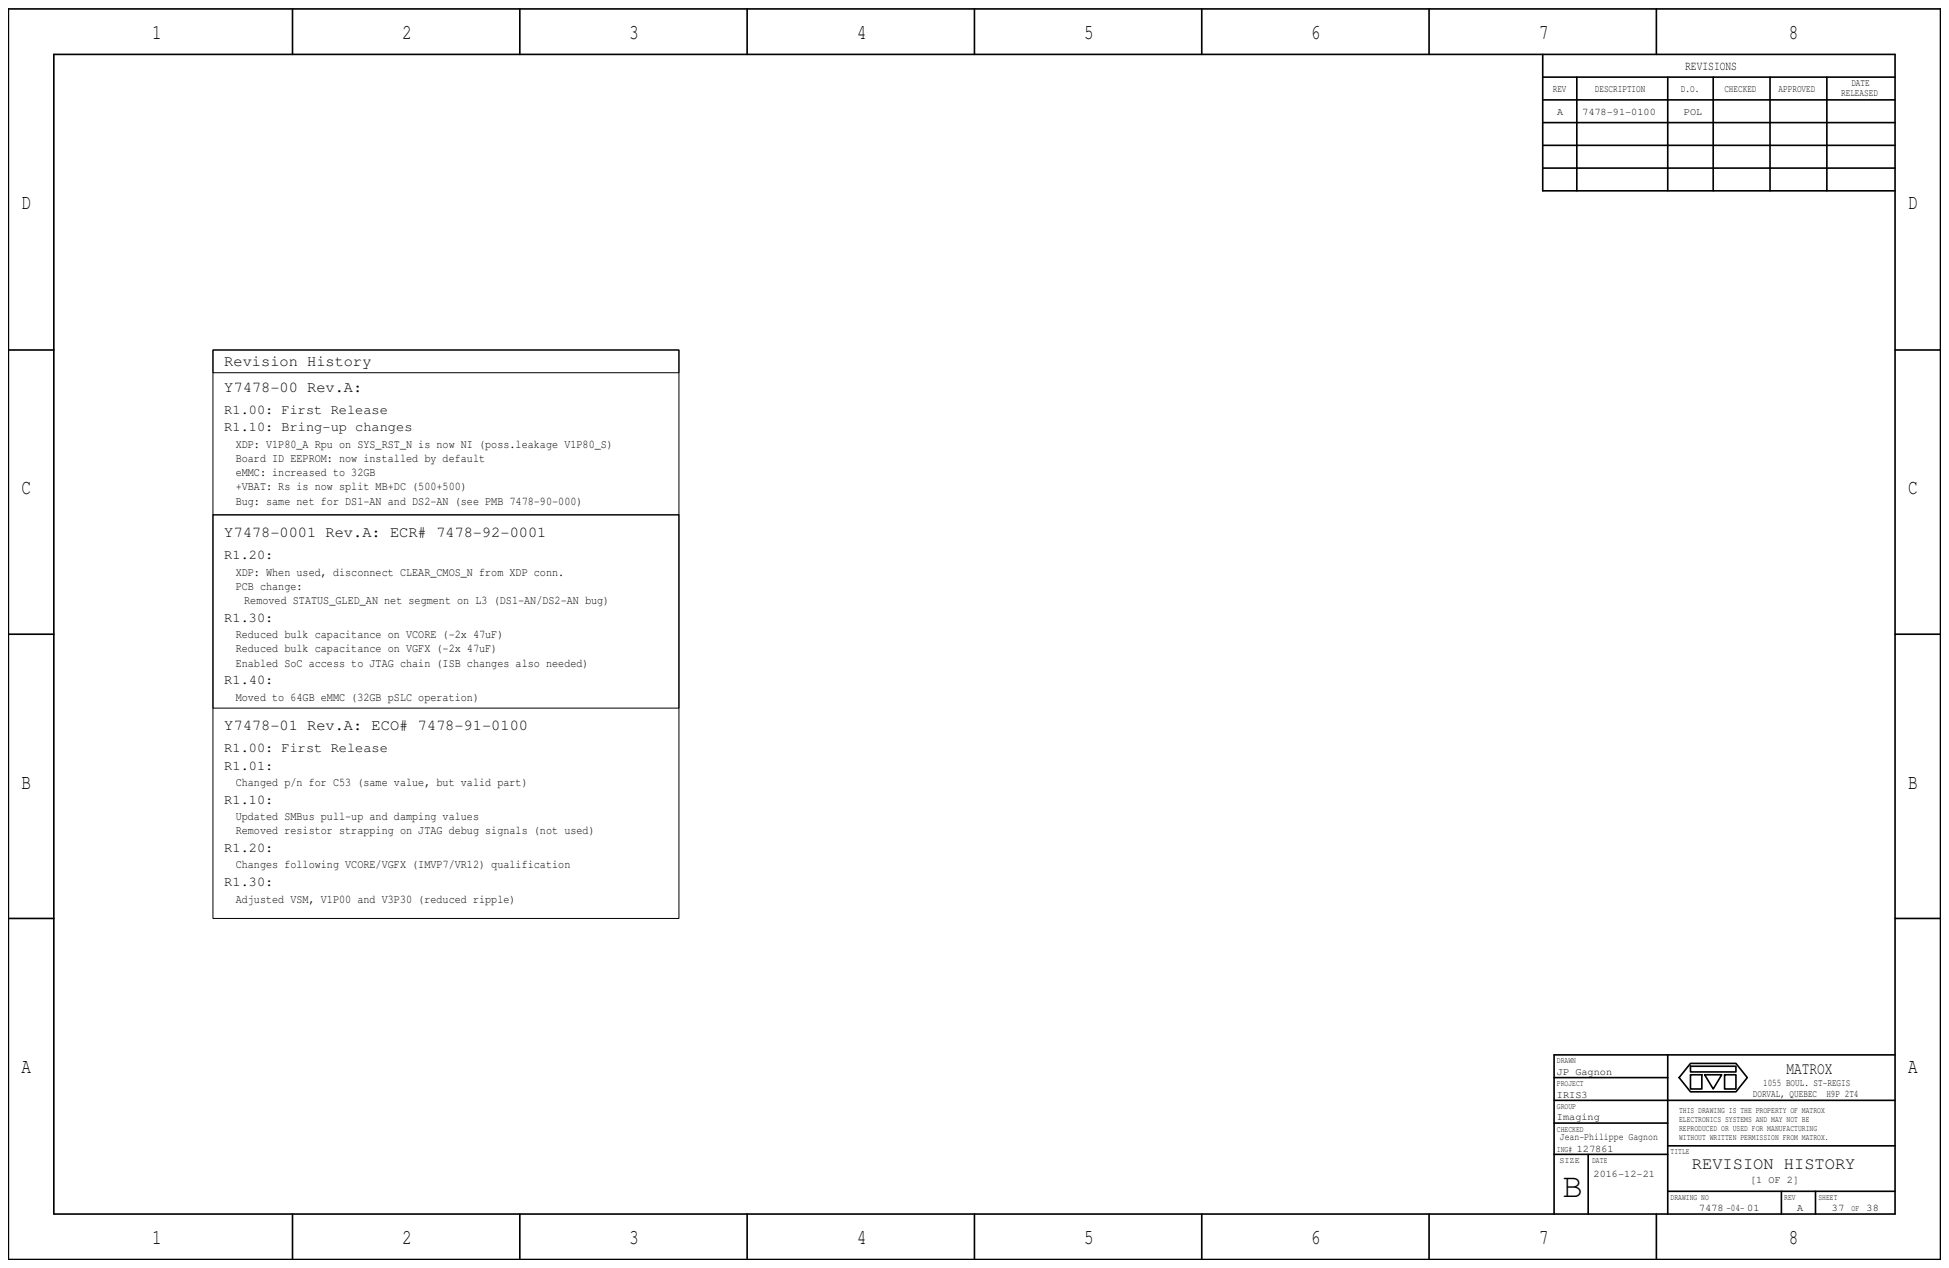
[picture p102: page 37]
JP Gagnon; IRIS3; Jean-Philippe Gagnon; Imaging; GROUP; DRAWN; CHECKED; PROJECT; ING#; TITLE; POL; MATROX; Y7478-0001 Rev.A: ECR# 7478-92-0001; Y7478-01 Rev.A: ECO# 7478-91-0100; Y7478-00 Rev.A:; Revision History

R1.00: First Release
R1.10: Bring-up changes
XDP: V1P80_A Rpu on SYS_RST_N is now NI (poss.leakage V1P80_S)
Board ID EEPROM: now installed by default
eMMC: increased to 32GB
+VBAT: Rs is now split MB+DC (500+500)
Bug: same net for DS1-AN and DS2-AN (see PMB 7478-90-000)

XDP: When used, disconnect CLEAR_CMOS_N from XDP conn.
PCB change:
Removed STATUS_GLED_AN net segment on L3 (DS1-AN/DS2-AN bug)
Reduced bulk capacitance on VCORE (-2x 47uF)
Reduced bulk capacitance on VGFX (-2x 47uF)
Enabled SoC access to JTAG chain (ISB changes also needed)
Moved to 64GB eMMC (32GB pSLC operation)

Changed p/n for C53 (same value, but valid part)
Updated SMBus pull-up and damping values
Removed resistor strapping on JTAG debug signals (not used)
Changes following VCORE/VGFX (IMVP7/VR12) qualification
Adjusted VSM, V1P00 and V3P30 (reduced ripple)

1055 BOUL. ST-REGIS
DORVAL, QUEBEC H9P 2T4

THIS DRAWING IS THE PROPERTY OF MATROX
ELECTRONICS SYSTEMS AND MAY NOT BE
REPRODUCED OR USED FOR MANUFACTURING
WITHOUT WRITTEN PERMISSION FROM MATROX.
REVISION HISTORY

SIZE | DATE

D

1 | 2 | 3 | 4

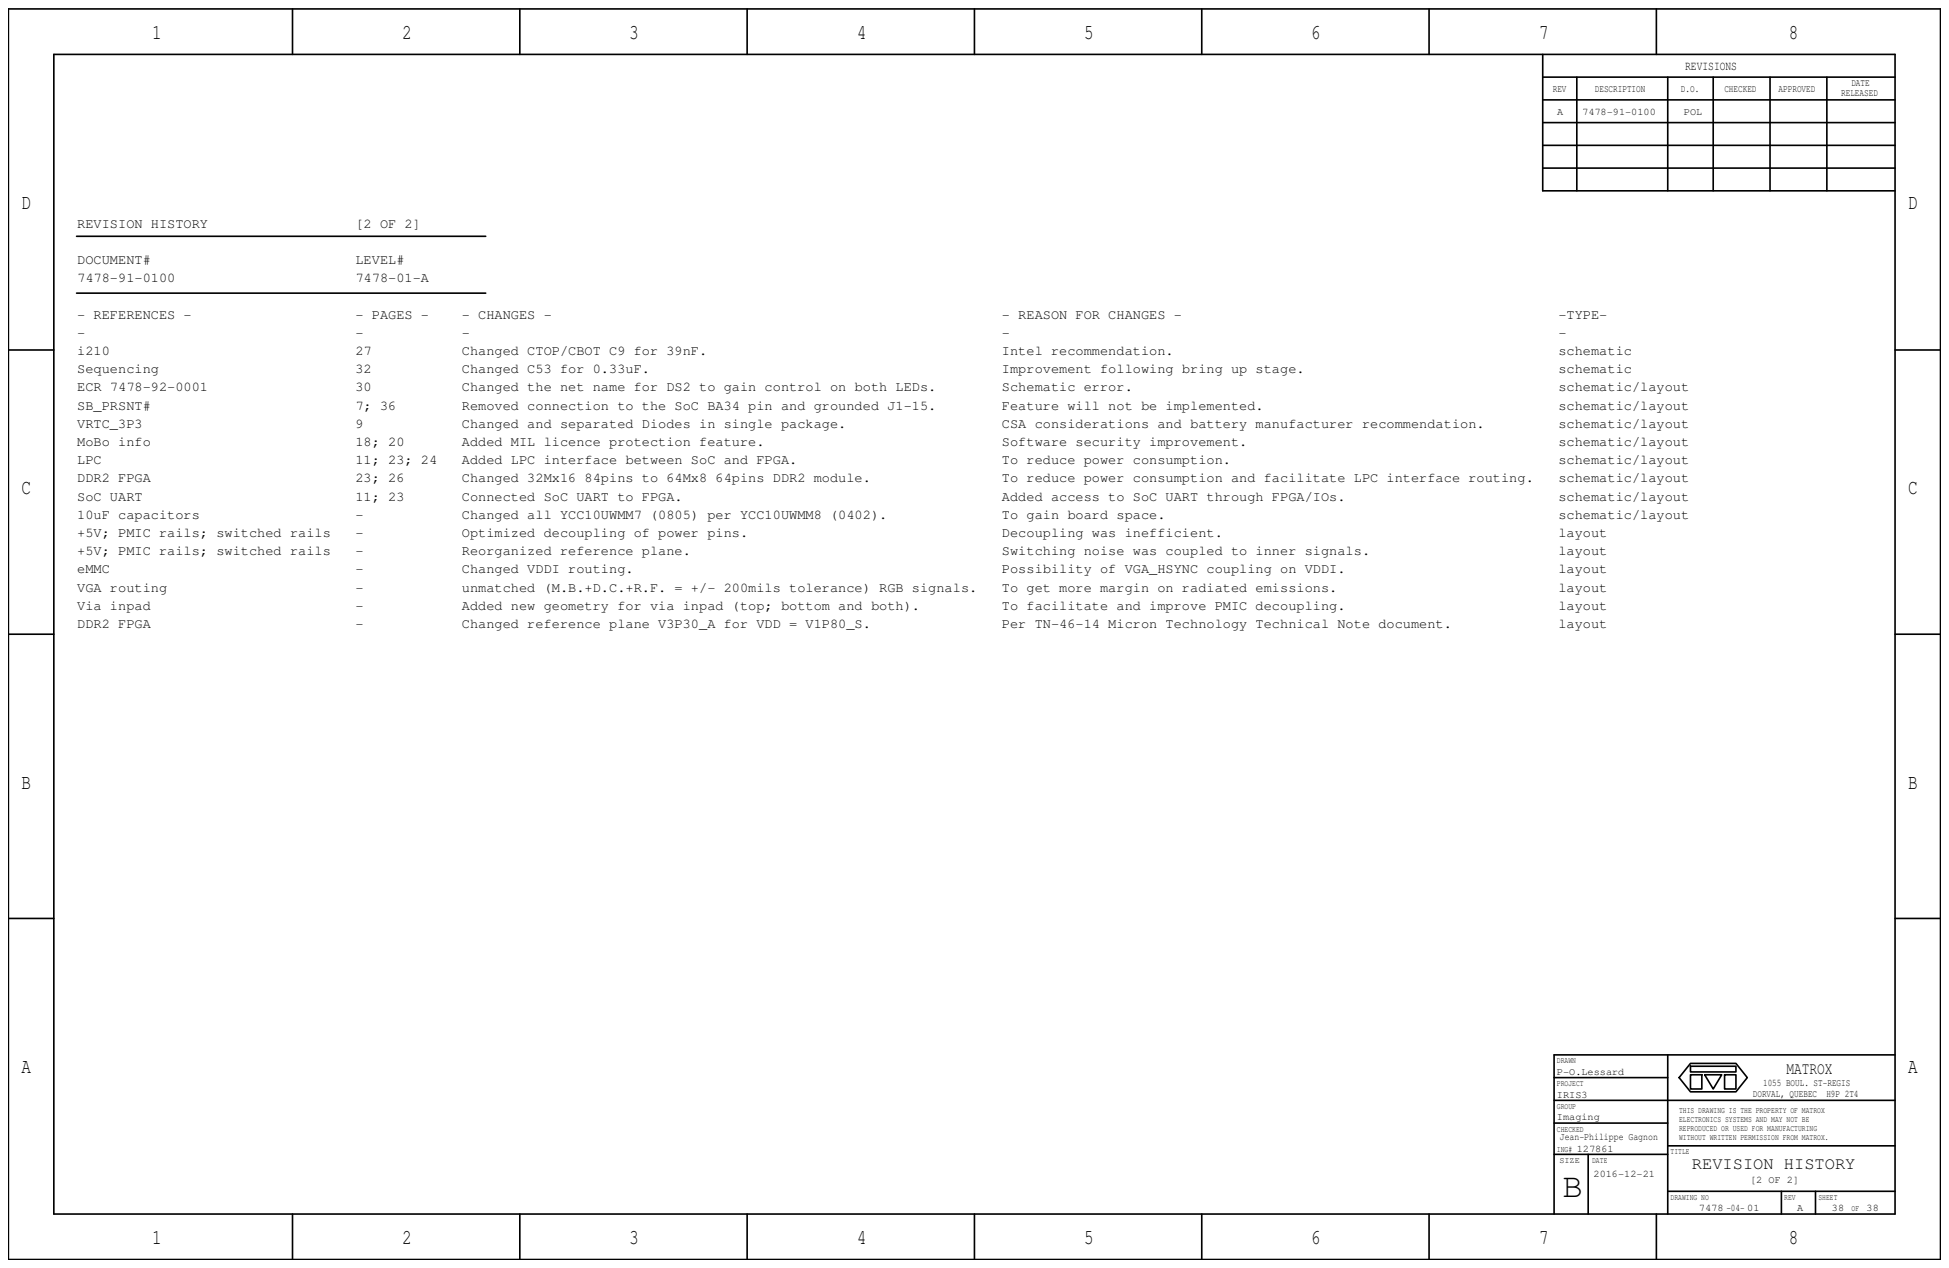
[picture p103: page 38]
P-O.Lessard; IRIS3; Jean-Philippe Gagnon; Imaging; GROUP; DRAWN; CHECKED; PROJECT; ING#; TITLE; POL; MATROX; REVISION HISTORY; DOCUMENT#; LEVEL#; - REFERENCES -; - PAGES -; - CHANGES -; - REASON FOR CHANGES -; -TYPE-; Changed CTOP/CBOT C9 for 39nF.; Intel recommendation.; schematic; Sequencing; Changed C53 for 0.33uF.; Improvement following bring up stage.; ECR 7478-92-0001; Changed the net name for DS2 to gain control on both LEDs.; Schematic error.; schematic/layout; SB_PRSNT#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

1055 BOUL. ST-REGIS
DORVAL, QUEBEC H9P 2T4

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

SIZE | DATE
