AM4511/test_migrate_iris4/athena/doc/iris3/7480_01 (Iris3 Sensor Board R2.20 - Signed).pdf

D

1 | 2 | 3 | 4

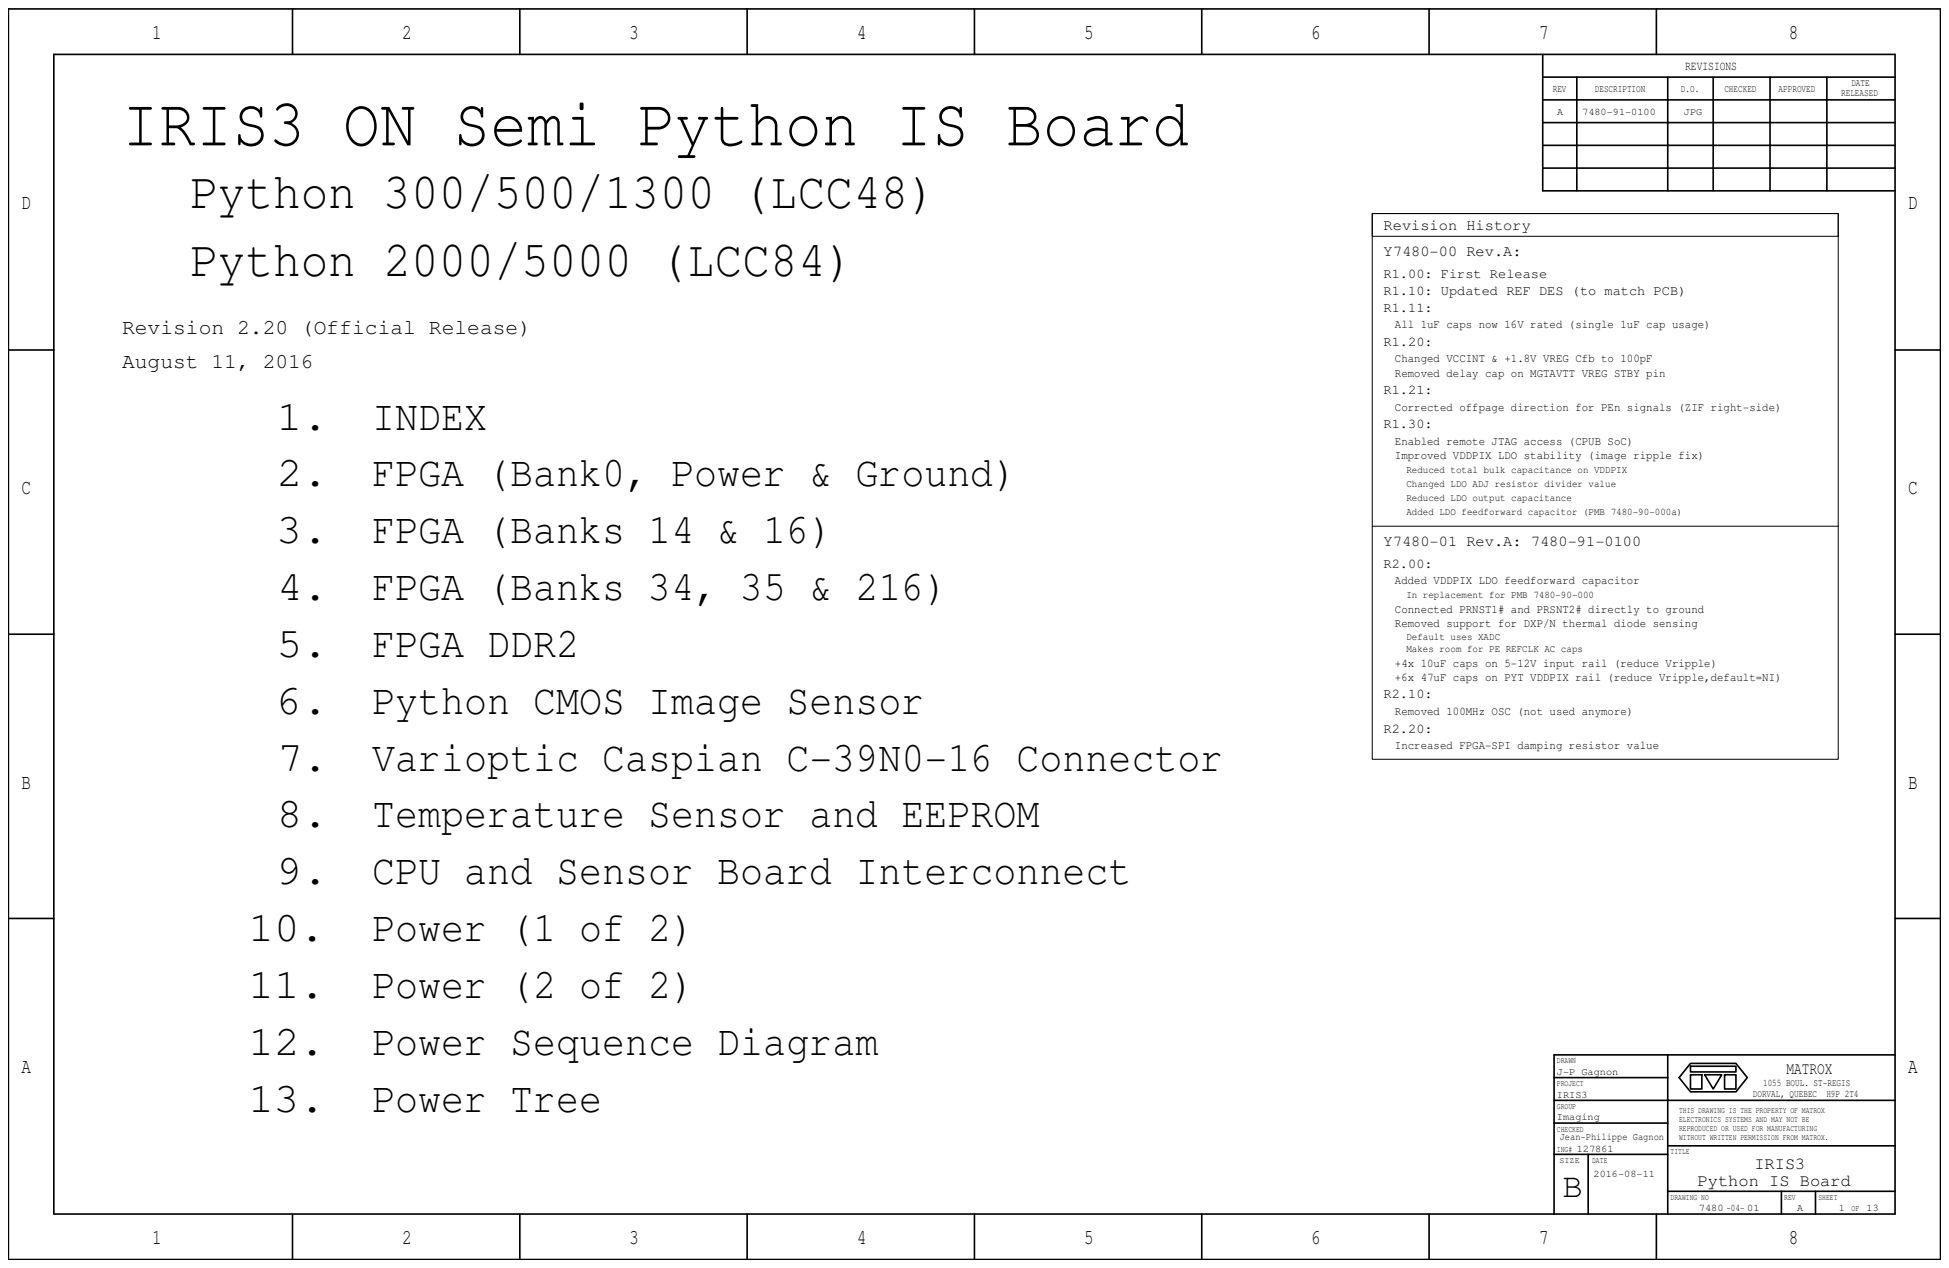
[picture p104: page 1]
IRIS3; J-P Gagnon; Imaging; Jean-Philippe Gagnon; GROUP; DRAWN; CHECKED; PROJECT; ING#; MATROX; Y7480-01 Rev.A: 7480-91-0100; Revision History; Y7480-00 Rev.A:

REVISIONS

DESCRIPTION | D.O. | CHECKED | APPROVED | DATE RELEASED

IRIS3 ON Semi Python IS Board
Python 300/500/1300 (LCC48)
Python 2000/5000 (LCC84)

A | 7480-91-0100 | JPG

R1.00: First Release
R1.10: Updated REF DES (to match PCB)
All 1uF caps now 16V rated (single 1uF cap usage)
Changed VCCINT & +1.8V VREG Cfb to 100pF
Removed delay cap on MGTAVTT VREG STBY pin
Corrected offpage direction for PEn signals (ZIF right-side)
Enabled remote JTAG access (CPUB SoC)
Improved VDDPIX LDO stability (image ripple fix)
Reduced total bulk capacitance on VDDPIX
Changed LDO ADJ resistor divider value
Reduced LDO output capacitance
Added LDO feedforward capacitor (PMB 7480-90-000a)

Revision 2.20 (Official Release)
August 11, 2016

INDEX
FPGA (Bank0, Power & Ground)
FPGA (Banks 14 & 16)
FPGA (Banks 34, 35 & 216)
FPGA DDR2
Python CMOS Image Sensor
Varioptic Caspian C-39N0-16 Connector
Temperature Sensor and EEPROM
CPU and Sensor Board Interconnect
Power (1 of 2)
Power (2 of 2)
Power Sequence Diagram
Power Tree

Added VDDPIX LDO feedforward capacitor
In replacement for PMB 7480-90-000
Connected PRNST1# and PRSNT2# directly to ground
Removed support for DXP/N thermal diode sensing
Default uses XADC
Makes room for PE REFCLK AC caps
+4x 10uF caps on 5-12V input rail (reduce Vripple)
+6x 47uF caps on PYT VDDPIX rail (reduce Vripple,default=NI)
Removed 100MHz OSC (not used anymore)
Increased FPGA-SPI damping resistor value

1055 BOUL. ST-REGIS
DORVAL, QUEBEC H9P 2T4

THIS DRAWING IS THE PROPERTY OF MATROX
ELECTRONICS SYSTEMS AND MAY NOT BE
REPRODUCED OR USED FOR MANUFACTURING
WITHOUT WRITTEN PERMISSION FROM MATROX.

SIZE B | DATE 2016-08-11

TITLE
Python IS Board

DRAWING NO 7480 01 -04- | REV A | SHEET 1 OF 13

D

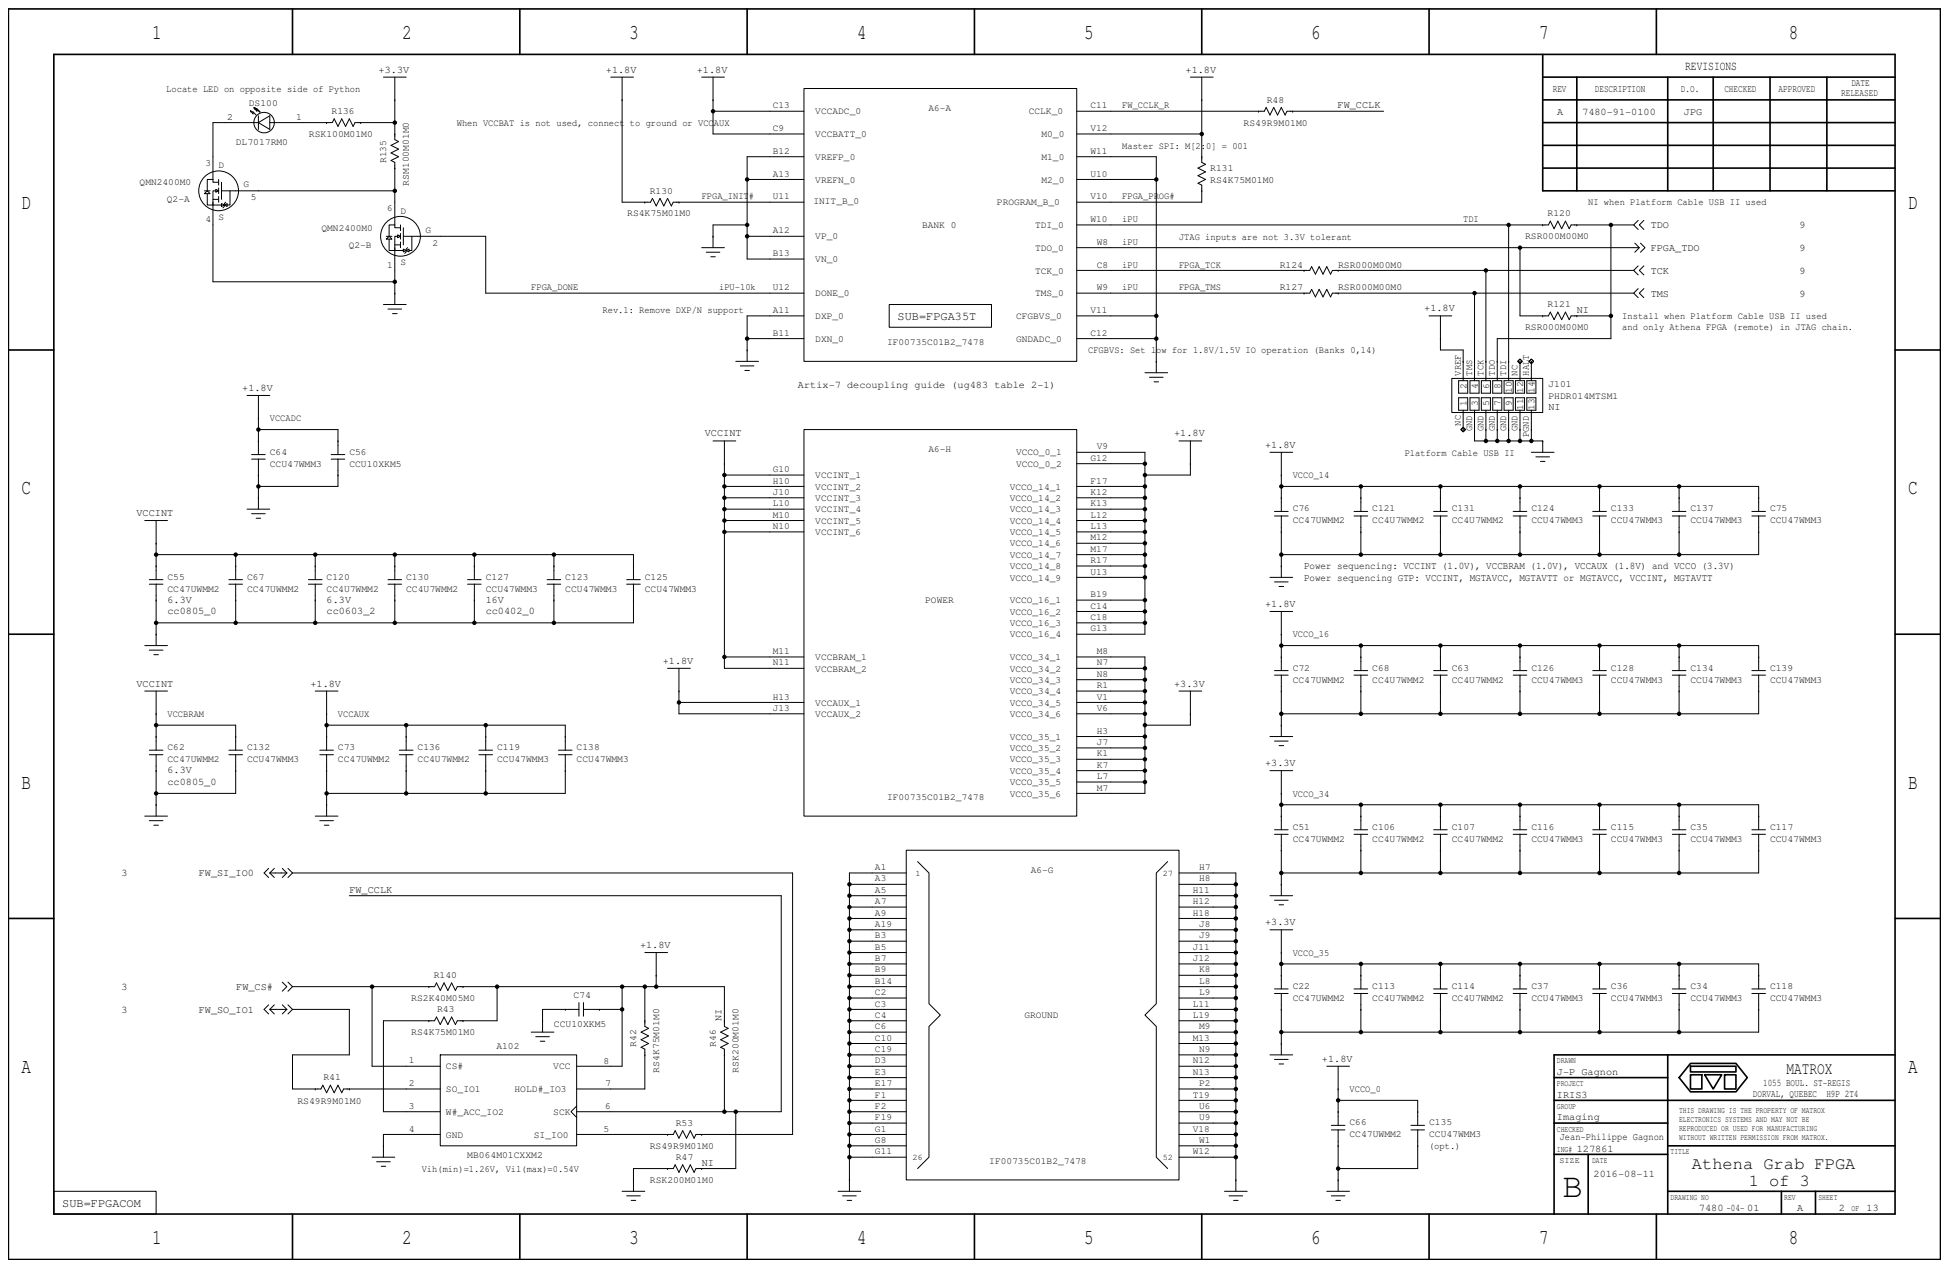
[picture p105: page 2]

Locate LED on opposite side of Python

When VCCBAT is not used, connect to ground or VCCAUX

NI when Platform Cable USB II used

JTAG inputs are not 3.3V tolerant

Rev.1: Remove DXP/N support

Install when Platform Cable USB II used
and only Athena FPGA (remote) in JTAG chain.

CFGBVS: Set low for 1.8V/1.5V IO operation (Banks 0,14)

Artix-7 decoupling guide (ug483 table 2-1)

Platform Cable USB II

Power sequencing: VCCINT (1.0V), VCCBRAM (1.0V), VCCAUX (1.8V) and VCCO (3.3V)
Power sequencing GTP: VCCINT, MGTAVCC, MGTAVTT or MGTAVCC, VCCINT, MGTAVTT

THIS DRAWING IS THE PROPERTY OF MATROX
ELECTRONICS SYSTEMS AND MAY NOT BE
REPRODUCED OR USED FOR MANUFACTURING
WITHOUT WRITTEN PERMISSION FROM MATROX.
Athena Grab FPGA

SIZE | DATE

Vih(min)=1.26V, Vil(max)=0.54V

D

A6-B

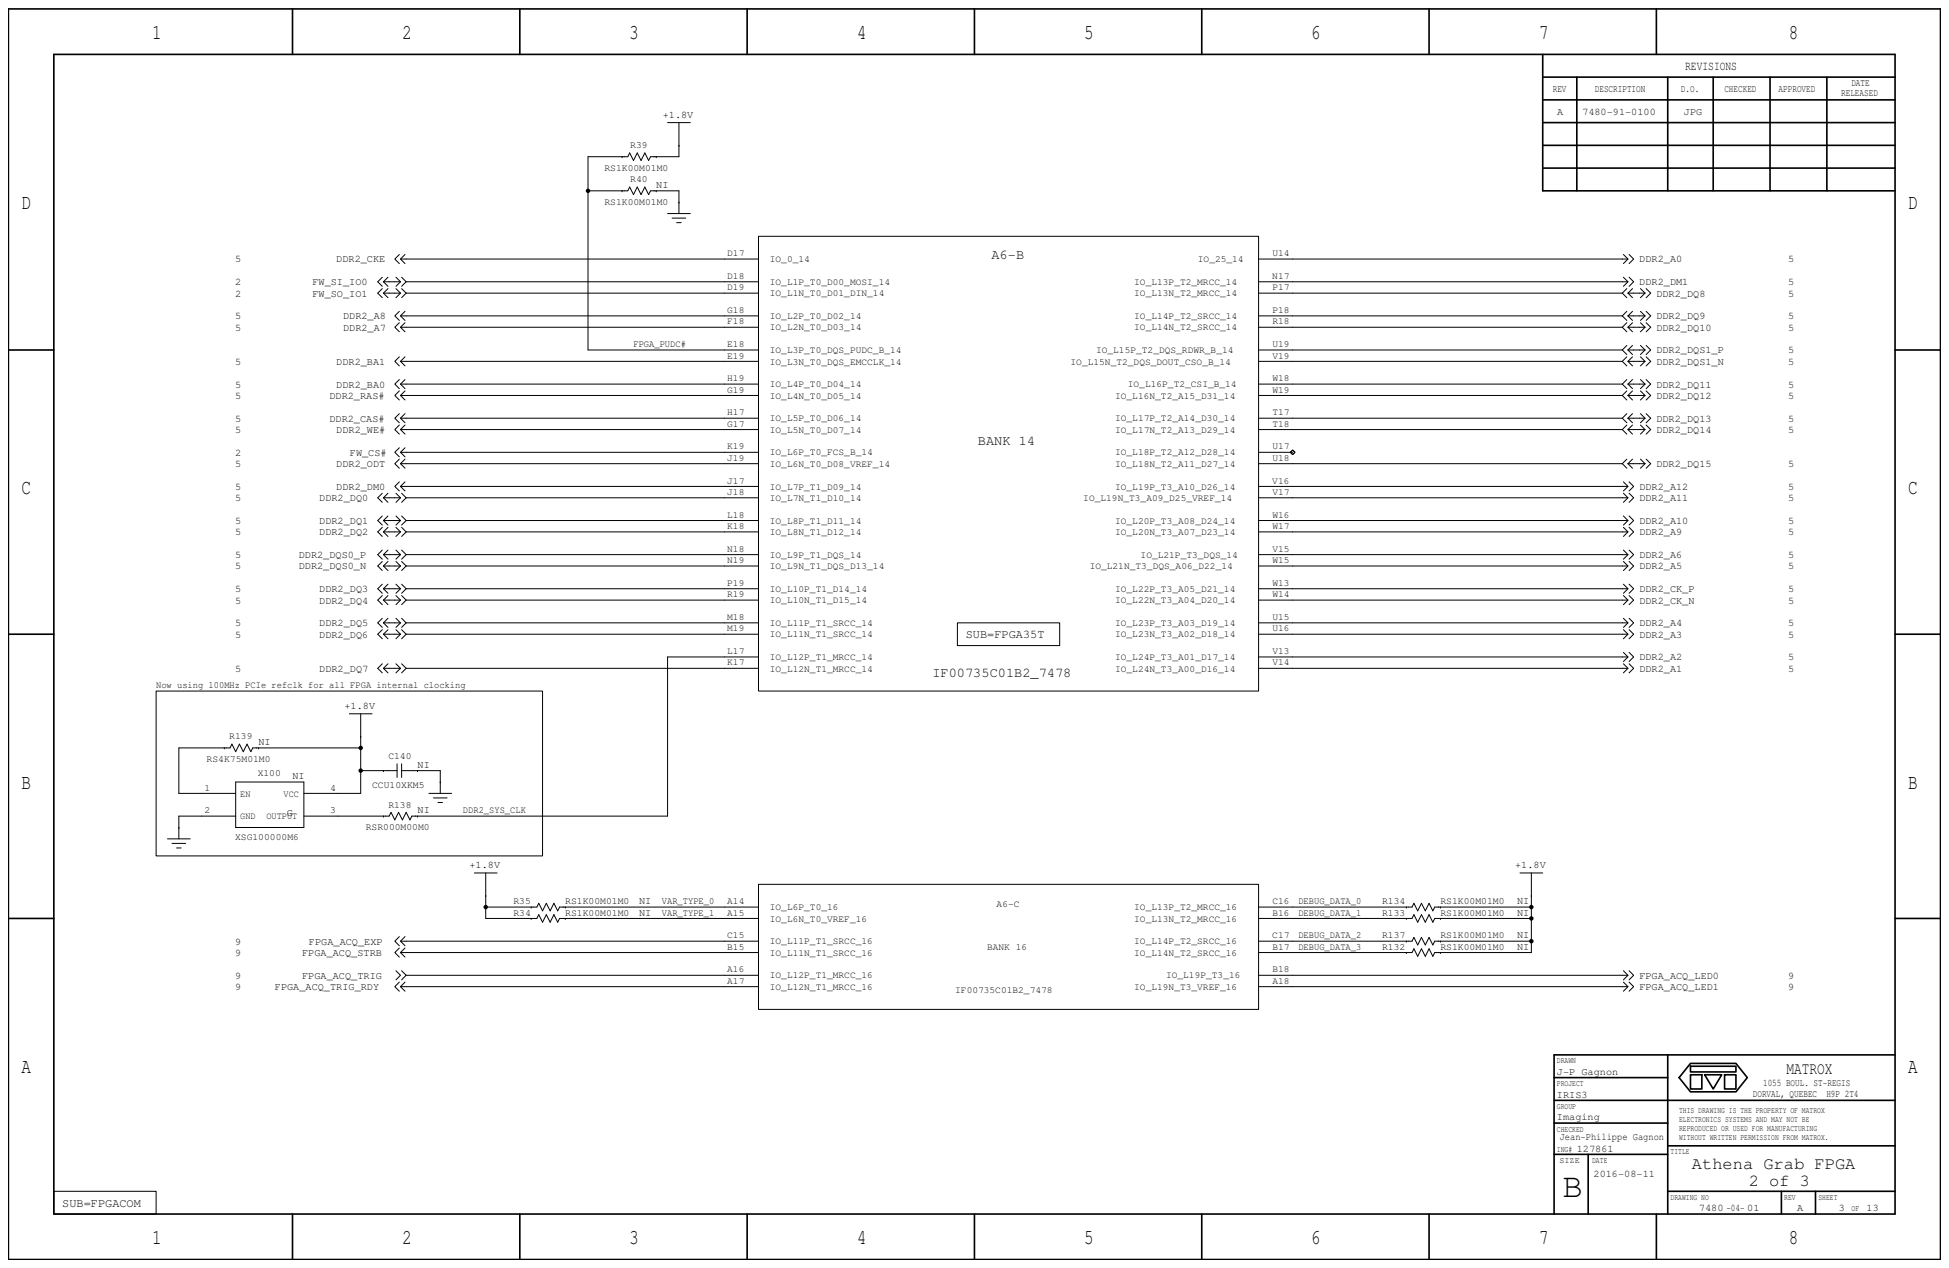
[picture p106: page 3]

Now using 100MHz PCIe refclk for all FPGA internal clocking

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

D

A6-D

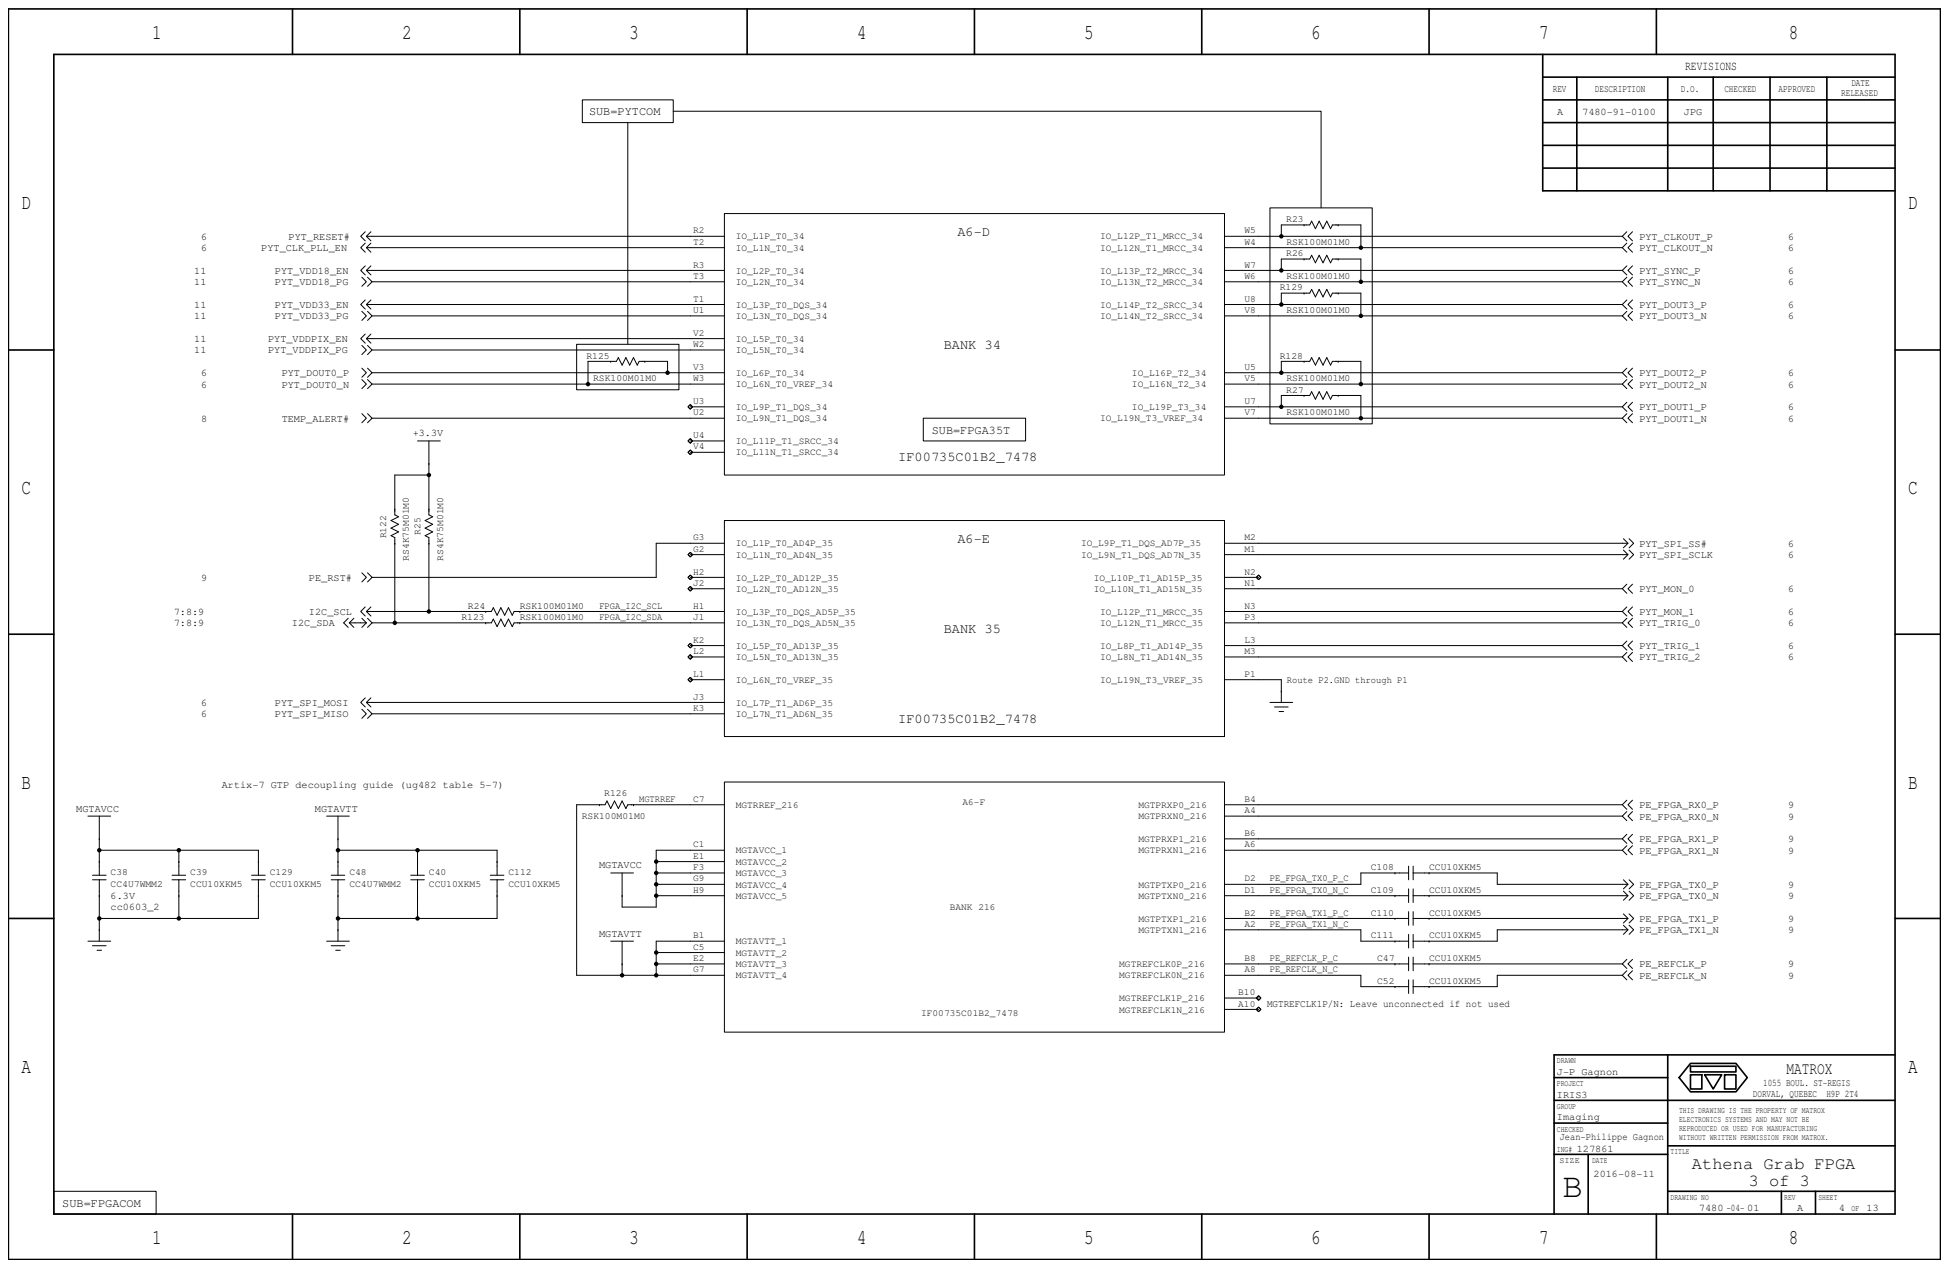
[picture p107: page 4]

Artix-7 GTP decoupling guide (ug482 table 5-7)

MGTREFCLK1P/N: Leave unconnected if not used

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

D

| 2 3

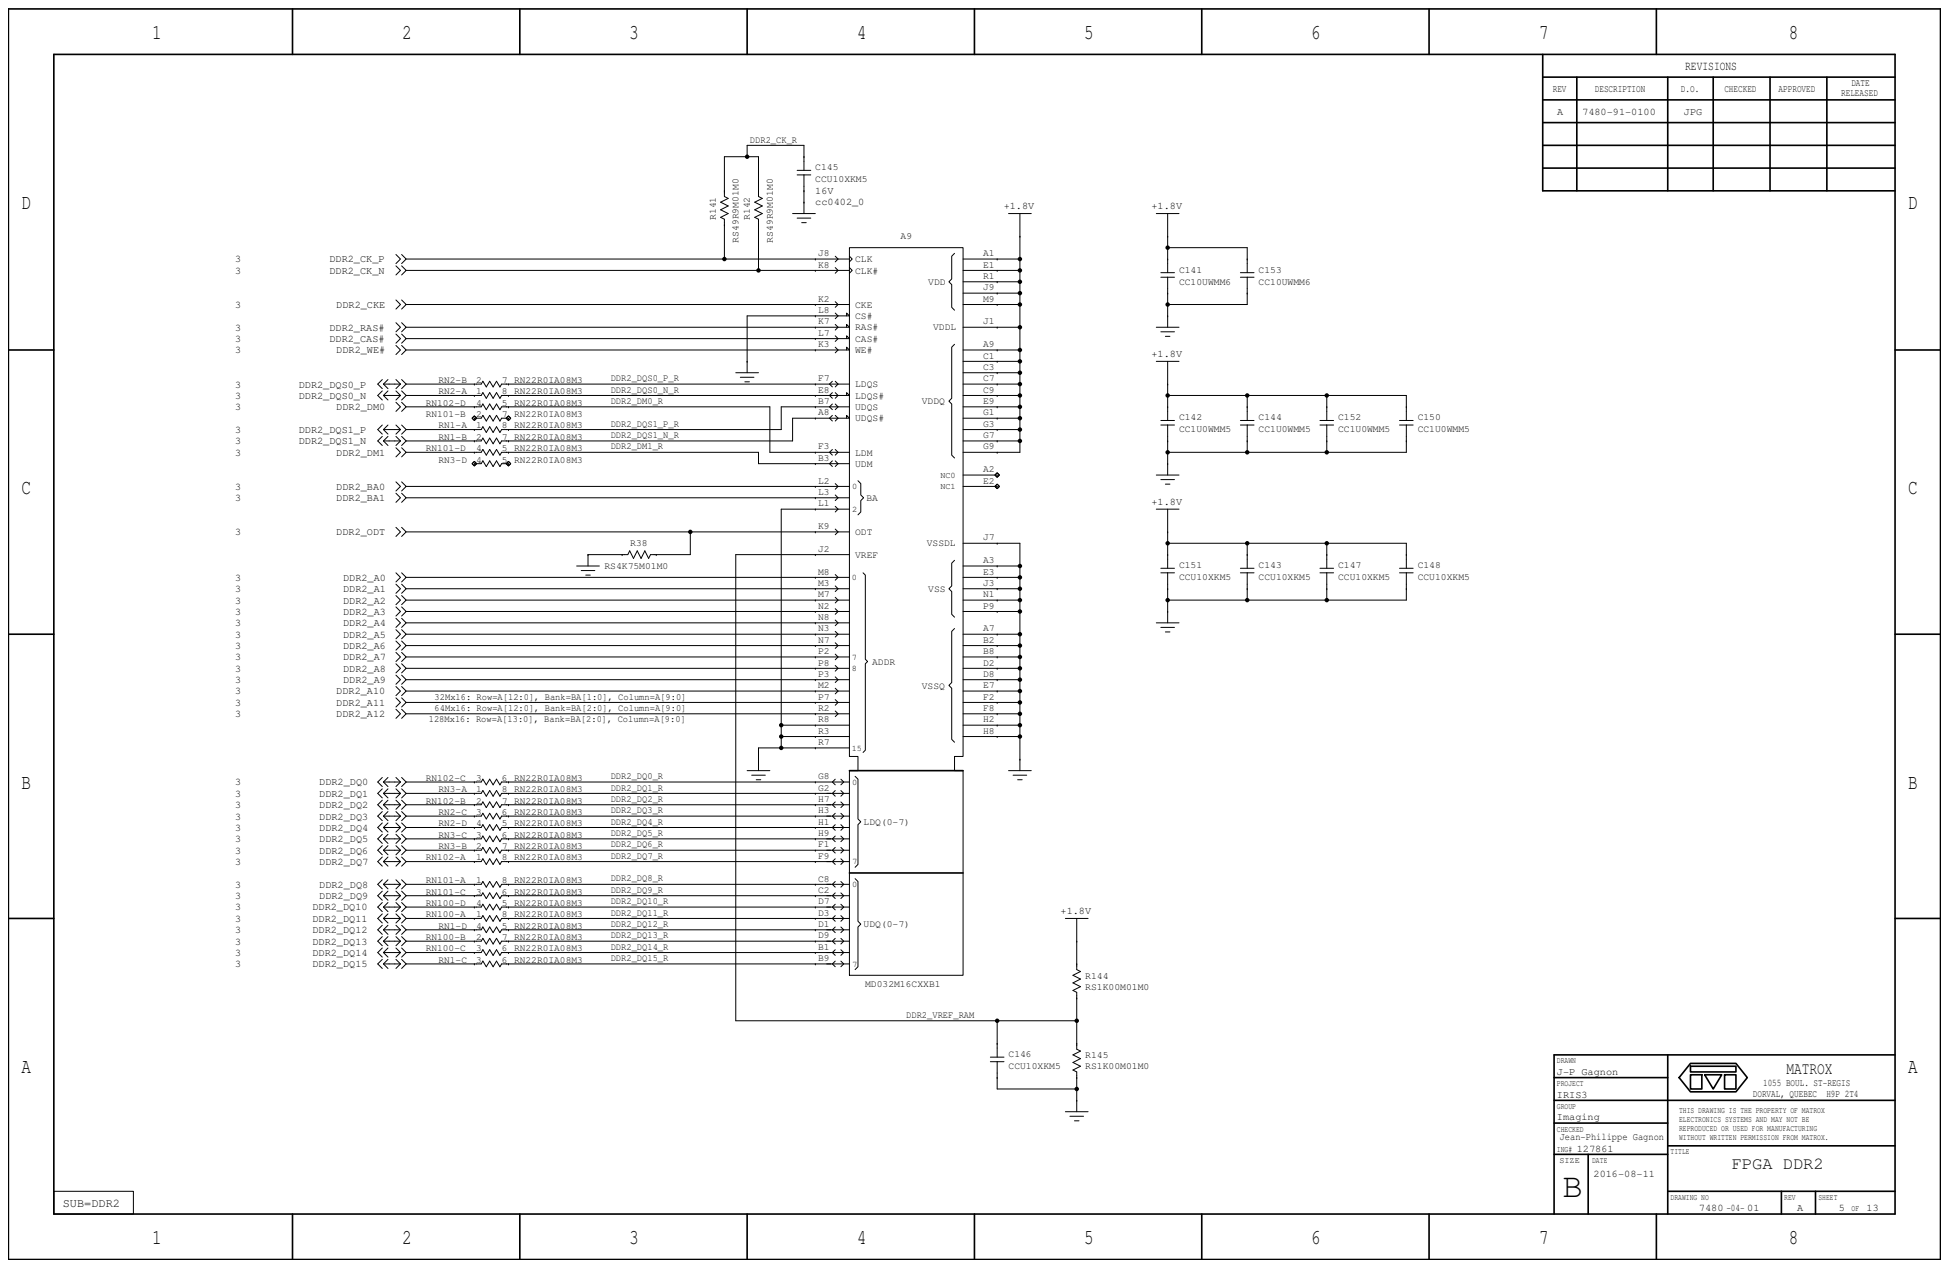
[picture p108: page 5]

DDR2_CK_R

A8 | G1
F3 | G3

32Mx16: Row=A[12:0], Bank=BA[1:0], Column=A[9:0]
64Mx16: Row=A[12:0], Bank=BA[2:0], Column=A[9:0]
128Mx16: Row=A[13:0], Bank=BA[2:0], Column=A[9:0]

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

D

1 | 2 | 3

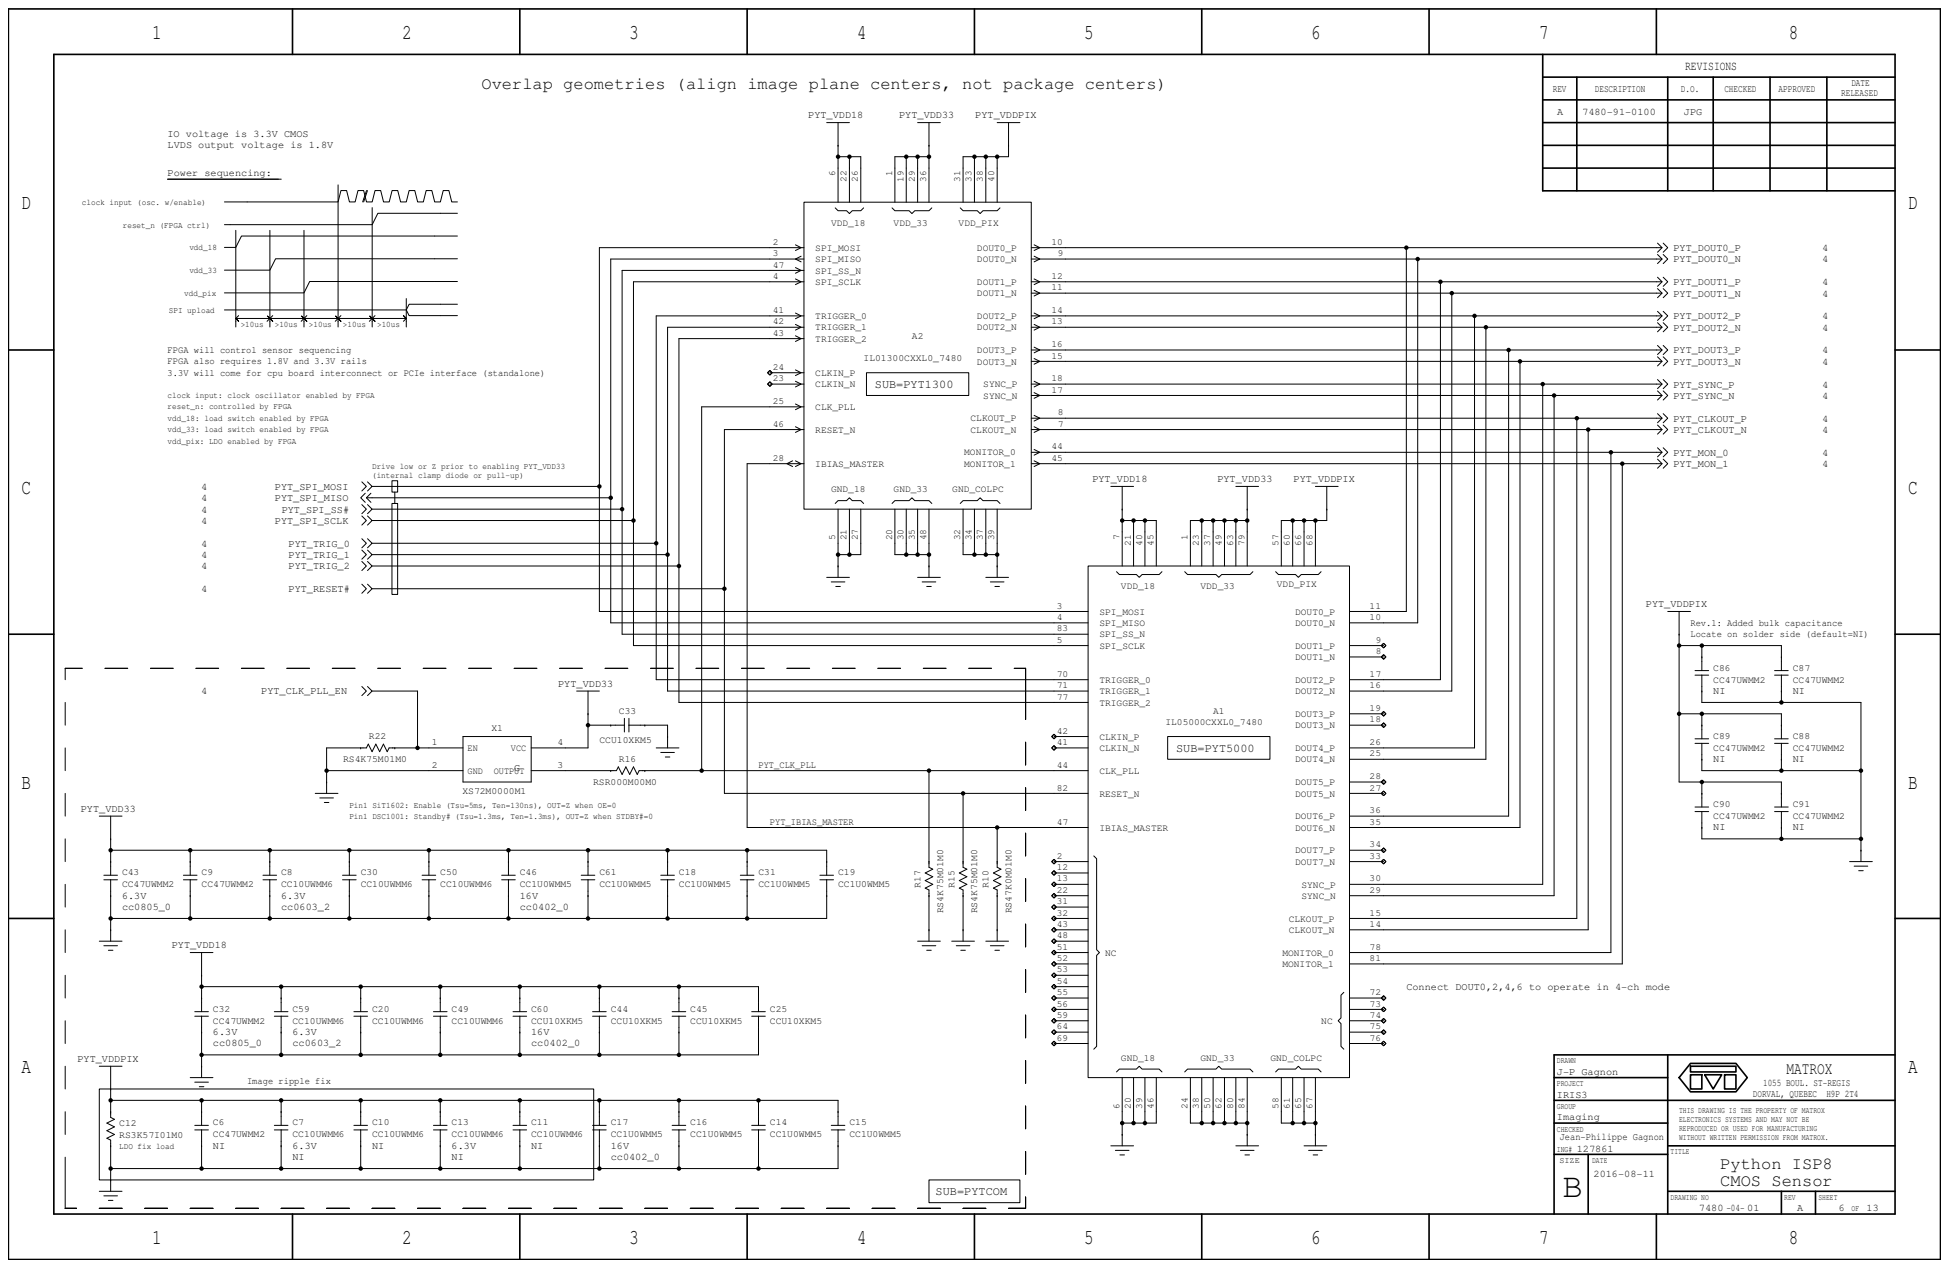
[picture p109: page 6]

Overlap geometries (align image plane centers, not package centers)

A | 7480-91-0100 | JPG

PYT_VDD18 PYT_VDD33 PYT_VDDPIX

IO voltage is 3.3V CMOS
LVDS output voltage is 1.8V

clock input (osc. w/enable)

FPGA will control sensor sequencing
FPGA also requires 1.8V and 3.3V rails
3.3V will come for cpu board interconnect or PCIe interface (standalone)

clock input: clock oscillator enabled by FPGA
reset_n: controlled by FPGA
vdd_18: load switch enabled by FPGA
vdd_33: load switch enabled by FPGA
vdd_pix: LDO enabled by FPGA

Drive low or Z prior to enabling PYT_VDD33
(internal clamp diode or pull-up)

Rev.1: Added bulk capacitance
Locate on solder side (default=NI)

Pin1 SiT1602: Enable (Tsu=5ms, Ten=130ns), OUT=Z when OE=0
Pin1 DSC1001: Standby# (Tsu=1.3ms, Ten=1.3ms), OUT=Z when STDBY#=0

Connect DOUT0,2,4,6 to operate in 4-ch mode

THIS DRAWING IS THE PROPERTY OF MATROX
ELECTRONICS SYSTEMS AND MAY NOT BE
REPRODUCED OR USED FOR MANUFACTURING
WITHOUT WRITTEN PERMISSION FROM MATROX.
Python ISP8
CMOS Sensor

D

1 | 2 | 3 | 4

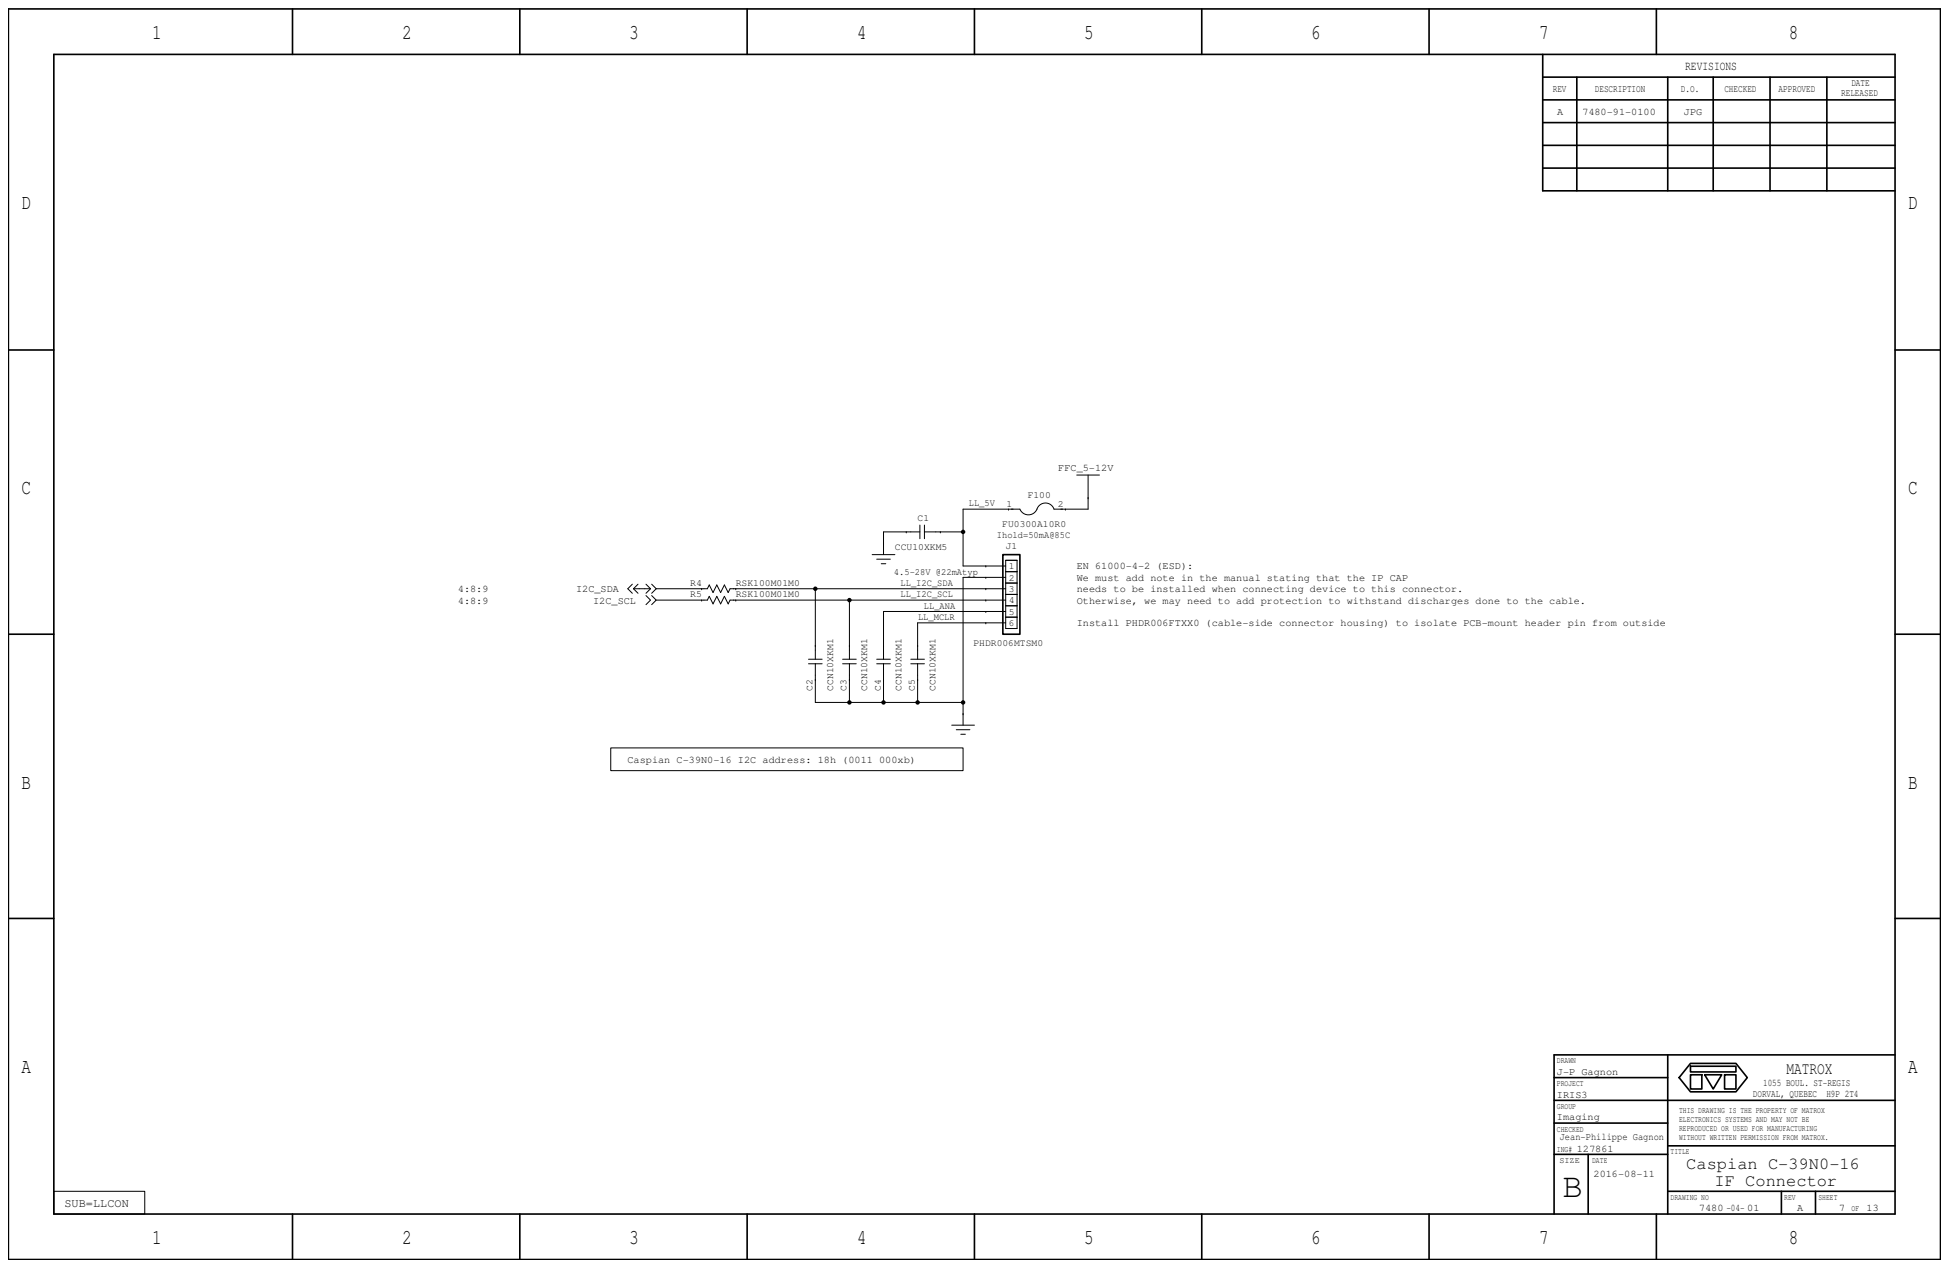
[picture p110: page 7]

EN 61000-4-2 (ESD):
We must add note in the manual stating that the IP CAP
needs to be installed when connecting device to this connector.
Otherwise, we may need to add protection to withstand discharges done to the cable.

Install PHDR006FTXX0 (cable-side connector housing) to isolate PCB-mount header pin from outside

THIS DRAWING IS THE PROPERTY OF MATROX
ELECTRONICS SYSTEMS AND MAY NOT BE
REPRODUCED OR USED FOR MANUFACTURING
WITHOUT WRITTEN PERMISSION FROM MATROX.
Caspian C-39N0-16
IF Connector

SIZE | DATE

D

1 | 2 | 3 | 4

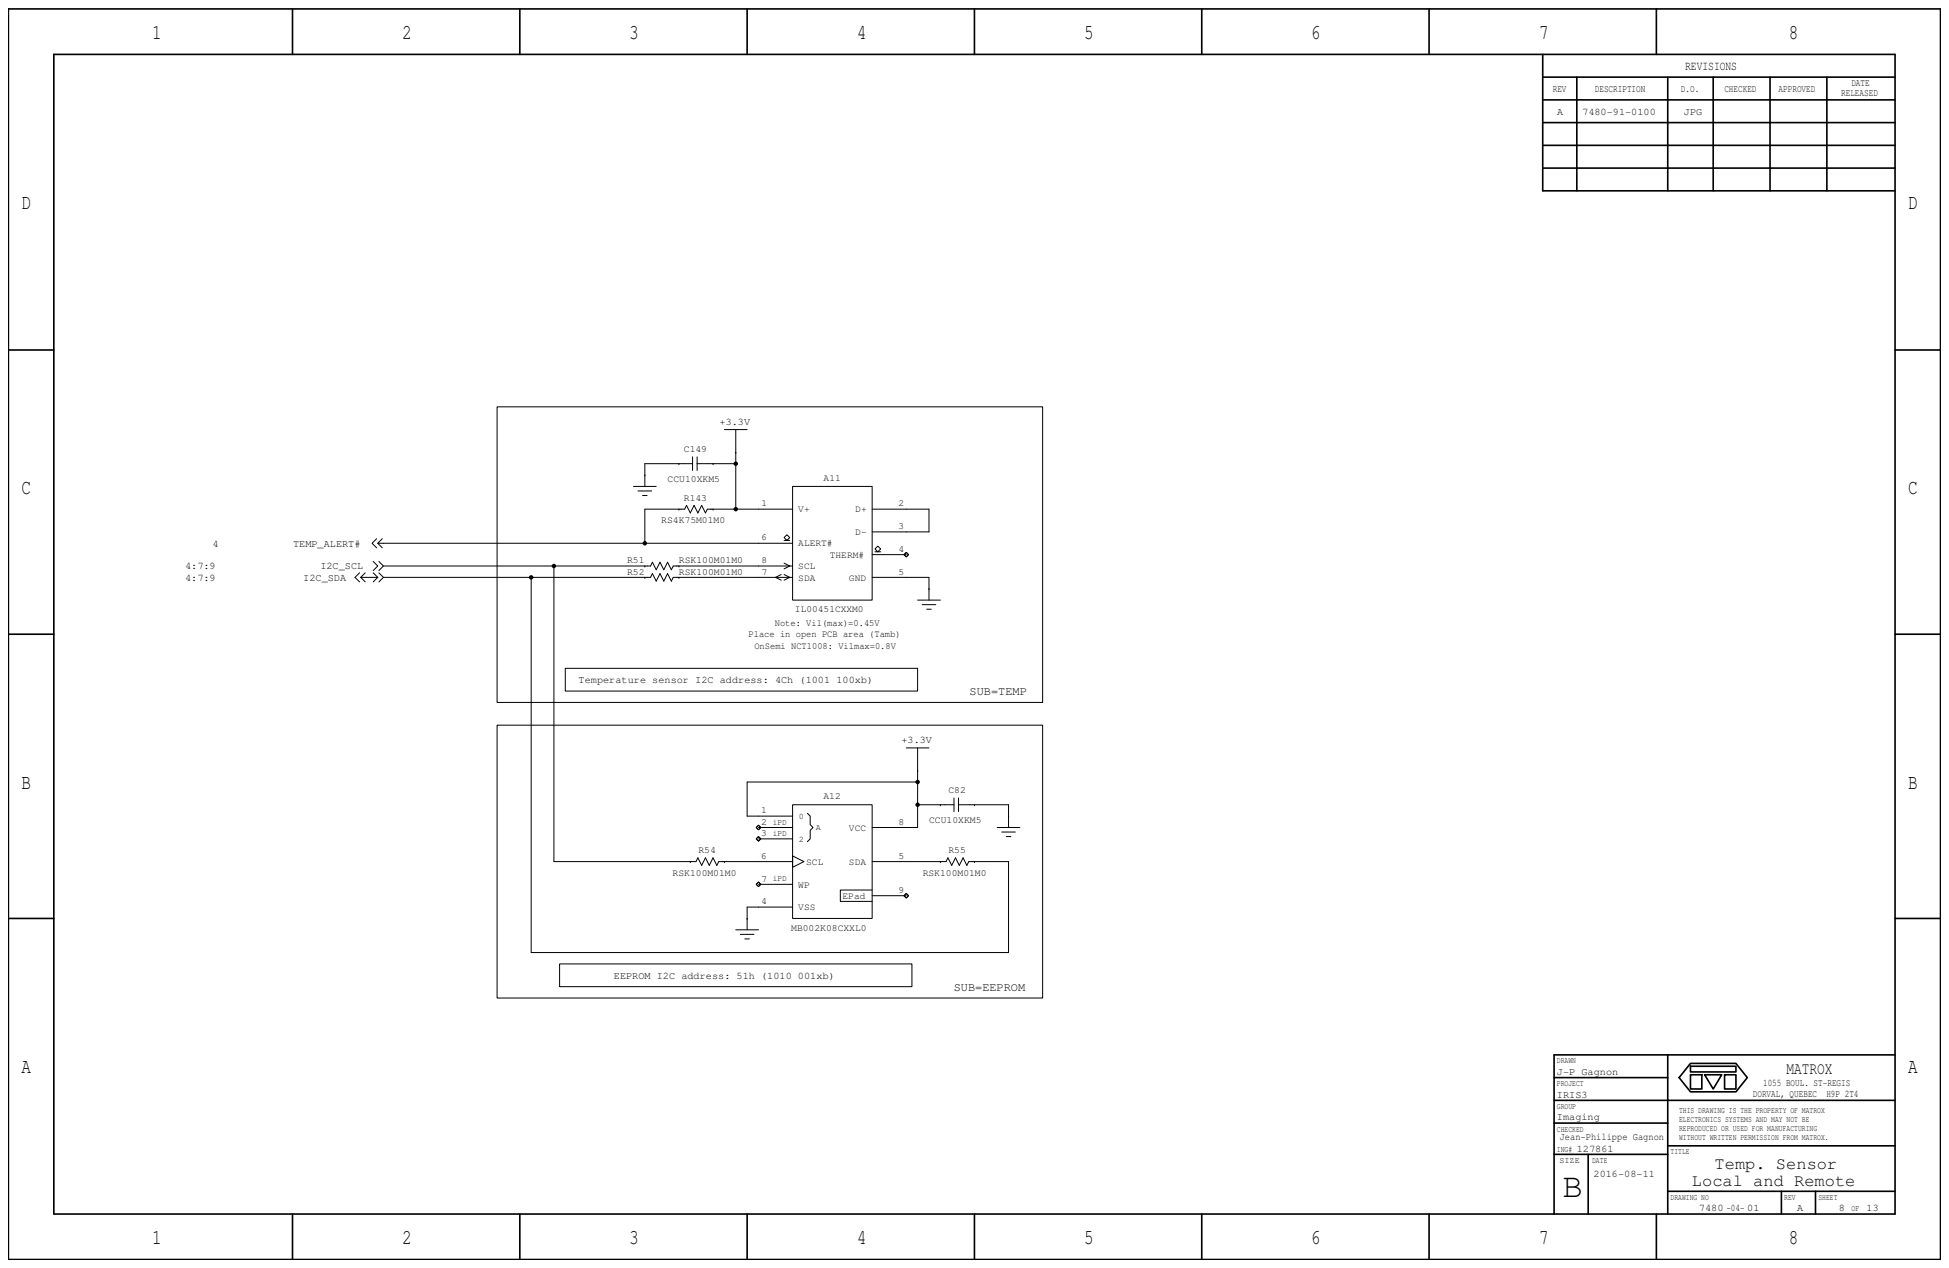
[picture p111: page 8]
I2C_SCL I2C_SDA; TEMP_ALERT#; RSK100M01M0; MB002K08CXXL0; VSS; SCL; EPad; SDA; VCC; CCU10XKM5; RSK100M01M0 RSK100M01M0; THERM#; ALERT#; GND; J-P Gagnon; IRIS3; Imaging; Jean-Philippe Gagnon; GROUP; DRAWN; CHECKED; PROJECT; ING#; TITLE; JPG; MATROX; EEPROM I2C address: 51h (1010 001xb); iPD; SUB=EEPROM; SUB=TEMP

IL00451CXXM0
Note: Vil(max)=0.45V

Place in open PCB area (Tamb)
OnSemi NCT1008: Vilmax=0.8V

Temperature sensor I2C address: 4Ch (1001 100xb)

1055 BOUL. ST-REGIS
DORVAL, QUEBEC H9P 2T4

THIS DRAWING IS THE PROPERTY OF MATROX
ELECTRONICS SYSTEMS AND MAY NOT BE
REPRODUCED OR USED FOR MANUFACTURING
WITHOUT WRITTEN PERMISSION FROM MATROX.
Temp. Sensor
Local and Remote

SIZE | DATE

D

D

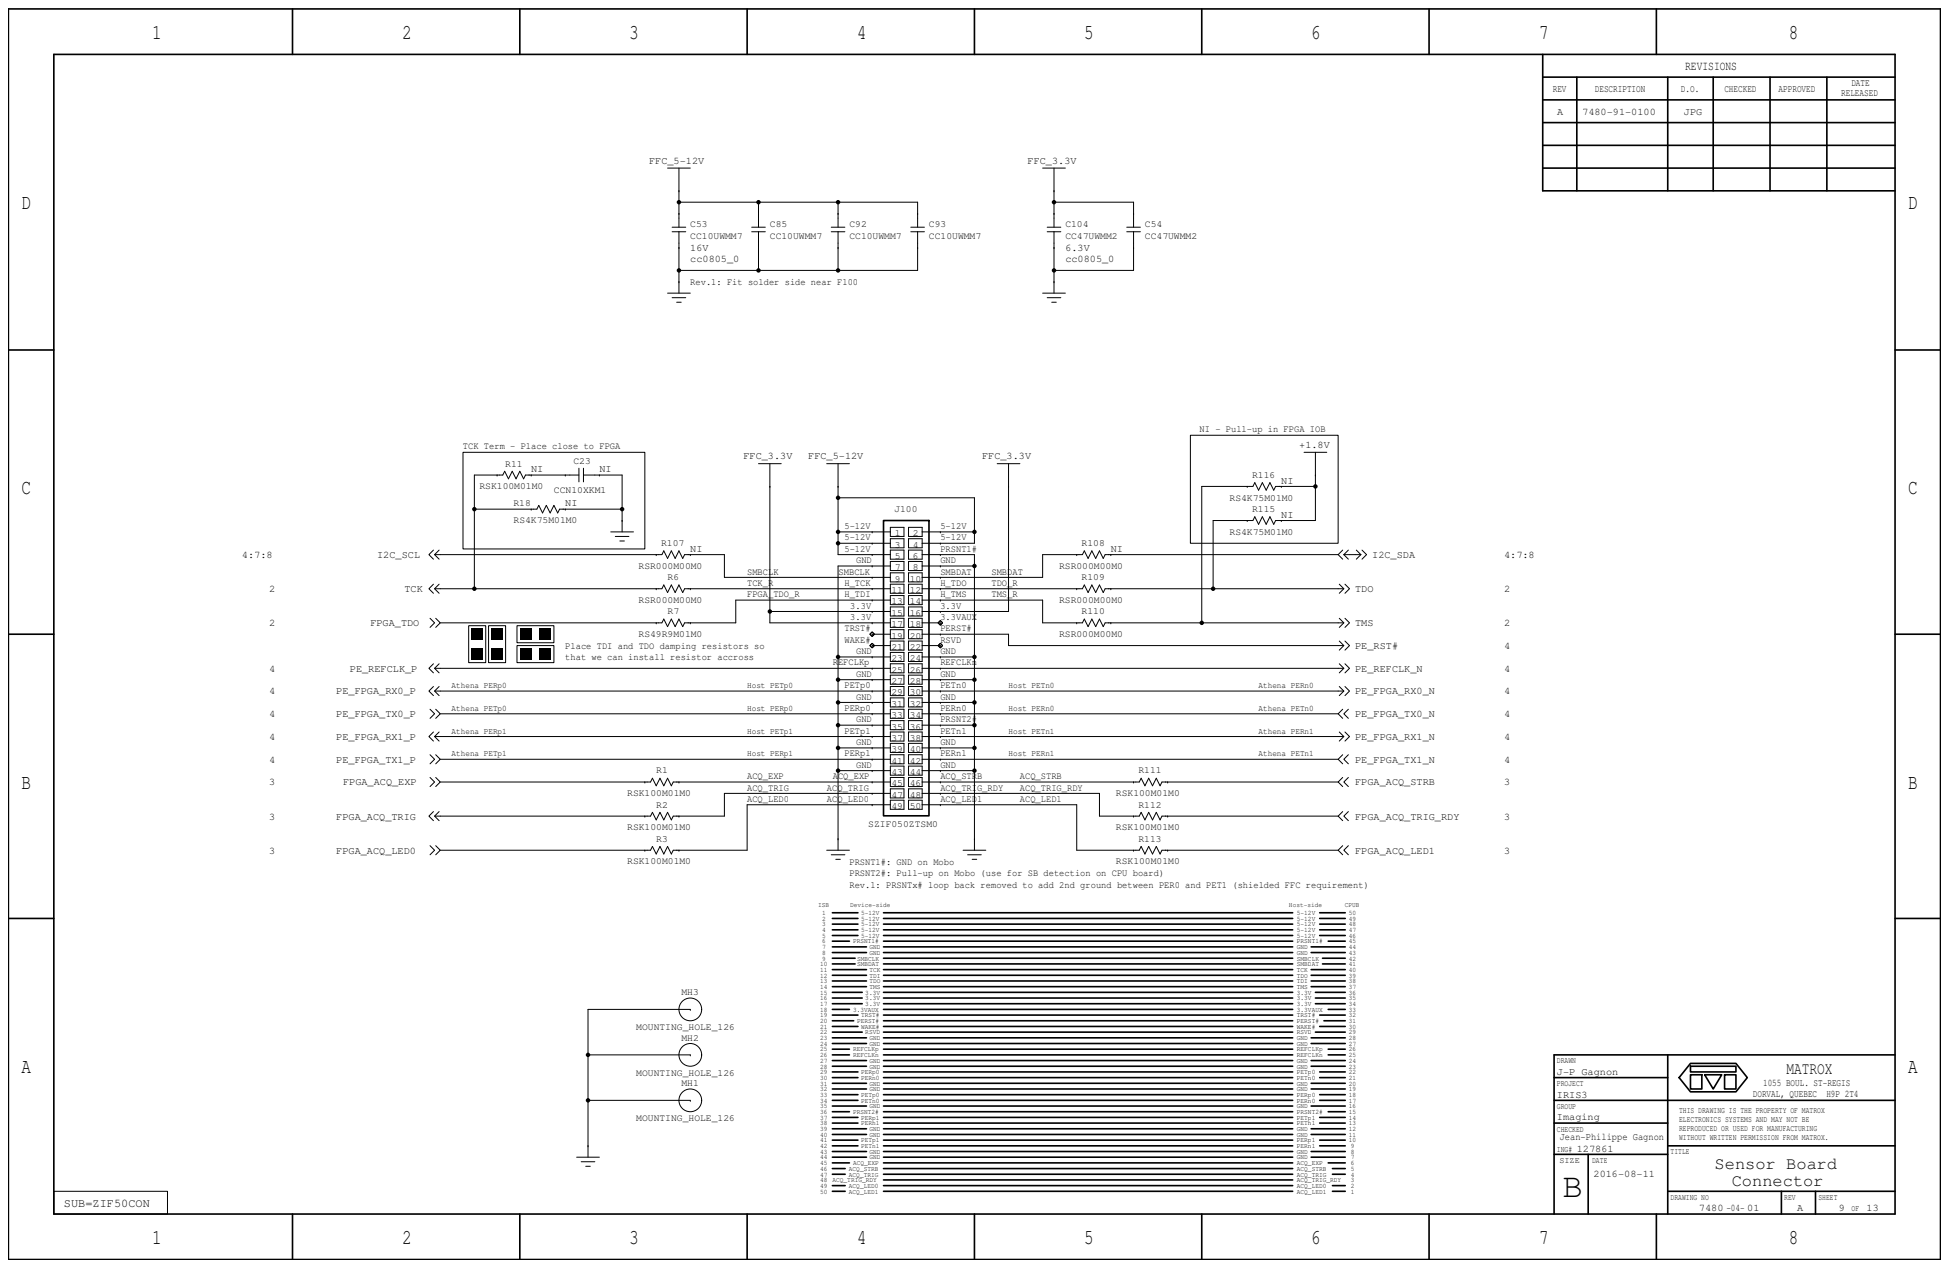
[picture p112: page 9]

Rev.1: Fit solder side near F100

NI - Pull-up in FPGA IOB

TCK Term - Place close to FPGA

Place TDI and TDO damping resistors so
that we can install resistor accross

PRSNT1#: GND on Mobo
PRSNT2#: Pull-up on Mobo (use for SB detection on CPU board)
Rev.1: PRSNTx# loop back removed to add 2nd ground between PER0 and PET1 (shielded FFC requirement)

THIS DRAWING IS THE PROPERTY OF MATROX
ELECTRONICS SYSTEMS AND MAY NOT BE
REPRODUCED OR USED FOR MANUFACTURING
WITHOUT WRITTEN PERMISSION FROM MATROX.
Sensor Board
Connector

SIZE | DATE

D

D

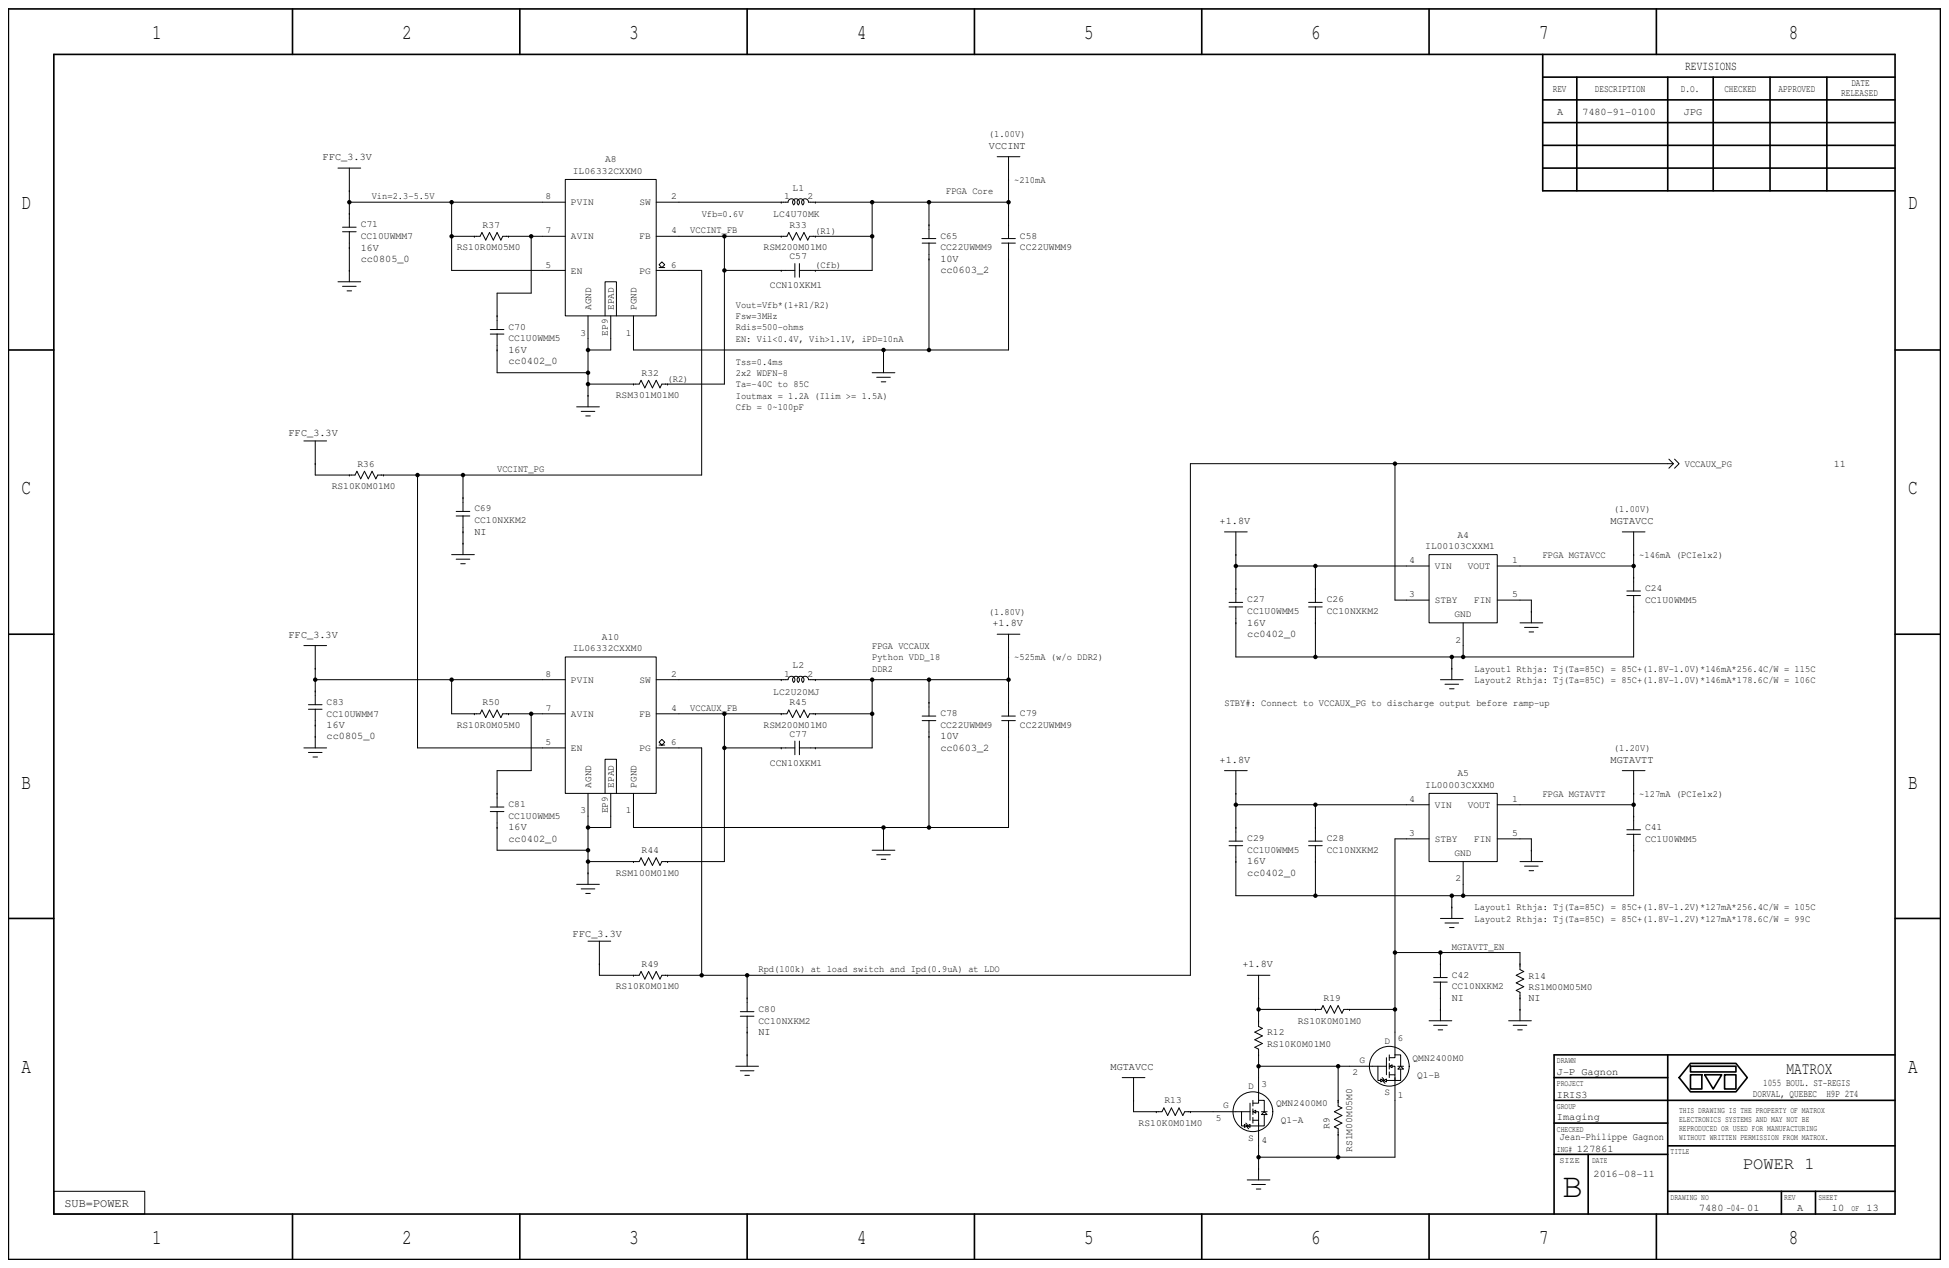
[picture p113: page 10]

Vout=Vfb*(1+R1/R2)
Fsw=3MHz
Rdis=500-ohms
EN: Vil<0.4V, Vih>1.1V, iPD=10nA

STBY#: Connect to VCCAUX_PG to discharge output before ramp-up

Rpd(100k) at load switch and Ipd(0.9uA) at LDO

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

SIZE | DATE

D

1 | 2 | 3

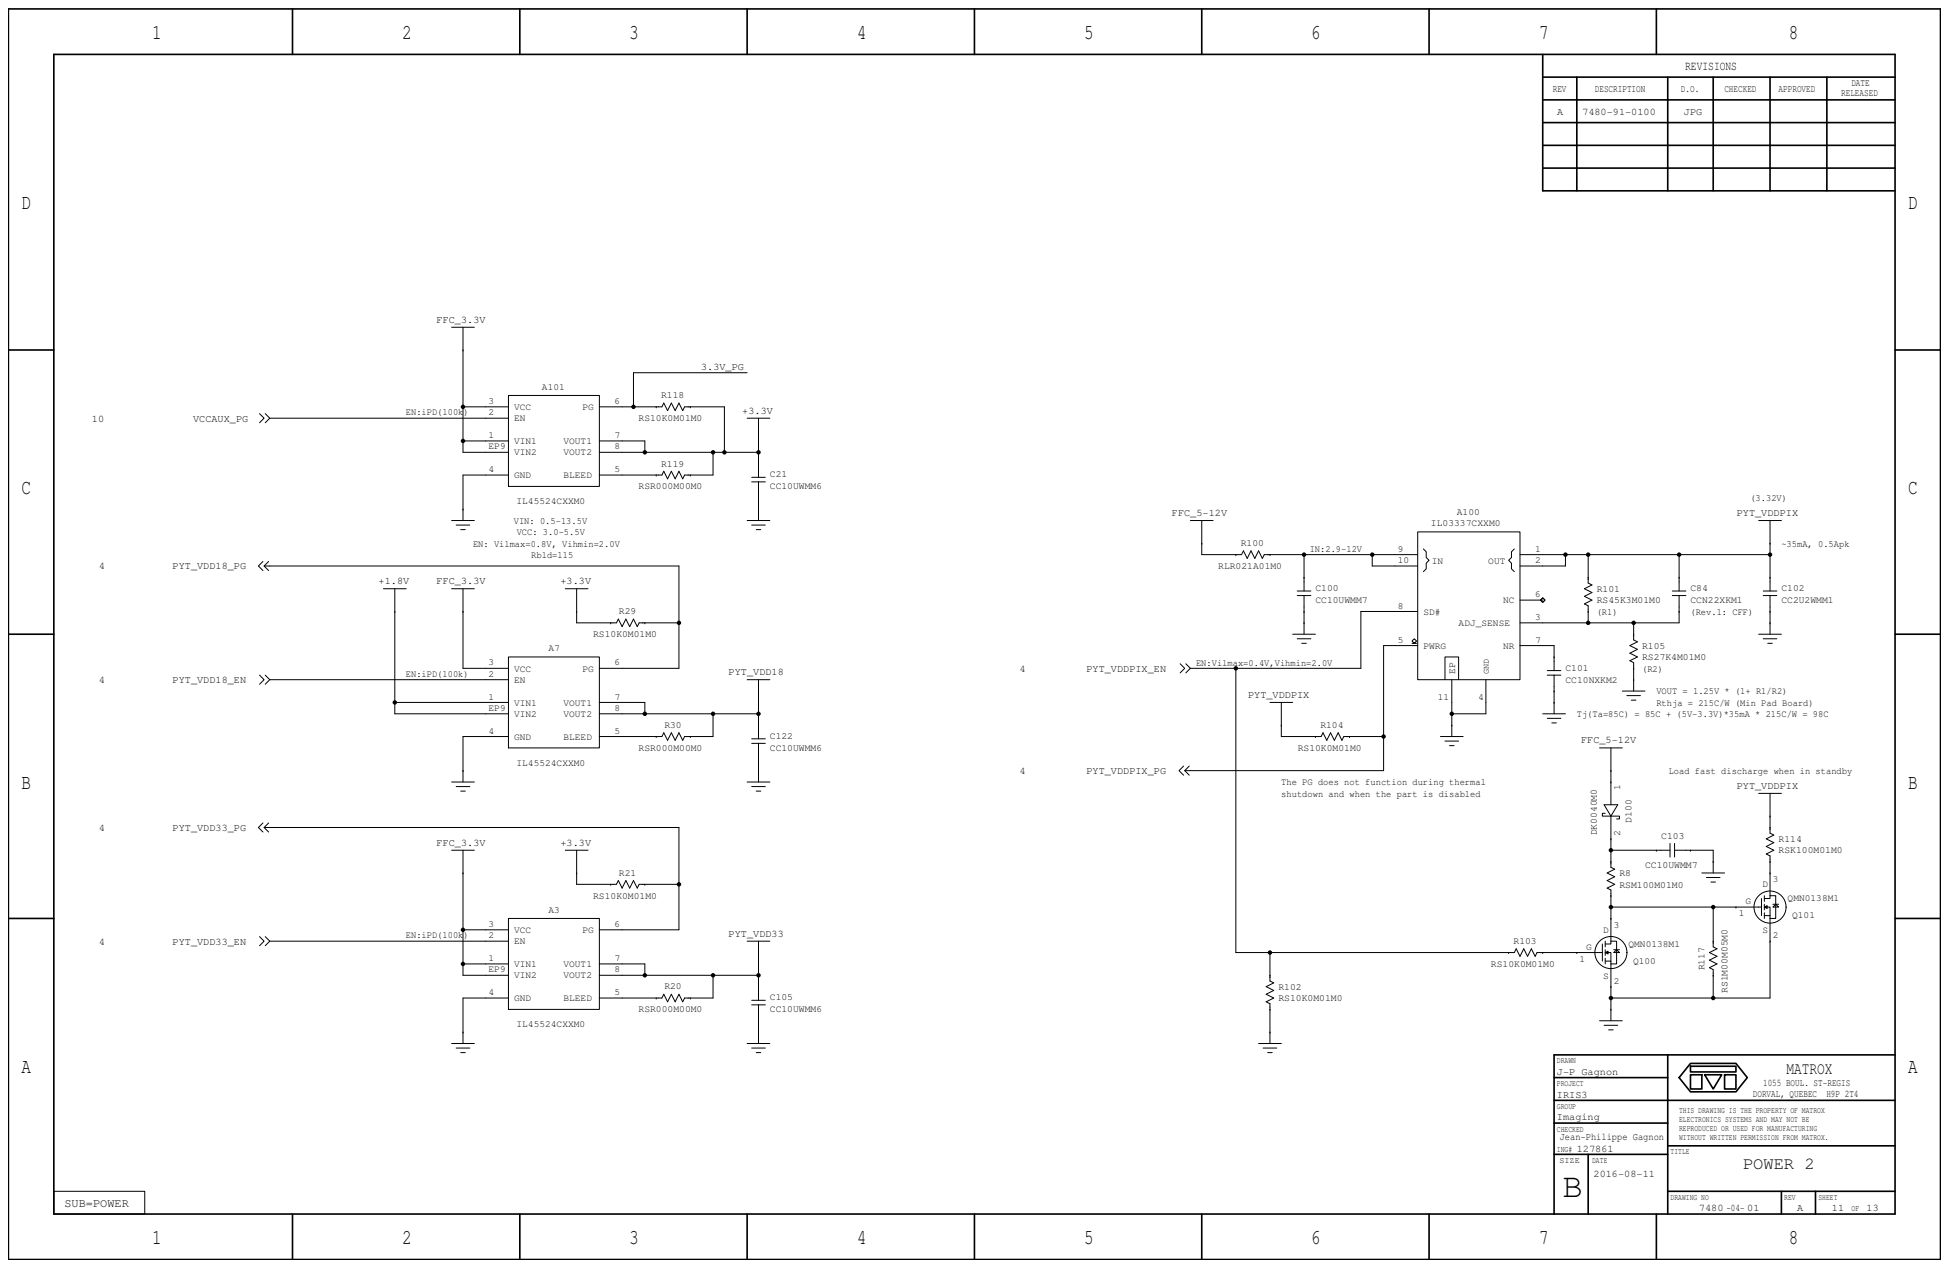
[picture p114: page 11]

VOUT = 1.25V * (1+ R1/R2)
Rthja = 215C/W (Min Pad Board)

Load fast discharge when in standby

The PG does not function during thermal
shutdown and when the part is disabled

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

SIZE | DATE

D

1 | 2 | 3 | 4

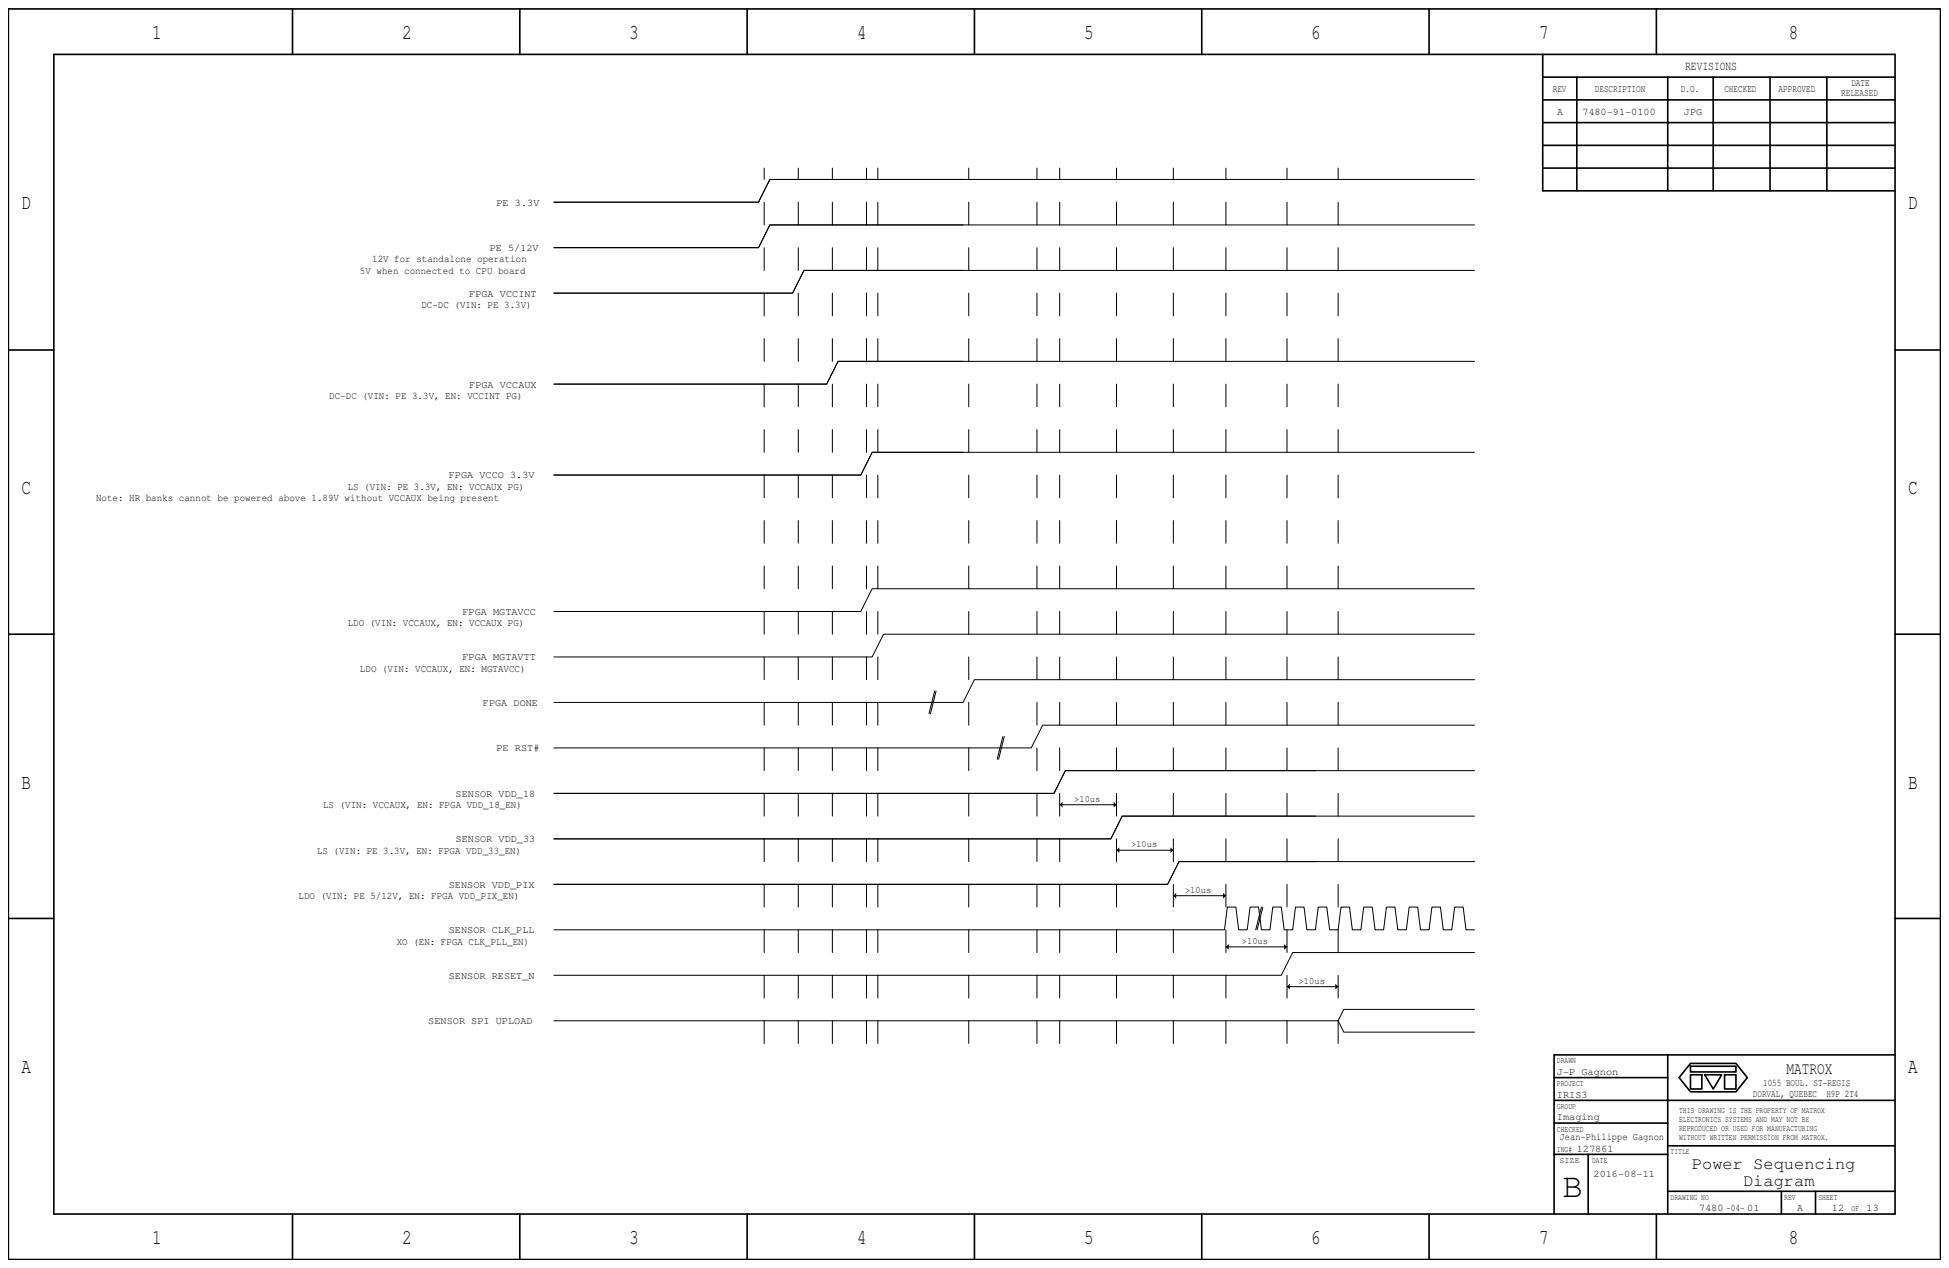
[picture p115: page 12]
Diagram; J-P Gagnon; IRIS3; Imaging; Jean-Philippe Gagnon; GROUP; DRAWN; CHECKED; PROJECT; ING#; TITLE; JPG; MATROX; FPGA VCCO 3.3V; SENSOR VDD_PIX; SENSOR CLK_PLL; SENSOR RESET_N; SENSOR VDD_33; FPGA DONE; SENSOR VDD_18; PE RST#; FPGA MGTAVCC; FPGA MGTAVTT; FPGA VCCAUX; FPGA VCCINT

12V for standalone operation
5V when connected to CPU board

DC-DC (VIN: PE 3.3V)

DC-DC (VIN: PE 3.3V, EN: VCCINT PG)

LS (VIN: PE 3.3V, EN: VCCAUX PG)

Note: HR banks cannot be powered above 1.89V without VCCAUX being present

LDO (VIN: VCCAUX, EN: VCCAUX PG)

LDO (VIN: VCCAUX, EN: MGTAVCC)

LS (VIN: VCCAUX, EN: FPGA VDD_18_EN)

LS (VIN: PE 3.3V, EN: FPGA VDD_33_EN)

LDO (VIN: PE 5/12V, EN: FPGA VDD_PIX_EN)

XO (EN: FPGA CLK_PLL_EN)

SENSOR SPI UPLOAD

1055 BOUL. ST-REGIS
DORVAL, QUEBEC H9P 2T4

THIS DRAWING IS THE PROPERTY OF MATROX
ELECTRONICS SYSTEMS AND MAY NOT BE
REPRODUCED OR USED FOR MANUFACTURING
WITHOUT WRITTEN PERMISSION FROM MATROX.
Power Sequencing

SIZE | DATE

D

1 | 2 | 3 | 4

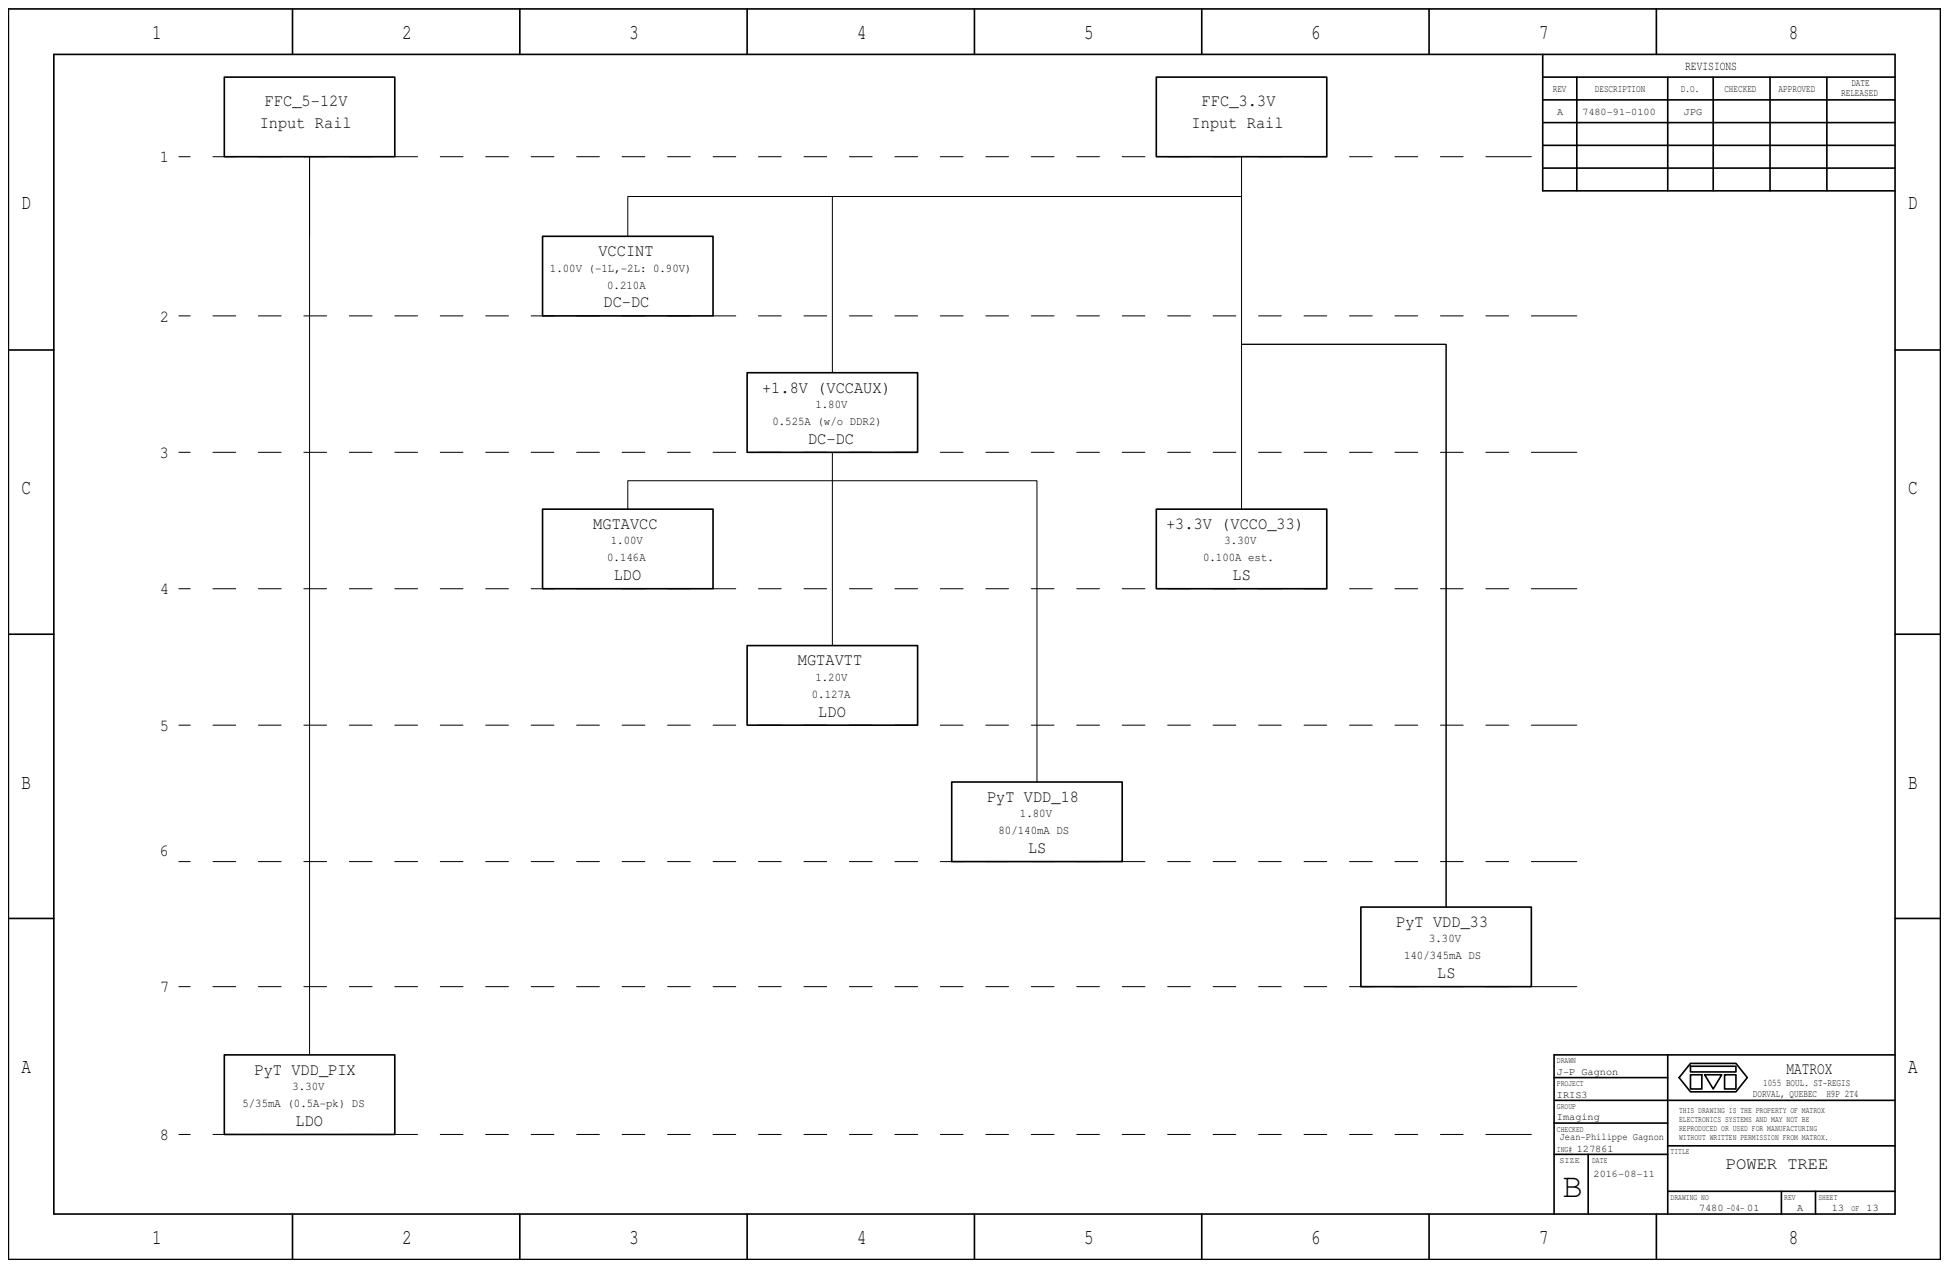
[picture p116: page 13]
POWER TREE; J-P Gagnon; IRIS3; Imaging; Jean-Philippe Gagnon; GROUP; DRAWN; CHECKED; PROJECT; ING#; TITLE; JPG; MATROX; +1.8V (VCCAUX); PyT VDD_PIX; 5/35mA (0.5A-pk) DS LDO; MGTAVCC; 0.146A LDO; LDO; MGTAVTT; 0.525A (w/o DDR2); FFC_5-12V; Input Rail; VCCINT; PyT VDD_18; +3.3V (VCCO_33); 0.100A est. LS; PyT VDD_33; FFC_3.3V

1055 BOUL. ST-REGIS
DORVAL, QUEBEC H9P 2T4

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

SIZE | DATE
