AM4511/test_migrate_iris4/athena/doc/iris3/Visio-iris3_drawings(bloc-diag2)(2).pdf

## MoBo Info

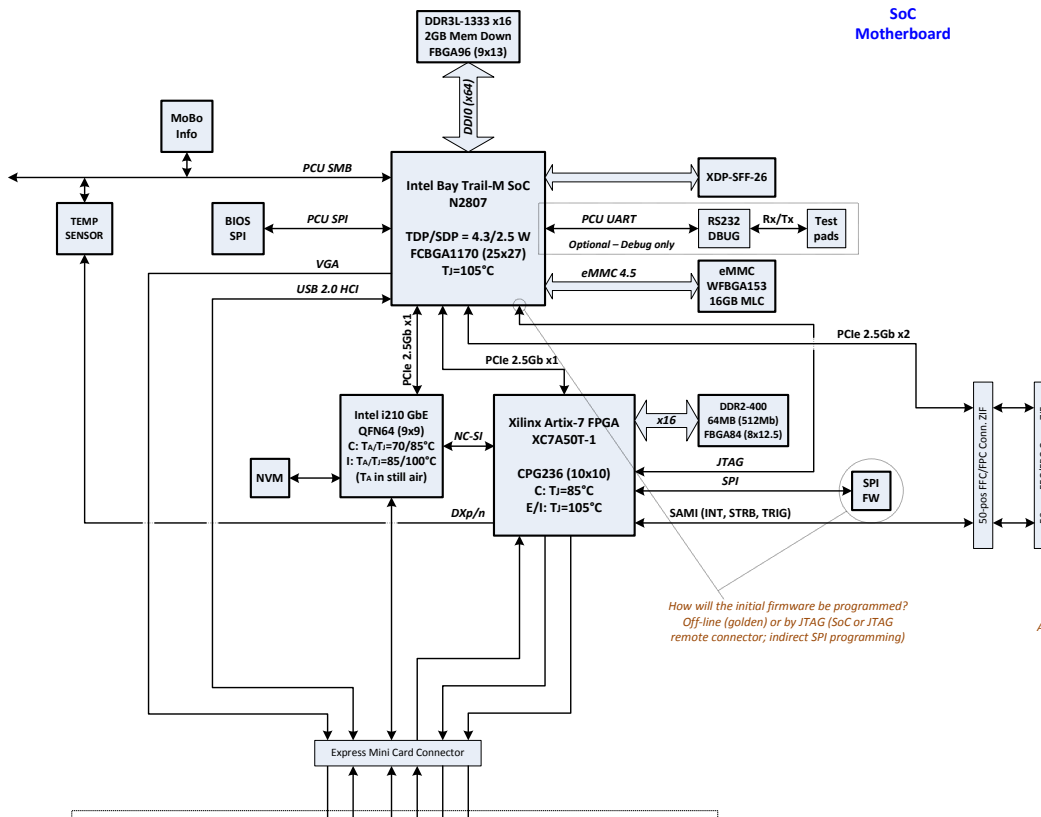
[picture p117: page 1]
TDP/SDP = 4.3/2.5 W FCBGA1170 (25x27) TJ=105°C; DDI0 (x64); eMMC WFBGA153 16GB MLC; BIOS SPI; PCU SPI; PCU SMB; CPG236 (10x10) C: TJ=85°C E/I: TJ=105°C; DDR2-400 64MB (512Mb) FBGA84 (8x12.5); eMMC 4.5; PCIe 2.5Gb x1 PCIe 2.5Gb x1; VGA; USB 2.0 HCI; DXp/n; TEMP SENSOR; XDP-SFF-26; PCIe 2.5Gb x2; SPI FW; JTAG; SPI; RS232 DBUG; DDR3L-1333 x16 2GB Mem Down FBGA96 (9x13); SoC Motherboard; Test; NVM; ZIF

Intel Bay Trail-M SoC

PCU UART
pads Optional – Debug only

Intel i210 GbE
QFN64 (9x9)
(TA in still air)

Xilinx Artix-7 FPGA

50-pos FFC/FPC Conn. ZIF

SAMI (INT, STRB, TRIG)

How will the initial firmware be programmed?
Off-line (golden) or by JTAG (SoC or JTAG
remote connector; indirect SPI programming)

Available when connecting PCIe test JIG

Express Mini Card Connector

For connecting to lens inside the IP cap.

## See Varioptic Caspian C-39N0-16-XX

(6-pin JST SHR-06V-S-B).

# Python Sensor Board

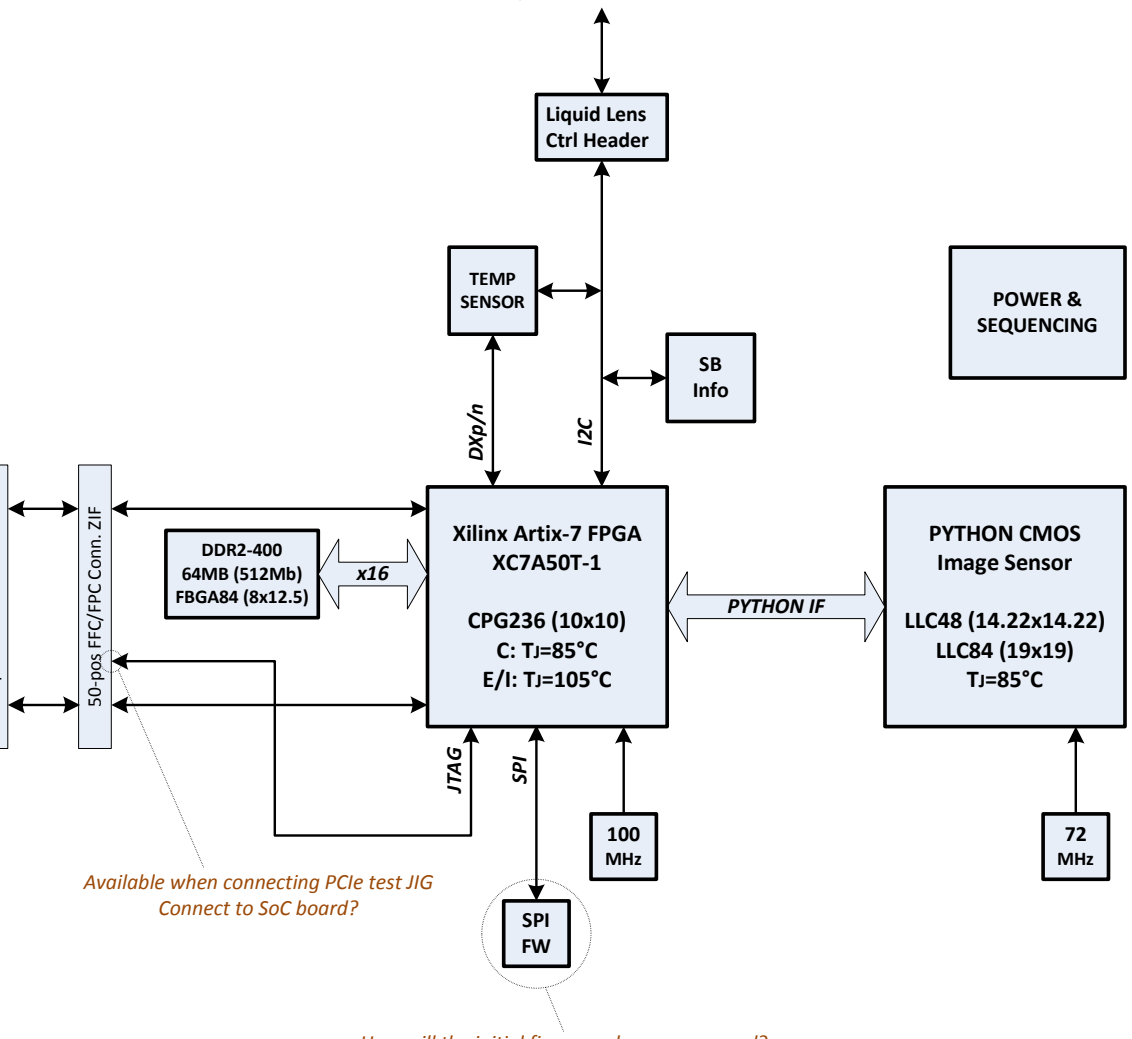
[picture p118: figure]
PYTHON CMOS Image Sensor; LLC48 (14.22x14.22) LLC84 (19x19) TJ=85°C; PYTHON IF; Xilinx Artix-7 FPGA XC7A50T-1; CPG236 (10x10) C: TJ=85°C E/I: TJ=105°C; SB Info; TEMP SENSOR; SPI FW; SPI; Liquid Lens Ctrl Header; JTAG; POWER & SEQUENCING; DXp/n; DDR2-400 64MB (512Mb) FBGA84 (8x12.5); 50-pos FFC/FPC Conn. ZIF; 72 MHz; 100 MHz; Available when connecting PCIe test JIG Connect to SoC board?

## How will the initial firmware be programmed? Off-line (golden) or through JTAG remote connector (indirect SPI programming)

D D R3L -1 333 x16 | S o C | P yth o n

## GbE XFMR ESD

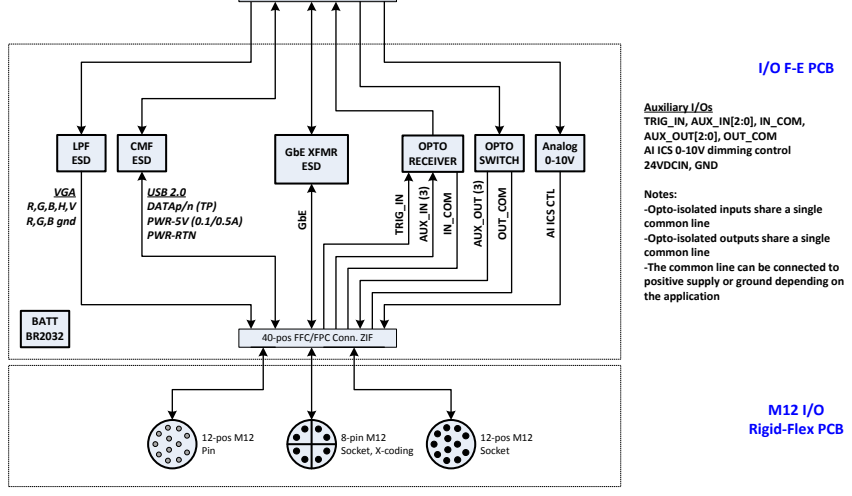
[picture p119: page 3]
OPTO RECEIVER; OPTO SWITCH; AUX_IN (3); AUX_OUT (3); 12-pos M12 Pin; 8-pin M12 Socket, X-coding; 12-pos M12 Socket; VGA R,G,B,H,V R,G,B gnd; USB 2.0 DATAp/n (TP) PWR-5V (0.1/0.5A) PWR-RTN; GbE; Analog 0-10V; TRIG_IN; Auxiliary I/Os TRIG_IN, AUX_IN[2:0], IN_COM, AUX_OUT[2:0], OUT_COM AI ICS 0-10V dimming control 24VDCIN, GND; IN_COM; OUT_COM; CMF ESD; LPF ESD; I/O F-E PCB; BATT BR2032

AI ICS CTL

Notes:
-Opto-isolated inputs share a single
common line
-Opto-isolated outputs share a single
-The common line can be connected to
positive supply or ground depending on
the application

40-pos FFC/FPC Conn. ZIF

Rigid-Flex PCB

## S o C M o th e rb o ard

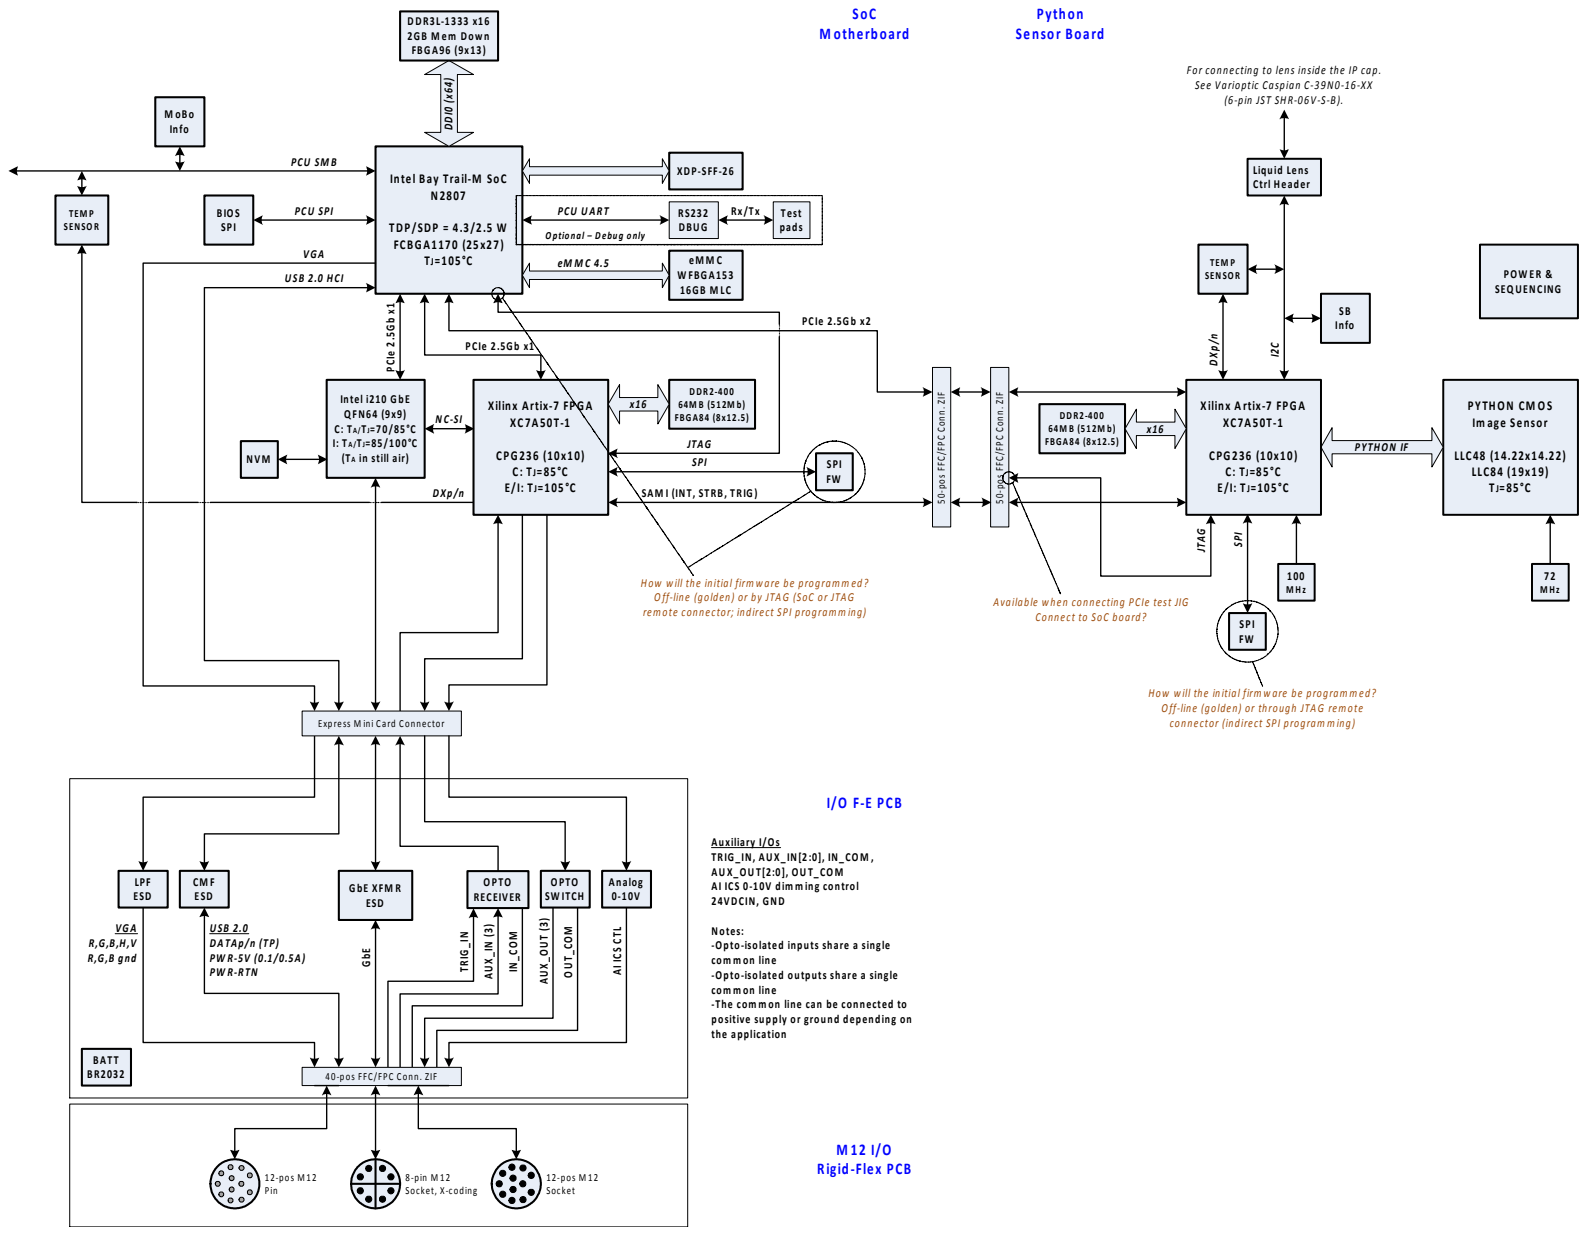
[picture p120: page 4]
In te l i210 G b E Q F N 6 4 (9x 9) C : T A /TJ= 70 /85 °C I: T A /TJ= 85 /10 0 °C (T A in still a ir); M 1 2 I/ O R igid -Fle x P C B; LLC 4 8 (1 4 .2 2x 1 4 .2 2 ) LLC 8 4 (1 9x 1 9 ) T J= 8 5 °C; S B Info; 4 0 -p o s F F C /F P C C o n n. ZIF

P yth o n

Fo r co n n ectin g to len s in sid e th e IP ca p .
See V a rio ptic C a sp ia n C -39 N 0 -16 -X X
(6 -p in JST SH R-0 6V -S-B ).

In te l B ay Tra il-M S o C

Liqu id Le n s
C trl H e a d e r

pa d s O p tio n al – D e bu g o nly

X ilin x A rtix-7 FP G A

X ilin x A rtix -7 FP G A

H ow w ill th e in itia l firm w a re b e p ro g ra m m ed ?
O ff-lin e (g o ld en ) or by JTA G (SoC o r JTA G
rem o te c on n ec to r; in d irect SP I p ro g ra m m in g)

A v a ila b le w h en co n ne ctin g P C Ie tes t JIG

H o w w ill th e in itia l firm w are b e p ro g ra m m ed ?
O ff-line (g o lde n) or th ro ug h JTA G rem o te
co n n ector (in d ire ct SP I p rog ra m m in g )

E xp re ss M in i C a rd C o nn ec tor

A u xiliary I/O s
A I IC S 0 -1 0V d im m in g co n tro l

R EC EIV ER

-O p to -iso late d inp u ts sh a re a sin g le
co m m on lin e
-O p to -iso late d o u tp uts sh are a sing le
-T he c om m on line ca n be co n n e cte d to
p o sitiv e su p p ly o r g ro u n d d e p e n d in g on
th e a p plica tion

S oc k et, X -c o din g
