AM4511/test_migrate_iris4/athena/doc/IOTG_2019/2H’19 IOTG Product & Technology Summit - Agenda.pdf

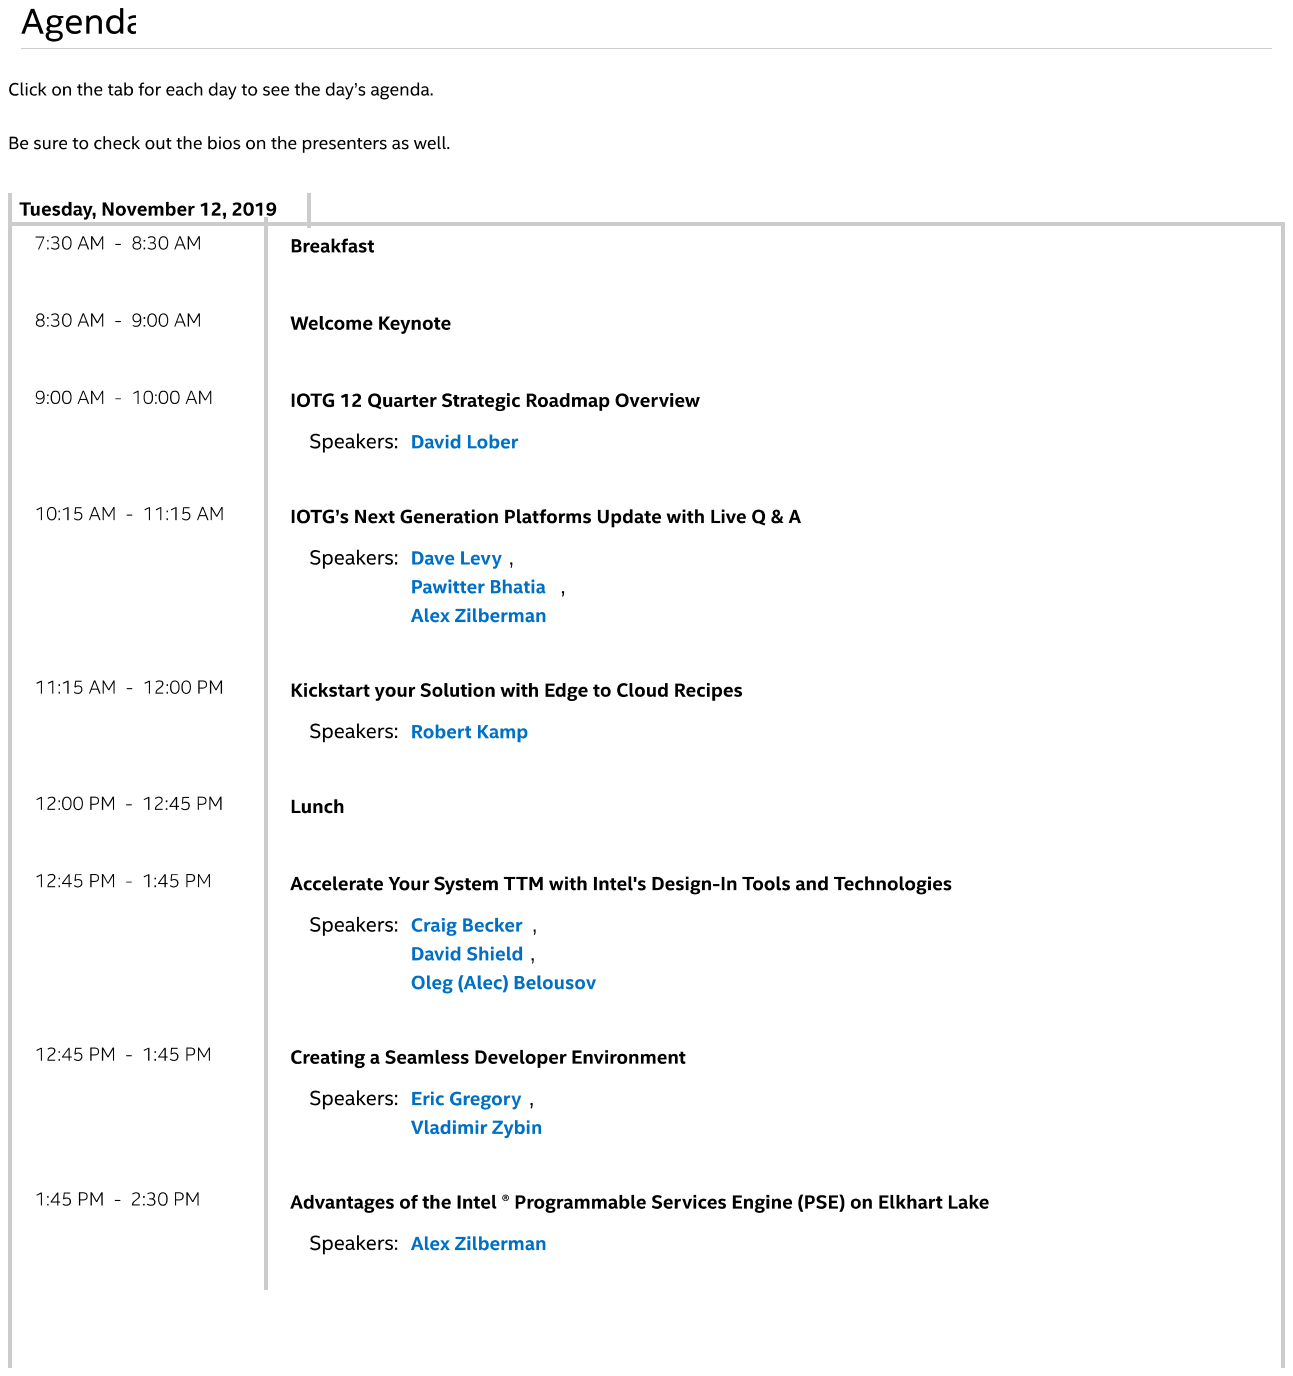
[picture p121: page 1]

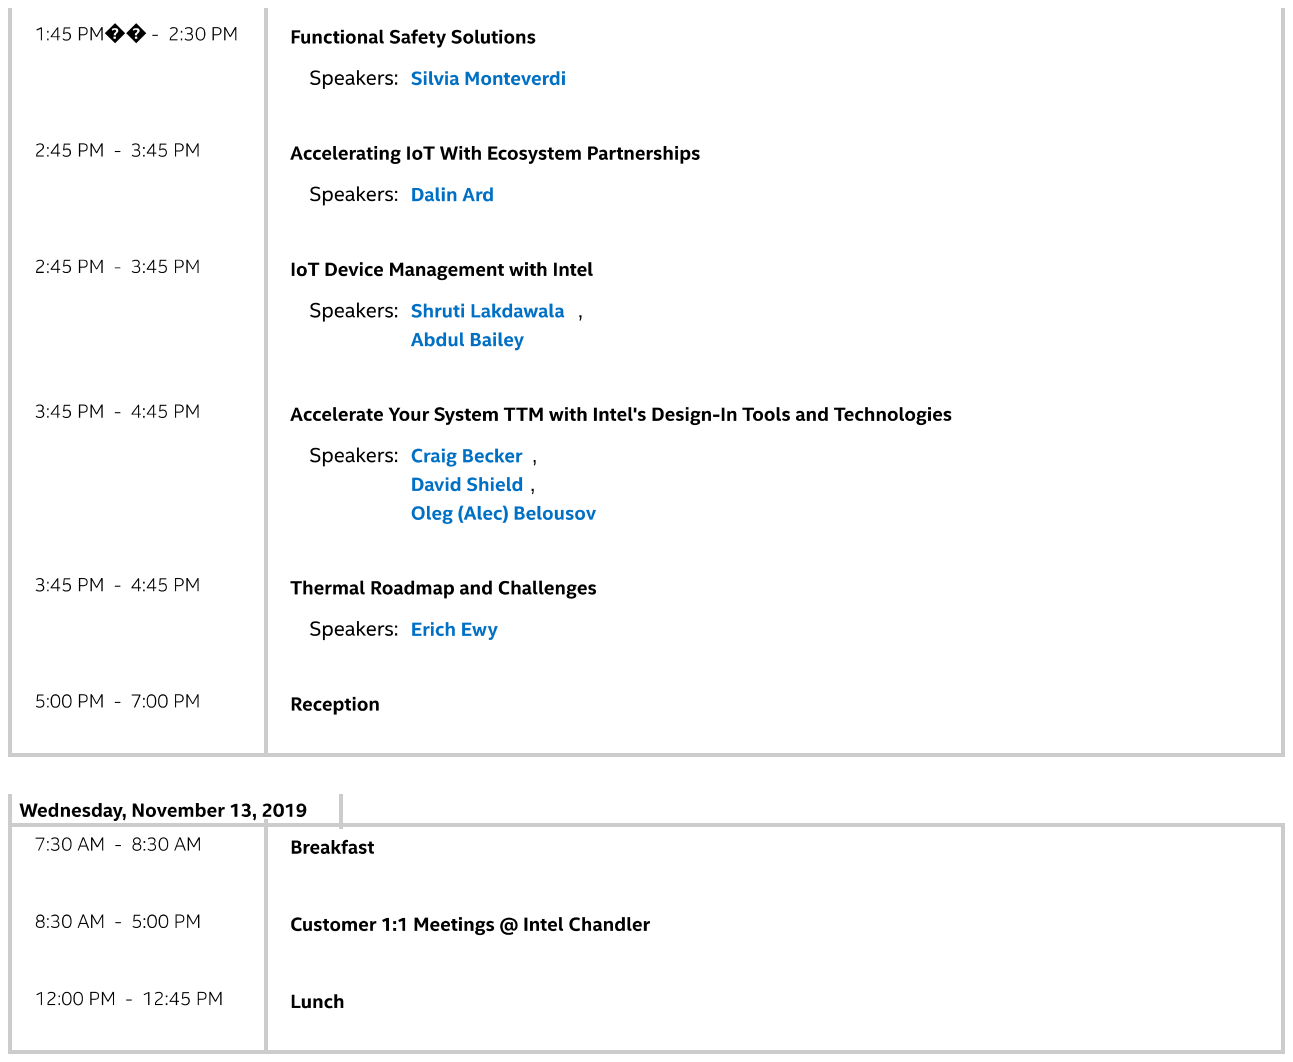
[picture p122: page 2]
