AM4511/test_migrate_iris4/athena/doc/IOTG_2019/Day2_2H’19 IOTG Product & Technology Summit - Agenda.pdf

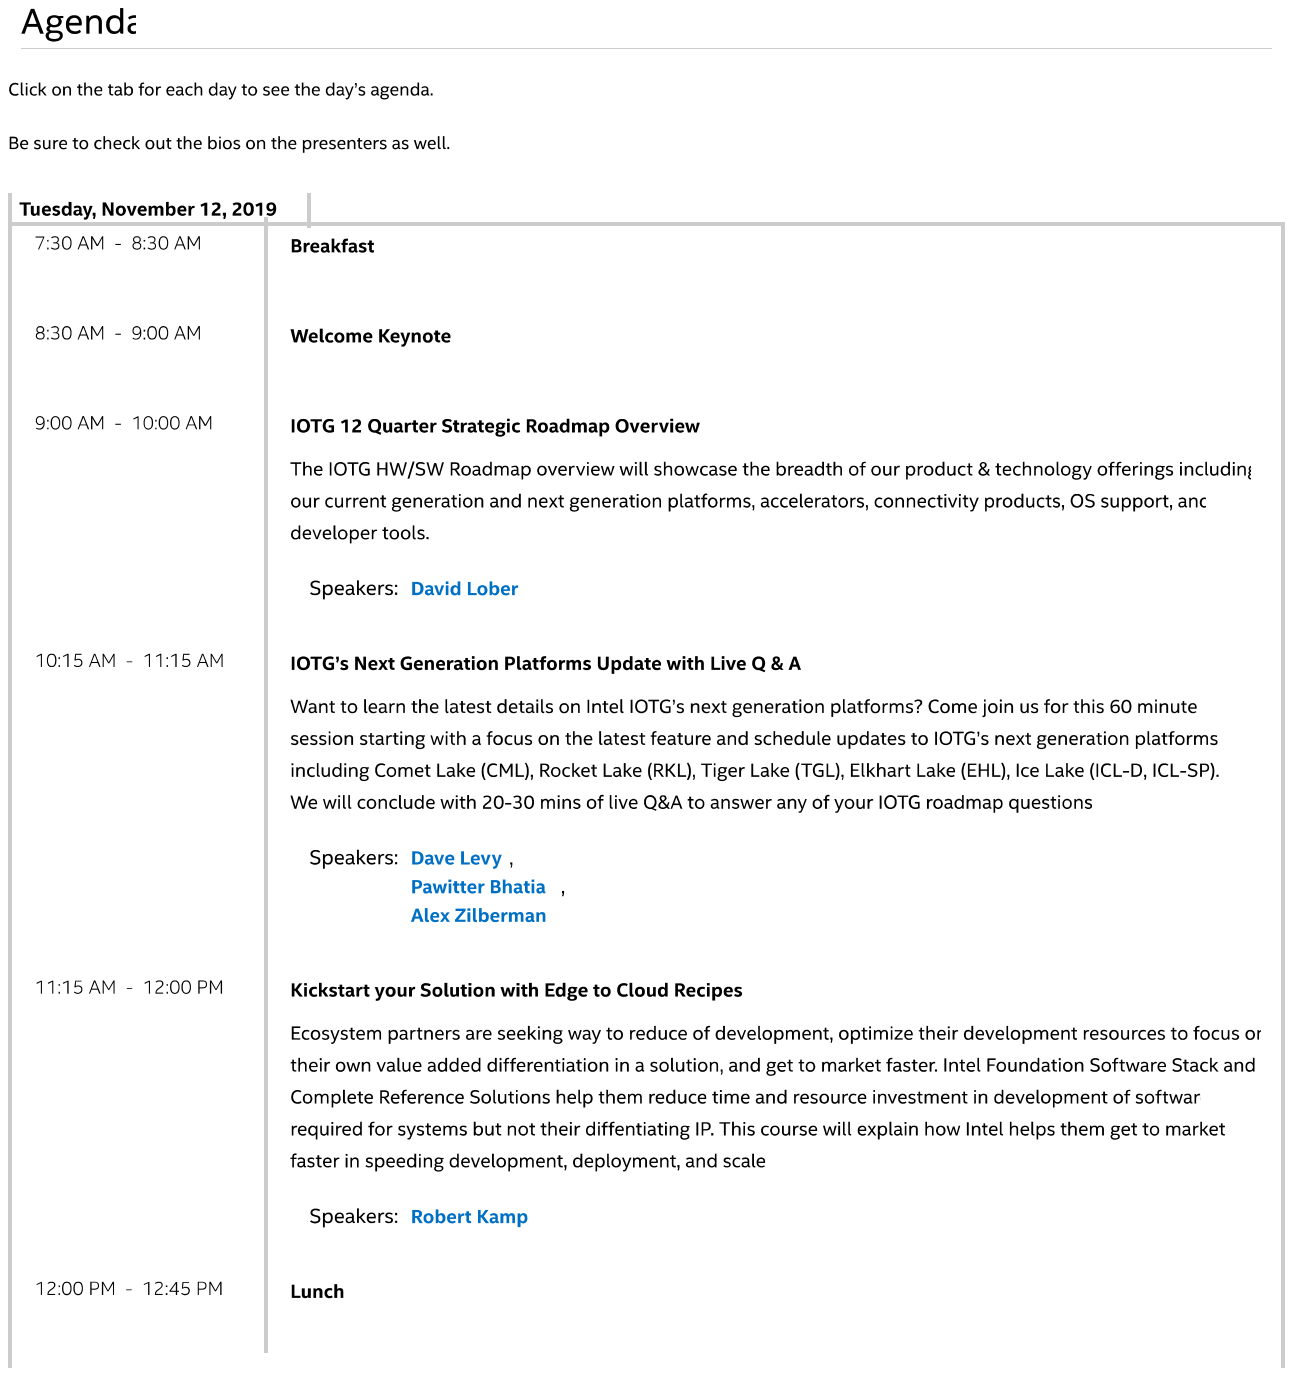
[picture p123: page 1]

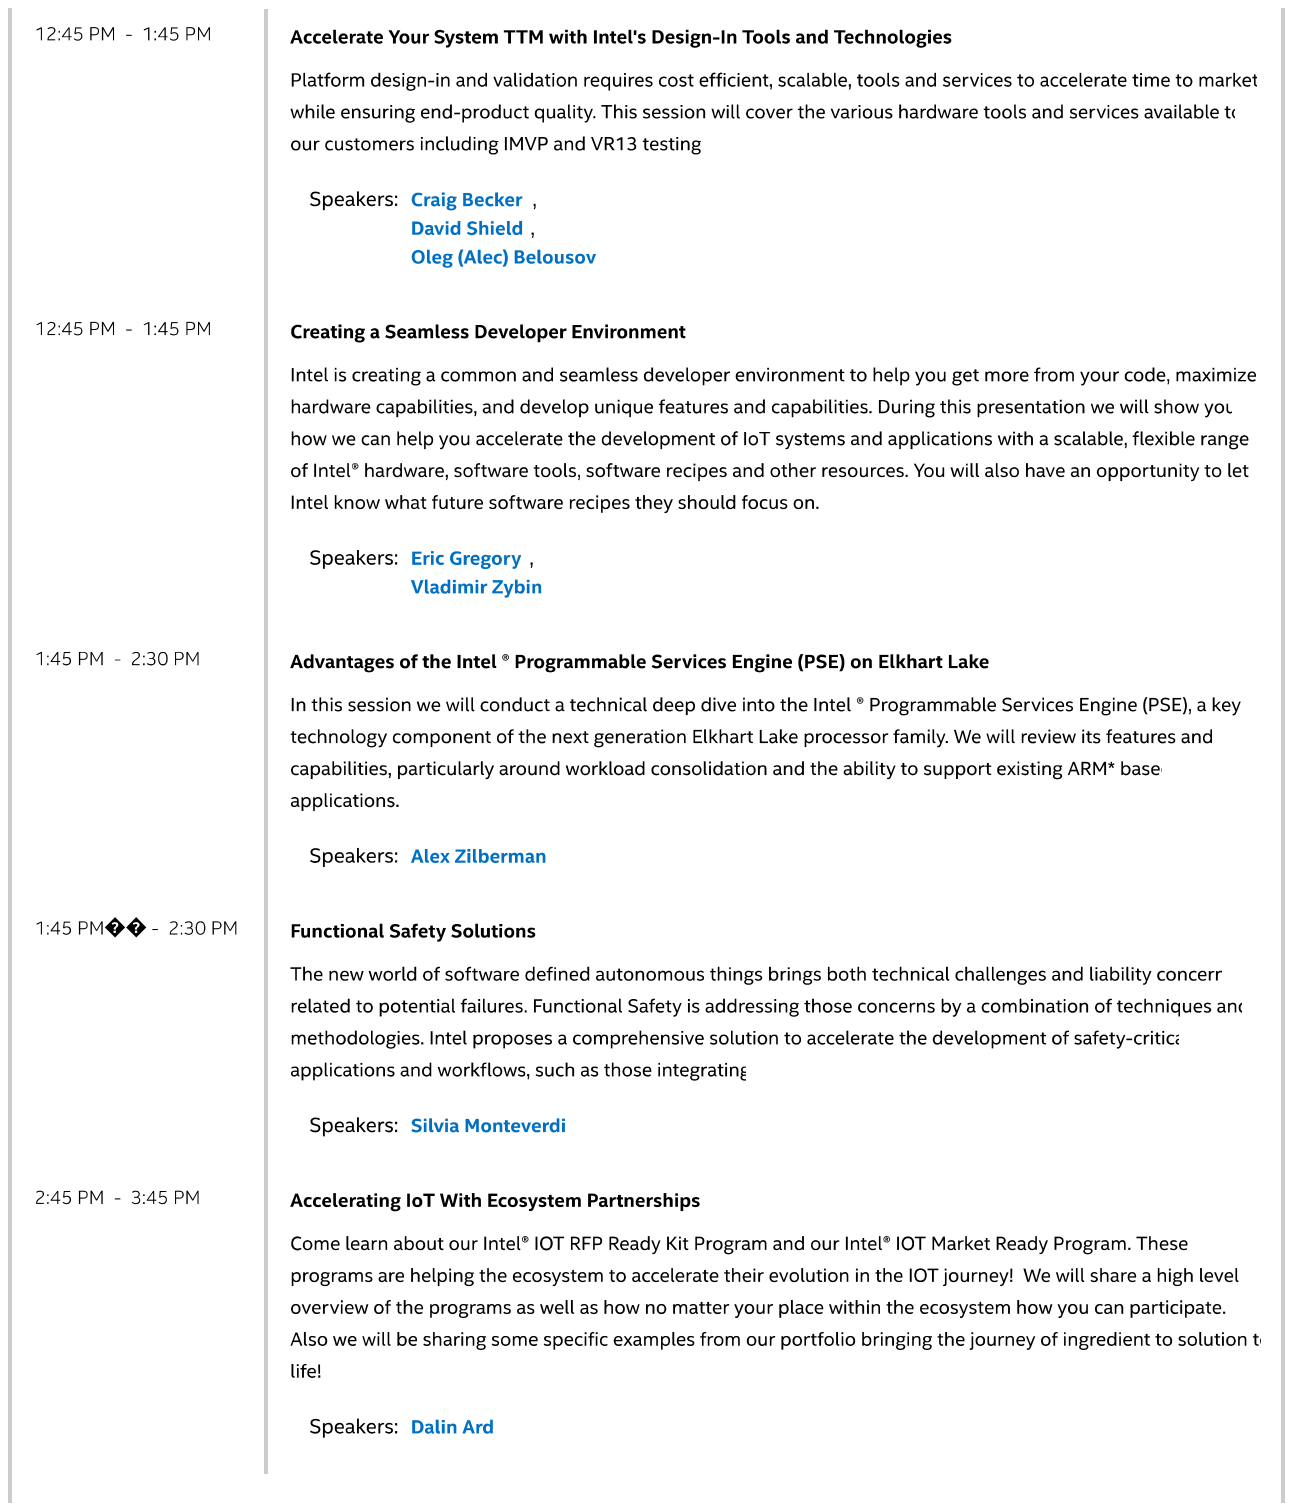
[picture p124: page 2]

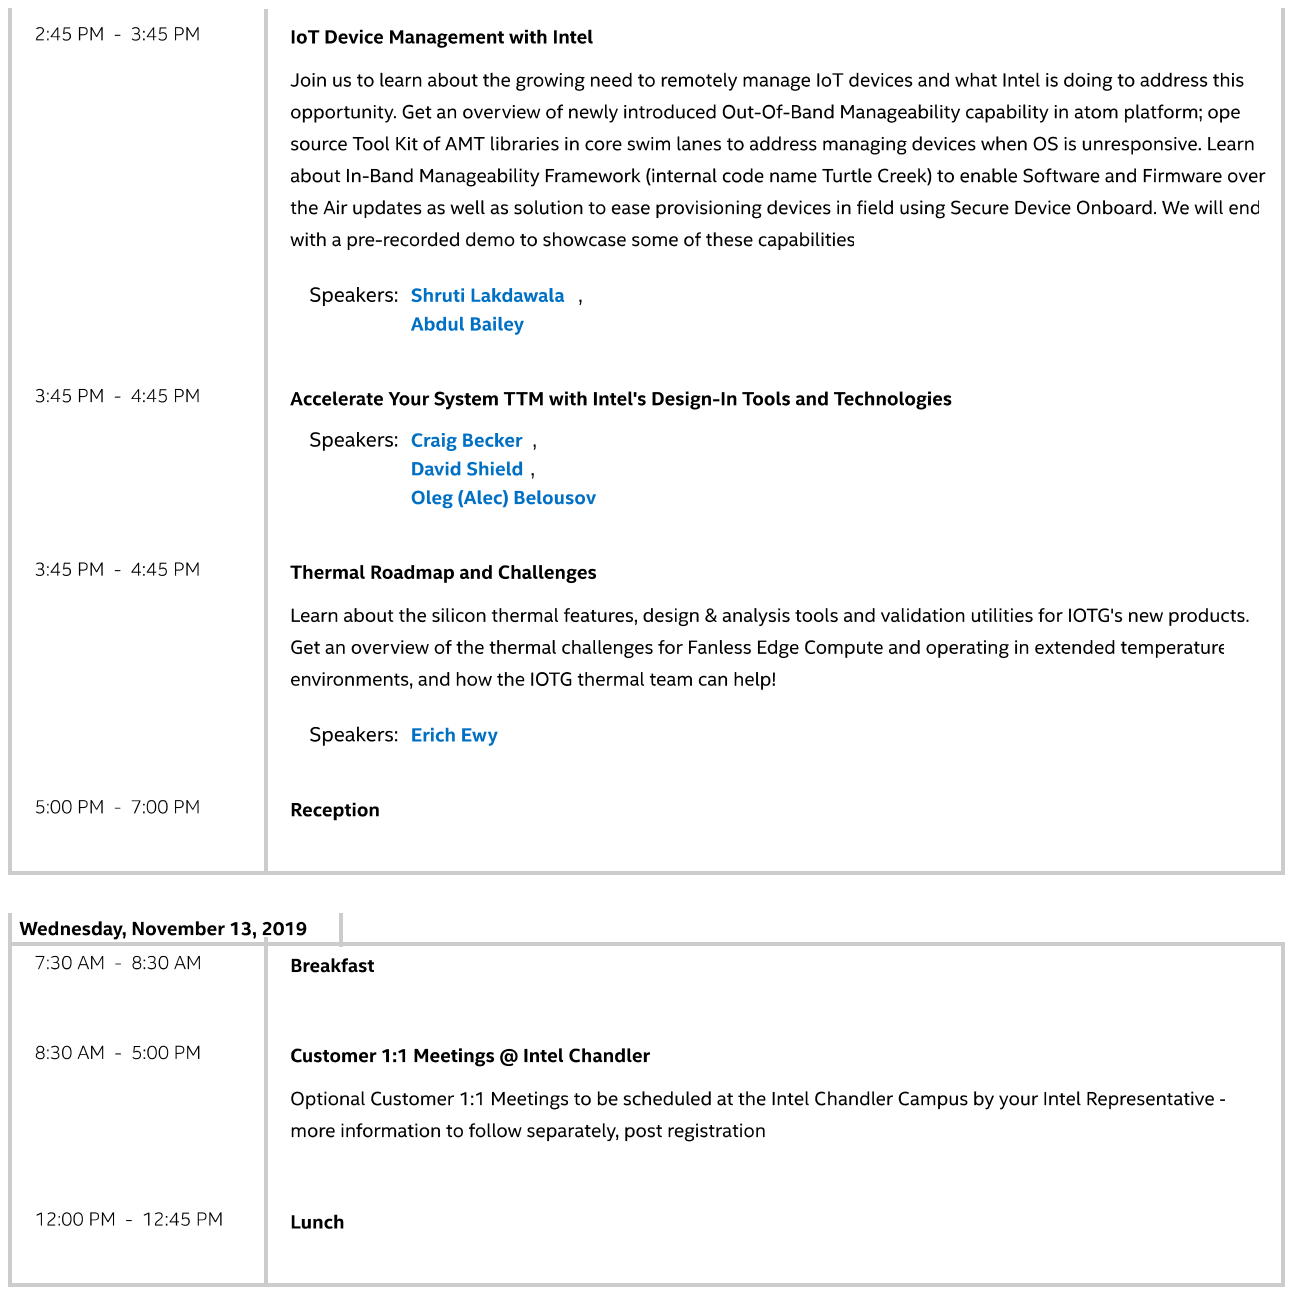
[picture p125: page 3]
