AM4511/test_migrate_iris4/athena/doc/IOTG_2019/Full_2H’19 IOTG Product & Technology Summit - Agenda.pdf

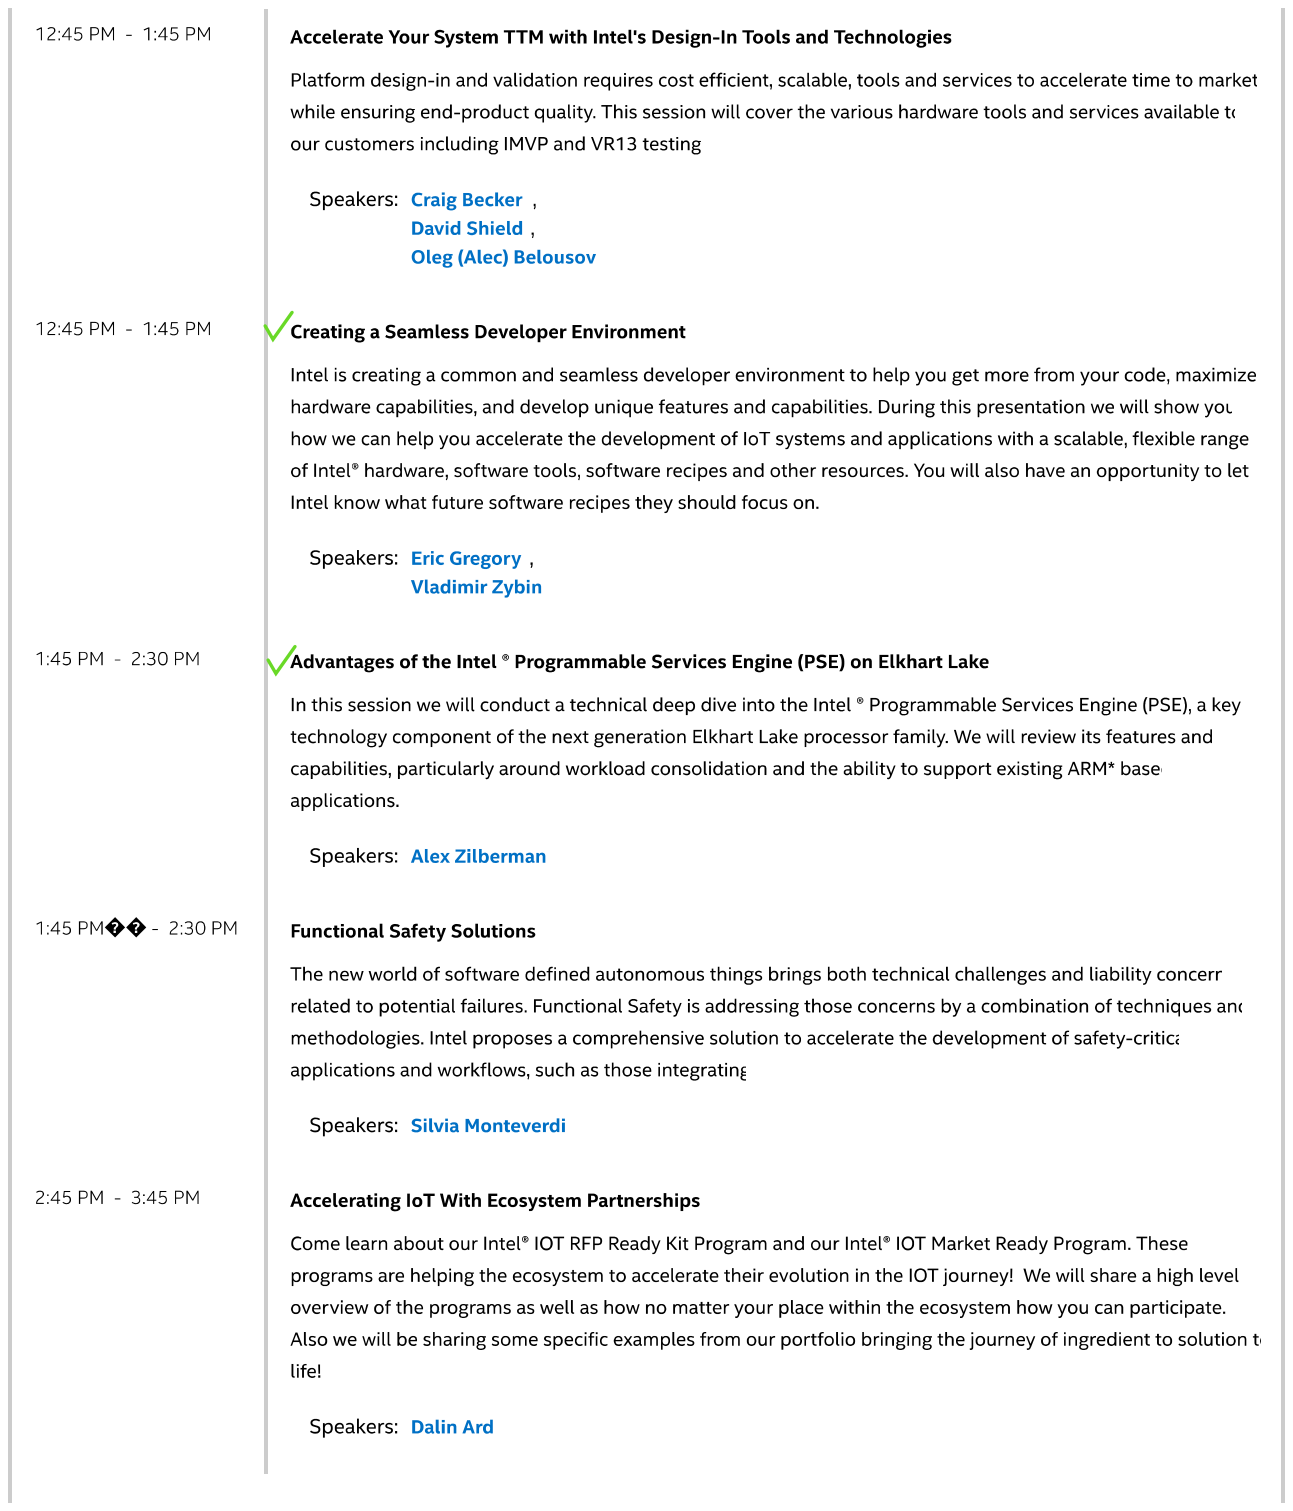
[picture p126: page 2]

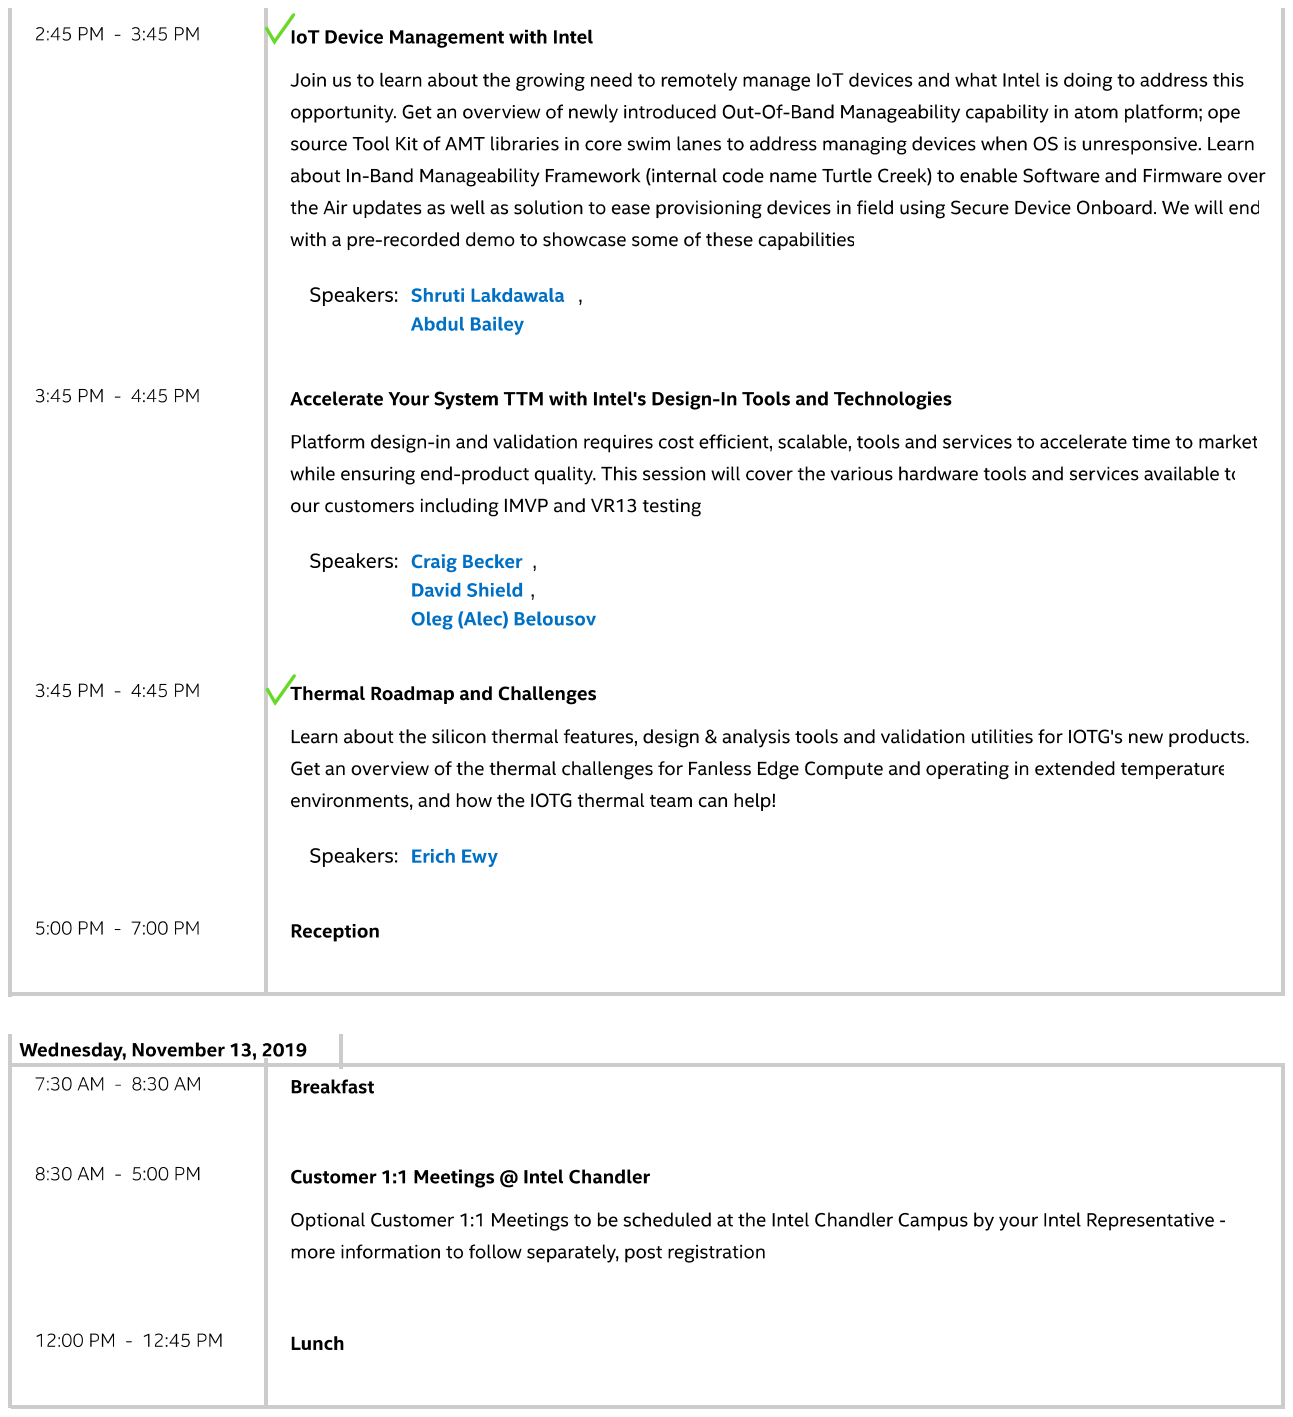
[picture p127: page 3]
