AM4511/test_migrate_iris4/athena/doc/IOTG_2019/tmp.pdf

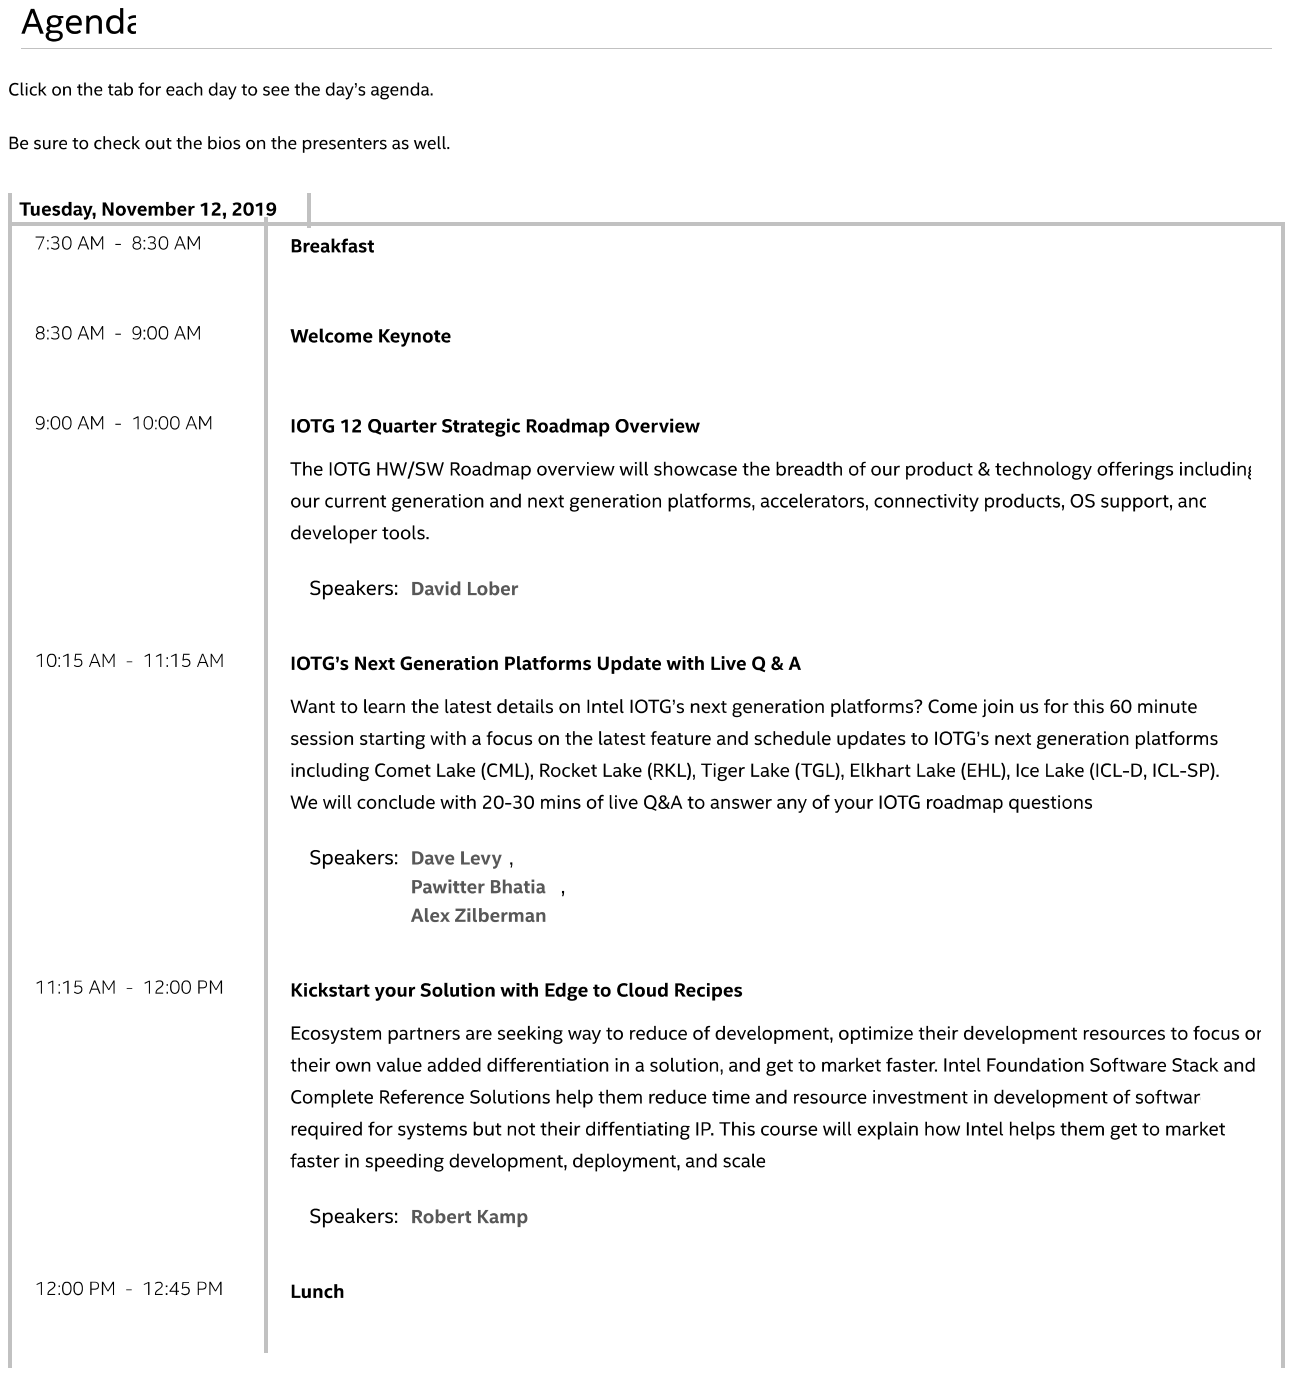
[picture p128: page 1]

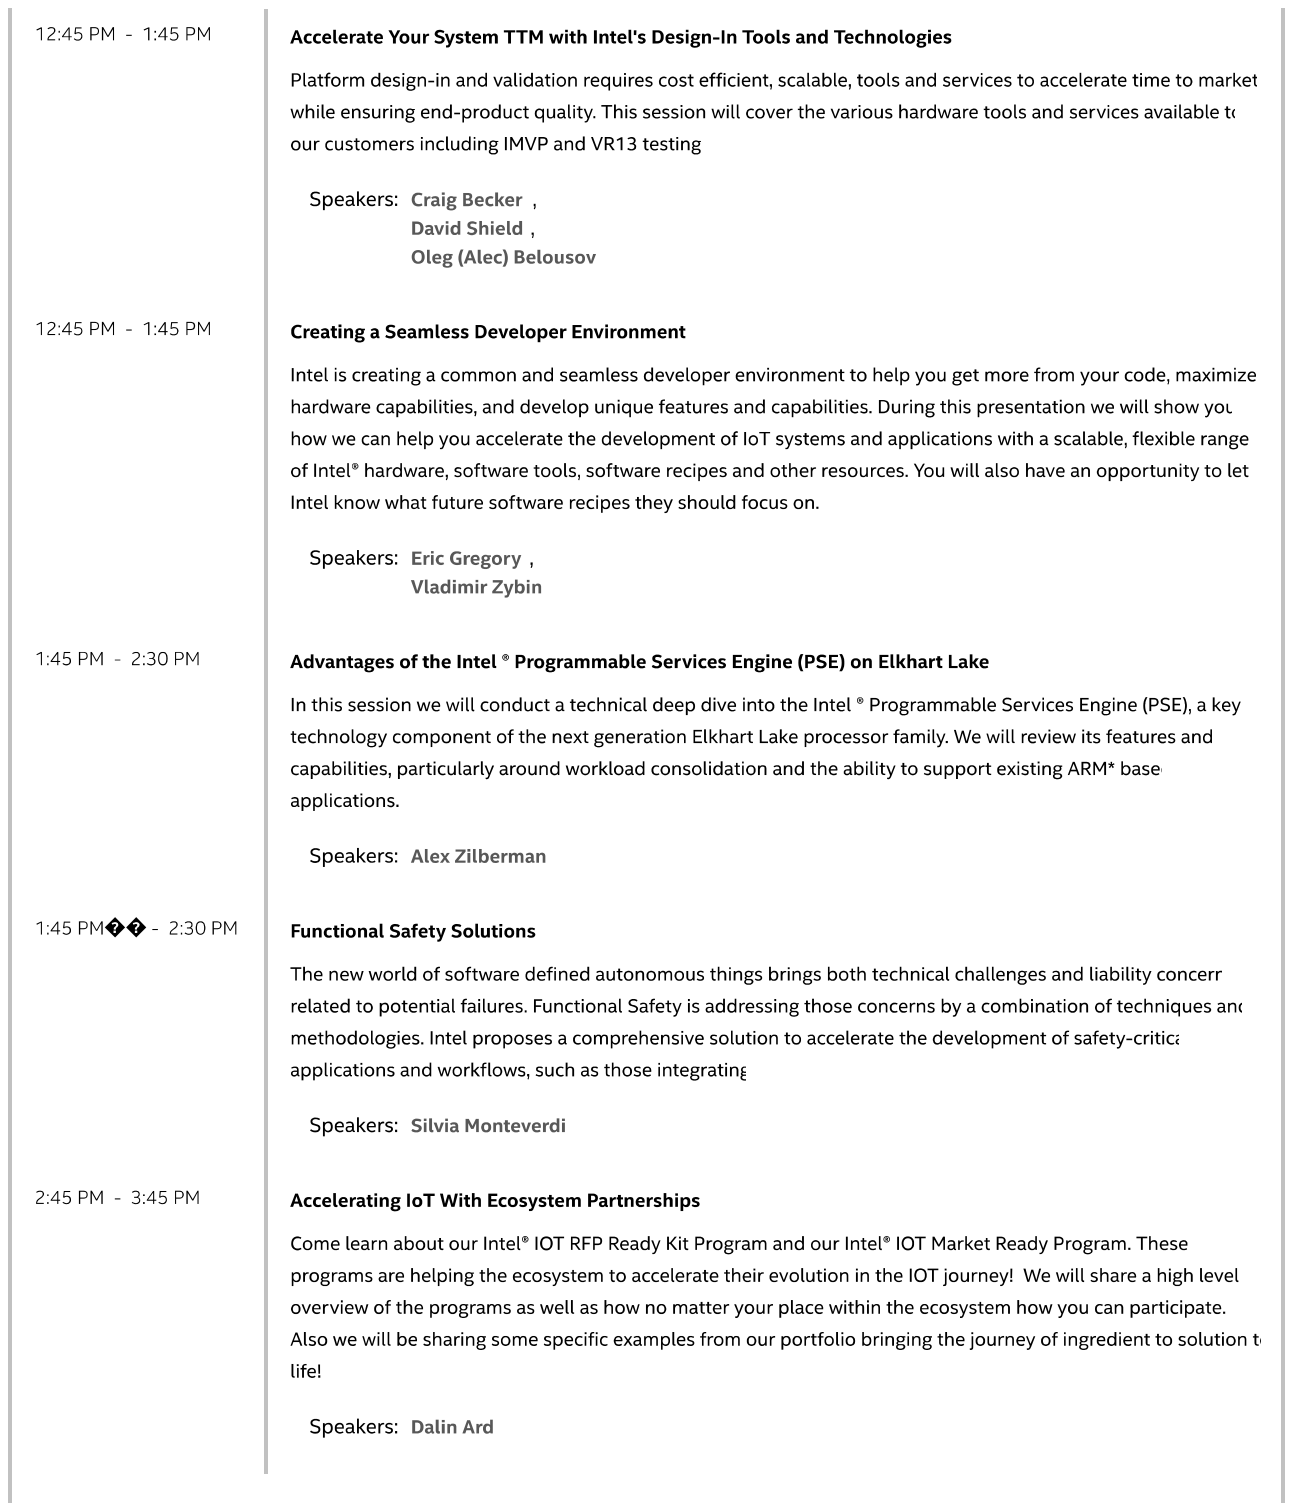
[picture p129: page 2]

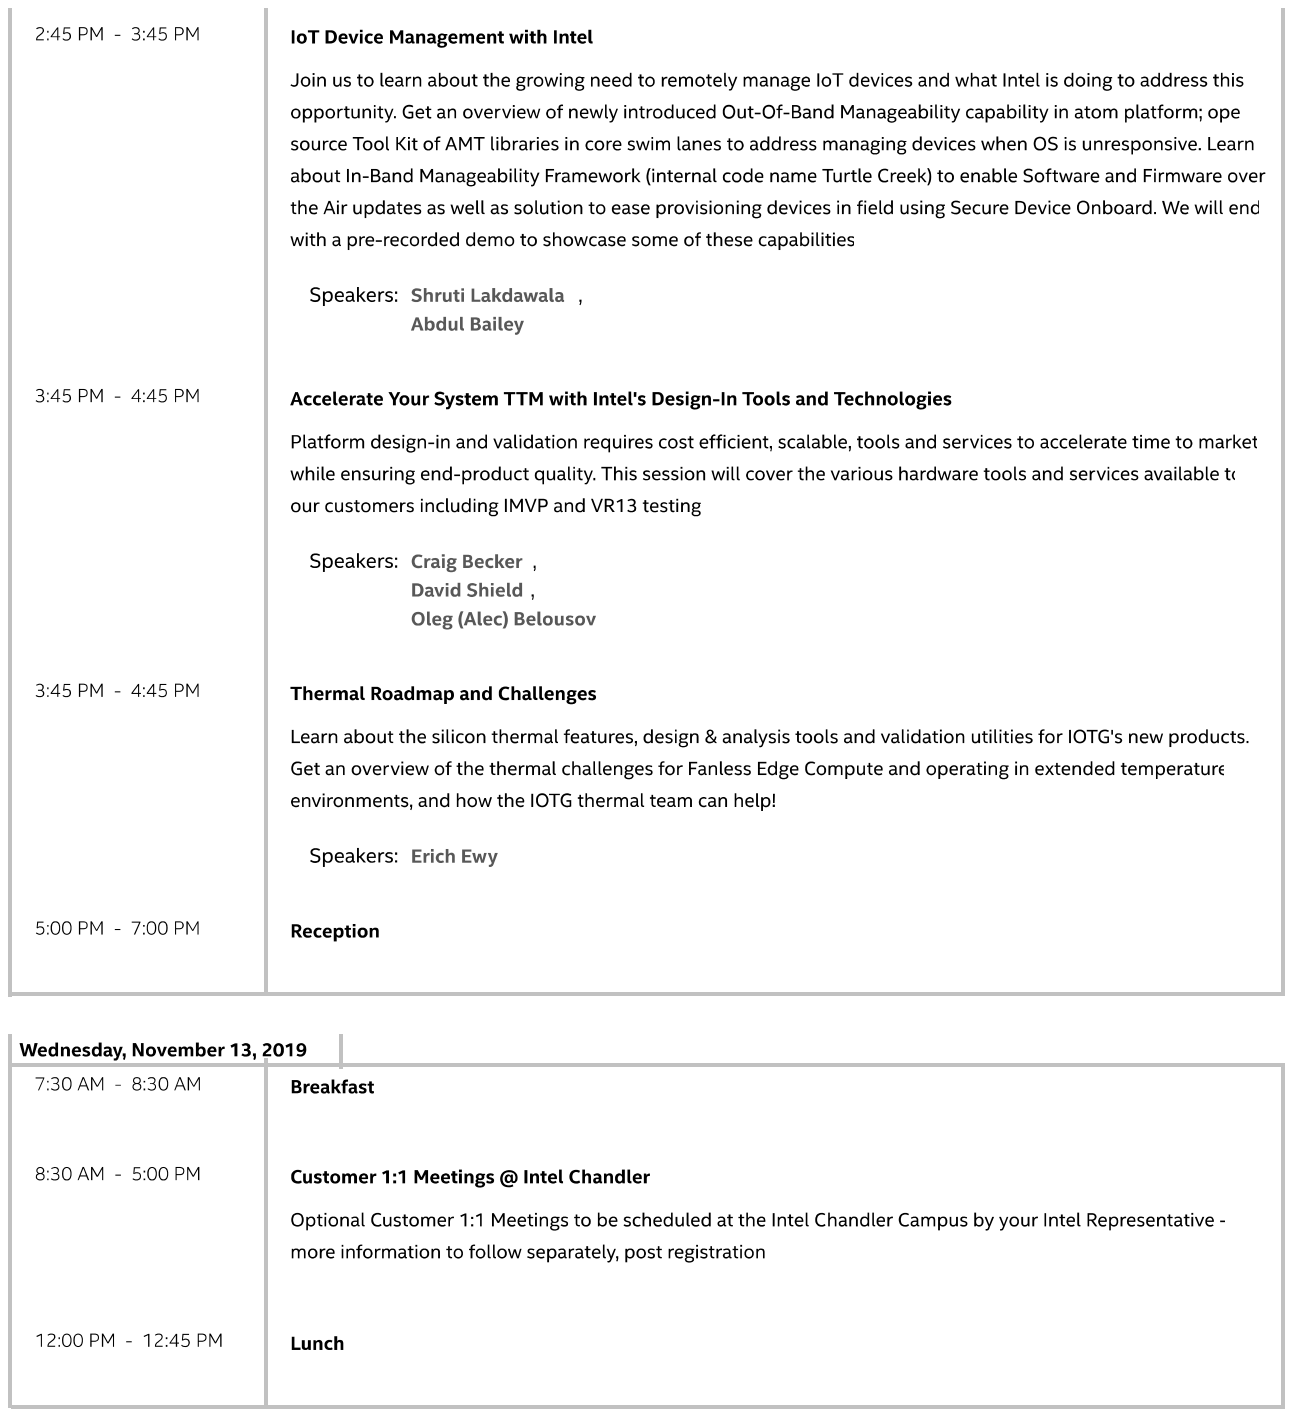
[picture p130: page 3]
