AM4511/test_migrate_iris4/athena/bench/Visual_Studio/Iris4_Camera/source/XGS_Ctrl.cpp

//
//

#define _CRT_SECURE_NO_DEPRECATE

#include "osincludes.h"

#include <string>
using std::string;

#include "XGS_Ctrl.h"

#include "mtxservmanager.h"

#include <iostream>

#include <algorithm>
#include <vector>
using namespace std;


CXGS_Ctrl::CXGS_Ctrl(volatile FPGA_REGFILE_XGS_ATHENA_TYPE& i_rXGSptr, double setSysPerFs, double setSensorPerFs, volatile FPGA_REGFILE_I2C_TYPE& i_rI2Cptr) :
	rXGSptr(i_rXGSptr),
    rI2Cptr(i_rI2Cptr)
{

	SystemPeriodNanoSecond = setSysPerFs;
	SensorPeriodNanoSecond = setSensorPerFs;

	memset(&sXGSptr, 0, sizeof(sXGSptr));
	memcpy(&sXGSptr, (const void*)& rXGSptr, sizeof(sXGSptr));

	CurrExposure = 8000;

	//------------------------------------
    // GrabParams
    //------------------------------------
	GrabParams = {
		0,              //TRIGGER_OVERLAP_BUFFn
		1,              //TRIGGER OVERLAP 
		TRIGGER_SRC::NONE,           //TRIGGER_SOURCE;
		TRIGGER_ACT::RISING,         //TRIGGER_ACTIVATION;
		LEVEL_EXP_MODE::EXP_TIMED_MODE, //EXPOSURE_LEV_MODE;

		0x4c4b4,       //ExposureSS, 5us
		0x0,           //ExposureDS,
		0x0,           //ExposureTS,

		0x0,           //TRIGGER_DELAY;

		0x0,           //STROBE_E;
		0x0,           //STROBE_MODE;
		0x0,           //STROBE_START;
		0xfffffff,     //STROBE_END;

		0,             //Y_START
		480,           //Y_END	
		480,           //Y_SIZE	

		0,             //roi2 Y_START
		480,           //roi2 Y_END	
		480,           //roi2 Y_SIZE	

		0x100,         //DataPedestal (pour l'instant je le mets pareils pour tous les pixels Gr+Gb+R+B)

		0x0 ,          //ANALOG GAIN
 

		0,             //MONO10

        0,             //M_SUBSAMPLING_Y;
	    0,             //ACTIVE_SUBSAMPLING_Y;

	    0,             //FOT;

	    0,             //XSM_DELAY;

		0,             //XGS_LINE_SIZE_FACTOR;

	};

	//------------------------------------
	// SensorParams
	//------------------------------------
	SensorParams = {

		0,             //Sensor Type
		0,             //IS_COLOR
		24,            //XGSmax HISPI channels 
	    6,             //XGS_HiSPI_Ch_used;
	    4,             //XGS_HiSPI_mux;  (static register for the moment)
		2,             //default is 2 (4 line buffers)

		36,            // XGS_Start;
	    4131,          // XGS_End;
	    4176,          // XGS_X_Size;
		3102,          // XGS_Y_Size;      

		1280,          //Xsize_Full
		1280,          //Xsize_Full_valid;
		4,             //Xstart_valid
		1024,          //Ysize_Full
		1024,          //Ysize_Full_valid;
		4,             //Ystart_valid
		1280,          //Xsize_BL;

		0,             //BL_LINES;
		0,             //EXP_DUMMY_LINES;

		0,             //Trig_2_EXP
        0,             //ReadOutN_2_TrigN, in ns
        0,             //TrigN_2_FOT, in ns
		0,             //EXP_FOT;
		0,	           //EXP_FOT_TIME;      // in ns (Total)
		0xffff,        //KEEP_OUT_ZONE_START


	};




}



CXGS_Ctrl::~CXGS_Ctrl()
{


}


GrabParamStruct* CXGS_Ctrl::getGrabParams(void)
{
	return &GrabParams;
}

SensorParamStruct* CXGS_Ctrl::getSensorParams(void)
{
	return &SensorParams;
}




//volatile FPGA_REGFILE_XGS_CTRL_TYPE* CXGS_Ctrl::getRegisterXGS_Ctrl(void)
//{
//	return rXGSptr;
//}




//------------------------------------------------------------------------------------
// XGS SPI WRITE  
//------------------------------------------------------------------------------------
void CXGS_Ctrl::WriteSPI(M_UINT32 address, M_UINT32 data)
{

	sXGSptr.ACQ.ACQ_SER_ADDATA.u32 = (address & 0x7fff) + ((data & 0xffff) << 16);
	rXGSptr.ACQ.ACQ_SER_ADDATA.u32 = sXGSptr.ACQ.ACQ_SER_ADDATA.u32;              // Set address and data to write in sensor

	sXGSptr.ACQ.ACQ_SER_CTRL.f.SER_CMD   = 0x0;                                   // Sensor access type
	sXGSptr.ACQ.ACQ_SER_CTRL.f.SER_RWN   = 0x0;                                   // Write access  
	sXGSptr.ACQ.ACQ_SER_CTRL.f.SER_WF_SS = 0x1;                                   // Write the command to the queue fifo
	rXGSptr.ACQ.ACQ_SER_CTRL.u32         = sXGSptr.ACQ.ACQ_SER_CTRL.u32;
	sXGSptr.ACQ.ACQ_SER_CTRL.f.SER_WF_SS = 0x0;                                   // WO register 

	sXGSptr.ACQ.ACQ_SER_CTRL.f.SER_RF_SS = 0x1;                                   // Start the queue command
	rXGSptr.ACQ.ACQ_SER_CTRL.u32         = sXGSptr.ACQ.ACQ_SER_CTRL.u32;
	sXGSptr.ACQ.ACQ_SER_CTRL.f.SER_RF_SS = 0x0;


	while (rXGSptr.ACQ.ACQ_SER_STAT.f.SER_BUSY == 0x1);                          // Loop wait for the access end

}


//------------------------------------------------------------------------------------
// XGS SPI WRITE BURST 
//------------------------------------------------------------------------------------
void CXGS_Ctrl::WriteSPI_BURST(const M_UINT32 table[], int NbElements)
{
	int i;
	M_UINT32 add;
	M_UINT32 data;
	printf_s("   SPI WRITE BURST : ");
	for (i = 0; i < (NbElements - 1); i++)
	{
		add = table[0] + (i * 2);
		data = table[i + 1];
		WriteSPI(add, data);
		//printf_s("\nSPI WRITE BURST : number=%d add=0x%X data=0x%X", i, add, data);
	}
	//printf_s("\n");
	printf_s("\r   SPI WRITE BURST : total writes=%d\n", i);

}




//------------------------------------------------------------------------------------
// XGS SPI WRITE BIT : This function write one bit of the serial register 
// Bit2Write : is the location to write (bit is 0 based)
//------------------------------------------------------------------------------------
void CXGS_Ctrl::WriteSPI_Bit(M_UINT32 address, M_UINT32 Bit2Write, M_UINT32 data)
{
	// Make mask
	M_UINT32 mask = 0;

	mask = mask | (1 << Bit2Write);

	M_UINT32 notmask = 65535 - mask; // 0xffff = 65535

	// Read back what is in this register
	M_UINT32 CurrentValue = ReadSPI(address);

	// Bit-wise operations using the mask to get the new value
	M_UINT32 ShiftedValue = (data << Bit2Write);
	M_UINT32 NewValue = (CurrentValue & notmask) | (ShiftedValue & mask);
	// Upload new value
	WriteSPI(address, NewValue);

	Sleep(1);

	//Verify wrote data 
	M_UINT32 verify = ReadSPI(address);
	Sleep(1);
	if (verify != NewValue) {
		printf_s("\n\nSPI VERIFY FAIL\n\n\n");
		printf_s("Press enter to exit!!!\n\n");
		getch_return = _getch();
		exit(1);
	}

};


//----------------------------------------------------
// XGS SPI READ
//----------------------------------------------------
M_UINT32 CXGS_Ctrl::ReadSPI(M_UINT32 address)
{


	sXGSptr.ACQ.ACQ_SER_ADDATA.u32 = (address & 0x7fff);
	rXGSptr.ACQ.ACQ_SER_ADDATA.u32 = sXGSptr.ACQ.ACQ_SER_ADDATA.u32;               // Set address and data to write in sensor

	sXGSptr.ACQ.ACQ_SER_CTRL.f.SER_CMD   = 0x0;             // Sensor access type
	sXGSptr.ACQ.ACQ_SER_CTRL.f.SER_RWN   = 0x1;             // Read access  
	sXGSptr.ACQ.ACQ_SER_CTRL.f.SER_WF_SS = 0x1;             // Write the command to the queue fifo
	rXGSptr.ACQ.ACQ_SER_CTRL.u32 = sXGSptr.ACQ.ACQ_SER_CTRL.u32;
	sXGSptr.ACQ.ACQ_SER_CTRL.f.SER_WF_SS = 0x0;          // WO register 

	sXGSptr.ACQ.ACQ_SER_CTRL.f.SER_RF_SS = 0x1;          // Start the queue command
	rXGSptr.ACQ.ACQ_SER_CTRL.u32         = sXGSptr.ACQ.ACQ_SER_CTRL.u32;
	sXGSptr.ACQ.ACQ_SER_CTRL.f.SER_RF_SS = 0x0;          // WO register

	while (rXGSptr.ACQ.ACQ_SER_STAT.f.SER_BUSY == 0x1); // Loop wait for the access end

	return ((rXGSptr.ACQ.ACQ_SER_STAT.u32) & 0xffff);    // Return the read value

}


//----------------------------------------------------------
// This function polls one register
//----------------------------------------------------------
void CXGS_Ctrl::PollRegSPI(M_UINT32 address, M_UINT32 maskN, M_UINT32 Data2Poll, M_UINT32 Delay, M_UINT32 TimeOut)
{
	M_UINT32 DataRead = 0x0;
	M_UINT32 nb_iter  = 0x0;

	DataRead = ReadSPI(address);

	while ( (DataRead & maskN) != Data2Poll)
	{
		Sleep(Delay);
		DataRead = ReadSPI(address);
		nb_iter++;

		if (nb_iter > TimeOut)
		{
			printf_s("CXGS_Ctrl::PollReg :  nombre maximum de polling atteint dans la fonction de polling du XGS controller! EXIT");
			printf_s("Press enter to exit!!!\n\n");
			getch_return = _getch();

			exit(1);

		}
	}
	printf_s("XGS polling @ add =0x%X, received data 0x%X\n", address, DataRead);

}

//----------------------------------------------------------
// This function dumps regfile to a file
//----------------------------------------------------------
void CXGS_Ctrl::ReadSPI_DumpFile()
{
	FILE* f_dump;
	int   f_dump_Open = FALSE;

	if (f_dump_Open != TRUE)
	{
		f_dump_Open = TRUE;
		f_dump = fopen("XGSDump_All_Regs.txt", "w+t");

		if (f_dump == NULL)
		{
			printf_s("ERROR when trying to open file XGSDump_All_Regs.txt \n");
			exit(1);
		}
		else
		{
			printf_s("\nDump of XGSregisters into file PythonDump_All_Regs.txt  \n");
			fprintf_s(f_dump, "XGS SPI REgister Dump\n\n");
			fprintf_s(f_dump, "Add\tData\n\n");
			
			fprintf_s(f_dump, "0x%04X\t0x%04X\n",    0x0, ReadSPI(0x0000));
			fprintf_s(f_dump, "0x%04X\t0x%04X\n",    0x2, ReadSPI(0x0002));
			
			fprintf_s(f_dump, "0x%04X\t0x%04X\n", 0x3012, ReadSPI(0x3012));

			fprintf_s(f_dump, "0x%04X\t0x%04X\n", 0x3602, ReadSPI(0x3602));

			fprintf_s(f_dump, "0x%04X\t0x%04X\n", 0x3700, ReadSPI(0x3700));

			for (int i = 0x3800; i < 0x38c0; i = i + 2)
			{
				fprintf_s(f_dump, "0x%04X\t0x%04X\n", i, ReadSPI(i));
			}

			for (int i = 0x3e0e; i < 0x3e84; i = i + 2)
			{
				fprintf_s(f_dump, "0x%04X\t0x%04X\n", i, ReadSPI(i));
			}

			for (int i = 0x4000; i < 0x7000; i = i + 2)
			{
				fprintf_s(f_dump, "0x%04X\t0x%04X\n", i, ReadSPI(i));
			}
			fclose(f_dump);
			f_dump_Open = FALSE;

		}
	}
}




//----------------------------------------------------------
// This function dumps one section of the XGS regfile
//----------------------------------------------------
void CXGS_Ctrl::DumpRegSPI(M_UINT32 SPI_START, M_UINT32 NB_REG)
{
	M_UINT32 address;
	M_UINT32 dataread;

	for (M_UINT32 nb_reg2read = 0; nb_reg2read < NB_REG ; nb_reg2read++)
	{
	  address = SPI_START + (nb_reg2read * 2);
	  dataread = ReadSPI(address);
	  printf_s("Add=0x%X \tData=0x%X \n", address, dataread);
	}

}



//----------------------------------------------------------
// This function Inits the XGS sensor from XGS12M-REV2.ini
//----------------------------------------------------------
void CXGS_Ctrl::InitXGS()
{
	M_UINT32 iter = 0;
	M_UINT32 DataRead;

	// Sensor already POWERED, POWERDOWN!
	if (rXGSptr.ACQ.SENSOR_STAT.f.SENSOR_POWERUP_DONE == 1 && rXGSptr.ACQ.SENSOR_STAT.f.SENSOR_POWERUP_STAT == 1) {
		printf_s("XGS already Powerup, powerdown ");
		
		sXGSptr.ACQ.SENSOR_CTRL.f.SENSOR_POWERDOWN = 1;
		rXGSptr.ACQ.SENSOR_CTRL.u32 = sXGSptr.ACQ.SENSOR_CTRL.u32;
		sXGSptr.ACQ.SENSOR_CTRL.f.SENSOR_POWERDOWN = 0;

		// Wait for dowerdown
		DataRead = rXGSptr.ACQ.SENSOR_STAT.f.SENSOR_POWERDOWN;
		while (DataRead == 0) {
			Sleep(1);
			DataRead = rXGSptr.ACQ.SENSOR_STAT.f.SENSOR_POWERDOWN;
			iter++;
			if (iter == 1000) {
				printf_s("fail!\n\n");
				printf_s("Press enter to exit!!!\n\n");
				getch_return = _getch();
				exit(1);
			}
		}
		printf_s("done!\n\n");
	}
	Sleep(100);

	// WakeUP XGS SENSOR : unreset and enable clk to the sensor : SENSOR_POWERUP
	sXGSptr.ACQ.SENSOR_CTRL.f.SENSOR_RESETN = 1; //reset is controlled by the state machine, this field is to overwrite if needed
	sXGSptr.ACQ.SENSOR_CTRL.f.SENSOR_POWERUP = 1;
	rXGSptr.ACQ.SENSOR_CTRL.u32 = sXGSptr.ACQ.SENSOR_CTRL.u32;
	sXGSptr.ACQ.SENSOR_CTRL.f.SENSOR_POWERUP = 0;

	// Wait for done
	iter = 0;
	DataRead = rXGSptr.ACQ.SENSOR_STAT.f.SENSOR_POWERUP_DONE;
	while (DataRead == 0) {
		Sleep(1);
		DataRead = rXGSptr.ACQ.SENSOR_STAT.f.SENSOR_POWERUP_DONE;
		iter++;
		if (iter == 1000) {
			printf_s("Powerup done fail\n\n");
			printf_s("Press enter to exit!!!\n\n");
			getch_return = _getch();
			exit(1);
		}
	}
	if (rXGSptr.ACQ.SENSOR_STAT.f.SENSOR_POWERUP_STAT==0) { //powerup fail
		printf_s("Powerup stat fail\n");
		printf_s("Press enter to exit!!!\n\n");
		getch_return = _getch();
		exit(1);
	}
	printf_s("XGS Powerup done OK\n\n");

	Sleep(100);

	// READ XGS MODEL ID and REVISION
	sXGSptr.ACQ.SENSOR_CTRL.f.SENSOR_REG_UPDATE = 0;
	rXGSptr.ACQ.SENSOR_CTRL.u32 = sXGSptr.ACQ.SENSOR_CTRL.u32;

	DataRead = ReadSPI(0x0);
	
	//-----------------------------------
	// XGS5M Family
	//-----------------------------------
	if (DataRead == 0x0358) {
		printf_s("XGS Model ID detected is 0x358, XGS5M Family, ");
		DataRead = ReadSPI(0x2);
		printf_s("XGS RevNum Major: 0x%X, XGS RevNum Minor: 0x%X\n", DataRead & 0xff, (DataRead & 0xff00) >> 16);

		WriteSPI_Bit(0x3700, 5, 1);  //Enable reading from OTPM
		Sleep(50);                   //Comme dans le code de onsemi
		DataRead = ReadSPI(0x3012);
		WriteSPI_Bit(0x3700, 5, 0);  //Disable reading from OTPM
		Sleep(50);

		printf_s("XGS OTPM Chip configuration register (0x3012): 0x%X", DataRead & 0xff);
		if ((DataRead & 0xff) == 0)
			printf_s(", This OTPM register must be different than 0!!!\n");
		else
			printf_s("\n");

		if ((DataRead & 0x3) == 1) {
			printf_s("  XGS is COLOR\n");
			SensorParams.IS_COLOR           = 1;
			GrabParams.XGS_LINE_SIZE_FACTOR = 4;
		}
		else if ((DataRead & 0x3) == 2) {
			printf_s("  XGS is MONO\n");
			SensorParams.IS_COLOR           = 0;
			GrabParams.XGS_LINE_SIZE_FACTOR = 1;
		}
		else {
			printf_s("  XGS is set to MONO XGS 5000 default (reg 0x3012, color field is other than value 1 or 2, this means that the OTPM read returs 0)\n");
			SensorParams.IS_COLOR           = 0;
			GrabParams.XGS_LINE_SIZE_FACTOR = 1;
			XGS5M_SetGrabParamsInit5000(4, SensorParams.IS_COLOR);

		}


		if (((DataRead & 0x7c) >> 2) == 0x18) {
			printf_s("  XGS Resolution is 5Mp\n");
			XGS5M_SetGrabParamsInit5000(4, SensorParams.IS_COLOR);
		}
		else
		if (((DataRead & 0x7c) >> 2) == 0x1a) {
			printf_s("  XGS Resolution is 2Mp\n");
			XGS5M_SetGrabParamsInit2000(4, SensorParams.IS_COLOR);
		}
	 	else {		
			printf_s("  XGS OTPM Resolution NOT SUPPORTED !!!\n");
	    }

		if (((DataRead & 0x7c) >> 2) == 0x1b)
			printf_s("  XGS Resolution is 1.3Mp\n");

		if (((DataRead & 0x600) >> 5) == 0)
			printf_s("  XGS Speedgrade is 16 ports\n");
		if (((DataRead & 0x600) >> 5) == 1)
			printf_s("  XGS Speedgrade is 12 ports\n");
		if (((DataRead & 0x600) >> 5) == 2)
			printf_s("  XGS Speedgrade is 8 ports\n");
		if (((DataRead & 0x600) >> 5) == 3)
			printf_s("  XGS Speedgrade is 4 ports\n");

		if (((DataRead & 0x180) >> 7) == 0)
			printf_s("  XGS Lens Shift is 0 degree\n");
		if (((DataRead & 0x180) >> 7) == 1)
			printf_s("  XGS Lens Shift is 7.3 degree\n");



		XGS5M_LoadDCF(4);

	}

	//-----------------------------------
    // XGS12M Family
    //-----------------------------------
	else if (DataRead == 0x0058) {
		printf_s("XGS Model ID detected is 0x58, XGS12M Family\n");
		DataRead = ReadSPI(0x2);
		printf_s("XGS RevNum Major: 0x%X, XGS RevNum Minor: 0x%X\n", DataRead&0xff, (DataRead & 0xff00)>>16);

		WriteSPI_Bit(0x3700, 5, 1);  //Enable reading from OTPM
		Sleep(50);                   //Comme dans le code de onsemi
		DataRead = ReadSPI(0x3012);
		WriteSPI_Bit(0x3700, 5, 0);  //Disable reading from OTPM
		Sleep(50);  

		printf_s("XGS OTPM Chip configuration register (0x3012): 0x%X", DataRead & 0xff);
		if ((DataRead & 0xff) == 0)
			printf_s(", This OTPM register must be different than 0!!!\n");
		else
			printf_s("\n");


		if ((DataRead & 0x3) == 1) {
			printf_s("  XGS is COLOR\n");
			SensorParams.IS_COLOR = 1;
			GrabParams.XGS_LINE_SIZE_FACTOR = 4;

		}
		else if ((DataRead & 0x3) == 2) {
			printf_s("  XGS is MONO\n");
			SensorParams.IS_COLOR = 0;
			GrabParams.XGS_LINE_SIZE_FACTOR = 1;
		}
		else {
			printf_s("  XGS is set to MONO XGS 12000 default (reg 0x3012, color field is other than value 1 or 2, this means that the OTPM read returs 0)\n");
			SensorParams.IS_COLOR = 0;
			GrabParams.XGS_LINE_SIZE_FACTOR = 1;
			XGS12M_SetGrabParamsInit12000(6, SensorParams.IS_COLOR);
		}

		//Force COLOR on mono sensor
		//SensorParams.IS_COLOR = 1;
		//GrabParams.XGS_LINE_SIZE_FACTOR = 4;



		if (((DataRead & 0x1c) >> 2) == 0) {
			printf_s("  XGS Resolution is 12Mp\n");
			XGS12M_SetGrabParamsInit12000(6, SensorParams.IS_COLOR);
		} 
		else
		if (((DataRead & 0x1c) >> 2) == 3) {
			printf_s("  XGS Resolution is 8Mp\n");
			XGS12M_SetGrabParamsInit8000(6, SensorParams.IS_COLOR);
		}
		else {
			printf_s("  XGS OTPM Resolution NOT SUPPORTED !!!\n");
		}


		if (((DataRead & 0x60) >> 5) == 0)
			printf_s("  XGS Speedgrade is 24 ports\n");
		if (((DataRead & 0x60) >> 5) == 1)
			printf_s("  XGS Speedgrade is 12 ports\n");
		if (((DataRead & 0x60) >> 5) == 3)
			printf_s("  XGS Speedgrade is 6 ports\n");

		if (((DataRead & 0x180) >> 7) == 0)
			printf_s("  XGS Lens Shift is 0 degree\n");
		if (((DataRead & 0x180) >> 7) == 1)
			printf_s("  XGS Lens Shift is 7.3 degree\n");



		XGS12M_LoadDCF(6);
	}

	//-----------------------------------
	// XGS16M Family
	//-----------------------------------
	else if (DataRead == 0x0258) {
		printf_s("XGS Model ID detected is 0x258, XGS16M Family\n");
		DataRead = ReadSPI(0x2);
		printf_s("XGS RevNum Major: 0x%X, XGS RevNum Minor: 0x%X\n", DataRead & 0xff, (DataRead & 0xff00) >> 16);

		WriteSPI_Bit(0x3700, 5, 1);  //Enable reading from OTPM
		Sleep(50);                   //Comme dans le code de onsemi
		DataRead = ReadSPI(0x3012);
		WriteSPI_Bit(0x3700, 5, 0);  //Disable reading from OTPM
		Sleep(50);  

		printf_s("XGS OTPM Chip configuration register (0x3012): 0x%X", DataRead & 0xff);
		if ((DataRead & 0xff) == 0)
			printf_s(", This OTPM register must be different than 0!!!\n");
		else
			printf_s("\n");


		if (((DataRead & 0x3c) >> 2) == 0x10)
			printf_s("  XGS Resolution is 16Mp\n");
		else {
			printf_s("  XGS OTPM Resolution NOT SUPPORTED !!!\n");
		}

		if (((DataRead & 0x60) >> 9) == 0)
			printf_s("  XGS Speedgrade is 24 ports\n");
		if (((DataRead & 0x60) >> 9) == 1)
			printf_s("  XGS Speedgrade is 18 ports\n");
		if (((DataRead & 0x60) >> 9) == 2)
			printf_s("  XGS Speedgrade is 12 ports\n");
		if (((DataRead & 0x60) >> 9) == 3)
			printf_s("  XGS Speedgrade is 6 ports\n");

		if (((DataRead & 0x180) >> 7) == 0)
			printf_s("  XGS Lens Shift is 0 degree\n");
		if (((DataRead & 0x180) >> 7) == 1)
			printf_s("  XGS Lens Shift is 7.3 degree\n");

		if ((DataRead & 0x3) == 1) {
			printf_s("  XGS is COLOR\n");
			SensorParams.IS_COLOR = 1;
			GrabParams.XGS_LINE_SIZE_FACTOR = 4;
		}
		else if ((DataRead & 0x3) == 2) {
			printf_s("  XGS is MONO\n");
			SensorParams.IS_COLOR = 0;
			GrabParams.XGS_LINE_SIZE_FACTOR = 1;
		}
		else {
			printf_s("  XGS is set to MONO XGS 16000 default (reg 0x3012, color field is other than value 1 or 2, this means that the OTPM read returs 0)\n");
			SensorParams.IS_COLOR = 0;
			GrabParams.XGS_LINE_SIZE_FACTOR = 1;
		}

		XGS16M_SetGrabParamsInit16000(6, SensorParams.IS_COLOR);
		XGS16M_LoadDCF(6);
	}





	else
	{
		printf_s("\n\nSenseur XGS id=0x%X non reconnu. EXIT \n\n", DataRead);
		printf_s("Press enter to exit!!!\n\n");
		getch_return = _getch();
		exit(1);
	}

	
}




//----------------------------------------------------
//
//  Print Time
//
//----------------------------------------------------
void CXGS_Ctrl::PrintTime(void)
{

	time_t ltime;
	char *buf;

	time(&ltime);

	buf = ctime(&ltime);
	if (!buf)
	{
		printf_s("Invalid Arguments for ctime.\n");
	}
	printf_s("Current time is %s", buf);

}



//----------------------------------------------------------
// This function Disable the XGS sensor
//----------------------------------------------------------
void CXGS_Ctrl::DisableXGS()
{
	M_UINT32 iter = 0;
	M_UINT32 DataRead;

	// Sensor already POWERED, POWERDOWN!
	if (rXGSptr.ACQ.SENSOR_STAT.f.SENSOR_POWERUP_DONE == 1 && rXGSptr.ACQ.SENSOR_STAT.f.SENSOR_POWERUP_STAT == 1) {
		printf_s("\n\nDisabling XGS (disable clk and reset)... ");

		//1. Disable CAPTURE if output is active by disabling
		//	 the sequencer(general_config0_reg[0] = 0).
		WriteSPI_Bit(0x3800, 0, 0);
		Sleep(1);

		//2. Issue a sensor STANDBY request	(reset_register_reg[2] = 0).By default, the
		//	 transition to STANDBY state happens either after
		//	 completion of current row(or frame) readout or
		//	 instantly(configurable).
		WriteSPI_Bit(0x3700, 2, 0);
		Sleep(1);

		sXGSptr.ACQ.SENSOR_CTRL.f.SENSOR_POWERDOWN = 1;
		rXGSptr.ACQ.SENSOR_CTRL.u32 = sXGSptr.ACQ.SENSOR_CTRL.u32;
		sXGSptr.ACQ.SENSOR_CTRL.f.SENSOR_POWERDOWN = 0;  //wo

		// Wait for dowerdown
		DataRead = rXGSptr.ACQ.SENSOR_STAT.f.SENSOR_POWERDOWN;
		while (DataRead == 0) {
			Sleep(1);
			DataRead = rXGSptr.ACQ.SENSOR_STAT.f.SENSOR_POWERDOWN;
			iter++;
			if (iter == 1000) {
				printf_s("fail!\n");
				printf_s("Press enter to exit!!!\n\n");
				getch_return = _getch();
				exit(1);
			}
		}
		printf_s("done!\n");
	}
	Sleep(100);
}


//----------------------------------------------------
//  getExposure SingleSlope: in us
//----------------------------------------------------
M_UINT32 CXGS_Ctrl::getExposure(void)
{
	//return((M_UINT32)(sXGSptr.ACQ.EXP_CTRL1.f.EXPOSURE_SS * SystemPeriodNanoSecond / 1000.0));
	return(CurrExposure);
}


//----------------------------------------------------
//  setExposure : in ns  
//----------------------------------------------------
void CXGS_Ctrl::setExposure(M_UINT32 exposure_ss_us, M_UINT32 info)
{
	

	if (SensorParams.IS_COLOR==0 &&  exposure_ss_us >= 60 && exposure_ss_us <= 4200000) {
		GrabParams.Exposure = (M_UINT32)((double)exposure_ss_us*1000.0 / SystemPeriodNanoSecond); // Exposure in ns	
		if(info==1) printf_s("Exposure set to %dus\n", exposure_ss_us);
		CurrExposure = exposure_ss_us;
	} else
	  if (SensorParams.IS_COLOR == 1 && exposure_ss_us >= 240 && exposure_ss_us <= 4200000) {
			GrabParams.Exposure = (M_UINT32)((double)exposure_ss_us * 1000.0 / SystemPeriodNanoSecond); // Exposure in ns	
			if (info == 1) printf_s("Exposure set to %dus\n", exposure_ss_us);
			CurrExposure = exposure_ss_us;
		}

	else {
		printf_s("XGS ne supporte pas exposure <60us(MONO), <240us(COLOR), XGS ne reponds pas\n");
	}
	
}

void CXGS_Ctrl::setExposure_(M_UINT32 exposure_ss_us)
{

	if (exposure_ss_us >= 60 && exposure_ss_us <= 4200000) {
		GrabParams.Exposure = (M_UINT32)((double)exposure_ss_us * 1000.0 / SystemPeriodNanoSecond); // Exposure in ns	
		CurrExposure = exposure_ss_us;
	}
	else {
		printf_s("Pour le moment, pas de support pour exposure < 60us, XGS ne reponds pas\n");
	}

}


//----------------------------------------------------
//  setAnalogGain   
//----------------------------------------------------
void CXGS_Ctrl::setAnalogGain(M_UINT32 gain, M_UINT32 info)
{

	if (gain == 1) {
		GrabParams.ANALOG_GAIN = 1;
		if (info == 1) printf_s("AnalogGain set to 1x\n");
	}
	else if (gain == 2) {
		GrabParams.ANALOG_GAIN = 3;
		if (info == 1) printf_s("AnalogGain set to 2x\n");
	}
	else if (gain == 4) {
		GrabParams.ANALOG_GAIN = 7;
		if (info == 1) printf_s("AnalogGain set to 4x\n");
	}


}


//----------------------------------------------------
//  setXGSDigGain    
//----------------------------------------------------
void CXGS_Ctrl::setDigitalGain(M_UINT32 DigGain)
{
	double gain_double;
	
	DigGain     = DigGain & 0x7f;
	gain_double = double(DigGain / 32.0);
	
	// Program same gain for all components
	// This may be used to White balance images...
	rXGSptr.ACQ.SENSOR_GAIN_DIG_G.f.DG_FACTOR_GB = DigGain;
	rXGSptr.ACQ.SENSOR_GAIN_DIG_G.f.DG_FACTOR_GR = DigGain;
	rXGSptr.ACQ.SENSOR_GAIN_DIG_RB.f.DG_FACTOR_R = DigGain;
	rXGSptr.ACQ.SENSOR_GAIN_DIG_RB.f.DG_FACTOR_B = DigGain;

	printf_s("Digital gain set to 0x%X, factor is %1.5f \n", DigGain, gain_double);
}


//----------------------------------------------------
//  setBalckRef
//----------------------------------------------------
void CXGS_Ctrl::setBlackRef(int value, M_UINT32 info)
{
	GrabParams.BLACK_OFFSET = value;
	if (info == 1) printf_s("Black Offset (Data Pedestal) set to 0x%X\n", value);
}

//----------------------------------------------------
//  Set GRAB MODE
//----------------------------------------------------
void CXGS_Ctrl::SetGrabMode(TRIGGER_SRC TRIGGER_SOURCE, TRIGGER_ACT TRIGGER_ACTIVATION)
{
	GrabParams.TRIGGER_ACTIVATION = TRIGGER_ACTIVATION;
	GrabParams.TRIGGER_SOURCE = TRIGGER_SOURCE;
}

//----------------------------------------------------
//  Sensor Enable REGISTER UPDATE
//----------------------------------------------------
void CXGS_Ctrl::EnableRegUpdate(void)
{
	sXGSptr.ACQ.SENSOR_CTRL.f.SENSOR_REG_UPDATE = 1;   // Enable REGISTER UPDATE
	rXGSptr.ACQ.SENSOR_CTRL.u32 = sXGSptr.ACQ.SENSOR_CTRL.u32;
}

//----------------------------------------------------
//  Sensor Disable REGISTER UPDATE
//----------------------------------------------------
void CXGS_Ctrl::DisableRegUpdate(void)
{

	WaitEndExpReadout();
	sXGSptr.ACQ.SENSOR_CTRL.f.SENSOR_REG_UPDATE = 0;   // Disable REGISTER UPDATE
	rXGSptr.ACQ.SENSOR_CTRL.u32 = sXGSptr.ACQ.SENSOR_CTRL.u32;
}


//----------------------------------------------------
//  Wait for end of EXPOSURE+Readout
//----------------------------------------------------
void CXGS_Ctrl::WaitEndExpReadout(void)
{
	int loop_nb = 0;


	while (rXGSptr.ACQ.GRAB_STAT.f.GRAB_IDLE == 0)
	{// Sequence not finish yet
	//wait for grab idle
		loop_nb++;
		if (loop_nb == 2000)
		{
			printf_s("ERROR TIMEOUT : GRAB IDLE=0, depuis 2 secondes!\n");
			return;
		}
		Sleep(1);
	}

	// Case we are in LVDS 4x with extended ROT time in the sensor, the Sequencer readout will fininsh before Datapath readout
	// this while will wait for the end of datapath readout before going forward.
	loop_nb = 0;

	while (rXGSptr.ACQ.GRAB_STAT.f.GRAB_READOUT == 1)
		//printf_s("\n NB loop in wait for GRAB_IDLE %d", loop_nb);
	{
		//wait for grab idle
		loop_nb++;
		if (loop_nb == 2000)
		{
			printf_s("ERROR TIMEOUT : GRAB Readout=1, depuis 2 secondes!\n");
			return;
		}
		Sleep(1);
	}


}


//--------------------------------------------------------
//  GRAB ABORT
//--------------------------------------------------------
int CXGS_Ctrl::GrabAbort()
{
	M_UINT32 loop_nb = 0;
	M_UINT32 max_iter = 0xffffff;

	sXGSptr.ACQ.GRAB_CTRL.f.ABORT_GRAB = 1;
	rXGSptr.ACQ.GRAB_CTRL.u32          = sXGSptr.ACQ.GRAB_CTRL.u32;
	sXGSptr.ACQ.GRAB_CTRL.f.ABORT_GRAB = 0;

	while (rXGSptr.ACQ.GRAB_STAT.f.ABORT_DONE == 0)
	{
		if (loop_nb == 1000)
		{
			printf_s("\n\nGRAB NOT ABORTED FOR 2 seconds, something gone wrong!\n\n");

			printf_s("  Grab Idle        = %d\n",   rXGSptr.ACQ.GRAB_STAT.f.GRAB_IDLE);
			printf_s("  Grab Active      = %d\n",   rXGSptr.ACQ.GRAB_STAT.f.GRAB_ACTIVE);
			printf_s("  Grab Pending     = %d\n",   rXGSptr.ACQ.GRAB_STAT.f.GRAB_PENDING);
			printf_s("  Grab Exposure    = %d\n",   rXGSptr.ACQ.GRAB_STAT.f.GRAB_EXPOSURE);
			printf_s("  Grab Readout     = %d\n",   rXGSptr.ACQ.GRAB_STAT.f.GRAB_READOUT);
			printf_s("  Grab FOT         = %d\n",   rXGSptr.ACQ.GRAB_STAT.f.GRAB_FOT);
			printf_s("  GRAB_MNGR_STATE  = 0x%x\n", rXGSptr.ACQ.GRAB_STAT.f.GRAB_MNGR_STAT);
			printf_s("  TIMER_MNGR_STATE = 0x%x\n", rXGSptr.ACQ.GRAB_STAT.f.TIMER_MNGR_STAT);
			printf_s("  TRIG_MNGR_STATE  = 0x%x\n", rXGSptr.ACQ.GRAB_STAT.f.TRIG_MNGR_STAT);
			printf_s("  Grab TRIG RDY    = %d\n",   rXGSptr.ACQ.GRAB_STAT.f.TRIGGER_RDY);
			printf_s("  SPI FIFO_EMPTY   = %d\n",   rXGSptr.ACQ.ACQ_SER_STAT.f.SER_FIFO_EMPTY);
			printf_s("  ABORT_DONE       = %d\n",   rXGSptr.ACQ.GRAB_STAT.f.ABORT_DONE);
			printf_s("  ABORT_PET        = %d\n",   rXGSptr.ACQ.GRAB_STAT.f.ABORT_PET);
			printf_s("  ABORT_DELAI      = %d\n",   rXGSptr.ACQ.GRAB_STAT.f.ABORT_DELAI);

			if (rXGSptr.ACQ.GRAB_STAT.f.ABORT_MNGR_STAT == 0)
				printf_s("  ABORT_MNGR_STATE = Idle\n");
			if (rXGSptr.ACQ.GRAB_STAT.f.ABORT_MNGR_STAT == 1)
				printf_s("  ABORT_MNGR_STATE = Abort_states\n");
			if (rXGSptr.ACQ.GRAB_STAT.f.ABORT_MNGR_STAT == 2)
				printf_s("  ABORT_MNGR_STATE = Abort_cmd_flags\n");
			if (rXGSptr.ACQ.GRAB_STAT.f.ABORT_MNGR_STAT == 3)
				printf_s("  ABORT_MNGR_STATE = Abort_ser_fifo\n");
			if (rXGSptr.ACQ.GRAB_STAT.f.ABORT_MNGR_STAT == 4)
				printf_s("  ABORT_MNGR_STATE = Abort_dma\n");
			if (rXGSptr.ACQ.GRAB_STAT.f.ABORT_MNGR_STAT == 5)
				printf_s("  ABORT_MNGR_STATE = Abort_irq\n");

			printf_s("\n\nPress any key to continue.\n\n");
			getch_return = _getch();
			break;
		}
		Sleep(1);
		loop_nb++;
	}

	if (rXGSptr.ACQ.GRAB_STAT.f.GRAB_IDLE == 0 ||
		rXGSptr.ACQ.GRAB_STAT.f.GRAB_ACTIVE == 1 ||
		rXGSptr.ACQ.GRAB_STAT.f.GRAB_PENDING == 1 ||
		rXGSptr.ACQ.GRAB_STAT.f.GRAB_EXPOSURE == 1 ||
		rXGSptr.ACQ.GRAB_STAT.f.GRAB_READOUT == 1 ||
		rXGSptr.ACQ.GRAB_STAT.f.GRAB_FOT == 1 ||
		rXGSptr.ACQ.GRAB_STAT.f.GRAB_MNGR_STAT != 0 ||
		rXGSptr.ACQ.GRAB_STAT.f.TIMER_MNGR_STAT != 0 ||
		rXGSptr.ACQ.GRAB_STAT.f.TRIG_MNGR_STAT != 0 ||
		rXGSptr.ACQ.GRAB_STAT.f.TRIGGER_RDY == 1 ||
		rXGSptr.ACQ.ACQ_SER_STAT.f.SER_FIFO_EMPTY == 0
		)
	{
		printf_s("\n\nGRAB ABORT NOT FINISH AS IT SHOULD!!\n\n");

		printf_s("Grab Idle        = %d\n",   rXGSptr.ACQ.GRAB_STAT.f.GRAB_IDLE);
		printf_s("Grab Active      = %d\n",   rXGSptr.ACQ.GRAB_STAT.f.GRAB_ACTIVE);
		printf_s("Grab Pending     = %d\n",   rXGSptr.ACQ.GRAB_STAT.f.GRAB_PENDING);
		printf_s("Grab Exposure    = %d\n",   rXGSptr.ACQ.GRAB_STAT.f.GRAB_EXPOSURE);
		printf_s("Grab Readout     = %d\n",   rXGSptr.ACQ.GRAB_STAT.f.GRAB_READOUT);
		printf_s("Grab FOT         = %d\n",   rXGSptr.ACQ.GRAB_STAT.f.GRAB_FOT);
		printf_s("GRAB_MNGR_STATE  = 0x%x\n", rXGSptr.ACQ.GRAB_STAT.f.GRAB_MNGR_STAT);
		printf_s("TIMER_MNGR_STATE = 0x%x\n", rXGSptr.ACQ.GRAB_STAT.f.TIMER_MNGR_STAT);
		printf_s("TRIG_MNGR_STATE  = 0x%x\n", rXGSptr.ACQ.GRAB_STAT.f.TRIG_MNGR_STAT);
		printf_s("Grab TRIG RDY    = %d\n\n", rXGSptr.ACQ.GRAB_STAT.f.TRIGGER_RDY);
		printf_s("SPI FIFO_EMPTY   = %d\n\n", rXGSptr.ACQ.ACQ_SER_STAT.f.SER_FIFO_EMPTY);
		printf_s("ABORT_DONE       = %d\n\n", rXGSptr.ACQ.GRAB_STAT.f.ABORT_DONE);
		printf_s("ABORT_PET        = %d\n\n", rXGSptr.ACQ.GRAB_STAT.f.ABORT_PET);
		printf_s("ABORT_DELAI      = %d\n\n", rXGSptr.ACQ.GRAB_STAT.f.ABORT_DELAI);

		return(0);
		getch_return = _getch();

	}

	else
		return(1);

}



//----------------------------------------------------
//  GRAB CMD
//----------------------------------------------------
void CXGS_Ctrl::SetGrabCMD(unsigned long Throttling, int DoSleep)
{

	M_UINT32 loop_nb = 0;
	M_UINT32 max_iter = 0xffffff;

	while (rXGSptr.ACQ.GRAB_STAT.f.GRAB_PENDING == 1)
	{
		if (loop_nb == max_iter)
		{
			printf_s("\n\nERROR : GRAB_PENDING TIMEOUT ! in proccess XGS_Ctrl->SetGrabCMD(void) \n");
			//PrintFPGAGrabLogicState();
			break;
		}
		loop_nb++;
		if (DoSleep == 1) Sleep(1); // This Sleep will decrease CPU usage but also decrease max framerate !!!!
	}

	if (loop_nb != max_iter)
	{
		SetGrabParams(Throttling);
		sXGSptr.ACQ.GRAB_CTRL.f.GRAB_CMD = 1;
		rXGSptr.ACQ.GRAB_CTRL.u32        = sXGSptr.ACQ.GRAB_CTRL.u32;
		sXGSptr.ACQ.GRAB_CTRL.f.GRAB_CMD = 0;

	}
}



//----------------------------------------------------
//  Set GRAB PARAMS
//----------------------------------------------------
void CXGS_Ctrl::SetGrabParams(unsigned long Throttling)
{

	//int nbLVDS = getLVDS_ch_used();
	
	sXGSptr.ACQ.SENSOR_ROI_Y_START.f.Y_START = GrabParams.Y_START/4;
	rXGSptr.ACQ.SENSOR_ROI_Y_START.u32 = sXGSptr.ACQ.SENSOR_ROI_Y_START.u32;
	
	sXGSptr.ACQ.SENSOR_ROI_Y_SIZE.f.Y_SIZE  = (GrabParams.Y_SIZE)/4;
	rXGSptr.ACQ.SENSOR_ROI_Y_SIZE.u32       = sXGSptr.ACQ.SENSOR_ROI_Y_SIZE.u32;

	//if (sXGSptr.ACQ.GRAB_CTRL.f.GRAB_ROI2_EN == 1)
	//{
	//	sXGSptr.ACQ.SENSOR_ROI2_Y_START.f.Y_START = GrabParams.Y_START_ROI2/4;
	//	rXGSptr.ACQ.SENSOR_ROI2_Y_START.u32       = sXGSptr.ACQ.SENSOR_ROI2_Y_START.u32;
	//
	//	sXGSptr.ACQ.SENSOR_ROI2_Y_SIZE.f.Y_SIZE   = (GrabParams.Y_SIZE2)/4;	
	//	rXGSptr.ACQ.SENSOR_ROI2_Y_SIZE.u32        = sXGSptr.ACQ.SENSOR_ROI2_Y_SIZE.u32;
	//}
	
	sXGSptr.ACQ.EXP_CTRL1.f.EXPOSURE_SS       = GrabParams.Exposure;
	sXGSptr.ACQ.EXP_CTRL1.f.EXPOSURE_LEV_MODE = static_cast<M_UINT32>(GrabParams.EXPOSURE_LEV_MODE);
	rXGSptr.ACQ.EXP_CTRL1.u32                 = sXGSptr.ACQ.EXP_CTRL1.u32;

	sXGSptr.ACQ.TRIGGER_DELAY.f.TRIGGER_DELAY = GrabParams.TRIGGER_DELAY;
	rXGSptr.ACQ.TRIGGER_DELAY.u32             = sXGSptr.ACQ.TRIGGER_DELAY.u32;

	sXGSptr.ACQ.STROBE_CTRL2.f.STROBE_END     = GrabParams.STROBE_END;
	sXGSptr.ACQ.STROBE_CTRL2.f.STROBE_MODE    = GrabParams.STROBE_MODE;
	rXGSptr.ACQ.STROBE_CTRL2.u32              = sXGSptr.ACQ.STROBE_CTRL2.u32;

	sXGSptr.ACQ.STROBE_CTRL1.f.STROBE_START   = GrabParams.STROBE_START;
	sXGSptr.ACQ.STROBE_CTRL1.f.STROBE_E       = GrabParams.STROBE_E;
	rXGSptr.ACQ.STROBE_CTRL1.u32              = sXGSptr.ACQ.STROBE_CTRL1.u32;

	// Black Offset (data Pedestal, pour le moment tous les pixels ont le meme pedestal)
	sXGSptr.ACQ.SENSOR_DP_GR.f.DP_OFFSET_GR = GrabParams.BLACK_OFFSET;
	rXGSptr.ACQ.SENSOR_DP_GR.u32            = sXGSptr.ACQ.SENSOR_DP_GR.u32;

	sXGSptr.ACQ.SENSOR_DP_GB.f.DP_OFFSET_GB = GrabParams.BLACK_OFFSET;
	rXGSptr.ACQ.SENSOR_DP_GB.u32            = sXGSptr.ACQ.SENSOR_DP_GB.u32;

	sXGSptr.ACQ.SENSOR_DP_R.f.DP_OFFSET_R   = GrabParams.BLACK_OFFSET;
	rXGSptr.ACQ.SENSOR_DP_R.u32             = sXGSptr.ACQ.SENSOR_DP_R.u32;

	sXGSptr.ACQ.SENSOR_DP_B.f.DP_OFFSET_B   = GrabParams.BLACK_OFFSET;
	rXGSptr.ACQ.SENSOR_DP_B.u32             = sXGSptr.ACQ.SENSOR_DP_B.u32;

	sXGSptr.ACQ.SENSOR_GAIN_ANA.f.ANALOG_GAIN = GrabParams.ANALOG_GAIN;
	rXGSptr.ACQ.SENSOR_GAIN_ANA.u32 = sXGSptr.ACQ.SENSOR_GAIN_ANA.u32;

	sXGSptr.ACQ.SENSOR_SUBSAMPLING.f.M_SUBSAMPLING_Y      = GrabParams.M_SUBSAMPLING_Y;
	sXGSptr.ACQ.SENSOR_SUBSAMPLING.f.ACTIVE_SUBSAMPLING_Y = GrabParams.ACTIVE_SUBSAMPLING_Y;
	sXGSptr.ACQ.SENSOR_SUBSAMPLING.f.SUBSAMPLING_X        = 0;    // Dont use SUB_X in sensor, no fps advantages , and noise is increased!
	rXGSptr.ACQ.SENSOR_SUBSAMPLING.u32 = sXGSptr.ACQ.SENSOR_SUBSAMPLING.u32;

	//rXGSptr.ACQ.GRAB_CTRL.f.BUFFER_ID                     = GrabParams.GRAB_BUFFER_ID;
	sXGSptr.ACQ.GRAB_CTRL.f.TRIGGER_ACT                   = static_cast<M_UINT32>(GrabParams.TRIGGER_ACTIVATION);
	sXGSptr.ACQ.GRAB_CTRL.f.TRIGGER_SRC                   = static_cast<M_UINT32>(GrabParams.TRIGGER_SOURCE);
	sXGSptr.ACQ.GRAB_CTRL.f.TRIGGER_OVERLAP               = GrabParams.TRIGGER_OVERLAP;
	sXGSptr.ACQ.GRAB_CTRL.f.TRIGGER_OVERLAP_BUFFN         = GrabParams.TRIGGER_OVERLAP_BUFFN;
	rXGSptr.ACQ.GRAB_CTRL.u32                             = sXGSptr.ACQ.GRAB_CTRL.u32;
}




//----------------------------------------------------
//  Snapshot SW
//----------------------------------------------------
void CXGS_Ctrl::SW_snapshot(int DoSleep)
{
	M_UINT32 loop_nb = 0;
	M_UINT32 max_iter = 0xffffff;

	while (rXGSptr.ACQ.GRAB_STAT.f.TRIGGER_RDY == 0)
	{
		if (loop_nb == max_iter)
		{
			//if (rUNIT.ERROR_CONDITION.f.REVX_OVERRUN == 1)
			//{
			//	printf_s("DMA GRAB OVERRUN detected in SW_snapshot!!!");
			//	printf_s("\n\n");
			//	rUNIT.ERROR_CONDITION.f.REVX_OVERRUN = 1;
			//	Sleep(1000);
			//}
			printf_s("\n\nERROR : TRIGGER_RDY TIMEOUT ! in proccess Camera->SW_snapshot(void) \n");
			break;
		}
		loop_nb++;
		if (DoSleep == 1) Sleep(1); // This Sleep will decrease CPU usage but also decrease max framerate !!!!
	}

	if (loop_nb != max_iter)
	{
		sXGSptr.ACQ.GRAB_CTRL.f.GRAB_SS = 1;
		rXGSptr.ACQ.GRAB_CTRL.u32       = sXGSptr.ACQ.GRAB_CTRL.u32;
		sXGSptr.ACQ.GRAB_CTRL.f.GRAB_SS = 0;
	}
}


//----------------------------------------------------
// DUMP PYTHON REGISTERS TO FILE
//----------------------------------------------------
void CXGS_Ctrl::XGS_PCIeCtrl_DumpFile(void)
{

	FILE* f_dump;
	int   f_dump_Open = FALSE;



	if (f_dump_Open != TRUE)
	{
		f_dump_Open = TRUE;
		f_dump = fopen("XGS_CTRL PCIe_reg.txt", "w+t");

		if (f_dump == NULL)
		{
			printf_s("ERROR when trying to open file : XGS_CTRL PCIe_reg.txt\n");
			exit(1);
		}
		else
		{
			printf_s("\nDump of PCIe CRTL XGS registers into file: XGS_CTRL PCIe_reg.txt ");
			fprintf_s(f_dump, "XGS CTRL REgister Dump\n\n");
			fprintf_s(f_dump, "Add\tRegister Name\tData\n\n");
			
			fprintf_s(f_dump, "0x100\tACQ.GRAB_CTRL            0x%08X\n", rXGSptr.ACQ.GRAB_CTRL.u32);
			fprintf_s(f_dump, "0x108\tACQ.GRAB_STAT            0x%08X\n", rXGSptr.ACQ.GRAB_STAT.u32);
			fprintf_s(f_dump, "0x110\tACQ.READOUT_CFG1         0x%08X\n", rXGSptr.ACQ.READOUT_CFG1.u32);
			fprintf_s(f_dump, "0x118\tACQ.READOUT_CFG2         0x%08X\n", rXGSptr.ACQ.READOUT_CFG2.u32);
			fprintf_s(f_dump, "0x120\tACQ.READOUT_CFG3         0x%08X\n", rXGSptr.ACQ.READOUT_CFG3.u32);
			fprintf_s(f_dump, "0x124\tACQ.READOUT_CFG4         0x%08X\n", rXGSptr.ACQ.READOUT_CFG4.u32);
			fprintf_s(f_dump, "0x128\tACQ.EXP_CTRL1            0x%08X\n", rXGSptr.ACQ.EXP_CTRL1.u32);
			fprintf_s(f_dump, "0x130\tACQ.EXP_CTRL2            0x%08X\n", rXGSptr.ACQ.EXP_CTRL2.u32);
			fprintf_s(f_dump, "0x138\tACQ.EXP_CTRL3            0x%08X\n", rXGSptr.ACQ.EXP_CTRL3.u32);
			fprintf_s(f_dump, "0x140\tACQ.TRIGGER_DELAY        0x%08X\n", rXGSptr.ACQ.TRIGGER_DELAY.u32);
			fprintf_s(f_dump, "0x148\tACQ.STROBE_CTRL1         0x%08X\n", rXGSptr.ACQ.STROBE_CTRL1.u32);
			fprintf_s(f_dump, "0x150\tACQ.STROBE_CTRL2         0x%08X\n", rXGSptr.ACQ.STROBE_CTRL2.u32);
			fprintf_s(f_dump, "0x158\tACQ.ACQ_SER_CTRL         0x%08X\n", rXGSptr.ACQ.ACQ_SER_CTRL.u32);
			fprintf_s(f_dump, "0x160\tACQ.ACQ_SER_ADDATA       0x%08X\n", rXGSptr.ACQ.ACQ_SER_ADDATA.u32);
			fprintf_s(f_dump, "0x168\tACQ.ACQ_SER_STAT         0x%08X\n", rXGSptr.ACQ.ACQ_SER_STAT.u32);
			fprintf_s(f_dump, "0x190\tACQ.SENSOR_CTRL          0x%08X\n", rXGSptr.ACQ.SENSOR_CTRL.u32);
			fprintf_s(f_dump, "0x198\tACQ.SENSOR_STAT          0x%08X\n", rXGSptr.ACQ.SENSOR_STAT.u32);
			fprintf_s(f_dump, "0x1a0\tACQ.SENSOR_SUBSAMPLING   0x%08X\n", rXGSptr.ACQ.SENSOR_SUBSAMPLING.u32);
			fprintf_s(f_dump, "0x1a4\tACQ.SENSOR_GAIN_ANA      0x%08X\n", rXGSptr.ACQ.SENSOR_GAIN_ANA.u32);
			fprintf_s(f_dump, "0x1a8\tACQ.SENSOR_ROI_Y_START   0x%08X\n", rXGSptr.ACQ.SENSOR_ROI_Y_START.u32);
			fprintf_s(f_dump, "0x1ac\tACQ.SENSOR_ROI_Y_SIZE    0x%08X\n", rXGSptr.ACQ.SENSOR_ROI_Y_SIZE.u32);
			//fprintf_s(f_dump, "0x1b0\tACQ.SENSOR_ROI2_Y_START  0x%08X\n", rXGSptr.ACQ.SENSOR_ROI2_Y_START.u32);
			//fprintf_s(f_dump, "0x1b4\tACQ.SENSOR_ROI2_Y_SIZE   0x%08X\n", rXGSptr.ACQ.SENSOR_ROI2_Y_SIZE.u32);
			fprintf_s(f_dump, "0x1d8\tACQ.SENSOR_M_LINES       0x%08X\n", rXGSptr.ACQ.SENSOR_M_LINES.u32);
			//fprintf_s(f_dump, "0x1dc\tACQ.SENSOR_F_LINES       0x%08X\n", rXGSptr.ACQ.SENSOR_F_LINES.u32);
			fprintf_s(f_dump, "0x1e0\tACQ.DEBUG_PINS           0x%08X\n", rXGSptr.ACQ.DEBUG_PINS.u32);
			fprintf_s(f_dump, "0x1e8\tACQ.TRIGGER_MISSED       0x%08X\n", rXGSptr.ACQ.TRIGGER_MISSED.u32);
			fprintf_s(f_dump, "0x1f0\tACQ.SENSOR_FPS           0x%08X\n", rXGSptr.ACQ.SENSOR_FPS.u32);
			fprintf_s(f_dump, "0x2a0\tACQ.DEBUG                0x%08X\n", rXGSptr.ACQ.DEBUG.u32);
			fprintf_s(f_dump, "0x2a8\tACQ.DEBUG_CNTR1          0x%08X\n", rXGSptr.ACQ.DEBUG_CNTR1.u32);
			//fprintf_s(f_dump, "0x2b0\tACQ.DEBUG_CNTR2          0x%08X\n", rXGSptr.ACQ.DEBUG_CNTR2.u32);
			//fprintf_s(f_dump, "0x2b4\tACQ.DEBUG_CNTR3          0x%08X\n", rXGSptr.ACQ.DEBUG_CNTR3.u32);
			fprintf_s(f_dump, "0x2b8\tACQ.EXP_FOT              0x%08X\n", rXGSptr.ACQ.EXP_FOT.u32);
			fprintf_s(f_dump, "0x2c0\tACQ.ACQ_SFNC             0x%08X\n", rXGSptr.ACQ.ACQ_SFNC.u32);

			fclose(f_dump);
			f_dump_Open = FALSE;
			printf_s(" done.");

		}
	}
}

//----------------------------------------------------
// HW TIMER PROGRAMMATION
//----------------------------------------------------

void CXGS_Ctrl::StartHWTimerFPS(double FPS) {

	double FramePeriod = 1 / FPS;

	double FramePeriod_clk = FramePeriod / (SystemPeriodNanoSecond / 1000000000);

	M_UINT32 TIMERDURATION = (M_UINT32)FramePeriod_clk;

	StartHWTimer(0, TIMERDURATION);

}

void CXGS_Ctrl::StartHWTimer(M_UINT32 TIMERDELAY, M_UINT32 TIMERDURATION) {

	sXGSptr.ACQ.TIMER_DELAY.u32    = TIMERDELAY;
	rXGSptr.ACQ.TIMER_DELAY.u32    = sXGSptr.ACQ.TIMER_DELAY.u32;

	sXGSptr.ACQ.TIMER_DURATION.u32 = TIMERDURATION;
	rXGSptr.ACQ.TIMER_DURATION.u32 = sXGSptr.ACQ.TIMER_DURATION.u32;

	sXGSptr.ACQ.TIMER_CTRL.f.TIMERSTART = 1;
	rXGSptr.ACQ.TIMER_CTRL.u32          = sXGSptr.ACQ.TIMER_CTRL.u32;
	sXGSptr.ACQ.TIMER_CTRL.f.TIMERSTART = 0;
}


void CXGS_Ctrl::StopHWTimer(void) {
	sXGSptr.ACQ.TIMER_CTRL.f.TIMERSTOP = 1;
	rXGSptr.ACQ.TIMER_CTRL.u32 = sXGSptr.ACQ.TIMER_CTRL.u32;
	sXGSptr.ACQ.TIMER_CTRL.f.TIMERSTOP = 0;

}


//----------------------------------------------------
//  FPS_MAX and EXP_MAX predictor 
//----------------------------------------------------

// Le max FPS est facile a calculer : Treadout2trigfall + Ttrigfall2FOTstart + Tfot + Treadout(3+Mline+1xEmb+YReadout+7exp+7dummy)
// Tfot fixe en nombre de lignes est plus securitaire car il permet un calcul plus precis sans imprecissions
// Y_SIZE must be 4 lines factor
// In color mode, Y_SIZE already contains the 4 interpolation lines
double CXGS_Ctrl::Get_Sensor_FPS_PRED_MAX(M_UINT32 Y_SIZE, M_UINT32 SUBSAMPLING_Y) {
	
	// FOT ici
	double Lines_In_Frame = double( (double)sXGSptr.ACQ.READOUT_CFG1.f.FOT_LENGTH_LINE + 3 + (double)sXGSptr.ACQ.SENSOR_M_LINES.f.M_LINES_SENSOR + 1 + (double)( Y_SIZE / (1 + SUBSAMPLING_Y)) + 7 + 7);

	double Sensor_FPS_PRED = 1.0 / (double(SensorParams.ReadOutN_2_TrigN / 1000000000.0) + double(SensorParams.TrigN_2_FOT / 1000000000.0) + double((sXGSptr.ACQ.READOUT_CFG3.f.LINE_TIME * SensorPeriodNanoSecond / 1000000000.0) * Lines_In_Frame)  );
	
	return (Sensor_FPS_PRED);
}


// Le exp_max pour fps max est un peu plus tricky a calculer.
// Avec le Xcerelator j'utilise une exposure_synthetique qui ne reflete pas le timing exact du real_integration, 
// alors il est tres difficile de calculer le bon Exposure max. De plus ca peux expliquer aussi pourquoi il y a un 
// width minimum sur le signal trig0 du senseur.
// Y_SIZE must be 4 lines factor
// In color mode, Y_SIZE already contains the 4 interpolation lines
double CXGS_Ctrl::Get_Sensor_EXP_PRED_MAX(M_UINT32 Y_SIZE, M_UINT32 SUBSAMPLING_Y) {
	
	// Pas de FOT ici
	double Lines_In_Frame = double( 3 + (double)sXGSptr.ACQ.SENSOR_M_LINES.f.M_LINES_SENSOR + 1 + (double)(Y_SIZE / (1 + SUBSAMPLING_Y)) + 7 + 7);

	double Sensor_EXP_max = (Lines_In_Frame * (double) (sXGSptr.ACQ.READOUT_CFG3.f.LINE_TIME * SensorPeriodNanoSecond / 1000.0))
		                    - double(SensorParams.FOTn_2_EXP / 1000) + double(SensorParams.ReadOutN_2_TrigN / 1000.0) + double(SensorParams.EXP_FOT_TIME / 1000.0);
	//EXP_FOT_TIME comprend : SensorParams.TrigN_2_FOT + 5360

	return (Sensor_EXP_max);
}




//----------------------------------------------------
//  This method configures the trigger delay 
//----------------------------------------------------
void CXGS_Ctrl::setTriggerDelay(M_UINT32 TRIGGER_DELAY_us, int PrintInfo)
{
	GrabParams.TRIGGER_DELAY = (M_UINT32)((M_UINT64)TRIGGER_DELAY_us * 1000 / SystemPeriodNanoSecond); // Exposure in us	
	if (PrintInfo == 1) printf_s("\nTrigger Delai set to %d us\n", TRIGGER_DELAY_us);

}



//----------------------------------------------------
//  This method enables and configures the Strobe 
//----------------------------------------------------
void CXGS_Ctrl::enableStrobe(int STROBE_MODE, M_UINT32 STROBE_START_us, M_UINT32 STROBE_END_us, int PrintInfo)
{

	GrabParams.STROBE_END = (M_UINT32)((M_UINT64)STROBE_END_us * 1000 / SystemPeriodNanoSecond);
	GrabParams.STROBE_MODE = STROBE_MODE;

	GrabParams.STROBE_START = (M_UINT32)((M_UINT64)STROBE_START_us * 1000 / SystemPeriodNanoSecond);
	GrabParams.STROBE_E = 1;

	if (PrintInfo == 1)
	{
		if (STROBE_MODE == 0) printf_s("Strobe enable, StartSTROBE during EXPOSURE, START=%d us, END=%d us \n", STROBE_START_us, STROBE_END_us);
		if (STROBE_MODE == 1) printf_s("Strobe enable, StartSTROBE during TRIG DELAY, START=%d us, END=%d us \n", STROBE_START_us, STROBE_END_us);
	}
}


//----------------------------------------------------
//  This method Disablesthe Strobe 
//----------------------------------------------------
void CXGS_Ctrl::disableStrobe(void)
{

	GrabParams.STROBE_END = 0xfffffff;
	GrabParams.STROBE_MODE = 0;

	GrabParams.STROBE_START = 0;
	GrabParams.STROBE_E = 0;
}



//----------------------------------------------------
//
//  SYSTEM MONITOR FPGA
//
//----------------------------------------------------
void CXGS_Ctrl::FPGASystemMon(void)
{
	int Sortie = 0;
	//char ch;

	double TCURR;
	double VCC_INT;
	double VCC_AUX;
	double VCC_BRAM;
	double TMAX;
	double TMIN;


	time_t t;
	struct tm* now;

	printf_s("\n\n************************************************************************");
	printf_s("\n*  FPGA MONITOR   ");

	t = time(0);   // get time now
	now = localtime(&t);

	printf_s("%d:%02d:%02d, %d/%d/%d\n*", now->tm_hour, now->tm_min, now->tm_sec, now->tm_mday, (now->tm_mon + 1), (now->tm_year + 1900));

	printf_s("\n*   Tcurr     Tmax     Tmin  VCC_int  VCC_AUX   VCC_BRAM\n");

	TCURR    = ((((rXGSptr.SYSMONXIL.TEMP.u16) & 0xfff0) >> 4) * 503.975 / 4096.0) - 273.15;
	TMAX     = ((((rXGSptr.SYSMONXIL.TEMP_MAX.u16) & 0xfff0) >> 4) * 503.975 / 4096.0) - 273.15;
	TMIN     = ((((rXGSptr.SYSMONXIL.TEMP_MIN.u16) & 0xfff0) >> 4) * 503.975 / 4096.0) - 273.15;
	VCC_INT  = ((((rXGSptr.SYSMONXIL.VCCINT.u16) & 0xfff0) >> 4) / 4096.0) * 3.0;
	VCC_AUX  = ((((rXGSptr.SYSMONXIL.VCCAUX.u16) & 0xfff0) >> 4) / 4096.0) * 3.0;
	VCC_BRAM = ((((rXGSptr.SYSMONXIL.VCCBRAM.u16) & 0xfff0) >> 4) / 4096.0) * 3.0;

	printf_s("\r*  %5.2fC   %5.2fC   %5.2fC   %5.2fV   %5.2fV     %5.2fV\n", TCURR, TMAX, TMIN, VCC_INT, VCC_AUX, VCC_BRAM);

	printf_s("************************************************************************\n\n");
}
