AM4511/test_migrate_iris4/ares_pcie/local_ip/xil_cores_artix7/pcie_7x/source/pcie_7x_core_top.vhd

-------------------------------------------------------------------------------
--
-- (c) Copyright 2010-2011 Xilinx, Inc. All rights reserved.
--
-- This file contains confidential and proprietary information
-- of Xilinx, Inc. and is protected under U.S. and
-- international copyright and other intellectual property
-- laws.
--
-- DISCLAIMER
-- This disclaimer is not a license and does not grant any
-- rights to the materials distributed herewith. Except as
-- otherwise provided in a valid license issued to you by
-- Xilinx, and to the maximum extent permitted by applicable
-- law: (1) THESE MATERIALS ARE MADE AVAILABLE "AS IS" AND
-- WITH ALL FAULTS, AND XILINX HEREBY DISCLAIMS ALL WARRANTIES
-- AND CONDITIONS, EXPRESS, IMPLIED, OR STATUTORY, INCLUDING
-- BUT NOT LIMITED TO WARRANTIES OF MERCHANTABILITY, NON-
-- INFRINGEMENT, OR FITNESS FOR ANY PARTICULAR PURPOSE; and
-- (2) Xilinx shall not be liable (whether in contract or tort,
-- including negligence, or under any other theory of
-- liability) for any loss or damage of any kind or nature
-- related to, arising under or in connection with these
-- materials, including for any direct, or any indirect,
-- special, incidental, or consequential loss or damage
-- (including loss of data, profits, goodwill, or any type of
-- loss or damage suffered as a result of any action brought
-- by a third party) even if such damage or loss was
-- reasonably foreseeable or Xilinx had been advised of the
-- possibility of the same.
--
-- CRITICAL APPLICATIONS
-- Xilinx products are not designed or intended to be fail-
-- safe, or for use in any application requiring fail-safe
-- performance, such as life-support or safety devices or
-- systems, Class III medical devices, nuclear facilities,
-- applications related to the deployment of airbags, or any
-- other applications that could lead to death, personal
-- injury, or severe property or environmental damage
-- (individually and collectively, "Critical
-- Applications"). Customer assumes the sole risk and
-- liability of any use of Xilinx products in Critical
-- Applications, subject only to applicable laws and
-- regulations governing limitations on product liability.
--
-- THIS COPYRIGHT NOTICE AND DISCLAIMER MUST BE RETAINED AS
-- PART OF THIS FILE AT ALL TIMES.
--
-------------------------------------------------------------------------------
-- Project    : Series-7 Integrated Block for PCI Express
-- File       : pcie_7x_core_top.vhd
-- Version    : 3.3
--
-- Description: Solution wrapper for Virtex7 Hard Block for PCI Express
--
--
--
----------------------------------------------------------------------------------

library ieee;
use ieee.std_logic_1164.all;
use ieee.std_logic_misc.all;
use ieee.std_logic_unsigned.all;
use ieee.numeric_std.all;
Library xpm;
use xpm.vcomponents.all;

entity pcie_7x_core_top is
  generic (
    CFG_VEND_ID                                    : std_logic_vector := X"102B";
    CFG_DEV_ID                                     : std_logic_vector := X"5055";
    CFG_REV_ID                                     : std_logic_vector := X"00";
    CFG_SUBSYS_VEND_ID                             : std_logic_vector := X"102B";
    CFG_SUBSYS_ID                                  : std_logic_vector := X"0600";
    INIT_PATTERN_WIDTH                             : integer                      := 8;
    INIT_PATTERN1                                  : std_logic_vector(7 downto 0) := X"12";
    INIT_PATTERN2                                  : std_logic_vector(7 downto 0) := X"9a";
    ALLOW_X8_GEN2                                  : string     := "FALSE";
    PIPE_PIPELINE_STAGES                           : integer    := 0;
    AER_BASE_PTR                                   : bit_vector := X"100";
    AER_CAP_ECRC_CHECK_CAPABLE                     : string     := "TRUE";
    AER_CAP_ECRC_GEN_CAPABLE                       : string     := "TRUE";
    AER_CAP_MULTIHEADER                            : string     := "TRUE";
    AER_CAP_NEXTPTR                                : bit_vector := X"000";
    AER_CAP_OPTIONAL_ERR_SUPPORT                   : bit_vector := X"07FF07";
    AER_CAP_ON                                     : string     := "TRUE";
    AER_CAP_PERMIT_ROOTERR_UPDATE                  : string     := "TRUE";

    BAR0                                           : bit_vector := X"FFFF800C";
    BAR1                                           : bit_vector := X"FFFFFFFF";
    BAR2                                           : bit_vector := X"FC00000C";
    BAR3                                           : bit_vector := X"FFFFFFFF";
    BAR4                                           : bit_vector := X"00000000";
    BAR5                                           : bit_vector := X"00000000";

    C_DATA_WIDTH                                   : integer    := 64;
    CARDBUS_CIS_POINTER                            : bit_vector := X"00000000";
    CLASS_CODE                                     : bit_vector := X"118000";
    CMD_INTX_IMPLEMENTED                           : string     := "TRUE";
    CPL_TIMEOUT_DISABLE_SUPPORTED                  : string     := "FALSE";
    CPL_TIMEOUT_RANGES_SUPPORTED                   : bit_vector := X"2";

    DEV_CAP_ENDPOINT_L0S_LATENCY                   : integer    := 0;
    DEV_CAP_ENDPOINT_L1_LATENCY                    : integer    := 7;
    DEV_CAP_EXT_TAG_SUPPORTED                      : string     := "FALSE";
    DEV_CAP_MAX_PAYLOAD_SUPPORTED                  : integer    := 2;
    DEV_CAP_PHANTOM_FUNCTIONS_SUPPORT              : integer    := 0;

    DEV_CAP2_ARI_FORWARDING_SUPPORTED              : string     := "FALSE";
    DEV_CAP2_ATOMICOP32_COMPLETER_SUPPORTED        : string     := "FALSE";
    DEV_CAP2_ATOMICOP64_COMPLETER_SUPPORTED        : string     := "FALSE";
    DEV_CAP2_ATOMICOP_ROUTING_SUPPORTED            : string     := "FALSE";
    DEV_CAP2_CAS128_COMPLETER_SUPPORTED            : string     := "FALSE";
    DEV_CAP2_TPH_COMPLETER_SUPPORTED               : bit_vector := X"00";
    DEV_CONTROL_EXT_TAG_DEFAULT                    : string     := "FALSE";

    DISABLE_LANE_REVERSAL                          : string     := "TRUE";
    DISABLE_RX_POISONED_RESP                       : string     := "FALSE";
    DISABLE_SCRAMBLING                             : string     := "FALSE";
    DSN_BASE_PTR                                   : bit_vector := X"000";
    DSN_CAP_NEXTPTR                                : bit_vector := X"000";
    DSN_CAP_ON                                     : string     := "FALSE";

    ENABLE_MSG_ROUTE                               : bit_vector := "00000000000";
    ENABLE_RX_TD_ECRC_TRIM                         : string     := "FALSE";
    EXPANSION_ROM                                  : bit_vector := X"00000000";
    EXT_CFG_CAP_PTR                                : bit_vector := X"3F";
    EXT_CFG_XP_CAP_PTR                             : bit_vector := X"3FF";
    HEADER_TYPE                                    : bit_vector := X"00";
    INTERRUPT_PIN                                  : bit_vector := X"1";

    LAST_CONFIG_DWORD                              : bit_vector := X"3FF";
    LINK_CAP_ASPM_OPTIONALITY                      : string     := "FALSE";
    LINK_CAP_DLL_LINK_ACTIVE_REPORTING_CAP         : string     := "FALSE";
    LINK_CAP_LINK_BANDWIDTH_NOTIFICATION_CAP       : string     := "FALSE";
    LINK_CAP_MAX_LINK_SPEED                        : integer    := 1;
    LINK_CAP_MAX_LINK_WIDTH                        : integer    := 1;

    LINK_CTRL2_DEEMPHASIS                          : string     := "FALSE";
    LINK_CTRL2_HW_AUTONOMOUS_SPEED_DISABLE         : string     := "FALSE";
    LINK_CTRL2_TARGET_LINK_SPEED                   : bit_vector := X"0";
    LINK_STATUS_SLOT_CLOCK_CONFIG                  : string     := "TRUE";

    LL_ACK_TIMEOUT                                 : bit_vector := X"0000";
    LL_ACK_TIMEOUT_EN                              : string     := "FALSE";
    LL_ACK_TIMEOUT_FUNC                            : integer    := 0;
    LL_REPLAY_TIMEOUT                              : bit_vector := X"0000";
    LL_REPLAY_TIMEOUT_EN                           : string     := "FALSE";
    LL_REPLAY_TIMEOUT_FUNC                         : integer    := 1;

    LTSSM_MAX_LINK_WIDTH                           : bit_vector := X"01";
    MSI_CAP_MULTIMSGCAP                            : integer    := 0;
    MSI_CAP_MULTIMSG_EXTENSION                     : integer    := 0;
    MSI_CAP_ON                                     : string     := "TRUE";
    MSI_CAP_PER_VECTOR_MASKING_CAPABLE             : string     := "FALSE";
    MSI_CAP_64_BIT_ADDR_CAPABLE                    : string     := "TRUE";

    MSIX_CAP_ON                                    : string     := "FALSE";
    MSIX_CAP_PBA_BIR                               : integer    := 0;
    MSIX_CAP_PBA_OFFSET                            : bit_vector := X"0";
    MSIX_CAP_TABLE_BIR                             : integer    := 0;
    MSIX_CAP_TABLE_OFFSET                          : bit_vector := X"0";
    MSIX_CAP_TABLE_SIZE                            : bit_vector := X"000";

    PCIE_CAP_DEVICE_PORT_TYPE                      : bit_vector := X"0";
    PCIE_CAP_NEXTPTR                               : bit_vector := X"00";

    PM_CAP_DSI                                     : string     := "FALSE";
    PM_CAP_D1SUPPORT                               : string     := "FALSE";
    PM_CAP_D2SUPPORT                               : string     := "FALSE";
    PM_CAP_NEXTPTR                                 : bit_vector := X"48";
    PM_CAP_PMESUPPORT                              : bit_vector := X"00";
    PM_CSR_NOSOFTRST                               : string     := "TRUE";

    PM_DATA_SCALE0                                 : bit_vector := X"0";
    PM_DATA_SCALE1                                 : bit_vector := X"0";
    PM_DATA_SCALE2                                 : bit_vector := X"0";
    PM_DATA_SCALE3                                 : bit_vector := X"0";
    PM_DATA_SCALE4                                 : bit_vector := X"0";
    PM_DATA_SCALE5                                 : bit_vector := X"0";
    PM_DATA_SCALE6                                 : bit_vector := X"0";
    PM_DATA_SCALE7                                 : bit_vector := X"0";

    PM_DATA0                                       : bit_vector := X"00";
    PM_DATA1                                       : bit_vector := X"00";
    PM_DATA2                                       : bit_vector := X"00";
    PM_DATA3                                       : bit_vector := X"00";
    PM_DATA4                                       : bit_vector := X"00";
    PM_DATA5                                       : bit_vector := X"00";
    PM_DATA6                                       : bit_vector := X"00";
    PM_DATA7                                       : bit_vector := X"00";

    RBAR_BASE_PTR                                  : bit_vector := X"000";
    RBAR_CAP_CONTROL_ENCODEDBAR0                   : bit_vector := X"00";
    RBAR_CAP_CONTROL_ENCODEDBAR1                   : bit_vector := X"00";
    RBAR_CAP_CONTROL_ENCODEDBAR2                   : bit_vector := X"00";
    RBAR_CAP_CONTROL_ENCODEDBAR3                   : bit_vector := X"00";
    RBAR_CAP_CONTROL_ENCODEDBAR4                   : bit_vector := X"00";
    RBAR_CAP_CONTROL_ENCODEDBAR5                   : bit_vector := X"00";
    RBAR_CAP_INDEX0                                : bit_vector := X"0";
    RBAR_CAP_INDEX1                                : bit_vector := X"0";
    RBAR_CAP_INDEX2                                : bit_vector := X"0";
    RBAR_CAP_INDEX3                                : bit_vector := X"0";
    RBAR_CAP_INDEX4                                : bit_vector := X"0";
    RBAR_CAP_INDEX5                                : bit_vector := X"0";
    RBAR_CAP_ON                                    : string     := "FALSE";
    RBAR_CAP_SUP0                                  : bit_vector := X"00001";
    RBAR_CAP_SUP1                                  : bit_vector := X"00001";
    RBAR_CAP_SUP2                                  : bit_vector := X"00001";
    RBAR_CAP_SUP3                                  : bit_vector := X"00001";
    RBAR_CAP_SUP4                                  : bit_vector := X"00001";
    RBAR_CAP_SUP5                                  : bit_vector := X"00001";
    RBAR_NUM                                       : bit_vector := X"0";

    RECRC_CHK                                      : integer    := 0;
    RECRC_CHK_TRIM                                 : string     := "FALSE";
    REF_CLK_FREQ                                   : integer    := 0;    -- 0 - 100 MHz; 1 - 125 MHz; 2 - 250 MHz

    --KEEP_WIDTH                                   : integer    := C_DATA_WIDTH / 8;

    TL_RX_RAM_RADDR_LATENCY                        : integer    := 0; 
    TL_RX_RAM_WRITE_LATENCY                        : integer    := 0;
    TL_TX_RAM_RADDR_LATENCY                        : integer    := 0;
    TL_TX_RAM_WRITE_LATENCY                        : integer    := 0;
    TL_RX_RAM_RDATA_LATENCY                        : integer    := 2;
    TL_TX_RAM_RDATA_LATENCY                        : integer    := 2;
    TRN_NP_FC                                      : string     := "TRUE";
    TRN_DW                                         : string     := "FALSE";

    UPCONFIG_CAPABLE                               : string     := "TRUE";
    UPSTREAM_FACING                                : string     := "TRUE";
    UR_ATOMIC                                      : string     := "FALSE";
    UR_INV_REQ                                     : string     := "TRUE";
    UR_PRS_RESPONSE                                : string     := "TRUE";
    USER_CLK_FREQ                                  : integer    := 1;
    USER_CLK2_DIV2                                 : string     := "FALSE";

    VC_BASE_PTR                                    : bit_vector := X"000";
    VC_CAP_NEXTPTR                                 : bit_vector := X"000";
    VC_CAP_ON                                      : string     := "FALSE";
    VC_CAP_REJECT_SNOOP_TRANSACTIONS               : string     := "FALSE";

    VC0_CPL_INFINITE                               : string     := "TRUE";
    VC0_RX_RAM_LIMIT                               : bit_vector := X"7FF";
    VC0_TOTAL_CREDITS_CD                           : integer    := 461;
    VC0_TOTAL_CREDITS_CH                           : integer    := 36;
    VC0_TOTAL_CREDITS_NPH                          : integer    := 12;
    VC0_TOTAL_CREDITS_NPD                          : integer    := 24;
    VC0_TOTAL_CREDITS_PD                           : integer    := 437;
    VC0_TOTAL_CREDITS_PH                           : integer    := 32;
    VC0_TX_LASTPACKET                              : integer    := 29;

    VSEC_BASE_PTR                                  : bit_vector := X"000";
    VSEC_CAP_NEXTPTR                               : bit_vector := X"000";
    VSEC_CAP_ON                                    : string     := "FALSE";

    DISABLE_ASPM_L1_TIMER                          : string     := "FALSE";
    DISABLE_BAR_FILTERING                          : string     := "FALSE";
    DISABLE_ID_CHECK                               : string     := "FALSE";
    DISABLE_RX_TC_FILTER                           : string     := "FALSE";
    DNSTREAM_LINK_NUM                              : bit_vector := X"00";

    DSN_CAP_ID                                     : bit_vector := X"0003";
    DSN_CAP_VERSION                                : bit_vector := X"1";
    ENTER_RVRY_EI_L0                               : string     := "TRUE";
    INFER_EI                                       : bit_vector := X"00";
    IS_SWITCH                                      : string     := "FALSE";

    LINK_CAP_ASPM_SUPPORT                          : integer    := 1;
    LINK_CAP_CLOCK_POWER_MANAGEMENT                : string     := "FALSE";
    LINK_CAP_L0S_EXIT_LATENCY_COMCLK_GEN1          : integer    := 7;
    LINK_CAP_L0S_EXIT_LATENCY_COMCLK_GEN2          : integer    := 7;
    LINK_CAP_L0S_EXIT_LATENCY_GEN1                 : integer    := 7;
    LINK_CAP_L0S_EXIT_LATENCY_GEN2                 : integer    := 7;
    LINK_CAP_L1_EXIT_LATENCY_COMCLK_GEN1           : integer    := 7;
    LINK_CAP_L1_EXIT_LATENCY_COMCLK_GEN2           : integer    := 7;
    LINK_CAP_L1_EXIT_LATENCY_GEN1                  : integer    := 7;
    LINK_CAP_L1_EXIT_LATENCY_GEN2                  : integer    := 7;
    LINK_CAP_RSVD_23                               : integer    := 0;
    LINK_CONTROL_RCB                               : integer    := 0;

    MSI_BASE_PTR                                   : bit_vector := X"48";
    MSI_CAP_ID                                     : bit_vector := X"05";
    MSI_CAP_NEXTPTR                                : bit_vector := X"60";
    MSIX_BASE_PTR                                  : bit_vector := X"9c";
    MSIX_CAP_ID                                    : bit_vector := X"11";
    MSIX_CAP_NEXTPTR                               : bit_vector := X"00";

    N_FTS_COMCLK_GEN1                              : integer    := 255;
    N_FTS_COMCLK_GEN2                              : integer    := 255;
    N_FTS_GEN1                                     : integer    := 255;
    N_FTS_GEN2                                     : integer    := 255;

    PCIE_BASE_PTR                                  : bit_vector := X"60";
    PCIE_CAP_CAPABILITY_ID                         : bit_vector := X"10";
    PCIE_CAP_CAPABILITY_VERSION                    : bit_vector := X"2";
    PCIE_CAP_ON                                    : string     := "TRUE";
    PCIE_CAP_RSVD_15_14                            : integer    := 0;
    PCIE_CAP_SLOT_IMPLEMENTED                      : string     := "FALSE";
    PCIE_REVISION                                  : integer    := 2;

    PL_AUTO_CONFIG                                 : integer    := 0;
    PL_FAST_TRAIN                                  : string     := "FALSE";

    PCIE_EXT_CLK                                   : string     := "FALSE";
    EXT_PIPE_SIM                                   : string     := "FALSE";

    PCIE_EXT_GT_COMMON                             : string     := "FALSE";
    EXT_CH_GT_DRP                                  : string     := "FALSE";
    TRANSCEIVER_CTRL_STATUS_PORTS                  : string     := "FALSE";
    PL_INTERFACE                                   : string     := "FALSE";
    CFG_MGMT_IF                                    : string     := "TRUE";
    CFG_CTL_IF                                     : string     := "TRUE";
    CFG_STATUS_IF                                  : string     := "TRUE";
    RCV_MSG_IF                                     : string     := "FALSE";
    CFG_FC_IF                                      : string     := "FALSE";
    SHARED_LOGIC_IN_CORE		           : string     := "FALSE";
    EXT_PIPE_INTERFACE                             : string     := "FALSE";
    ENABLE_JTAG_DBG                                : string     := "FALSE";
    PM_BASE_PTR                                    : bit_vector := X"40";
    PM_CAP_AUXCURRENT                              : integer    := 0;
    PM_CAP_ID                                      : bit_vector := X"01";
    PM_CAP_ON                                      : string     := "TRUE";
    PM_CAP_PME_CLOCK                               : string     := "FALSE";
    PM_CAP_RSVD_04                                 : integer    := 0;
    PM_CAP_VERSION                                 : integer    := 3;
    PM_CSR_BPCCEN                                  : string     := "FALSE";
    PM_CSR_B2B3                                    : string     := "FALSE";

    ROOT_CAP_CRS_SW_VISIBILITY                     : string     := "FALSE";
    SELECT_DLL_IF                                  : string     := "FALSE";
    SLOT_CAP_ATT_BUTTON_PRESENT                    : string     := "FALSE";
    SLOT_CAP_ATT_INDICATOR_PRESENT                 : string     := "FALSE";
    SLOT_CAP_ELEC_INTERLOCK_PRESENT                : string     := "FALSE";
    SLOT_CAP_HOTPLUG_CAPABLE                       : string     := "FALSE";
    SLOT_CAP_HOTPLUG_SURPRISE                      : string     := "FALSE";
    SLOT_CAP_MRL_SENSOR_PRESENT                    : string     := "FALSE";
    SLOT_CAP_NO_CMD_COMPLETED_SUPPORT              : string     := "FALSE";
    SLOT_CAP_PHYSICAL_SLOT_NUM                     : bit_vector := X"0000";
    SLOT_CAP_POWER_CONTROLLER_PRESENT              : string     := "FALSE";
    SLOT_CAP_POWER_INDICATOR_PRESENT               : string     := "FALSE";
    SLOT_CAP_SLOT_POWER_LIMIT_SCALE                : integer    := 0;
    SLOT_CAP_SLOT_POWER_LIMIT_VALUE                : bit_vector := X"00";

    SPARE_BIT0                                     : integer    := 0;

    SPARE_BIT1                                     : integer    := 0;
    SPARE_BIT2                                     : integer    := 0;
    SPARE_BIT3                                     : integer    := 0;
    SPARE_BIT4                                     : integer    := 0;
    SPARE_BIT5                                     : integer    := 0;
    SPARE_BIT6                                     : integer    := 0;
    SPARE_BIT7                                     : integer    := 0;
    SPARE_BIT8                                     : integer    := 0;
    SPARE_BYTE0                                    : bit_vector := X"00";
    SPARE_BYTE1                                    : bit_vector := X"00";
    SPARE_BYTE2                                    : bit_vector := X"00";
    SPARE_BYTE3                                    : bit_vector := X"00";
    SPARE_WORD0                                    : bit_vector := X"00000000";
    SPARE_WORD1                                    : bit_vector := X"00000000";
    SPARE_WORD2                                    : bit_vector := X"00000000";
    SPARE_WORD3                                    : bit_vector := X"00000000";

    TL_RBYPASS                                     : string     := "FALSE";
    TL_TFC_DISABLE                                 : string     := "FALSE";
    TL_TX_CHECKS_DISABLE                           : string     := "FALSE";
    EXIT_LOOPBACK_ON_EI                            : string     := "TRUE";

    CFG_ECRC_ERR_CPLSTAT                           : integer    := 0;
    CAPABILITIES_PTR                               : bit_vector := X"40";
    CRM_MODULE_RSTS                                : bit_vector := X"00";
    DEV_CAP_ENABLE_SLOT_PWR_LIMIT_SCALE            : string     := "TRUE";
    DEV_CAP_ENABLE_SLOT_PWR_LIMIT_VALUE            : string     := "TRUE";
    DEV_CAP_FUNCTION_LEVEL_RESET_CAPABLE           : string     := "FALSE";
    DEV_CAP_ROLE_BASED_ERROR                       : string     := "TRUE";
    DEV_CAP_RSVD_14_12                             : integer    := 0;
    DEV_CAP_RSVD_17_16                             : integer    := 0;
    DEV_CAP_RSVD_31_29                             : integer    := 0;
    DEV_CONTROL_AUX_POWER_SUPPORTED                : string     := "FALSE";

    VC_CAP_ID                                      : bit_vector := X"0002";
    VC_CAP_VERSION                                 : bit_vector := X"1";
    VSEC_CAP_HDR_ID                                : bit_vector := X"1234";
    VSEC_CAP_HDR_LENGTH                            : bit_vector := X"018";
    VSEC_CAP_HDR_REVISION                          : bit_vector := X"1";
    VSEC_CAP_ID                                    : bit_vector := X"000b";
    VSEC_CAP_IS_LINK_VISIBLE                       : string     := "TRUE";
    VSEC_CAP_VERSION                               : bit_vector := X"1";

    DISABLE_ERR_MSG                                : string     := "FALSE";
    DISABLE_LOCKED_FILTER                          : string     := "FALSE";
    DISABLE_PPM_FILTER                             : string     := "FALSE";
    ENDEND_TLP_PREFIX_FORWARDING_SUPPORTED         : string     := "FALSE";
    INTERRUPT_STAT_AUTO                            : string     := "TRUE";
    MPS_FORCE                                      : string     := "FALSE";
    PM_ASPML0S_TIMEOUT                             : bit_vector := X"0000";
    PM_ASPML0S_TIMEOUT_EN                          : string     := "FALSE";
    PM_ASPML0S_TIMEOUT_FUNC                        : integer    := 0;
    PM_ASPM_FASTEXIT                               : string     := "FALSE";
    PM_MF                                          : string     := "FALSE";

    RP_AUTO_SPD                                    : bit_vector := X"1";
    RP_AUTO_SPD_LOOPCNT                            : bit_vector := X"1f";
    SIM_VERSION                                    : string     := "1.0";
    SSL_MESSAGE_AUTO                               : string     := "FALSE";
    TECRC_EP_INV                                   : string     := "FALSE";
    UR_CFG1                                        : string     := "TRUE";
    USE_RID_PINS                                   : string     := "FALSE";

    -- New Parameters
    DEV_CAP2_ENDEND_TLP_PREFIX_SUPPORTED           : string     := "FALSE";
    DEV_CAP2_EXTENDED_FMT_FIELD_SUPPORTED          : string     := "FALSE";
    DEV_CAP2_LTR_MECHANISM_SUPPORTED               : string     := "FALSE";
    DEV_CAP2_MAX_ENDEND_TLP_PREFIXES               : bit_vector := X"0";
    DEV_CAP2_NO_RO_ENABLED_PRPR_PASSING            : string     := "FALSE";

    LINK_CAP_SURPRISE_DOWN_ERROR_CAPABLE           : string     := "FALSE";

    AER_CAP_ID                                     : bit_vector := X"0001";
    AER_CAP_VERSION                                : bit_vector := X"1";

    RBAR_CAP_ID                                    : bit_vector := X"0015";
    RBAR_CAP_NEXTPTR                               : bit_vector := X"000";
    RBAR_CAP_VERSION                               : bit_vector := X"1";
    PCIE_USE_MODE                                  : string     := "1.0";
    PCIE_GT_DEVICE                                 : string     := "GTP";
    PCIE_CHAN_BOND                                 : integer    := 1;
    PCIE_PLL_SEL                                   : string     := "CPLL";
    PCIE_ASYNC_EN                                  : string     := "FALSE";
    PCIE_TXBUF_EN                                  : string     := "FALSE"
  );
  port (

     -------------------------------------------------------------------------------------------------------------------
     -- PCI Express (pci_exp) Interface                                                                            --
     -------------------------------------------------------------------------------------------------------------------
      pci_exp_txp                                : out std_logic_vector(0 downto 0);
      pci_exp_txn                                : out std_logic_vector(0 downto 0);
      pci_exp_rxp                                : in std_logic_vector(0 downto 0);
      pci_exp_rxn                                : in std_logic_vector(0 downto 0);

     -------------------------------------------------------------------------------------------------------------------
     -- Clock & GT COMMON Sharing Interface                                                                         //
     -------------------------------------------------------------------------------------------------------------------
     -- Shared Logic Internal
      int_pclk_out_slave                         : out std_logic;  
      int_pipe_rxusrclk_out                      : out std_logic;    
      int_rxoutclk_out                           : out std_logic_vector(0 downto 0);
      int_dclk_out                               : out std_logic;   
      int_userclk1_out                           : out std_logic;    
      int_userclk2_out                           : out std_logic;     
      int_oobclk_out                             : out std_logic;      
      int_mmcm_lock_out                          : out std_logic;       
      int_qplllock_out                           : out std_logic_vector(1 downto 0);          
      int_qplloutclk_out                         : out std_logic_vector(1 downto 0);        
      int_qplloutrefclk_out                      : out std_logic_vector(1 downto 0);             
      int_pclk_sel_slave                         : in std_logic_vector(0 downto 0);        

      pipe_pclk_in                               : in std_logic;
      pipe_rxusrclk_in                           : in std_logic;
      pipe_rxoutclk_in                           : in std_logic_vector(0 downto 0);
      pipe_dclk_in                               : in std_logic;
      pipe_userclk1_in                           : in std_logic;
      pipe_userclk2_in                           : in std_logic;
      pipe_oobclk_in                             : in std_logic;
      pipe_mmcm_lock_in                          : in std_logic;

      pipe_txoutclk_out                          : out std_logic;
      pipe_rxoutclk_out                          : out std_logic_vector(0 downto 0);
      pipe_pclk_sel_out                          : out std_logic_vector(0 downto 0);
      pipe_gen3_out                              : out std_logic;

     -------------------------------------------------------------------------------------------------------------------
     -- AXI-S Interface                                                                                            --
     -------------------------------------------------------------------------------------------------------------------
      -- Common
      user_clk_out                               : out std_logic;
      user_reset_out                             : out std_logic;
      user_lnk_up                                : out std_logic;
      user_app_rdy                               : out std_logic;

      -- TX
      tx_buf_av                                  : out std_logic_vector(5 downto 0);
      tx_cfg_req                                 : out std_logic;
      tx_err_drop                                : out std_logic;
      s_axis_tx_tready                           : out std_logic;
      s_axis_tx_tdata                            : in std_logic_vector((C_DATA_WIDTH - 1) downto 0);
      s_axis_tx_tkeep                            : in std_logic_vector((C_DATA_WIDTH / 8 - 1) downto 0);
      s_axis_tx_tlast                            : in std_logic;
      s_axis_tx_tvalid                           : in std_logic;
      s_axis_tx_tuser                            : in std_logic_vector(3 downto 0);
      tx_cfg_gnt                                 : in std_logic;

      -- RX
      m_axis_rx_tdata                            : out std_logic_vector((C_DATA_WIDTH - 1) downto 0);
      m_axis_rx_tkeep                            : out std_logic_vector((C_DATA_WIDTH / 8 - 1) downto 0);
      m_axis_rx_tlast                            : out std_logic;
      m_axis_rx_tvalid                           : out std_logic;
      m_axis_rx_tready                           : in std_logic;
      m_axis_rx_tuser                            : out std_logic_vector(21 downto 0);
      rx_np_ok                                   : in std_logic;
      rx_np_req                                  : in std_logic;

      -- Flow Control
      fc_cpld                                    : out std_logic_vector(11 downto 0);
      fc_cplh                                    : out std_logic_vector(7 downto 0);
      fc_npd                                     : out std_logic_vector(11 downto 0);
      fc_nph                                     : out std_logic_vector(7 downto 0);
      fc_pd                                      : out std_logic_vector(11 downto 0);
      fc_ph                                      : out std_logic_vector(7 downto 0);
      fc_sel                                     : in std_logic_vector(2 downto 0);

     -------------------------------------------------------------------------------------------------------------------
     -- Configuration (CFG) Interface                                                                              --
     -------------------------------------------------------------------------------------------------------------------
     ---------------------------------------------------------------------
      -- EP and RP                                                      --
     ---------------------------------------------------------------------
      cfg_mgmt_do                                : out std_logic_vector (31 downto 0);
      cfg_mgmt_rd_wr_done                        : out std_logic;

      cfg_status                                 : out std_logic_vector(15 downto 0);
      cfg_command                                : out std_logic_vector(15 downto 0);
      cfg_dstatus                                : out std_logic_vector(15 downto 0);
      cfg_dcommand                               : out std_logic_vector(15 downto 0);
      cfg_lstatus                                : out std_logic_vector(15 downto 0);
      cfg_lcommand                               : out std_logic_vector(15 downto 0);
      cfg_dcommand2                              : out std_logic_vector(15 downto 0);
      cfg_pcie_link_state                        : out std_logic_vector(2 downto 0);

      cfg_pmcsr_pme_en                           : out std_logic;
      cfg_pmcsr_powerstate                       : out std_logic_vector(1 downto 0);
      cfg_pmcsr_pme_status                       : out std_logic;
      cfg_received_func_lvl_rst                  : out std_logic;

      -- Management Interface
      cfg_mgmt_di                                : in std_logic_vector (31 downto 0);
      cfg_mgmt_byte_en                           : in std_logic_vector (3 downto 0);
      cfg_mgmt_dwaddr                            : in std_logic_vector (9 downto 0);
      cfg_mgmt_wr_en                             : in std_logic;
      cfg_mgmt_rd_en                             : in std_logic;
      cfg_mgmt_wr_readonly                       : in std_logic;

      -- Error Reporting Interface
      cfg_err_ecrc                               : in std_logic;
      cfg_err_ur                                 : in std_logic;
      cfg_err_cpl_timeout                        : in std_logic;
      cfg_err_cpl_unexpect                       : in std_logic;
      cfg_err_cpl_abort                          : in std_logic;
      cfg_err_posted                             : in std_logic;
      cfg_err_cor                                : in std_logic;
      cfg_err_atomic_egress_blocked              : in std_logic;
      cfg_err_internal_cor                       : in std_logic;
      cfg_err_malformed                          : in std_logic;
      cfg_err_mc_blocked                         : in std_logic;
      cfg_err_poisoned                           : in std_logic;
      cfg_err_norecovery                         : in std_logic;
      cfg_err_tlp_cpl_header                     : in std_logic_vector(47 downto 0);
      cfg_err_cpl_rdy                            : out std_logic;
      cfg_err_locked                             : in std_logic;
      cfg_err_acs                                : in std_logic;
      cfg_err_internal_uncor                     : in std_logic;
      cfg_trn_pending                            : in std_logic;
      cfg_pm_halt_aspm_l0s                       : in std_logic;
      cfg_pm_halt_aspm_l1                        : in std_logic;
      cfg_pm_force_state_en                      : in std_logic;
      cfg_pm_force_state                         : in std_logic_vector(1 downto 0);
      cfg_dsn                                    : in std_logic_vector(63 downto 0);

     ---------------------------------------------------------------------
      -- EP Only                                                        --
     ---------------------------------------------------------------------
      cfg_interrupt                              : in std_logic;
      cfg_interrupt_rdy                          : out std_logic;
      cfg_interrupt_assert                       : in std_logic;
      cfg_interrupt_di                           : in std_logic_vector(7 downto 0);
      cfg_interrupt_do                           : out std_logic_vector(7 downto 0);
      cfg_interrupt_mmenable                     : out std_logic_vector(2 downto 0);
      cfg_interrupt_msienable                    : out std_logic;
      cfg_interrupt_msixenable                   : out std_logic;
      cfg_interrupt_msixfm                       : out std_logic;
      cfg_interrupt_stat                         : in std_logic;
      cfg_pciecap_interrupt_msgnum               : in std_logic_vector(4 downto 0);
      cfg_to_turnoff                             : out std_logic;
      cfg_turnoff_ok                             : in std_logic;
      cfg_bus_number                             : out std_logic_vector(7 downto 0);
      cfg_device_number                          : out std_logic_vector(4 downto 0);
      cfg_function_number                        : out std_logic_vector(2 downto 0);
      cfg_pm_wake                                : in std_logic;

     ---------------------------------------------------------------------
      -- RP Only                                                        --
     ---------------------------------------------------------------------
      cfg_pm_send_pme_to                         : in std_logic;
      cfg_ds_bus_number                          : in std_logic_vector(7 downto 0);
      cfg_ds_device_number                       : in std_logic_vector(4 downto 0);
      cfg_ds_function_number                     : in std_logic_vector(2 downto 0);

      cfg_mgmt_wr_rw1c_as_rw                     : in std_logic;
      cfg_msg_received                           : out std_logic;
      cfg_msg_data                               : out std_logic_vector(15 downto 0);

      cfg_bridge_serr_en                         : out std_logic;
      cfg_slot_control_electromech_il_ctl_pulse  : out std_logic;
      cfg_root_control_syserr_corr_err_en        : out std_logic;
      cfg_root_control_syserr_non_fatal_err_en   : out std_logic;
      cfg_root_control_syserr_fatal_err_en       : out std_logic;
      cfg_root_control_pme_int_en                : out std_logic;
      cfg_aer_rooterr_corr_err_reporting_en      : out std_logic;
      cfg_aer_rooterr_non_fatal_err_reporting_en : out std_logic;
      cfg_aer_rooterr_fatal_err_reporting_en     : out std_logic;
      cfg_aer_rooterr_corr_err_received          : out std_logic;
      cfg_aer_rooterr_non_fatal_err_received     : out std_logic;
      cfg_aer_rooterr_fatal_err_received         : out std_logic;

      cfg_msg_received_err_cor                   : out std_logic;
      cfg_msg_received_err_non_fatal             : out std_logic;
      cfg_msg_received_err_fatal                 : out std_logic;
      cfg_msg_received_pm_as_nak                 : out std_logic;
      cfg_msg_received_pm_pme                    : out std_logic;
      cfg_msg_received_pme_to_ack                : out std_logic;
      cfg_msg_received_assert_int_a              : out std_logic;
      cfg_msg_received_assert_int_b              : out std_logic;
      cfg_msg_received_assert_int_c              : out std_logic;
      cfg_msg_received_assert_int_d              : out std_logic;
      cfg_msg_received_deassert_int_a            : out std_logic;
      cfg_msg_received_deassert_int_b            : out std_logic;
      cfg_msg_received_deassert_int_c            : out std_logic;
      cfg_msg_received_deassert_int_d            : out std_logic;
      cfg_msg_received_setslotpowerlimit         : out std_logic;

     -------------------------------------------------------------------------------------------------------------------
     -- Physical Layer Control and Status (PL) Interface                                                           --
     -------------------------------------------------------------------------------------------------------------------
      pl_directed_link_change                    : in std_logic_vector(1 downto 0);
      pl_directed_link_width                     : in std_logic_vector(1 downto 0);
      pl_directed_link_speed                     : in std_logic;
      pl_directed_link_auton                     : in std_logic;
      pl_upstream_prefer_deemph                  : in std_logic;

      pl_sel_lnk_rate                            : out std_logic;
      pl_sel_lnk_width                           : out std_logic_vector(1 downto 0);
      pl_ltssm_state                             : out std_logic_vector(5 downto 0);
      pl_lane_reversal_mode                      : out std_logic_vector(1 downto 0);

      pl_phy_lnk_up                              : out std_logic;
      pl_tx_pm_state                             : out std_logic_vector(2 downto 0);
      pl_rx_pm_state                             : out std_logic_vector(1 downto 0);

      pl_link_upcfg_cap                          : out std_logic;
      pl_link_gen2_cap                           : out std_logic;
      pl_link_partner_gen2_supported             : out std_logic;
      pl_initial_link_width                      : out std_logic_vector(2 downto 0);

      pl_directed_change_done                    : out std_logic;

     ---------------------------------------------------------------------
      -- EP Only                                                        --
     ---------------------------------------------------------------------
      pl_received_hot_rst                        : out std_logic;
     ---------------------------------------------------------------------
      -- RP Only                                                        --
     ---------------------------------------------------------------------
      pl_transmit_hot_rst                        : in std_logic;
      pl_downstream_deemph_source                : in std_logic;
     -------------------------------------------------------------------------------------------------------------------
     -- AER interface                                                                                              --
     -------------------------------------------------------------------------------------------------------------------
      cfg_err_aer_headerlog                      : in std_logic_vector(127 downto 0);
      cfg_aer_interrupt_msgnum                   : in std_logic_vector(4 downto 0);
      cfg_err_aer_headerlog_set                  : out std_logic;
      cfg_aer_ecrc_check_en                      : out std_logic;
      cfg_aer_ecrc_gen_en                        : out std_logic;
     -------------------------------------------------------------------------------------------------------------------
     -- VC interface                                                                                               --
     -------------------------------------------------------------------------------------------------------------------
      cfg_vc_tcvc_map                            : out std_logic_vector(6 downto 0);
     ----------------------------------------------------------------------------------------------------------------//
     -- PCIe Fast Config: STARTUP primitive Interface - only used in Tandem configurations                           //
     ----------------------------------------------------------------------------------------------------------------//
      startup_eos_in                             : in std_logic;    -- 1-bit input: This signal should be driven by the EOS output of the STARTUP primitive.
      startup_cfgclk                             : out std_logic := '0';   -- 1-bit output: Configuration main clock output
      startup_cfgmclk                            : out std_logic := '0';   -- 1-bit output: Configuration internal oscillator clock output
      startup_eos                                : out std_logic := '0';   -- 1-bit output: Active high output signal indicating the End Of Startup
      startup_preq                               : out std_logic := '0';   -- 1-bit output: PROGRAM request to fabric output

      startup_clk                                :  in std_logic;   -- 1-bit input: User start-up clock input
      startup_gsr                                :  in std_logic;   -- 1-bit input: Global Set/Reset input (GSR cannot be used for the port name)
      startup_gts                                :  in std_logic;   -- 1-bit input: Global 3-state input (GTS cannot be used for the port name)
      startup_keyclearb                          :  in std_logic;   -- 1-bit input: Clear AES Decrypter Key input from Battery-Backed RAM (BBRAM)
      startup_pack                               :  in std_logic;   -- 1-bit input: PROGRAM acknowledge input
      startup_usrcclko                           :  in std_logic;   -- 1-bit input: User CCLK input
      startup_usrcclkts                          :  in std_logic;   -- 1-bit input: User CCLK 3-state enable input
      startup_usrdoneo                           :  in std_logic;   -- 1-bit input: User DONE pin output control
      startup_usrdonets                          :  in std_logic;   -- 1-bit input: User DONE 3-state enable output
     ----------------------------------------------------------------------------------------------------------------//
     -- PCIe Fast Config: ICAP primitive Interface - only used in Tandem configurations                              //
     ----------------------------------------------------------------------------------------------------------------//
      icap_clk                                   :  in std_logic;
      icap_csib                                  :  in std_logic;
      icap_rdwrb                                 :  in std_logic;
      icap_i                                     :  in std_logic_vector(31 downto 0);
      icap_o                                     :  out std_logic_vector(31 downto 0):= (others => '0');

      qpll_drp_crscode                           : in std_logic_vector(11 downto 0);
      qpll_drp_fsm                               : in std_logic_vector(17 downto 0);
      qpll_drp_done                              : in std_logic_vector(1 downto 0);
      qpll_drp_reset                             : in std_logic_vector(1 downto 0);
      qpll_qplllock                              : in std_logic_vector(1 downto 0);
      qpll_qplloutclk                            : in std_logic_vector(1 downto 0);
      qpll_qplloutrefclk                         : in std_logic_vector(1 downto 0);
      qpll_qplld                                 : out std_logic;
      qpll_qpllreset                             : out std_logic_vector(1 downto 0);
      qpll_drp_clk                               : out std_logic;
      qpll_drp_rst_n                             : out std_logic;
      qpll_drp_ovrd                              : out std_logic;
      qpll_drp_gen3                              : out std_logic;
      qpll_drp_start                             : out std_logic;
      pipe_txprbssel                             : in std_logic_vector(2 downto 0);
      pipe_rxprbssel                             : in std_logic_vector(2 downto 0);
      pipe_txprbsforceerr                        : in std_logic;
      pipe_rxprbscntreset                        : in std_logic;
      pipe_loopback                              : in std_logic_vector(2 downto 0);
      pipe_rxprbserr                             : out std_logic_vector(0 downto 0);
      pipe_txinhibit                             : in std_logic_vector(0 downto 0);
      pipe_rst_fsm                               : out std_logic_vector(4 downto 0);
      pipe_qrst_fsm                              : out std_logic_vector(11 downto 0);
      pipe_rate_fsm                              : out std_logic_vector(4 downto 0);
      pipe_sync_fsm_tx                           : out std_logic_vector(5 downto 0);
      pipe_sync_fsm_rx                           : out std_logic_vector(6 downto 0);
      pipe_drp_fsm                               : out std_logic_vector(6 downto 0);
      pipe_rst_idle                              : out std_logic;
      pipe_qrst_idle                             : out std_logic;
      pipe_rate_idle                             : out std_logic;
      pipe_eyescandataerror                      : out std_logic_vector(0  downto 0);
      pipe_rxstatus                              : out std_logic_vector(2 downto 0); 
      pipe_dmonitorout                           : out std_logic_vector(14 downto 0);

      pipe_cpll_lock                             : out std_logic_vector(0 downto 0); 
      pipe_qpll_lock                             : out std_logic_vector(0 downto 0); 
      pipe_rxpmaresetdone                        : out std_logic_vector(0 downto 0);  
      pipe_rxbufstatus                           : out std_logic_vector(2 downto 0);     
      pipe_txphaligndone                         : out std_logic_vector(0 downto 0);   
      pipe_txphinitdone                          : out std_logic_vector(0 downto 0);      
      pipe_txdlysresetdone                       : out std_logic_vector(0 downto 0);    
      pipe_rxphaligndone                         : out std_logic_vector(0 downto 0);     
      pipe_rxdlysresetdone                       : out std_logic_vector(0 downto 0);      
      pipe_rxsyncdone                            : out std_logic_vector(0 downto 0);      
      pipe_rxdisperr                             : out std_logic_vector(7 downto 0);     
      pipe_rxnotintable                          : out std_logic_vector(7 downto 0);     
      pipe_rxcommadet                            : out std_logic_vector(0 downto 0);   

      gt_ch_drp_rdy                              : out std_logic_vector(0  downto 0);
      pipe_debug_0                               : out std_logic_vector(0  downto 0);
      pipe_debug_1                               : out std_logic_vector(0  downto 0);
      pipe_debug_2                               : out std_logic_vector(0  downto 0);
      pipe_debug_3                               : out std_logic_vector(0  downto 0);
      pipe_debug_4                               : out std_logic_vector(0  downto 0);
      pipe_debug_5                               : out std_logic_vector(0  downto 0);
      pipe_debug_6                               : out std_logic_vector(0  downto 0);
      pipe_debug_7                               : out std_logic_vector(0  downto 0);
      pipe_debug_8                               : out std_logic_vector(0  downto 0);
      pipe_debug_9                               : out std_logic_vector(0  downto 0);
      pipe_debug                                 : out std_logic_vector(31 downto 0);

      ext_ch_gt_drpclk                           : out std_logic;
      ext_ch_gt_drpaddr                          : in std_logic_vector(8 downto 0);
      ext_ch_gt_drpen                            : in std_logic_vector(0  downto 0);
      ext_ch_gt_drpdi                            : in std_logic_vector(15 downto 0);
      ext_ch_gt_drpwe                            : in std_logic_vector(0 downto 0);
      ext_ch_gt_drpdo                            : out std_logic_vector(15 downto 0);
      ext_ch_gt_drprdy                           : out std_logic_vector(0  downto 0);

     -------------------------------------------------------------------------------------------------------------------
     -- PCIe DRP Interface                                                                                         --
     -------------------------------------------------------------------------------------------------------------------
      pcie_drp_clk                               : in std_logic;
      pcie_drp_en                                : in std_logic;
      pcie_drp_we                                : in std_logic;
      pcie_drp_addr                              : in std_logic_vector(8 downto 0);
      pcie_drp_di                                : in std_logic_vector(15 downto 0);
      pcie_drp_do                                : out std_logic_vector(15 downto 0):= (others => '0');
      pcie_drp_rdy                               : out std_logic:='0';

     -------------------------------------------------------------------------------------------------------------------
     -- PIPE PORTS to TOP Level For PIPE SIMULATION with 3rd Party IP/BFM/Xilinx BFM
     -------------------------------------------------------------------------------------------------------------------
      common_commands_in                         : in std_logic_vector(11 downto 0); 
      pipe_rx_0_sigs                             : in std_logic_vector(24 downto 0); 
      pipe_rx_1_sigs                             : in std_logic_vector(24 downto 0); 
      pipe_rx_2_sigs                             : in std_logic_vector(24 downto 0); 
      pipe_rx_3_sigs                             : in std_logic_vector(24 downto 0); 
      pipe_rx_4_sigs                             : in std_logic_vector(24 downto 0); 
      pipe_rx_5_sigs                             : in std_logic_vector(24 downto 0); 
      pipe_rx_6_sigs                             : in std_logic_vector(24 downto 0); 
      pipe_rx_7_sigs                             : in std_logic_vector(24 downto 0); 
                                                                      
      common_commands_out                        : out std_logic_vector(11 downto 0); 
      pipe_tx_0_sigs                             : out std_logic_vector(24 downto 0); 
      pipe_tx_1_sigs                             : out std_logic_vector(24 downto 0); 
      pipe_tx_2_sigs                             : out std_logic_vector(24 downto 0); 
      pipe_tx_3_sigs                             : out std_logic_vector(24 downto 0); 
      pipe_tx_4_sigs                             : out std_logic_vector(24 downto 0); 
      pipe_tx_5_sigs                             : out std_logic_vector(24 downto 0); 
      pipe_tx_6_sigs                             : out std_logic_vector(24 downto 0); 
      pipe_tx_7_sigs                             : out std_logic_vector(24 downto 0); 
     -------------------------------------------------------------------------------------------------------------------
     --  System(SYS) Interface                                                                                      --
     -------------------------------------------------------------------------------------------------------------------

      pipe_mmcm_rst_n                            : in std_logic;   --     // Async      | Async
      sys_clk                                    : in std_logic;
      sys_rst_n                                  : in std_logic
);
end pcie_7x_core_top;

  architecture pcie_7x of pcie_7x_core_top is
   attribute DowngradeIPIdentifiedWarnings: string;
   attribute DowngradeIPIdentifiedWarnings of pcie_7x : architecture is "yes";

   attribute CORE_GENERATION_INFO : string;
   attribute CORE_GENERATION_INFO of pcie_7x : ARCHITECTURE is
     "pcie_7x,pcie_7x_v3_3_11,{LINK_CAP_MAX_LINK_SPEED=1,LINK_CAP_MAX_LINK_WIDTH=1,PCIE_CAP_DEVICE_PORT_TYPE=0000,DEV_CAP_MAX_PAYLOAD_SUPPORTED=2,USER_CLK_FREQ=1,REF_CLK_FREQ=0,MSI_CAP_ON=TRUE,MSI_CAP_MULTIMSGCAP=0,MSI_CAP_MULTIMSG_EXTENSION=0,MSIX_CAP_ON=FALSE,TL_TX_RAM_RADDR_LATENCY=0,TL_TX_RAM_RDATA_LATENCY=2,TL_RX_RAM_RADDR_LATENCY=0,TL_RX_RAM_RDATA_LATENCY=2,TL_RX_RAM_WRITE_LATENCY=0," &
     "VC0_TX_LASTPACKET=29,VC0_RX_RAM_LIMIT=7FF,VC0_TOTAL_CREDITS_PH=32,VC0_TOTAL_CREDITS_PD=437,VC0_TOTAL_CREDITS_NPH=12,VC0_TOTAL_CREDITS_NPD=24,VC0_TOTAL_CREDITS_CH=36,VC0_TOTAL_CREDITS_CD=461,VC0_CPL_INFINITE=TRUE,DEV_CAP_PHANTOM_FUNCTIONS_SUPPORT=0,DEV_CAP_EXT_TAG_SUPPORTED=FALSE,LINK_STATUS_SLOT_CLOCK_CONFIG=TRUE,DISABLE_LANE_REVERSAL=TRUE,DISABLE_SCRAMBLING=FALSE,DSN_CAP_ON=FALSE,REVISION_ID=00,VC_CAP_ON=FALSE}";
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
