AM4511/test_migrate_iris4/athena/local_ip/XGS_athena/hdl/controller/axiXGS_controller_v1_0.vhd

library ieee;
use ieee.std_logic_1164.all;
use ieee.numeric_std.all; 

library  work;
use work.regfile_xgs_ctrl_pack.all;

entity axiXGS_controller_v1_0 is 
	generic (
		-- Users to add parameters here
        G_SYS_CLK_PERIOD    : integer  := 16;
        G_SENSOR_FREQ       : integer  := 32400; 
		G_SIMULATION        : integer  := 0;
        G_KU706             : integer  := 0;
        -- User parameters ends
		-- Do not modify the parameters beyond this line


		-- Parameters of Axi Slave Bus Interface S00_AXI
		C_S_AXI_DATA_WIDTH	: integer	:= 32;
		C_S_AXI_ADDR_WIDTH	: integer	:= 12
	);
	port (
		-- Users to add ports here

        ------------------------------------------
        -- CMOS INTERFACE TO SENSOR
        ------------------------------------------
        xgs_power_good          : in  std_logic;
        xgs_clk_pll_en          : out std_logic;
        xgs_reset_n             : out std_logic;
        
        xgs_fwsi_en             : out std_logic;
        
        xgs_sclk                : out std_logic;
        xgs_cs_n                : out std_logic;
        xgs_sdout               : out std_logic;
        xgs_sdin                : in  std_logic;
        
        xgs_trig_int            : out std_logic;
        xgs_trig_rd             : out std_logic;
        
        xgs_monitor0            : in std_logic;
        xgs_monitor1            : in std_logic;
        xgs_monitor2            : in std_logic;
        
        ---------------------------------------------------------------------------
        --  OUTPUTS 
        ---------------------------------------------------------------------------
        anput_ext_trig         : in    std_logic;    
        
        anput_strobe_out       : out   std_logic;                       --
        anput_exposure_out     : out   std_logic;                       --
        anput_trig_rdy_out     : out   std_logic;                       --
        
        led_out                : out   std_logic_vector(1 downto 0);     -- led_out(0) --> vert, led_out(1) --> rouge

        
        ---------------------------------------------------------------------------
        --  Signals to Datapath/DMA
        ---------------------------------------------------------------------------
        abort_readout_datapath          : out   std_logic := '0';
        dma_idle                        : in    std_logic := '1';

        strobe_DMA_P1                   : out   std_logic := '0';            -- Load DMA 1st stage registers  
        strobe_DMA_P2                   : out   std_logic := '0';            -- Load DMA 2nd stage registers 
        
        curr_db_GRAB_ROI2_EN            : out   std_logic := '0';
        
        curr_db_y_start_ROI1            : out   std_logic_vector(11 downto 0):= (others=>'0');     -- 1-base
        curr_db_nblines_ROI1            : out   std_logic_vector(11 downto 0):= (others=>'0');     -- 1-base  
                 
        curr_db_y_start_ROI2            : out   std_logic_vector(11 downto 0):= (others=>'0');     -- 1-base  
        curr_db_nblines_ROI2            : out   std_logic_vector(11 downto 0):= (others=>'0');     -- 1-base

        curr_db_subsampling_X           : out   std_logic:='0';
        curr_db_subsampling_Y           : out   std_logic:='0';
        
        curr_db_BUFFER_ID               : out   std_logic:='0';
        
        
		-- User ports ends
		-- Do not modify the ports beyond this line

		-- Ports of Axi Slave Bus Interface S00_AXI
		s_axi_aclk	    : in std_logic;
		s_axi_aresetn	: in std_logic;
		s_axi_awaddr	: in std_logic_vector(C_S_AXI_ADDR_WIDTH-1 downto 0);
		s_axi_awprot	: in std_logic_vector(2 downto 0);
		s_axi_awvalid	: in std_logic;
		s_axi_awready	: out std_logic;
		s_axi_wdata	    : in std_logic_vector(C_S_AXI_DATA_WIDTH-1 downto 0);
		s_axi_wstrb	    : in std_logic_vector((C_S_AXI_DATA_WIDTH/8)-1 downto 0);
		s_axi_wvalid	: in std_logic;
		s_axi_wready	: out std_logic;
		s_axi_bresp	    : out std_logic_vector(1 downto 0);
		s_axi_bvalid	: out std_logic;
		s_axi_bready	: in std_logic;
		s_axi_araddr	: in std_logic_vector(C_S_AXI_ADDR_WIDTH-1 downto 0);
		s_axi_arprot	: in std_logic_vector(2 downto 0);
		s_axi_arvalid	: in std_logic;
		s_axi_arready	: out std_logic;
		s_axi_rdata	    : out std_logic_vector(C_S_AXI_DATA_WIDTH-1 downto 0);
		s_axi_rresp	    : out std_logic_vector(1 downto 0);
		s_axi_rvalid	: out std_logic;
		s_axi_rready	: in std_logic
	);
end axiXGS_controller_v1_0;

architecture arch_imp of axiXGS_controller_v1_0 is

  -------------------------------
  -- COMPONENT AxiSlave2Reg 
  -------------------------------
  component AxiSlave2Reg 
	generic (
		-- Width of S_AXI data bus
		C_S_AXI_DATA_WIDTH	: integer	:= 32;
		-- Width of S_AXI address bus
		C_S_AXI_ADDR_WIDTH	: integer	:= 12
	);
	port (
		-- Users to add ports here
        ---------------------------------------------------------------------------
        -- FDK IDE registerfile interface
        ---------------------------------------------------------------------------
        reg_read          : out std_logic;
        reg_write         : out std_logic;
        reg_addr          : out std_logic_vector(C_S_AXI_ADDR_WIDTH-1 downto 2);
        reg_beN           : out std_logic_vector((C_S_AXI_DATA_WIDTH/8)-1 downto 0);
        reg_writedata     : out std_logic_vector(C_S_AXI_DATA_WIDTH-1 downto 0);
        reg_readdataValid : in  std_logic;
        reg_readdata      : in  std_logic_vector(C_S_AXI_DATA_WIDTH-1 downto 0);

        ---------------------------------------------------------------------------
        -- AXI S MM 
        ---------------------------------------------------------------------------    
        S_AXI_ACLK        : in std_logic;
        S_AXI_ARESETN     : in std_logic;
        S_AXI_AWADDR      : in std_logic_vector(C_S_AXI_ADDR_WIDTH-1 downto 0);
        --S_AXI_AWPROT      : in std_logic_vector(2 downto 0);
        S_AXI_AWVALID     : in std_logic;
        S_AXI_AWREADY     : out std_logic;
        
        S_AXI_WDATA       : in std_logic_vector(C_S_AXI_DATA_WIDTH-1 downto 0);
        S_AXI_WSTRB       : in std_logic_vector((C_S_AXI_DATA_WIDTH/8)-1 downto 0);
        S_AXI_WVALID      : in std_logic;
        S_AXI_WREADY      : out std_logic;
        
        S_AXI_BRESP       : out std_logic_vector(1 downto 0);
        S_AXI_BVALID      : out std_logic;
        S_AXI_BREADY      : in std_logic;
        
        S_AXI_ARADDR      : in std_logic_vector(C_S_AXI_ADDR_WIDTH-1 downto 0);
        --S_AXI_ARPROT      : in std_logic_vector(2 downto 0);
        S_AXI_ARVALID     : in std_logic;
        S_AXI_ARREADY     : out std_logic;
        
        S_AXI_RDATA       : out std_logic_vector(C_S_AXI_DATA_WIDTH-1 downto 0);
        S_AXI_RRESP       : out std_logic_vector(1 downto 0);
        S_AXI_RVALID      : out std_logic;
        S_AXI_RREADY      : in std_logic
        
	);
  end component;

  
  -------------------------------
  -- COMPONENT regfile_xgs_ctrl
  -------------------------------
  component regfile_xgs_ctrl
    port (
      resetN        : in    std_logic;                                           -- System reset
      sysclk        : in    std_logic;                                           -- System clock
      regfile       : inout REGFILE_XGS_CTRL_TYPE := INIT_REGFILE_XGS_CTRL_TYPE;     -- Register file
      ------------------------------------------------------------------------------------
      -- Interface name: registerFileIF
      -- Description: 
      ------------------------------------------------------------------------------------
      reg_read      : in    std_logic;                                           -- Read
      reg_write     : in    std_logic;                                           -- Write
      reg_addr      : in    std_logic_vector(C_S_AXI_ADDR_WIDTH-1 downto 2);     -- Address
      reg_beN       : in    std_logic_vector((C_S_AXI_DATA_WIDTH/8)-1 downto 0); -- Byte enable
      reg_writedata : in    std_logic_vector(C_S_AXI_DATA_WIDTH-1 downto 0);     -- Write data
      reg_readdata  : out   std_logic_vector(C_S_AXI_DATA_WIDTH-1 downto 0)      -- Read data
    );
  end component;

  
  -------------------------------
  -- COMPONENT XGS CONTROLLER
  -------------------------------  
   component xgs_ctrl
   generic(  G_KU706               : integer := 0;
             G_SIMULATION          : integer := 0;
             G_SYS_CLK_PERIOD      : integer := 16;
             G_SENSOR_FREQ         : integer := 32400            
          );
   port (  
           sys_reset_n                     : in  std_logic;      --Reset pour le controleur au complet
           sys_reset_n_power               : in  std_logic;      --Reset pour le module de power
           
           sys_clk                         : in  std_logic;

           ---------------------------------------------------------------------------
           --  CMOS IF signals
           ---------------------------------------------------------------------------
           xgs_power_good                  : in  std_logic;      -- power good
           xgs_osc_en                      : out std_logic;
           xgs_reset_n                     : out std_logic;
         
           xgs_sclk                        : out std_logic;
           xgs_ssn                         : out std_logic;
           xgs_mosi                        : out std_logic;
           xgs_miso                        : in  std_logic;

           xgs_trig_int                    : out std_logic;
           xgs_trig_rd                     : out std_logic;
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
