AM4511/test_migrate_iris4/(commit log)

2019-09-20 Good starting point. First PnR without critical warning and error
    [csib_top.vhd]
2019-09-27 Modified script to support the device xc7z012
2019-10-18 Implement csib_xc7z007s_espi mockup in xc7z007sclg225-1
    [xgs_sensor_pinout_mapping.xlsx]
2019-12-13 Power Analysis using excell spreadsheet. The Xilinx Artix 7 is now completed and match a real place and route
    [7_Series_XPE_2019_1_2.xlsm]
2019-12-13 First draft of Artix7 Cyclone V Polar Fire
    [7_Series_XPE_2019_1_2.xlsm]
2019-12-16 Updated RAM and IO sections
    [7_Series_XPE_2019_1_2.xlsm]
2019-12-17 Added Power Analysis scripts for the 2 FPGA Xilinx Artix7. Work in progress. This commit is a backup only
2019-12-18 Sandbox cleanup. The FPGA has been selected. Soon ready to merge this branch in the master and start to work on implementation of the 2 FPGAs
    [7_Series_Schematic_Review_Recommendations.xlsm, 7_Series_XPE_2019_1_2.xlsm, lattice_eval_board.xls, pinout.csv]
2020-01-09 Debug the Hyperram IP Core . It was having IO instantiation problems
    [ares_espi_xc7a50t.vhd, compile.xdc, pinout.xdc]
2020-01-10 Updated pinout of the Ares FPFA for the board level
2020-01-10 Updated backend scripts. Work in progress. Backup only
    [cfg_timer.xlsx]
2020-01-10 First time the PnR compile. Still some critical warnngs to be solved
    [Lpc_to_AXI_prodcons.vhd, Lpc_to_AXI_prodcons_S00_AXI.vhd, Lpc_to_AXI_prodcons_v1_0.vhd, Lpc_to_AXI_prodcons_v1_0_S00_AXI.vhd, compile.xdc]
2020-01-13 Updated athena backend scripts (added io and power report creation for board level)
2020-01-15 Update ares_pcie pinout according to Dmitri's recommendation SPI flash interface now support the QUADSPI pinout 3 Renamed RMII pin prefix to NCSI Renamed rpc_ Hyperbus prefix to hb_
2020-01-16 Fixed IOs instantiation and gpio connections in the ipi system.
    [ares.vhd, ares_pcie.vhd]
2020-01-16 Fixed ares_pcie.vhd. Component declaration port declaration had legacy mdio ports still present. I removed them
    [ares_pcie.vhd]
2020-01-16 Touchup in the pinout assignment. The system reset are now 3.3 volts Also added some extra ON Semi documentation
    [pinout.xdc]
2020-01-16 New pinout release for the board level. The pinout was generated in the firmware ares_pcie_xc7a50t_1579204826.board_level
2020-01-17 Modified board_level file generation
2020-01-17 Big project refactoring
    [7_Series_Schematic_Review_Recommendations.xlsm, 7_Series_XPE_2019_1_2.xlsm, lattice_eval_board.xls, pinout.csv, xgs_sensor_pinout_mapping.xlsx]
2020-01-20 Changement de noms de repertoire dans les scrips. Changement de nom Athena_hispi a Athena
2020-01-21 documented the ares FPGA pinout (rev 0.1 is the current pinout)
2020-01-22 Modifications au pinout de Athena: 1) Led(1) migre a la pin D17 . Elle était sur PUDC. 2) Ajoute le signal « XGS_clk_pll_en » a la pin G3 (enable du oscillateur du senseur) 3)La Bank0 est maintenant 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
    4) TBD : Reste à finaliser le séquencement des powers du XGS. Si le séquencement est fait par un PMIC, j’aimerais surement un signal XGS_all_power_ok.
    [athena.vhd, pinout.xdc]
2020-01-30 Fixed reset timings in the hb ipcores Fixed clock timing on the ncsi IO
    [ares_pcie.vhd]
2020-02-05 Model supports XGS12M and XGS5M MUX modes. Simulation is done through HW trig(TRIG_INT pin) instead of Model automatic sequencer mode. Test image is now a diagonal ramp
2020-02-10 port the validation framework to Vivado 2019.1
2020-02-14 First version of the validation framework that compile in xvsim. Note the simulation does not run yet
    On branch amarchan_new_axi_hispi
    Your branch is up-to-date with 'origin/amarchan_new_axi_hispi'.
    Changes to be committed:
    modified: XCelerator/XGS12000_XCelerator_src/tb_AXI_VIP_Master_behav.wcfg
    modified: ipcores
    modified: local_ip/ip/axi_xgs_remapper_v3_00/component.xml
    modified: local_ip/ip/axi_xgs_remapper_v3_00/gui/xgs12m_remapper_v3_0.gtcl
    modified: local_ip/ip/axi_xgs_remapper_v3_00/rtl/gearbox_out.vhd
    modified: local_ip/ip/axi_xgs_remapper_v3_00/xgui/xgs12m_remapper_v3_0.tcl
    modified: local_ip/ip/validation/tcl/create_XCelerator_artix7.tcl
    Changes not staged fo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
2020-02-18 Backup only On branch amarchan_new_axi_hispi Your branch is up-to-date with 'origin/amarchan_new_axi_hispi'.
    Untracked files:
    XCelerator/XGS12000_XCelerator_src/ip/axi_video_xgs_decoder_v2_00/doc/~$i_xgs_decoder_datasheet.docx
    ../doc/schematic_review/
    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
2020-02-25 Updated axiHiSPi ip-core
    Changes not staged for commit:
    modified: ipcores (untracked content)
    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
2020-02-26 Renaming cores to ip_core
    On branch amarchan_ares_devlopment
    Your branch is up-to-date with 'origin/amarchan_ares_devlopment'.
    modified: ../.gitmodules
    modified: backend/create_ares.tcl
    new file: ipcores
    renamed: cores/Lpc_to_AXI_prodcons_1.0/bd/bd.tcl -> local_ip/Lpc_to_AXI_prodcons_1.0/bd/bd.tcl
    renamed: cores/Lpc_to_AXI_prodcons_1.0/component.xml -> local_ip/Lpc_to_AXI_prodcons_1.0/component.xml
    renamed: cores/Lpc_to_AXI_prodcons_1.0/drivers/Lpc_to_AXI_prodcons_v1_0/data/Lpc_to_AXI_prodcons.mdd -> local_ip/Lpc_to_AXI_prodcons_1.0/drivers/Lpc_to_AXI_prodcons_v1_0/data/Lpc_to_AXI_prodcons.mdd
    renamed: cores/Lpc_to_AXI_prodcons_1.0/driver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
2020-02-27 Added files for the schematic review of the sensor board On branch amarchan_ares_schematic_review Changes to be committed: new file: ../pinout/xc7a35tcpg236pkg.txt new file: ../pinout/xc7a50tcpg236pk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
    [ares_xc7a50t_1582747176.csv, ares_xc7a50t_1582747176.xlsx]
2020-02-27 Added shematic review files
    [7_Series_Schematic_Review_Recommendations.xlsm]
2020-02-27 Completed the Xilinx 7_Series_Schematic_Review_Recommendations.xlsm for the 7571-004-00 REV A board Found many issues. On branch amarchan_ares_schematic_review Your branch is up-to-date with 'origin/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
    modified: ../ares_pcie/backend/pinout.xdc
    modified: ../ares_pcie/doc/xilinx/7_Series_Schematic_Review_Recommendations.xlsm
    renamed: ../ares_pcie/doc/xilinx/ug470_7Series_Config(3).pdf -> ../ares_pcie/doc/xilinx/ug470_7Series_Config.pdf
    new file: ../ares_pcie/doc/xilinx/ug475_7Series_Pkg_Pinout.pdf
    new file: ../ares_pcie/doc/xilinx/ug482_7Series_GTP_Transceivers.pdf
    new file: ../ares_pcie/doc/xilinx/ug908-vivado-progra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
    [7_Series_Schematic_Review_Recommendations.xlsm]
2020-02-27 Missed some typos On branch amarchan_ares_schematic_review Your branch is up-to-date with 'origin/amarchan_ares_schematic_review'.
    modified: ../doc/schematic_review/7571-00 Feb 21_commented_by_all.pdf
    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
    [7_Series_Schematic_Review_Recommendations.xlsm]
2020-02-28 Touchup in the excel verification spreadsheet before sending to the HW team
    On branch amarchan_ares_schematic_review
    Your branch is up-to-date with 'origin/amarchan_ares_schematic_review'.
    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
    [7_Series_Schematic_Review_Recommendations.xlsm]
2020-02-28 Completed the ARES FPGA pinout check.Found some issues. See the Excel spreadsheet: ../doc/schematic_review/ares_xc7a50t_1582747176.xlsx
    modified: ../doc/schematic_review/ares_xc7a50t_1582747176.xlsx
    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
    [ares_xc7a50t_1582747176.xlsx]
2020-02-28 Clarify comments. On branch amarchan_ares_schematic_review Your branch is ahead of 'origin/amarchan_ares_schematic_review' by 1 commit. (use "git push" to publish your local commits)
    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
    [ares_xc7a50t_1582747176.xlsx]
2020-02-28 Updated the Hyperbus data interface pinout mapping. The pcb routing required pin swapping for facilating routing.
    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
    [pinout.xdc]
2020-02-28 Excel spreadsheet was not saved in previous commit
    [ares_xc7a50t_1582747176.xlsx]
2020-03-02 Fixed timing/pinout constraint issues On branch amarchan_ares_schematic_review Your branch is up-to-date with 'origin/amarchan_ares_schematic_review'.
    modified: compile.xdc
    modified: ncsi_timings.sdc
    modified: ../../doc/schematic_review/7571-00 Feb 21_commented_by_all.pdf
    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
    [compile.xdc]
2020-03-03 Top level that match zc706 portmap and the onsemi xcelerator FMC pinout On branch amarchan_new_axi_hispi Your branch is up-to-date with 'origin/amarchan_new_axi_hispi'.
    modified: backend/zynq/add_files.tcl
    new file: backend/zynq/download/readme.txt
    new file: backend/zynq/download/zc706_r1.0.ucf.xdc
    new file: backend/zynq/download/zc706_r1.0_ucf.ucf
    modified: backend/zynq/pinout.xdc
    modified: backend/zynq/system.tcl
    new file: design/athena_zc706.vhd
    modified: design/athena_zynq.vhd
    new file: doc/onsemi/xcelerator_fmc_pin_map.csv
    new file: doc/onsemi/xcelerator_fmc_pin_map.txt
    new file: doc/onsemi/xcelerator_fmc_pin_map.xlsx
    new fil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
    [xcelerator_fmc_pin_map.csv, xcelerator_fmc_pin_map.xlsx]
2020-03-04 On branch amarchan_zc06_vivado_project_dev Your branch is up-to-date with 'origin/amarchan_zc06_vivado_project_dev'.
    renamed: create_athena.tcl -> create_athena_zc706.tcl
    modified: implementation_timing_constraints.xdc
    modified: pinout.xdc
    modified: system.tcl
    modified: timing.sdc
    modified: ../../doc/onsemi/xcelerator_fmc_pin_map.xlsx
    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
    [xcelerator_fmc_pin_map.xlsx]
2020-03-04 Connect the xgs controller correctly following Javier's recommendations
    [athena_zc706.vhd]
2020-03-04 Fixed pinout xdc constraints (hispi interface set to LVDS_25) Code cleanup in the top level athena_zc706.vhd Cleanup in the backend tcl scripts
    [athena_zc706.vhd, pinout.xdc]
2020-03-05 Improved timing constraints in the axiHiSPi. Some clock definition were missing
    [pinout.xdc]
2020-03-09 New axiHiSPi with fixed clock delay on axiHiSPi. The Vivado design compile. The PnR has still some timing constraints to be fixed. There are some hold violations on the HiSPi interface.
    [xgs12m_chip.vhd]
2020-03-18 Add i2c class
2020-03-18 add i2c macro
2020-03-19 XGS sensor is now alive! I2C functionnal on 7c706 and Xcelerator
2020-03-27 Fixed pinout and timing constraints after PCB pin swapping by the CAD team
    [pinout.xdc]
2020-04-01 Schematic review of the sensor board
    [7_Series_Schematic_Review_Recommendations.xlsm, iris4_athena_pinout_final.csv]
2020-04-01 Files from the schematic review of the sensor board
    [7572-00_pin.csv, pin_net.csv]
2020-04-01 Files from schematics review
    [from_vivado.csv]
2020-04-01 Added a custom pcie2AxiMaster for the athena FPGA. Will includes a DMA engine interface
2020-04-03 Commit de la fds
2020-04-06 Debug validation framework. Updated the XGS model
2020-04-07 Support 32mhz pixel clk axi_2_regfile maintenant compile ds la librairie interne du xgs controller
2020-04-07 Fixed the testbench. Now the simulation start properly
    [AxiSlave2Reg.vhd, testbench_athena.sv]
2020-04-08 Debug de l<environnement de validation
2020-04-08 Frame lines are now as in the spec. Can add lines with new register.
2020-04-08 Ajout registre pour inserer des lignes dans le readout du XGS au niveau du fpga Le component I2c utilise maintenant sa propre librairie
2020-04-09 Modified simulation script to ease the flow
2020-04-09 Testbench maintenant un peu plus intelligeant lorsqu'on change le nb de lanes HiSPI
2020-04-10 Added pinout verification files
    [7572-00_pin.csv, pin_net.csv]
2020-04-10 Fixed artix 7 timing constraints
    [glbl.v, resetsync.vhd]
2020-04-16 Ajout support du changement de gain, et black offset (data pedestal) Registres M_line+F_line_subsampling changent d'adresse, SVP se referer au fichier TB_xgs12m_receiver.sv pour les nouvelles address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
    [TB_xgs12m_receiver.sv, xgs_ctrl.vhd, xgs_spi.vhd]
2020-04-16 Ajout nouvelle class pour data path (juste un regfile pour le moment) Ajout fonctionnalite pour changer gain, data pedestal (Black offset) Ajout test0001 : sw trig manuel Test du fix TLP_2_AXI : Main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
    [Iris4_Camera.cpp, MilLayer.cpp, MilLayer.h, XGS12K.cpp, XGS_Ctrl.cpp, XGS_Ctrl.h, XGS_Data.cpp, XGS_Data.h]
2020-04-21 Backup only work in progress in development of dmawr2tlp (constructing the validation framework)
2020-04-22 Add Xcelerator Monitor_mux selector by ioexpander Add Debug pin to Xcelerator Add EO_FOT generated within fpga.
2020-04-23 Add new interface between XGS controller and data path FIX for TLP_e_AXI +Bar registres pre-fetchables
    [TB_xgs12m_receiver.sv, athena_zc706.vhd, axiXGS_controller_v1_0.vhd, iserdes_control.vhd, pinout.xdc, xgs12m_chip.vhd, xgs_ctrl.vhd]
2020-04-23 Fixed Readout length and floating point constant
    [axiXGS_controller_v1_0.vhd, xgs_ctrl.vhd]
2020-04-23 Fixed a deadlock in axiHiSPi
    [testbench_athena.sv]
2020-04-27 debug stream interface. Removed deadlock. Update validation testbench (Configuration of the DMA registers)
2020-04-28 Derniers changements avant de passer a la fusion XGS_athena
2020-04-28 Oublie de faire un git add . avant mon commit!
2020-04-28 Commit avant de commencer a travailler sur XGS_athena
2020-04-29 Debut de XGS_athena
2020-04-30 Touchups to the registerfile. Debug register accesses in the testbench. Simulation is compiling and running without error
    [regfile_xgs_athena.h, testbench.sv]
2020-05-01 Fixed a range issue in Javiers's module xgs_ctrl.vhd.
    [regfile_xgs_athena.h, xgs_ctrl.vhd]
2020-05-01 Connected the xgs_controller interface. Fixed typo in the registerfile
    [XGS_athena.vhd, regfile_xgs_athena.h, testbench.sv]
2020-05-04 Fixed multiple clock domain crossing Touchup in the HISPI registerfile section
    [XGS_athena.vhd, hispi_phy.vhd, lane_decoder.vhd, regfile_xgs_athena.h, tap_controller.vhd, testbench.sv, xgs_hispi_top.vhd]
2020-05-05 Premier balbutiment de Athena sur Artix
2020-05-05 Repackaged XGS_athena Fixed some timing constraints on the hispi I/F Added requested ports on the xgs_hispi_top for the XGS_controller
    [XGS_athena.vhd, compile.xdc, hispi_phy.vhd, lane_decoder.vhd, pinout.xdc, xgs_hispi_top.vhd]
2020-05-06 Regle un printf, test pour checkout de la machine mirroir a matrox
2020-05-06 Programmation des registres DMA
2020-05-07 Fixed timing constraints in the hispi interface Improved naming convention for better clock domain crossing identification
    [XGS_athena.vhd, hispi_phy.vhd, pinout.xdc, xgs_hispi_top.vhd]
2020-05-07 Debug led on 7C706 are now: Led0=heart beat PCIe, LedR=heart beat refClk, LedC=Led(1), LedL=Led(0) -> Led(0) is used by Pix clock detection
2020-05-07 Fixed false hold time violations between rising to rising edge on the hispi io clock
    [pinout.xdc]
2020-05-07 Fixed fifo overrun in lane_decoder. This flag generated X at the begining of simulation because no clock was available on pix_clk, hence no synchronous reset.
    [hispi_phy.vhd, lane_decoder.vhd, xgs_hispi_top.vhd]
2020-05-07 Fixed timing and implementation constraints to remove critical warnings
    [compile.xdc]
2020-05-11 Ajoutr d'un registre dans la section ACQ pour identifier le board Zynq AJout de la generation automatique du .bit et .mcs (meme s'il y a des erreurs de timing pour le moment)
2020-05-11 L'oscillateur sur le sensor board matrox est 32.000Mhz (selon les shemas)
2020-05-11 Fixed bit locked mechanism. Fixed register file error status Updated the registerfile (added the idle characher register)
    [bit_split.vhd, hispi_phy.vhd, lane_decoder.vhd, regfile_xgs_athena.h, testbench.sv, xgs_hispi_top.vhd]
2020-05-11 Fixed registerfile issue. The field PHY_BIT_LOCKED_ERROR was not read only type
    [regfile_xgs_athena.h, xgs_hispi_top.vhd]
2020-05-11 Constraints timing formatting Start implementing scoreboard for the Modelsim validation framework
2020-05-12 Connecte les constantes info avec les generiques dans le top athena, pour avoir le build ID
2020-05-12 Added manual calibration possibility (Debug mode)
2020-05-14 Changed the lane_decoder CALIBRATION_ACTIVE status for CALIBRATION_DONE status. THis was code refactoring leftover
2020-05-14 Modified the pixel clock generation. How utilise a Xilinx BUFR to divide the serdes clock hclk by 2 We had a problem in chipscope to detect the pix_clk
    [bit_split.vhd, hispi_phy.vhd, lane_decoder.vhd]
2020-05-14 Ajout des contraintes pour ILA
2020-05-14 Connecte registre cfg_master_en ds pcie2AxiMaster.vhd, sinon le DMA partira pas.
2020-05-15 Fixed clock timing issue (pclk is now using bufg)
    [bit_split.vhd, hispi_phy.vhd]
2020-05-15 J'enleve new_constraints de git pour le projet artix
2020-05-19 Fixed the end_of_dma flag
    [axi_stream_in.vhd]
2020-05-19 Debug dma
2020-05-19 Improved the scoreboard in the validation framework. Work in progress
2020-05-19 Fixed pin path in timing constraints files
2020-05-20 Fixed the embeded line and the line count in axi_line_streamer. Does not come from a generic anymore
    [axi_line_streamer.vhd, lane_decoder.vhd, line_buffer.vhd, testbench.sv, xgs_hispi_top.vhd]
2020-05-20 Compilation des macros en Artix 7, Code fonctionnel sur Sensor Board Matrox
2020-05-21 Fixed the ROI management (bad line count management)
    [axi_line_streamer.vhd, testbench.sv, xgs_hispi_top.vhd]
2020-05-21 Set false path on the hold violation. They are compensated by the calibration mechanism in the HiSPi interface (tap_controller)
2020-05-22 Ajout du registre SENSOR_X_ORIGIN pour le debut du crop dans le datapath, regeneration du IP XGS ATHENA
2020-05-25 par defaut en Pcie x2 on reduit le linerate de facteur 2
2020-05-25 J'enleve la branch jmansill_zc06_vivado je vais travailler sur une branch seulement Ajout de time lapse dans le create_athena
2020-05-25 Update dcf pour 5M et 16M Regle le probleme de colonnes inverses (Lane top et bottom inversees)dans le Hispi packer Debut des travaux pour sortir les test images du senseur.
    [XGS16K.cpp, XGS5K.cpp]
2020-05-25 Fix some port maps
    [XGS_athena.vhd, xgs_hispi_top.vhd]
2020-05-26 Fixed the Vivado project (Timings and ip integrator)
    [regfile_xgs_athena.h]
2020-05-27 Ajout scripts pour compiler le fpga avec 4 lanes. Il faudra changer le ip xgs_athena pour pointer sur le bon Phy Ajout des registres x_start, x_end et x_size
2020-05-27 Fixed the cropping (now uses xstart xend from the register file) Fixed the line buffer overflows
    [XGS_athena.vhd, axi_line_streamer.vhd, line_buffer.vhd, regfile_xgs_athena.h, xgs_hispi_top.vhd, xgs_mono_pipeline.vhd]
2020-05-27 Fixed line buffer sync handling
    [axi_line_streamer.vhd, line_buffer.vhd, xgs_hispi_top.vhd, xgs_mono_pipeline.vhd]
2020-06-01 Fixed line overflow in axi_stream_in.vhd of the DMA engine
    [axi_stream_in.vhd, testbench.sv, xgs_mono_pipeline.vhd]
2020-06-02 Fixed testbench simulation ending. Now end on the DMA interrupt Fixed data beats missing Added line double buffering in axi_stream_in
    [axi_line_streamer.vhd, axi_stream_in.vhd, pinout.xdc, testbench.sv]
2020-06-04 Put back pressure in the axi_stream_in module. Should not toggle buffer until the current line is not completely evacuated Added some debug flags (back pressure counter amd max value)
2020-06-05 Modifications au predicteur, generation de pgm, class image load le pgm, le testbench utilise la fonction crop de cimage... pas mal plus propre. Repare l'image a 3100 lignes
2020-06-05 Print size in comment
2020-06-05 grab @28fps!, simulation Ligne 0 avec pixels @0x3a6 (xgs_image.vhd, L196), pour sortir un probleme de detection de idle code
    [Iris4_Camera.cpp, XGS12K.cpp, testbench.sv, xgs_image.vhd]
2020-06-09 Fixed the pclk_idle_detect_en Flag in lane_decoder.vhd. The Power on condition was not handled properly. We hope we fixed the problem at power on
    [bit_split.vhd, lane_decoder.vhd]
2020-06-09 Fix QSPI interface. Add JDK QSPI test 's'
    [Iris4_Camera.cpp, Pcie.cpp, Pcie.h]
2020-06-09 Add SPI read function
2020-06-09 FiX spi read function, now korks great!
    [Pcie.cpp]
2020-06-10 Add HW timer support with TRIG_SRC=5 Add test0003.cpp
2020-06-12 FPGA logic to fix sensor bug when trigger received inside a 100ns of new start line(monitor2) Changes to DCF to cover the keep_out_zone (100ns) for the XGS 12Mpix Update to Alexandre optic test (0009)
    [XGS12K.cpp, XGS16K.cpp, XGS5K.cpp, XGS_Ctrl.cpp, XGS_Ctrl.h, XGSxK.cpp, regfile_xgs_athena.h]
2020-06-16 FPS max, HW trig Timer adaptative, test0004
2020-06-19 Archive.tcl : generation du .bin pour programmation sur programmeur Ajout du framerate calculator Amelioration du HW timer, il devient adaptative au trig_rdy
    [XGS_FrameRate_Calc.xlsx]
2020-06-22 Add framerate calculator
    [XGS_FrameRate_Calc.xlsx]
2020-06-22 change constant in framerate calculator
    [XGS_FrameRate_Calc.xlsx]
2020-06-23 Added test0005 : random exposure, Async thread Mod to test0009 (optic) now it can set digital gain in XGS to saturate image Add strobe and delai trigger functions Add function to read/write a pixel i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
2020-06-26 Fix DMA Overrun in memory
    [Iris4_Camera.cpp, Pcie.cpp, Pcie.h, axi_stream_in.vhd, pcie2AxiMaster.vhd, regfile_pcie2AxiMaster.h, regfile_pcie2AxiMaster.vhd]
2020-06-29 Menage de fichiers/repertoires du regfile PCIe
2020-07-09 Premier support pour XGS5M, grab sans overlap pour le moment en attendant de prober et programmer les timings Ce premier support se fait pour le moment avec un fpga custom _4L , le but est de fusionn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
2020-07-09 Timings pour XGS5000, framerate calculator
    [XGS_FrameRate_Calc.xlsx]
2020-07-10 Ajout des registres pour rendre le fpga lane-dynamic:
    HISPI.CTRL.XGS_NB_LANES
    HISPI.CTRL.XGS_MUX_RATIO
    HISPI.FRAME_CFG.LINES_PER_FRAME
    HISPI.FRAME_CFG.PIXELS_PER_LINE
    Deplace les registres de la section controleur a la section Hispi :
    HISPI.FRAME_CFG_X_VALID.X_END
    HISPI.FRAME_CFG_X_VALID.X_START
    Modifie le JDK pour que la DCF loade ces registres, lors de l'identification du senseur.
    Build XGS12M : athena_1594392159_12Mpix_new_regfile
    Build XGS5M : athena_1594393190_5Mpix_new_regfile
2020-07-10 Modifie environnement de validation modelsim avec les nouveaux registres et registres modifies.
2020-07-27 Ajustement des flags pour printf dans test 0006
2020-08-04 XGS 16000 support
    [XGS_FrameRate_Calc.xlsx]
2020-08-05 Add fps and exp max fonctions to class controller. Reseting error flags form HISPI before calibrate.
    [XGS_Ctrl.cpp, XGS_Ctrl.h, XGS_Data.cpp]
2020-08-07 Amelioration de la function pour extraire le FPS et EXP maximum, se sert maintenant des grabparams! (aulieu des registres fpga) Ajout semaphore I2C Ajout du system monitor pour la temperature du fpga
2020-08-10 Add HiSPI error detection function
    [XGS_Data.cpp, XGS_Data.h]
2020-08-17 Modified the backend scripts for automatically generating the power report
2020-08-17 DPC working in simulation with normal test, need to do back pressure simulation, from testbench
2020-08-18 Athena: - Registerfile : Improved fields descriptions in the HiSPi section Regenerated the register files
    - Fixed some warnings in the modelsim testbench
    - Improved display messages in some validation sv Classes (%0d)
    - Implemented the lane enable mechanism so the same firmware can support 4 and 6 lanes sensors
    ARES:
    - Improved backend scripts to generate power and timing report
    [axi_stream_in.vhd, hispi_phy.vhd, regfile_xgs_athena.h, testbench.sv, xgs_hispi_top.vhd]
2020-08-18 Ajout de back pressure
2020-08-19 WIP, Now do the aritmetic from register values in the line packer in order to calculane the line size. Did big cleanup to remove unused generics Inserted a new register in the HISPI section (register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
2020-08-19 Fixed timing constraints (bad hierarchical path) in timing.sdc
    [XGS_athena.vhd]
2020-08-19 Handled the line buffer overflowin simulation. This problem occures at the lane_packer when data is arriving to fast and data from the line_buffer module is not evacuated fast enough. In that case an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
    Updated register addresses offset in the testbench and fixed some warnings du to some variable declaration with initial value (Stupid verilog!!!).
    Repackaged the IP in IPI
    [testbench.sv]
2020-08-20 Maintenant on grab la pleine surface des senseurs dans tous les tests ! Ajout du support dans les dcf pour le nouveau registre PHY qui configure le nombre de Lanes 4/6
2020-08-21 commit avant fds, DPC reste a connecter les registres du regfile
2020-08-24 The same XGS_athena IP-Core now support the configuration of 4 lanes 6 lanes simultaneously The validation framework has been updated accordingly
2020-08-25 Fix DCP enable DB. Fix test0007 Add IRQ start of grab (EOFOT) Add Register DPC CAPABILITIES
    [Iris4_Camera.cpp, XGS_Data.cpp, XGS_athena.vhd, XGSxK.cpp, regfile_xgs_athena.h, testbench.sv]
2020-08-25 Enabled MSI interrupt support in pcie2AxiMaster_v3.0 Connected interrupts in backend/artix7/system.tcl Backend scripts cleanup
2020-08-26 Fix jdk compilation warnings and XGS12M full srface bug.
    [XGS12K.cpp, XGS_Data.cpp]
2020-08-26 DPC corrected dcp fifo reset, the first pixel in the list was not corrected
    [testbench.sv]
2020-09-01 lut fonctionnel sans trop de backpressure
2020-09-01 Connected MSI interrupts in pci_top equivalent
2020-09-01 Fixed calibration issue. Sometime lane calibration was corrupted on lane 2 and or 3. We suspected a clock phase issue between the 3 lanes of a given PHY. We now improved the pseudo clock domain cross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
    [hispi_phy.vhd, lane_decoder.vhd, tap_controller.vhd]
2020-09-02 Gates the CRC error interrupt in the global interrupt hispi_irq_error
    [xgs_hispi_top.vhd]
2020-09-02 Fixed initialisation problem when reporting CRC error. There was 'X' propagation that generated wrong CRC error IRQ
    [lane_decoder.vhd]
2020-09-04 Removed I2c semaphore Add general Arbiter in PCIe2AxiMaster (ATHENA)
2020-09-09 Change ATHENA fpga version to 0.0.8 0.0.8 : XGS_athena no HiSPI differential termination resistor on fpga, added General Arbiter to Logic
2020-09-10 WIP: Redesign axi_line_stream_in.vhd (The number of line buffer is now configurable) First simulation running with the new design. Still need to implment register for controlling this mechanism.
    [axi_stream_in.vhd, testbench.sv]
2020-09-11 Connected DMA line buffer configuration to the register file Add back pressure monitoring and detection (reported in the registerfile) Added register /DMA/OUTPUT_BUFFER @0x0A8 Regenerated the registe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
2020-09-14 Fixed the interrupt mechanism. Changed the mask default reset value to 0xffffffff in the registerfile The enable register now enable only the legacy status register. The mask register now mask the ev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
    [Cregfile_pcie2AxiMaster.cpp, Cregfile_pcie2AxiMaster.h, Cregfile_pcie2AxiMaster.java, pcie2AxiMaster.vhd, pcie_7x_0-PCIE_X0Y0.xdc, regfile_pcie2AxiMaster.h, regfile_pcie2AxiMaster.sv, regfile_pcie2AxiMaster.vhd]
2020-09-14 Fixed irq_event connection problem in ../pcie2AxiMaster_v3.0/design/pcie2AxiMaster.vhd. Failed synthesis (bad width)
    [pcie2AxiMaster.vhd]
2020-09-15 Added SW irq generation in pcie2aximaster (Modified registerfile, IP port map and generic map) for driver debugging purpose. Changed the IP gui (SW_IRQ port presence is configurable in the GUI) Conne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
2020-09-15 Add strobe generation to test0003 Decode flash Munufacturer id ans device id
2020-09-15 give info about flash when program the flash spi from file
2020-09-15 Connected regfile.DMA.TLP.BUS_MASTER_EN <= cfg_bus_mast_en; in local_ip/XGS_athena/hdl/dma/dmawr2tlp.vhd
2020-09-15 Fixed ../local_ip/pcie2AxiMaster_v3.0/registerfile/regfile_pcie2AxiMaster.registerfile set interrupt_queue/control/nb_dw to 2 (2 DW of interrupt status)
    [Cregfile_pcie2AxiMaster.cpp, Cregfile_pcie2AxiMaster.h, Cregfile_pcie2AxiMaster.java, regfile_pcie2AxiMaster.h, regfile_pcie2AxiMaster.sv, regfile_pcie2AxiMaster.vhd, testbench.sv]
2020-09-16 Documented the DMA/TLP/CFG_MAX_PLD (MAX payload size set by the host) in the registerfile
2020-09-16 Fixed the pcie2AxiMaster_v3.0/cores/pcie_7x_0 core MAX_PAYLOAD size supported to 256 bytes. This is the max possible with EHL
    [pcie_7x_0-PCIE_X0Y0.xdc]
2020-09-16 Synchroniser tous les fichiers sur un clock HyperBus a 125 MHZ (contraintes, delai, block-design).
2020-09-16 Add %lf to print double variables
2020-09-17 Fis for RED Status Led in Ares fpga (no pullup on Motherboard PCB)
2020-09-17 ../../../ares_pcie/backend/create_ares.tcl : Re-activated the automatic firmware generation (.mcs, .firmware, .bit)
    ../../bench/Visual_Studio/Iris4_Camera/tests/test_0000_Continu.cpp : Fixed an exception error in a printf (there was bad double formatter used)
    ../../local_ip/XGS_athena/hdl/XGS_athena.vhd : Connected the Grab abort IRQ
    [XGS_athena.vhd]
2020-09-18 Add attributes MARK_DEBUG on missing signals in bit_split.vhd
    [bit_split.vhd]
2020-09-18 Put back the Hyperram validation vivado framework on its legs. Now the 133MHz project compile with minimal timing violations
2020-09-21 iris4-242 [HyperRam] -Ajouter Clock to out sur RWDS, enlever faux path de RWDS vers lui-même. -Monter la clock à 142.8 MHz
2020-09-22 IRIS4-242 Passer de la méthode croche des timings sur les pins DDR de la HyperRam qui dépend de la fréquence à la méthode propre qui n'a pas besoin d'être ajustée pour chaque fréquence.
2020-09-23 Fixed the JIRA https://jira.matrox.com:8443/browse/IRIS4-248 Redesign bit_split.vhd and lane_decoder.vhd mv the state machine in bit_split.vhd. more robust and clean design Still a work in progress f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
    [bit_split.vhd, hispi_pack.vhd, lane_decoder.vhd]
2020-09-24 Fix timing issue. Pipelined hclk_aligned_pixel_mux signal Code cleanup, repackaged IP. Seems good enough to try on the bench
    [bit_split.vhd, hispi_phy.vhd, lane_decoder.vhd]
2020-09-24 Fixed the backend scripts for generating the ARES FPGA. The top level generica are not produces by the script BUILD_ID FPGA_ID GOLDEN -----------------------------------------------------------------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
    [ares_pcie.vhd]
2020-09-25 Passage du HyperBus à 150/166 MHz, avec -3ps de slack sur un input. Le passage à 150 MHz requiert l'ajout d'un MMCM pour générer toutes les fréquences. Le fichier de contraintes globale a été modifié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
2020-09-25 WIP: Debug the calibration process. Still some errors when performing manual calibration process In this commit the grab is pretty stable
    [bit_split.vhd, hispi_phy.vhd, lane_decoder.vhd, regfile_xgs_athena.h, tap_controller.vhd, testbench.sv]
2020-09-29 Allonge Start_cilibration de 1 a 4 clk Rename register (typo) SENSOR_REG_UPTATE -> SENSOR_REG_UPDATE Add ARES class to JDK (for future tests) Add XGSTestImageMode to test0000 , with programmable fixe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
    [Ares.cpp, Ares.h, Iris4_Camera.cpp, SystemTree.cpp, XGS_Ctrl.cpp, XGS_Ctrl.h, XGS_athena.vhd, XGSxK.cpp]
2020-09-30 Debug the data path between the serdes and and the line buffer. The pipeline introduced in the bit_slip module broke the flow control from the xgs_hispi_top perspective
    [bit_split.vhd, compile.xdc, hispi_phy.vhd, lane_decoder.vhd, line_buffer.vhd, testbench.sv, xgs_hispi_top.vhd]
2020-09-30 Fixed a lane packer dead lock (output_state FSM).
    [testbench.sv]
2020-10-01 Start supporting subsampling in DPC module (not validated) Add image testmode to test0001 Ameliorate WriteSPI_BURST Now can read Color/CRA/resolution of the sensor from OTPM (0x3012)
2020-10-01 Fix const M_UINT32 TAB[] instead of [500]
    [XGS12K.cpp, XGS16K.cpp, XGS5K.cpp]
2020-10-02 Set the PCIE device ID to 0xABDC (test purpose only)
2020-10-02 Fixed backent scripts (firmware creation, build_id, removed critical warnings,etc)
    [compile.xdc, pinout.xdc]
2020-10-05 Ajouter fichier Ares.cpp a la compilation.
2020-10-05 Fixed back the 133MHz test system
    [compile.xdc, pinout.xdc]
2020-10-06 Now write Color configuration register to XGS register 0x3800 (read this XGS configuration from OTPM) for XGS12M and XGS16M. With this color subsampling is now read2-skip2
    [XGS_Ctrl.cpp, XGS_Data.cpp, XGSxK.cpp]
2020-10-06 fix OTPM access delai to 50ms
    [XGS12K.cpp, XGS16K.cpp, XGS5K.cpp, XGS_Ctrl.cpp, xgs_ctrl.vhd]
2020-10-14 Retour à 166 MHz tout en laissant le 150 MHz en commentaire dans les contraintes. Il faudra reculer le block-design à une version précédente qui contenait 2 PLL pour faire du 150 MHz. Le pinout a été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
2020-10-14 Added SDK driver support for the IP rpc2_ctrl_controller
2020-10-15 Corriger le merge des contraintes de timing et placé le RWDS sur la pin du PCB actuel.
    [pinout.xdc]
2020-10-19 Repackaged rpc2_ctrl_controller ip, updatede SDK driver files
2020-10-19 Fix Xsize_full=4096 for XGS_DMA_LinePtrWidth = 2 (4x buffers of 4096)
    [XGS12K.cpp]
2020-10-20 Renommer les sorties du PLL vers le Hyperbus controller pour une version indépendante de la fréquence en chiffre comme c'était fait dans la branche master. Corriger le rename des horloges pour corres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
2020-10-20 Fixed damages caused by the latest merge request (Hyperram @166MHz)
    [ares_pcie.vhd]
2020-10-20 Removed failling constraints. C'etait des contraintes orphelines...
2020-10-27 Modified the registerfile. Added the TLP register section @0x70 Connected the source clock and reset to the ipi system in ares_pcie.vhd (host2axi_clk , host2axi_reset_n). They were not connected... o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
    [ares_pcie.vhd, compile.xdc, pcie_top.vhd, pinout.xdc, tlp_to_axi_master.vhd]
2020-11-03 Disabled the ASPM functionnality. Requested by Sebastien Champagne. They have a catastrophique error possibly caused by power management. Still to be confirmed. Still under investigation
    [compile.xdc, pinout.xdc]
2020-11-03 Refactored the ARES folder structure. Now supports 2 PCB revisions and also 2 different FPGA (a50t and a30t)
    [Axi_system_memory_map.xlsx]
2020-11-03 Fixed tap (set to 14 taps) for the Hyperram controller on board 7571-00
2020-11-04 Updated register file in regfile_ares.registerfile: @0x0020 (FPGA_ID[4:0]) Added new bits definition on field Device_specific.FPGA_ID.FPGA_ID @0x0020 (FPGA_ID[31:28]) Created new field Device_specifi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
    [ares_pcie.vhd, pinout.xdc]
2020-11-04 Fixed backend scripts for /7571-02/a35t configuration
    [pinout.xdc]
2020-11-04 corrected index in PYTHON_SPI (aucun imnpact pour gtx)
    [xgs_spi.vhd]
2020-11-05 ajout test # pour loop de calibration
2020-11-17 New version of the xgs_hispi_top (Version 2). The goal of this redesign is to reduce significantly the number of RAM bloc used in synthesis. The approach is to remove the line buffer and directly buf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
    [hispi_pack.vhd]
2020-11-23 WIP. First test passes. the XGS12M run the test without any error! The XGS5M not tested yet Note I by passed the lut and the dpc
    [testbench.sv, xgs_hispi_top.vhd]
2020-11-24 Redesigne the xgs_hispi_top module. Significantly reduced the number of ram block required Removed the central line buffer Each lane_decoder contains its own local line_buffer (split in 4 sub-buffers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
    Debug the back pressure in axi_line_streamer
    [XGS_athena.vhd, axi_line_streamer.vhd, hispi_phy.vhd, lane_decoder.vhd, line_buffer.vhd, regfile_xgs_athena.h, regfile_xgs_athena.sv]
2020-11-25 WIP. Backup only. I suspect bad clock domain crossing in the line buffer. Temporarily switching branch
2020-11-26 Added ../backend/7571-02/a35t/Runs_exploration_summary.xlsx
    [Runs_exploration_summary.xlsx]
2020-11-26 Redesign line buffer and the buffer pointer management to simplify the clock domain crossing between the write and the read interface
    [axi_line_streamer.vhd, hispi_phy.vhd, lane_decoder.vhd, line_buffer.vhd, testbench.sv, xgs_hispi_top.vhd]
2020-12-04 Validation des resultats de la liste de tests!
2020-12-04 faute de tape
2020-12-07 Removed some debug probes attributes
2020-12-08 Fixed IRQ property propagation issue in IP-Integrator. Remove the attribute Level on the IRQ interface in ../../local_ip/pcie2AxiMaster_v3.0/component.xml Added some debug attributes in VHDL
    [axi_stream_in.vhd]
2020-12-08 Added more description in the output_buffer register under the dma section. No functionnal changed
2020-12-14 Wrote test9999.svh for testing fdkide systemverilog generator The test run without any issue
    [regfile_xgs_athena.h, regfile_xgs_athena.sv, testbench.sv]
2020-12-15 Repare gel du display? (printf du fps qui semblait faire un getch) Ajout reset du ctrl Idelay
    [XGS_Ctrl.cpp, XGS_Data.cpp]
2020-12-15 change all printf to printf_s, to avoid image stall
    [Ares.cpp, I2C.cpp, Iris4_Camera.cpp, MilLayer.cpp, Pcie.cpp, SystemTree.cpp, XGS12K.cpp, XGS16K.cpp]
2020-12-16 WIP Continue debugging the SV new registerfile model Simplifying model validation framework model
2020-12-17 Repare la sequence de reset du idelay controller
    [XGS_Data.cpp]
2020-12-17 WIP. A lot of code , file and folder refactoring in the whole validation framework
2020-12-18 WIP. Backup commit only. Improved the validation framework (adding more verbose, code refactoring). The Test2000 simulation is not running yet
2021-01-14 WIP. Backup commit only. Improved the validation framework (adding more verbose, code refactoring). The Test2000 simulation is not running yetamarchan_artix7…
2021-01-14 WIP. For Athena FPGA, adding support for generating 35T device in the backend scripts
2021-01-14 FIX CRC ERROR ON GTX (add timing constraint) Add test0010 to test for CRC Errors
    [Iris4_Camera.cpp, XGS_Ctrl.cpp, XGS_Data.cpp, XGS_Data.h]
2021-01-18 Updated and regenerated the registerfile * Changed the value at reset of the field /HISPI/CTRL/SW_CLR_IDELAYCTRL to 1 (Was 1b0 before)
    [regfile_xgs_athena.h]
2021-01-20 Avec les fichiers
2021-01-26 Fixed JIRA https://jira.matrox.com:8443/browse/MT-2105 Microblaze cache accesses to the hyperram in wrap burst mode not supported. The fix was made under : ares_pcie\ipcores\rpc2_ctrl_controller\mtxA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
    [compile.xdc, pinout.xdc]
2021-01-29 Ajout tests : 0005 : Sub X (FAIL, to implement SubX logic in FPGA) 0006 : Sub Y (PASS, XGS Sensor feature) 0007 : SubX+SubY (FAIL, to implement SubX logic in FPGA) 0008 : Reverse X (FAIL, to implemen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
    [I2C.cpp, Iris4_Camera.cpp, XGS12K.cpp, XGS16K.cpp, XGS5K.cpp, XGS_Ctrl.cpp, XGS_Ctrl.h, XGS_Data.cpp]
2021-01-29 Repare la liste de tests
2021-02-01 Added the backend files for investigating the Microblaze cache problem (MT-2105)
    [compile.xdc, pinout.xdc]
2021-02-02 Set backend files from /ares_pcie/backend/7571-02/a50t in sync with backend files from /ares_pcie/backend/7571-00 In order to produce ares_v0.7.0 for pcb 7571-02/a50t
2021-02-08 This fix implements the fix for JIRA IRIS-91
    [ares_pcie.vhd]
2021-02-08 IO user_rled_soc : in std_logic; IO user_gled_soc : in std_logic;
    Replaced by a field in the registerfile:
    regfile.Device_specific.FPGA_ID.USER_RED_LED
    regfile.Device_specific.FPGA_ID.USER_GREEN_LED
    [ares_pcie.vhd]
2021-02-09 FIX I2C : I2C clock stretching is now enabled in AXI generation Update Onsemi DCF (Onle changes to XGS16M) Add DCF history files. Add support code dcf for XGS2M and XGS8M (Not validated yet, do not t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
    [XGS12K.cpp, XGS12M-REV0_WIP_13579.ini, XGS12M-REV1_WIP_15037.ini, XGS12M-REV1_WIP_18135.ini, XGS12M-REV2_WIP_17021.ini, XGS12M-REV2_WIP_18093.ini, XGS16K.cpp, XGS16M-REV0_WIP_17169.ini]
2021-02-11 Enleve 3 printf
2021-02-11 Backend folder refactoring. Removed old unused backend project folder sync backend files of 7571-02 with 7571-00 files
    deleted: backend/7571-00-MT-2105/add_files.tcl
    deleted: backend/7571-00-MT-2105/archive.tcl
    deleted: backend/7571-00-MT-2105/compile.xdc
    deleted: backend/7571-00-MT-2105/create_ares.tcl
    deleted: backend/7571-00-MT-2105/firmwares.tcl
    deleted: backend/7571-00-MT-2105/hyperbus.sdc
    deleted: backend/7571-00-MT-2105/hyperbus_hr142MHZ.sdc
    deleted: backend/7571-00-MT-2105/mb_system_pcie.tcl
    deleted: backend/7571-00-MT-2105/ncsi_timings.sdc
    deleted: backend/7571-00-MT-2105/new_constraints.xdc
    deleted: backend/7571-00-MT-2105/pinout.xdc
    deleted: bac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
    [Runs_exploration_summary.xlsx]
2021-02-15 Fine tuned timings in the axi spi interface: Remove all microblaze Hardware exception support (Trying to fix JIRA : MT-1274)
2021-02-15 Sync modification from ../7571-00 to ../7571-02
    Fine tuned timings in the axi spi interface:
    Remove all microblaze Hardware exception support (Trying to fix JIRA : MT-1274)
2021-02-16 Modifications a la feuille de calcul fps XGS avec XGS8000
    [XGS_FrameRate_Calc.xlsx]
2021-02-24 This commit served to generated ares_7571_02_a50t_0x60343131 for investigating Iris4-409 modified: backend/7571-02/axi_quad_spi.xdc modified: backend/7571-02/compile.xdc modified: backend/7571-02/hyp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
2021-02-26 Support couleur dans un fpga monochrone. Support Couleur dans JDK Modification au block design pour la compilationn couleur 2/8 dans le fpga Mono Testbench avec prediction Bayer demosaic et DPC coule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
2021-03-03 Changed espi_clk pin from K17 to L17 (We need to enter the positive pin of the clock) See Jira : https://jira.matrox.com:8443/browse/CADT01-1144
2021-03-03 Cleanup in the power.xdc files Changes to be committed: modified: ../7571-00/power.xdc modified: power.xdc
2021-03-04 WIP. add a simple valid framework for the module x_chopper.vhd Changes to be committed: modified: athena/local_ip/XGS_athena/hdl/data/x_chopper.vhd modified: athena/local_ip/XGS_athena/validation2/mt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
2021-03-04 WIP. Connected stream output interface. Still need to handle properly wait states inserted by the sink port (bclk_tready)
2021-03-10 Files refactoring x_chopper changed to x_trim Move the bclk clock domain in the x_trim_streamout submodule Updated the validation framework accordingly
    modified: ../../.svproject
    renamed: hdl/data/x_chopper.vhd -> hdl/data/x_trim.vhd
    new file: hdl/data/x_trim_streamout.vhd
    modified: sve.f
    new file: validation2/mti/x_trim.do
    new file: validation2/mti/x_trim_streamout.do
    renamed: validation2/src/testbench_x_chopper.sv -> validation2/src/testbench_x_trim.sv
    renamed: validation2/tcl/create_modelsim_x_chopper.tcl -> validation2/tcl/create_modelsim_x_trim.tcl
    modified: validation2/tcl/util2.tcl
    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
2021-03-10 Iproved validation framework and functionnal coverage
2021-03-11 Implemented back pressure support in x_trim_streamout.vhd on the stream output port.
2021-03-11 Implemented the cropping_x and reverse_x. Modified the registerfile: -Added one fiend DMA.ROI_X.ROI_EN -Renamed field DMA.ROI_X.X_END to DMA.ROI_X.X_SIZE -Resized field DMA.CSC.SUB_X from 1 bit to 4 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
    The 2 following tests test0005 and test0007 are still failing since the subsampling mechanism is not implemented yet.
    Ran also PNR in Vivado without any issue
    The module requires 501 Slice LUTs;461 Slice registers; 2 block RAM 0 DSP
    [XGS_athena.vhd, regfile_xgs_athena.h, regfile_xgs_athena.sv, x_trim.vhd]
2021-03-12 Added a fix for JIRA https://jira.matrox.com:8443/browse/IRIS4-430 The le port ares_pb_i/ProdCons_0_write was connected to port ProdCons_1_write. It was re-connected to signal ProdCons_1_write.
    [ares_pcie.vhd]
2021-03-15 WIP. Fixed pipeline flow control in x_trim_subsampling.vhd. First simulation is passing. Subsampling by 2, no reverseno cropping Still a lot of validation to do... but starts smelling good!
    [x_trim.vhd, x_trim_subsampling.vhd]
2021-03-18 Preparation du JDK pour le module Xstream de amarchand
2021-03-19 Fixed subsampling y (div2). The bug was in file local_ip/XGS_athena/hdl/data/axi_line_streamer.vhd. There is no ODD line when the Y subsampling is applied.
    modified: local_ip/XGS_athena/hdl/XGS_athena.vhd
    modified: local_ip/XGS_athena/hdl/data/axi_line_streamer.vhd
    modified: local_ip/XGS_athena/hdl/data/lane_decoder.vhd
    modified: local_ip/XGS_athena/hdl/data/xgs_hispi_top.vhd
    modified: local_ip/XGS_athena/validation2/src/tests/test0001.svh
    modified: local_ip/XGS_athena/validation2/tcl/util2.tcl
    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
    [XGS_athena.vhd, axi_line_streamer.vhd, lane_decoder.vhd, xgs_hispi_top.vhd]
2021-03-22 MODIFIED THE ARES REGISTERFILE! Added the new 1 bit RO field regfile.Device_specific.FPGA_ID.NPI_GOLDEN For indicating if the current firmware is a GOLDEN firmware
2021-03-26 Fix ONSEMI initialistion code Fix for load dcf XGS2000 v2 Add framerate calculator for XGS2000 Add validation waveforms for XGS2000
    [XGS_FrameRate_Calc.xlsx]
2021-03-26 Added backend scripts for generating Golden and upgrade firmwares of ARES fpga rev 0 of the board
2021-03-29 Debug the test0020 Now passes without any error.
    [XGS_athena.vhd]
2021-03-29 modified .xls framerates
    [XGS_FrameRate_Calc.xlsx]
2021-03-29 Fixed Modelsim file compile order
    [XGS_athena.vhd]
2021-03-30 Debug Athena backend scripts for generating correctly golden and upgrade firmware
    [cfg_timer.xlsx]
2021-04-09 Premiere iteration AXIS_width converter a l'exterieur du path couleur( module independant, conversion 8 à 2 pixels) Ajout de scrips pour simulation couleur, modifications tops et ajout generiques pou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
2021-04-14 Add more support for color sensor Add scripts for golden/upgrade color fpga Support of csc color space registerfile *** JDK : Only 5Mpix DCF has been modified with sensorparams.XGS_DMA_LinePtrWidth =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
2021-04-21 Add YUV support for color pipeline Add CCM support for color pipeline (color correction matrix) Add YUV test to simulation testbench (test0022) Add YUV support in JDK Add pulldown to acq_led input in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
    [CCM.vhd]
2021-04-27 FIX small ROI 16 pixels: DMA always request 2 databeats more than the image have, stream_line module now supports this by masking read enable to the buffer and masking sync outputs
    [axi_stream_in.vhd]
2021-05-12 Fix color backpressure bug
    [XGS_Ctrl.cpp, testbench.sv, xgs_color_proc.vhd]
2021-05-13 Modified TCL script files: added header comment for FPGA board ID
2021-07-07 Implement HW exceptions in the microblaze in the ARES for the 7571-00 board
2021-08-10 WIP, backup only. Fixed the case for one databeat line size. Things are improving but some tests are still failing
    [x_trim.vhd, x_trim_streamout.vhd]
2021-08-10 The mini test suite passes without any error
    [x_trim_streamout.vhd]
2021-08-11 hdl/XGS_athena.vhd : removed the unused xgs_mono_pipeline component declaration hdl/data/x_trim_subsampling.vhd : add comments hdl/dma/axi_stream_in.vhd : move back pressure assert message in the sta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
2021-08-12 Fixed sync handling between x_trim_streamout.vhd and axi_stream_in.vhd
    [axi_stream_in.vhd, x_trim_streamout.vhd]
2021-08-12 Refactored the x_trim simplistic validation frame work (moved all scripts under the x_trim folder)
2021-08-20 Created 2 new files for cropping in the Y axis. This is required since the bayer module consume 1 line. With the XGS sensor it is impossible sending one extra line. The minimum line extraction resolu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
    modified: ../../component.xml
    modified: ../../hdl/XGS_athena.vhd
    new file: ../../hdl/data/trim.vhd
    modified: ../../hdl/data/x_trim.vhd
    new file: ../../hdl/data/y_trim.vhd
    new file: ../mti/trim.do
    modified: ../mti/x_trim.do
    new file: ../mt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
    [XGS_athena.vhd, trim.vhd, x_trim.vhd, y_trim.vhd]
2021-08-24 WIP. Framework refactoring. The whole mono library compile in Modelsim now
2021-08-25 Added register field /DMA/ROI_Y/ROI_EN
2021-08-25 WIP. updated backend scripts of trim validation framework
2021-08-25 Fixed color backend scripts
    [y_trim.vhd]
2021-09-15 Debugged test0021
    XGS_Athena.vhd :
    Connct aclk_x_scale => regfile.DMA.CSC.SUB_X
    Test0021 :
    Removed the ROI size x 4 in trim (x_trim_subsampling now support RAW packing mode)
    - //super.Vlib.Set_X_ROI(ROI_X_START, ROI_X_SIZE*4); [AM] new trim. Handle raw mode without subsampling
    + super.Vlib.Set_X_ROI(ROI_X_START, ROI_X_SIZE);
2021-09-15 The whole color test suite is now passing but there ars still some prediction error in test0020 test0021 test0022. Test needs to be tuned the line
    super.Vlib.Set_DMA_Trim_Y_ROI(0, ROI_Y_SIZE-3); //remove 3 lines (transfered 4 interpolation lines for bayer, because bayer consumes 1, so remove 3 at end)
    is not correct. We should not remove 3 lines from the ROI_Y_SIZE.
    [XGS_athena.vhd, x_trim.vhd, x_trim_subsampling.vhd]
2021-09-16 Debug all test. The whole test suite is now passing without any ERROR!!
    NOTE: I had to modify the pcie back pressure in test0023 in order for the test to pass. This is the next thing I will investigate. We are now reay to go on the bench and test with the JDK.
    2021-09-16
2021-09-17 Modify some functional tests to stardarlize tests. Add more support for Color in JDK, fix YUV reverseX Add Color Y to the color path
    [XGS_Data.cpp, XGS_Data.h, XGS_athena.vhd, xgs_color_proc.vhd]
2021-09-17 WIP implemented the COLOR_SPACE=4 mode. Not working yet. I need to merge with Javier<s code first
    [testbench.sv, x_trim.vhd]
2021-09-22 JDK : implemented COlor RevX, RevY, RevXY, RoiY, RoiX, SubY FPGA: Fix COLOR subsampling : even and odd lines exists!
    [XGS_Data.cpp, XGSxK.cpp, axi_line_streamer.vhd, x_trim.vhd, xgs_hispi_top.vhd]
2021-09-29 Fixed INFO_WIDTH value modified: dma/dma_line_buffer.vhd
    [dma_line_buffer.vhd]
2021-09-29 Register EXP_FOT_TIME goes from 12 bit to 16 to support color sensors.
2021-10-05 Fix DMA line_Size to support XGS12000C we need line_size register to be 15 bits instead of 14 Add fps fps calculator with 12000C support Add waveform of 12000C validation
2021-10-05 Add missing files :)
    [XGS_FrameRate_Calc.xlsx]
2021-10-06 Added XGS8000C timing parameters to JDK, missing files
    [XGS12K.cpp, XGS5K.cpp, XGS_Ctrl.cpp]
2021-10-07 Updated XGS excel FPS calculator
    [XGS_FrameRate_Calc.xlsx]
2021-10-12 Add xgs new ini files XGS12000C corrected ReadOutN_2_TrigN(us) in spread sheet
    [XGS_FrameRate_Calc.xlsx]
2021-10-13 Add missing .cpp and .h files of ini files.
    [XGS12K.cpp, XGS16K.cpp, XGS5K.cpp, XGS_Ctrl.h]
2021-10-14 Fixed JDK mono sensors, missing {} in color detection function JDK add information in display about current firmware loaded : Golden/Update/A35/A50/MONO/COLOR When OTPM is not programmed default is n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
    [Iris4_Camera.cpp, XGS_Ctrl.cpp]
2021-10-15 JDK Update flash update, now when updating update image the readback works! Adding more mesages and error detections
    [Iris4_Camera.cpp, flashupdate.cpp, flashupdate.h]
2021-10-28 Fixed the color test suite. All tests are now running without any error.
    [trim.vhd, x_trim.vhd, x_trim_pack422.vhd]
2021-10-29 Added test0025 to test schampagne bug (32 pixel in frame)
    [testbench.sv]
2021-10-29 Fixed bug reported in JIRA MT-3122
    Bad sync were generated in process P_bclk_align_packer_user. The End of line was not signaled because bclk_last_read_data only lasted one clock cycle which was not correct whe wait states were introduced on the AXI stream output port (bclk_tready == '0').
    The fix is implemented in the process P_bclk_last_read_data
    [x_trim_streamout.vhd]
2021-11-02 Fixed planar prediction model. Simply needed to declare an int for a variable type within get_pixel_B()
    [testbench.sv]
2021-11-02 WIP. debug de-interlacing in ../hdl/dma/dma_line_buffer.vhd
2021-11-03 Put i2c clk ff in the IOB
2021-11-07 Debug test0025. The whole color test suite is now running without any error, including test0025.
    ---------------------------------------
    -- Results of color testlist simulation
    ---------------------------------------
    test0020_result : PASS
    test0021_result : PASS
    test0022_result : PASS
    test0023_result : PASS
    test0024_result : PASS
    test0025_result : PASS
    [dma_line_buffer.vhd]
2021-11-07 Fixed buffer upper address range limit in mono
    [dma_line_buffer.vhd]
2021-11-07 Added test 0011 in the testbench (it was missing) Full support of color planar The whole regression test suite is now running without any error: --------------------------------------- Results of mon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
    Results of color testlist simulation
    test0022_result : PAS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
    [testbench.sv]
2021-11-11 Cleanup de code functionnel Support color JDK
2021-12-06 Add excel framerate calculator for XGS 16000 Color
    [XGS_FrameRate_Calc.xlsx]
2021-12-13 Fix dummy grab enable datapath in HISPI core
    [bit_split.vhd, regfile_xgs_athena.sv]
